IHP-GmbH/IHP-Open-PDK/README.md

# IHP Open Source PDK
130nm BiCMOS Open Source PDK, dedicated for Analog/Digital, Mixed Signal and RF Design

---
> [!WARNING]
> ### 📘 Installation Notice
>
> Before using this repository, **please review the [Installation Guide](https://ihp-open-pdk-docs.readthedocs.io/en/latest/install/installation.html)** for download procedure and to ensure your environment is set up correctly. The guide provides step-by-step instructions and important prerequisites. You can find it here: **[Installation Guide](https://ihp-open-pdk-docs.readthedocs.io/en/latest/install/installation.html)**.
---
## Acknowledgment
Special thanks to the following publicly funded German projects for their financial support, which has contributed to this work:  
IHP Open130-G2 (16ME0852) https://www.elektronikforschung.de/projekte/ihp-open130-g2  
FMD-QNC (16ME0831) https://www.elektronikforschung.de/projekte/fmd-qnc  


---
IHP Open Source PDK project goal is to provide a fully open source Process
Design Kit and related data, which can be used to create manufacturable
designs at IHP’s facility.

As of March 2023, this repository is targeting the SG13G2 process node.

<p align="center">IHP Logo Image</p>

# Current status -- Preview

> **Warning**
>
> IHP is currently treating the existing content as a **preview only**.

While the SG13G2 process node and the PDK from which this open source
release was derived have been used to create many designs that have been
successfully manufactured in significant quantities, the open source PDK
is not intended to be used for production at this moment.

# Documentation

Comprehensive documentation for the IHP Open Source PDK is available on [ReadTheDocs](https://ihp-open-pdk-docs.readthedocs.io/en/latest/).
For building or contributing, visit the [IHP-Open-PDK-docs repository](https://github.com/IHP-GmbH/IHP-Open-PDK-docs).

The documentation provides detailed information on PDK installation, setup for supported EDA tools, device libraries, layout rules, process specifications and design flow examples. It is the recommended starting point for users who want to explore the PDK structure, simulation models, layout design environments, etc.

# SG13G2 Process Node

SG13G2 is a high performance BiCMOS technology with a 0.13 μm CMOS process. It contains bipolar
devices based on SiGe:C npn-HBT's with up to 350 GHz transition frequency ($f_T$) and 450 GHz oscillation
frequency ($f_{max}$). This process provides 2 gate oxides: A thin gate oxide for the 1.2 V digital logic and a thick
oxide for a 3.3 V supply voltage. For both modules NMOS, PMOS and isolated NMOS transistors are
offered. Further passive components like poly silicon resistors and MIM capacitors are available. The
backend option offers 5 thin metal layers, two thick metal layers (2 and 3 μm thick) and a MIM layer.

# PDK Contents

* Base cellset with limited set of standard logic cells
    * CDL
    * GDSII
    * LEF, Tech LEF
    * Liberty
    * SPICE Netlist
    * Verilog
* IO cellset
    * CDL
    * GDSII
    * LEF
    * Liberty
    * SPICE Netlist
    * Verilog
* SRAM cellset
    * CDL
    * GDSII
    * LEF
    * Liberty
    * Verilog
* Primitive devices
    * GDSII
* KLayout tool data:
    * layer property and tech files
    * DRC rules
    * LVS rules
    * PyCells
    * XSection initial settings
    * 2.5D viewer configuration
* Magic tool data:
    * tech files, parasitic extraction rules
    * DRC rules
    * LVS rules
* MOS/HBT/Passive device models for ngspice/Xyce
* xschem: primitive device symbols, settings and testbenches
* Qucs-S: primitive device symbols, settings and testbenches
* Digital: stdcells
* OpenEMS: tutorials, scripts, documentation
* SG13G2 Process specification & Layout Rules
* MOS/HBT Measurements in MDM format
* Project Roadmap Gantt chart

## Supported EDA Tools

* ngspice
    * Download: https://ngspice.sourceforge.io/download.html
    * Source: https://sourceforge.net/p/ngspice/ngspice/ci/master/tree
* Xyce
    * Download: https://xyce.sandia.gov/downloads/executables
    * Source: https://github.com/Xyce/Xyce
* xschem
    * Source: https://github.com/StefanSchippers/xschem
* Qucs-S
    * Download: https://ra3xdh.github.io
    * Source: https://github.com/ra3xdh/qucs_s
* KLayout
    * Download: https://www.klayout.de/build.html
    * Source: https://github.com/KLayout/klayout
* Magic
    * Download: http://opencircuitdesign.com/magic/download.html
    * Source: https://github.com/RTimothyEdwards/magic
* OpenEMS
    * Source: https://github.com/thliebig/openEMS-Project
* OpenROAD
    * Source: https://github.com/The-OpenROAD-Project/OpenROAD
* OpenROAD-flow-scripts
    * Source: https://github.com/The-OpenROAD-Project/OpenROAD-flow-scripts
* LibreLane
    * Source: https://github.com/librelane/librelane
 
## Tool versions (tested with)
[versions.txt](versions.txt)

## Contributing

Thank you for considering contributing to IHP Open Source PDK project on GitHub! To get started, please fork the **'dev'** branch of the repository and create a new branch for your contributions. Whether you're interested in code improvements, bug fixes, feature additions, or documentation enhancements, your input is invaluable. Please ensure your code adheres to [GitHub coding standards](https://github.com/git/git/blob/master/Documentation/CodingGuidelines) and accompanies appropriate tests. Please see the [Contributing file](CONTRIBUTING.md) for additional details. We appreciate your support and look forward to collaborating with you!

# About IHP

**The IHP is a non-university research establishment institutionally funded by the German federal and state governments and a member of the Leibniz Association.**

The IHP is one of the world's leading research institutions in the field of silicon/germanium electronics. In this field, it has extensive, closely coordinated expertise in semiconductor technology, materials research, high-frequency circuit design and system solutions. Its electronic and photonic-electronic technologies and circuits are among the most powerful in the world. In the speed of silicon-based transistors, IHP holds the world record with 720 GHz maximum oscillation frequency. The institute has a pilot line that manufactures circuits using its high-performance SiGe BiCMOS technologies. Through its research and manufacturing services, IHP contributes significantly to the innovative strength of Germany and Europe, especially in the field of ultrahigh-frequency electronics. The institute's research results are applied in socially important areas such as semiconductor manufacturing, wireless and power broadband communications, health, space, Industry 4.0 or Agriculture 4.0 and mobility.

## Contacting IHP

Requests for more information about SG13G2 and other standard and
custom foundry technologies can be emailed to \<openpdk@ihp-microelectronics.com\>.

# License

The IHP Open Source PDK is released under the [Apache 2.0 license](LICENSE).

The copyright details are:
    
    Copyright 2025 IHP PDK Authors

    Licensed under the Apache License, Version 2.0 (the "License");
    you may not use this file except in compliance with the License.
    You may obtain a copy of the License at

       https://www.apache.org/licenses/LICENSE-2.0

    Unless required by applicable law or agreed to in writing, software
    distributed under the License is distributed on an "AS IS" BASIS,
    WITHOUT WARRANTIES OR CONDITIONS OF ANY KIND, either express or implied.
    See the License for the specific language governing permissions and
    limitations under the License.
