IHP-GmbH/IHP-Open-PDK/ihp-sg13g2/libs.tech/qucs-s/examples/README.md

####################################################
				IMPORTANT
####################################################

In order to use the SG13G2 PDK sample schematics, you must add the SG13G2 PDK library to the Qucs-S subcircuit search path:

1) Go to File ->Application Settings ...
2) Click on the "Locations" tab
3) On the bottom, click on the "Add Path With Subfolders" button and select the SG13G2 PDK library folder ($HOME/[.qucs|QucsWorkspace]/user_lib)
