IHP-GmbH/IHP-Open-PDK/ihp-sg13g2/libs.tech/klayout/tech/xsect/README.md

# KLayout cross-section
> ⚠️ **Current status**: BEOL + MIM

How to use:
- install 'xsection' KLayout package
- restart KLayout
- 'XSection x.x Scripts' menu item should appear in at the end of 'Tools' dropdown menu
- open the needed layout
- draw a 'ruler' where you want to check the cross-section view
- run 'XSection x.x Scripts'->'Xsection: Active Technology'
- a new layout named 'XSECTION' is created and set to active
- load special `cross_section.lyp` layer property file
- check results, now you should have smth like below:

xsection
