IHP-GmbH/IHP-Open-PDK/ihp-sg13g2/libs.tech/gnucap/ROAD_MAP.md

# Port Device library to Verilog-A 

- [x] resistors
    - [x] parasitic
    - [x] rsil
    - [x] rhigh
    - [x] rppd

- [x] capacitors
    - [x] cparasitic
    - [x] cap_cmim
    - [x] cap_rfcmim

- [ ] diode

- [ ] mosfets
  - [X] moslv
  - [X] moshv
  - [ ] hbt
  - [ ] esd
  - [ ] dschottky_nb1
  - [ ] bondpad
 
## TODOs

- test setting multiplicity via $mfactor during device instantiation
- decide which resistor, capacitor, inductor primitives to use 
- improve performance of ngspice mc tests  
- built pipline that compiles devices to osdi
