IHP-GmbH/IHP-Open-PDK/ihp-sg13g2/libs.tech/klayout/tech/drc/docs/precheck_rules.md

|Rule |Description |Value |
|---|---|---|
|Act.a |5.5.  Act.a Min. Activ width |0.15  |
|Act.b |5.5.  Act.b Min. Activ space or notch |0.21  |
|AFil.c1 |5.6.  AFil.c1 Min. Activ:filler space to Activ |0.42  |
|AFil.g |5.6.  AFil.g Min. global Activ density [%] |35 |
|AFil.g1 |5.6.  AFil.g1 Max. global Activ density [%] |55 |
|AFil.g2 |5.6.  AFil.g2 Min. Activ coverage ratio for any 800 x 800 µm² chip area [%] |25 |
|AFil.g3 |5.6.  AFil.g3 Max. Activ coverage ratio for any 800 x 800 µm² chip area [%] |65 |
|TGO.f |5.7.  TGO.f Min. ThickGateOx width |0.86  |
|Gat.a |5.8.  Gat.a Min. GatPoly width |0.13  |
|Gat.b |5.8.  Gat.b Min. GatPoly space or notch |0.18  |
|Gat.d |5.8.  Gat.d Min. GatPoly space to Activ |0.07  |
|GFil.d |5.9.  GFil.d Min. GatPoly:filler space to Activ, GatPoly, Cont, pSD, nSD:block, SalBlock |1.1 |
|GFil.g |5.9.  GFil.g Min. global GatPoly density [%] |15 |
|Cnt.a |5.14.  Cnt.a Min. and max. Cont width |0.16  |
|Cnt.b |5.14.  Cnt.b Min. Cont space |0.18  |
|CntB.a |5.15.  CntB.a Min. and max. ContBar width |0.16  |
|CntB.a1 |5.15.  CntB.a1 Min. ContBar length |0.34  |
|M1.a |5.16.  M1.a Min. Metal1 width |0.16  |
|M1.b |5.16.  M1.b Min. Metal1 space or notch |0.18  |
|M1.j |5.16.  M1.j Min. global Metal1 density [%] |35 |
|M1.k |5.16.  M1.k Max. global Metal1 density [%] |60 |
|M2.a |5.17. M2.a Min. Metal2 width |0.2 |
|M2.b |5.17. M2.b Min. Metal2 space or notch |0.21  |
|M2.j |5.17. M2.j Min. global Metal2 density [%] |35 |
|M2.k |5.17. M2.k Max. global Metal2 density [%] |60 |
|M3.a |5.17. M3.a Min. Metal3 width |0.2 |
|M3.b |5.17. M3.b Min. Metal3 space or notch |0.21  |
|M3.j |5.17. M3.j Min. global Metal3 density [%] |35 |
|M3.k |5.17. M3.k Max. global Metal3 density [%] |60 |
|M4.a |5.17. M4.a Min. Metal4 width |0.2 |
|M4.b |5.17. M4.b Min. Metal4 space or notch |0.21  |
|M4.j |5.17. M4.j Min. global Metal4 density [%] |35 |
|M4.k |5.17. M4.k Max. global Metal4 density [%] |60 |
|M5.a |5.17. M5.a Min. Metal5 width |0.2 |
|M5.b |5.17. M5.b Min. Metal5 space or notch |0.21  |
|M5.j |5.17. M5.j Min. global Metal5 density [%] |35 |
|M5.k |5.17. M5.k Max. global Metal5 density [%] |60 |
|M1Fil.c |5.18. M1Fil.c Min. Metal1:filler space to Metal1 |0.42  |
|M1Fil.h |5.18. M1Fil.h Min. Metal1 and Metal1:filler coverage ratio for any 800 x 800 µm² chip area [%] |25 |
|M1Fil.k |5.18. M1Fil.k Max. Metal1 and Metal1:filler coverage ratio for any 800 x 800 µm² chip area [%] |75 |
|M2Fil.c |5.18. M2Fil.c Min. Metal2:filler space to Metal2 |0.42  |
|M2Fil.h |5.18. M2Fil.h Min. Metal2 and Metal2:filler coverage ratio for any 800 x 800 µm² chip area [%] |25 |
|M2Fil.k |5.18. M2Fil.k Max. Metal2 and Metal2:filler coverage ratio for any 800 x 800 µm² chip area [%] |75 |
|M3Fil.c |5.18. M3Fil.c Min. Metal3:filler space to Metal3 |0.42  |
|M3Fil.h |5.18. M3Fil.h Min. Metal3 and Metal3:filler coverage ratio for any 800 x 800 µm² chip area [%] |25 |
|M3Fil.k |5.18. M3Fil.k Max. Metal3 and Metal3:filler coverage ratio for any 800 x 800 µm² chip area [%] |75 |
|M4Fil.c |5.18. M4Fil.c Min. Metal4:filler space to Metal4 |0.42  |
|M4Fil.h |5.18. M4Fil.h Min. Metal4 and Metal4:filler coverage ratio for any 800 x 800 µm² chip area [%] |25 |
|M4Fil.k |5.18. M4Fil.k Max. Metal4 and Metal4:filler coverage ratio for any 800 x 800 µm² chip area [%] |75 |
|M5Fil.c |5.18. M5Fil.c Min. Metal5:filler space to Metal5 |0.42  |
|M5Fil.h |5.18. M5Fil.h Min. Metal5 and Metal5:filler coverage ratio for any 800 x 800 µm² chip area [%] |25 |
|M5Fil.k |5.18. M5Fil.k Max. Metal5 and Metal5:filler coverage ratio for any 800 x 800 µm² chip area [%] |75 |
|V1.a |5.19.  V1.a Min. and max. Via1 width |0.19  |
|V1.b |5.19.  V1.b Min. Via1 space |0.22  |
|V2.a |5.20. V2.a Min. and max. Via2 width |0.19  |
|V2.b |5.20. V2.b Min. Via2 space |0.22  |
|V3.a |5.20. V3.a Min. and max. Via3 width |0.19  |
|V3.b |5.20. V3.b Min. Via3 space |0.22  |
|V4.a |5.20. V4.a Min. and max. Via4 width |0.19  |
|V4.b |5.20. V4.b Min. Via4 space |0.22  |
|TV1.a |5.21.  TV1.a Min. and max. TopVia1 width |0.42  |
|TV1.b |5.21.  TV1.b Min. TopVia1 space |0.42  |
|TM1.a |5.22.  TM1.a Min. TopMetal1 width |1.64  |
|TM1.b |5.22.  TM1.b Min. TopMetal1 space or notch |1.64  |
|TM1.c |5.22.  TM1.c Min. global TopMetal1 density [%] |25 |
|TM1.d |5.22.  TM1.d Max. global TopMetal1 density [%] |70 |
|TM1Fil.c |5.23.  TM1Fil.c Min. TopMetal1:filler space to TopMetal1 |3 |
|TV2.a |5.24.  TV2.a Min. and max. TopVia2 width |0.9 |
|TV2.b |5.24.  TV2.b Min. TopVia2 space |1.06  |
|TM2.a |5.25.  TM2.a Min. TopMetal2 width |2 |
|TM2.b |5.25.  TM2.b Min. TopMetal2 space or notch |2 |
|TM2.c |5.25.  TM2.c Min. global TopMetal2 density [%] |25 |
|TM2.d |5.25.  TM2.d Max. global TopMetal2 density [%] |70 |
|TM2Fil.c |5.26.  TM2Fil.c Min. TopMetal2:filler space to TopMetal2 |3 |
|Pas.a |5.27.  Pas.a Min. Passiv width |2.1 |
|Pas.b |5.27.  Pas.b Min. Passiv space or notch |3.5 |
|Padb.a |6.9.  Padb.a SBumpPad size |60 |
|Padb.b |6.9.  Padb.b Min. SBumpPad space |70 |
|Padb.c |6.9.  Padb.c Min. TopMetal2 (within dfpad) enclosure of SBumpPad |10 |
|Padc.a |6.9.  Padc.a CuPillarPad size |35 |
|Padc.b |6.9.  Padc.b Min. CuPillarPad space |40 |
|Padc.c |6.9.  Padc.c Min. TopMetal2 (within dfpad) enclosure of CuPillarPad |7.5 |
|Seal.l |6.10.  Seal.l No structures outside sealring boundary allowed |- |
|Seal.n |6.10.  seal.n Sealring must be enclosed by an unbroken Passiv ring |- |
|Pin.a |7.4.  Pin.a Min. Activ enclosure of Activ:pin |0 |
|Pin.b |7.4.  Pin.b Min. GatPoly enclosure of GatPoly:pin |0 |
|Pin.e |7.4.  Pin.e Min. Metal1 enclosure of Metal1:pin |0 |
|Pin.f_M2 |7.4.  Pin.f Min. Metal2 enclosure of Metal2:pin |0 |
|Pin.f_M3 |7.4.  Pin.f Min. Metal3 enclosure of Metal3:pin |0 |
|Pin.f_M4 |7.4.  Pin.f Min. Metal4 enclosure of Metal4:pin |0 |
|Pin.f_M5 |7.4.  Pin.f Min. Metal5 enclosure of Metal5:pin |0 |
|Pin.g |7.4.  Pin.g Min. TopMetal1 enclosure of TopMetal1:pin |0 |
|Pin.h |7.4.  Pin.h Min. TopMetal2 enclosure of TopMetal2:pin |0 |
|LBE.a |9.1.  LBE.a Min. LBE width |100 |
|LBE.b |9.1.  LBE.b Max. LBE width |1500  |
|LBE.b1 |9.1.  LBE.b1 Max. LBE area (µm²) |250000|
|LBE.c |9.1.  LBE.c Min. LBE space or notch |100 |
|LBE.d |9.1.  LBE.d Min. LBE space to inner edge of EdgeSeal |150 |
|LBE.h |9.1.  LBE.h No LBE ring allowed |- |
|LBE.i |9.1.  LBE.i Max. global LBE density [%] |20 |
|forbidden.BiWind  |3.2. forbidden.BiWind BiWind is forbidden in designs submitted for all 0.13 µm technologies. |- |
|forbidden.PEmWind |3.2. forbidden.PEmWind PEmWind is forbidden in designs submitted for all 0.13 µm technologies. |- |
|forbidden.BasPoly |3.2. forbidden.BasPoly BasPoly is forbidden in designs submitted for all 0.13 µm technologies. |- |
|forbidden.DeepCo  |3.2. forbidden.DeepCo DeepCo is forbidden in designs submitted for all 0.13 µm technologies. |- |
|forbidden.PEmPoly |3.2. forbidden.PEmPoly PEmPoly is forbidden in designs submitted for all 0.13 µm technologies. |- |
|forbidden.EmPoly  |3.2. forbidden.EmPoly EmPoly is forbidden in designs submitted for all 0.13 µm technologies. |- |
|forbidden.LDMOS |3.2. forbidden.LDMOS LDMOS is forbidden in designs submitted for all 0.13 µm technologies. |- |
|forbidden.PBiWind |3.2. forbidden.PBiWind PBiWind is forbidden in designs submitted for all 0.13 µm technologies. |- |
|forbidden.NoDRC |3.2. forbidden.NoDRC NoDRC is forbidden in designs submitted for all 0.13 µm technologies. |- |
|forbidden.Flash |3.2. forbidden.Flash Flash is forbidden in designs submitted for all 0.13 µm technologies. |- |
|forbidden.ColWind |3.2. forbidden.ColWind ColWind is forbidden in designs submitted for all 0.13 µm technologies. |- |
