IHP-GmbH/IHP-Open-PDK/ihp-sg13g2/libs.ref/sg13g2_io/doc/sg13g2_io_slow_1p35V_3p0V_125C.pdf

# sg13g2_io_slow_1p35V_3p0V_125C Library

# Cell Groups

# INOUTx

# INPUT

# SG13G2_CORNER

# SG13G2_FILLER10000

# SG13G2_FILLER1000

# SG13G2_FILLER2000

# SG13G2_FILLER200

# SG13G2_FILLER4000

# SG13G2_FILLER400

# SG13G2_IOPADANALOG

# SG13G2_IOPADIOVDD

# SG13G2_IOPADIOVSS

# SG13G2_IOPADVDD

# SG13G2_IOPADVSS

# TRI_OUTx

# INOUTx


# sg13g2_io_slow_1p35V_3p0V_125C Cell Library: Process sg13g2_io_slow_1p35V_3p0V_125C, Voltage 1.35, Temp

125.00

# Truth Table

INPUT | OUTPUT
c2p | c2p_en | pad | pad | p2c
- | 0 | 0 | - | 0
- | 0 | 1 | - | 1
0 | 1 | - | 0 | 0
1 | 1 | - | 1 | 1

# Footprint

Cell Name | Area
sg13g2_IOPadInOut16mA | 14400.00000
sg13g2_IOPadInOut30mA | 14400.00000
sg13g2_IOPadInOut4mA | 14400.00000
sg13g2_IOPadOut16mA | 14400.00000
sg13g2_IOPadOut30mA | 14400.00000
sg13g2_IOPadOut4mA | 14400.00000

# Pin Capacitance Information

# Cell Name

Pin Cap(pf) | Max Cap(pf)
| c2p | c2p_en | pad | p2c | pad
sg13g2_IOPadInOut16mA | 0.02666 | 0.02564 | 0.30434 | 0.24000 | 20.00000
sg13g2_IOPadInOut30mA | 0.02666 | 0.02563 | 0.39755 | 0.24000 | 40.00000
sg13g2_IOPadInOut4mA | 0.02666 | 0.02564 | 0.22409 | 0.24000 | 12.00000
sg13g2_IOPadOut16mA | 0.03887 | 0.00000 | 0.00000 | 0.00000 | 20.00000
sg13g2_IOPadOut30mA | 0.03889 | 0.00000 | 0.00000 | 0.00000 | 40.00000
sg13g2_IOPadOut4mA | 0.03888 | 0.00000 | 0.00000 | 0.00000 | 12.00000

# Leakage Information

# Cell Name

# Leakage(pW)

| Min. | Avg | Max.
sg13g2_IOPadInOut16mA | 707.77300 | 8739.08972 | 17609.50000
sg13g2_IOPadInOut30mA | 787.83300 | 9799.98817 | 17609.60000
sg13g2_IOPadInOut4mA | 726.62600 | 7875.97533 | 17609.50000
sg13g2_IOPadOut16mA | 1094.83000 | 3646.92833 | 6176.24000
sg13g2_IOPadOut30mA | 1533.64000 | 4783.27000 | 9084.32000
sg13g2_IOPadOut4mA | 800.31500 | 2712.52417 | 6176.06000

# Delay Information

# Delay(ns) to p2c rising :

Cell Name | Timing

## Arc(Dir)

## Delay(ns)

| Slew(ns) | Load(pf) | First | Slew(ns) | Load(pf) | Mid | Slew(ns) | Load(pf) | Last
sg13g2_IOPadInOut16mA | pad->p2c
(RR) | 0.12000 | 0.02400 | 0.29465 | 0.80000 | 0.14400 | 0.51842 | 5.00000 | 0.24000 | 0.92974
sg13g2_IOPadInOut30mA | pad->p2c
(RR) | 0.12000 | 0.02400 | 0.29477 | 0.80000 | 0.14400 | 0.51787 | 5.00000 | 0.24000 | 0.92987
sg13g2_IOPadInOut4mA | pad->p2c
(RR) | 0.12000 | 0.02400 | 0.29515 | 0.80000 | 0.14400 | 0.51768 | 5.00000 | 0.24000 | 0.92963

# Delay(ns) to p2c falling :

Cell Name | Timing

## Arc(Dir)

## Delay(ns)

| Slew(ns) | Load(pf) | First | Slew(ns) | Load(pf) | Mid | Slew(ns) | Load(pf) | Last
sg13g2_IOPadInOut16mA | pad->p2c
(FF) | 0.12000 | 0.02400 | 0.30139 | 0.80000 | 0.14400 | 0.50895 | 5.00000 | 0.24000 | 0.84430
sg13g2_IOPadInOut30mA | pad->p2c
(FF) | 0.12000 | 0.02400 | 0.30135 | 0.80000 | 0.14400 | 0.50914 | 5.00000 | 0.24000 | 0.84450
sg13g2_IOPadInOut4mA | pad->p2c
(FF) | 0.12000 | 0.02400 | 0.30130 | 0.80000 | 0.14400 | 0.50867 | 5.00000 | 0.24000 | 0.84408

# Delay(ns) to pad rising :

Cell Name | Timing

### Arc(Dir)

### Delay(ns)

Slew(ns) | Load(pf) | First | Slew(ns) | Load(pf) | Mid | Slew(ns) | Load(pf) | Last

### sg13g2_IOPadInOut16mA

### c2p->pad

(RR) | 0.02000 | 1.00000 | 2.24583 | 0.33000 | 9.00000 | 3.77401 | 2.50000 | 20.00000 | 5.65392

### c2p_en->pad

(FR) | 0.02000 | 1.00000 | 1.59826 | 0.33000 | 9.00000 | 1.66072 | 2.50000 | 20.00000 | 1.84328

### c2p_en->pad

(RR) | 0.02000 | 1.00000 | 2.23533 | 0.33000 | 9.00000 | 3.79779 | 2.50000 | 20.00000 | 5.73584

### sg13g2_IOPadInOut30mA

### c2p->pad

(RR) | 0.02000 | 2.00000 | 2.73413 | 0.33000 | 18.00000 | 4.57538 | 2.50000 | 40.00000 | 6.60657

### c2p_en->pad

(FR) | 0.02000 | 2.00000 | 1.85519 | 0.33000 | 18.00000 | 1.91923 | 2.50000 | 40.00000 | 2.10377

### c2p_en->pad

(RR) | 0.02000 | 2.00000 | 2.71132 | 0.33000 | 18.00000 | 4.59375 | 2.50000 | 40.00000 | 6.65332

### sg13g2_IOPadInOut4mA

### c2p->pad

(RR) | 0.02000 | 1.00000 | 2.31966 | 0.33000 | 5.00000 | 5.02655 | 2.50000 | 12.00000 | 9.72590

### c2p_en->pad

(FR) | 0.02000 | 1.00000 | 1.33209 | 0.33000 | 5.00000 | 1.39044 | 2.50000 | 12.00000 | 1.58170

### c2p_en->pad

(RR) | 0.02000 | 1.00000 | 2.32690 | 0.33000 | 5.00000 | 5.10699 | 2.50000 | 12.00000 | 9.94536
sg13g2_IOPadOut16mA | c2p->pad
(RR) | 0.02000 | 1.00000 | 2.17211 | 0.33000 | 9.00000 | 3.77877 | 2.50000 | 20.00000 | 6.44789
sg13g2_IOPadOut30mA | c2p->pad
(RR) | 0.02000 | 2.00000 | 2.66612 | 0.33000 | 18.00000 | 4.58243 | 2.50000 | 40.00000 | 7.40393
sg13g2_IOPadOut4mA | c2p->pad
(RR) | 0.02000 | 1.00000 | 2.23193 | 0.33000 | 5.00000 | 5.01610 | 2.50000 | 12.00000 | 10.50560

# Delay(ns) to pad falling :

Cell Name | Timing

### Arc(Dir)

### Delay(ns)

Slew(ns) | Load(pf) | First | Slew(ns) | Load(pf) | Mid | Slew(ns) | Load(pf) | Last

### sg13g2_IOPadInOut16mA

### c2p->pad

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

# sg13g2_IOPadOut4mA

0.02000 | 2.60912 | 0.33000 | 2.51301 | 2.50000 | 2.48820
0.02000 | -0.02016 | 0.33000 | -0.00962 | 2.50000 | 0.13335

# Passive power(pJ) for pad falling :

# Cell Name

# Power(pJ)

Slew(ns) | First | Slew(ns) | Mid | Slew(ns) | Last

# sg13g2_IOPadInOut16mA

0.02000 | 11.24310 | 0.33000 | 7.55593 | 2.50000 | 6.51853
0.02000 | 0.22769 | 0.33000 | 0.24371 | 2.50000 | 0.39970
0.02000 | 2.91114 | 0.33000 | 3.09096 | 2.50000 | 3.38177
0.02000 | 0.12161 | 0.33000 | 0.13880 | 2.50000 | 0.23569

# sg13g2_IOPadInOut30mA

0.02000 | 40.03380 | 0.33000 | 24.46550 | 2.50000 | 18.40310
0.02000 | 0.22952 | 0.33000 | 0.24444 | 2.50000 | 0.38988
0.02000 | 4.39915 | 0.33000 | 4.59171 | 2.50000 | 4.89371
0.02000 | 0.12236 | 0.33000 | 0.13900 | 2.50000 | 0.22573

# sg13g2_IOPadInOut4mA

0.02000 | 2.25819 | 0.33000 | 2.66728 | 2.50000 | 3.41698
0.02000 | 0.23268 | 0.33000 | 0.25912 | 2.50000 | 0.42720
0.02000 | 1.74782 | 0.33000 | 2.16602 | 2.50000 | 2.91195
0.02000 | 0.12766 | 0.33000 | 0.15303 | 2.50000 | 0.26103

# sg13g2_IOPadOut16mA

0.02000 | 11.72830 | 0.33000 | 7.29715 | 2.50000 | 5.96180
0.02000 | 0.07593 | 0.33000 | 0.08982 | 2.50000 | 0.23376

# sg13g2_IOPadOut30mA

0.02000 | 41.36780 | 0.33000 | 24.59110 | 2.50000 | 18.28580
0.02000 | 0.07592 | 0.33000 | 0.08982 | 2.50000 | 0.23258

# sg13g2_IOPadOut4mA

0.02000 | 1.92630 | 0.33000 | 1.87268 | 2.50000 | 1.85699
0.02000 | 0.07596 | 0.33000 | 0.08984 | 2.50000 | 0.23179

# INPUT

# sg13g2_io_slow_1p35V_3p0V_125C Cell Library: Process sg13g2_io_slow_1p35V_3p0V_125C, Voltage 1.35, Temp 125.00

# Truth Table

INPUT | OUTPUT
pad | p2c

0 0

1 1

# Footprint

Cell Name | Area
sg13g2_IOPadIn | 14400.00000

# Pin Capacitance Information

# Cell Name

| Pin Cap(pf) | Max Cap(pf)
| pad | p2c
sg13g2_IOPadIn | 0.23620 | 0.24000

# Leakage Information

# Cell Name

# Leakage(pW)

| Min. | Avg | Max.
sg13g2_IOPadIn | 369.32000 | 1262.72200 | 3110.82000

# Delay Information

# Delay(ns) to p2c rising :

## Cell Name Timing Arc(Dir)

## Delay(ns)

| Slew(ns) | Load(pf) | First | Slew(ns) | Load(pf) | Mid | Slew(ns) | Load(pf) | Last
sg13g2_IOPadIn | pad->p2c
(RR) | 0.12000 | 0.02400 | 0.29452 | 0.80000 | 0.14400 | 0.51731 | 5.00000 | 0.24000 | 0.92907

# Delay(ns) to p2c falling :

## Cell Name Timing Arc(Dir)

## Delay(ns)

| Slew(ns) | Load(pf) | First | Slew(ns) | Load(pf) | Mid | Slew(ns) | Load(pf) | Last
sg13g2_IOPadIn | pad->p2c
(FF) | 0.12000 | 0.02400 | 0.30118 | 0.80000 | 0.14400 | 0.50794 | 5.00000 | 0.24000 | 0.84261

# Power Information

# Internal switching power(pJ) to p2c rising :

## Cell Name Input

## Power(pJ)

| Slew(ns) | Load(pf) | First | Slew(ns) | Load(pf) | Mid | Slew(ns) | Load(pf) | Last

## sg13g2_IOPadIn

pad | 0.12000 | 0.02400 | -0.53033 | 0.80000 | 0.14400 | -0.48511 | 5.00000 | 0.24000 | -0.10551
pad | 0.12000 | 0.02400 | 0.03001 | 0.80000 | 0.14400 | 0.03101 | 5.00000 | 0.24000 | 0.03100

# Internal switching power(pJ) to p2c falling :

## Cell Name Input

## Power(pJ)

| Slew(ns) | Load(pf) | First | Slew(ns) | Load(pf) | Mid | Slew(ns) | Load(pf) | Last

## sg13g2_IOPadIn

pad | 0.12000 | 0.02400 | 0.89869 | 0.80000 | 0.14400 | 0.94174 | 5.00000 | 0.24000 | 1.31991
pad | 0.12000 | 0.02400 | 0.07242 | 0.80000 | 0.14400 | 0.07684 | 5.00000 | 0.24000 | 0.09789

# SG13G2_CORNER


| sg13g2_io_slow_1p35V_3p0V_125C Cell Library: Process sg13g2_io_slow_1p35V_3p0V_125C, Voltage 1.35, Temp 125.00

# Footprint

Cell Name | Area
sg13g2_Corner | 32400.00000

# Pin Capacitance Information

# SG13G2_FILLER10000


| sg13g2_io_slow_1p35V_3p0V_125C Cell Library: Process sg13g2_io_slow_1p35V_3p0V_125C, Voltage 1.35, Temp 125.00

# Footprint

Cell Name | Area
sg13g2_Filler10000 | 18000.00000

# Pin Capacitance Information

# SG13G2_FILLER1000

| sg13g2_io_slow_1p35V_3p0V_125C Cell Library: Process sg13g2_io_slow_1p35V_3p0V_125C, Voltage 1.35, Temp 125.00

# Footprint

Cell Name | Area
sg13g2_Filler1000 | 900.00000

# Pin Capacitance Information

# SG13G2_FILLER2000

| sg13g2_io_slow_1p35V_3p0V_125C Cell Library: Process sg13g2_io_slow_1p35V_3p0V_125C, Voltage 1.35, Temp 125.00

# Footprint

Cell Name | Area
sg13g2_Filler2000 | 1800.00000

# Pin Capacitance Information

# SG13G2_FILLER200

| sg13g2_io_slow_1p35V_3p0V_125C Cell Library: Process sg13g2_io_slow_1p35V_3p0V_125C, Voltage 1.35, Temp 125.00

# Footprint

Cell Name | Area
sg13g2_Filler200 | 180.00000

# Pin Capacitance Information

# SG13G2_FILLER4000

| sg13g2_io_slow_1p35V_3p0V_125C Cell Library: Process sg13g2_io_slow_1p35V_3p0V_125C, Voltage 1.35, Temp 125.00

# Footprint

Cell Name | Area
sg13g2_Filler4000 | 3600.00000

# Pin Capacitance Information

# SG13G2_FILLER400

| sg13g2_io_slow_1p35V_3p0V_125C Cell Library: Process sg13g2_io_slow_1p35V_3p0V_125C, Voltage 1.35, Temp 125.00

# Footprint

Cell Name | Area
sg13g2_Filler400 | 360.00000

# Pin Capacitance Information

# SG13G2_IOPADANALOG


## sg13g2_io_slow_1p35V_3p0V_125C Cell Library: Process

sg13g2_io_slow_1p35V_3p0V_125C,

## Voltage 1.35, Temp 125.00

# Truth Table

INPUT | OUTPUT
pad | padres | pad | padres
x | x | - | -

# Footprint

Cell Name | Area
sg13g2_IOPadAnalog | 14400.00000

# Pin Capacitance Information

# Cell Name

Pin Cap(pf) | Max Cap(pf)
| pad | padres | pad | padres
sg13g2_IOPadAnalog | 0.78661 | 0.59885 | 30000.00000 | 30000.00000

# Leakage Information

# Cell Name

# Leakage(pW)

| Min. | Avg | Max.
sg13g2_IOPadAnalog | 0.00000 | 5820.60000 | 11641.20000

# Delay Information

# Delay(ns) to pad rising :

Cell Name | Timing

### Arc(Dir)

### Delay(ns)

| Slew(ns) | Load(pf) | First | Slew(ns) | Load(pf) | Mid | Slew(ns) | Load(pf) | Last
sg13g2_IOPadAnalog | pad->pad
( R) | 10.00000 | 500.00000 | 1000.00000 | 200.00000 | 30000.00000 | 1000.00000 | 200.00000 | 30000.00000 | 1000.00000

# Delay(ns) to pad falling :

Cell Name | Timing

### Arc(Dir)

### Delay(ns)

| Slew(ns) | Load(pf) | First | Slew(ns) | Load(pf) | Mid | Slew(ns) | Load(pf) | Last
sg13g2_IOPadAnalog | pad->pad
( F) | 10.00000 | 500.00000 | 1000.00000 | 200.00000 | 30000.00000 | 1000.00000 | 200.00000 | 30000.00000 | 1000.00000

# SG13G2_IOPADIOVDD


| sg13g2_io_slow_1p35V_3p0V_125C Cell Library: Process sg13g2_io_slow_1p35V_3p0V_125C, Voltage 1.35, Temp 125.00

# Footprint

Cell Name | Area
sg13g2_IOPadIOVdd | 14400.00000

# Pin Capacitance Information

# SG13G2_IOPADIOVSS

| sg13g2_io_slow_1p35V_3p0V_125C Cell Library: Process sg13g2_io_slow_1p35V_3p0V_125C, Voltage 1.35, Temp 125.00

# Footprint

Cell Name | Area
sg13g2_IOPadIOVss | 14400.00000

# Pin Capacitance Information

# SG13G2_IOPADVDD

| sg13g2_io_slow_1p35V_3p0V_125C Cell Library: Process sg13g2_io_slow_1p35V_3p0V_125C, Voltage 1.35, Temp 125.00

# Footprint

Cell Name | Area
sg13g2_IOPadVdd | 14400.00000

# Pin Capacitance Information

# SG13G2_IOPADVSS

| sg13g2_io_slow_1p35V_3p0V_125C Cell Library: Process sg13g2_io_slow_1p35V_3p0V_125C, Voltage 1.35, Temp 125.00

# Footprint

Cell Name | Area
sg13g2_IOPadVss | 14400.00000

# Pin Capacitance Information

# TRI_OUTx

# sg13g2_io_slow_1p35V_3p0V_125C Cell Library: Process sg13g2_io_slow_1p35V_3p0V_125C, Voltage 1.35, Temp 125.00

# Truth Table

INPUT | OUTPUT
c2p | c2p_en | pad
- | 0 | HiZ
0 | 1 | 0
1 | 1 | 1

# Footprint

Cell Name | Area
sg13g2_IOPadTriOut16mA | 14400.00000
sg13g2_IOPadTriOut30mA | 14400.00000
sg13g2_IOPadTriOut4mA | 14400.00000

# Pin Capacitance Information

# Cell Name

Pin Cap(pf) | Max Cap(pf)
| c2p | c2p_en | pad
sg13g2_IOPadTriOut16mA | 0.02662 | 0.02609 | 20.00000
sg13g2_IOPadTriOut30mA | 0.02662 | 0.02609 | 40.00000
sg13g2_IOPadTriOut4mA | 0.02662 | 0.02610 | 12.00000

# Leakage Information

# Cell Name

# Leakage(pW)

| Min. | Avg | Max.
sg13g2_IOPadTriOut16mA | 918.88900 | 7106.40740 | 14973.90000
sg13g2_IOPadTriOut30mA | 1325.67000 | 7773.88500 | 14975.10000
sg13g2_IOPadTriOut4mA | 564.11500 | 6537.73970 | 14974.20000

# Delay Information

# Delay(ns) to pad rising :

Cell Name | Timing

### Arc(Dir)

### Delay(ns)

Slew(ns) | Load(pf) | First | Slew(ns) | Load(pf) | Mid | Slew(ns) | Load(pf) | Last

### sg13g2_IOPadTriOut16mA

### c2p->pad

(RR) | 0.02000 | 1.00000 | 2.24455 | 0.33000 | 9.00000 | 3.77601 | 2.50000 | 20.00000 | 5.65290

### c2p_en->pad

(FR) | 0.02000 | 1.00000 | 1.61042 | 0.33000 | 9.00000 | 1.67378 | 2.50000 | 20.00000 | 1.85835

### c2p_en->pad

(RR) | 0.02000 | 1.00000 | 2.23562 | 0.33000 | 9.00000 | 3.80172 | 2.50000 | 20.00000 | 5.73632

### sg13g2_IOPadTriOut30mA

### c2p->pad

(RR) | 0.02000 | 2.00000 | 2.73791 | 0.33000 | 18.00000 | 4.58046 | 2.50000 | 40.00000 | 6.61065

### c2p_en->pad

(FR) | 0.02000 | 2.00000 | 1.86514 | 0.33000 | 18.00000 | 1.92963 | 2.50000 | 40.00000 | 2.11691

### c2p_en->pad

(RR) | 0.02000 | 2.00000 | 2.71503 | 0.33000 | 18.00000 | 4.59062 | 2.50000 | 40.00000 | 6.65371

### sg13g2_IOPadTriOut4mA

### c2p->pad

(RR) | 0.02000 | 1.00000 | 2.30504 | 0.33000 | 5.00000 | 5.01224 | 2.50000 | 12.00000 | 9.70533

### c2p_en->pad

(FR) | 0.02000 | 1.00000 | 1.34630 | 0.33000 | 5.00000 | 1.41165 | 2.50000 | 12.00000 | 1.59599

### c2p_en->pad

(RR) | 0.02000 | 1.00000 | 2.31664 | 0.33000 | 5.00000 | 5.10127 | 2.50000 | 12.00000 | 9.93797

# Delay(ns) to pad falling :

Cell Name | Timing

### Arc(Dir)

### Delay(ns)

Slew(ns) | Load(pf) | First | Slew(ns) | Load(pf) | Mid | Slew(ns) | Load(pf) | Last

### sg13g2_IOPadTriOut16mA

### c2p->pad

(FF) | 0.02000 | 1.00000 | 1.66432 | 0.33000 | 9.00000 | 3.04615 | 2.50000 | 20.00000 | 5.13128

### c2p_en->pad

(FF) | 0.02000 | 1.00000 | 1.61527 | 0.33000 | 9.00000 | 1.70499 | 2.50000 | 20.00000 | 1.95780

### c2p_en->pad

(RF) | 0.02000 | 1.00000 | 1.41563 | 0.33000 | 9.00000 | 2.90202 | 2.50000 | 20.00000 | 4.77784

### sg13g2_IOPadTriOut30mA

### c2p->pad

(FF) | 0.02000 | 2.00000 | 2.21822 | 0.33000 | 18.00000 | 3.76554 | 2.50000 | 40.00000 | 5.91111

### c2p_en->pad

(FF) | 0.02000 | 2.00000 | 2.49537 | 0.33000 | 18.00000 | 2.57416 | 2.50000 | 40.00000 | 2.83138

### c2p_en->pad

(RF) | 0.02000 | 2.00000 | 1.68446 | 0.33000 | 18.00000 | 3.38636 | 2.50000 | 40.00000 | 5.38758

### sg13g2_IOPadTriOut4mA

### c2p->pad

(FF) | 0.02000 | 1.00000 | 1.77517 | 0.33000 | 5.00000 | 4.48222 | 2.50000 | 12.00000 | 9.41270

### c2p_en->pad

(FF) | 0.02000 | 1.00000 | 0.88667 | 0.33000 | 5.00000 | 0.96841 | 2.50000 | 12.00000 | 1.24205

### c2p_en->pad

(RF) | 0.02000 | 1.00000 | 1.77488 | 0.33000 | 5.00000 | 4.54671 | 2.50000 | 12.00000 | 9.34692

# Power Information

# Internal switching power(pJ) to pad rising :

Cell Name | Input

## Power(pJ)

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
!c2p_en | 0.02000 | -0.02253 | 0.33000 | -0.02384 | 2.50000 | -0.02418

# sg13g2_IOPadTriOut4mA

!c2p_en | 0.02000 | 0.00000 | 0.33000 | 0.00000 | 2.50000 | 0.00000
!c2p_en | 0.02000 | -0.02253 | 0.33000 | -0.02384 | 2.50000 | -0.02418

# Passive power(pJ) for c2p falling (conditional):

Cell Name | When

# Power(pJ)

| Slew(ns) | First | Slew(ns) | Mid | Slew(ns) | Last

# sg13g2_IOPadTriOut16mA

!c2p_en | 0.02000 | 0.00000 | 0.33000 | 0.00000 | 2.50000 | 0.00000
!c2p_en | 0.02000 | 0.02719 | 0.33000 | 0.02653 | 2.50000 | 0.02655

# sg13g2_IOPadTriOut30mA

!c2p_en | 0.02000 | 0.00000 | 0.33000 | 0.00000 | 2.50000 | 0.00000
!c2p_en | 0.02000 | 0.02717 | 0.33000 | 0.02653 | 2.50000 | 0.02652

# sg13g2_IOPadTriOut4mA

!c2p_en | 0.02000 | 0.00000 | 0.33000 | 0.00000 | 2.50000 | 0.00000
!c2p_en | 0.02000 | 0.02716 | 0.33000 | 0.02654 | 2.50000 | 0.02621
