IHP-GmbH/IHP-Open-PDK/ihp-sg13g2/libs.doc/meas/HBT/doc/html_npn13g2_VBIC/High_Frequency_Noise_SG13G2_pdk.pdf

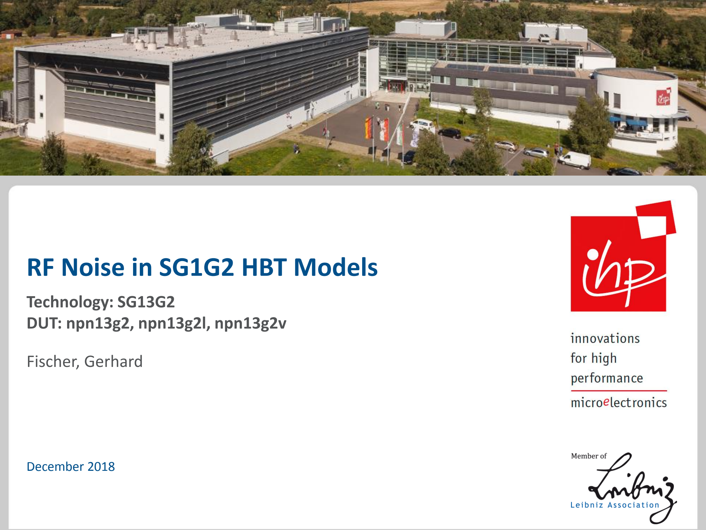
[picture p62: page 1]

# RF Noise in SG1G2 HBT Models

# Technology: SG13G2 DUT: npn13g2, npn13g2l, npn13g2v

# Fischer, Gerhard

## December 2018

www.ihp-microelectronics.com © 2018 - All rights reserved

# Overview

Enter Date | 2

# ■ RF noise measurements have been performed on all HBT types and compared to simulations with VBIC and HICUM

# Summary:

# ■ Noise measurements performed on current qualification wafer

## ■ Operating points: VBE=0.78…0.96V (g2, g2l), VCB=0.25V, f=2.5GHz…26GHz ■ Operating points: VBE=0.75…0.84V (g2v), VCB=1.0V, f=2.5GHz…26GHz

# DUT: npn13g2 Nx=8 VBIC - RF noise as function of frequency

# DUT: npn13g2 Nx=8 VBIC - RF noise as function of VBE

# f=2.5GHz/12GHz/24GHz

# DUT: npn13g2 Nx=8 HICUM - RF noise as function of frequency

# DUT: npn13g2 Nx=8 HICUM - RF noise as function of VBE

# f=2.5GHz/12GHz/24GHz

# DUT: npn13g2l Nx=4 El=2.5 VBIC - RF noise as function of frequency

# DUT: npn13g2l Nx=4 El=2.5 VBIC - RF noise as function of VBE

# f=2.5GHz/12GHz/24GHz

# DUT: npn13g2v Nx=4 El=2.5 VBIC - RF noise as function of frequency

# DUT: npn13g2v Nx=4 El=2.5 VBIC - RF noise as function of VBE

# f=2.5GHz/12GHz/24GHz
