IHP-GmbH/IHP-Open-PDK/ihp-sg13g2/libs.doc/meas/HBT/doc/html_npn13g2_VBIC/Low_Frequency_Noise_SG13G2_pdk.pdf

www.ihp-microelectronics.com © 2018 - All rights reserved

## Overview

■ In previous releases low-frequency noise parameters included only in VBIC model ■ Parameter (kfn, afn) based on old measurement data (2011)
■ Q4/18 new 1/f noise measurement system installed (ProPlus)
Summary:
■ Noise measurements performed on current qualification wafer ■ Operating points: VBE=0.7…0.925V (g2, g2l), VCE=1V, f=1Hz…10kHz ■ Model parameters extracted for
■ npn13g2: VBIC and HICUM

## DUT: npn13g2

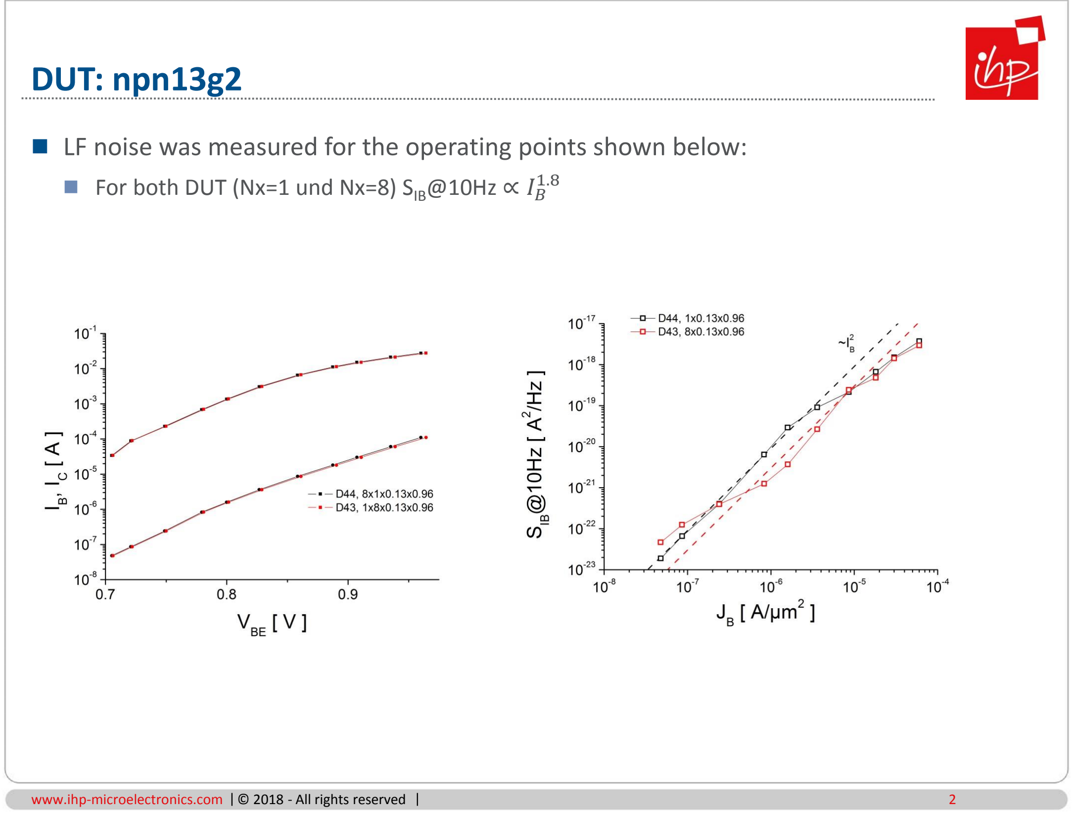
[picture p63: page 2]

■ LF noise was measured for the operating points shown below: ■ For both DUT (Nx=1 und Nx=8) SIB@10Hz ∝ IB

1.8

## Example: npn13g2, Nx=8

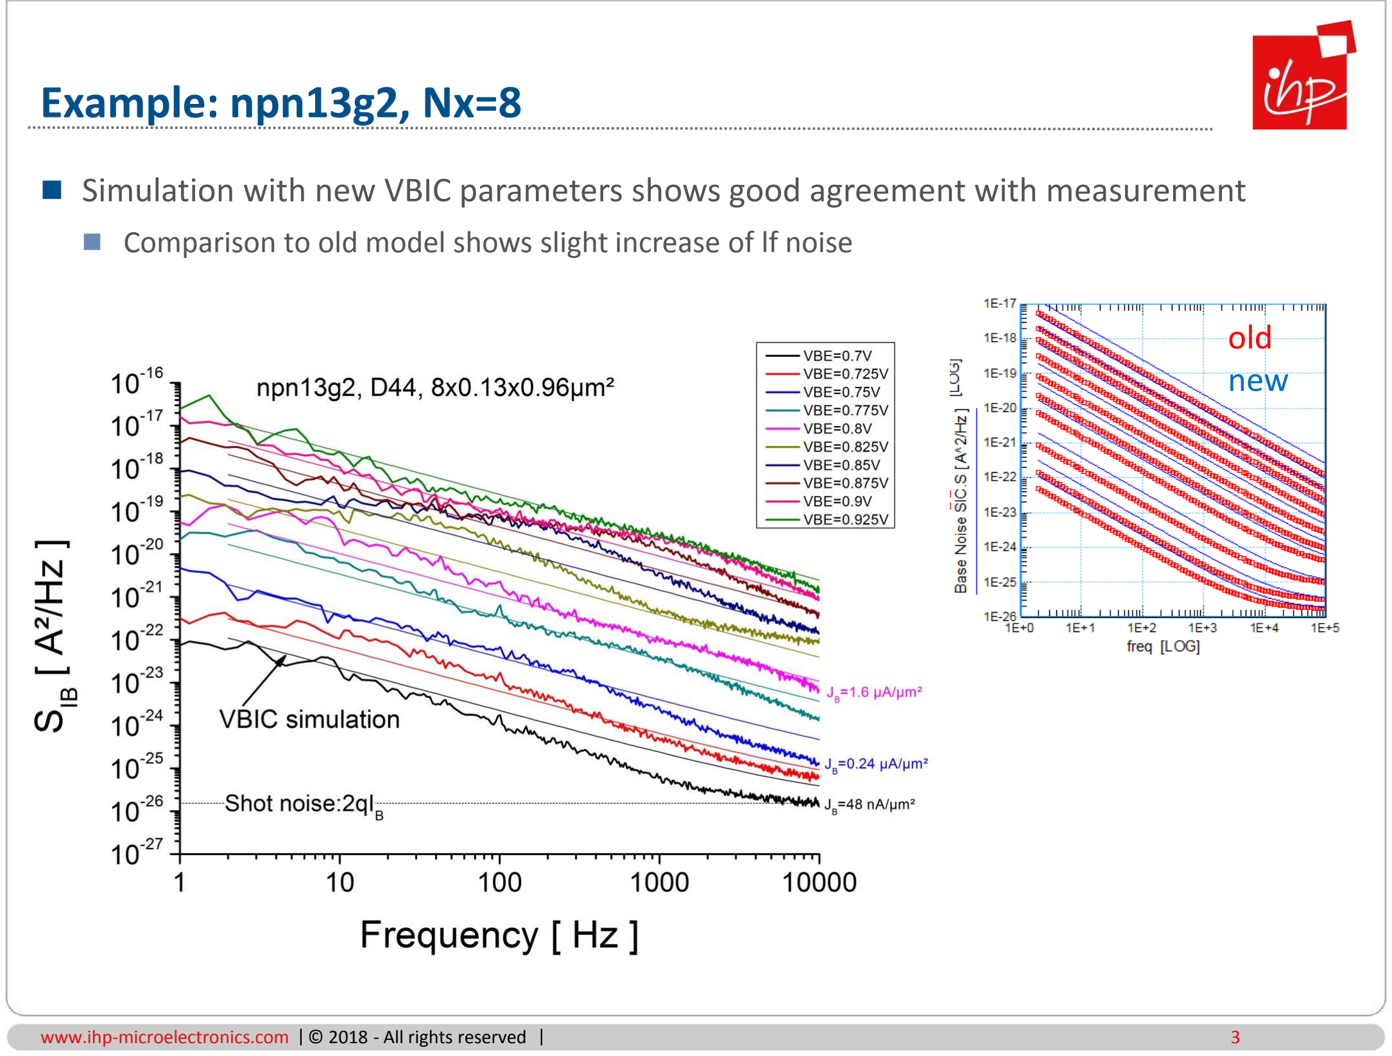
[picture p64: page 3]

■ Simulation with new VBIC parameters shows good agreement with measurement ■ Comparison to old model shows slight increase of lf noise

old
new

## Example: npn13g2, SIB(IB

## ) for Nx=1, Nx=8

■ Simulation with new VBIC parameters shows good agreement with measurement

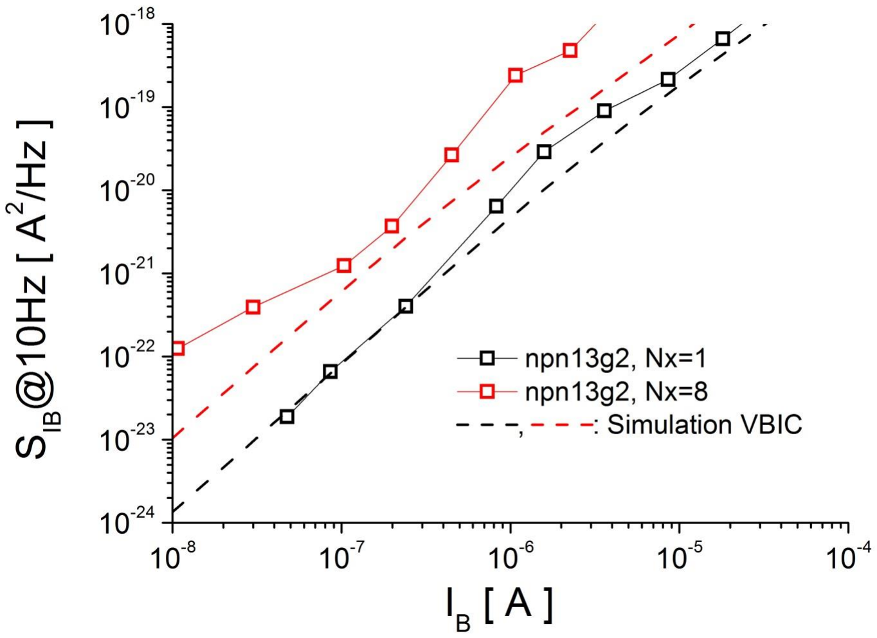
[picture p65: figure]

## Model Comparison: npn13g2, Nx=8

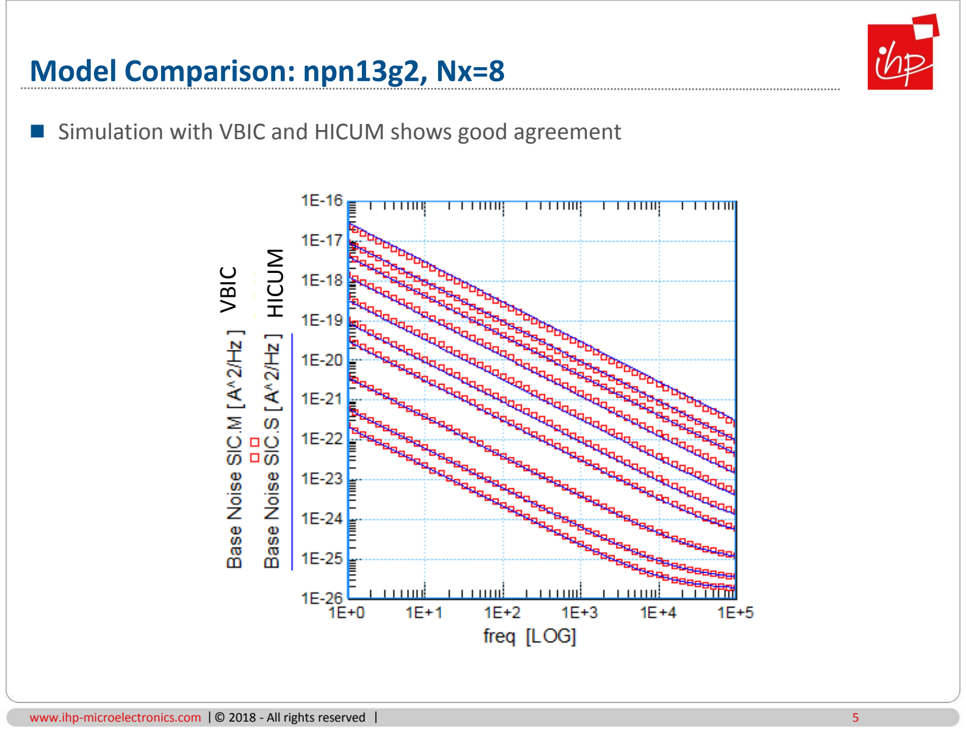
[picture p66: page 5]

■ Simulation with VBIC and HICUM shows good agreement VBIC HICUM
