IHP-GmbH/IHP-Open-PDK/ihp-sg13g2/libs.doc/meas/HBT/doc/html_npn13g2l_VBIC/Low_Frequency_Noise_SG13G2L_pdk.pdf

## Overview npn13g2l

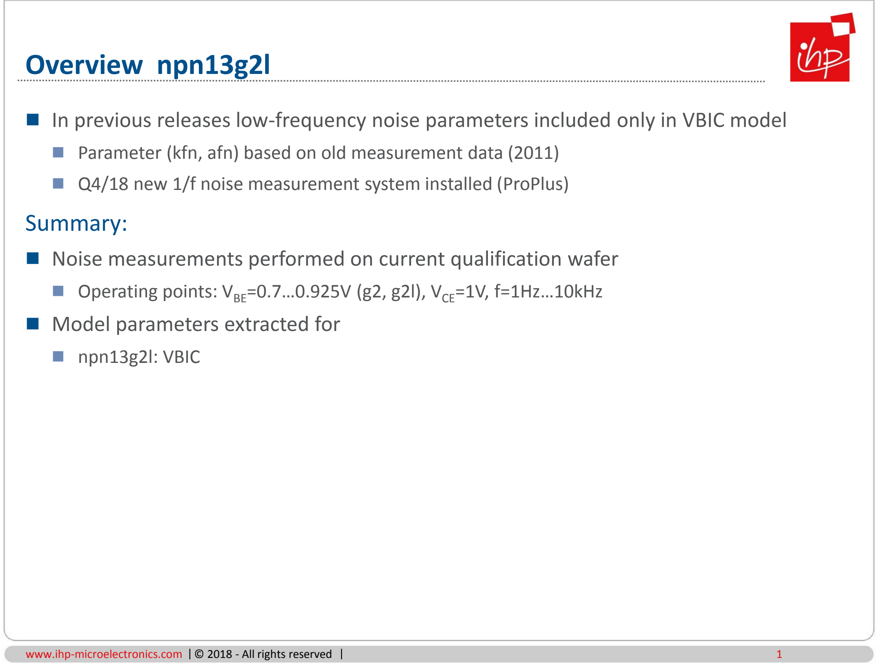
[picture p67: page 1]

www.ihp-microelectronics.com © 2018 - All rights reserved

1

■ In previous releases low-frequency noise parameters included only in VBIC model ■ Parameter (kfn, afn) based on old measurement data (2011)
■ Q4/18 new 1/f noise measurement system installed (ProPlus)
Summary:
■ Noise measurements performed on current qualification wafer ■ Operating points: VBE=0.7…0.925V (g2, g2l), VCE=1V, f=1Hz…10kHz ■ Model parameters extracted for
■ npn13g2l: VBIC

## Example: npn13g2l, Nx=4, El=2.5µm

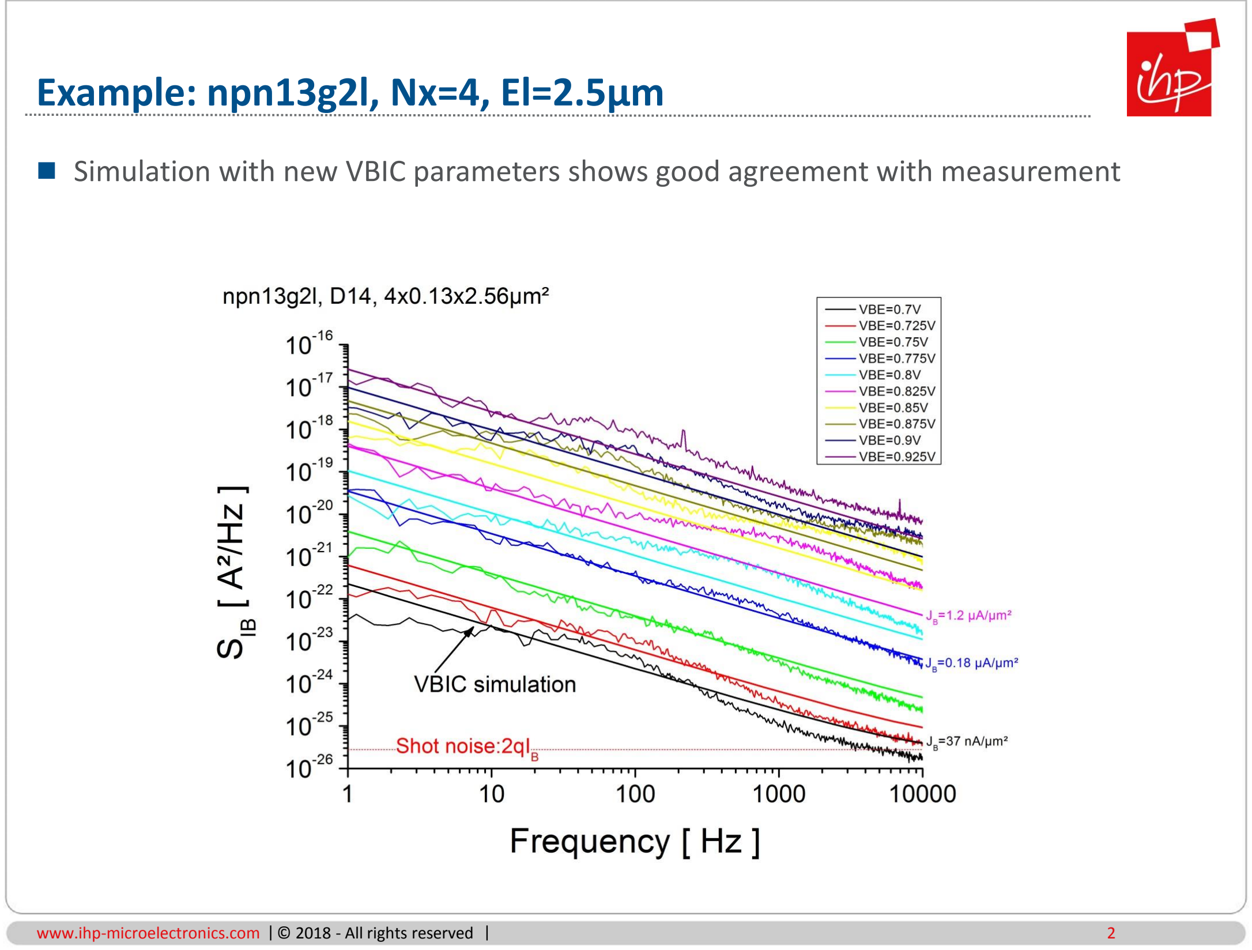
[picture p68: page 2]

www.ihp-microelectronics.com © 2018 - All rights reserved

2

■ Simulation with new VBIC parameters shows good agreement with measurement
