IHP-GmbH/IHP-Open-PDK/ihp-sg13g2/libs.doc/meas/HBT/doc/html_npn13g2v_VBIC/Low_Frequency_Noise_SG13G2V_pdk.pdf

## Overview npn13g2v

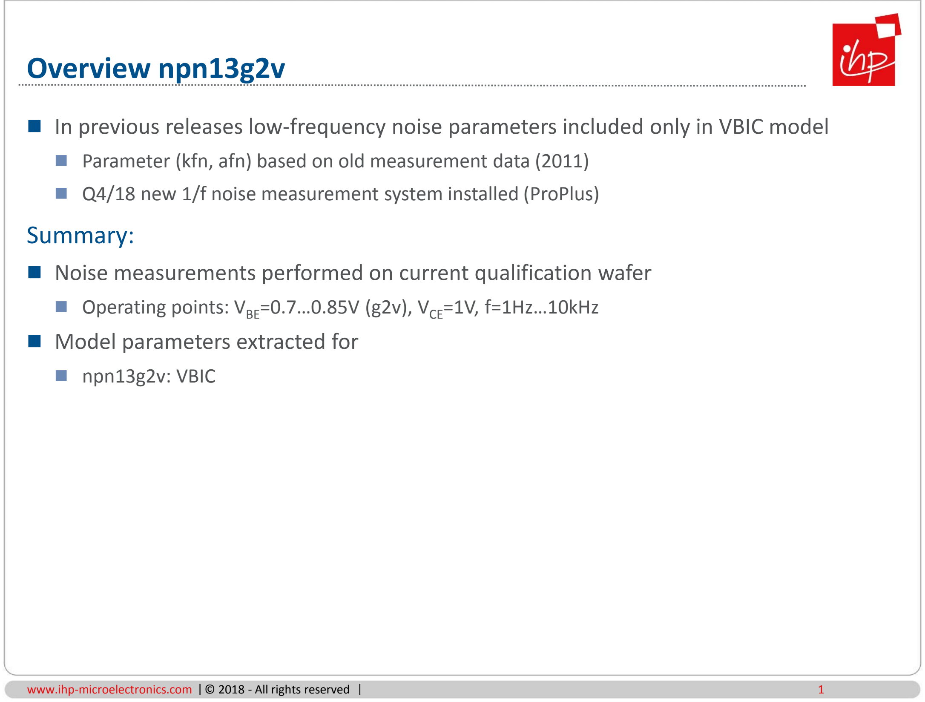
[picture p69: page 1]

www.ihp-microelectronics.com © 2018 - All rights reserved

1

■ In previous releases low-frequency noise parameters included only in VBIC model ■ Parameter (kfn, afn) based on old measurement data (2011)
■ Q4/18 new 1/f noise measurement system installed (ProPlus)

### Summary:

■ Noise measurements performed on current qualification wafer ■ Operating points: VBE=0.7…0.85V (g2v), VCE=1V, f=1Hz…10kHz
■ Model parameters extracted for
■ npn13g2v: VBIC

## Example: npn13g2v, Nx=4, El=5.0µm

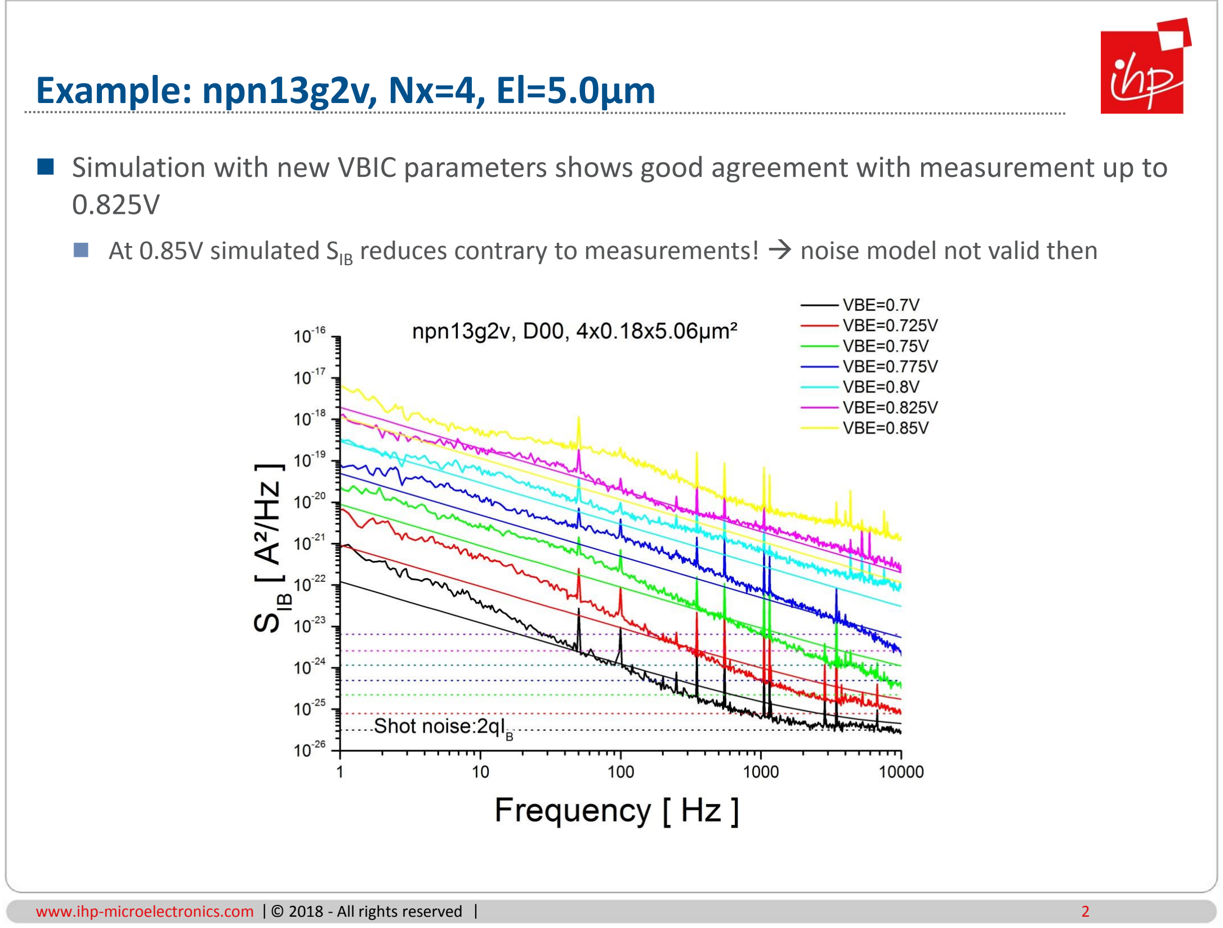
[picture p70: page 2]

www.ihp-microelectronics.com © 2018 - All rights reserved

2

■ Simulation with new VBIC parameters shows good agreement with measurement up to 0.825V
■ At 0.85V simulated SIB reduces contrary to measurements! → noise model not valid then
