IHP-GmbH/IHP-Open-PDK/ihp-sg13g2/libs.doc/meas/HBT/doc/html_npn13g2_VBIC/images/cbcp_sparm.png

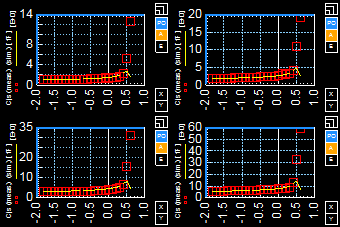
ihp-sg13g2/libs.doc/meas/HBT/doc/html_npn13g2_VBIC/images/cbcp_sparm.png
