IHP-GmbH/IHP-Open-PDK/ihp-sg13g2/libs.doc/meas/HBT/doc/html_npn13g2l_VBIC/imgzoom/dc_fit_quality.png

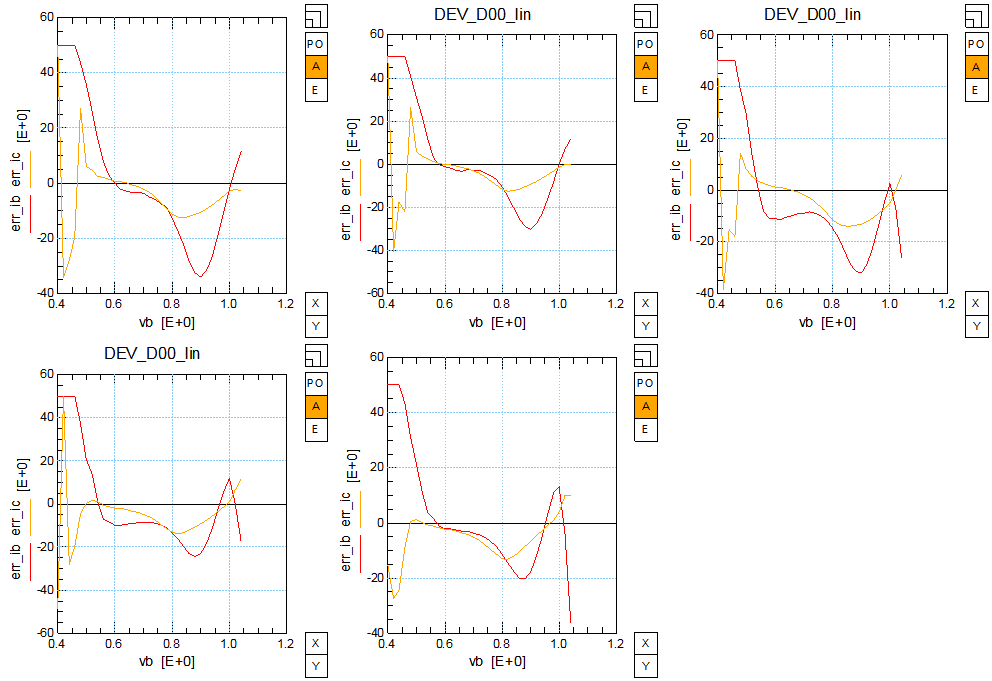
ihp-sg13g2/libs.doc/meas/HBT/doc/html_npn13g2l_VBIC/imgzoom/dc_fit_quality.png
