IHP-GmbH/IHP-Open-PDK/ihp-sg13g2/libs.doc/meas/HBT/doc/html_npn13g2v_VBIC/images/beta_vcb0.png

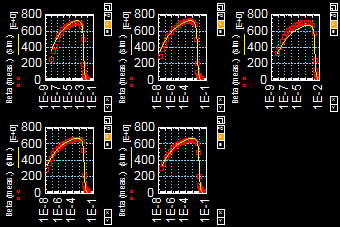
ihp-sg13g2/libs.doc/meas/HBT/doc/html_npn13g2v_VBIC/images/beta_vcb0.png
