IHP-GmbH/IHP-Open-PDK/ihp-sg13g2/libs.doc/roadmap/open_PDK_gantt.png

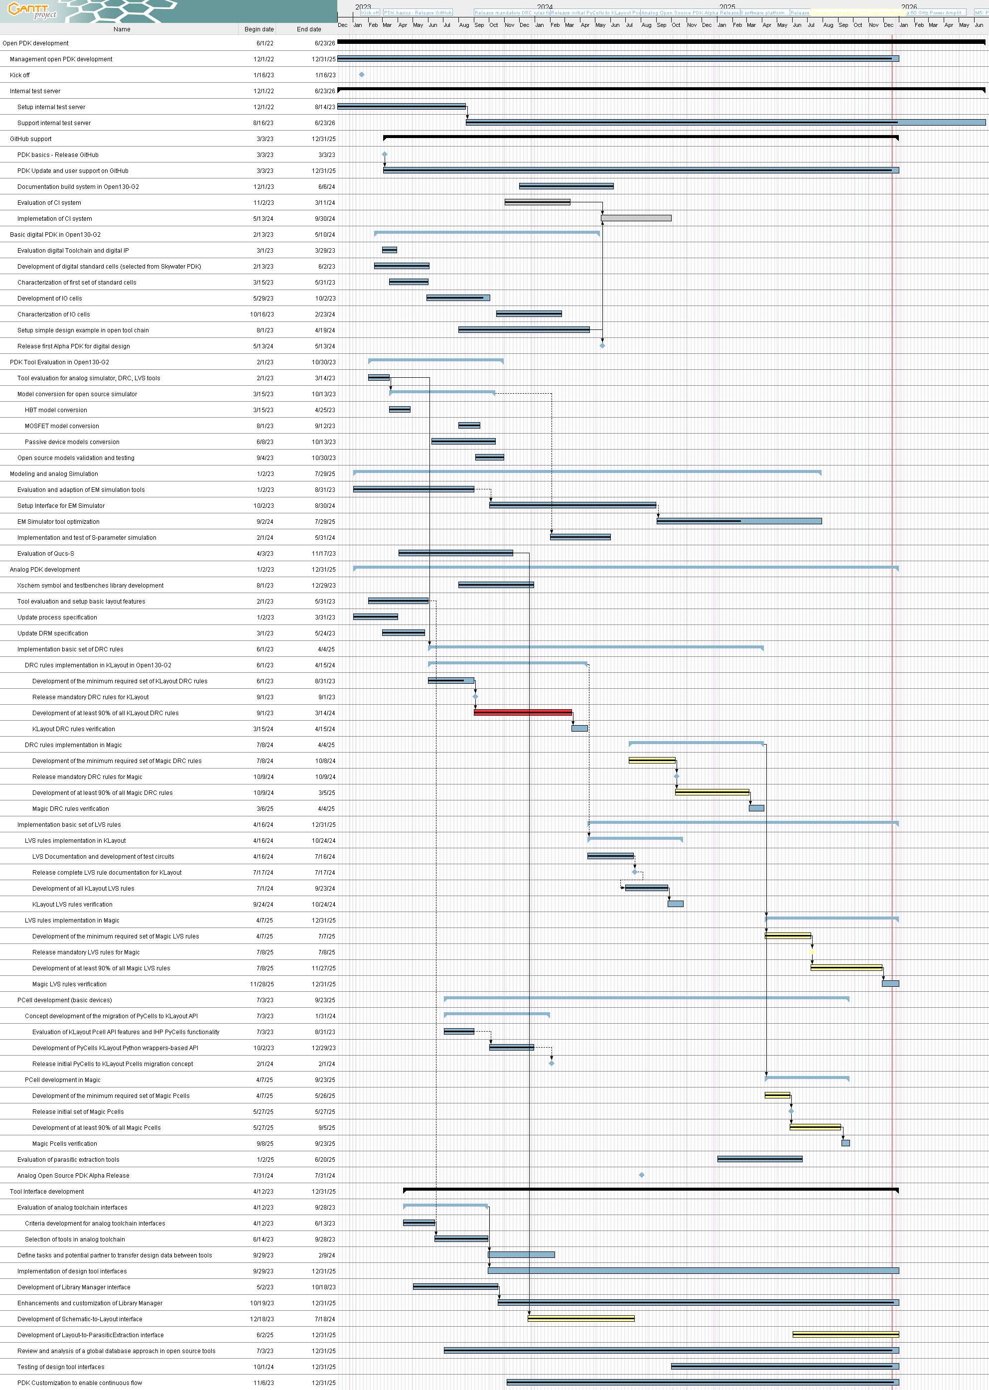
ihp-sg13g2/libs.doc/roadmap/open_PDK_gantt.png
