IHP-GmbH/IHP-Open-PDK/ihp-sg13g2/libs.tech/xschem/simulations/fig/mc_res_op.csv.png

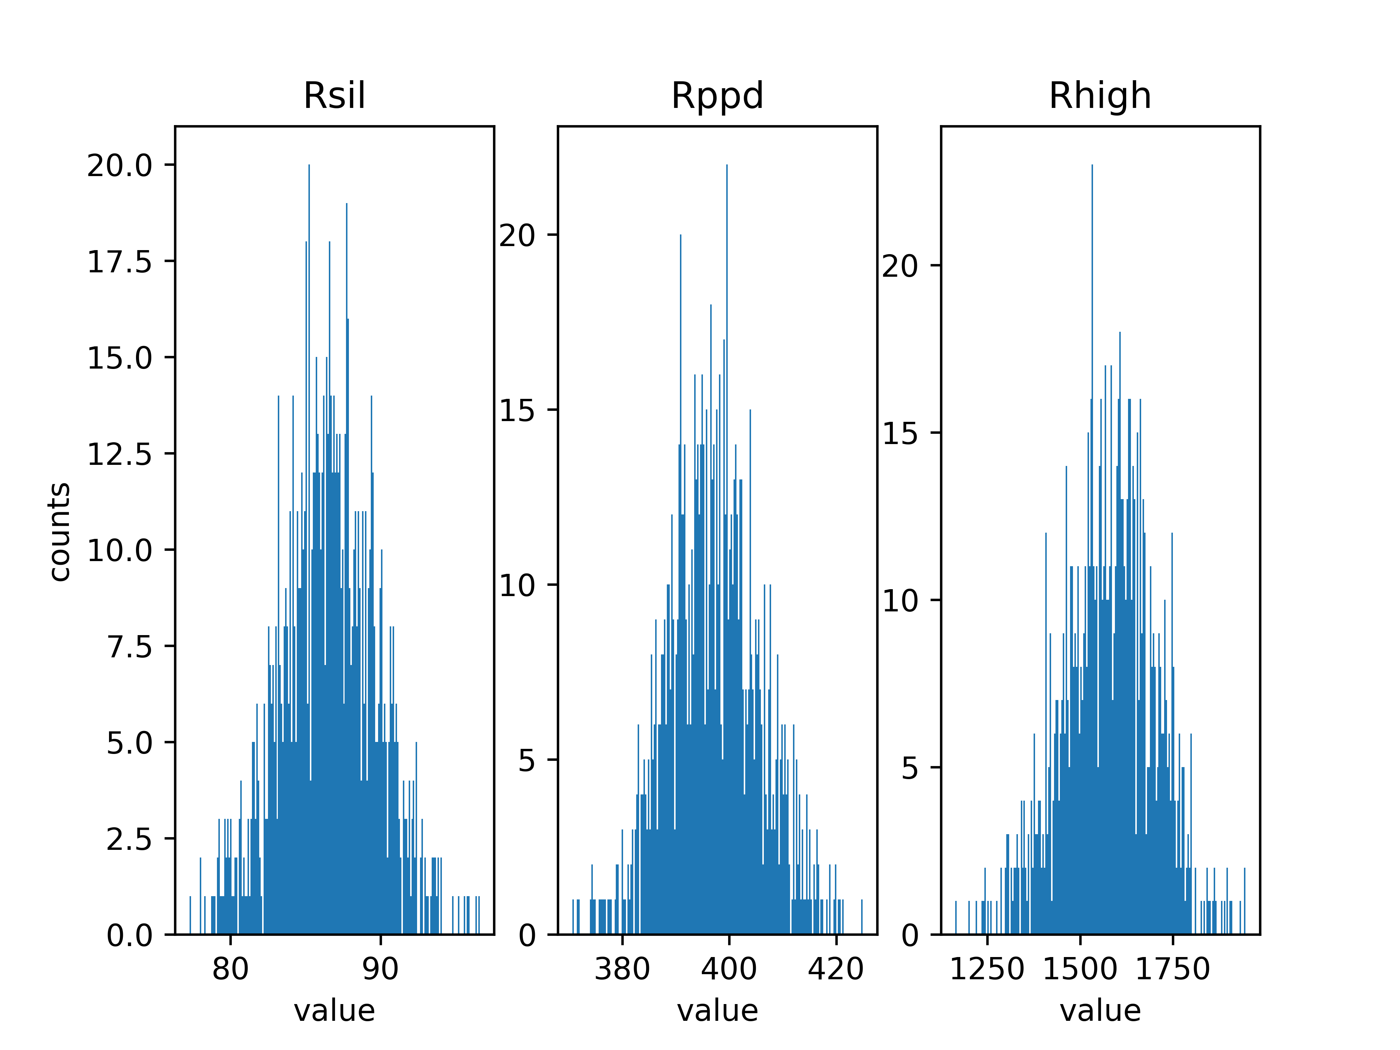
ihp-sg13g2/libs.tech/xschem/simulations/fig/mc_res_op.csv.png
