IHP-GmbH/IHP-Open-PDK/ihp-sg13g2/libs.tech/xschem/simulations/fig/sg13_lv_pmos.csv.png

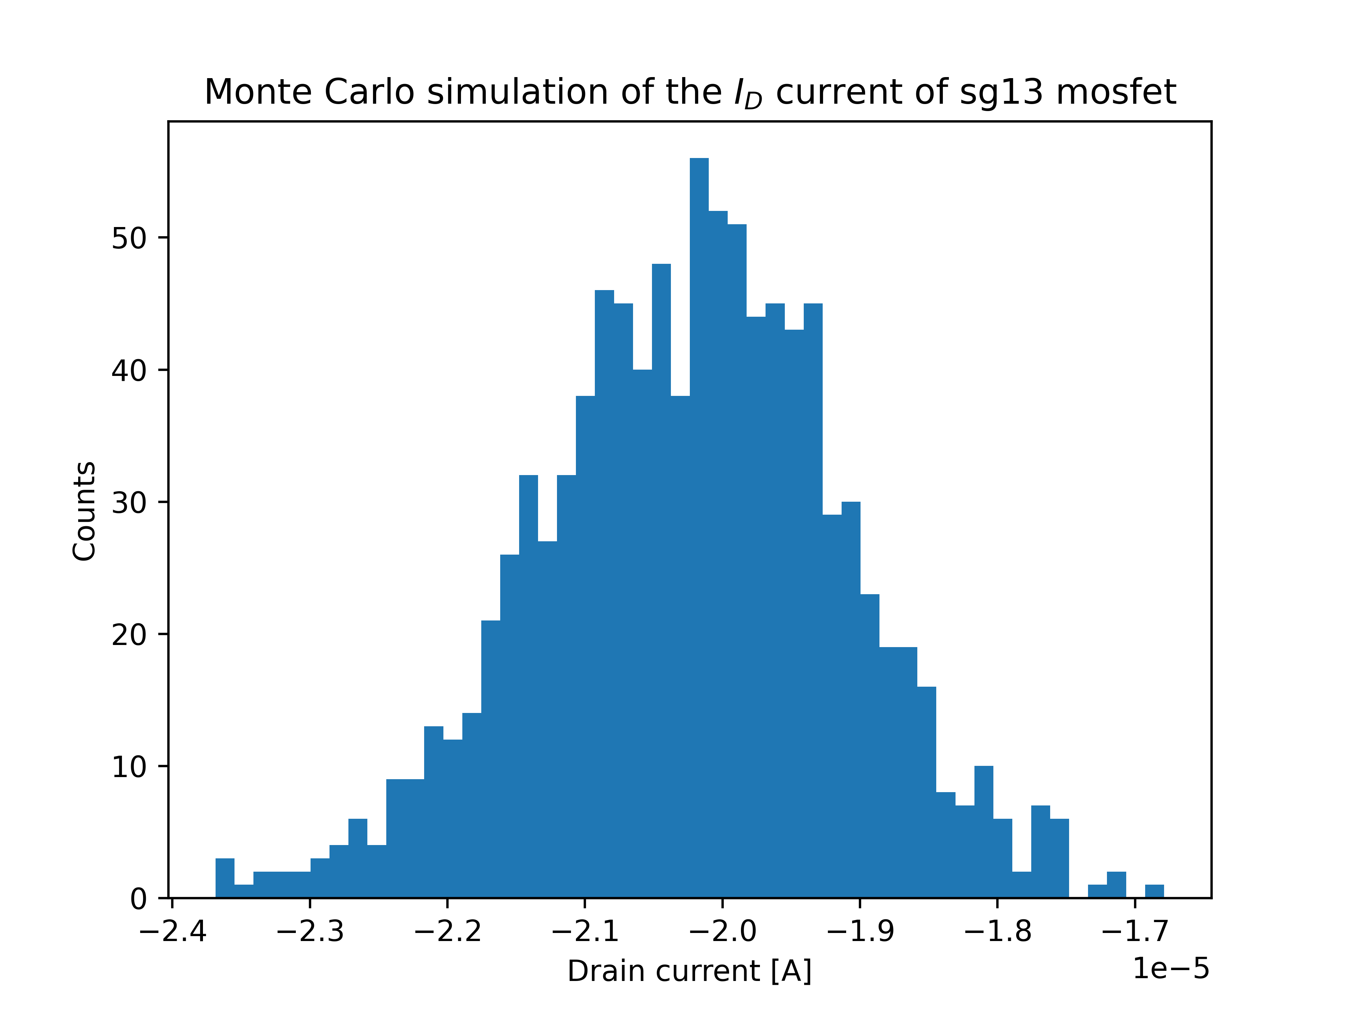
ihp-sg13g2/libs.tech/xschem/simulations/fig/sg13_lv_pmos.csv.png
