IHP-GmbH/IHP-Open-PDK/ihp-sg13g2/libs.qa/README.md

# Data for the Quality Assurance (QA) flow

Proposed directory structure:
```bash
.
├── drc
│   ├── devices
│   ├── layers
│   └── special
└── lvs
```
