IHP-GmbH/IHP-Open-PDK/ihp-sg13g2/libs.tech/klayout/tech/lvs/testing/testcases/README.md

SG13G2 LVS Tests
================

This directory contains the LVS test cases for SG13G2 technology.

Folder Structure
----------------

```text
📁 testcases
 ┣ 📜README.md                       This file documents the testcases directory.
 ┣ 📁 unit                           Contains the unit test structures per device.
   ┣ 📁<device_group>_devices        Contains all LVS testcases for each group.
    ┣ 📁layout                       Layout gds file for each device.
    ┣ 📁netlist                      Spice netlist file for each device.
 ┣ 📁 extraction_checking            Small testcase used to validate extraction/LVS switch behavior.
 ```
