IHP-GmbH/IHP-Open-PDK/ihp-sg13g2/libs.qa/stdcells/README.md

> [!NOTE]  
> `gdstk` Python module is required for `check_abutment.py`
