IHP-GmbH/IHP-Open-PDK/ihp-sg13g2/libs.doc/meas/pnpMPA/doc/results/images/beta_new.png

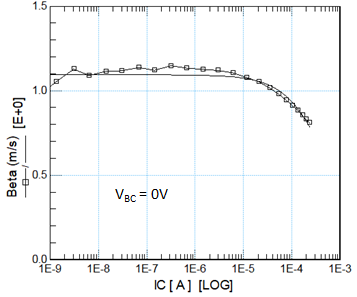
ihp-sg13g2/libs.doc/meas/pnpMPA/doc/results/images/beta_new.png
