IHP-GmbH/IHP-Open-PDK/ihp-sg13g2/libs.doc/meas/pnpMPA/doc/results/images/C_pnpMPA.png

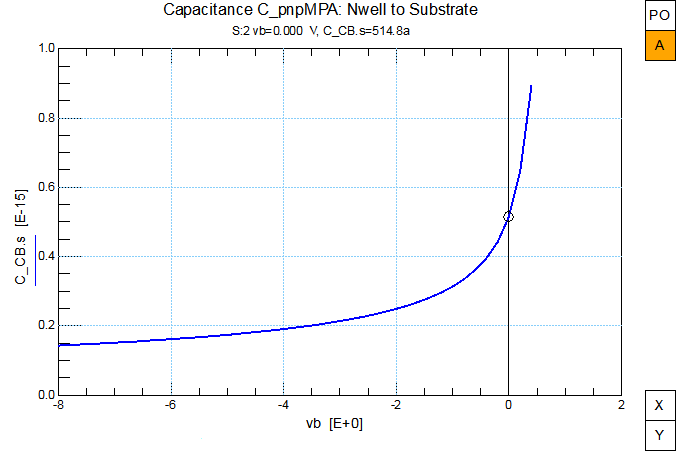
ihp-sg13g2/libs.doc/meas/pnpMPA/doc/results/images/C_pnpMPA.png
