IHP-GmbH/IHP-Open-PDK/ihp-sg13g2/libs.doc/meas/pnpMPA/doc/results/images/C_pnpMPA_new.png

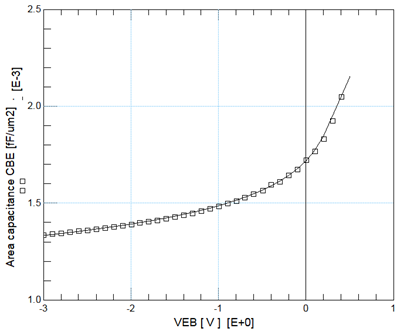
ihp-sg13g2/libs.doc/meas/pnpMPA/doc/results/images/C_pnpMPA_new.png
