IHP-GmbH/IHP-Open-PDK/ihp-sg13g2/libs.doc/meas/pnpMPA/doc/results/images/forward_gummel1.png

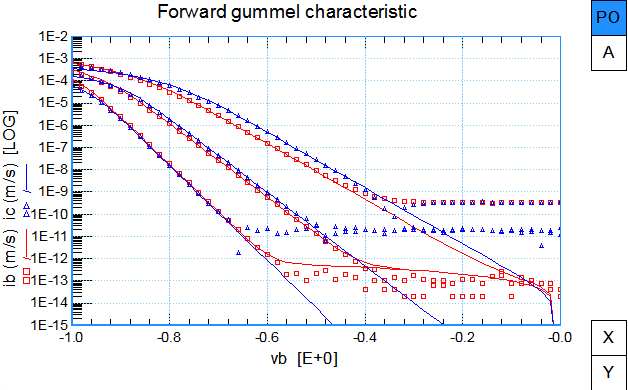
ihp-sg13g2/libs.doc/meas/pnpMPA/doc/results/images/forward_gummel1.png
