IHP-GmbH/IHP-Open-PDK/ihp-sg13g2/libs.doc/meas/pnpMPA/doc/results/images/forward_gummel_vbvc.png

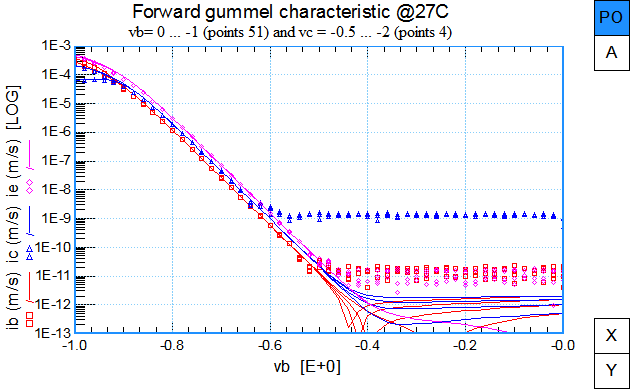
ihp-sg13g2/libs.doc/meas/pnpMPA/doc/results/images/forward_gummel_vbvc.png
