IHP-GmbH/IHP-Open-PDK/ihp-sg13g2/libs.doc/meas/pnpMPA/doc/results/images/mc.png

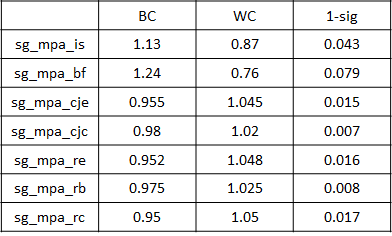
ihp-sg13g2/libs.doc/meas/pnpMPA/doc/results/images/mc.png
