IHP-GmbH/IHP-Open-PDK/ihp-sg13g2/libs.doc/meas/pnpMPA/doc/results/images/nwell_to_substrate.png

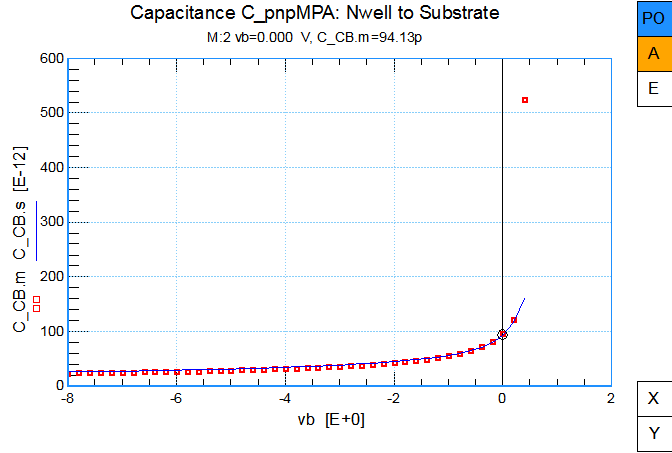
ihp-sg13g2/libs.doc/meas/pnpMPA/doc/results/images/nwell_to_substrate.png
