IHP-GmbH/IHP-Open-PDK/ihp-sg13g2/libs.doc/meas/pnpMPA/doc/results/images/PSD_nwell_perim.png

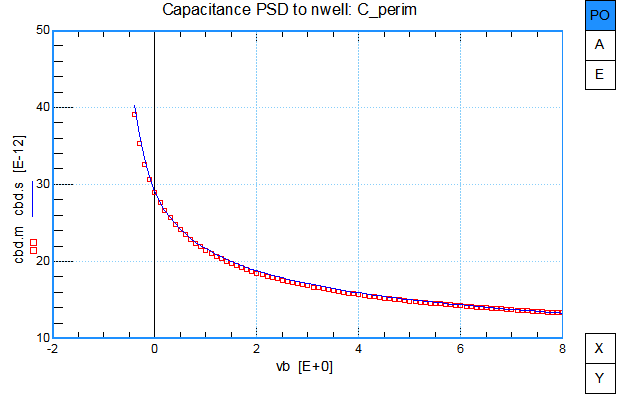
ihp-sg13g2/libs.doc/meas/pnpMPA/doc/results/images/PSD_nwell_perim.png
