IHP-GmbH/IHP-Open-PDK/ihp-sg13g2/libs.doc/meas/pnpMPA/doc/results/imgzoom/forward_output_ib_11.png

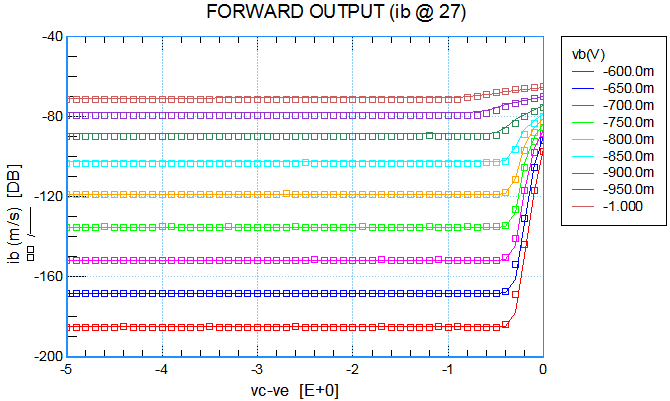
ihp-sg13g2/libs.doc/meas/pnpMPA/doc/results/imgzoom/forward_output_ib_11.png
