IHP-GmbH/IHP-Open-PDK/(threads)

Thread 2 (2023-04-04):

Invers operation correct?

dwarning, 2023-04-04:
Hello,
I made few check with the vbic's in ngspice. Most things are plausible, but invers operation seems a bit strange. That's said without knowledge of the npn13G2 structure/crossview.
Can you comment the attached picture made with Vce=-1V and Vbc=0.3 ... 1V.
Thank you for the Open-PDK activity.
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

bero4sc, 2023-04-08:
It is a HBT device. Why did you reverse bias the collector to emitter?

dwarning, 2023-04-08:
Ok, answer by myself. Model seems plausible, if I see the lower Early voltage in reverse operation compared to forward.
BTW - at the moment the vbic temp control is buggy in ngspice - will be repaired in next release.
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

Closed 2023-04-08.

Thread 3 (2023-05-31):

missing model for `sg13_lv_nmos`

proppy, 2023-05-31:
Trying to run the following ngspice simulation:
```
.title sg13g2_inv_1
.lib /content/IHP-Open-PDK/ihp-sg13g2/libs.tech/ngspice/models/SG13G2_hbt_woStatistics.hsp.lib
.include /content/IHP-Open-PDK/ihp-sg13g2/libs.ref/sg13g2_stdcell/spice/sg13g2_stdcell.spice

X1 GATE DRAIN VPWR 0 0 VGND sg13g2_inv_1

Vgnd  VGND  0     0
Vdd   VPWR  VGND  5.0
R     VPWR  DRAIN 50k
Vin   GATE  VGND  DC    0V
.op
.option post nomod
.end

.control
save all GATE DRAIN
dc Vin 0 5.0 0.01
display
wrdata output.txt GATE DRAIN
.endc
```
will result in the following error:
```
Error: unknown subckt: x1.xx1 vpwr gate 0 vpwr x1.sg13_lv_nmos x1.w=740.00n x1.l=130.00n x1.ng=1 x1.ad=0 x1.as=0 x1.pd=0 x1.ps=0 m=1
    Simulation interrupted due to error!
```

See the following notebook which reproduce the issue:
https://colab.research.google.com/gist/proppy/5582eeae8d2e2eccb48cd591b904185f/ihp-pdk-playground.ipynb

proppy, 2023-05-31:
Is that expected? (i.e: the model for nmos/pmos will only get developed/released later)

sergeiandreyev, 2023-05-31:
Hi! Yes, this is expected.. For now, we have only models for HBT (BJT) devices, for the MOSFET models we're still discussing the Spectre to SPICE format translation with 3rd parties. I hope they will be released in summer timeframe.
Also we're considering to put nmos/pmos Spectre models to the GitHub (but this will certainly help you only in case you have access to the simulator that supports them)

proppy, 2023-05-31:
maybe @RTimothyEdwards and @atorkmabrains can share some insight on how the conversation was done respectively for SKY130 and GF180MCU.

atorkmabrains, 2023-05-31:
@sergeiandreyev @proppy we actually use home grown scripts for this. But we also go into debugging the model card parameters and tweak them to match the desired outcome. That's why we always request a golden measurements data that we could use as a reference. It's very lengthy process if we faced issues related to not matching behaviors.

@sergeiandreyev Please contact me privately at linkedin if you want us to collaborate: https://www.linkedin.com/in/amro-t-24701458/

atorkmabrains, 2023-05-31:
@sergeiandreyev You don't need to release spectre Model cards for that BTW.

mithro, 2023-05-31:
https://semimod.de/ -- who is based in Europe might also be able to offer assistance, particularly if you are doing recharacterization stuff or regenerating from raw data.

The topic of spice model generation and validation comes up at lot in the CHIPS Alliance Analog work group (https://www.chipsalliance.org/workgroups/) and on the SKY130 raw data repository (https://github.com/google/skywater-pdk-sky130-raw-data).

metroid120, 2023-06-01:
Markus from SemiMod: Thanks for your efforts @noherbrferurtth @proppy
We are looking forward to helping with the model conversion and will join the IHP meeting that is coming up.

Also, I am delighted to share that we recently got funding for developing an open-source MOS Model extraction tool, so we are currently looking for (i) reference models and (ii) a test chip for measurement.
I think the IHP technology would be perfectly suited.

sergeiandreyev, 2023-09-13:
- we have now MOS Spectre models available in the repo: `libs.tech/spectre`
- and SemiMod @metroid120 did an outstanding job to convert these models for use w/ ngspice & Xyce (also HBT models were updated)
   The data is located in their GitLab repository https://gitlab.com/dmt-development/ihp_sg13g2_compact_models

sergeiandreyev, 2023-10-24:
update: we now have device simulation models available in the repo: `lib.tech/ngspice/models`
for usage please consult respective readme files and documentation on SemiMod GitLab [repo](https://gitlab.com/dmt-development/ihp_sg13g2_compact_models)

sergeiandreyev, 2024-03-23:
Hi @proppy , I guess this issue is resolved now.. Can we proceed and close this item as  fixed?

KrzysztofHerman, 2024-06-04:
Mosfets models available in `libs.tech/ngspice/`

Closed 2024-06-04.

Thread 4 (2023-08-09):

Wrong signal class for sg13g2_o21ai_1 cell

KrzysztofHerman, 2023-08-09:
Trying to port the IHP Open PDK to the OpenRoad-flow-scripts I got some issues with detailed routing. The exact bug is the following `[ERROR DRT-0307] Net 000 of signal type SIGNAL cannot be connected to iterm 318/Y with signal type POWER Error: detail_route.tcl, 59 DRT-0307`  The instance 318 is a  `sg13g2_o21ai_1` cell and its output is assigned to `USE POWER;` signal class in the LEF file.

sergeiandreyev, 2023-10-27:
stdcell LEF: `sg13g2_o21ai_1` pin Y signal class fixed (POWER->SIGNAL) as a temporary workaround, LEF should be regenerated

KrzysztofHerman, 2024-06-04:
LEF view updated.

Closed 2024-06-04.

Thread 5 (2023-08-09):

clk-pin not reacheable

mi-and-core, 2023-08-09:
In sg13g2_dfrbp_2 clk-pin (Metal1, red) is masked by reset_B (Metal2, blue) :

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

sergeiandreyev, 2023-10-27:
please take a look at the latest stdcell update, this should be fixed now

Closed 2023-10-30.

Thread 9 (2023-08-31):

diode devices DRC and models

stafverhaegen-chipflow, 2023-08-31:
In the layout rules manual there is mention of a `Recog.diode` layer and this layer is also used in the `sg13g2_pr.gds` in for example the `dpantenna` cell.
No devices for diodes using this layer are present in the layout rules or the process specification manual. Neither could I find models for diodes.

sergeiandreyev, 2023-09-14:
There are no design rules related to `Recog.diode` directly because it is only a recognition layer w/o any physical meaning. And the `dantenna` and `dpantenna` devices are not present anywhere in DRM because there are no any design rules specific for these cells (whereas, for example, Schottky diode has specific rules and is described in the DRM).
Please let me know if that answers your *first* question.
For the models - we are going to convert them for the open source simulator support and then upload to our repository.

Regards,
 Sergei

FatsieFS, 2023-09-14:
Once the models are there I do think it makes sense to have a section on them in the `Device layout rules` Chapter and have rules for `Recog.diode` like `Rsil.c` for `RES`.
I suppose `Recog.diode` does play a role in LVS.

sergeiandreyev, 2024-03-23:
Hi @FatsieFS , now we have diode models in place available in our OpenPDK repository. I'll let you know regarding the update of the documentation.

Closed 2024-06-04.

Thread 11 (2023-09-12):

Resistor models lacking parasitic capacitor

hpretl, 2023-09-12:
The resistor models in `resistors.lib` currently lack parasitic capacitors, which are important for analog and RF. Therefore, two asks:

1) Please add a substrate node to the model subcircuits to account already now for parasitic caps added later.
2) Add parasitic caps.

sergeiandreyev, 2023-10-24:
just an update:
- we now have parasitic capacitor models in `capacitor_mod.lib` (*dev* branch)
- substrate node will be added to r3 compact model, which is in progress

sergeiandreyev, 2025-05-21:
Hi @prabhatdubey92, is this resolved? we do have `r3_cmc` model..

Thread 12 (2023-10-04):

wirebond-pads and ESD protection

olisnr, 2023-10-04:
i would like to know how wirebond-pads and ESD-protection should be done in iHPs and skywaters 130nm BiCMOS processes. is there some documentation? i didnt found anything in the PDKs

olisnr, 2023-10-05:
when i open the **sg13g2_pr.gds** from the PDK, i see many interessting cells. "bondpad" or "diodevdd_2kv" as example. buuuut there is no model for ngspice in the **IHP-Open-PDK-main/ihp-sg13g2/libs.tech/ngspice/models** and no documentation in the **SG13G2_os_process_spec.pdf**

HELP!

sergeiandreyev, 2023-11-02:
This PDK is in early alpha state. This means the PDK is still in development and not comprehensive tested by IHP. The PDK may contain [serious] errors and may not contain all of the features that are planned for the final version. But we're working constantly on this project to offer as stable PDK as possible to the community.

sergeiandreyev, 2023-11-02:
Regardibg the `bondpad` cell I can comment that we do not have a "real" model for it even in the commercial PDK, so please use just a 'placeholder' for this device.

Closed 2023-11-29.

Thread 20 (2023-11-16):

Xschem example circuits should not contain `pre_osdi`

hpretl, 2023-11-16:
In situations where the VerilogA models are located in a central location (not in various simulation directories, but e.g. in `.../ngspice/lib/ngspice`) the `pre_osdi` directive leads to an error when starting `ngspice`.

As a consequence, this directive should not be part of the "standard" examples. Alternatively, it should be wrapped into a check whether this file exists in this local directory.

olisnr, 2023-11-21:
i think the `pre_osdi ./psp103_nqs.osdi` belongs to the

`https://gitlab.com/dmt-development/ihp_sg13g2_compact_models`

hpretl, 2023-11-21:
Yes, the statement `pre_osdi` loads the external PSP model into ngspice which is needed for the IHP MOSFET. But this model can be loaded from a central location with a central ngspice setting. Thus, the `pre_osdi` is not needed in every schematic.

olisnr, 2023-11-21:
You would prefer `./simulation/.spiceinit` then?

hpretl, 2023-11-21:
Not really. In our Docker image we just copy `psp103.osdi` into `.../ngspice/lib/ngspice`, and uncomment the corresponding line in `.../ngspice/share/ngspice/scripts/spinit`:

```
* Load the OpenVAF/OSDI models
if $?osdi_enabled

 * osdi /foss/tools/ngspice/ngspice/lib/ngspice/asmhemt.osdi
 * osdi /foss/tools/ngspice/ngspice/lib/ngspice/bjt504t.osdi
 * osdi /foss/tools/ngspice/ngspice/lib/ngspice/BSIMBULK107.osdi
 * osdi /foss/tools/ngspice/ngspice/lib/ngspice/BSIMCMG.osdi
 * osdi /foss/tools/ngspice/ngspice/lib/ngspice/HICUMl0-2.0.osdi
 osdi /foss/tools/ngspice/ngspice/lib/ngspice/psp103.osdi
 * osdi /foss/tools/ngspice/ngspice/lib/ngspice/r2_cmc.osdi
 * osdi /foss/tools/ngspice/ngspice/lib/ngspice/vbic_4T_et_cf.osdi

end
```

This `spinit` is the default init `ngspice` reads.

hpretl, 2023-11-21:
Since quite a few `.osdi` files are already there, and are included in the same way, it feels natural to add the PSP model there as well.

hpretl, 2024-07-17:
It looks like this will be resolved soon: https://github.com/IHP-GmbH/IHP-Open-PDK/pull/162

Closed 2024-08-20.

Thread 22 (2023-11-21):

question is the "sg13g2_pr.gds pnpMPA" usefull for band-gap references?

olisnr, 2023-11-21:
or what is it for?

olisnr, 2023-11-22:
and what is the "ng"-parameter in the MOS-models? is it "number of gate-strips"? and how does it compare to the "m"-parameter?

sergeiandreyev, 2023-11-23:
You're right about `pnpMPA` - this device is a pnp HBT and it is used for band-gap reference circuit.

sergeiandreyev, 2023-11-23:
`ng` stands for 'Number of gates' - Forms a multi-finger gate. The individual channel width will be the total width divided by `ng`.

sergeiandreyev, 2023-11-23:
and `m` is for 'number of parallel instances'. I'll see if I can provide some clear explanation how these two parameters (if) are interconnected

olisnr, 2023-11-23:
thanks a lot.

then i have some other questions
- is there a spice-model for the pnpMPA, or should i use some BC560B as model?
- is dantenna and dpantenna thought as gate-protection, against static charge in production?
- what is ntap and ptap? some bulk-connection?
- what is the sealring good for?

sergeiandreyev, 2023-11-23:
you can try to play with the nmos Pcell in KLayout that we have as part of our repo `libs.tech/klayout` to see how `ng` and `m` are working

olisnr, 2023-11-23:
> you can try to play with the nmos Pcell in KLayout that we have as part of our repo `libs.tech/klayout` to see how `ng` and `m` are working

thanks: `ng` changes the shape of the transistor but not `W` and `L`. `m` does nothing with the pcell and if i see this correct, the layouter has to place and route `m` times this pcell in parallel. agree?

Closed 2023-11-29.

Thread 24 (2023-11-27):

Simulation problem with diode model and elevated temperatures

stafverhaegen-chipflow, 2023-11-27:
I have a test case of an IO cell I am working on: [hightemp_sim.zip](https://github.com/IHP-GmbH/IHP-Open-PDK/files/13476981/hightemp_sim.zip)
You can run the simulations with the `./sim.sh` and that generates the included `sim25c.out` and `sim70c.out` files. As you can see the simulation works for 25℃ but not for 70℃. For 70℃ the reporter error is:
```
doAnalyses: TRAN:  Timestep too small; initial timepoint: trouble with darea-instance d.xtop.xnclamp.xdgate.d1
```

KrzysztofHerman, 2024-02-26:
I have consulted this unusual behavior of the simulation with the developer of ngspice prof. Holger Vogt. He noticed that the model of the permi diode, which conforms the dantenna diode has an unusually low value of $v_j$ parameter, what causes convergence issues. The parameter itself varies with the temperature, what explain the situation that at $T=25$ the simulation converges and at $T=70$ does not. We will update the model as soon as we derive a valid value.

sergeiandreyev, 2024-02-29:
we see the warnings in commercial simulator as well, but the default behavior we have there is that the `vj` parameter value is constrained to a larger value, this is why the simulation is not failing for internal PDK

sergeiandreyev, 2024-03-01:
diode model `dperim` was fixed

sergeiandreyev, 2024-03-23:
Hi @stafverhaegen-chipflow , could you please confirm that the issue is resolved and can be closed.
Thanks,
 Sergei

stafverhaegen-chipflow, 2024-03-25:
I can confirm that the simulations now run at elevated temperature.
Sorry for the delay.

Closed 2024-03-25.

Thread 25 (2023-11-28):

sg13_lv_nmos ignores the "m" parameter

olisnr, 2023-11-28:
the **sg13_lv_nmos** model should accept an `m` parameter in spice-simulation. at least the Xschem-symbol has this parameter and any MOS-device should, because its a spice-standard. but i ngspice-simulations this multiplier is ignored. actual i would expect something like multiplying the parameter W.
in the file `IHP-Open-PDK-main/ihp-sg13g2/libs.tech/ngspice/models/sg13g2_moslv_mod.lib` there is a parameter `mfact=1`. may be thats the `m`?
but `XM1 net3 net1 GND VSS sg13_lv_nmos W=2.0u L=0.45u ng=1 mfact=100` also dosnt work...

metroid120, 2023-11-28:
Hi, the model description is given here:
https://gitlab.com/dmt-development/ihp_sg13g2_compact_models
Maybe we should put a description also somewhere in this PDK?

The parameter "ng" should do what you want. The "M" parameter or "MFACT" for PSP model was not implemented/used here.

olisnr, 2023-11-28:
the ng-parameter makes the same W via many smaller W/ng. if i make an 10u/1u ng=5 FET, then it produces a fet with 5 fingers and about W=10u (per FET not per finger).

metroid120, 2023-11-28:
Yes, I agree this seems odd. Can you post a Screenshot of the FET in Klayout with ng=2?

miesli, 2023-11-28:
Hi,

as @metroid120 already stated, we followed along the original spectre model, because this was verified against measurement by IHP. Why it was used like this, we do not know. There are multiple possible explanations, but this would be speculative. Our goal was to have the OpenPDK as a drop-in replacement for SG13G2.

On the other hand: In the PSP Verilog-A code, there are instance parameters called `mult` (number of devices in parallel),  `ng` (number of gate contacts) and `nf` (number of fingers).  And in the code you can see, that `mult` is multiplied to the currents and charges at the output. So using `mult` would be the way to go.

So, one possible step is to do a netlist extraction from different FET layouts to see what kind of netlists are created. Is this already possible in the OpenPDK?

olisnr, 2023-11-28:
`Nsg13_lv_nmos d g s b sg13g2_lv_nmos_psp w='w/ng' l=l mult=ng` mult is already used inside the model. its not accessible from spice, maybe i can change the model to   `Nsg13_lv_nmos d g s b sg13g2_lv_nmos_psp w='w/ng' l=l mult=ng*m` ?

olisnr, 2023-11-28:
if i understand the `m` and `mult` parameter correct, its about to be able to use some parts in parallel, without the need of drawing all this parts and wire it together.

its clear that a real circuit has real wires, not ideal ones like in the schematics. but the factor `m` and `mult` dont have to do something other then connect many parts without the real effects of wiring. this effects will be visible anyway only at time of parameter-extraction.

olisnr, 2023-11-28:
the idea with changing the netlist would work: i could use TCL in Xschem to generate `m` times the same MOSFET in the spice-netlist. but then the sad ngspice has to simulate all this parts. a `m` or `multi` factor will reduce the simulation time great if You need many parts parallel...

olisnr, 2023-11-28:
if i change all the models to         `Nsg13_lv_nmos d g s b sg13g2_lv_nmos_psp w='w/ng' l=l mult='m*ng'` **mult='m*ng'** instead of **mult=ng**, then m does what i would expect:

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

metroid120, 2023-11-28:
only at first glance, this is correct.
In the original specter model call

```
        sg13_hv_nmos (d g s b) sg13g2_hv_nmos_psp w=w/ng l=l m=ng
        + as=max(w/ng,wmin)*(z1+((ng-1)/2)*z2)/ng
        + ad=max(w/ng,wmin)*(z1+((ng-1)/2)*z2)/ng
        + ps=2*(max(w/ng,wmin)*((ng-1)/2+1)+z1+(ng-1)/2*z2)/ng
        + pd=2*(max(w/ng,wmin)*((ng-1)/2+1)+z1+(ng-1)/2*z2)/ng
        + trise=trise
        + ngcon=2
```

as, pd etc. are scaled according to ng. I assume if you also multiply those by "m" it **_MIGHT_** be correct.

olisnr, 2023-11-28:
im not sure: `m` or `multi` should do this multiplications inside the model.

but i will try some ac-simulations also and see what comes out of the simulation if i replace ng with 'ng * n' everywhere.

olisnr, 2023-11-28:
and here comes ng=1 and ng=2 from KLayout

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

miesli, 2023-11-28:
Can you also show mfact = 1 and = 2?

PS I assume that all the other parameters did not change.

olisnr, 2023-11-28:
this are the settings of the fets in KLayout:
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

miesli, 2023-11-28:
Thank you for showing this.

ng is then the thing the documentation in the model files says it is. It allows using the same drain twice.

m or mfact is not used neither in the layout nor the circuit models.

It seems that the SG13G2 PDK does not support MOSFET multiplication. To get more current, you should increase the size or place multiple instances in parallel. Of course, this is impractical and increases simulation time.

It is a good thing that this PDK is open :). I would recommend for the "netlist phase" to go for the mult=m*ng you described above where you also set ng=1. Later on, when you iterate on the layout, go to m=1 with parallel instances and ng=1 or 2 depending on your layout needs.

Also, in favor of having the openPDK as a drop-in replacement for SG13G2, I would not change the "main" model files. But of course that is up to IHP to decide. As promised, I will improve the documentation on our model-repo.

olisnr, 2023-11-28:
yes i see it also this way, but i would be glad, it iHP would adopt the `m` parameter in the spice-models, so that there is no need to try to improve it with trail and error...

sergeiandreyev, 2023-12-11:
we need to understand the root cause of this issue and to discuss this with Semimod guys, I have an internal testcase with the commercial tools/models of our PDK and the `m` parameter is working there (the change in the value => changes the simulation result as expected)
unfortunately, as you understand, I cannot share the full testcase for the open source community

metroid120, 2023-12-12:
At least the "mfact" parameter of the models is completely ignored by the original models.

I assume that maybe "m" somehow changes "ng" via the PDK integration that we have not seen. Not sure at this point.

dwarning, 2024-02-06:
Out of curiosity: mfact is used in the flatband calculation parameter vfbo.
The actual mix of ng, nf and mult shows that the original spectre lib is not able to describe separate device multiplication.

sergeiandreyev, 2024-03-23:
Hi all, so with the latest update from @miesli  I guess this issue could be closed as fixed, could you please confirm @olisnr ? @KrzysztofHerman checked the behavior against the commercial tools/PDK and now we see identical results, so let's assume we have the models aligned in this regard.
On the multi-finger device measurements, unfortunately best case we will have them end of this year / begging of next.. So we cannot decide on the quality of internal implementation until then.

Closed 2024-06-04.

Thread 30 (2023-12-01):

SOA checks for sg13g2 MOSFETs

olisnr, 2023-12-01:
is it possible to do ngspice-simulations with SOA-checks? i didnt found anything about it in the documentation.

KrzysztofHerman, 2024-10-29:
Yes it is possible. Take a look at chapter 11.5 in [ the ngspice manual](https://ngspice.sourceforge.io/docs/ngspice-html-manual/manual.xhtml#magicparlabel-23015). We are collecting the data to provide this kind of warnings in our PDK but this task it not a high priority one. Can we close this issue ?

olisnr, 2024-10-29:
ok

Closed 2024-10-29.

Thread 31 (2023-12-01):

documentation: IHP-Open-PDK-main/ihp-sg13g2/libs.tech/xschem/README.md could be enhanced

olisnr, 2023-12-01:
the `m` in the MOSFETs isnt working yet (should be mentioned), and the non-transistor parameters arent  indicated generally. the resistor models as example have an `b` parameter, thats not described. could it be number of bends?

sergeiandreyev, 2023-12-11:
this information will be provided as part of the process spec document for every device used in the PDK (unfortunately it's update is still in progress..)
regarding the resistor `b` parameter, you're correct:
> Number of bends. For large R values a meander shape is useful to generate a more compact device at the expense of accuracy. Integer number.

olisnr, 2023-12-11:
thanks.

Closed 2023-12-11.

Thread 32 (2023-12-04):

symbols of mos-transistors better would use "l" and "w" instead of "L" and "W" because ...

olisnr, 2023-12-04:
... the models also use lower-case, and even if ngspice isnt case-sensitve, TCL is, and also the symbol-text of Xschem. and thus mixing cases in Xschem should be avoided if possible.

KrzysztofHerman, 2024-06-04:
Solved in  #132, issue closed.

Closed 2024-06-04.

Thread 33 (2023-12-08):

matching data for transistors are missing in SG13G2_os_process_spec.pdf ...

olisnr, 2023-12-08:
... or i simply didnt found it :)

but in the section **4 Attachment A: Measurement Conditions** there are descriptions of:
Transistor Matching Coefficient k
MOS Transistor Matching Coefficient k
and so i would expect this parameters in **2.1 NMOS** and so on like in **2.7 Rsil**

sergeiandreyev, 2024-02-07:
thanks for finding! we're checking this internally, it could be that obsolete / not used parameters were not deleted from the *Measurement Conditions* section

Thread 34 (2023-12-10):

Unexpected behavior/values seen in small-signal models of thin-oxide devices.

bmurmann, 2023-12-10:
1. The gate overlap capacitances seem to be very large. An op analysis for a 5/0.13 NMOS (sg13_lv_nmos) gives cgsol = 3.19575e-15 fF. This corresponds to 0.64 fF/um, about twice as large as in other 0.13 um CMOS processes. Are these realistic models?
2. A likely non-physical kink is seen when running a VGS DC sweep and plotting fT = gm/Cgg/2/pi for the NMOS device (sg13_lv_nmos).
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
For reference, here is my Jupyter notebook that produces these data:
https://github.com/bmurmann/Ngspice-on-Colab/blob/main/notebooks/IHP_SG13G2_VGS_sweep.ipynb

metroid120, 2023-12-12:
Dear Boris,

find attached our results documentation for the compact models of the MOSLV. We converted the existing spice models to ngspice format.

_**Regarding fT:**_

As you can see, the fT does not show such a kink for the analyzed devices.
The way you plot fT is simple, but only has limited meaning. It is more rigorous to plot

fT = f/Im(Y11/Y21)   (where f is a spot frequency)

You must run an AC analyis.

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

_**Regarding Overlap caps:**_

Let us do an approximate calculation based on the model parameters of the LV NMOS and the model equations.
The total GS overlap charge in the model is

`                    Qfgs         =  Qfgs + Qgs_ov;`

The model parameter CFRW (outer fringe capacitance for 1 um wide device)

`'((1-rfmode)*2e-16 + rfmode * (1e-18 + pre_layout * (ng>0 ? 3.8525e-17 : 0)))/ng' `

evalutes to 0.2 fF/um for rfmode=1. It sets Qfgs.

The model variable that sets Qgs_ov is

`                        CGOV_p       = `EPSO * EPSROXO_i * WEcv * LOV_i / TOXOVO_i;`

, which depends on several model parameters that are physics-based. We can approximately evaluate this capacitance to be

CGOV_p = 8.85e-12 F/m 3.9*5um*0.13um/2.2nm = 10.2 fF

I ignored some stuff here, like the difference between drawn and actual channel.
The total CGSOV for a 0.13/5 device is 11.2 fF. This corresponds to around 2 fF/um.
So somehow even higher than what you have. Not sure what to make of this.

[documentation.pdf](https://github.com/IHP-GmbH/IHP-Open-PDK/files/13646005/documentation.pdf)

bmurmann, 2023-12-12:
1) I would say it's the other way around regarding limited meaning. If I use the total cap (including huge overlap caps) and plot against log(ID) I also no longer see that kink; it is a nice way to swamp it out and sweep things under the rug 8). So, this has nothing to do with h-parameters, but with the modeling of the intrinsic transistor.
From the way you responded, I see that you think about fT like a microwave designer. There is another world of low frequency design where we think of the ratio gm/Cgg as a figure of merit that tells us how much gm we get per invested gate cap. In that world, we are not interested in the physical unity gain frequency, and it makes no sense to burden circuit design with h parameters. Instead, what we need is an accurate accounting of gate capacitance at a given gm. Here it also make sense to distinguish intrinsic and extrinsic components for model sanity checks (as I did).
2) You may know that for the longest time of this industry (before Dennard scaling ended), 2fF/um was a fairly technology independent value accounting for the total (intrinsic + extrinsic) gate capacitance of a MOSFET. After Dennard ended, this got closer to 1.5 fF/um. Now, with that in mind, it is obvious that having an overlap capacitance of about 2.2 fF/um (per your calculation) either means the technology or the model is broken. I am not sure how I can help in making that determination. Here is a table of typical parameters from Tony Chan Carusone's textbook:
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

sergeiandreyev, 2023-12-13:
Hello Boris,
 I reproduced the large gate capacitance values in your testcase using our commercial tools/PDK. On my side these are:
`cgsol = 3.225496 fF
cgdol = 3.123428 fF`

I'm forwarding this issue to our IHP modeling experts..

metroid120, 2023-12-13:
The physical origin of the large cgsol is largely the LOV parameter (see my parameter) that can be taken from cross-sections. One could check that.

bmurmann, 2023-12-13:
Thank you, everyone. BTW, I looked at the docs here: https://github.com/IHP-GmbH/IHP-Open-PDK/tree/main/ihp-sg13g2/libs.doc/meas/MOS/doc. I am getting very large values for Cov when I divide the measured cap by the give width. But, I am not sure if I am interpreting the data correctly.

bmurmann, 2024-03-20:
A couple more observations for this thread:
1) The process spec says that the nominal "Miller cap" is 0.36fF/um for an NMOS.
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
2) For a 10/0.13 NMOS, the simulated cgdol=6fF, while 3.6fF is expected from the process spec. The simulated value changes to 4.6fF with ng=4, which is hard to explain when I think about the actual layout. I can see how some deltaW affects this in a fingered device, but in reality splitting up a device does not really give you smaller caps (due to fringing).

hpretl, 2024-07-17:
See here for an observation regarding the model usage of number of fingers: https://github.com/IHP-GmbH/IHP-Open-PDK/issues/164

dwarning, 2024-10-23:
Try to understand the problem and made few AC simulations with two 10/0.13 lv_nmos devices (NF=1 and 4):

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

The simulations show a value of 12fF for both devices which I must divide by 2*10um because of Cgdov and Cgsov in parallel.

@bmurmann: You said that you simulated and got for a fingered device a much lower value of 4.6fF. How you get this values? Are these OP information's as shown in your initial setup?

bmurmann, 2024-10-23:
I don't have think I have this simulation anymore, which was back in March, and also before some changes were made to the models. I will try to duplicate this early next week when I am back from travel. In any case, if Cgdov is 0.6 fF/um, it does not match the given process spec:
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

Thread 37 (2023-12-21):

it seems like the pnpMPA model and pnpMPA.sym have different pin-orders

olisnr, 2023-12-21:
in the file `IHP-Open-PDK-dev/ihp-sg13g2/libs.tech/ngspice/models/sg13g2_hbt_mod.lib` there is a model:
```
.subckt pnpMPA e b c
.param a=2p p=6u ac=13.33p pc=14.64u
+ dev_a=a*1e12 dev_p=p*1e6 sub_a=ac*1e12 sub_p=pc*1e6

QpnpMPA e b c pnpMPA_mod area=dev_a
...
```
but if i run the netlist-generation of Xschem for `IHP-Open-PDK-dev/ihp-sg13g2/libs.tech/xschem/sg13g2_tests/dc_pnpMPA.sch` it generates:
```
** sch_path: IHP-Open-PDK-dev/ihp-sg13g2/libs.tech/xschem/sg13g2_tests/dc_pnpMPA.sch
**.subckt dc_pnpMPA
XQ1 net3 net1 E1 pnpMPA
Ve net2 E1 0
.save i(ve)
Vb net1 GND 0
.save i(vb)
Vc net3 GND 0
.save i(vc)
I0 GND net2 1u
...
```

it seems to me that `c` and `e` are interchanged somewhere.

olisnr, 2023-12-22:
i think the description of the model is wrong and should be `QpnpMPA c b e pnpMPA_mod area=dev_a` because the gain of the transistor is a bit over 1, and thats like in the measurement data, where the gain is typical about 1.5.
and if i flip the pnpMPA in the test-circuit so that `c` is `e` and versa vice, the gain is much lower.

i would also like to know, why the different DUT-measurements of the pnpMPA in `IHP-Open-PDK-dev/ihp-sg13g2/libs.doc/meas/pnpMPA` are that different. i dont see any differences in the headers of `fg_vcb0_d0406_DUT1.mdm .. DUT17.mdm`, its always
```
  TNOM "27"
  TEMP "27"
  TECHNO "SG13S"
  LOT "PQA701"
  WAFER "17"
  CHIP "d0406"
  MODULE "T323_pnpMPA"
```
so i would think, the data should be more or less the same for all DUTs

sergeiandreyev, 2024-01-15:
the comments section has a specific DUT defined for each of the .mdm files, and these are different:
```
  DEV_NAME "DUT4"
```
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

sergeiandreyev, 2024-01-15:
on the pin order, I'm checking internally

sergeiandreyev, 2024-07-22:
Hi @olisnr, we uploaded to the repository the measurement documentation for the `pnpMPA` device ([link](https://github.com/IHP-GmbH/IHP-Open-PDK/tree/dev/ihp-sg13g2/libs.doc/meas/pnpMPA/doc)) - could you please check it and give your feedback if there are still some open questions regarding the device
If this is the case maybe we should have a video call then

olisnr, 2024-07-24:
there is also a link-problem in the HBT doc:
`file:///home/ich/share/pdk/ihp-sg13g2/libs.doc/meas/HBT/doc/html_npn13g2_VBIC/result_Spar.htm` points to `file:///home/ich/share/pdk/ihp-sg13g2/libs.doc/meas/HBT/doc/html_npn13g2_VBIC/reszoom_S22.htm` but should to `file:///home/ich/share/pdk/ihp-sg13g2/libs.doc/meas/HBT/doc/html_npn13g2_VBIC/reszoom_s22.htm`

sergeiandreyev, 2024-09-30:
Hi @olisnr, finally we can confirm the issue - could you please double check the fix on your side as well?

sergeiandreyev, 2024-10-23:
@olisnr, gentle reminder

olisnr, 2024-10-23:
Yes. its fixed. thanks!

Closed 2024-10-23.

Thread 38 (2023-12-28):

gm/gds versus gate bias (lv_nmos)

bmurmann, 2023-12-28:
The simulated gm/gds versus gate bias (for various L) for an lv_nmos looks quite odd (see plot below). Does the measured data support this? I found only plots of gds versus drain bias in the documentation. The netlist to duplicate this plot is below.

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

******************************
** sch_path: /foss/designs/gds_n.sch
**.subckt gds_n
Xm1 d g GND b sg13_lv_nmos W={Wx} L={Lx} ng=1 m=1
Vgs g GND 0.6
Vds d GND 1.2
Vsb GND b 0
**** begin user architecture code
 .lib /foss/pdks/ihp-sg13g2/libs.tech/ngspice/models/cornerMOSlv.lib mos_tt

.param temp=27
.param Wx=5u
.param Lx=0.13u
.dc Vgs 0 1.2 0.01
.save @n.xm1.nsg13_lv_nmos[gm]
.save @n.xm1.nsg13_lv_nmos[gds]

.control
*pre_osdi ./psp103_nqs.osdi

foreach L_val 0.13u 0.14u 0.15u 0.16u 0.17u 0.18u 0.19u  0.2u 0.3u 0.4u 0.5u 1u 2u 3u
  alterparam Lx = $L_val
  reset
  run
  let av=@n.xm1.nsg13_lv_nmos[gm]/@n.xm1.nsg13_lv_nmos[gds]
end

plot all.av

.endc

**** end user architecture code
**.ends
.GLOBAL GND
.end

bmurmann, 2023-12-30:
Also, I am surprised to see the sign of gm flip negative when VDS=0. I know it's a small value, but I've never seen a MOS model that does this. The model expression should give exactly zero in this condition.

PSPNQS103VA: A simulator independent device loaded with OSDI
     device   n.xm1.nsg13_lv_nmos
      model xm1:sg13g2_lv_nmos_ps
   _mfactor                     1
          m                     1
          l               1.3e-07
          w                 5e-06
         sa                     0
         sb                     0
         sd                     0
        sca                     0
        scb                     0
        scc                     0
         sc                     0
         nf                     1
      ngcon                     2
        xgw                 1e-07
        nrs                     0
        nrd                     0
         jw                 1e-06
     delvto                     0
     factuo                     1
 delvtoedge                     0
 factuoedge                     1
   absource                 1e-12
   lssource                 1e-06
   lgsource                 1e-06
    abdrain                 1e-12
    lsdrain                 1e-06
    lgdrain                 1e-06
         as               1.7e-12
         ps             1.068e-05
         ad               1.7e-12
         pd             1.068e-05
       mult                     1
        dta                     0
      ctype                     1
      sdint                     1
        ise          -1.41647e-12
        ige           2.83294e-12
        ide          -1.41647e-12
        ibe          -3.38614e-22
        ids                     0
        idb                     0
        isb                     0
        igs           1.41647e-12
        igd           1.41647e-12
        igb           3.38614e-22
     idedge                     0
       igcs           1.19916e-12
       igcd           1.19916e-12
       iavl                     0
      igisl                     0
      igidl                     0
        ijs                     0
     ijsbot                     0
     ijsgat                     0
     ijssti                     0
        ijd                     0
     ijdbot                     0
     ijdgat                     0
     ijdsti                     0
        vds                     0
        vgs                   0.6
        vsb                     0
        vto              0.436045
        vts              0.436045
        vth              0.436045
        vgt              0.163955
       vdss              0.193087
       vsat             -0.193087
         gm          -1.38899e-11
        gmb          -3.15928e-13
        gds            0.00127697

Thread 39 (2024-01-05):

difference between npn13g2 and npn23g2l

hmohajeri, 2024-01-05:
I'm reviewing page 20 of "SG13G2 Process Specification Rev. 1.1" and noticed that the tables for "npn13g2" and "npn13g2l" are very similar. Could anyone clarify the purpose of having "npn13g2l" listed separately? It seems like "npn13g2" might be able to replace it. Any insights on this would be appreciated.

Thanks!

KrzysztofHerman, 2024-01-08:
@hmohajeri The npn13g2l has two variable parameters: Nx - number of emitters and El - emitter length. The feature of the variable emitter length is characteristics only for this device, npn13g2 and npn13g2v have fixed emitter length.

Closed 2024-01-08.

Thread 41 (2024-02-04):

spef file resistor and capacitor value

hmohajeri, 2024-02-04:
After routing an example design the results from *.spef file list all the node capacitor as zeros and the resistor either 40-ohm or 20-ohm.

KrzysztofHerman, 2024-04-02:
@hmohajeri could you please share your testcase in order to reproduce the results?

sergeiandreyev, 2024-07-10:
Hi @hmohajeri, could you please provide the testcase data to better follow up on this?

hmohajeri, 2024-07-12:
Hi @sergeiandreyev this note was awhile back and don't have the test case any more. It was related to openRoad. I will send you a note if I get time to replicate it again.

Closed 2024-07-12.

Thread 42 (2024-02-06):

Major bug/problem in the a22oi_1 standard cell

sergeiandreyev, 2024-02-06:
**⚠️ IMPORTANT**
There is functional inconsistency between physical design/transistor-level schematic and Liberty/Verilog description of the a22oi_1 cell, if the cell is used in the design this will lead to a chip not functioning as expected. Other cells could be affected as well..
Thanks to ETH Zurich team that found this critical issue!

sergeiandreyev, 2024-02-06:
Added `dont_use` attributes to Liberty description of `a22oi_1` cell as a temporary workaround (https://github.com/IHP-GmbH/IHP-Open-PDK/commit/4fdc719503662cdd21793dcc3a1506a057c5d461)

Closed 2024-06-04.

Thread 43 (2024-02-07):

LF-noise npn13g2

dwarning, 2024-02-07:
I try to reproduce the LF noise results from document Low_Frequency_Noise_SG13G2.pdf, page 3 with latest ngspice and IHP-Open-PDK.

My setup (see attachment) is as follows: Using an 8 emitter stripe (NX=8) as DUT, biasing the base over bias T with DC (0.7...0.9V) and AC voltage sources, DC Vce=1V on collector, grep the power spectral density of ic with a H controlled source and divided by Beta²

The result has a large difference to the shown diagram on p.3

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

[vbic_noise_Vc_Vb.sp.txt](https://github.com/IHP-GmbH/IHP-Open-PDK/files/14194134/vbic_noise_Vc_Vb.sp.txt)

Is there a flaw in my method or did we have a problem with the model in ngspice? Can you describe your method in principle, please. Which simulator you have used for the documentation?

metroid120, 2024-02-08:
Hi dwarning,

I went through the relevant literature and compared it to your circuit. I recommend to have a look at :
- https://www.iee.et.tu-dresden.de/iee/eb/forsch/AK-Bipo/2000/AKB_2000_Berkner_1f_noise.pdf
- in the ICCAP modeling handbook, the chapter "Low Noise Measurements and Modeling"

After comparing the circuits given in these references to yours, I noticed that you did not connect V1 as a
"dummy", which is needed so that spice can simulate noise. V1 should, in my opinion, not be connected to
the transistor at all.

Attached are my circuit and results, what do you think? In my opinion, this looks decent.

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

[vbic_noise_Vc_Vb.sp.txt](https://github.com/IHP-GmbH/IHP-Open-PDK/files/14212383/vbic_noise_Vc_Vb.sp.txt)

dwarning, 2024-02-08:
@metroid120:
Yes, the reference voltage source can't connect to base. With this connection noise of the base resistor are not taken in account.
Thank you for this correction and the reference paper.
So the results are in line with the pdk document.

Closed 2024-02-08.

Thread 46 (2024-02-14):

VTH vs. W

claudiotalarico, 2024-02-14:
The change in VTH when sweeping W seems to be excessive (especially going from 5um to 10um).
Please see the attached plots (the device used for this analysis is the SG13 LV nmos)

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

The xschem's file and the matlab's file I used to generate the analysis are provided at this [link](https://github.com/claudiotalarico/EE406/tree/main/01_technology/01_vt_W/src)

bmurmann, 2024-03-20:
Below is a plot from the measured data:
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

It is expected that Vt is a strong function of W near the minimum allowed value (due to narrow width effects). The above data also shows this. But I would not expect is that Vt changes dramatically as the width changes from ~1-10um. The Vt value usually stabilizes for large W as shown here: https://www.semanticscholar.org/paper/Implications-of-Small-Geometry-Effects-on-%24g_m-I_D%24-Ou-Ferreira/7982fbeb3a43c594a244923438360aa5ebd1b478/figure/4

Looking at the measured data, I see identical Vt for W=0.6 and W=2um, which makes sense to me (but the current models do not reflect this). Perhaps the measured data (with potential outliers) was overfitted to generate a non-physical trend in the spice models?

dwarning, 2024-03-25:
I grubbed out few old ngspice scripts to extract Vth over W and L and rebuild them with the help of Holger.
To extract the threshold voltage a simple constant current criteria (W/L*1e-6) was used and follows in deviations compared with the IHP documented behaviour. But it confirms clear the discussed characteristic and that the models reflect the measured and documented values.
lv_nmos Vth over W with L as parameter 0.13...0.16um in linear range:
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

For completeness also lv_nmos Vth over L with W as parameter 2...8um in linear range:
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

KrzysztofHerman, 2024-03-26:
@dwarning could you please share your testcase? I would like to get the exact difference between model and the measurements.

dwarning, 2024-03-26:
No problem, but as said there are some margin in accuracy of the vth determination.

[Vth_W.txt](https://github.com/IHP-GmbH/IHP-Open-PDK/files/14755597/Vth_W.txt)
[Vth_L.txt](https://github.com/IHP-GmbH/IHP-Open-PDK/files/14755598/Vth_L.txt)

Good luck

KrzysztofHerman, 2024-07-15:
@claudiotalarico first of all we are sorry to let you wait such a long time for response. Reviewing your simulation you use W in a range up to 50u. Our models are valid up to 10u and to obtain W=50u one should use multi-finger approach. Could you please regenerate the graphics to be aligned with the one we have shared in this thread ? I mean semilogx axis for width and vertical grid of 50 mV.

hpretl, 2024-07-17:
Maybe this issue is related to https://github.com/IHP-GmbH/IHP-Open-PDK/issues/164? Could be if the number of fingers is also changed in the investigations above.

Thread 52 (2024-02-28):

Layout grid

bmurmann, 2024-02-28:
In SG13G2_os_layout_rules.pdf the layout grid is specified as 5 nm, while in sg13g2.lyt it is set to 1 nm. Is this an intentional scale factor or is there some other reason for this difference?

KrzysztofHerman, 2024-03-14:
@bmurmann thank you for the comment. After some other issues with XOR cross checking of our PyCells against cells generated using commercial tools we also discovered some inconsistencies in the behavior of the tools. We will probably bring back the value of 1nm.

sergeiandreyev, 2024-03-15:
the DBU and grid are different in their purpose and setting, both in commercial PDK and in KLayout, so we decided to rollback the changes (the dbu parameter in KLayout will be changed back to 1nm)
regarding the [manufacturing] grid, we still have to understand what is the best way to show/force the users to use 5nm grid when drawing layouts..
and of course, there are several offGrid checks that we have already as part of DRC rule deck - these should find violations and actually enforce the usage of correct grid setting

sergeiandreyev, 2024-06-20:
@bmurmann, in one of the latest KLayout updates the following feature was added:
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
So now our KLayout tech `.lyt` file includes technology-specific default grid settings w/ the min one *strongly* set to 5nm. -> https://github.com/IHP-GmbH/IHP-Open-PDK/commit/85b2f7a030c1f1d442a1b5ec124f7cdd57020c0c
This way the grid is set by default to 5nm when you're starting KLayout in clean environment (no `klayoutrc` file present). The user still can set the grid to incorrect value.
Could you please test and provide feedback on the resolution of this issue?

bmurmann, 2024-06-22:
This works. Thank you.

Closed 2024-06-22.

Thread 54 (2024-03-07):

KLayout: PMOS and NMOS have different GatPoly Layers

vkrahul77, 2024-03-07:
In the "IHP Pycells", For Gate The PMOS has "GatPloy.lbl" while NMOS has "Gatpoly.drw" as shown:
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

Also, I've noticed a discrepancy in dimension input between NMOS and PMOS transistors within the tool. Specifically, while "1u" notation is accepted for PMOS, it's not permitted for NMOS. Instead, we're required to use scientific notation such as "1e-6".

ihpopenpdk, 2024-03-07:
it seems to be an issue in both `nmos` and `pmos` cells - there should be no any '.lbl' or '.bnd' `GatPoly` layers, only '.drw' and '.pin'..
Thank you for finding!

vkrahul77, 2024-03-12:
Along with the posted bug, I noticed that there are a few DRC errors in NMOS-Cell.
Here is a list:
Min and Max size of contact should be 0.16  --> Cell has 0.14
Min Contact space should be 0.18 --> Cell has 0.16
Min Metal1 space or notch should be 0.18 --> Cell has 0.13
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

sergeiandreyev, 2024-05-18:
@vkrahul77 , I believe all these issues are fixed in the latest OpenPDK `dev` branch:
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

vkrahul77, 2024-07-10:
Sure! Please go ahead and close the ticket.
Sincerely,
Vikas

On Tue, Jul 9, 2024, 11:21 PM Sergei Andreev ***@***.***>
wrote:

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

Closed 2024-07-10.

Thread 64 (2024-04-04):

Glitch in capacitance evaluation

dwarning, 2024-04-04:
The attached ngspice script [cg_glitch.txt](https://github.com/IHP-GmbH/IHP-Open-PDK/files/14862148/cg_glitch.txt)  shows Cgb, Cg_ds and Cg_dsb capacitances over Vg of a 400/0.5 lv_nmos transistor.
The strong glitch around -0.9V is in my opinion fatal and follows in time step problems for transient simulation.

The observed behaviour is for psp103 version 6.0 and actual version 8.2 [va-models](https://github.com/dwarning/VA-Models/tree/main/code/psp103/vacode) and can also be seen for the hv-nmos device.

Would be fine to see same curves from same va-code with other simulators.

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

Additional open question is the y-axis scale of the documented curves in [report_nmos_lv](https://github.com/IHP-GmbH/IHP-Open-PDK/blob/main/ihp-sg13g2/libs.doc/meas/MOS/doc/report_nmos_lv.pdf) page 401. Are this 400 pF? Because e-12 is shown.

sergeiandreyev, 2024-04-10:
Hi @dwarning,
we still have to reproduce the testcase in Xyce, as well as run/recheck this for commercial (internal) PDK models
on your second question - yes, these are 400pF

dwarning, 2024-04-10:
I see no problem with adms/Xyce:

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

KrzysztofHerman, 2024-04-12:
Hello, @dwarning
could you please share the testcase for Xyce as well, there is an inconsistency with the values on Y-axis.
As for the plots of `Cgdsb` I attach simulation results where `ng` parameter is used

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

the orange curve corresponds to the device with `ng=1`
`X1 _net2  _net0  _net2  _net2 sg13_lv_nmos w=400u l=0.5u`
and the blue one corresponds to the device with `ng=40` what limits `W` to `10u`
`X1 _net2  _net0  _net2  _net2 sg13_lv_nmos w=400u l=0.5u ng=40`

dwarning, 2024-04-12:
OK, scripts attached. ( spend not the time to adapt Xyce library syntax )
[cg_glitch.plt.txt](https://github.com/IHP-GmbH/IHP-Open-PDK/files/14961403/cg_glitch.plt.txt)
[cg_glitch.cir.txt](https://github.com/IHP-GmbH/IHP-Open-PDK/files/14961404/cg_glitch.cir.txt)
[cg_glitch.sp.txt](https://github.com/IHP-GmbH/IHP-Open-PDK/files/14961405/cg_glitch.sp.txt)

Even I assume that original problem has nothing to do with geometry control I used your recommended size:
`X1 _net2  _net0  _net2  _net2 sg13_lv_nmos w=400u l=0.5u ng=40`

adms - Xyce:
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

openvaf - ngspice:
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

Because the glitch is at VFB I am sure there is a bug in the openvaf compilation. Not easy to find, but possible.

sergeiandreyev, 2024-04-15:
@metroid120, could you please take a look?..

metroid120, 2024-04-15:
What I can already say, is that the bug is related to NQS effects in "PSP103_ChargesNQS.include".
It could indeed be an OpenVAF bug, but I did not yet find the exact cause.

metroid120, 2024-04-15:
I agree that this is a serious bug. I was not able to track the issue down exactnly, but I found that
the issue is related to the PSP current calculation in "PSP103_SPCalculation.incldue"

```
// Core PSP current calculation
    Vdsat_lim    =  3.912023005 * phit1;
    if (xg <= 0.0) begin
        qis          =  0.0;
        xgm          =  xg - x_s;
        Voxm         =  xgm * phit1;
        qeff1        =  Voxm;
        Vdsat        =  Vdsat_lim;
        Vdse         =  Vds;
    end else begin // (xg > 0)
        ...
```
For the xg>0 branch, the variabel "Vxm" should be continued smoothly, but is not.
I do not know exactly how those model functions should work together, so it is difficult to find the root cause.
Maybe somebody else has more insight...

sergeiandreyev, 2024-04-18:
It's good that this will be tracked on OpenVAF repo, but still I propose to have this issue open here until the fix in OpenVAF will be made available.

metroid120, 2024-04-20:
Thanks to the bad weather I spend some time on this. **Folks, can you please confirm.**

If one replaces the following three code lines in the Verilog-A

```
            SP_S_delta0 = exp(SP_S_x0); \
            SP_S_delta1 = 1.0 / SP_S_delta0; \
```
(occurs 2 times in the code)

```
            delta_1s     =  exp(x_s); \
            Es           =  1.0 / delta_1s; \
```
with
```
            SP_S_delta0 = exp(SP_S_x0); \
            SP_S_delta1 = exp(-SP_S_x0); \
```
```
            delta_1s     =  exp(x_s); \
            Es           =  exp(-x_s); \
```
(so in total 3 occurrences), the problem is gone.

dwarning, 2024-04-20:
I can agree - this 3 modifications let the glitch disappear. Seems openvaf makes a kind of over-optimization.

metroid120, 2024-04-21:
Ok @sergeiandreyev , then I guess we have a fix/workaround. Replace the blocks of code as described above and the Glitch is gone.

I think OpenVAF generates the derivative of $y2$ in the following structure
$y1=exp(a)$
$y2=1/exp(a)$

as

$\frac{dy2}{dx}=-(exp(a))^{-2}\frac{da}{dx}$

which causes numerical problems in contrast to the mathematically equivalent

$\frac{dy2}{dx}=-exp(-a)\frac{da}{dx}$

but this is just my guess.

Anyhow I doubt that the fundamental OpenVAF issue will be fixed soon, since the project is not active.

sergeiandreyev, 2024-04-22:
@metroid120 , thank you for taking the time to thoroughly investigate this issue over the weekend and finding a solution!

dwarning, 2024-04-23:
A note that the modified PSP model from this distribution is to use would be preferable.

Closed 2024-04-23.

Thread 72 (2024-04-17):

ORFS do not insert decoupling cells

hpretl, 2024-04-17:
The OpenROAD flow scripts (ORFS) do not insert the `sg13g2_decap[4|8]` cells, only `sg13g2_fill[1|2|4|8]`. This should be changed in the default configuration.

hpretl, 2024-04-17:
And here is the proposed fix: In `config.mk` change

```
export FILL_CELLS = sg13g2_fill_1 sg13g2_fill_2 sg13g2_fill_4 sg13g2_fill_8
```

to
```
export FILL_CELLS = sg13g2_fill_1 sg13g2_fill_2 sg13g2_decap_4 sg13g2_decap_8
```

hpretl, 2024-04-17:
See https://github.com/The-OpenROAD-Project/OpenROAD-flow-scripts/pull/1945

Thread 80 (2024-04-24):

Unsupported expression for cell sg13g2_sdfbbp_1

dnltz, 2024-04-24:
I found the following warning in OpenROAD and it looks like the stdcell lib has a type included: https://github.com/IHP-GmbH/IHP-Open-PDK/blob/dceb7e6bd1a877182c3ba32c2e238be08368fa3f/ihp-sg13g2/libs.ref/sg13g2_stdcell/lib/sg13g2_stdcell_typ_1p50V_25C.lib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

`Warning: Found unsupported expression 'SCE*SCD+SCE'*D' in pin attribute of cell 'sg13g2_sdfbbp_1' - skipping.`

I can send a fix but can someone confirm this is a typo?

dnltz, 2024-04-24:
@KrzysztofHerman

KrzysztofHerman, 2024-04-25:
@dnltz thank you for reproducing this as well because we are aware of this warning. The person in charge has it in his pipeline but it you can provide the fix such as typo go ahead and do so so we can check it out using other tools as well.

dnltz, 2024-04-26:
See https://github.com/IHP-GmbH/IHP-Open-PDK/pull/83

sergeiandreyev, 2024-04-29:
Hi @dnltz , this is not a typo - this is an inversion, if you remove this symbol the function will not be correct. An option will be to change this symbol to `!`: `(SCE*SCD)+(!SCE*D)`
Could you please try to change the function:
```
ff (IQ,IQN) {
      clear : "!RESET_B";
      clear_preset_var1 : "H";
      clear_preset_var2 : "L";
      clocked_on : "CLK";
      next_state : "(SCE*SCD)+(!SCE*D)";
      preset : "!SET_B";
      }
 ```
 and give us your feedback whether it passes now.

dnltz, 2024-05-03:
@sergeiandreyev still the same warning. I wonder if this expression is allowed at all and should be replaced by boolean operations since it defines the next state of a flip-flop.

sergeiandreyev, 2024-05-05:
hm, ok.. the `*` and `+` boolean operators are valid/allowed if you use commercial tools, we don't see any issues internally.
then how about this one? `"(SCE&SCD)|(!SCE&D)"` -> changed `*` to `&` and `+` to `|`
could you please check if the above syntax will work on your side?
btw, this is how sky130 scan flops are described:
```
ff ("IQ","IQ_N") {
            clear : "!RESET_B";
            clear_preset_var1 : "H";
            clear_preset_var2 : "L";
            clocked_on : "!CLK_N";
            next_state : "(D&!SCE) | (SCD&SCE)";
            preset : "!SET_B";
        }
```

dnltz, 2024-05-06:
@sergeiandreyev this statement  is also illegal. I figured out only one pin is OK but as soon as you add another one it's bad.

sergeiandreyev, 2024-05-06:
Hm, then I don't get how the SkyWater sky130 scan flops are used in OpenROAD..
Does it support scan chains?

sergeiandreyev, 2024-05-06:
next_state w/ one pin is for regular flop
when you have a scan flop, scan signals should be defined in the parameter

noherbrferurtth, 2024-05-06:
So far there is no implementation of a scan chain with Open Source tools. To my knowledge.

Dr.-Ing. Norbert Herfurth
Scientist
Technology / High-Performance Si-Technologies
IHP

Fon: +49 (335) 5625-525
Fax: +49 (335) 5625-327
E-Mail: ***@***.******@***.***>
Website: www.ihp-microelectronics.com<https://www.ihp-microelectronics.com>

[cid:SocialLink_Facebook_32x32_f848f5b0-52e0-4dda-a869-9f2278b71813.png]<https://www.facebook.com/IHPFFO> [cid:SocialLink_Twitter_32x32_242a0cd4-6fff-468a-8361-f726eb7cd314.png] <https://twitter.com/waferffo>  [cid:SocialLink_Linkedin_32x32_33a16910-12a4-40c5-ba5d-13f0b7ac8b86.png] <https://www.linkedin.com/company/ihp>

IHP GmbH
Leibniz Institute for High Performance Microelectronics
Leibniz-Institut für innovative Mikroelektronik
Im Technologiepark 25
15236 Frankfurt (Oder)
Germany

Geschäftsführer: Prof. Dr.-Ing. Gerhard Kahmen, Nicolas Hübener, Vorsitzende des Aufsichtsrates: Dr. Inge Schlotzhauer
Handelsregister: HRB 1982 Amtsgericht Frankfurt (Oder) , Steuernummer: 061/125/00152, Umsatzsteuer-ID: DE 138996546

Die IHP GmbH ist Mitglied der Leibniz-Gemeinschaft und wird von der Bundesrepublik Deutschland und dem Land Brandenburg institutionell finanziert.

Diese E-Mail enthält vertrauliche und / oder rechtlich geschützte Informationen. Wenn Sie nicht der richtige Adressat sind oder diese E-Mail irrtümlich erhalten haben, informieren Sie bitte sofort den Absender und vernichten Sie diese Mail. Das unerlaubte Kopieren sowie die unbefugte Weitergabe dieser Mail sind nicht gestattet.

This e-mail contains confidential and / or privileged information. If you are not the intended recipient or have received this e-mail in error, please notify the sender immediately and destroy this e-mail. Any unauthorized copying, disclosure or distribution of the material in this e-mail is strictly forbidden.
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

mmlouerat, 2024-05-07:
Goodday,

I am writing to you on behalf of Pr Naohiko Shimizu (naohiko.shimizu@lip6.fr) who is currently for one year at Sorbonne Université-LIP6, within the Open Source EDA Coriolis Team.

Pr Shimizu used a scan path insertion tool available in the Alliance tool chain.
It is called "scapin", not so young today.

Alliance sources may be found:
https://github.com/lip6/alliance

here is the man page of scapin:

SCAPIN(1)                                     CAO-VLSI Reference Manual                                     SCAPIN(1)

NAME
       scapin - Scan path insertion

ORIGIN
       This  software belongs to the  ALLIANCE CAD SYSTEM developed by the ASIM team at LIP6 laboratory of Université
       Pierre et Marie CURIE, in Paris, France.

       Web : http://asim.lip6.fr/recherche/alliance/
       E-mail : [alliance-users@asim.lip6.fr](mailto:alliance-users@asim.lip6.fr)

SYNOPSIS
       scapin [-VRB] [-P file] Input_name Path_name Output_name

DESCRIPTION
       SCAPIN is an automatic scan path generator for gate level netlists.  SCAPIN inserts a scan path in the netlist
       Input_name  and drives a new netlist Output_name.  This scan path contains all registers specified in the file
       Path_name.path (see below for the exact syntax).  SCAPIN adds also 3 new connectors in the  netlist:  scan_in,
       scan_out  and scan_test in order to control the scan path.  Eventually SCAPIN adds an output buffer before the
       output connector scan_out (option -B).

mmlouerat, 2024-05-14:
Hi,
There are also newer test tools that will be presented at FSIC2024:
- https://github.com/AUCOHL/Fault for scan path insertion
- https://github.com/Coloquinte/quaigh ATPG, should you need it.

noherbrferurtth, 2024-05-14:
thanks a lot for the link! I was not aware. This is very helpful for the upcoming HSM we are planing.

sergeiandreyev, 2024-06-22:
> So far there is no implementation of a scan chain with Open Source tools. To my knowledge.

apart from the `scapin` tool that @mmlouerat mentioned there is an update after FSiC'24: https://github.com/AUCOHL/Fault

Thread 82 (2024-04-26):

nmos_code.py question

eskiyerli, 2024-04-26:
Can you explain to me what does this piece of pycell code is doing? As far as I see, it is just redrawing the same box (rectangle) at the same location as many times as there are gate fingers:

        for i in range(int(ng)) :
            # draw the poly line
            xpoly_beg = xcont_end+gatpoly_cont_dist
            ypoly_beg = ydiff_beg-gatpoly_Activ_over
            xpoly_end = xpoly_beg+l
            ypoly_end = ydiff_end+gatpoly_Activ_over
            dbCreateRect(self, poly_layer, Box(xpoly_beg, ypoly_beg+diffoffset, xpoly_end, ypoly_end+diffoffset))

I am trying to port this pycell code to Revolution EDA, and I am a bit perplexed.

sergeiandreyev, 2024-07-05:
Hi @eskiyerli,
 this `for` loop goes from lines 181 to 212, `xcont_end` and other variables that are used to define gate coordinates are getting recalculated inside.
You can check this by debug printing inside the loop.
Hope this will answer your question.

Closed 2024-07-11.

Thread 88 (2024-04-28):

dantenna & dpantenna netlisting

bmurmann, 2024-04-28:
The pin order of these diodes in spice netlists is alphabetical, and currently gives the pin order cathode, anode. This is incompatible with standard spice, where diodes are instantiated as anode, cathode.

This problem has trickled down into the LVS, which now expects the wrong cathode, anode order. The existing netlist for the IO cells uses the proper spice ordering and therefore does not pass LVS.

I strongly recommend going with the spice standard; anything else will be extremely confusing.

FaragElsayed2, 2024-05-02:
Done in #93

Cc @atorkmabrains

sergeiandreyev, 2024-05-17:
@bmurmann, could you please confirm that with the latest LVS update the issue is fixed?

bmurmann, 2024-05-17:
Confirmed, this is fixed.

Closed 2024-05-18.

Thread 91 (2024-04-30):

LVS vs. resistor positioning

KrzysztofHerman, 2024-04-30:
I found a weird behavior when doing a LVS test with resistors. The first case (left in the image) pass LVS with any problem when the last resistors is at the same level (red line), but if I move the last resistor just a little bit to the south (right in the image) then the LVS fails. Does anyone know why is this happening?

[Slack Message](https://open-source-silicon.slack.com/archives/C0549N94FD3/p1714483010992259)

FaragElsayed2, 2024-05-02:
Done in #93

Cc @KrzysztofHerman @atorkmabrains

KrzysztofHerman, 2024-05-02:
Confirmed and closed.

Closed 2024-05-02.

Thread 92 (2024-04-30):

Antenna diode definition in LEF

hpretl, 2024-04-30:
This is related to this reported issue in the ORFS: https://github.com/The-OpenROAD-Project/OpenROAD-flow-scripts/issues/1981#issuecomment-2085587523

In short, we need the definition of an antenna diode cell in the LEF, so that OpenROAD can use it to repair antenna fails.

hpretl, 2024-05-02:
This issue is now fixed by https://github.com/The-OpenROAD-Project/OpenROAD-flow-scripts/pull/1987. However, it still does not solve antenna errors, but this is due to a bug in OR identified here: https://github.com/The-OpenROAD-Project/OpenROAD-flow-scripts/issues/1981#issuecomment-2091259137

Thread 94 (2024-04-30):

Stdcell pin order

bmurmann, 2024-04-30:
sg13g2_stdcell.cdl has the wrong supply pin order for inv_4, inv_8 and inv_16. The order should be VDD, VSS.

************************************************************************
* Library Name: sg13g2_stdcell
* Cell Name:    sg13g2_inv_2
* View Name:    schematic
************************************************************************

.SUBCKT sg13g2_inv_2 A VDD VSS Y
*.PININFO A:I Y:O VDD:B VSS:B
MX1 Y A VSS VSS sg13_lv_nmos m=2 w=740.00n l=130.00n ng=1
MX0 Y A VDD VDD sg13_lv_pmos m=2 w=1.12u l=130.00n ng=1
.ENDS

************************************************************************
* Library Name: sg13g2_stdcell
* Cell Name:    sg13g2_inv_4
* View Name:    schematic
************************************************************************

.SUBCKT sg13g2_inv_4 A VSS VDD Y
*.PININFO A:I Y:O VDD:B VSS:B
MP0 Y A VDD VDD sg13_lv_pmos m=4 w=1.12u l=130.00n ng=1
MN0 Y A VSS VSS sg13_lv_nmos m=4 w=740.00n l=130.00n ng=1
.ENDS

************************************************************************
* Library Name: sg13g2_stdcell
* Cell Name:    sg13g2_inv_8
* View Name:    schematic
************************************************************************

.SUBCKT sg13g2_inv_8 A VSS VDD Y
*.PININFO A:I Y:O VDD:B VSS:B
MX1 Y A VSS VSS sg13_lv_nmos m=8 w=740.00n l=130.00n ng=1
MX0 Y A VDD VDD sg13_lv_pmos m=8 w=1.12u l=130.00n ng=1
.ENDS

sergeiandreyev, 2024-05-03:
Hello @bmurmann , this should be fixed now (https://github.com/IHP-GmbH/IHP-Open-PDK/commit/5f02042b601a174e58aefb474a3a5760ab3f7eb6)

sergeiandreyev, 2024-05-08:
@bmurmann, could you please confirm that it's fixed - then I'll close the issue

bmurmann, 2024-05-08:
Confirmed, it's fixed.

Closed 2024-05-09.

Thread 100 (2024-05-02):

RPPD extraction (alpha LVS)

bmurmann, 2024-05-02:
A series combination of RPPD (as shown below) matches the schematic only with option --no_simplify. But this option won't work for many other parts of a real circuit. Any remedies that can be implemented?

My test cases has 26 resistors in series in the layout and 26 resistors in series in the schematic. When any simplifications are turned on, there is no more match, since the derived simplifications between sch and lay differ.

This could be a general KLayout issue?

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

sergeiandreyev, 2024-05-17:
Hello @bmurmann, could you please confirm that with the latest LVS update the issue is fixed?

bmurmann, 2024-05-17:
Confirmed, this is fixed.

Closed 2024-05-18.

Thread 96 (2024-05-02):

Cap extraction (alpha LVS)

bmurmann, 2024-05-02:
It looks like mimcaps don't get recognized when there is a  poly resistor or transistor with the required heat layers underneath. I am am not sure I understand this long list of exclusions for a component high up in the stack. I think this is a bug (but it needs confirmation).

cap_exc = nsd_drw.join(heattrans_drw).join(trans_drw)
           .join(emwind_drw).join(emwihv_drw).join(heatres_drw)
            .join(salblock_drw).join(polyres_drw).join(extblock_drw)
            .join(res_drw).join(activ_mask).join(recog_diode)
            .join(recog_esd).join(ind_drw).join(ind_pin)
            .join(substrate_drw)

FaragElsayed2, 2024-05-02:
Hi Dr. @bmurmann

I have constructed the following truth table based on my knowledge and after discussion with @atorkmabrains.

@KrzysztofHerman Could you please confirm if we could use the `mimcap & inductor` on the top of other devices?
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

atorkmabrains, 2024-05-02:
Thanks Dr. @bmurmann for the feedback.

The recommendation that I followed in this behavior, is the avoidance of adding any device underneath MIM Caps to make sure that we don't create unintended behavior from the RF design, signal integrity, etc... perspective.

BTW, Inductors in this technology has `pwell_block` to push the self-resonance frequency higher for example. I understand such choice should be made on the design side rather than on the tool side.

Happy to adopt removing such limitations. But I believe we need IHP team confirmation.

@KrzysztofHerman Could you please confirm which behvior you need?

bmurmann, 2024-05-02:
As you say, I think these are really design decisions. I have put transistors underneath MIMcaps in many projects (and this is one of the nice features offered by MIMcaps for design destiny). If there is no reason from the technology/manufacturing side, the LVS should allow it.

atorkmabrains, 2024-05-02:
@KrzysztofHerman Could you please confirm from IHP side? Otherwise, we will take @bmurmann advise.

KrzysztofHerman, 2024-05-02:
@bmurmann and @atorkmabrains thank you for taking care about this details. In general I would agree with @bmurmann having similar experiences however I do not have any in RF so please let me consult our RF designers and PDK developers to have some more information.

atorkmabrains, 2024-05-02:
@KrzysztofHerman I think the question here: Is there any technological concern from IHP side about allowing designers to add devices under MIM?

atorkmabrains, 2024-05-02:
@KrzysztofHerman Could you please reopen and keep it until we update the LVS rule deck?

hpretl, 2024-05-02:
@KrzysztofHerman RF designer here :-): For MIMCAP full flexibility should be allowed, i.e. can be placed above anything. I often place it above MOSFET in switched-capacitor applications to minimize routing parasitics (just need to go straight down to switch).

sergeiandreyev, 2024-05-17:
@bmurmann, could you please confirm that with the latest LVS update the issue is fixed?

bmurmann, 2024-05-17:
Confirmed, this is fixed.

Closed 2024-05-18.

Thread 98 (2024-05-02):

Option GUI (alpha LVS)

bmurmann, 2024-05-02:
I am having some trouble getting the options from the GUI to be correctly reflected in the LVS run. I see that the yml file gets updated when I click an option, but when I click "load pdk options" the sync between the menu buttons and the yml is lost until all options are manually toggled into alignment again.

Furthermore, when I start KLayout, the yml file has schematic_simplify: true, but the GUI menu has Netlist simplify enabled (and not netlist simplify).

Why is there a "tile" run option for LVS?

Also, just a suggestion for the documentation of the options, I found this to be a useful explanation from the KLayout manual:
Netlist simplify is a wrapper for "make_top_level_pins", "purge", "combine_devices" and "purge_nets" in this recommended order.

sergeiandreyev, 2024-05-17:
@bmurmann, could you please confirm that with the latest LVS update the issue is fixed?

bmurmann, 2024-05-17:
Confirmed, this is fixed.

Closed 2024-05-18.

Thread 99 (2024-05-02):

Slit rules in process spec

hpretl, 2024-05-02:
Please add clarifying language whether the slitting rules `Slt.e` and `Slt.e1` in https://github.com/IHP-GmbH/IHP-Open-PDK/blob/main/ihp-sg13g2/libs.doc/doc/SG13G2_os_layout_rules.pdf are true for all metals, or just `TopMetal2`.

In addition, maybe the layer names should be mentioned which create these exceptions.

stefansimon42, 2024-05-06:
Thanks @hpretl for the question.

You are absolutely right. A more precise description of the affected levels can be very helpful.

Slt.e affects all metals that are connected to the pad. However, I'm not entirely sure whether this can be easily implemented with the standard DRC tools. This needs to be evaluated separately.

Slt.e1 here only affects the metals that a MIM capacitor is actually composed of, i.e. Metal5 and TopMetal1.

hpretl, 2024-05-06:
@stefansimon42 Do you mean "Slt.e affects all metals covered by `pad`"? If so, then this could be checked by `AND`ing the respective layers. Or is it really all metals connected to pad, but this would then progress far into the chip.

stefansimon42, 2024-05-07:
`AND`ing the pad layer and all metal layers may select too many polygons.

For example, a pad can extend from layer Metal3 to TopMetal2. These layers should not be slotted. However, if a ground plane runs underneath in Metal1, this must be slotted. It is thus important to also check the connectivity between Pad-TopMetal2 and the underlying metal layers and then define which layers are to be slotted.

hpretl, 2024-05-07:
@stefansimon42 Thanks, yes, this totally makes sense. So the rule is (formulated a bit clumsy) `[(pad AND TM2) connected layers] AND pad]`.

KrzysztofHerman, 2024-12-18:
@stefansimon42 will we provide some updates in our documentation regarding this issue?

stefansimon42, 2024-12-19:
We are planning a complete revision of the general pad rules in 2025, which will take into account the issues discussed above.

Thread 101 (2024-05-03):

sg13g2_IOPadVdd

bmurmann, 2024-05-03:
I have managed to get many of the IOPads in the dev branch through the KLayout LVS, but it seems that the IOPadVdd cell has some issues such as some dangling drain/source nodes and missing devices (relative to .spi description). Can someone confirm whether this cell is the latest version and passes LVS on your side (commercial or open source)?

* This is the circuit description. I don't see the DCN & DCP devices in the layout.
* sg13g2_IOPadVdd
.subckt sg13g2_IOPadVdd vss vdd iovss iovdd
Xnclamp iovss iovdd vdd ngate sg13g2_Clamp_N43N43D4R
Xrcres vdd res_cap sg13g2_RCClampResistor
Xrcinv vdd iovss res_cap ngate sg13g2_RCClampInverter
Xdcndiode iovss vdd iovdd sg13g2_DCNDiode
Xdcpdiode vdd iovdd iovss sg13g2_DCPDiode
.ends sg13g2_IOPadVdd

stafverhaegen-chipflow, 2024-05-03:
I can confirm that the netlist is wrong. The DCN & DCP should not be in the netlist. Does it match if you remove them ?

The KLayout LVS was not available during the design if the IO cells. So un-conventional verification was done. It was semi-manual and actually checked that the extracted netlist with Calibre delivered the right functionality. As the diodes don't impact functionality this discrepancy was not seen.

The IOPadVdd cell is the cell was the latest in dev before previous tape-out. Will do some more checking next week and then submit a patch.

stafverhaegen-chipflow, 2024-05-03:
> I have managed to get many of the IOPads in the dev branch through the KLayout LVS

Actually that is good to know. I thought that the handling of the ptaps in the Calibre deck would be not so easy to port to KLayout.

bmurmann, 2024-05-03:
Thank you for confirming. Below is a summary of what I had to do pass LVS for this cell:

Change cdl as follows:
```
.subckt sg13g2_IOPadVdd vss vdd iovss iovdd
Xnclamp iovss iovdd vdd ngate sg13g2_Clamp_N43N43D4R
Xrcres vdd res_cap sg13g2_RCClampResistor
*** Inverter is connected to iovdd in layout (does not seem to be correct)
*Xrcinv vdd iovss res_cap ngate sg13g2_RCClampInverter
Xrcinv iovdd iovss res_cap ngate sg13g2_RCClampInverter
*** These are not in the layout
*Xdcndiode iovss vdd iovdd sg13g2_DCNDiode
*Xdcpdiode vdd iovdd iovss sg13g2_DCPDiode
.ends sg13g2_IOPadVdd
```
Add missing M2 connections to the pad in the layout (showing just skinny paths for illustration):
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

bmurmann, 2024-05-03:
Here are also some notes on what I had to do to pass the KLayout LVS for other IO Cells (work in progress):
https://github.com/bmurmann/EE628/blob/a659c76b3c41ed46662405ceca7dbc085c4eda4c/5_Design/4_Layout/sg13g2_io_bm_hacks.md

stafverhaegen-chipflow, 2024-05-06:
> *** Inverter is connected to iovdd in layout (does not seem to be correct)
> *Xrcinv vdd iovss res_cap ngate sg13g2_RCClampInverter
> Xrcinv iovdd iovss res_cap ngate sg13g2_RCClampInverter

Mmm, this is no good. Seems I did not use right net list when verifying this circuit.
This means that both the NMOS and the PMOS of this inverter will be turned on, resulting in a DC current from IOVDD to IOVSS.
Kind of lucky that the supposed connection to VDD on the clamp was accidentally left floating. Otherwise this bodged inverter could have caused much more havoc as the drive strength of this clamp is much higher than the inverters one.

I should be able to fix the cell quite quickly; I hope to do that today.

stafverhaegen-chipflow, 2024-05-06:
* [sg13g2_io.gds.gz](https://github.com/IHP-GmbH/IHP-Open-PDK/files/15219786/sg13g2_io.gds.gz)
* [sg13g2_io.spi.gz](https://github.com/IHP-GmbH/IHP-Open-PDK/files/15219828/sg13g2_io.spi.gz)

These files should fix the problems for `IOPadVdd`; you'll need to apply the same magic with your added layers as for the other cells though. Fixing the latter will need a little more discussion.
Also I seem to have messed up DRC check overhere so I need to handle that first before doing an MR to the `IHP-Open-PDK` dev branch with the fixed gds.

bmurmann, 2024-05-07:
Thank you, Staf. This fix worked fine.

stafverhaegen-chipflow, 2024-05-13:
@bmurmann
Only see your updated comment now as one does not get notification if a comment is changed.
I did #109 but that is very similar to the gds I uploaded here just the vdd connection is segmented.
My check with Calibre does seem to indicate bulk is vdd for the transistor but I will do a cross-check again.
How can this problem only be seen when integrating with the other pads ?

bmurmann, 2024-05-13:
@stafverhaegen-chipflow The integration with other cells connects all the IOVDDs together and gives that net an LVS port label in my setup. That made the cell fail LVS since the netlist has the bulk at VDD. Not exactly sure why it passed standalone, but this was also with the alpha lvs and perhaps I overlooked something. Best to ignore this as the desired connectivity is clear. I had to add a new wire in the cell to drag VDD to that bulk location; it was not natively present near that well, if I remember correctly.

bmurmann, 2024-05-13:
Here's what I did to make the VDD connection to the well, note the skinny vertical M2 going up to the VDD rail on M3. I guess I could have come down from Topmetal2 as well.

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

stafverhaegen-chipflow, 2024-05-14:
There should already be a connection on metal2 there. This is latest layout from #109 with the connection segmented:
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

stafverhaegen-chipflow, 2024-05-14:
And in the file uploaded here it was not segmented and gave DRC error:
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

bmurmann, 2024-05-14:
OK. We may want to close this thread since what I wrote is about the first modified version before you did the latest updates. Best to have this verified by others, since I have not looked at the latest.

FatsieFS, 2024-05-14:
Thank you very much anyway. I would be aware of the problem without the hard work you put into this.

KrzysztofHerman, 2024-05-21:
Closing the issue. Great work!

Closed 2024-05-21.

Thread 115 (2024-05-17):

Overlapping vias in IO cell

dnltz, 2024-05-17:
See https://github.com/The-OpenROAD-Project/OpenROAD-flow-scripts/issues/1677

This issue is still present in the most recent and had to be fixed manually for the second time.

dnltz, 2024-05-17:
@stafverhaegen-chipflow I opend an issue because this is still not fixed. If this only requires to change the cell in klayout, I could also do it. I would need some help/assistance.

Fatsie, 2024-05-17:
I was not aware as I thought previous tape-out could go without needing further fix.
This needs fix in LEF. I'll see how to do it in the coming days.

dnltz, 2024-05-20:
@Fatsie sorry, we have another bug in my current design but it's unrelated to this and IO cells in general.

Closed 2024-05-20.

Thread 126 (2024-05-28):

Mention OpenROAD & in support tools

maliberty, 2024-05-28:
Please add OpenROAD and OpenROAD-flow-scripts to your "Supported EDA Tools" section.

KrzysztofHerman, 2024-05-29:
@maliberty thank you for pointing this out. Respective PR is awaiting approval.

maliberty, 2024-07-05:
This does not seem to be fixed as I don't see it listed

sergeiandreyev, 2024-07-05:
Hi @maliberty,
 actually it's changed in the `dev` branch:
 https://github.com/IHP-GmbH/IHP-Open-PDK/tree/dev
But indeed we need to update the `main` one

maliberty, 2024-07-05:
Ok, can you make the change or reopen this issue?  main is what people see by default.

Closed 2024-05-29.

Thread 148 (2024-06-24):

Which Open Source Simulation Tool to Use?

MaxenceBouvier, 2024-06-24:
Hi,

I am trying to simulate a post-synthesis design using either [Verilator](https://www.veripool.org/verilator/) or [icarus verilog (iVerilog)](https://github.com/steveicarus/iverilog) tools.

The design has been synthesized with YOSYS simulator and in the end instantiates some sg13g2_dfrbp_1 cells.

Unfortunately, the behavioral model of these cells rely on:
 - [User Defined Primitives (UDP) description.](https://github.com/IHP-GmbH/IHP-Open-PDK/blob/5a42d03194e8c98558f4e34538338a60550f89b9/ihp-sg13g2/libs.ref/sg13g2_stdcell/verilog/sg13g2_stdcell.v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)
 - [Standard Delay Format (SDF) timing definitions.](https://github.com/IHP-GmbH/IHP-Open-PDK/blob/5a42d03194e8c98558f4e34538338a60550f89b9/ihp-sg13g2/libs.ref/sg13g2_stdcell/verilog/sg13g2_stdcell.v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)

 So, I do not succeed running a simulation for the following reasons:
 -  is not supported by Icarus Verilog. ([here](https://github.com/steveicarus/iverilog/issues/943))
 - Verilator cannot read UDP Verilog description. ([here](https://github.com/verilator/verilator/issues/468))

What do you recommend as a solution, apart from redefining the behavior of sg13g2_dfrbp_1 as simple D Flip Flops?

Thanks for your help.

KrzysztofHerman, 2024-06-24:
Hi @MaxenceBouvier thank you for commenting on that. Please take a look at the  [OpenROAD-flow-scripts](https://github.com/The-OpenROAD-Project/OpenROAD-flow-scripts) and our platform, namely  `ihp-sg13g2`, available there. In short the technology mapping is done by Yosys using cell definition included in `*.lib` file.

mole99, 2024-06-24:
I would like to add that SDF is partially supported by Icarus Verilog. I did some tests here with Sky130A: https://github.com/mole99/interconnect-tests
Unfortunately, no timing checks are implemented yet.

Simulating at gate level without timing information should be no problem with Icarus Verilog. I just read the file `sg13g2_stdcell.v` without errors, there are of course warnings indicating the missing timing checks.

Make sure you are using a current version of Icarus Verilog.

Blebowski, 2024-06-26:
Hi,

there is a VHDL simulator where the author started to integrate Verilog support. I have started to work on
SDF annotation last summer, but the work is stalled for now.
https://github.com/nickg/nvc/pull/757

It is not where you need it yet, but it is slowly moving there.

MaxenceBouvier, 2024-06-26:
Thank you all for yours answers!

> Hi @MaxenceBouvier thank you for commenting on that. Please take a look at the [OpenROAD-flow-scripts](https://github.com/The-OpenROAD-Project/OpenROAD-flow-scripts) and our platform, namely `ihp-sg13g2`, available there. In short the technology mapping is done by Yosys using cell definition included in `*.lib` file.

Thanks @KrzysztofHerman, indeed, I am able to synthesize and techmap, my design with the YOSYS synthesizer, however I do not succeed simulating the post-synthesis design.

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

With Icarus Verilog, the `sg13g2_stdcell.v` file can indeed be read, however the internal register behavior (for instance of `sg13g2_dfrbp_1`) is not correctly interpreted as it relies on the `delayed_CLK` and `delayed_D` signals.
These signals are generated from a timing checks ($setuphold) and are thus not driven by the simulator.
```log
[...]/ihp130/pdk/ihp-sg13g2/libs.ref/sg13g2_stdcell/verilog/sg13g2_stdcell.v:459: warning: Timing checks are not supported and delayed signal "delayed_CLK" will not be driven.
```
Content of `sg13g2_stdcell:l459`:
```verilog
$setuphold (posedge CLK, posedge D, 0, 0, notifier,,, delayed_CLK, delayed_D);
```
As a result, the signal are constantly set to `x` and post-synthesis simulation are not possible.
@mole99 do you know if there is a way to tell Icarus Verilog to ignore the timing checks and drive the output signal as original the source?
If not, it would be nice to have an alternative "pure" RTL description (no timing) of the IHP130 standard for quick functional verification of synthesized netlist.

Blebowski, 2024-06-26:
@MaxenceBouvier would it be OK to add `ifdef FUNCTIONAL` to conditionally compile without timing checks ?

```
module sg13g2_a21oi_1 (Y, A1, A2, B1);
	output Y;
	input A1, A2, B1;

	// Function
	wire int_fwire_0, int_fwire_1;

	and (int_fwire_0, A1, A2);
	or (int_fwire_1, int_fwire_0, B1);
	not (Y, int_fwire_1);

`ifdef FUNCTIONAL
	// Timing
	specify
		(A1 => Y) = 0;
		(A2 => Y) = 0;
		if (A1 == 1'b1 & A2 == 1'b0)
			(B1 => Y) = 0;
		if (A1 == 1'b0 & A2 == 1'b1)
			(B1 => Y) = 0;
		if (A1 == 1'b0 & A2 == 1'b0)
			(B1 => Y) = 0;
		ifnone (B1 => Y) = 0;
	endspecify
`endif
endmodule
`endcelldefine
```

mole99, 2024-06-26:
@MaxenceBouvier You must be using an older version of Icarus Verilog, in the latest version these signals are driven (but not delayed), which should be enough for a GL simulation :)
Can you send me your version string?

MaxenceBouvier, 2024-07-02:
> @MaxenceBouvier You must be using an older version of Icarus Verilog, in the latest version these signals are driven (but not delayed), which should be enough for a GL simulation :) Can you send me your version string?

Indeed, I am checking out version 12.0 (from dec. 2022) before building from source.
I'll point to latest passing commit and try again.
Thanks for letting me know that it should now be working!

mole99, 2024-07-03:
You are welcome @MaxenceBouvier! If there are any problems, let me know.

I agree with you, @Blebowski, that an `ifdef` around the specify blocks could be useful. But you would need to connect the delayed signals in the Flip-Flops.

LucaMartis00, 2024-10-07:
@MaxenceBouvier I have the same problem as you. I want to simulate a post-synthesis netlist, but Icarus Verilog (Iverilog) gives me this warning:
`Timing checks are not supported' and 'delayed signal. "delayed_CLK" will not be driven`
Did you manage to solve it? How did you solve it?

mole99, 2024-10-07:
@LucaMartis00 You need to update Icarus Verilog. (Possibly build from source.)

LucaMartis00, 2024-10-07:
@mole99 I'm using version 13
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

Thread 149 (2024-06-25):

Statistical modeling with parameter mc_ok

miesli, 2024-06-25:
## Expected Behavior

Turning on and off statistical modeling by choosing different corners

## Actual Behavior

Turning on and off statistical modeling by choosing different corners PLUS option to change the sigma of the Gaussian function using mc_ok.

## Fix

There are multiple options depending on the wanted behavior. The most obvious is:

Replace all mc_ok appearances with 1.0 in the ngspice/models/cornerXXX.lib files

### Thanks

I report this here after someone else reported this to me.

dwarning, 2024-06-25:
No, this is partly a misunderstanding:
In a former version of the PDK lib with different library concept mc_ok was used to switch on/off statistical simulation with Monte Carlo.
Actual the selection followed by mos_tt_stat library parameter. Everything works well as we can see in attached picture:
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
The problem is that the name mc_ok is not correct anymore. He has now the meaning of Sigma.
The simulation is made with Sigma=6.

simi1505, 2025-01-30:
@dwarning Can you share your testbench or at least how you invoke this corner with Sigma=6?

`.lib cornerMOSlv.lib mos_tt_stat ...?`

I want to try the Monte Carlo simulation in combination with CACE.

What is a suitable value for Sigma = mc_ok? Where do you get 6 from?

Thanks!

dwarning, 2025-01-30:
Please at first read the ngspice manual (or hspice/spectre) about the meaning of the gauss() and agauss() function parameters.
Assuming the standard deviation values in IHP statistical libraries (I am not sure about this!) are standing for 3 Sigma. Then you get 3 Sigma deviations with mc_ok = 1. Widening the spread to 6 Sigma needs setting mc_ok to 0.5.
A reworked corner/mismatch library concept is pending: https://github.com/IHP-GmbH/IHP-Open-PDK/pull/333
Would be interesting to see spec compliance of a practical circuit with this high deviations.

sergeiandreyev, 2025-01-30:
> Assuming the standard deviation values in IHP statistical libraries (I am not sure about this!) are standing for 3 Sigma.

Yes, these are 3-Sigma

simi1505, 2025-01-30:
Thanks for the fast support!

However, there is something I do not understand. I thought mc_ok equals sigma?

The Ngspice manual defines gauss() as follows:

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

`define gauss(nom, rvar, sig) (nom + (nom*rvar)/sig * sgauss(0))`

And in the sg13g2_moslv_stat.lib file it is called with `.param sg13g2_lv_nmos_vfbo_mm  ='gauss(sg13g2_lv_nmos_vfbo_mm_norm , 0.004, mc_ok)'`.

If I now define `.param mc_ok = 3`, I should get `sigma = 3`, right? I do not understand, where you get mc_ok = 1 --> sigma = 3 and mc_ok = 0.5 --> sigma = 6?

hpretl, 2025-02-06:
@dwarning Thanks to the thread above, I finally understand how the `mc_ok` parameter works. One observation, though: Setting `.param mc_ok=0` should lead to divide-by-zero or a crash of ngspice, right? In practice, it seem to turn off the Monte-Carlo variation, at least this is my guess.

Question: Is this what is happening in the ngspice code?

dwarning, 2025-02-06:
@hpretl
You are correct, if mc_ok = 0 turns off variation and returns nominal value.

Excerpt from inp.c:

`static double
agauss(double nominal_val, double abs_variation, double sigma)
{
    double stdvar;
    if (abs_variation <= 0 || sigma <= 0)
        return nominal_val;
    stdvar = abs_variation / sigma;
    return (nominal_val + stdvar * gauss1());
}

`

hpretl, 2025-02-06:
@dwarning Excellent, so `mc_ok` is indeed a nice MC switch :-)

MC on: `mc_ok=1`
MC off: `mc_ok=0`

Thread 153 (2024-06-28):

qucs-s simulation with xyce

FhatuL, 2024-06-28:
Hi,

I wanted to ask, regarding the qucs-s HBT models, is it possible to run the simulations using xyce instead of ngspice? Every time I try to use the xyce simulator i get this error -> Netlist error: Number of nodes for subcircuit instance XNPN13G2L1 does not
 agree with number of nodes in subcircuit
 IHP_PDK_NONLINEAR_COMPONENTS_NPN13G2L

FhatuL, 2024-07-01:
Hi @KrzysztofHerman , please let me know if i missed something:

- Qucs Version: 24.2.1
- OS/Platform: Ubuntu 24.04

## Expected Behavior
While using the HBT models, I am expecting the simulation to run without errors when using xyce

## Actual Behavior
While trying to run a simulation with xyce, netlist errors occur.
image of error:
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

## Steps to Reproduce the Problem

1. Create a schematic and use one of the HBT models, in this case I used the npn13G2l model.
2. Add an include script for the HBT models, in my case, I just copied the include syntax provided in one of the example schematics for qucs-s in the repository.
3. Make sure xyce is selected as the simulator
4. Insert a simulation type in the schematic, for my case I was using the S parameter simulation
5. Try to run the simulation
Image of my schematic:
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

KrzysztofHerman, 2024-07-01:
@FhatuL does it run when you use ngspice ?
Anyway QUCS-S only generate the netlist and then calls the simulator.

FhatuL, 2024-07-01:
@KrzysztofHerman It runs when I use ngspice yes.

KrzysztofHerman, 2024-07-01:
Could you please provide the netlist an message log. You can generate it pressing F5 and F6

FhatuL, 2024-07-01:
find attached
[netlist1.txt](https://github.com/user-attachments/files/16051219/netlist1.txt)
[log1.txt](https://github.com/user-attachments/files/16051218/log1.txt)

sergeiandreyev, 2024-07-01:
based on the log it seems that all the `.parameters` commands in `cornerHBT.lib` file are not supported in Xyce, so the parameters are not set and simulation of course could not run
we need to change the syntax of the models in a way to be supported by Xyce (like we did for diodes and resistors models)

sergeiandreyev, 2024-07-01:
ok, after the change `.parameters` to `.param` (Xyce syntax) I'm still getting the 'incorrect number of nodes' error

sergeiandreyev, 2024-07-01:
ok, found it
`.SUBCKT IHP_PDK_nonlinear_components_npn13G2l  gnd c b e bn t Nx=1 El=1 `
here `gnd` is the extra pin

sergeiandreyev, 2024-07-01:
or the other way around, you should add additional pin to the line 10:
`Xnpn13G2l1 0  _net0 _net1 0 gnd IHP_PDK_nonlinear_components_npn13G2l Nx=1 El=1`

sergeiandreyev, 2024-07-01:
so now I'm stuck with this error:
`Model is required for device QNPN13G2L and no valid model card found.`
I'm using Xyce v7.6

FhatuL, 2024-07-02:
> ok, found it `.SUBCKT IHP_PDK_nonlinear_components_npn13G2l gnd c b e bn t Nx=1 El=1 ` here `gnd` is the extra pin

is it the circuit symbol that causes this extra pin to appear? How could i remove it since the netlist is auto-generated in my case.

KrzysztofHerman, 2024-07-02:
in the line 259 of [this](https://github.com/IHP-GmbH/IHP-Open-PDK/blob/main/ihp-sg13g2/libs.tech/qucs/user_lib/IHP_PDK_nonlinear_components.lib) file you have this definition: `.SUBCKT IHP_PDK_nonlinear_components_npn13G2l  gnd c b e bn t Nx=1 El=1 `. You could try to remove `gnd`, which seems to be optional,  and let us know how it goes.

sergeiandreyev, 2024-07-02:
> is it the circuit symbol that causes this extra pin to appear? How could i remove it since the netlist is auto-generated in my case.

I think it comes from this file -> [link](https://github.com/IHP-GmbH/IHP-Open-PDK/blob/dev/ihp-sg13g2/libs.tech/qucs/user_lib/IHP_PDK_nonlinear_components.lib)
lines 259-261

sergeiandreyev, 2024-07-03:
thank you, @dwarning !
now at least Xyce is running on my side (standalone)

dwarning, 2024-07-03:
The problem with the nested loop arises after a copy from ngspice schematic. Removing the both parameter sweeps, save and re-insert again solved the problem.

FhatuL, 2024-07-03:
> Just a copy of the 3 hbt files into the xyce model folder with these changes is sufficient. But the netlister seems not to fit xyce requirements for this nested loop: ![Bildschirmfoto vom 2024-07-03 14-34-50](https://private-user-images.githubusercontent.com/18441932/345423163-a141e576-2135-4848-92cc-dd77c65bd70a.png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)

Thank you, doing what you said got it to work. I wanted to ask here, for the symbol in this schematic, how did you do the model = npn13G2 nx=8 etc.

FhatuL, 2024-07-03:
Also, removing the extra gnd port on line 259 in the IHP_PDK_nonlinear_components.lib, although it does allow the simulation to run, it gives totally different simulation results compared to when it is there with ngspice. For xyce I just added an extra .PortSym and that seems to have gotten rid of the Number of nodes for subcircuit instance XNPN13G2L2 does not
 agree with number of nodes in subcircuit error.

sergeiandreyev, 2024-07-04:
@FhatuL, great! Could you please attach the final updated netlist here for reference?

FhatuL, 2024-07-04:
> @FhatuL, great! Could you please attach the final updated netlist here for reference? On PDK side, we will provide model files with required changes in `libs.tech/xyce/models` folder

* Qucs 24.2.1  /home/fhatu/test2.sch

.SUBCKT IHP_PDK_nonlinear_components_npn13G2l  gnd c b e bn t Nx=1 El=1
.INCLUDE   ../../.qucs/IHP-Open-PDK-main/ihp-sg13g2/libs.tech/xyce/models/sg13g2_hbt_mod.lib
X1 c b e bn t  npn13G2l Nx={Nx} El={El}
.ENDS

.LIB ../../.qucs/IHP-Open-PDK-main/ihp-sg13g2/libs.tech/xyce/models/cornerHBT.lib hbt_typ

Xnpn13G2l1 0  _net0 _net1 0 gnd 0 IHP_PDK_nonlinear_components_npn13G2l Nx=1 El=1
C1 _net2 _net1  1N
C2 _net0 _net3  1N
L1 _net0 _net4  1M
L2 _net5 _net1  1M
I1 0 _net5 DC 2U
P1 _net2 0 port=1  z0=50  AC 0.316228  SIN 0 0.316228 1MEG
P2 _net3 0 port=2  z0=50  AC 0.316228  SIN 0 0.316228 1MEG

V1 _net4 0 DC 1
.AC LIN 201 10G 30G
.LIN format=touchstone sparcalc=1
.PRINT ac format=std file=spice4qucs_sparam.prn sdb(1,1) s(1,1) sp(1,1) y(1,1) z(1,1) sdb(1,2) s(1,2) sp(1,2) y(1,2) z(1,2) sdb(2,1) s(2,1) sp(2,1) y(2,1) z(2,1) sdb(2,2) s(2,2) sp(2,2) y(2,2) z(2,2)
.END

sergeiandreyev, 2024-07-31:
Hi @FhatuL, we pushed the HBT models for Xyce to the `dev` branch: https://github.com/IHP-GmbH/IHP-Open-PDK/commit/d2c5295c38314a709f2376c70ccd9328f2d99dbf
So we have only the Qucs-S netlisting issue left

Ikram-rs22, 2024-10-19:
@sergeiandreyev I did everything that was mentioned above and I still get this error that no. of nodes don't match. I'm running the dc hbt example that was provided but it runs fine in ngspice after removing gnd pin from npn13G2 in the IHP_nonlinear_component library. But I still get error in xyce simulation. I've downloaded the xyce models, but still it shows the following error in simulation:
Xyce started...

*****
***** Welcome to the Xyce(TM) Parallel Electronic Simulator
*****
***** This is version Xyce Release 7.6-opensource
***** Date: Sat Oct 19 04:02:13 EDT 2024

***** Executing netlist /home/rf/.cache/qucs-s/spice4qucs.dc.cir

***** Reading and parsing netlist...
Netlist error: Number of nodes for subcircuit instance XNPN13G2 does not agree
 with number of nodes in subcircuit IHP_PDK_NONLINEAR_COMPONENTS_NPN13G2
Simulation aborted due to error.  There are 0 MSG_FATAL errors and 1 MSG_ERROR
 errors
*** Xyce Abort ***
Simulation aborted due to error.  There are 0 MSG_FATAL errors and 1 MSG_ERROR
 errors

*** Xyce Abort ***
--------------------------------------------------------------------------
MPI_ABORT was invoked on rank 0 in communicator MPI_COMM_WORLD
with errorcode 1.

NOTE: invoking MPI_ABORT causes Open MPI to kill all MPI processes.
You may or may not see output from other processes, depending on
exactly when Open MPI kills them.
--------------------------------------------------------------------------
Simulation finished

I'm providing the qucs-s netlist in .cache folder:
* Qucs 24.3.0  /home/rf/IHP-Open-PDK/ihp-sg13g2/libs.tech/qucs/examples/dc_hbt_13g2.sch

.SUBCKT IHP_PDK_nonlinear_components_npn13G2 gnd c b e bn t Nx=1
.INCLUDE   ../../.qucs/IHP-Open-PDK-main/ihp-sg13g2/libs.tech/ngspice/models/sg13g2_hbt_mod.lib
X1 c b e bn t  npn13G2 Nx={Nx}
.ENDS

.LIB /home/rf/IHP-Open-PDK/ihp-sg13g2/libs.tech/xyce/models/cornerHBT.lib hbt_typ
VPr1 _net0 _net1 DC 0
V2 _net0 0 DC 1
I1 0 _net2 DC 0
Xnpn13G2 0  _net1 _net2 0 gnd IHP_PDK_nonlinear_components_npn13G2 Nx=1

.dc v2 0 1.5 0.005
.step i1 0 5e-06 5.55556e-07
.PRINT  dc format=raw file=spice4qucs.dc._swp.plot I(VPr1)
.END

Please help me. I'm stuck in this problem for almost a month

FhatuL, 2024-10-21:
@Ikram-rs22 hi, what worked for me was to  edit the IHP_PDK_nonlinear_components.lib file, I think this defines the symbols qucs uses. just edit the component you want to use, for example, npn13G2l, first you're going to edit the .INCLUDE to point to the xyce model .lib file, then you're going to add an extra portsym, this <.PortSym 10 0 5 180> works for me and I can simulate with xyce. The downside however is that if you want to use ngspice, you have to redo these edits. hope this helps.

sergeiandreyev, 2024-10-21:
@KrzysztofHerman, could you please take a look?

sergeiandreyev, 2024-10-21:
@Ikram-rs22, could you please double check if you're using the latest PDK `dev` data?
what seems to be inconsistent are the following lines in your netlist:
```
.SUBCKT IHP_PDK_nonlinear_components_npn13G2 gnd c b e bn t Nx=1
.INCLUDE ../../.qucs/IHP-Open-PDK-main/ihp-sg13g2/libs.tech/ngspice/models/sg13g2_hbt_mod.lib
X1 c b e bn t npn13G2 Nx={Nx}
.ENDS
```
This is what we have in `IHP_PDK_nonlinear_components.lib` ([link](https://github.com/IHP-GmbH/IHP-Open-PDK/blob/dev/ihp-sg13g2/libs.tech/qucs/user_lib/IHP_PDK_nonlinear_components.lib)):
```
  <Spice>*
.SUBCKT IHP_PDK_nonlinear_components_npn13G2  gnd c b e bn Nx=1
X1 c b e bn npn13G2 Nx={Nx}
.ENDS
  </Spice>
```

KrzysztofHerman, 2024-12-18:
@FhatuL @Ikram-rs22 does the latest version of our PDK solves the issues you have, please report ?

Ikram-rs22, 2024-12-18:
No, when using the dev branch both ngspice and xyce are not able to simulate. Therefore, I'm using the main branch where only ngspice works

KrzysztofHerman, 2024-12-18:
@Ikram-rs22 could you please share your test case

Ikram-rs22, 2024-12-18:
Ok I'll share it with you as soon as possible  Mr. Herman

Ikram-rs22, 2024-12-19:
I've downloaded the main branch last night and the result is the same. For both qucs and xyce models, the hbt simulations don't run. However, the resistor example runs only with ngspice. I don't know if I'm using the updated pdk or not.

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

Ikram-rs22, 2024-12-19:
However, I can simulate the netlist with xyce externally provided in the examples. This is the npn13G2_gain.cir netlist simulated with xyce externally.

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

sergeiandreyev, 2024-12-19:
> I've downloaded the main branch last night and the result is the same. ...
@Ikram-rs22, please download the `dev` branch

Ikram-rs22, 2024-12-19:
The dev branch previously did not work for me. Both xyce and ngspice didn't simulate. Has the dev branch been updated?

Ikram-rs22, 2024-12-20:
@KrzysztofHerman @sergeiandreyev The dev branch is working with Xyce. Thank you

FhatuL, 2024-12-20:
Hi, I tested out the new dev branch and it seems to work with both ngspice and Xyce, thanks. Although ngspice works, it seems to be producing some errors, I have attached a picture of these errors.
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

KrzysztofHerman, 2024-12-20:
@FhatuL please try to run `qucs-s` from the command line. Perhaps you click icon and qucs-s does not source the environmental variables `$PDK_ROOT` and `$PDK` make sure also that a symbolic link `.spiceinit` exists in your home directory and it links to the right file

FhatuL, 2024-12-20:
@KrzysztofHerman what value should $PDK take?

KrzysztofHerman, 2024-12-20:
`$PDK` = `ihp=sh13g2`

The typical configuration of your `.bashrc` should be as follows
```
export PDK_ROOT=/your_installation_pdk_path/IHP-Open-PDK
export PDK=ihp-sg13g2
export KLAYOUT_PATH="/home/$USER/.klayout:$PDK_ROOT/$PDK/libs.tech/klayout"
export KLAYOUT_HOME=/home/$USER/.klayout
```

FhatuL, 2024-12-20:
that worked, thank you.

Closed 2024-12-20.

Thread 157 (2024-07-04):

Cloning the submodule `digital` fails

hpretl, 2024-07-04:
## Environment

- Klayout Version: n/a
- OS/Platform: n/a

## Expected Behavior

Cloning the GitHub repo (branch `dev`) of the PDK works.

## Actual Behavior

It fails with the following error message:
```
24.49 Branch 'dev' set up to track remote branch 'dev' from 'origin'.
24.49 Switched to a new branch 'dev'
24.58 Submodule 'ihp-sg13g2/libs.tech/digital' (git@github.com:hneemann/IHP130.git) registered for path 'ihp-sg13g2/libs.tech/digital'
24.60 Cloning into '/tmp/ihp/ihp-sg13g2/libs.tech/digital'...
24.95 Host key verification failed.
24.95 fatal: Could not read from remote repository.
```

## Steps to Reproduce the Problem

1. See above, fails at just cloning the PDK repo.

hpretl, 2024-07-04:
See https://github.com/IHP-GmbH/IHP-Open-PDK/commit/2bcc70772bead98b8dbe6d2399d19530a1441d2c

sergeiandreyev, 2024-07-04:
Hi @hpretl , could you please share the `git` command you're using to clone/populate PDK data?

sergeiandreyev, 2024-07-05:
now that we start to include submodules in PDK repository there should be an additional option `--recursive` to run `git clone`:
```
> git clone --recursive -b dev git@github.com:sergeiandreyev/IHP-Open-PDK.git IHP-Open-PDK
...
Submodule path 'ihp-sg13g2/libs.tech/digital': checked out '9a6e7c9d404f9f4334513a24788aa8454918d400'
```

sergeiandreyev, 2024-07-14:
it seems we figured out the root cause:
in `.gitmodules` we have the reference to the `digital` repo in SSH mode: `git@github..`
and this will not work if the user does not have public keys as a method of authorizing on the GitHub - which is not the case for me and Krzysztof, this is why we did not see the issue
I checked if HTTP mode for repo URL in my fork will work for both use cases and apparently there are no issues now
We need to double check this and then I'll make a PR.

hpretl, 2024-07-14:
That sounds good! During image build there are no user credentials, we use https to pull stuff from GH.

hpretl, 2024-07-16:
Works now, thanks.

Closed 2024-07-16.

Thread 158 (2024-07-14):

MOS Devices Tests Aren't Working.

AhmedLilah, 2024-07-14:
## Environment

- Klayout Version: N/A
- OS/Platform: Ubuntu

## Expected Behavior
provided MOS tests to run.

## Actual Behavior
when I run any of the tests in xschem for the most devices I get an error while running ngspice saying
```plain
Error on line:
< the instance line>
unknown device type - error
        Simulation interrupted due to error!
```
this is not the case with passives and BJTs it only happens with most devices the rest are working fine.

## Steps to Reproduce the Problem

1. install the ihp-sg13g2 PDK using the make files and the python script in the xschem folder.
2. copy the ihp-sg13g2 PDK to the PDK_ROOT directory ( in my case /usr/local/share/pdk/)
3. copy the xschemrc file in xschme to my test directory
4. run `xschem`
5. open the test mos test.
6. netlist and run.

KrzysztofHerman, 2024-07-15:
@AhmedLilah thank you for reporting this issue.
Our MOS devices use PSP103 model, which is included in ngspice `control` section as a binary file using the following command: 'pre_osdi ./psp103_nq.osdi' Because of the license agreement we can not distribute the `osdi` binary but we do redistribute source code of the PSP103 model. The Verilog-A code can be compiled using opencaf (the `install.py` script does it). The potential issue is that since your `PDK_ROOT` points to the `/usr/local/share/pdk` running `install.py` does not take effect. Try first export the `PDK_ROOT` to point to the actual place where you clone it,  execute `install.py`. It is mandatory to have `openvaf` installed.

KrzysztofHerman, 2024-08-05:
@AhmedLilah was the above comment helpful ?

AhmedLilah, 2024-08-05:
Unfortunately no, I installed it according to what you said and it still doesn't work.

KrzysztofHerman, 2024-08-05:
Did you try our latest updates, where `.spiceinit` is used to let the simulator know about the models and the `osdi` file ?
If no try to update the `dev` branch and run `install.py` once more.

AhmedLilah, 2024-08-05:
I did and got this

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

KrzysztofHerman, 2024-08-06:
1. Make sure that you have exported the env variables
```
export PDK_ROOT=/home/$USER/your_directory/IHP-Open-PDK
export PDK=ihp-sg13g2
export KLAYOUT_PATH="/home/$USER/.klayout:$PDK_ROOT/$PDK/libs.tech/klayout"
export KLAYOUT_HOME=/home/$USER/.klayout
```
Note that the `klayout` related stuff is not used in the simulation but you will need this when making layout.

2.  after running `$PDK_ROOT/$PDK/libs.tech/xschem/install.py` make sure that `.spiceinit` symbolic link is created in `/home/$USER` and it points to the `$PDK_ROOT/$PDK/libs.tech/ngspice/.spiceinit`file
3. make sure that the file `$PDK_ROOT/$PDK/libs.tech/ngspice/openvaf/psp103_nqs.osdi` exists
4. run xschem in `$PDK_ROOT/$PDK/libs.tech/xschem` directory

Alternatively you can run this netlist directly in `ngspice`
```
*
.lib cornerMOSlv.lib mos_tt
Vgs net1 GND 0.4
Vds net3 GND 1.0
Vd net3 net2 0
.param temp=27
XM1 net2 net1 GND GND sg13_lv_nmos w=1.0u l=0.13u ng=1 m=1
.control
save all
op
let Id = @n.xm1.nsg13_lv_nmos[ids]
print Id
.endc
.GLOBAL GND
.end
```

KrzysztofHerman, 2024-08-21:
Can we close the issue ?

sergeiandreyev, 2024-09-11:
Hi @AhmedLilah, do you have some feedback or additional questions on this item? Otherwise we are going to close the issue as solved.

AhmedLilah, 2024-09-11:
@sergeiandreyev

I will revisit the problem once again and get back if anything changed.

But based on the bast comment it didn't get solved after setting the enviroment variables and compiling the files.

KrzysztofHerman, 2024-10-29:
@AhmedLilah can we close this issue ?

Closed 2024-12-18.

Thread 164 (2024-07-17):

MOSFET PSP model usage of NF parameter

hpretl, 2024-07-17:
When I do a simple testbench in ngspice simulating just a single LV-NMOS (I assume it is the same for PMOS and HV variants, but I have not checked it), I see that the model parameter `rg` is not reacting to the number of fingers I set. This is not ideal, as the PSP model can model extrinsic resistances.

From the PSP model doc:
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

The calculation of `rg` is:
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

In the model file of IHP's PDK, the PSP model is instantiated like that:
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

This means that essentially the `nf` (number of fingers, here called `ng`, which is not consistent) parameter is never passed on to the PSP model, instead only the width of a single finger is used in the model, and the multiplier parameter `m` is then increased by `nf` as passed on to the model as `mult=ng*m`. In this way, the intrinsic model does not know about the true `nf` and `m` parameters. This is also confirmed by looking at the model parameters in ngspice, which always shows `nf=1`.

Maybe this can be changed in a future release? It looks like some capabilities of the PSP model are bypassed in this way.

hpretl, 2024-07-17:
@bmurmann what do you think? Maybe this also explains some other model things you identified?

bmurmann, 2024-07-17:
Potentially, but the issues I wrote about where also present for `ng=1`.

KrzysztofHerman, 2024-08-05:
@hpretl I have followed the $R_G$ implementation and I found the exact lines of code in the file `PSP103_module.include`, which define it:
```
1522:  RG_p =  RSHG_i * (`oneThird * W_f / NGCON_i + XGWE) / (NGCON_i * L_slif) + (RINT_i + RVPOLY_i) / (W_f * L_f) + NF_i * RGO;
1709:  RG_i   = `CLIP_LOW(RG_p, 0.0);
3065:  rg  =  RG_i / MULT_i;
```
Also I found this:
```
1721: MULT_i  = `CLIP_LOW(MULT * NF_i, 0.0); // Note: NF_i is set to 1 for local model
```
Assuming that $R_G$ scales with `m` its value should consider the $N_F$ parameter passed indirectly as `mult`
Could @miesli or @metroid120 comment on that ?

miesli, 2024-08-05:
Hi,

yes the "m" or "ng" or "nf" issue is already well known for the PSP model in this PDK. Check also #25 for this.

Basically, the PDK was extracted and scaled like this in the SG13G2 PDK and somehow they decided that this was the best way to do that. @hpretl you are definitely right, that this does not use the PSP model correctly but without a new extraction with new measurements it is not easy to change since this requires most likely to verify all characteristics again.

Best regards

dwarning, 2024-09-04:
We are speaking about psp Version 103.6.0.

> 3065:  rg  =  RG_i / MULT_i;
> ```
The RG_i scaling by MULT_i is used here for OP variable calculation - not for contribution.

For that we have around line 1826:

`                         if (RG_i > 0.0) begin
                            ggate        =  1.0 / RG_i;
`
This value is used for matrix entry and noise analysis. The scaling is done in macro CollapsableR by multiplying with MULT_i.
So in the end - even with our confusing instantiation - RG should be correct scaled by NF because NF is part of the mult instance parameter.
@hpretl : Could you provide an simple test case to check our assumptions.

hpretl, 2024-09-04:
My not-very-sophisticated test is this (so maybe I am just interpreting things wrong):

I take a single MOSFET test bench, and look at the model parameters after `op` using `show`. Setting `ng=1` or `ng=2` reports the same `Rg`, which should not be the case, I think.

Here the netlist:
[mosfet_diode_sizing.spice.zip](https://github.com/user-attachments/files/16868661/mosfet_diode_sizing.spice.zip)

dwarning, 2024-09-04:
Thanks for the test case.
I think the problem is the reporting of the OP variable rg. I put in few strobes into the va code.
For ng=1:
OSDI(debug) n.xm1.nsg13_lv_nmos: RG_p 100.192
OSDI(debug) n.xm1.nsg13_lv_nmos: RG_i 100.192
OSDI(debug) n.xm1.nsg13_lv_nmos: RG_i 100.192 MULT_i 1 rg 100.192
OSDI(debug) n.xm1.nsg13_lv_nmos: RG_i 100.192 lp_rg 100.192

For ng=2:
OSDI(debug) n.xm1.nsg13_lv_nmos: RG_p 200.385
OSDI(debug) n.xm1.nsg13_lv_nmos: RG_i 200.385
OSDI(debug) n.xm1.nsg13_lv_nmos: RG_i 200.385 MULT_i 2 rg 100.192
OSDI(debug) n.xm1.nsg13_lv_nmos: RG_i 200.385 lp_rg 200.385

From code I see that RG_i goes into ggate. ggate will be then multiplied with MULT_i in CollapsableR and brings the correct current into branch.

rg seems buggy maybe it is repaired in newer versions.

dwarning, 2024-09-18:
I made 2 simulations with qucs-s/ngspice (klu enabled) with the mentioned instantiation schemes. Shown is the RG approximation from s-parameter simulation (Rg=re(Z11)-re(Z22)/3) of a w=10um NG=1...8 lv_nmos device with VG=1.2V and VD=0V.
The actual implementation shows RG 65 ... 10Ohm:
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

The proposed new instantiation shows RG 67 ... 45Ohm:
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

The values are similar then hand calculated values.

I think from view point of noise analysis the optimistic values of the actual implementation are critical.
@hpretl @bmurmann - your opinions?

hpretl, 2024-09-18:
@dwarning I think we should fix this so that we get most realistic behavior due to RG. A question that I have: Why is RF only going down from 67 to 45Ohm when NG is increased from 1 to 8? I would assume that RG goes down with NG^2 (W per finger = W/NG, so RG/finger = RG/NG), and then NG fingers in parallel, so $R_G(NG) = R_G(NG=1) / NG^2$?

dwarning, 2024-09-18:
Don't really know.
But if you look to the formulae you see an NF independent term (our problem we have). This is the resistance from contact to beginning of fingers I think.

dwarning, 2024-09-18:
I want show here my testbench for RG from S-parameter:

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

[lv_nmos_spar_vgs.sch.txt](https://github.com/user-attachments/files/17042330/lv_nmos_spar_vgs.sch.txt)

sergeiandreyev, 2025-01-17:
Hi @hpretl, could you please confirm that the issue is resolved from your side? We have the updates in `dev` branch

Closed 2025-01-17.

Thread 166 (2024-07-23):

Routing issue in `dfrbp_1` flop

sergeiandreyev, 2024-07-23:
## Environment

- Klayout Version: 0.29.2
- OS/Platform: Linux

## Expected Behavior
One should be able to connect CLK pin in `dfrbp_1` stdcell flop with M2

## Actual Behavior
DRC violation when the Via is put because of too small distance between Reset M2 bar and CLK pin

## Steps to Reproduce the Problem

1. Try to put min Via on CLK pin
2. Run DRC
3. It will produce violation

KrzysztofHerman, 2024-08-05:
@sergeiandreyev in order to make a valid contact one have to put the via and metal2 on the limit of the technology (see DRC rules `M2.b` and `Via1.c`).
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

The tools like OpenROAD already deal with it without any issues.

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

sergeiandreyev, 2024-08-05:
the issue relates to commercial PDK flow

Closed 2024-08-05.

Thread 167 (2024-07-23):

Fix pin labels in `a221oi_1` cell

sergeiandreyev, 2024-07-23:
## Expected Behavior
Pin labels in stdcells should be drawn on `Metal1.text` layer

## Actual Behavior
Signal pin labels in `a221oi_1` cell are drawn on `Metal1.label` layer, PG pin labels are drawn in `Metal1.pin` layer

## Steps to Reproduce the Problem

1. Open `a221oi_1` layout

Closed 2024-11-28.

Thread 169 (2024-07-29):

Any Recomended Python Versions?

redpanda3, 2024-07-29:
## Environment

- Klayout Version: .26.2
- OS/Platform: ubuntu20
python version: 3.8

## Expected Behavior

When klayout has launched, there should be no error in the terminal.

## Actual Behavior

ERROR message in the terminal ./.klayout/python/cni/ulist.py:23: "type" object is not subscriptable.

## Steps to Reproduce the Problem

1.
2.
3.

d-m-bailey, 2024-07-29:
@redpanda3 I think the LVS scripts for IHP require at least klayout 0.29.0

redpanda3, 2024-07-29:
> @redpanda3 I think the LVS scripts for IHP require at least klayout 0.29.0

Hi @d-m-bailey,

I've just upgraded that to 0.29.4, but it still shows the error message.

redpanda3, 2024-07-29:
Switch to python3.12.4, still shows the error message.

KrzysztofHerman, 2024-07-29:
@redpanda3 no issues with `python 3.10.12` and `klayout 0.29.0`. The `IHP-Open-PDK` is being developed using `Ubuntu 22.04 LTS`. We do not support backward compatibility with the previous versions of Ubuntu.

d-m-bailey, 2024-07-29:
@redpanda3 can you try `pip install klayout --upgrade`?
I noticed that the python libraries for klayout seemed to be installed differently than the actual program.

sergeiandreyev, 2024-09-11:
Hi @redpanda3, do you have some feedback or additional questions on this item?

redpanda3, 2024-09-12:
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

Hi, @sergeiandreyev @d-m-bailey @KrzysztofHerman please have a check on whether there is a Tech class under cni/dlo.py. I guess the problem is located in here.  Current Klayout version is 0.29.0, python version is 3.10.

redpanda3, 2024-09-12:
Maybe this is the new problem. Haven't check the problem for a month, sorry for that.

sergeiandreyev, 2024-09-13:
we've made un update to fix the `Tech` class import definition in `__init__.py`:
https://github.com/IHP-GmbH/IHP-Open-PDK/pull/200

redpanda3, 2024-09-13:
@sergeiandreyev Thank you, the problem solved, current python is 3.10 with klayout 0.29, ubuntu20.

Thread 180 (2024-08-12):

Stdcell schematics should contain multiplier = 1

sergeiandreyev, 2024-08-12:
Layouts contain multi-fingered MOS devices, so CDL and SPICE netlists should be fixed to align with layout

## Expected Behavior
```
.SUBCKT sg13g2_inv_2 A VDD VSS Y
*.PININFO A:I Y:O VDD:B VSS:B
MX1 Y A VSS VSS sg13_lv_nmos m=1 w=1.48u l=130.00n ng=2
MX0 Y A VDD VDD sg13_lv_pmos m=1 w=2.24u l=130.00n ng=2
.ENDS
```
## Actual Behavior
```
.SUBCKT sg13g2_inv_2 A VDD VSS Y
*.PININFO A:I Y:O VDD:B VSS:B
MX1 Y A VSS VSS sg13_lv_nmos m=2 w=740.00n l=130.00n ng=1
MX0 Y A VDD VDD sg13_lv_pmos m=2 w=1.12u l=130.00n ng=1
.ENDS
```

There is a check uploaded: https://github.com/IHP-GmbH/IHP-Open-PDK/blob/dev/ihp-sg13g2/libs.qa/stdcells/check_multiplier.sh

MilosMitrovic411, 2025-02-07:
I just made similar comment on a different issue, but I think it is worth pointing it out here as well. To me it is more natural for "ng" to be a multiplier, not a divisor, in which case your code would look like this:

`.SUBCKT sg13g2_inv_2 A VDD VSS Y
*.PININFO A:I Y:O VDD:B VSS:B
MX1 Y A VSS VSS sg13_lv_nmos m=1 w=740.00n l=130.00n ng=2
MX0 Y A VDD VDD sg13_lv_pmos m=1 w=1.12u l=130.00n ng=2
.ENDS`

sergeiandreyev, 2025-08-15:
verified: ok

Thread 186 (2024-08-19):

large increase in area for ff compared to buf for upsize

maliberty, 2024-08-19:
@precisionmoon noticed this large jump in area when upsizing a sequential compared to a buffer.  Is this expected?

PDK | BUFX1 | BUFX2 | BUFX1 -> BUFX2 area increase | DFFX1 | DFFX2 | DFFX1 -> DFFX2 area increase | DFF1->2 /BFF1->2
-- | -- | -- | -- | -- | -- | -- | --
ihp | sg13g2_buf_1 | sg13g2_buf_2 |   | sg13g2_dfrbp_1 | sg13g2_dfrbp_2
|   |  7.2576 | 9.072 | 1.8144 | 47.1744 | 54.432 | 7.2576 | 4

KrzysztofHerman, 2024-08-20:
@maliberty thank you for reporting this issue. At a first glance it should not be the case since as shown in the table (I also checked it in LEF and LIB files) the areas of the cells does not increase much as you change the cell type. I have also checked the spice netlist of all 4 circuits and they have identically sized transistors at the output, what should result in equal drive strengths for buffers and FF with the same postfix. I suppose that the increase in the area produces while placing the cells. Could you please mention the most critical parameters which are driving placer/resizer  ?

maliberty, 2024-08-20:
Drive strength, pin capacitance, and area are the most critical.  In other PDKs we observe an smaller ratio of increase.  To me this suggests some inefficiency in the cell layout.

Thread 188 (2024-08-28):

PCells in KLayout

olisnr, 2024-08-28:
i try to use nmosHV, pmosHV and cmim in KLayout from the last working SG13_dev version.

my BiG question is:
1. the MiM-capacitor should only use layer 5 and some MiM-layers if i look at _1.1 Main Processing Sequence and Cross-Section Schematic_ of _**SG13G2 Process Specification Rev. 1.2**_. but in KLayout i see also `TopMetal1.drawing`. is this an error ?

in DRC i get some errors:
2. pmosHV gives minimum errors DRC for pSD.i1 min 400nm, actual 340nm.
3. pmosHV has no GatPloy.pin but nmosHV has. is GatPloy.pin needed for production?
4. if i use an w=2u l=1u pmosHV i get also NW.d1 and LU.a errors
will this be fixed, or is the idea to draw pSD and ThickGateOxyde in the end from hand, when the FETs are placed?

sergeiandreyev, 2024-08-29:
I confirm that `pmosHV` Pycell is not consistent with the implementation in our commercial PDK, the device code will be updated & fixed
hopefully the errors will go away
on the first item let me check on this internally, for now I don't see any difference between PDKs

sergeiandreyev, 2024-08-29:
> 4. if i use an w=2u l=1u pmosHV i get also NW.d1 and LU.a errors

I cannot reproduce this, with the mentioned values I don't have `NW.d1` violations, also `LU.a` errors are present in any case, i.e. w=0.3u l=0.4u (default, min), w=2u l=1u

sergeiandreyev, 2024-08-29:
on the first item, the device geometry is correct - we need to have one connection to Metal5 and another one to TopMetal1
maybe the picture is not clear enough

sergeiandreyev, 2024-09-01:
Hi @olisnr, could you please take a look at the latest commit w/ updated device?
https://github.com/IHP-GmbH/IHP-Open-PDK/commit/017ca57a15805b68717c54ca454ac780541d695c
p.s. `LU.a` error in this device I see also in commercial PDK, I guess it's expected

olisnr, 2024-09-02:
when i use the latest commit (and also some versions before) KLayout (0.29.5 2024-7-31) schows errors at start up:
```
ich@P43s:~$ KLAYOUT_HOME='/home/ich/Downloads/IHP-Open-PDK-dev/ihp-sg13g2/libs.tech/klayout' klayout -e
ERROR: Reading /home/ich/Downloads/IHP-Open-PDK-dev/ihp-sg13g2/libs.tech/klayout/python/sg13g2_pycell_lib/ihp/pypreprocessor.py: Unable to open file: /ALL/DoWN/IHP-Open-PDK-dev/ihp-sg13g2/libs.tech/klayout/python/sg13g2_pycell_lib/ihp//pypreprocessor.py (errno=2)
ERROR: Reading /home/ich/Downloads/IHP-Open-PDK-dev/ihp-sg13g2/libs.tech/klayout/python/sg13g2_pycell_lib/ihp/pypreprocessor.py: Unable to open file: /ALL/DoWN/IHP-Open-PDK-dev/ihp-sg13g2/libs.tech/klayout/python/sg13g2_pycell_lib/ihp//pypreprocessor.py (errno=2)
ERROR: /ALL/DoWN/IHP-Open-PDK-dev/ihp-sg13g2/libs.tech/klayout/python/sg13g2_pycell_lib/__init__.py:23: ModuleNotFoundError: No module named 'cni'
  /ALL/DoWN/IHP-Open-PDK-dev/ihp-sg13g2/libs.tech/klayout/python/sg13g2_pycell_lib/__init__.py:23
  /ALL/DoWN/IHP-Open-PDK-dev/ihp-sg13g2/libs.tech/klayout/tech/pymacros/autorun.lym:8 (class ModuleNotFoundError)
```

and after it i cant open the `SG13_dev - iHP SG13G2 Pcells`. the window on top is using the newest commit, the window bellow some old version, wihtout the python loading errors:

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

sergeiandreyev, 2024-09-02:
I guess we need to update our installation documentation..
https://ihp-open-pdk-docu.readthedocs.io/en/latest/install/installation.html
now that we started to use submodules in the OpenPDK repo there should be additional options/commands to download the PDK correctly:
`git clone -b dev --recursive ...`
will get the branch `dev` with recursive submodules population

olisnr, 2024-09-03:
thanks, now all is totally different :)

now i get an M1.d error for the pmosHV at default settings. and for all pmosHV the normal LU.a error.

i tryed to understand the latchup rules. but _Figure 7.4: Latch-up protection rules_  **_SG13G2 Layout Rules Rev. 0.3_** is not so clear for me.
does the LU.a error means, that one should make a well-contact and tie to VSS?

if i understand it right, thats only necessary in IO cells.

the other thing i would like to know. how should i isolate sensitive circuits? whit a ring of `N+ isolator`, `P+ isolator` or both (_Figure 7.3: I/O latch-up protection scheme_)?

sergeiandreyev, 2024-09-09:
> I guess we need to update our installation documentation.. https://ihp-open-pdk-docu.readthedocs.io/en/latest/install/installation.html now that we started to use submodules in the OpenPDK repo there should be additional options/commands to download the PDK correctly: `git clone -b dev --recursive ...` will get the branch `dev` with recursive submodules population

updated documentation:
https://ihp-open-pdk-docs.readthedocs.io/en/latest/install/installation.html

sergeiandreyev, 2024-09-09:
> now i get an M1.d error for the pmosHV at default settings. and for all pmosHV the normal LU.a error.

this should be ok, as it is consistent with our commercial PDK

on the latch-up rules - we're reviewing the questions..

Closed 2024-11-28.

Thread 192 (2024-09-03):

top_lvl_pin

olisnr, 2024-09-03:
how are `top-level-pins ` made in KLayout?
there are `MetalN.pin`, `TopMetalN.pin` and `GatePoly.pin` layers. but there are also the `*.text` layers.
is a top_lvl_pin for the LVS-script a combination of `*.pin` and `*.text`, or something different?

FaragElsayed2, 2024-09-06:
@olisnr

Text layer only

https://github.com/IHP-GmbH/IHP-Open-PDK/blob/5a42d03194e8c98558f4e34538338a60550f89b9/ihp-sg13g2/libs.tech/klayout/tech/lvs/rule_decks/general_connections.lvs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

olisnr, 2024-09-06:
@FaragElsayed2

thanks. is this also working for GatPoly?

atorkmabrains, 2024-09-06:
@olisnr No, only metals.

Is that a request for change?

@sergeiandreyev Do you want us to change that and allow adding text on poly layer?

olisnr, 2024-09-06:
@FaragElsayed2 i think for the MOSFETs it would be necessary. otherwise its not possible to route direct via GatPoly...

sergeiandreyev, 2024-09-06:
@atorkmabrains, I'm not sure if there was such request before
let me check on this internally
How it's done in commercial PDK?
Frank will be next week I hope, so we can discuss from both sides

atorkmabrains, 2024-09-06:
@olisnr Are you using automated routing for MOSFETs?

It's unconventional in custom design to need text on poly. Usually, you need pins for the ports of your cells/blocks. There might be some use case of supporting this and it's not a big change for us.

@sergeiandreyev I'm not sure how it was implemented in commercial PDK, but we will check and get back to you.

olisnr, 2024-09-06:
@FaragElsayed2 at the moment i make manual routed analog.
if one does an OTA or some bias-circuit, then it could be interesting to connect direct to the gates, instead to make some vias to a metal-level thats not really needed on the wrong side of the big MOSFET.

FaragElsayed2, 2024-09-06:
@atorkmabrains @sergeiandreyev @olisnr

BTW, there is no text layer for poly in the PDK.

atorkmabrains, 2024-09-07:
@olisnr Just to confirm, you mean routing using Poly? Poly routing is not recommended. Poly has high resistivity and noisy routing layer. Just from the electronics point of view.

But as you say, we should cater for any kind of designer. Anyhow, we will check how it's done in the Commercial PDK and get back to you.

olisnr, 2024-09-07:
i only want to rout over GatPoly.drawing if two gates are very near. but it would interessting also when i want to route over metal from a big FET. because, if i have a pin on GatPoly.drawing i can place the Cont.drawing via at the best place, instead of being forced to use predefined vias...

i would like to know, if You think this kind of GatPoly.drawing-routing is a problem:

[OTAtest_small.gds.zip](https://github.com/user-attachments/files/16918351/OTAtest_small.gds.zip)

KrzysztofHerman, 2024-12-18:
@olisnr  can we close this discussion ? The answer to your question was already provided.

engrvip123, 2025-05-27:
What is the right way for adding pins in layout using IHP PDK in KLayout? Should I draw a metal box over the net using the `.pin` layer and then place pin name as text using same `.pin` layer?

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

olisnr, 2025-05-27:
@engrvip123 for LVS You have to use a text on the MetlaXXX.text or TopMetalXX.text layer, that is inside a shape of the corresponding .drawing layer.
i dont know what the pin-layer is good for, may be for the standard-cells and the auto-router...

Closed 2024-12-18.

Thread 196 (2024-09-09):

a question to LVS from .spice

olisnr, 2024-09-09:
while the LVS script, seem to analyse my `.gds`, it does nothing with the `.spice`. i tried also with the options `Netlist Only` and `Top Level Pins`.

can anybody get me a hint what could be wrong on the spice netlist? or is the script not ready to analyse .spice now?

[OTA_LVS.spice.tar.gz](https://github.com/user-attachments/files/16933924/OTA_LVS.spice.tar.gz)

d-m-bailey, 2024-09-09:
@olisnr Before you create your spice netlist from xschem, set the `Simulation` -> `LVS netlist: top level is a .subckt` option.

olisnr, 2024-09-10:
thanks a lot

Closed 2024-09-10.

Thread 197 (2024-09-10):

.spice net for LVS

olisnr, 2024-09-10:
it seems that the LVS script only looks for M-devices (spice MOSFETs). but if i understand it correct the spice-models are X-devices (sub-circuits (XM with the use-spice-prefix option in Xschem)).

should this be changed? or documented?

the other thing is that the LVS seems not to accept spice parameters. will this be implemented? or
is it be possible to ignore optional {} values?

sergeiandreyev, 2024-09-10:
so, while you can run the cross-check with the SPICE netlist as a schematic representation of the circuit, you'll have to do some preprocessing

atorkmabrains, 2024-09-11:
@olisnr That might be because an issue in the design. It's how klayout is functioning.

sergeiandreyev, 2024-09-12:
Hi @olisnr, could you please upload this testcase?

olisnr, 2024-09-12:
@sergeiandreyev yes:
[ota_gds_netlist.zip](https://github.com/user-attachments/files/16985799/ota_gds_netlist.zip)

sergeiandreyev, 2024-09-13:
I've made a quick review of the netlist, and checked the LVS on the testcase with commercial flow as well - the LVS is not clean (property, nets, instances, connectivity errors), but there are no top-level port related violations
I would expect however 'out <-> op' violation to show-up)
you have to follow the required syntax (f.e. device parameters are missing from the `.spice` file), also you have to check devices (cmim are missing from netlist)

sergeiandreyev, 2024-09-13:
what I do not understand is why I have all netlist ports in Database browser in capital letters, while in the netlist file I have `ip in ip sink`:
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
also, as you see, port names in layout are not consistent with your screenshot before

olisnr, 2024-09-13:
@sergeiandreyev yes i used on older version of the `.gds` in the `.zip`, and it has the the output label wrong.
i also tried to change all label in the `.gds` and `.spice` to uppercase, and i event tried to change the pin-order of the `.spice` to the order of the `TOP_extracted.cir` from the LVS-script, but it didnt change anything...

olisnr, 2024-09-16:
it seems there was a problem with the spice netlist. now it looks better i have no idea at the moment, why.

Closed 2024-09-16.

Thread 201 (2024-09-16):

DRC seem to miss error on GatPoly Gat.b or Gat.b1

olisnr, 2024-09-16:
KLayout 2.9.6

2 different GatPoly should have 180nm or 250nm distance. but there is no DRC error at 70nm.

im not sure what the correct minimum is in this case:

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

akrinke, 2024-09-17:
Thank you for the report! I have created the pull request #204 that should fix your problem. It updates the DRC script files [`sg13g2_maximal.lydrc`](https://raw.githubusercontent.com/IHP-GmbH/IHP-Open-PDK/bb559e2a6d23c66e1788eace1e6033d16964bf05/ihp-sg13g2/libs.tech/klayout/tech/drc/sg13g2_maximal.lydrc) and [`sg13g2_minimal.lydrc`](https://github.com/IHP-GmbH/IHP-Open-PDK/blob/bb559e2a6d23c66e1788eace1e6033d16964bf05/ihp-sg13g2/libs.tech/klayout/tech/drc/sg13g2_minimal.lydrc), so you just have to replace these files.

olisnr, 2024-09-18:
@akrinke the minimal file gives me an error:
```
ich@P43s:~$ KLAYOUT_HOME='/home/ich/share/pdk/ihp-sg13g2/libs.tech/klayout'   klayout -e
ERROR: Reading /ALL/Xschem/ihp/IHP-Open-PDK/ihp-sg13g2/libs.tech/klayout/tech/drc/sg13g2_minimal.lydrc: XML parser error: Root element must be klayout-macro in line 13, column 3
ERROR: Reading /ALL/Xschem/ihp/IHP-Open-PDK/ihp-sg13g2/libs.tech/klayout/tech/drc/sg13g2_minimal.lydrc: XML parser error: Root element must be klayout-macro in line 13, column 3
```

akrinke, 2024-09-18:
This is strange. The pull request has been merged just recently into the dev branch. The XML header has not been changed. Did you use the latest dev branch?

olisnr, 2024-09-18:
i only replaced the two files. now i try `git clone -b dev --recursive https://github.com/IHP-GmbH/IHP-Open-PDK.git`

olisnr, 2024-09-18:
now its working.
i would also like an %-free DRC script that ignore all this % fill specifications. because routing-errors would be easier to eliminate, if one wouldnt need to go to check every time 10 filling errors, that show up anyway.

sergeiandreyev, 2024-09-18:
> and are You interested to apply the commercial DRC and LVS tests with a little OTA, that seems to pass the openPDK DRC and LVS?

@olisnr, yes, we can run it

sergeiandreyev, 2024-09-18:
> i would also like an %-free DRC script that ignore all this % fill specifications. because routing-errors would be easier to eliminate, if one wouldnt need to check every time 10 filling errors, that show up anyway.

it will be nice to have different DRC modes under switches (like it's done in OpenPDK LVS), that the user can easily setup from the GUI / cmdline based on what he needs

olisnr, 2024-09-18:
@sergeiandreyev super thanks!

[OTA33.zip](https://github.com/user-attachments/files/17043983/OTA33.zip)

akrinke, 2024-09-18:
I will look into switching DRC modes from the GUI. It should already be possible on the command line:
```
$ klayout -zz -s layout.gds -rd density=false -r sg13g2_minimal.lydrc
```

sergeiandreyev, 2024-09-19:
> @sergeiandreyev super thanks!
>
> [OTA33.zip](https://github.com/user-attachments/files/17043983/OTA33.zip)

ok, here comes the DRC part..
I have 16 DRC violations in this design:
- Cnt_d: 3
- M1_b: 2
- M1_e: 7
- M2_e: 1
- NW_b: 1
- NW_e: 2

_I'm not sure if I can share more w/o NDA_

olisnr, 2024-09-19:
thanks a lot.
i think, a print-screens of the error-markers should be ok, or a list of problematic coordinates. the errors are no secret, because the rules are public anyway.

olisnr, 2024-09-19:
and one <180nm metal 1:

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

olisnr, 2024-09-19:
metal 1 line > 300nm for >1µm distance > 220nm

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

olisnr, 2024-09-19:
Min. space of Metal(n) lines if, at least one line is wider than
0.39 µm and the parallel run is more than 1.0 µm:

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

olisnr, 2024-09-19:
not really sure if i got this rule correct, but i think:

Min. NWell enclosure of NWell tie surrounded entirely by NWell in
N+Activ not inside ThickGateOx  0.24

is:

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

sergeiandreyev, 2024-09-20:
> the Cnt_d: 3 < 70nm i found already. the openPDK script was missing it:

all these violated rules (apart from `M1_e`) are not yet implemented ([link](
https://github.com/IHP-GmbH/IHP-Open-PDK/blob/dev/ihp-sg13g2/libs.tech/klayout/tech/drc/MissingRules_maximal.md))
@akrinke, do you have a preliminary timeline for the next bunch of DRC rules?

sergeiandreyev, 2024-09-20:
please find attached the DRC violations coordinates:
[drc_OTA.txt](https://github.com/user-attachments/files/17075020/drc_OTA.txt)
how to read:
`8634 -46580` -> `8.634, -46.58`

sergeiandreyev, 2024-09-20:
on the LVS:
- there are absent properties in CDL (`c` for `cmim`)
- discrepancies in `ng` for high-voltage PMOS devices

akrinke, 2024-09-20:
> @akrinke, do you have a preliminary timeline for the next bunch of DRC rules?

We hope to deliver the next version in about two weeks.

sergeiandreyev, 2024-09-23:
> and one <180nm metal 1:
>
> ![Screenshot from 2024-09-19 21-58-15](https://private-user-images.githubusercontent.com/120017377/369150878-7ebe08a4-c328-47c6-87b5-78e748213ef8.png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)

yes, this one is `M1.b`

olisnr, 2024-09-23:
@sergeiandreyev can You run this also on DRC? i tried to fix all DRC errors. and then i have the question if its possible, to run the commercial DRC on layouteditor.de? or on microwaveOffice?
thanks a lot

[OTA_33u 51.gds.zip](https://github.com/user-attachments/files/17097343/OTA_33u.51.gds.zip)

sergeiandreyev, 2024-09-23:
@olisnr, clean! 👍
> if its possible, to run the commercial DRC on layouteditor.de? or on microwaveOffice?
I guess no, but let me double check..
can you post this question on Slack?

sergeiandreyev, 2024-10-09:
Hi @olisnr, do you have any more questions, or we can close the ticket?

olisnr, 2024-11-28:
sorry

Closed 2024-11-28.

Thread 203 (2024-09-17):

how to use tolerances in LVS?

olisnr, 2024-09-17:
i have MOSFETs with 15.975µm instead of 16:
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

what is the correct way to define tolerances for part-parameters?

FaragElsayed2, 2024-09-18:
@olisnr Please share a small test case for this. Most probably, it's a grid issue but I need to recheck.

olisnr, 2024-09-18:
@FaragElsayed2 yes, its a grid issue because 16µm/9 dont fit in a 5nm grid. if i change the value in the netlist, it works, but if there are many parts, that need to be changed from hand, it will be interesting to be able solve the problem via a tolerance. the testcase is: $87

[OTA33_grid.zip](https://github.com/user-attachments/files/17045252/OTA33_grid.zip)

FaragElsayed2, 2024-09-18:
@olisnr If you're confident that the issue is grid-related, there's no need to investigate further. To resolve it, you have two options:

    - Fix the DRC grid by trying a few methods, such as adjusting the database unit/scaling.

    - Add a tolerance for the specific parameter you need for each device, similar to the approach outlined here: [KLayout LVS Global Parameters](https://www.klayout.de/doc-qt5/about/lvs_ref_global.html#h2-248). However, this would require modifying the LVS runsets, which is not generally recommended.

By default, we’ve only added tolerances for inductors due to the complexity of geometry calculations.

FaragElsayed2, 2024-09-18:
@olisnr I believe this isn't the ideal use case, but it might be worth discussing internally first.
CC @atorkmabrains.

MilosMitrovic411, 2025-02-07:
I think the good solution would be for "ng" to be a multiplier not a divisor. In your case, when you calculated your total width you would have to divide it yourself and that would immediately tell you that you would have to adjust your value, and plus you would be able to chose yourself do you want your finger width to be 1.775u or 1.78u.

olisnr, 2025-02-08:
@MilosMitrovic411 would be possible, but breaks the compatibility with the commercial PDK...

MilosMitrovic411, 2025-02-08:
@olisnr As it is now, yes, but my point is that it should be changed.

Thread 205 (2024-09-18):

.spiceinit seems to produce errors in AC simulation

olisnr, 2024-09-18:
the `option savecurrents` from `ihp-sg13g2/libs.tech/ngspice/.spiceinit` produces an error in the ngspice-42 AC-simulation:
`Error: r.x7.r14: Current and power not available for ac analysis`

holvo, 2024-09-24:
Please provide a simple test case showing this issue.

holvo, 2024-09-24:
No test case required. A simple netlist like
```
test ac
.options savecurrents
V1 1 0 dc 0 ac 1
R1 1 2 1k
C1 2 0 1u
.control
ac dec 10 10 10k
display
plot mag(v(2)) mag(@r1[i])
.endc
.end
```
does show this error message. AC simulation and .options savecurrents are incompatible. A resulting vector like @r1[i] is not a complex number and thus does not show magnitude and phase, as is expected by ac results.

KrzysztofHerman, 2024-10-14:
Solved in #217 PR

sergeiandreyev, 2024-10-23:
Hi @olisnr, could you please provide your feedback if the solution works for you and you don't have any additional comments on this issue, after that we can close it

olisnr, 2024-10-23:
looks good. thanks

Closed 2024-10-23.

Thread 207 (2024-09-22):

Simulation of MOSFET noise with ngspice

0y8w1x, 2024-09-22:
## Environment

- Klayout Version: not applicable
- OS/Platform: Ubuntu 22.04

## Actual Behavior

I tried to do a noise simulation of a single common source transistor, but found the noise to be 0. In case the schematic is incorrect or I use the noise analysis wrong, please let me know. A simple DC analysis works just fine, so the general setup should be working.

My circuit looks like this:
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

And when I plot the onoise_spectrum/inoise_spectrum aswell as the total integrated noise I get the following:
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

bmurmann, 2024-09-22:
You are measuring the output noise at a node that is pinned to 1V, so I am not surprised that the result is zero. What are you trying to do?

0y8w1x, 2024-09-29:
> You are measuring the output noise at a node that is pinned to 1V, so I am not surprised that the result is zero. What are you trying to do?

Oh yeah that was a stupid mistake. I want to measure the intrinsic noise of the MOSFET

KrzysztofHerman, 2024-10-09:
@0y8w1x could you please provide a correct testbench with some results. After that we could close the issue with a working example.

dwarning, 2024-10-09:
Maybe these qucs-s/ngspice (NGSPICE_OSDI_DIR env variable have to be set) examples can help to close the issue:
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

[lv_nmos_NOISE_id.sch.txt](https://github.com/user-attachments/files/17311124/lv_nmos_NOISE_id.sch.txt)
[lv_nmos_NOISE_vd_vg.sch.txt](https://github.com/user-attachments/files/17311125/lv_nmos_NOISE_vd_vg.sch.txt)

KrzysztofHerman, 2024-10-10:
@dwarning we provide a sample `.spiceinit`, which sets the location of the OSDI file so you do not have to reference it on the schematic. The only thing you have to do is to create a symbolic link to this file under your `$HOME` direcory. I will also add some more controls to setup the noise plot type.

dwarning, 2024-10-10:
Sorry, it was not the emphasis of my post. Anyway - thanks for hint.
What about induced gate noise. There are data and test benches available?

0y8w1x, 2024-10-12:
thanks @dwarning for the example, I reproduced it and it works great.
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

dwarning, 2024-10-14:
Another test case in a 50 Ohm environment NF, NFMIN and Rgn =f(Freq)
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

sergeiandreyev, 2024-10-22:
Hi @0y8w1x, do you have additional questions, or we can close the issue?

0y8w1x, 2024-11-21:
> Hi @0y8w1x, do you have additional questions, or we can close the issue?

can be closed, thank you.

Closed 2024-11-21.

Thread 216 (2024-10-07):

IO cells AnalogPad - enhancement

KrzysztofHerman, 2024-10-07:
Concerning the Analog pad :

1. It's missing from the `.lib` missing you get an error trying to use it because it's declared nowhere, ideally there would be a stub in there at least.
2. Also ideally the pad names exposed for the bond pad and the internal connection would be different. I understand it's the same metal but it's a bit confusing when trying to wire things up.

Closed 2024-12-18.

Thread 226 (2024-10-18):

Missing requirements: `psutil`

dnltz, 2024-10-18:
This PDK now has a dependency to `psutil`, which is not part of the standard Python library.

Packages shouldn't be installed directly into a system. I would suggest to introduce https://virtualenv.pypa.io/en/latest/ with a requirements file for this. Alternative, drop `psutil` and find a better alternative, for example `ps` inside a subprocess call.

```
ERROR: /home/daniel/work/aesc/i2c-gpio-expander/pdks/IHP-Open-PDK/ihp-sg13g2/libs.tech/klayout/python/sg13g2_pycell_lib/__init__.py:105: ModuleNotFoundError: No module named 'psutil'
  /home/daniel/work/aesc/i2c-gpio-expander/pdks/IHP-Open-PDK/ihp-sg13g2/libs.tech/klayout/python/sg13g2_pycell_lib/__init__.py:105
  /home/daniel/work/aesc/i2c-gpio-expander/pdks/IHP-Open-PDK/ihp-sg13g2/libs.tech/klayout/python/sg13g2_pycell_lib/__init__.py:151
  /home/daniel/work/aesc/i2c-gpio-expander/pdks/IHP-Open-PDK/ihp-sg13g2/libs.tech/klayout/python/sg13g2_pycell_lib/__init__.py:240
  /home/daniel/work/aesc/i2c-gpio-expander/pdks/IHP-Open-PDK/ihp-sg13g2/libs.tech/klayout/tech/pymacros/autorun.lym:8 (class ModuleNotFoundError)
ERROR: AttributeError: 'NoneType' object has no attribute 'layout'
  /home/daniel/work/aesc/i2c-gpio-expander/pdks/IHP-Open-PDK/ihp-sg13g2/libs.tech/klayout//tech/scripts/sealring.py:34
  /home/daniel/work/aesc/i2c-gpio-expander/pdks/IHP-Open-PDK/ihp-sg13g2/libs.tech/klayout//tech/scripts/sealring.py:70
```

ThomasZecha, 2024-10-19:
IMHO there is no reason to not use software besides the 'standard'. psutil is a well developed, cross-platform library which exactly addresses one need of the 'conditional PyCell compilation' feature.
I would not switch to a virtualenv, see also https://www.klayout.de/forum/discussion/2557/klayout-install-on-linux-system-python-vs-venv.
Nevertheless I've reduce the psutil dependency to the use of the feature, see https://github.com/IHP-GmbH/IHP-Open-PDK/pull/230

KrzysztofHerman, 2024-10-29:
@dnltz @ThomasZecha can we close this issue ?

ThomasZecha, 2024-10-29:
From my pov it can be closed.

dnltz, 2024-10-31:
I'm not complaining about `psutils` itself. It's indeed a well-maintained project.

The problem is you should not install a Python package system-wide on your Linux machine. Actually Ubuntu24 kind-of blocks that now...

```
$ pip3 install psutils
error: externally-managed-environment

× This environment is externally managed
╰─> To install Python packages system-wide, try apt install
    python3-xyz, where xyz is the package you are trying to
    install.

    If you wish to install a non-Debian-packaged Python package,
    create a virtual environment using python3 -m venv path/to/venv.
    Then use path/to/venv/bin/python and path/to/venv/bin/pip. Make
    sure you have python3-full installed.

    If you wish to install a non-Debian packaged Python application,
    it may be easiest to use pipx install xyz, which will manage a
    virtual environment for you. Make sure you have pipx installed.

    See /usr/share/doc/python3.12/README.venv for more information.

note: If you believe this is a mistake, please contact your Python installation or OS distribution provider. You can override this, at the risk of breaking your Python installation or OS, by passing --break-system-packages.
hint: See PEP 668 for the detailed specification.
```

I have multiple Python projects on my machine installed with each different tool requirements. Installing them all system-wide would end in a mess. You also want to make sure everyone is using the same version to lower support.

In my opinion: there should be a `requirements.txt` file in the project root directory and documentation how to create and use a virtualenv in the documentation.

ThomasZecha, 2024-11-01:
Pleae make a proposal for _'there should be a requirements.txt file in the project root directory and documentation how to create and use a virtualenv in the documentation'_

dnltz, 2024-11-01:
Sure, @ThomasZecha can you explain when `psutils` is actually required? I figured out I can use the PDK for digital designs without it, after you moved the function. Would help me to write documentation then.

ThomasZecha, 2024-11-04:
_psutils_ will be used if one of the PyCells loaded by https://github.com/IHP-GmbH/IHP-Open-PDK/blob/dev/ihp-sg13g2/libs.tech/klayout/python/sg13g2_pycell_lib/__init__.py uses the _#ifdef name_ instruction for conditional compilation, see also https://github.com/IHP-GmbH/IHP-Open-PDK/tree/dev/ihp-sg13g2/libs.tech/klayout/#readme

Closed 2024-11-12.

Thread 231 (2024-10-20):

npn13g2 subckt simulation problem

britovski, 2024-10-20:
## Environment

- Klayout Version: 0.29.7
- OS/Platform: linux
- XSchem 3.4.5
- NGSpice 43

## Expected Behavior
both TBs (inv_ttl_tran and inv_ttl_tran2) are expected to work since the only difference is that transistors in one of them are inside a subckt.

## Actual Behavior
TB with subckt doesn't work and gave a subckt error message:
Error: unknown subckt: x1.xq1 out x1.net1 0 0 x1.npn13g2
    Simulation interrupted due to error!

## Steps to Reproduce the Problem

1. just run 'ngspice inv_ttl_tran.spice' in attached testcase that error message will appear.
2.
3.

Both TB netlists and xschem files are provided in attachment as a testcase.
[inv_ttl.tar.gz](https://github.com/user-attachments/files/17451335/inv_ttl.tar.gz)

PS: I didn't have problems with MOSFETs using the same hierarchy flow on xschem/ngspice.

dwarning, 2024-10-21:
The transistor subckt's needs the fifthnode for temperature:

```
XQ1 B2 net1 GND GND t npn13G2 Nx=1
XQ2 net1 B1 IN GND t npn13G2 Nx=1
```
There seems something wrong with your PDK installation.

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

britovski, 2024-10-21:
@dwarning your xschem is generating the subckt netlist with the fifth node?

KrzysztofHerman, 2024-10-28:
Hi @britovski could you please take a look at this PR #241. It should resolve your issue of hierarchical schematic entry.

britovski, 2024-10-28:
Hi @KrzysztofHerman
The problem with hierarchical schematic maybe is ok but now for the same testcase using the PR update I got another errors (for both testbenches, with and without subckt).

You can just run any spice netlist to see those errors (the same will appears for re-generated on xschem).

Warning: singular matrix:  check node q.x1.xq2.qnpn13g2#collCI

Note: Starting dynamic gmin stepping
Warning: singular matrix:  check node x1.xq2.s1

Warning: singular matrix:  check node q.x1.xq2.qnpn13g2#substrate

Note: Dynamic gmin stepping completed
Warning: singular matrix:  check node q.x1.xq2.qnpn13g2#collCI

Warning: singular matrix:  check node q.x1.xq2.qnpn13g2#collCI

Warning: singular matrix:  check node q.x1.xq2.qnpn13g2#collCI

doAnalyses: TRAN:  Timestep too small; time = 1.6e-11, timestep = 6.25e-23: trouble with node "vdd"

tran simulation(s) aborted

britovski, 2024-10-28:
@KrzysztofHerman When I commented the *option klu on the .spiceinit it worked.

KrzysztofHerman, 2024-10-29:
@britovski good to hear that. The KLU makes sense only for big circuits, it can speed up the simulation by a factor of 2. Additionally not all simulations, like SP, can be executed using KLU. Can we close this thread ?

britovski, 2024-10-29:
@KrzysztofHerman Yes. We can close. Thanks.

Closed 2024-10-30.

Thread 234 (2024-10-23):

two Xyce example questions

olisnr, 2024-10-23:
the code of the example hv_nmos_id_vg_vb.cir is:
```
psp103 test circuit
*
vd  d 0 dc 0.05
vg  g 0 dc 0.0
vs  s 0 dc 0.0
vb  b 0 dc 0.0
X1  d g s b sg13_hv_nmos w=2u l=0.5u mult=1

.option temp=27
.step  vb -3 0 0.25
.dc vg 0 3 0.02
.print dc format=gnuplot v(g) i(vd)

.lib ../models/cornerMOShv.lib mos_tt

.end
```

what does `psp103 test circuit`? and shouldnt the `mult=1` of `X1` be `m=1`?

KrzysztofHerman, 2024-10-23:
@olisnr the instance entry for the devices is the same for ngspice and xyce so
```
XM1 d g s b sg13_hv_nmos W=1u L=1u ng=2 m=1
```

olisnr, 2024-10-23:
then the examples should be changed.

an other question is, there are no `cornerCAP.lib` and `cornerRES.lib` files in the `xyce/models` folder can i use this libraries from ngspice in xyce?

KrzysztofHerman, 2024-10-24:
@olisnr since `Xyce` support is under development please checkout my fork.
https://github.com/KrzysztofHerman/IHP-Open-PDK/tree/dev/ihp-sg13g2/libs.tech/xyce/models
We are about to merge it to the main repo so any feedback  is more than welcome.
Be careful with the paths to the libraries, you have to provide a full path.
Since there are a slight differences between the libraries for `ngspice` and `Xyce` now we will maintain two separate version of each.

olisnr, 2024-10-24:
the `model=cap_cmim` seems to work :ok_hand:

KrzysztofHerman, 2024-10-28:
@olisnr can we close?  Are there any other questions ?

Closed 2024-10-28.

Thread 235 (2024-10-24):

Sealring Pcell dimenssion inconsistency

PhillipRambo, 2024-10-24:
In klayout its possbile to set the length and width of the sealring arbitrarily small. This creates rather funky structures that defently arent realizable. This is shown in the attached pictures. I'm not sure if the minimum size is (50x50)u or (150x150). First picture shows structur for 50 x 50, and second picture is for 1x1.

# 50 x 50 micro
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

# 1 x 1 micro
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

KrzysztofHerman, 2024-10-24:
The default minimum `minW` and `minL` are set to 50 um in the json file and sourced by pycell when instantiated.
```
        defL       = techparams['sealring_complete_defL']
        minL       = techparams['sealring_complete_minL']
        defW       = techparams['sealring_complete_defW']
        minW       = techparams['sealring_complete_minW']
```
Reviewing the code they are never used...

dnltz, 2024-10-28:
I think 50x50 is far too small for any reasonable design. You don't even fit a pad inside ...

@KrzysztofHerman maybe a simple `assert self.l > params['Lmin']` in setupParams would be enough to fail with too small sealrings?

KrzysztofHerman, 2024-10-29:
@dnltz @ThomasZecha there is a function `RangeConstraint` described in  `Python API Reference Manual
2022.06-SP2` pp. 236. It could perfectly limit the values of the parameters in the parameter window and avoid the
situation where the wrong value is set.
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

```
        specs('l', defL, 'Length(X-Axis)', RangeConstraint(150,3000))

```
Unfortunately I do not know how to deal with the units. I have also experimented with `nmos_code.py` cell trying to use this function to restrict the number of gates `ng` however it does not take any effect.
@ThomasZecha do we need some extensions in API to support this ?

ThomasZecha, 2024-10-29:
RangeConstraint is already supported by the PyCell-API, see https://github.com/IHP-GmbH/IHP-Open-PDK/blob/dev/ihp-sg13g2/libs.tech/klayout/python/sg13g2_pycell_lib/ihp/npn13G2_code.py line 40.

ThomasZecha, 2024-10-29:
The problem with
_specs('ng',   defNG, 'Number of Gates', RangeConstraint(1, 5))_
is the wrong type of defNG. The type of defNG is string, which is not supported as RangeConstraint. Changing it to an integer or floating-point in the json-techfile fix it.

What's wrong with the nmos-layout?

KrzysztofHerman, 2024-10-29:
@ThomasZecha so does it mean that this change from str->int, or in general value->numeric, implies API extension ?
As for the layout it was caused by inappropriate value of W which was calculated as `nmos_defW/ng` where `ng=6`. A good example how one can generate an invalid cell. What we need are checks (callbacks), which will verify if the parameters that one enter in the GUI are valid.

sergeiandreyev, 2024-11-27:
we updated the values, so that:
default = 400um
min = 150um

the 50x50 size is not allowed this way, but until we will implement the checking in the code you will still be able to set the wrong values

KrzysztofHerman, 2024-12-18:
Partially solved with minimal values defined

KrzysztofHerman, 2024-12-18:
The development will continue according to #301

Closed 2024-12-18.

Thread 237 (2024-10-27):

decap cells should be marked "CORE SPACER" in lef

gadfort, 2024-10-27:
## Environment
OpenROAD uses this flag to determine if a cell can be removed during `remove_fillers`, without this the decaps cannot be removed for antenna fixes.

## Expected Behavior
decaps marked as SPACER to allow them to properly interact with the tools

## Actual Behavior
decaps are just marked CORE.

b10346, 2024-11-20:
Ok, need to be investigated

sergeiandreyev, 2024-11-28:
Hi @gadfort, could you please confirm that the update is as expected on your side as well.

gadfort, 2024-11-30:
@sergeiandreyev yes, this works. Thank you.

Closed 2024-12-01.

Thread 239 (2024-10-28):

SRAM macros failing LVS

urish, 2024-10-28:
## Environment

IHP-Open-PDK commit 860268eaa497aff29195bf380dabdcfdc69a5cff

## Expected Behavior

SRAM macros pass LVS checks

## Actual Behavior

SRAM macros fail LVS checks. I tested with the following macros:

- RM_IHPSG13_1P_1024x8_c2_bm_bist.gds
- RM_IHPSG13_1P_1024x64_c2_bm_bist.gds
- RM_IHPSG13_1P_64x64_c2_bm_bist.gds
- RM_IHPSG13_1P_4096x8_c3_bm_bist.gds

The errors seem to be related to `RSC_IHPSG13_CDLYX1_DUMMY` - I'm attaching a copy of the LVS run dir with the extracted circuit and the .lvsdb file:

[lvs_run_2024_10_28_12_29_51.zip](https://github.com/user-attachments/files/17542376/lvs_run_2024_10_28_12_29_51.zip)

## Steps to Reproduce the Problem

Check out this repo (dev branch), set `PDK_ROOT` to point at the checked out repo, and then run:

```bash
cd $PDK_ROOT/ihp-sg13g2/libs.tech/klayout/tech/lvs

python run_lvs.py --layout $PDK_ROOT/ihp-sg13g2/libs.ref/sg13g2_sram/gds/RM_IHPSG13_1P_1024x8_c2_bm_bist.gds --netlist $PDK_ROOT/ihp-sg13g2/libs.ref/sg13g2_sram/cdl/RM_IHPSG13_1P_1024x8_c2_bm_bist.cdl
```

sergeiandreyev, 2024-10-29:
Hi @urish, for the SRAM cells the user should set additional parameters for the LVS run, with default settings it will not work
we have to figure out if it's possible with the current implementation of the KLayout LVS
@atorkmabrains, @FaragElsayed2, can we discuss this?

sergeiandreyev, 2024-10-30:
> Thanks! Is there a way to tell LVS to skip the SRAM cells?

I'll check with Mabrains team..
I double checked the SRAM LVS using our commercial tools and the status is:
the following have LVS mismatches (UNMATCHED SCHEMATIC PIN LABELS): 1024x8, 1024x16, 4096x8, 4096x16
all others are clean

we will review the issues if these are critical or could be waived

atorkmabrains, 2024-10-30:
`blank_circuit` command should be able to do that for you. It has to be included in the rule deck.

urish, 2024-10-31:
Thanks, unfortunately, blank_circuit seems to confuse KLayout - when enabling it for RM_IHPSG13_1P_1024x8_c2_bm_bist, suddenly, there are many mismatched nets / devices at the top level (before they were matched correctly).

```
schematic.blank_circuit('RM_IHPSG13_1P_1024X8_C2_BM_BIST')
netlist.blank_circuit('RM_IHPSG13_1P_1024x8_c2_bm_bist')
```

Here's variation, which only tries to blacklist the mismatching cells inside the SRAM macro:

```
blank_circuit("RSC_IHPSG13_CDLYX1_DUMMY")
blank_circuit("RSC_IHPSG13_CINVX2")
blank_circuit("RSC_IHPSG13_CINVX8")
blank_circuit("RSC_IHPSG13_FILLCAP4")
blank_circuit("RSC_IHPSG13_FILLCAP8")
```

It is almost working - for reason, we're still getting mismatches for the pins of RSC_IHPSG13_FILLCAP4 and RSC_IHPSG13_FILLCAP8:

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

I'm attaching the GDS, CDL and the LVS script for this variation. I'm running it as follows:

```
klayout -b -rd in_gds=6_final.gds -rd cdl_file=6_final_concat.cdl -rd report_file=6_lvs.lvsdb -rd run_mode=deep -r sg13g2_full.lylvs
```

[issue-239.zip](https://github.com/user-attachments/files/17584211/issue-239.zip)

atorkmabrains, 2024-11-01:
@sergeiandreyev Anything is required from us?

sergeiandreyev, 2024-11-01:
Hi @atorkmabrains, yes, I will send an email

KrzysztofHerman, 2024-12-18:
@atorkmabrains a gentle reminder on this action

atorkmabrains, 2024-12-18:
@KrzysztofHerman @sergeiandreyev We could discuss further in a meeting.

Thread 243 (2024-10-29):

Error in Qucs-s example simulation

joerdsonsilva, 2024-10-29:
## Environment
OS/Platform: linux
Qucs-s 24.3.2
NGSpice 43

## Expected Behavior
The example circuits in the IHP-Open-PDK-SG13G2-Examples_pjr folder are expected to be simulated.

## Actual Behavior
The example circuits (ac_mim_cap.sch, dc_diode_op.sch, dc_hbt_13g2.sch, ..... ) do not simulate and generate an error message:
"Ngspice started...Note: No ".plot", ".print", or ".fourier" lines; no simulations run
Note: Compatibility modes selected: hs a

Circuit: * qucs 24.3.2 /home/joerdson/qucsworkspace/ihp-open-pdk-sg13g2-examples_prj/ac_mim_cap.sch
Simulation finished"

## Steps to Reproduce the Problem

1. Open Qucs-s
2. Main Dock -> Projects -> IHP-Open-PDK-SG13G2-Examples_pjr
3. Content -> Schematics -> Choose example
4. Simulation

The component symbols are all square, maybe that's a problem too.
[Images.zip](https://github.com/user-attachments/files/17559930/Images.zip)

KrzysztofHerman, 2024-10-30:
@joerdsonsilva thank you for reporting this.
Have you executed the installation script   `$PDK_ROOT/$PDK/libs.tech/qucs/install.py` ?
Verify if you have the symbol libraries installed under `~/.qucs/user_lib` or `~/Qucs_Workspace/user_lib`

joerdsonsilva, 2024-10-30:
Yes, I did. The problem was occurring in the second part, in the "Add Path With Subfolders" step. But the SG13G2 PDK library folder was found at:

/home/Joerdson/QucsWorkspace/IHP-Open-PDK/ihp-sg13g2/libs.tech/qucs/user_lib

With that, the problem was solved.

sergeiandreyev, 2024-11-18:
Hi @joerdsonsilva, could you please check the proposed solution?

Closed 2024-10-30.

Thread 245 (2024-10-30):

Pad.kR rule vs openroad PAD

britovski, 2024-10-30:
## Environment
klayout 0.29.7

## Expected Behavior
DRC clean?

## Actual Behavior
144 Pad.kR rule violations

## Steps to Reproduce the Problem

1. Just open bondpad_70x70.gds from https://github.com/The-OpenROAD-Project/OpenROAD-flow-scripts/tree/master/flow/platforms/ihp-sg13g2/gds
2. Run DRC maximal
3.

I saw that is an expressed rule on SG13G2_os_layout_rules manual that says: "TopVia2 under Pad not allowed (Note 3)"
Note 3. TopVia2 may be damaged during packaging process, we recommend not to use them below Passiv.

The openroad PAD has stacked all metal layers to easy the connections from the chip but how can deal with the note 3 about the violation?

noherbrferurtth, 2024-10-30:
Hi,

so far we used the Bondpad GDS for all our Tapeouts and had never issues with wire- or flipchip bonding.
I will check internally if we can remove this note or if i missed anything here.
However, we never got DRC error on the pad.

Best

smunaut, 2024-10-30:
Same errors here.

I also have others which I think are coming from that bondpad as well :

```
Pad.d1R: 100
Pad.fR_M2: 100
Pad.fR_M3: 46
Pad.fR_M4: 46
Pad.fR_M5: 46
Pad.fR_TM1: 46
Pad.fR_TM2: 67
Pad.kR: 4600
```

akrinke, 2024-10-30:
If `Pad.kR` is no longer necessary, it should be removed from the Layout Rules Manual. Then we can remove it from the DRC script.

dnltz, 2024-10-31:
I can confirm I also see `Pad.kR` and `Pad.d1R` in my design. @KrzysztofHerman ran the commercial DRC and it didn't report those. Seems to be related to the open DRC.

akrinke, 2024-11-04:
That's interesting. @KrzysztofHerman Is there something wrong with our implementation / understanding of `Pad.kR`?

smunaut, 2024-11-04:
The "rejection test" thing on the web ui for submission definitely reports `Pad.kR` to me.

KrzysztofHerman, 2024-11-04:
@akrinke the detection of this violation is seems to be correctly implemented. Nevertheless maybe we could think about additional section in the rules related to `recommendations `. If you red the description carefully this rule is a recommendation and it is related to the probability that the vias will get damaged during the wire bonding process.
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

KrzysztofHerman, 2024-11-04:
@britovski  going back to your concern about the `Pad.k` rule you could eventually use an **exit** from the bondpad structure (following `Pad.e` and `Pad.f` rules) and use vias outside it. Thus you would ensure 100 % reliability.
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

A practical example:
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

akrinke, 2024-11-04:
> @akrinke the detection of this violation is seems to be correctly implemented. Nevertheless maybe we could think about additional section in the rules related to `recommendations `. If you red the description carefully this rule is a recommendation and it is related to the probability that the vias will get damaged during the wire bonding process.

It is already defined as a recommendation. If you run the maximal DRC script with `-rd noRecommendedRules=true`, this rule won't be checked.

sergeiandreyev, 2024-11-05:
one more comment regarding the *"rejection test" thing on web ui reports `Pad.kR`*
during the rejection test from the web UI actually two DRC runs are made in parallel:
- the 'real' rejection test with tool `x` and rejection test-specific (short) list of DRC rules -> this is a run for IHP to decide if the design can be forwarded to manufacturing process, the GDS does not have any critical errors!
- the 'extra' DRC run w/ tool `y` and full set of DRC rules from commercial PDK -> this is a run for 'customer' to cross check that the results of a DRC run are the same as he can see on his side using commercial tools/PDK

KrzysztofHerman, 2024-12-18:
the `bondpad` will be re-implemented

Thread 246 (2024-10-30):

NW.b violation when two ebufn_2 abutt themselves

smunaut, 2024-10-30:
See attached image.

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

The rule is 0.62 min, but with two ebufn_2 cells next to each other you get 0.42. And actually if one of them is in the other orientation it can get down to 0.345.

smunaut, 2024-10-30:
And as a side note, that rule isn't checked by the DRC deck.

sergeiandreyev, 2024-10-30:
> And as a side note, that rule isn't checked by the DRC deck.

yes, the rule `NW.b` is still not implemented:
 https://ihp-open-pdk-docu.readthedocs.io/en/latest/verification/drc/03_missing_rules.html

smunaut, 2024-10-30:
I added this locally, which does report those errors, but given it's mostly just a cut&paste of similar rules in `Mn.b` and I barely know what I'm doing, I'll let the DRC deck experts actually add it :grin:

```diff
--- sg13g2_maximal.lydrc	2024-10-30 10:51:23.044619042 +0000
+++ sg13g2_maximal_nwb.lydrc	2024-10-30 10:51:09.123354890 +0000
@@ -1613,6 +1613,9 @@
     NWell_NW_a.dup
 end.().output("NW.a", "Min. NWell width = 0.62")
 -&gt; do
+    NWell.ext_fast_space(0.62.um, consider_intersecting_edges: false, ignore_non_axis_aligned_edges: true)
+end.().output("NW.b", "Min. NWell space or notch = 0.62")
+-&gt; do
     NWell.ext_fast_separation(NActHV_ana, 0.62.um)
 end.().output("NW.d1", "Min. NWell space to external N+Activ inside ThickGateOx = 0.62")
 -&gt; (;x, y) do
```

akrinke, 2024-10-30:
Yes, as a temporary fix, you can implement the rule like this. However, the rule should only look at connected polygons – that's why we haven't implemented it, yet.

sergeiandreyev, 2024-10-30:
FYI, #247

sergeiandreyev, 2024-11-28:
Hi @smunaut, could you please confirm that the update fixes the issue on your side as well.

Closed 2024-12-18.

Thread 247 (2024-10-30):

Need automatic generation of layout assembly (simple in-line, all with all) to run abutment checks for stdcells

sergeiandreyev, 2024-10-30:

smunaut, 2024-10-30:
FWIW I had done something similar for sky130 to find that kind of issue. I quickly hacked it for sg13g2
[try_cells.zip](https://github.com/user-attachments/files/17575176/try_cells.zip)

It tries every cell against every cell in different orientations.
It doesn't create continuous rows, but at least for me that was enough to run through DRC

sergeiandreyev, 2024-10-30:
@smunaut, great! thank you!

smunaut, 2024-10-30:
[drc.xml.zip](https://github.com/user-attachments/files/17576420/drc.xml.zip)

Attached in the DRC maximal results from the klayout deck on the test gds generated by the scripts.

* There are the `NW.b` known from `ebufn_2`.
* There is a few `CntB.a1` those are false positives. The script placed the columns too close and they touched. I didn't re-run because it takes like 2h to run the klayout drc deck ...
* There are a bunch of `M1.b` and those look like real potential issues.

akrinke, 2024-11-01:
@smunaut Thank you! I've added the layout to our regression test suite.

sergeiandreyev, 2024-11-19:
Hi @smunaut, I've added the script and the test GDS to the OpenPDK repo
also you to the AUTHORS 😉

Closed 2024-11-28.

Thread 249 (2024-10-31):

Can not run HBT example from Qucs-s using Xyce simulator

rupokdas147, 2024-10-31:
## Environment
Qucs-s 24.3.1
Xyce 7.8

## Expected Behavior
The examples given in "sg13g2/libs.tech/qucs-s/exampels" does not run using Xyce.
But the examples given in "sg13g2/libs.tech/xyce/examples" run without any trouble, when I run the cir files from Terminal, and I can plot them using Gnuplot.
Can anyone help me how can I run schematics from Qucs-s using Xyce?

## Actual Behavior
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

## Steps to Reproduce the Problem

1. Open Qucs-s.
2. Projects > IHP-Open-PDK-SG13G2-Examples_prj > Schematics > dc_hbt_13g2.sch
3. Change Simulator to Xyce.
4. Change Model Library Directory from Ngspice to Xyce.
5. Simulate

rupokdas147, 2024-11-01:
@KrzysztofHerman Here is the Netlist file...

* Qucs 24.3.0  /home/rf/QucsWorkspace/IHP-Open-PDK-SG13G2-Examples_prj/dc_hbt_13g2.sch

.SUBCKT IHP_PDK_nonlinear_components_npn13G2  gnd c b e bn t Nx=1
.INCLUDE   ../../.qucs/IHP-Open-PDK-main/ihp-sg13g2/libs.tech/xyce/models/sg13g2_hbt_mod.lib
X1 c b e bn t  npn13G2 Nx={Nx}
.ENDS

.LIB /home/rf/IHP-Open-PDK/ihp-sg13g2/libs.tech/xyce/models/cornerHBT.lib hbt_typ
VPr1 _net0 _net1 DC 0
V2 _net0 0 DC 1
I1 0 _net2 DC 0

Xnpn13G2 0  _net1 _net2 0 gnd IHP_PDK_nonlinear_components_npn13G2 Nx=1
.dc v2 0 1.5 0.005
.step i1 0 5e-06 5.55556e-07
.PRINT  dc format=raw file=spice4qucs.dc._swp.plot I(VPr1)
.END

rupokdas147, 2024-11-01:
This line automatically becomes ngspice. Don't know why

* Qucs 24.3.0  /home/rf/QucsWorkspace/IHP-Open-PDK-SG13G2-Examples_prj/dc_hbt_13g2.sch

.SUBCKT IHP_PDK_nonlinear_components_npn13G2  gnd c b e bn t Nx=1
.INCLUDE   ../../.qucs/IHP-Open-PDK-main/ihp-sg13g2/libs.tech**/ngspice/**models/sg13g2_hbt_mod.lib
X1 c b e bn t  npn13G2 Nx={Nx}
.ENDS

.LIB /home/rf/IHP-Open-PDK/ihp-sg13g2/libs.tech/xyce/models/cornerHBT.lib hbt_typ
VPr1 _net0 _net1 DC 0
V2 _net0 0 DC 1
I1 0 _net2 DC 0

Xnpn13G2 0  _net1 _net2 0 gnd IHP_PDK_nonlinear_components_npn13G2 Nx=1
.dc v2 0 1.5 0.005
.step i1 0 5e-06 5.55556e-07
.PRINT  dc format=raw file=spice4qucs.dc._swp.plot I(VPr1)
.END

rupokdas147, 2024-11-01:
I changed every "ngspice" to xyce and tried to run it from terminal using "xyce [netlist]" command. Here are the errors:

*****
***** Welcome to the Xyce(TM) Parallel Electronic Simulator
*****
***** This is version Xyce Release 7.6-opensource
***** Date: Fri Nov 01 06:28:17 EDT 2024

***** Executing netlist /home/rf/QucsWorkspace/IHP-Open-PDK-SG13G2-Examples_prj/dc_hbt_13g2.cir

***** Reading and parsing netlist...
Netlist error: Number of nodes for subcircuit instance XNPN13G2 does not agree
 with number of nodes in subcircuit IHP_PDK_NONLINEAR_COMPONENTS_NPN13G2
Simulation aborted due to error.  There are 0 MSG_FATAL errors and 1 MSG_ERROR
 errors
*** Xyce Abort ***
Simulation aborted due to error.  There are 0 MSG_FATAL errors and 1 MSG_ERROR
 errors

*** Xyce Abort ***
--------------------------------------------------------------------------
MPI_ABORT was invoked on rank 0 in communicator MPI_COMM_WORLD
with errorcode 1.

NOTE: invoking MPI_ABORT causes Open MPI to kill all MPI processes.
You may or may not see output from other processes, depending on
exactly when Open MPI kills them.

KrzysztofHerman, 2024-11-01:
@rupokdas147  so there is an issue with the binding to a valid model.
In this #241 PR we provide some solution for xschem and ngspice, which binds symbols to valid models.
This is still not working with Qucs-S
As you can see this HBT is a 5 terminal device and the symbol is 4 terminal in Qucs-S so the `t` terminal is floating.
```
.SUBCKT IHP_PDK_nonlinear_components_npn13G2 gnd c b e bn t Nx=1
.INCLUDE ../../.qucs/IHP-Open-PDK-main/ihp-sg13g2/libs.tech/ngspice/models/sg13g2_hbt_mod.lib
X1 c b e bn t npn13G2 Nx={Nx}
.ENDS
```

You could try to copy the `sg13g2_hbt_mod.lib` file from the #241 PR and place it in
` ../../.qucs/IHP-Open-PDK-main/ihp-sg13g2/libs.tech/ngspice/models/sg13g2_hbt_mod.lib`.  Then
use this netlist subckt to simulate

```
.SUBCKT IHP_PDK_nonlinear_components_npn13G2 gnd c b e bn  Nx=1
.INCLUDE ../../.qucs/IHP-Open-PDK-main/ihp-sg13g2/libs.tech/ngspice/models/sg13g2_hbt_mod.lib
X1 c b e bn  npn13G2 Nx={Nx}
.ENDS
```
Validate also if you have the recent version of the PDK.
Your symbol entry in `.qucs/user_lib/IHP_PDK_nonlinear_components.lib` should look like this:
```
<Component npn13G2>
  <Description>
Author: Mike Brinson, Feb 2024
mbrin72043@yahoo.co.uk, or m.brinson@londonmet.ac.uk.
  </Description>
  <Model>
.Def:IHP_PDK_nonlinear_components_npn13G2 c b e bn Nx="1"
.Def:End
  </Model>
  <Spice>*
.SUBCKT IHP_PDK_nonlinear_components_npn13G2  gnd c b e bn Nx=1
X1 c b e bn npn13G2 Nx={Nx}
.ENDS
  </Spice>
  <VerilogModel>  </VerilogModel>
  <VHDLModel>  </VHDLModel>
  <Symbol>
  <Line 0 20 0 30 #ff0000 4 1>
  <Line 0 -50 0 30 #ff0000 4 1>
  <Line 0 -20 -10 10 #ff0000 4 1>
  <Line -10 -20 0 40 #ff0000 4 1>
  <Line -10 10 10 10 #ff0000 4 1>
  <Line -10 0 -20 0 #ff0000 4 1>
  <Line 10 0 -10 0 #ff0000 4 1>
  <.PortSym 10 0 4 180>
  <Arrow -10 10 10 10 6 3 #ff0000 3 1 1>
  <.PortSym 0 50 3 0>
  <.PortSym -30 0 2 0>
  <.PortSym 0 -50 1 0>
  <.ID 10 64 npn13G2 "1=Nx=1">
  </Symbol>
</Component>

```

rupokdas147, 2024-11-01:
@KrzysztofHerman The Qucs-s working fine with Ngspice. I want to design Power Amplifier. So I need large signal analysis, which doesn't support by Ngspice. I will try the solution you given above and let you inform if the Xyce is working or not in the next comment.

KrzysztofHerman, 2024-11-01:
The issue we are trying to solve with PR #241 is exact binding between a device  symbol and model. The `*.cir` netlists  with examples for Xyce use 5 terminal HBT device. The PR introduces two version of each device `npn13G2`  and `npn13G2_5t` where the difference is the number of terminals (additional `t` output which is correlated with device temperature and self heating ).

KrzysztofHerman, 2024-11-01:
I have just added xyce support for 4 and 5 terminal devices, See last commit in PR #241.
There is a difference in VBIC model level ngspice supports level 9 and Xyce level 12. We still do not have a 5 terminal symbol for HBT's in Qucs-S

rupokdas147, 2024-11-02:
@KrzysztofHerman If I change "IHP_PDK_nonlinear_components_npn13G2" to "npn13G2" the netlist simulates from terminal using Xyce.

`* Qucs 24.3.0  /home/rf/QucsWorkspace/IHP-Open-PDK-SG13G2-Examples_prj/dc_hbt_13g2.sch

.SUBCKT IHP_PDK_nonlinear_components_npn13G2  gnd c b e bn t Nx=1
.INCLUDE   ../../.qucs/IHP-Open-PDK-main/ihp-sg13g2/libs.tech/ngspice/models/sg13g2_hbt_mod.lib
X1 c b e bn t  npn13G2 Nx={Nx}
.ENDS

.LIB /home/rf/IHP-Open-PDK/ihp-sg13g2/libs.tech/xyce/models/cornerHBT.lib hbt_typ
VPr1 _net0 _net1 DC 0
V2 _net0 0 DC 1
I1 0 _net2 DC 0

Xnpn13G2 0  _net1 _net2 0 gnd IHP_PDK_nonlinear_components_npn13G2 Nx=1
.dc v2 0 1.5 0.005
.step i1 0 5e-06 5.55556e-07
.PRINT  dc format=raw file=spice4qucs.dc._swp.plot I(VPr1)
.END
`

rupokdas147, 2024-11-02:
I don't know why Qucs-s adding the library name with the component name. I am actually a newbie in this sector. Removing the "IHP_PDK_nonlinear_components" from the above-highlighted line also helps to simulate the netlist in Ngspice. I have removed the exact phrase from a Ngspice generated Netlist and the netlist simulated in Ngspice smoothly.

KrzysztofHerman, 2024-11-04:
@rupokdas147 unfortunately this is the way you can define custom symbols in Qucs-S. You have to wrap it  using
subcircuit and additionally reference the spice library with the model of the device you use. In this particular case the device is `npn13G2`, the wrapper sub-circuit is `IHP_PDK_nonlinear_components_npn13G2` and finally the instance name is
`Xnpn13G2`. There is a discussion on [Qucs-S discussion space](https://github.com/ra3xdh/qucs_s/discussions/876) where we discuss enhancements of Qucs-S so maybe you could drop there your suggestions if you have any.

KrzysztofHerman, 2024-12-18:
@rupokdas147 please update the PDK  and run your testcase again.

rupokdas147, 2024-12-20:
@KrzysztofHerman Thanks Worked

Closed 2024-12-20.

Thread 250 (2024-10-31):

Missing Cont in IO cells

dnltz, 2024-10-31:
I have a design with IO ring and DRCs report `LU.d` and `LU.d1` violations. Both rules are defined as following:

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

As you can see in the next image, all violations are located in the IO cells itself. It looks like there is quite some `Cont` missing. (Image is showing the `LU.d` violations).

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

We taped-out these cells in May and used Cadence for Metal fill. We also had no `LU.d` violations in that tape-out. So, seems like Cadence is smart enough to fill the missing `Cont` filler.

However, I would propose to add the missing `Cont` to the IO cells directly. It's probably easier to just add it once instead of filling it in each design.

-----------

The following image is showing the `LU.d1` violations:

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

dnltz, 2024-10-31:
If someone could fill the sg13g2_io.gds file for me, I'm happy to try them!

sergeiandreyev, 2024-11-01:
@stafverhaegen-chipflow, could you please take a look?

stafverhaegen-chipflow, 2024-11-04:
@dnltz, I agree that it would be better to add contacts also in the corner cell of the IO ring. Reason it's not done is that my current layout generation code does handle the generation of the Activ to Metal1 contact array in this corner cell due to the 45 degree part of the taps. I will add it to my TODO list of improvements.
Unfortunately I need to sync this development with other development to not overwrite manual changes done to the gds and I am busy with an SRAM test chip for the Nov. tape-out. So unfortunately this change won't be ready for this month's tape-out.
Given the big width of the n-tap and p-tap in the corner cell and thus low(er) resistance and that no switching devices are present in the corner I think this error can be waived for the moment.

sergeiandreyev, 2024-11-05:
we have the IO Layouts with contacts in our internal OA database, we need to upload it to the GitHub repo
unfortunately, it takes more time than expected due to additional consistency checks that have to be run and various parallel activities

KrzysztofHerman, 2024-11-05:
@dnltz @stafverhaegen-chipflow @sergeiandreyev I have checked today all the IO cells running  DRC using klayout and `maximal` ruledeck. Below goes a list of cells which reported issues:
```
sg13g2_IOPadAnalog
sg13g2_IOPadIOVdd
sg13g2_IOPadIOVss
sg13g2_IOPadIn
sg13g2_IOPadInOut16mA
sg13g2_IOPadInOut30mA
sg13g2_IOPadInOut4mA
sg13g2_IOPadOut16mA
sg13g2_IOPadOut30mA
sg13g2_IOPadOut4mA
sg13g2_IOPadTriOut16mA
sg13g2_IOPadTriOut30mA
sg13g2_IOPadTriOut4mA
sg13g2_IOPadVss
sg13g2_IOPadVdd
```

Usually the cells report same issues seen on this screenshot:

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

It is kind of systematic error which should be easy to fix using the generation scripts.

dnltz, 2024-11-06:
> @dnltz, we have the IO Layouts with contacts in our internal OA database, we need to upload them to the GitHub repo unfortunately, it takes more time than expected due to additional consistency checks that have to be run and various parallel activities

Alright. Please let me know when you opened the PR and I can check them as well.

stafverhaegen-chipflow, 2024-11-06:
> It is kind of systematic error which should be easy to fix using the generation scripts.

Agreed, plan is to have layout DRC clean for maximal deck in next iteration. Unfortunately as said earlier won't be ready for tape-out of this month.

Closed 2025-04-09.

Thread 251 (2024-11-01):

Transmission Line is missing.

rupokdas147, 2024-11-01:
You mentioned that the PDK is specially made for RF designs. But there are no Transmission Line for both simulation and layout. How can I use transmission line when designing the circuit? Moreover there are Inductors in Layout only, no Inductor found for simulation.

KrzysztofHerman, 2024-11-04:
@rupokdas147 as you can see the current status of the PDK is `Preview`.  The things you are mentioning are on our TODO list so we will provide it next year. Nevertheless we are trying to support any external contributors willing to provide any solution aligned with our development plans so if you would like to develop some RF components, model it tapeout and measure feel free to do so.  We have `OpenMPW` shuttles where you could try out your ideas.

rupokdas147, 2024-11-06:
@KrzysztofHerman I will try to create spice model and layout for the devices. Could you provide me some necessary information about the fabrication process like Layer Stack information, Process Design Rules, EM simulation guidelines etc?

KrzysztofHerman, 2024-11-06:
@rupokdas147 the Process Specification and Design Rule Manual are already on github. You can find it here [process spec](https://github.com/IHP-GmbH/IHP-Open-PDK/blob/main/ihp-sg13g2/libs.doc/doc/SG13G2_os_process_spec.pdf) and [drm](https://github.com/IHP-GmbH/IHP-Open-PDK/blob/main/ihp-sg13g2/libs.doc/doc/SG13G2_os_layout_rules.pdf)
As for EM simulation the basic information can be found [here](https://github.com/IHP-GmbH/IHP-Open-PDK/tree/main/ihp-sg13g2/libs.tech/openems). I also recommend you to subscribe to the [ihp-sg13g2 Slack channel ](https://join.slack.com/share/enQtODAxMDc3NjE0MDI4OC1jY2JmNDg2NjViZGYyNjNkMGUwZjk3OTAyNjU2YjhkMTUyZmYyOTk0YmRhNDI4YTliZGM2YjdmODE2YWY4ZGM1)

rupokdas147, 2024-12-20:
@KrzysztofHerman Thanks Worked

Thread 254 (2024-11-07):

LVS unexpectedly failing

stafverhaegen-chipflow, 2024-11-07:
## Environment

## Expected Behavior

## Actual Behavior

## Steps to Reproduce the Problem

1.
2.
3.

stafverhaegen-chipflow, 2024-11-07:
Sorry, pressed wrong button.

stafverhaegen-chipflow, 2024-11-07:
Updated the problem description with test case.

KrzysztofHerman, 2024-11-07:
@stafverhaegen-chipflow @atorkmabrains @FaragElsayed2
I have just reproduced the testcase and indeed it fails in the command line but it seems to pass in the GUI
using the default settings:
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

The output contains some warnings:
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

The log view:
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

I have used `klayout 0.29.0` and `python 3.10.12`

sergeiandreyev, 2024-11-07:
shouldn't the batch-mode deck and GUI-mode deck behave the same? do they share the same implementation?

sergeiandreyev, 2024-11-07:
@KrzysztofHerman, could you please share here the error message from the batch mode LVS run?

KrzysztofHerman, 2024-11-07:
Here is the output from the command line run:
```
2024-11-07 13:37:44 +0100: Memory Usage (755784K) : ERROR : Netlists don't match
2024-11-07 13:37:44 +0100: Memory Usage (755784K) : xxxxxxxxxxxxxxxxxxxxxxxxxxxxxxxxxxxxxxxxxx
2024-11-07 13:37:44 +0100: Memory Usage (755784K) : LVS Total Run time 2.634887 seconds
07-Nov-2024 13:37:44 | INFO    | Total execution time 4.176420450210571s

***** C4M deck *****
LVS OK

```
GUI based run
```
2024-11-07 13:38:54 +0100: Memory Usage (1472000K) : ==========================================
2024-11-07 13:38:54 +0100: Memory Usage (1472000K) : INFO : Congratulations! Netlists match.
2024-11-07 13:38:54 +0100: Memory Usage (1472000K) : ==========================================
2024-11-07 13:38:54 +0100: Memory Usage (1472000K) : LVS Total Run time 3.395420 seconds

```

stafverhaegen-chipflow, 2024-11-07:
I tried again with main branch and now for me it does seem to match when running from command line in flat mode; e.g. add `--run_mode=flat`. Does it work from GUI in hierarchical mode ?

stafverhaegen-chipflow, 2024-11-07:
When I run the C4M deck also in deep mode it also fails. It thus seems that klayout has problems with this layout in deep mode. I don't see immediately something wrong with it.
I changed C4M deck to deep mode by chaging line `flat` to `deep` in file `c4m_klayout/share/C4M.IHPSG13G2.lvs` of test case.

sergeiandreyev, 2024-11-13:
Hi @stafverhaegen-chipflow, you have connectivity issues..
so if we say the layout is the reference, you should change the netlist from:
```
.subckt SP6TCArray_2X1 vss vdd1 vdd2 wl[0] wl[1] bl[0] bl_n[0]
Xinst0x0 wl[0] bl[0] bl_n[0] vdd1 vss SP6TCCell
Xinst1x0 wl[1] bl[0] bl_n[0] vdd2 vss SP6TCCell
.ends SP6TCArray_2X1
```
to
```
.subckt SP6TCArray_2X1 vss vdd1 vdd2 wl[0] wl[1] bl[0] bl_n[0]
Xinst0x0 wl[0] bl[0] bl_n[0] vdd2 vss SP6TCCell
Xinst1x0 wl[1] bl[0] bl_n[0] vdd1 vss SP6TCCell
.ends SP6TCArray_2X1
```

KLayout LVS should be clean (I would be very surprised if it will not be the case)
p.s. I checked on commercial tools

sergeiandreyev, 2024-11-13:
IMHO, from the KLayout LVS reports posted here it's nearly impossible to understand the issue root cause..

stafverhaegen-chipflow, 2024-11-14:
I was already checking with the change you proposed locally. It does not change anything. I made a new test case: [20241114_lvs_case.tar.gz](https://github.com/user-attachments/files/17747483/20241114_lvs_case.tar.gz)
Here the spice netlist was updated as you proposed, I updated the run.sh script so it runs both the IHP-Open-PDK LVS in flat and deep mode and also my generated deck. Both are OK in flat mode, both fail in deep mode. The output of the run is in the included run.log file. I'm not sure how I can make the test case more clear.

sergeiandreyev, 2024-11-14:
ok, I asked KLayout LVS deck developers to take a look on this

atorkmabrains, 2024-11-14:
@stafverhaegen-chipflow Just to confirm my understanding of the issue that you have, there is a test case that pass LVS if you run from GUI and fails if you run from command line.

- Case 1: Run GUI ----> Pass
- Case 2: Run cmd ---> Fail
- Case 3: Run cmd Flat ----> Pass
- Case 4: Run cmd Deep ---> Fail
- Case 5: Run GUI Deep ---> Fail

Could you please elaborate on what I  mentioned above? If there are more cases, could you please list them the same way I mentioned above. That would really help us review quickly the root cause.

atorkmabrains, 2024-11-14:
@stafverhaegen-chipflow

Fundamentally, it will fail if deep run and pass if it's flat regardless of the way of invocation. Is that correct?

atorkmabrains, 2024-11-14:
@stafverhaegen-chipflow

One last question, Did you run this test case on other tool (Commercial) and it passed?

sergeiandreyev, 2024-11-14:
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

@atorkmabrains, I ran it with commercial tools - there is indeed an LVS issue and I showed how to make it clean

stafverhaegen-chipflow, 2024-11-14:
> @stafverhaegen-chipflow
>
> Fundamentally, it will fail if deep run and pass if it's flat regardless of the way of invocation. Is that correct?

Indeed

atorkmabrains, 2024-11-14:
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

@sergeiandreyev I presume you ran it hierarchical in the commercial tool, correct? Did you use "Automatch" option in the commercial tool as well to see which exact cell needs changing?

I understand that you have provided a change required for the netlist, @stafverhaegen-chipflow Did you test that change and ran LVS in deep mode?

atorkmabrains, 2024-11-14:
@sergeiandreyev That's automatch switch.

sergeiandreyev, 2024-11-19:
Hi @stafverhaegen-chipflow, as I understand the issue is related to this one opened on KLayout:
https://github.com/KLayout/klayout/issues/1921

stafverhaegen-chipflow, 2024-11-26:
I doubt this is related to that issue. In that issue LVS has a problem due to ambiguity between different floating nets but our test case should not have ambiguity. Also in that issue the problem is with flat LVS and in out case the problem is with deep LVS.

stafverhaegen-chipflow, 2024-11-26:
It may be related to KLayout/klayout#1813 though. My thesis is that `extend("*")` is not doing what it is expecting to do for the given test case. Will look a little further now.

stafverhaegen-chipflow, 2024-11-27:
Created KLayout/klayout#1935 now with slightly adapted test case using global net and not `extend("*")`. I assume solution for that will also be applicable for the IHP LVS deck.

FaragElsayed2, 2024-12-18:
@sergeiandreyev @KrzysztofHerman

I’ve investigated the `RM_IHPSG13_1P_64x64_c2_bm_bist.gds` file using deep run mode, and here are my findings:

1. For the `RSC_IHPSG13_CDLYX1_DUMMY` cell, it uses the `lvsres` resistor, but its name does not match the one implemented in LVS.
   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

2. The `RSC_IHPSG13_WLDRVX8` cell has a similar issue where devices in its cells are not being extracted (likely due to a hierarchy problem). I believe this will be resolved in a flat mode run. Refer to #254.

3. Some cells exist in the CDL but are missing in the layout. I suspect these might exist at the top level in the layout, so this issue may also be resolved in a flat run.
   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

CC @atorkmabrains

Thread 262 (2024-11-13):

Misbehavior of BJTs npn13G2/npn13G2l/npn13G2v

EngGhaith, 2024-11-13:
Dear developers,
Dear community,

We have detected a kind of mistaken cross-talk between BJTs. You can find the whole description under this ngspice-forum issue on sourceforge:
https://sourceforge.net/p/ngspice/bugs/715/

Thank you in advance.
Best Wishes.
AL SABAGH Ghaith from IIC-JKU.

KrzysztofHerman, 2024-11-14:
Dear @EngGhaith thank you for providing your feedback

although this cross-talk we have not  observed yet we had some issues with the terminals of the devices, which were affecting ie. hierarchical design in xschem.  There is a PR https://github.com/IHP-GmbH/IHP-Open-PDK/pull/261 on our github which introduces changes in the HBT devices subcircuits and provides two variants of each HBT like shown below:

Device | 4 terminal subcircuit name | 5 terminal subcircuit name
---------- | ---------- | ------
npn13G2      | npn13G2       | npn13G2_5t
npn13G2l     | npn13G2l       | npn13G2l_5t
npn13G2v      | npn13G2v       | npn13G2v_5t

The changes were introduces in `sg13g2_hbt_mod.lib` file

If you reproduce the testcase using our update we would appreciate the results

EngGhaith, 2024-11-14:
[PA12BugReport_3.zip](https://github.com/user-attachments/files/17750549/PA12BugReport_3.zip)

I have tried the 4 terminal device and it shows the same behavior as before.
The 5 trminal device throws me subkt error.
But I am not sure if I checked out to the PR rightly. :)

Therefore I have uploaded the Xschem-Schematic-File in the zipped file. Could you please test it again to confirm the misbehavior?

Steps for 4-terminal device:
1- Simulate for first time within V3=0V8
2- See the results of .meas statement
3- Change V3 to V3=0V85
4- Resimulate
5- You will see that the current of the Transistor XQ1 has been changed, although you havent change its bias (VCC1 or VBB1)

And may you can check, if the 5-terminal device is really faulty.

Thank you very much.
AL SABAGH Ghaith from IIC-JKU.

KrzysztofHerman, 2024-11-15:
Dear @EngGhaith

I have just reproduced your testcase and got no cross-talks. In booth cases the value of `ic1` current is the same and does not depend on `V3` source value.

```
ic1                 =  3.255779e-04
ic2                 =  1.323070e-03

```

In order to checkout the PR of a given number PR like #261 go to the `$PDK_ROOT` and execute the following:

In a case you have cloned your own fork:
```
git fetch upstream pull/261/head
git checkout FETCH_HEAD
```
In a case you have just cloned our repository
```
git fetch origin pull/261/head
git checkout FETCH_HEAD
```
Good luck!

EngGhaith, 2024-11-18:
Dear @KrzysztofHerman
Thank you for your input.
I could bound the new symbols by manually copying subkts.
Now there is no interference between operation points at the steady-state.
I have used a test bench with .tran-simulation and observed the behaviour, that by stepping the base-voltage of XQ2/XQ4/XQ6 from 0V80 to 0V85 the current of XQ1/XQ3/XQ5 is mistakenly affected, but it will return to the its normal value at steady-stateafter the transition.
Could you please explain me this behavior?
Is it something normal or not?
What is the IHP-recommendation regarding how to tie thermal pin? should it be tied to GND? or what?
[PA12BugReport_PR261.zip](https://github.com/user-attachments/files/17802948/PA12BugReport_PR261.zip)

The testbench with screenshots are attached.
XQ1, XQ2 --> 4-terminal devices
XQ3, XQ4 --> 5-terminal devices with unconnected thermal pins. ==> they have same behavior as 4-terminal devices!
XQ5, XQ6 --> 5-terminal devices with GND-connected thermal pins.

EngGhaith, 2024-12-03:
Dear developers
@KrzysztofHerman
@sergeiandreyev
I have simulated a similar example in Xyce and the results were very healthy.
The simulated netlist are listed below:

`VCC1 net1 0 1.8
VBB1 net3 0 0.80
VBB2 net7 0 PULSE(0.8 0.85 500n 10p 10p 500n 1u 1)
XQ1 net5 net6 0 0 t npn13G2l Nx=1 El=1
VCC2 net2 0 1.8
Vic2 net2 net4 0
Vic1 net1 net5 0
Vib1 net3 net6 0
Vib2 net7 net8 0
VCC3 net9 0 1.8
VBB3 net10 0 0.80
Vic3 net9 net12 0
Vib3 net10 net11 0
VCC4 net13 0 1.8
Vic4 net13 net16 0
Vib4 net14 net15 0
XQ2 net4 net8 0 0 t npn13G2l Nx=1 El=1
XQ3 net12 net11 0 0 27.0000001 npn13G2l Nx=1 El=1
XQ4 net16 net15 0 0 27.0 npn13G2l Nx=1 El=1
VBB4 net14 0 PULSE(0.8 0.85 500n 10p 10p 500n 1u 1)
**** begin user architecture code
.tran 5f 550n 450n
.print tran format=raw file=PA12BugReport_PR261_v2_XYCE_dlatest.raw v(*) i(*)
.lib /foss/pdks/sg13g2/libs.tech/xyce/models/cornerHBT.lib hbt_typ`

XQ1 and XQ2 are 4-terminal symbols.
XQ3 and XQ4 are 5-terminal symbols.
I have adapted ALL transistors manually in the netlist to let the simulation work.
I have tied XQ3 to 27.0000001 and XQ4 to 27.0 to simulate both devices at the temperature 27. This walkaround was necessary, because if I tie both to 27, then they will be thermally coupled and XQ3 will have a mistaken change in operation point whithin the changing the op of XQ4.
If you simulate the circuit, then you will see that XQ1 and XQ2 are behavioring mistakenly. That is because both of them is tied to the node 't'=temperature.
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
In the plots you can see all details, which I have explained. Red are XQ3,XQ4 and Green are XQ1,XQ2.
The plot in net7 is showing the step of base Voltage of XQ2/XQ4.
**The only strange thing in the results is that the base currents have negative sign.**

I think you can compare the results in Ngspice and Xyce to analyze the misbehavior in Ngspice-models as described before.

Please adapt the library-files for Xyce to allow direct simulation in Xschem with Xyce using 4t/5t-symbols without changing netlists manually.

Thank you in advance.
AL SABAGH Ghaith from IIC-JKU.

KrzysztofHerman, 2024-12-03:
@EngGhaith thank you for the feedback. Yesterday I have pushed some changes in PR #283 where 5 terminal models for Xyce are introduced. You could check it and report how it perform.

EngGhaith, 2024-12-03:
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
Dear developers
@KrzysztofHerman
@sergeiandreyev

Results are OK.
I have these warnings from XYCE:

_***** Reading and parsing netlist...
Netlist warning in file
 /foss/pdks/sg13g2/libs.tech/xyce/models/sg13g2_hbt_mod.lib at or near line 282
 No model parameter VBE_MAX found for model NPN13G2L_NX_VBIC of type NPN,
 parameter ignored.
Netlist warning in file
 /foss/pdks/sg13g2/libs.tech/xyce/models/sg13g2_hbt_mod.lib at or near line 282
 No model parameter VBC_MAX found for model NPN13G2L_NX_VBIC of type NPN,
 parameter ignored.
Netlist warning in file
 /foss/pdks/sg13g2/libs.tech/xyce/models/sg13g2_hbt_mod.lib at or near line 282
 No model parameter VCE_MAX found for model NPN13G2L_NX_VBIC of type NPN,
 parameter ignored.
Netlist warning in file
 /foss/pdks/sg13g2/libs.tech/xyce/models/sg13g2_hbt_mod.lib at or near line 386
 No model parameter VBE_MAX found for model NPN13G2L_NX_VBIC of type NPN,
 parameter ignored.
Netlist warning in file
 /foss/pdks/sg13g2/libs.tech/xyce/models/sg13g2_hbt_mod.lib at or near line 386
 No model parameter VBC_MAX found for model NPN13G2L_NX_VBIC of type NPN,
 parameter ignored.
Netlist warning in file
 /foss/pdks/sg13g2/libs.tech/xyce/models/sg13g2_hbt_mod.lib at or near line 386
 No model parameter VCE_MAX found for model NPN13G2L_NX_VBIC of type NPN,
 parameter ignored.
***** Setting up topology..._

Some Remarks:
1. Why are base currents negative? wrong direction in model defined?
2. Could you please supply these models with warning messeges, when terminal voltage differences are exceeded (VBE is over 0V9, VCE is 0ver XV,...etc. as in Ng-Spice-Symbols in main branch)

Thank you in advance.
AL SABAGH Ghaith from IIC-JKU.

KrzysztofHerman, 2024-12-03:
@EngGhaith thank you for the feedback. We are considering adding warnings messages for our devices.

KrzysztofHerman, 2024-12-03:
Is there something more or we close the issue  ?

Closed 2024-12-03.

Thread 265 (2024-11-16):

Layout efficiency: Substrate tap, nwell tap, vias, improved MOSFET cells

hpretl, 2024-11-16:
Maybe I just don't know how to do it properly, but it looks like a few fundamental thing are still missing from the KLayout setup:

* Via generator (with selectable start and end layers, and number of X/Y multiples)
* Substrate contact (maybe merge into via generator); ideal would be the possibility to make a substrate contact as a path
* Option to NMOS pcell to add a guardings
* Nwell contact (maybe merge into via generator); ideal would be the possibility to make an nwell contact as a path
* Option to PMOS pcell to add a guardings

In addition, it would be good have the option in the MOSFET pcells to have the gates connected.

KrzysztofHerman, 2024-11-18:
@hpretl thank you for your comment.

there is ongoing discussion of the via should be generated natively by the tool, Klayout in this case, or as a separate PyCell. Do you have any opinion on that ?

Substrate/Nwell contacts are among the devices that are planned to be delivered soon.

I have develop a  guard ring PyCell and I can share the code.  The feature to have it as a mosfet PyCell option we have to discuss internally.

hpretl, 2024-11-18:
> there is ongoing discussion of the via should be generated natively by the tool, Klayout in this case, or as a separate PyCell. Do you have any opinion on that ?

As a via/viastack is a fundamental component of any PDK, a KLayout implementation would definitely make sense. But given the current state where custom layout in KLayout is really cumbersome due to lack of vias any solution in a reasonable timeline would help. 😀

hpretl, 2024-11-18:
@KrzysztofHerman One more argument for having vias inside KLayout: Eventually I would like to have a path function where I can change layers while routing. For this functionality, we need vias, and probably everything is easier if vias are a native functionality of KLayout.

sergeiandreyev, 2024-11-18:
ok, will do

sergeiandreyev, 2024-11-19:
FYI, https://github.com/KLayout/klayout/issues/1931

sergeiandreyev, 2024-11-19:
> But given the current state where custom layout in KLayout is really cumbersome due to lack of vias any solution in a reasonable timeline would help.

@hpretl, maybe for the time being you can use the `via` Pycell (`via_stack`) from the old version of IHP OpenPDK as a temporary workaround:
```
> git checkout 8dbe642b8c0512d3c6b52feee1e3beac837b191e
```

Thread 267 (2024-11-16):

Primitive device: PNP/NPN (vertical oder lateral) for CMOS-only

hpretl, 2024-11-16:
For CMOS-only designs, an NPN or PNP (either lateral or vertical) would be needed for bandgaps and similar uses.

hpretl, 2024-11-17:
Thanks for the pointer, you are absolutely right! I totally missed it because there is no pcell in KLayout (at least none that I can find) and no mention in the process description, but there is a model and symbol for simulation and a fixed layout in `sg13g2_pr.gds`.

@KrzysztofHerman @sergeiandreyev Are there plans to provide a pcell, or is there one fixed size of PNP with a fixed layout (which is quite the norm for parasitic PNPs)? In any case, a description in the `SG13G2_process_spec.pdf` would be great!

hpretl, 2024-11-18:
@sergeiandreyev cool! Do you have a rough timeline for the remaining cells?

sergeiandreyev, 2024-11-18:
unfortunately, we don't have dedicated resources for this task, so the timeline is rather hard to define..
I agree, it will be useful for tracking, so I will create a separate GitHub 'enhancement' issue for new devices

sergeiandreyev, 2024-11-18:
> In any case, a description in the `SG13G2_process_spec.pdf` would be great!

after checking this internally, the feedback is that we have a **new** `pnpMPA` device implementation in progress, so the process spec is planned to be updated with this **new** device

hpretl, 2024-11-18:
> after checking this internally, the feedback is that we have a new pnpMPA device implementation in progress, so the process spec is planned to be updated with this new device

Excellent, good to hear! @sergeiandreyev Do you have a timeline for the bundle (doc, model, pcell)?

sergeiandreyev, 2024-11-18:
> Do you have a timeline for the bundle (doc, model, pcell)?

around 6 month..

olisnr, 2024-11-24:
because You allready give us the measurements of different pnpMPAs, it would be nice, You also give the test-chip-layouts as` .gds` with it. then the need for a PCell is much smaller.
at the moment there is only the 1u/2u variant aviablle from the `ihp-sg13g2/libs.ref/sg13g2_pr/gds/sg13g2_pr.gds`

olisnr, 2024-11-24:
im also interested in the SVaricap. is there more information about what it can and how to use?

RTimothyEdwards, 2024-12-07:
@sergeiandreyev :  I have a follow-up question about the pnpMPA device.  Looking at the GDS of the device in the `sg13g2_pr` GDS (because there is no klayout pycell for it), there is nothing that uniquely identifies this device as a bipolar, which makes it impossible to uniquely identify the structure as a bipolar transistor for the purpose of netlist extraction.  The simple expedient of allowing the bipolar ID layer (TRANS.drawing) to cover the device would allow it to be extracted.  The PNP device would be differentiated from the SiGe devices by recognizing that the TRANS layer does not contain any emitter window.  Of course, since this would be a non-mask layer, you could just define any arbitrary unused layer type for a PNP device recognition layer.

Thread 268 (2024-11-18):

`M1.b` violation when `dllr_1` is abutted with other cells

sergeiandreyev, 2024-11-18:
## Environment
OS: Ubuntu 22.04
KLayout: 0.29.8

## Expected Behavior
Clean DRC

## Actual Behavior
`M1.b` violations

## Steps to Reproduce the Problem

1. Run KLayout minimal DRC deck on the attached test GDS file (stdcells assembly)
[test_lib.zip](https://github.com/user-attachments/files/17802072/test_lib.zip)
2. Check 16 violations for the `dllr_1` cell
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

Closed 2024-11-28.

Thread 271 (2024-11-20):

LVS error after script Fill

joerdsonsilva, 2024-11-20:
## Environment
OS/Platform: linux
Klayout 0.29.7
NGSpice 43

## Expected Behavior
LVS clean after applying Fill to the design.

## Actual Behavior
When applying Fill to the design, the LVS presents an error. But the design without applying Fill does not present an error in the LVS.

## Steps to Reproduce the Problem

1. Open gds file with Fill in klayout
2. Run klayout LVS with cdl file
3. After simulation, the error will be displayed
4. To compare the results, you can repeat the steps with the NoFill file and observe the clean LVS.

[fill.zip](https://github.com/user-attachments/files/17826376/fill.zip)
[nofill.zip](https://github.com/user-attachments/files/17826377/nofill.zip)

olisnr, 2024-11-24:
@joerdsonsilva looks nice, what is the reason to change the layer all 100µm?

joerdsonsilva, 2024-11-24:
Please provide more details about your question. Did you check this error in the LVS of the file with fill?

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

olisnr, 2024-11-25:
it was only a question, because i dont see the reason to switch from layer M2 to M3 and back. may be its about thermal stress or so...

i dont see the reason for LVS problem. it seems that Your filling pattern are recognized as NFETs and all the bodies are connected to BN. but why i dont know.

the only things i saw is, the PADs shouldnt have a TopVia2...

joerdsonsilva, 2024-11-25:
Got it, different layers of metal were used to avoid possible antenna effects. Just a precaution.

Without Fill, this error does not generate in LVS, so it must be something in how the fill is recognized.

olisnr, 2024-11-25:
@joerdsonsilva its funny, if You delete the seal-ring and all the PADs, You get much fewer errors. may be You have also to connect all the BN with metal. i try this also

olisnr, 2024-11-25:
but now there are BNs missing in the normal NFETs:

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

KrzysztofHerman, 2024-11-27:
@atorkmabrains @FaragElsayed2 could you please take a look and evaluate the possibility to exclude `GatePoly.filler` over `Active.filler` from a recognition as a mos device. I have tested it and it is the root cause why LVS reports mismatch.

FaragElsayed2, 2024-11-27:
@KrzysztofHerman
As suggested by @atorkmabrains, dummy transistors that are not connected to Metal1 have been excluded from LVS.

KrzysztofHerman, 2024-11-27:
Thank you @FaragElsayed2. After your changes I have clean LVS. @joerdsonsilva can you check it on your setup ? If it works for you also we can merge and close.

atorkmabrains, 2024-11-27:
@KrzysztofHerman BTW, this use case is very unique and @FaragElsayed2 has taken the best clean approach to make sure that we are not taking dummy transistors into account.

joerdsonsilva, 2024-11-27:
> @joerdsonsilvaem relação ao efeito da antena. não seria melhor ir do gate direto para M2 e depois voltar para M1?

Yes, it is a valid approach.

joerdsonsilva, 2024-11-27:
> Thank you @FaragElsayed2. After your changes I have clean LVS. @joerdsonsilva can you check it on your setup ? If it works for you also we can merge and close.

Yes, I have a clean LVS after the changes.

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

Closed 2024-11-27.

Thread 272 (2024-11-22):

Cut&Paste error in statistical parameter file

dwarning, 2024-11-22:
Looking into file IHP-Open-PDK/ihp-sg13g2/libs.tech/ngspice/models/cornerMOSlv.lib we see in typical (tt) section (abbreviated for better readability):
`
LIB mos_tt
 param sg13g2_lv_nmos_vfbo_mm= 1.0
 param sg13g2_lv_nmos_ctl    = 1.2080
 param sg13g2_lv_nmos_rsw1   = 0.7200
 param sg13g2_lv_nmos_muew   = 0.8500
 param sg13g2_lv_nmos_dphibo = 0.9915
 param sg13g2_lv_nmos_dphibl = 0.9693

 param sg13g2_lv_pmos_vfbo_mm= 1.0
 param sg13g2_lv_pmos_ctl    = 1.9570
 param sg13g2_lv_pmos_rsw1   = 0.7720
 param sg13g2_lv_pmos_muew   = 1.0520
 param sg13g2_lv_pmos_dphibo = 0.9050
 param sg13g2_lv_pmos_dphibl = 0.8550

 include sg13g2_moslv_mod.lib
ENDL mos_tt`

So we see that we have different parameters (act as factor) for nmos and pmos.
Next section is for statistical simulation in typical corner:
`
LIB mos_tt_stat
 param sg13g2_lv_nmos_vfbo_mm_norm= 1.0
 param sg13g2_lv_nmos_ctl_norm    = 1.2080
 param sg13g2_lv_nmos_rsw1_norm   = 0.7200
 param sg13g2_lv_nmos_muew_norm   = 0.8500
 param sg13g2_lv_nmos_dphibo_norm = 0.9915
 param sg13g2_lv_nmos_dphibl_norm = 0.9693

 param sg13g2_lv_pmos_vfbo_mm_norm= 1.0
 param sg13g2_lv_pmos_ctl_norm    = 1.2080
 param sg13g2_lv_pmos_rsw1_norm   = 0.7200
 param sg13g2_lv_pmos_muew_norm   = 0.8500
 param sg13g2_lv_pmos_dphibo_norm = 0.9915
 param sg13g2_lv_pmos_dphibl_norm = 0.9693

 include sg13g2_moslv_stat.lib
 include sg13g2_moslv_mod.lib
ENDL mos_tt_stat`

The problem is that the nmos parameter are taken over from tt section into the stat section - but pmos not. They are a simple copy of the nmos parameter. Looks like a cut and paste error and follows in wrong results for tt_stat pmos simulations.

Other sections in lv and hv Corner lib have not this bug.

BTW - I see no need to create additional parameter for statistical simulation with _norm in the end of name. Just using the tt, ff, ss parameter is sufficient.

@miesli : In case you are still there, can you comment please.

dwarning, 2024-11-23:
Another case of Cut&Paste in sg13g2_moslv_stat.lib (abbreviated):

param sg13g2_lv_nmos_vfbo_mm  ='gauss(sg13g2_lv_nmos_vfbo_mm_norm , 0.004, mc_ok)'
param sg13g2_lv_nmos_toxo     ='gauss(sg13g2_lv_nmos_toxo_norm,     0.0133, mc_ok)'
param sg13g2_lv_nmos_dphibo   ='gauss(sg13g2_lv_nmos_dphibo_norm,   0.0656, mc_ok)'
param sg13g2_lv_nmos_dphibl   ='gauss(sg13g2_lv_nmos_dphibl_norm,   0.1135, mc_ok)'
param sg13g2_lv_nmos_dphibw   ='gauss(sg13g2_lv_nmos_dphibw_norm,   0.1197, mc_ok)'
param sg13g2_lv_nmos_dphiblw  ='gauss(sg13g2_lv_nmos_dphiblw_norm,  0.0135, mc_ok)'
param sg13g2_lv_nmos_toxovo   ='gauss(sg13g2_lv_nmos_toxovo_norm,   0.0133, mc_ok)'

param sg13g2_lv_pmos_vfbo_mm  ='gauss(sg13g2_lv_pmos_vfbo_mm_norm,  0.004, mc_ok)'
param sg13g2_lv_pmos_toxo     ='gauss(sg13g2_lv_pmos_toxo_norm,     0.0133, mc_ok)'
param sg13g2_lv_pmos_dphibo   ='gauss(sg13g2_lv_pmos_dphibo_norm,   0.0656, mc_ok)'
param sg13g2_lv_pmos_dphibl   ='gauss(sg13g2_lv_pmos_dphibl_norm,   0.1135, mc_ok)'
param sg13g2_lv_pmos_dphibw   ='gauss(sg13g2_lv_pmos_dphibw_norm,   0.1197, mc_ok)'
param sg13g2_lv_pmos_dphiblw  ='gauss(sg13g2_lv_pmos_dphiblw_norm,  0.0135, mc_ok)'
param sg13g2_lv_pmos_toxovo   ='gauss(sg13g2_lv_pmos_toxovo_norm,   0.0133, mc_ok)'

It's unbelievable that the variations of lv nmos and pmos are identical. hv nmos statistical is not affected.

metroid120, 2024-11-24:
Hi Dietmar, you are right in both cases this is very likely a bug. In the closed PDK the pmos parameters are different. Our bad...
It is a long time ago that we did this and I have no memory what could have happened. Anyhow.

1) Here would be the correct values for the file ""cornerMOSlv.lib" (starting line 137):
 ```
 .param sg13g2_lv_pmos_vfbo_mm_norm= 1.0
  .param sg13g2_lv_pmos_ctl_norm    = 1.9570
  .param sg13g2_lv_pmos_rsw1_norm   = 0.7720
  .param sg13g2_lv_pmos_muew_norm   = 1.0520
  .param sg13g2_lv_pmos_dphibo_norm = 0.9050
  .param sg13g2_lv_pmos_dphibl_norm = 0.8550
  .param sg13g2_lv_pmos_dphibw_norm = -1.5800
  .param sg13g2_lv_pmos_dphiblw_norm= 1.0000
  .param sg13g2_lv_pmos_themuo_norm = 0.9580
  .param sg13g2_lv_pmos_thesatl_norm= 0.5510
  .param sg13g2_lv_pmos_thesatw_norm= 1.0800
  .param sg13g2_lv_pmos_thesatlw_norm= 1.0000
  .param sg13g2_lv_pmos_toxo_norm   = 1.0000
  .param sg13g2_lv_pmos_toxovo_norm = 1.0000
  .param sg13g2_lv_pmos_cjorbot_norm= 1.0000
  .param sg13g2_lv_pmos_cjorsti_norm= 1.0000
  .param sg13g2_lv_pmos_cjorgat_norm= 1.0000
```
2) For file sg13g2_moslv_stat.lib (starting line 38):

```
.param sg13g2_lv_pmos_vfbo_mm  ='gauss(sg13g2_lv_pmos_vfbo_mm_norm,  0.004, mc_ok)'
.param sg13g2_lv_pmos_toxo     ='gauss(sg13g2_lv_pmos_toxo_norm,     0.0133, mc_ok)'
.param sg13g2_lv_pmos_dphibo   ='gauss(sg13g2_lv_pmos_dphibo_norm,   0.1078, mc_ok)'
.param sg13g2_lv_pmos_dphibl   ='gauss(sg13g2_lv_pmos_dphibl_norm,   0.1412, mc_ok)'
.param sg13g2_lv_pmos_dphibw   ='gauss(sg13g2_lv_pmos_dphibw_norm,   1.4858, mc_ok)'
.param sg13g2_lv_pmos_dphiblw  ='gauss(sg13g2_lv_pmos_dphiblw_norm,  1e-9, mc_ok)'
.param sg13g2_lv_pmos_toxovo   ='gauss(sg13g2_lv_pmos_toxovo_norm,   0.0133, mc_ok)'
.param sg13g2_lv_pmos_ctl      ='gauss(sg13g2_lv_pmos_ctl_norm,      0.1880, mc_ok)'
.param sg13g2_lv_pmos_muew     ='gauss(sg13g2_lv_pmos_muew_norm,     0.0235, mc_ok)'
.param sg13g2_lv_pmos_themuo   ='gauss(sg13g2_lv_pmos_themuo_norm,   0.0247, mc_ok)'
.param sg13g2_lv_pmos_rsw1     ='gauss(sg13g2_lv_pmos_rsw1_norm,     0.0727, mc_ok)'
.param sg13g2_lv_pmos_thesatl  ='gauss(sg13g2_lv_pmos_thesatl_norm,  0.1718, mc_ok)'
.param sg13g2_lv_pmos_thesatw  ='gauss(sg13g2_lv_pmos_thesatw_norm,  0.0427, mc_ok)'
.param sg13g2_lv_pmos_thesatlw ='gauss(sg13g2_lv_pmos_thesatlw_norm, 0.1667, mc_ok)'
.param sg13g2_lv_pmos_cjorbot  ='gauss(sg13g2_lv_pmos_cjorbot_norm,  0.0267, mc_ok)'
.param sg13g2_lv_pmos_cjorsti  ='gauss(sg13g2_lv_pmos_cjorsti_norm,  0.0267, mc_ok)'
.param sg13g2_lv_pmos_cjorgat  ='gauss(sg13g2_lv_pmos_cjorgat_norm,  0.0267, mc_ok)'
```

 **_Please double check these values and let me know if you agree._**

dwarning, 2024-11-25:
Hi Markus,
yes I so I made it in my PR yesterday.
Few parameters looking strange (e.g. dphibw), I will check it.
Thanks for taking care,
Dietmar

KrzysztofHerman, 2024-12-18:
Changes in #269

KrzysztofHerman, 2025-03-27:
Closed as solved in #269

Closed 2025-03-27.

Thread 275 (2024-11-25):

[DRC] Violating M2.b is sometimes not detected

hpretl, 2024-11-25:
We are currently working towards a tapeout, and had a situation where the DRC fail below has not been detected by the current KLayout DRC rules. `M2.b` is clearly violated.

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

hpretl, 2024-11-25:
@akrinke Can you please take a look?

sergeiandreyev, 2024-11-25:
Hi @hpretl, I have it flagged by the `minimal` rule deck:
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
Could you please attach your testcase?

hpretl, 2024-11-25:
@sergeiandreyev Here is the M2 layer of the chip. Maybe we used an outdated DRC runset? Let's see if the error is flagged on your end.

[tc_m2_fail.oas.gz](https://github.com/user-attachments/files/17909010/tc_m2_fail.oas.gz)

sergeiandreyev, 2024-11-25:
yep, it is found:
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
I'm using latest deck from `dev` branch:
https://github.com/IHP-GmbH/IHP-Open-PDK/blob/dev/ihp-sg13g2/libs.tech/klayout/tech/drc/sg13g2_minimal.lydrc

hpretl, 2024-11-25:
@sergeiandreyev Thanks for checking! We need to find out why we missed the fail. I propose to close this issue.

Closed 2024-11-25.

Thread 276 (2024-11-26):

m parameter for BJT models and Xschem-symbols

olisnr, 2024-11-26:
if i look at the `ihp-sg13g2/libs.tech/xschem/sg13g2_pr/npn13G2.sym` it has the parameters:
`format="@spiceprefix@name @pinlist @model Nx=@Nx"
`

shouldnt be Nx the analog of W in the MOS-models? and m the factor for arrays of BJT?
in the MOS models there is `w, l, ng, m`, shouldnt in the npn13G2 be `nx, m`? and maybe also `t`?

in ihp-sg13g2/libs.tech/xyce/models/sg13g2_moshv_mod.lib there is the **.subckt npn13G2**
```
.subckt npn13G2 c b e bn
.param Nx=1 dtemp=0
+Ny=1 le=0.96e-6 we=0.12e-6
+El=le*1e6
+selft=1

*Yvbic13_4t_va vbic1 c b e s1 npn13G2_NX_vbic
Qnpn13G2 c b e s1 t npn13G2_NX_vbic dtemp=dtemp m=1
```
it sets m=1 why?

i also think, its a bit sad, that the pnpMPA hasnt an m-parameter. thats the part that is normally used as m=1 and m=9 or the like.

would it be possible to add the m? (and t)  parameters to the models and symbols like in the MOS-devices?

KrzysztofHerman, 2024-11-26:
@olisnr

The `Nx` parameter is a number of emitters of the HBT device.

The `m` parameter is pretty generic in spice and it has a meaning of number of instances in parallel.
It could be useful for automatic layout generation, however causes problems in simulations like MC,
where you would like to estimate circuit behavior while varying parameters of the instances.

in the [ngspice manual](https://ngspice.sourceforge.io/docs/ngspice-html-manual/manual.xhtml#magicparlabel-8775) you can find respective BJT device instantiation scheme where the `m` parameter is present but not commented.
```
QXXXXXXX nc nb ne <ns> <tj> mname <area=val> <areac=val>
+ <areab=val> <m=val> <off> <ic=vbe,vce> <temp=val>
+ <dtemp=val>
```
It is curious because SPICE reference from [Berkeley](https://web.archive.org/web/20231004065459/http://bwrcs.eecs.berkeley.edu/Classes/IcBook/SPICE/UserGuide/elements_fr.html)  does not mention it.
```
 General form:
    QXXXXXXX NC NB NE <NS> MNAME <AREA> <OFF> <IC=VBE, VCE> <TEMP=T>
```
Also if you take a look at the Xyce Reference Guide 7.6 in the section 2.3.17 you will not find anything related to the `m` parameter

As for `t` it is not a parameter but an additional  temperature related output. We have already provided spice models for 4 and 5 terminal devices for ngspice to have the consistency between symbols and models and a correct recognition of the terminals by the simulator. The same should be applied to the xyce HBT models

olisnr, 2024-11-26:
yes the m is very interesting for things like bandgap references and current-mirrors.

in the Xyce Reference Guide 7.7 there a BJT models with m:
Table 2-66. Bipolar Junction Transistor Device Instance Parameter - page 246
Table 2-80. MEXTRAM 504.12.1 Device Model Parameters - page 273

In the version 7.8 there of the Xyce Users Guide there is written:
```
5.4.
Subcircuit Multiplier M
Similar to many device models, subcircuits support a scalar multiplier, M on the instance line. The usage
syntax is similar to that of subcircuit parameters, except that it is implicitly applied to all devices (see
table 4-3) in the subcircuit instance which support multipliers. If the devices in a subcircuit already have
multiplier parameters specified, the value is multiplied by the subcircuit instance value. This is applied
recursively for nested subcircuits.
```

thus i would think, that the m-parameter should be possible for all BJTs

what do You think?

olisnr, 2024-11-26:
i mean a schematics like this shouldent be necessary :)
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

KrzysztofHerman, 2024-11-27:
@olisnr it seems that the `m` parameter is supported by many devices and maybe this is the reason it is skipped as a default parameter. As for the feature of exposing it to the user I can see the advantage of  schematic readability (although maybe it is better to see these 20 BJT's).

sergeiandreyev, 2024-11-27:
Hi @olisnr, regarding this
> i also think, its a bit sad, that the pnpMPA hasnt an m-parameter.
would it be possible to add the m? (and t) parameters to the models and symbols like in the MOS-devices?

we're now in progress to implement a new `pnpMPA` device, so that all the device data is expected to be updated before integration into PDK. We can prioritize the question on the multiplier parameter

sergeiandreyev, 2024-11-27:
> what do You think, could we expose m in npn13g2, npn13g2l, npn13g2v & pnpMPA? i think i can do it my self an make a pull-request, if its interesting.

we should have consistency where possible between the OpenPDK and proprietary one, this kind of change we have to discuss first internally.. I'll update you on the results

Thread 280 (2024-11-27):

[qucs-s] additional parameters for primitive devices and callbacks support

sergeiandreyev, 2024-11-27:
## Environment
OS: Ubuntu 22.04
Qucs-s 24.3.1

## Expected Behavior
Primitive library devices have visible parameters that are updated in real-time (using callbacks) based on `w/l/other?` input settings

## Actual Behavior
`rfcmim` and `res` devices do not have `capacitance` nor `resistance` parameters, only `w/l`

Ikram-rs22, 2024-12-24:
How to calculate the values of resistance and capacitance from w & l? As far as I know, the sheet resistance of rppd is given between 235-285. Then how would yoi know the actual resistance of rppd? Same with cap_rfcmim.

sergeiandreyev, 2025-01-02:
Hi @Ikram-rs22, you can check the formulae to calculate resistance for `rppd` device in the TCL code of xschem symbol:
https://github.com/IHP-GmbH/IHP-Open-PDK/blob/dev/ihp-sg13g2/libs.tech/xschem/sg13g2_pr/rppd.sym
The same for `rfcmim` - these should be a part of device callback code.

Thread 284 (2024-12-02):

LVS problem with npnMPA

olisnr, 2024-12-02:
## Environment
dev & main branch LVS scripts KLayout 0.29.8 linuX

## Expected Behavior
LVS should match

## Actual Behavior
it dosnt

## Steps to Reproduce the Problem

1. open GDS
2. select CLD
3. run LVS

[npnMPAlvs.zip](https://github.com/user-attachments/files/17976345/npnMPAlvs.zip)

KrzysztofHerman, 2024-12-18:
Part of the discussion was made in #285

Thread 285 (2024-12-02):

LVS seems to have problems to recognize RPPD in .GDS

olisnr, 2024-12-02:
Environment
dev & main branch LVS scripts KLayout 0.29.8 linuX

Expected Behavior
LVS should see 5 RPPDs

Actual Behavior
it sees only 3

Steps to Reproduce the Problem
open GDS
select CDL
run LVS

[lvs_rppd.zip](https://github.com/user-attachments/files/17976498/lvs_rppd.zip)

sergeiandreyev, 2024-12-09:
Hi @olisnr, thank you for finding and reporting!
Are you running KLayout LVS in GUI or in batch mode?
When I'm using GUI I have the following error:
```
ERROR: In /home/andreev/opensource/IHP-Open-PDK/ihp-sg13g2/libs.tech/klayout/tech/macros/sg13g2_lvs.lylvs: Can't find a schematic counterpart for the top cell shunt_3V1 - use 'same_circuit' to establish a correspondence
ERROR: :/built-in-macros/_lvs_netter.rb:302: RuntimeError: Can't find a schematic counterpart for the top cell shunt_3V1 - use 'same_circuit' to establish a correspondence in Executable::execute
  :/built-in-macros/_lvs_netter.rb:302:in `align'
  (eval):2:in `align'
  /home/andreev/opensource/IHP-Open-PDK/ihp-sg13g2/libs.tech/klayout/tech/macros/../lvs/sg13g2.lvs:348:in `execute'
  :/built-in-macros/lvs_interpreters.lym:31:in `instance_eval'
  :/built-in-macros/lvs_interpreters.lym:31:in `execute'
  ```
  Is it the same error that you find on your side?

sergeiandreyev, 2024-12-09:
Hi @atorkmabrains, @FaragElsayed2, could you please take a look at this issue?

FaragElsayed2, 2024-12-10:
@sergeiandreyev

For this error
```
ERROR: In /home/andreev/opensource/IHP-Open-PDK/ihp-sg13g2/libs.tech/klayout/tech/macros/sg13g2_lvs.lylvs: Can't find a schematic counterpart for the top cell shunt_3V1 - use 'same_circuit' to establish a correspondence
```

The issue arises because the top subcircuit name in the netlist doesn't match the layout name. You can either rename the netlist's top cell from `shunt_3V1_min` to `shunt_3V1`, or set `shunt_3V1_min` as the Top Cell when running the LVS.

@olisnr

The other resistors are not being recognized because they are connected using the GatePoly layer instead of Metal1. This alters the resistor structure, preventing it from being extracted as expected. I’ve updated the resistor extractor to use edges as ports rather than the full GatePoly port to accommodate such cases.

sergeiandreyev, 2024-12-10:
@olisnr, no, what is not matching in `pnpMPA`?

olisnr, 2024-12-10:
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

and also if i delete all the other things:
[lvs_pnpMPA.zip](https://github.com/user-attachments/files/18081185/lvs_pnpMPA.zip)

FaragElsayed2, 2024-12-10:
@olisnr Please check here for pnpMPA supported parameters
https://ihp-open-pdk-docs.readthedocs.io/en/latest/verification/lvs/04_03_bjt.html#pnpmpa

You need to update your cdl

```
Q3 VSS VSS net4 pnpMPA A=1.4p P=5.4u NE=1 M=1
```

sergeiandreyev, 2024-12-10:
but from KLayout is extracted like this:
```
.SUBCKT shunt_3V1 VSS
Q$1 VSS VSS \$10 pnpMPA AE=1.4p PE=5.4u AB=7.194p PB=10.96u AC=7.194p PC=10.96u
+ NE=1 m=1
.ENDS shunt_3V1
```

FaragElsayed2, 2024-12-10:
@sergeiandreyev

We customized the supported classes in KLayout to map the parameters used (which are identical to parameters used in the commercial CDF) to their corresponding internal ones.

Explained in docs
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

sergeiandreyev, 2024-12-11:
@olisnr, how did you generate the CDL netlist? there were updates for the `pnpMPA` xschem symbol recently, so it has area and perimeter extracted:
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

olisnr, 2024-12-11:
@sergeiandreyev i used:
```
tclcommand="
	xschem set netlist_type spice
	set lvs_ignore 1
	set lvs_netlist 1
	set spiceprefix 0
	set last_local_netlist_dir $local_netlist_dir
	set local_netlist_dir 0
	xschem netlist [xschem get current_name].cdl
	set local_netlist_dir $last_local_netlist_dir
"
```
from a launcher:
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

it produces:
`Q3 VSS VSS net4 pnpMPA a={ 1.0u * 2.0u } p={ ( 1.0u + 2.0u ) * 2 }`

i hope i didnt missed a file:
[shunt.zip](https://github.com/user-attachments/files/18094874/shunt.zip)

olisnr, 2024-12-11:
why arent the connections of the pnpMPA cell PLUS, MINUS & TIE instead of E B C?

KrzysztofHerman, 2024-12-18:
@olisnr since the 1RPPD1 problem is fixed we will close this issue. The discussion about `pnpMPA` will be continued in #284

Closed 2024-12-18.

Thread 289 (2024-12-04):

PCELL npn13G2 makes Min. nSD:block space to Cont (Note 2) = 0.00

olisnr, 2024-12-04:
## Environment
KLayout .29.8 mint/ubuntu 22.04 dev and main branch

## Expected Behavior
the PCELL npn13G2 should pass the DRC maximal script

## Actual Behavior
it produces
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

## Steps to Reproduce the Problem

1. make a npn13G2 from the PDK via instantiate npn13G_base the npn13G2
2. updte nx of the npn13G2
3. delete npn13G_base
4. run the maximum DRC script

the nx=1 cell from` ihp-sg13g2/libs.ref/sg13g2_pr/gds/sg13g2_pr.gds` dont produces errors

sergeiandreyev, 2024-12-04:
Hi @olisnr, I guess this issue is related to how the DRC deck processes the hierarchy.
If you flatten the Pycell (Edit->Selection->Flatten Instances), you can see that the error is gone.. The `npn13g2` in `sg13g2_pr` GDS is flattened this is why it's clean (and, btw, the lower Metal1 drawing and pin layers are not aligned - we should fix this)
@akrinke, could you please take a look?

akrinke, 2024-12-04:
This is strange behavior. It seems I have a problem with my OpenPDK installation. Most of the time, I get the following error:
```
Warning: Dlo.exists: cell 'npn13G2_base' don't exists in library 'SG13_dev'!
(OA) Design "SG13_dev/npn13G2_base/layout" was not found
```
In my case, `nSDB.e` errors occur for both, the hierarchical and the flattened PyCell. It seems to be caused by a missing label `E` on the emitter Metal2 pin. Can you check if the label exists  in your tests?

olisnr, 2024-12-06:
@sergeiandreyev flatten dont works for me. the errors stay

sergeiandreyev, 2024-12-06:
yes, confirm, I've overlooked it 🤦‍♂️
I'm now checking on internal PDK if I have the same issue..

sergeiandreyev, 2024-12-06:
in commercial PDK the ref device layout is clean, it could be that we have some type of exceptions for these devices (I'm checking w/ the experts), also I'll double check with the layout from the open source

sergeiandreyev, 2024-12-06:
found strange behavior in KLayout - when I'm running DRC on the `npn13G2` from the `sg13g2_pr` library it's clean (what @olisnr was already mentioning), but if I go lower in hierarchy (and we have  here a leaf cell `npn13G2_base_CDNS_...`) I'm getting this `nSDB.e` violation
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
Is this expected?

sergeiandreyev, 2024-12-06:
btw, @akrinke, what do you think if it is feasible to provide somehow the actual notes from the DRM in the Marker Browser GUI, i.e. instead of 'Note 2' - 'nSD:block and Cont do not overlap'
It will be more evident for the user, and he will not be forced to open the DRM document to check what is written in the note..

akrinke, 2024-12-07:
@sergeiandreyev Yes, I will replace references to footnotes.

Here is what I've found: Running DRC on `npn13G2` from the `sg13g2_pr` library shows that it's clean (like both of you said). Now, removing the label `E` on the emitter Metal2 pin results in an `nSDB.e` error. This is also the reason why the leaf cell `npn13G2_base_CDNS_...` violates `nSDB.e`: it's missing the label `E` (and some other layers)! So this is expected.

My next test was to perform DRC on PyCells, flattened PyCells, and flattened PyCells with added label `E`. What is important: The layers `Activ.mask`, `TRANS` and `EmWind` are marked invalid and cannot be selected and copied! So I had to mark them as valid to make the copies. Especially the layer `TRANS` is important for `nSDB.e`. The result was, that adding the label `E` fixes the DRC errors.

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

akrinke, 2024-12-07:
@sergeiandreyev By the way, I've told you about problems creating `npn13G2` with `nx=2`. As you can see from the screenshot, these problems have disappeared. I don't know what caused them.

sergeiandreyev, 2024-12-07:
I'll update the Pycell to add labels

sergeiandreyev, 2024-12-09:
Hi @olisnr, @akrinke, could you please review the latest update in `dev` branch?

olisnr, 2024-12-10:
works for me.
may be it should be written somewhere in the documentation for analog design?

akrinke, 2024-12-10:
Works for me too.

olisnr, 2024-12-11:
@sergeiandreyev yes. people need the instructions

Closed 2024-12-18.

Thread 291 (2024-12-08):

DRC Validation cells errata

RTimothyEdwards, 2024-12-08:
@KrzysztofHerman , @sergeiandreyev , et al.,
Here's a list of things I came across while working on the tech file for magic for IHP s13g2.  It is just a dump of things I found, mostly minor, and I have not looked through the issues list to see if any of them have already been reported.

In the DRC validation GDS library:

1.  The "ActivFiller" cell has text "PASS ... PASS" instead of "PASS ... FAIL"
2. The "TopMet2Filler" cell has text "TM1" on all the rule numbers.
3. The Thick Oxide devices in the "thickgateox" cell fail the minimum gate length rule.  This is not necessarily an error but I would prefer that the validation cells not raise unrelated errors.
4. The "passiv" cell shows passivation over both metal7 and over metal6.  The metal6 use case is not documented in the SG13G2_os_layout_rules.pdf file.  I do not know if this use case is valid.

Documentation (SG13G2_os_layout_rules.pdf):

1. The Rsil.d rule illustration is wrong in SG13G2_os_layout_rules.pdf;  the rule specifies distance from pSD to GatPoly but the dimension illustrated is pSD to EXTblock.

In the sg13g2_pr.gds library:

1. There is no marker layer for PNP.  This makes it impossible for a tool to distinguish it as a device as opposed to just a piece of diffusion surrounded by a double guard ring.
2. The p-diode (dpantenna) has no nwell drawn underneath, which makes it, as drawn, a substrate tap and not a diode.

In the standard cell library:

1. Cell "sg13g2_a21o_1" has been incorrectly named "sg13gs_a21o_1" ("gs" instead of "g2") in the GDS.

sergeiandreyev, 2024-12-10:
Hi @RTimothyEdwards, thank you for detailed analysis and reporting!
I'll start from the end :)
Std cells:
- could you please tell us how you're checking the cell list in GDS? opening the [`sg13g2_stdcells.gds`](https://github.com/IHP-GmbH/IHP-Open-PDK/blob/dev/ihp-sg13g2/libs.ref/sg13g2_stdcell/gds/sg13g2_stdcell.gds) in KLayout GUI I do not see any naming mismatch
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

Primitive library:
- `pnpMPA` recognition: we have this implemented in KLayout LVS deck (as I understand), maybe @atorkmabrains or @FaragElsayed2 can give a hint on how they made it working w/o marker layer
- the `dpantenna` Pycell device was updated some time ago to include NWell
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
we need to regenerate the `sg13g2_pr` GDS to make it consistent (thanks for finding!)

Docs:
- yes, it should be fixed - I'll forward the issue to our responsible team member

For the other questions, I'll come back later after internal review

RTimothyEdwards, 2024-12-10:
@sergeiandreyev :  Sorry about the false positive with the standard cell name;  I must have manually copied the cell with a typo although I don't remember doing anything with that cell.  Anyway, it is not repeatable and clearly not a problem and I should have done a bit more due diligence before reporting it.

RTimothyEdwards, 2024-12-10:
@sergeiandreyev :  Looking at the klayout extraction deck, it appears that a PNP is identified as an area inside a p-type guard ring (ptap) that literally isn't everything that is not a bipolar (i.e., "bjt_exclude" = poly + pwell + nSD + salicide block + ext block + diode ID + resistor ID + inductor ID + substrate ID).  It seems both over-complicated and non-robust to identify a PNP transistor as "not (everything that is not a PNP transistor)".

atorkmabrains, 2024-12-10:
@RTimothyEdwards I respectfully disagree with you about the PNP exclude conclusion here. There is a reason we follow such exclusion it's important for proper functionality and proper identification of devices.

RTimothyEdwards, 2024-12-10:
@atorkmabrains :  I don't intend to get into a flame war here, but under what circumstance is it not simpler / more efficient / cleaner / more robust simply to draw TRANS over top a PNP device and declare that an NPN device = (TRANS containing low- or high-voltage emitter window) and a PNP device = (TRANS not containing emitter window)?  Or equivalently, just define an additional GDS layer called PNPTRANS which identifies a PNP transistor?

atorkmabrains, 2024-12-11:
@sergeiandreyev I believe the suggestion above by @RTimothyEdwards  is for you not for us. We follow your lead on this. I believe I mentioned something similar at the very beginning of the project about marker layers and truth table.

@sergeiandreyev Do you want to proceed with @RTimothyEdwards suggestion?

sergeiandreyev, 2024-12-11:
unfortunately, we have to discuss this internally as always for such questions (the consistency with the proprietary PDK is an important topic)
one thing to note is that we're now reimplementing the `pnpMPA` device (model updates, etc.), so this is a good timing to discuss possible improvements in the device layout / extraction as well

sergeiandreyev, 2024-12-11:
> @atorkmabrains : I don't intend to get into a flame war here, but under what circumstance is it not simpler / more efficient / cleaner / more robust simply to draw TRANS over top a PNP device and declare that an NPN device = (TRANS containing low- or high-voltage emitter window) and a PNP device = (TRANS not containing emitter window)? Or equivalently, just define an additional GDS layer called PNPTRANS which identifies a PNP transistor?

yes, this is a question to our internal PDK

sergeiandreyev, 2024-12-17:
Hi @RTimothyEdwards, most of the items from the *DRC validation* list should be fixed with the latest commit, could you please double check on your side?
for the bullet 7. - we don't have `metal6` and `metal7` in technology and in `pad` cell as well, do you mean Top metals?

RTimothyEdwards, 2024-12-17:
@sergeiandreyev :  Yes, I mean the top metals (I've mapped them to names "metal6" and "metal7" in the magic tech file).

RTimothyEdwards, 2024-12-17:
@sergeiandreyev :  After pulling your updates from this morning, I find that my item number 5
```
Additionally, layouts for rules Gat.a2 and Gat.a4 show transistors formed from poly on P+ diffusion not in nwell; this forms a p-type varactor device, but no model exists in the PDK for such a device.
```
is still showing as an issue in the DRC pass/fail layout for GatPoly.

RTimothyEdwards, 2024-12-17:
@sergeiandreyev :  I am currently preparing to have magic extract devices such as `SVaricap` as a subcircuit of the same name;  however, it will remain unsimulatable until a device model exists, and it will not be added to the device generator in magic until rules exist for the device geometry.  On the other hand, ESD FET devices in `scr1` and `nmoscl_2`, and `nmoscl_4` are currently being extracted as MOSFETs without regard to the difference in modeling caused by the unsalicided source/drain regions.  If specific models for these devices are added to the PDK, then it is easy enough to change the name of the device being extracted from magic.

sergeiandreyev, 2024-12-20:
added @prabhatdubey92 to this issue, he's working on `SVaricap` model support

sergeiandreyev, 2024-12-20:
> @sergeiandreyev : Yes, I mean the top metals (I've mapped them to names "metal6" and "metal7" in the magic tech file).

I think the `TopMetal1` and `TopMetal2` use cases are described in **Pad Dimensions** section, in the **Passiv** section indeed we have only this:
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
I'll double check with the document owner

Thread 298 (2024-12-17):

Inconsistencies in definitions of Rsil, Rppd, and Rhigh

RTimothyEdwards, 2024-12-17:
The definitions of resistor types Rsil, Rppd, and Rhigh differ between the DRC documentation, the primitive device library (which I assume comes from the klayout pycells) and the device DRC QA layouts.

Rsil:  The primitive device/pycell contains PolyRes which does not exist for this device in the documentation or the QA layout.

Rppd:  The primitive device/pycell contains PolyRes which does not exist for this device in the documentation or the QA layout.  Also, the primitive device/pycell does _not_ contain GatPoly in the resistor region, while both the documentation and QA layout have GatPoly.

Rhigh:  Both the primitive device/pycell contain PolyRes, but this layer does not appear in the device recognition definition in the documentation.

Please clarify how these devices are intended to be constructed.

sergeiandreyev, 2025-04-09:
Hi @stefansimon42, could you please take a look?

stefansimon42, 2025-04-10:
Hi @RTimothyEdwards

Both GatPoly and PolyRes are physically the same polysilicon. Both layers are used as input for the polysilicon litho mask.

The difference is purely virtual. While GatPoly is defined as electrically conductive in the proprietary LVS, PolyRes is defined as non-conductive. On the one hand, this is intended to simplify the extraction of the devices, on the other hand, it prevents “virtual” shorts being generated in the LVS.

I will update the device description in the DRM. Thanks for pointing this out.

sergeiandreyev, 2025-04-10:
to add to this, indeed QA cells layouts should be updated, we have an internal discussion

RTimothyEdwards, 2025-04-11:
@stefansimon42 :  I think the discussion answers all of my questions, which I would summarize as follows:

1. PolyRes is intended to be mask-equivalent to GatPoly and is not simply an identifier layer.
2. The QA cells are incomplete/incorrect and will be updated.
3. The DRM description is incomplete/incorrect and will be updated
4. The primitive devices/pycells are correct and can be trusted

Thank you and @sergeiandreyev for the helpful answers.

olisnr, 2025-04-30:
@sergeiandreyev i have the question if its intended that the Rsil's PCell dont has a parameter "Bends"?

sergeiandreyev, 2025-04-30:
Hi @olisnr , yes, we removed it based on the feedback from the technology team and internal review

olisnr, 2025-05-02:
@sergeiandreyev parameter `b` should then be removed also from the` ihp-sg13g2/libs.tech/xschem/sg13g2_pr/rsil.sym` and may be from a QUCS symbol.

sergeiandreyev, 2025-05-02:
> [@sergeiandreyev](https://github.com/sergeiandreyev) parameter `b` should then be removed also from the` ihp-sg13g2/libs.tech/xschem/sg13g2_pr/rsil.sym` and may be from a QUCS symbol.

Hi @KrzysztofHerman, could you please take care?

Thread 305 (2024-12-21):

KLAYOUT Not Integrating with IHP Open PDK [ LIBRARY AND DEVICES ARE NOT FOUND]

Ikram-rs22, 2024-12-21:
I'm trying to integrate Klayout with the ihp open sg13g2 pdk but there seems to be a problem. I have integrated the pdk tech file with Klayout as shown below

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

After that I exit and re-enter klayout but then this error is shown in the command line

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

And also there is no SG13_dev library in the library sections as a result no devices are found

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

But when I ran the pycell_test.py file a sg13_dev.gds file is created where I can see the devices

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

But still there is no library from which I can instantiate the cells. DRC and LVS options are visible and running but no devices. Please help.

adrienluitot, 2024-12-22:
Did you fetch the submodules? Like pypreprocessor and pycell4klayout-api

Ikram-rs22, 2024-12-23:
No I didn't. Where can I get those? @adrienluitot

Ikram-rs22, 2024-12-23:
Thanks the problem is solved. But I've noticed that when you increase or decrease the width and lengths of inductors and capacitors, the effect takes place but the value of inductance, capacitance showing in the paramter window doesn't change. So what to make of it?

adrienluitot, 2024-12-23:
Nice! Well done!

For the inductance and resistance value, I don’t think it is working. I only gave a quickly look at the PCell code, but didn’t found anything that updates those values. But it is something a little complicated to compute I think, I’m not sure there is a perfect formula.

As far as I know for the moment, the best thing to do is to generate a layout in KLayout, save the GDS and simulate your inductor in OpenEMS.

I started a Google Sheet with some simulated values (around 2.45GHz), I can share it if you wish.

Ikram-rs22, 2024-12-23:
Thanks it'd be a tremendous help if you shared your file.

akrinke, 2024-12-23:
We are currently working on a more accurate inductance extraction. It taps into the LVS, exports the geometry of inductors and runs FastHenry. The calculated inductance values are then added to the extracted netlist. We hope to have it packaged at the end of January.

Ikram-rs22, 2024-12-23:
Will the january pdk then have inductors as  schematic components? For circuit design?

adrienluitot, 2024-12-23:
> Thanks it'd be a tremendous help if you shared your file.

https://docs.google.com/spreadsheets/d/1vt_hs9XaM-SnFTcuAcVK475XKEWRAJqNsY20x1bT3ns/
There you go.
It is more of a draft than anything else, I might simulate more inductors with time. Maybe I might try to do a linear regression if I have enough simulations.

adrienluitot, 2024-12-23:
> We (TU Dresden) are currently working on a more accurate inductance extraction. It taps into the LVS, exports the geometry of inductors and runs FastHenry. The calculated inductance values are then added to the extracted netlist. We hope to have it packaged in a fork for testing at the end of January.

Good news ! It’s forgot about LVS, I don’t know it’s managed for the moment… maybe juste waived?

Anyway, glad to see some people are working on the inductors!

akrinke, 2024-12-23:
I guess our approach shouldn't be the default mode. Ideally, the inductor PCells (schematic and layout) should update the inductance value based on the geometry parameters. Then LVS just checks the geometry. However, using FastHenry makes sense for hand-drawn inductors.

adrienluitot, 2024-12-23:
I think most PDK just give well tested non-editable inductors. It seems to be harder to estimate the value of an inductor than of a resistor. But maybe this PDK could use a “simple” inductor formula to approximate its value to be LVS compatible. Maybe they already do that, I’m not sure.

I don’t know about FastHenry, I will inquire.

Ikram-rs22, 2025-01-03:
@sergeiandreyev for RF designof high frequencies (beyond 100 GHz), there are no RF probe pad or DC pads in klayout. As such, my intuition tells me it isn't possible to design RF circuits. Could you elaborate on that?

sergeiandreyev, 2025-01-03:
@Ikram-rs22, you mean the lack of `pad` device as KLayout parameterized cell (Pycell)? because we have `bondpad` layout in `sg13g2_pr` library
on the `pad` support - we're going to provide a temporary Pycell for KLayout in a short term, currently we have internal model update/development for this device in progress, but the expected time frame is somewhere in spring..

Ikram-rs22, 2025-01-03:
Did you mean this bondpad and cupillar pad?

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

As far as I know any RF layout has pads for signal input and also dc biasing? will these pads suffice for those? And also for Dc - 150 GHz range? Moreover, is there any openMPW in March and will the pycell be available before that? Thanks in advance.

sergeiandreyev, 2025-01-06:
@Ikram-rs22, yes, I mean these cells
and yes, there will be 140 mm<sup>2</sup> available on March TapeOut for the open source community:
https://ihp-open-ip.readthedocs.io/en/latest/
and the plans are to provide the `pad` Pycell before that
- to your specific questions on pads I'll double check internally and come back to you

Ikram-rs22, 2025-01-13:
@sergeiandreyev any update on the RF GSG pads for RF signal path and DC pads for biasing? The rf_cmim cpacitor pycell is not present in layout but the qucs-s library has one? How to resolve this issue in layout where there is no pycell for rf_cmim??

sergeiandreyev, 2025-01-13:
Hi @Ikram-rs22, on the pads no updates for now, I'll have a discussion this week
On the `rfcmim` Pycell - it's in progress, should be ready this week or beginning next week worst case

Ikram-rs22, 2025-01-13:
Thanks a lot. Could you also kindly take a look at issue no 325?

Ikram-rs22, 2025-05-20:
What I think, you need to copy that cell to the new cell's cell window and then instantiate

engrvip123, 2025-05-20:
Sorry but I didn't get your above instruction. I don't see any IHP library to select device to instantiate its layout as shared in screenshot.

Ikram-rs22, 2025-05-20:
Please provide the terminal screenshot, if there occurs an error, the terminal shows it. It would be easier to debug from there-on @engrvip123

sergeiandreyev, 2025-05-20:
@engrvip123, do you have any warning/error messages in the terminal window (assuming you're running `klayout` from a terminal)

engrvip123, 2025-05-20:
@Ikram-rs22 @sergeiandreyev Here is the error seen in terminal.

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

Ikram-rs22, 2025-05-20:
@engrvip123 you haven't downloaded the klayout apis in the klayout/python/pycells4klayout folder

engrvip123, 2025-05-20:
@Ikram-rs22 Thanks for pointing out the issue. Can you please elaborate where to download these api's from and where to look for this folder `pycells4klayout` ?

Ikram-rs22, 2025-05-20:
You can from these 2 repos -

https://github.com/IHP-GmbH/pycell4klayout-api/tree/047f1928ac6749d438a500c4ee90f32c879d3f11

https://github.com/IHP-GmbH/pypreprocessor/tree/6ddd5783365718c41eb69bce4428358ace4d1fa2

sergeiandreyev, 2025-05-20:
@engrvip123, based on the warning messages. it seems there is a mess up with the directory structure:
the `$HOME/.klayout` folder should not have any content inside `python` directory
The Pcell library is taken from `KLAYOUT_HOME`:
`/home/andreev/.klayout:/home/andreev/opensource/IHP-Open-PDK/ihp-sg13g2/libs.tech/klayout`
from `IHP-Open-PDK` part of the path

engrvip123, 2025-05-20:
@sergeiandreyev I am not very familiar with Linux or environment setup. Have followed steps from this link to install KLayout with the IHP PDK: [https://analog-course.readthedocs.io/en/latest/design_softwares/klayout.html.](url)

Below are the current settings in .bashrc used for Klayout with IHP pdk. Could you please review them and suggest any corrections to help resolve the error I'm encountering?

```
export PDK_ROOT=$HOME/IHP-Open-PDK
export PDK=ihp-sg13g2

export KLAYOUT_PATH="$HOME/.klayout:$PDK_ROOT/$PDK/libs.tech/klayout"
export KLAYOUT_HOME=$HOME/.klayout
export PATH="$PATH:$HOME/src/tools/klayout"
export LD_LIBRARY_PATH="$LD_LIBRARY_PATH:$HOME/src/tools/klayout"
```

Ikram-rs22, 2025-05-20:
Your klayout path is wrong. Follow @sergeiandreyev's instruction

Ikram-rs22, 2025-05-20:
@engrvip123 you could follow this issue -
 https://github.com/IHP-GmbH/IHP-Open-PDK/issues/219

engrvip123, 2025-05-20:
> [@engrvip123](https://github.com/engrvip123), based on the warning messages. it seems there is a mess up with the directory structure: the `$HOME/.klayout` folder should not have any content inside `python` directory The Pcell library is taken from `KLAYOUT_HOME`: `/home/andreev/.klayout:/home/andreev/opensource/IHP-Open-PDK/ihp-sg13g2/libs.tech/klayout` from `IHP-Open-PDK` part of the path

@sergeiandreyev I have updated `KLAYOUT_HOME` variable and made `$HOME/.klayout/python` folder empty as suggested but issue still persists. Should I uninstall Klayout and install again? If yes, please suggest what steps to follow for new installation.

```
export PATH="$PATH:$HOME/src/tools/klayout"
export LD_LIBRARY_PATH="$LD_LIBRARY_PATH:$HOME/src/tools/klayout"

export PDK_ROOT=$HOME/IHP-Open-PDK
export PDK=ihp-sg13g2
export KLAYOUT_PATH="/home/$USER/.klayout:$PDK_ROOT/$PDK/libs.tech/klayout"
export KLAYOUT_HOME=/home/$USER/.klayout:/home/$USER/IHP-Open-PDK/ihp-sg13g2/libs.tech/klayout
```

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

engrvip123, 2025-05-20:
I checked and `.../IHP-Open-PDK/ihp-sg13g2/libs.tech/klayout/python/pycell4klayout-api` was empty. I cloned IHP pdk again as per instructions in above shared link. Now while invoking klayout getting following errors in terminal.

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

sergeiandreyev, 2025-05-20:
if you used `git checkout dev` and it doesn't populate the sub-modules from the `dev` branch - we should change the documentation

engrvip123, 2025-05-21:
@sergeiandreyev I am using `dev` branch only of IHP pdk.

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

mole99, 2025-05-21:
@engrvip123 can you verify that the active commit of `pypreprocessor` is `cf1ff9bad0fb5338cf1c5b990b2b816b1ea01a64`?

You may need to do another `git submodule update --recursive` after switching to the `dev` branch.

mole99, 2025-05-21:
And if you take a look at `IHP-Open-PDK/ihp-sg13g2/libs.tech/klayout/python/pypreprocessor/pypreprocessor/__init__.py` at line 11, does it say `import importlib` or `import imp`?

engrvip123, 2025-05-21:
I took help of chatgpt and issue got resolved now with klayout opening without errors and also I can see IHP pcell library. Here is the summary:

Issue:
KLayout threw a `ModuleNotFoundError: No module named 'imp'` when loading the IHP Open PDK because the PDK's PyCell scripts used the deprecated imp module, which is removed in `Python 3.12`.

Resolution:
Instead of downgrading Python, the scripts were updated to replace `imp.load_source()` with `importlib.util` and `exec_module()—`making them compatible with Python 3.12. After this change, KLayout ran without errors.

sergeiandreyev, 2025-05-22:
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

please run `sed -n '11p' IHP-Open-PDK/ihp-sg13g2/libs.tech/klayout/python/pypreprocessor/pypreprocessor/__init__.py`
if you have:
`import importlib` - you have **correct** module version
if you have:
`import imp` - you have **incorrect** module version
instead of downgrading Python or updating scripts, just try to download the exact version which has to be used.
How to debug:
review the IHP OpenPDK GitHub repository through the web interface:
https://github.com/IHP-GmbH/IHP-Open-PDK/tree/dev/ihp-sg13g2/libs.tech/klayout/python
try to understand the Python error message and find the line with the code which is the root cause, compare the file where you have the error (`__init__.py`) with the file on the GitHub repo `dev` branch
try to learn/understand how to work in different git branches, download specific versions (commits), working with submodules...
P.S. IMHO, you should not expect ChatGPT to provide you the **optimal** answer, and I would strongly discourage to use it if you have very limited understanding of the topic you want it to help you with (what I mean, basically, you should have enough knowledge and be able to "trust" ChatGPT response/code/etc.)
and, BTW, it's not able to fully parse GitHub repositories

engrvip123, 2025-05-22:
Thanks @sergeiandreyev for your suggestion. I will definitely follow it. Following is output for `sed` command run at my end:
```
TT10:~$ sed -n '11p' IHP-Open-PDK/ihp-sg13g2/libs.tech/klayout/python/pypreprocessor/pypreprocessor/__init__.py
import importlib
```

But I am struggling with `ModuleNotFoundError: No module named 'klayout'` error while running LVS using `run_lvs.py` script. Can you please suggest about issue here?

sergeiandreyev, 2025-05-22:
@engrvip123, let's move step by step..
what did you had to do to have the `pypreprocessor` library now **not** referencing the `imp` module (which command did you use? did you manually edit the file?)
what was the root cause of the error?

engrvip123, 2025-05-23:
@sergeiandreyev  The error occurred because the pypreprocessor library was relying on the deprecated `imp` module, which was removed in Python 3.12. My system was running Python 3.12.3, leading to the `ModuleNotFoundError`.

I manually edited the file in the PDK that was importing` imp`. I replaced the deprecated `imp.load_source()` call with the modern equivalent using` importlib.util`.

Closed 2025-05-12.

Thread 309 (2024-12-24):

Signal Amplitude Depends on Simulation Duration in Ngspice 43 Transient Simulation

rupokdas147, 2024-12-24:
## Environment
Ngspice 43
Qucs-s 24.3

I am encountering an unexpected behavior with Ngspice version 43 during the transient simulation. The issue is related to the amplitude of the signal, which seems to depend on the simulation duration. This problem does not occur in Ngspice version 42. Below is a detailed explanation:

Input signal: A squared current source:
Amplitude: 100 uA
Duration of High Pulse: 20 ps
Duration of Low Pulse: 20 ps
Rise Time: 20 ps
Fall Time: 20 ps

The screenshots attached with the description were the transient simulated output of an amplifier designed using an SG132 device.

## Expected Behavior
The expected behavior is created using **Ngpice 42**.

With 3 ns simulation duration, The signal amplitude:
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

With 2 ns simulation duration, The signal amplitude:
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

## Actual Behavior
The Actual behavior is created using **Ngspice 43.**

With a 2 ns simulation duration: The signal amplitude is very low:
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

Witha  3 ns simulation duration: The signal amplitude is very high:
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

## Steps to Reproduce the Problem
1. Create a simple circuit that generates a square wave signal with long rise and fall times.
2. Run a transient simulation with different simulation durations (e.g., 2 ns and 3 ns).
3. Observe the output signal's amplitude.

KrzysztofHerman, 2024-12-28:
@rupokdas147  interesting case. As @StefanSchippers  wrote, please provide the testcase to reproduce the issue.

rupokdas147, 2024-12-28:
@StefanSchippers @KrzysztofHerman, I have changed the circuit a little bit. The output will not be the same as the previous screenshot, but it will be similar.
[CE_Buffer_2_eye_diagram.zip](https://github.com/user-attachments/files/18265999/CE_Buffer_2_eye_diagram.zip)
I have tested for three different transient times: 2 ns, 3 ns, and 5 ns. For **Ngspice 43**, the amplitude was different for each case, but the amplitude remained the same for **Ngspice 42**.

StefanSchippers, 2024-12-28:
@rupokdas147 some comments:
the CE_Buffer_2_eye_diagram.cir defines a subcircuit with 6 ports (highlighted in bold):
.SUBCKT IHP_PDK_nonlinear_components_npn13G2  **gnd c b e bn t** Nx=1
...
.ENDS

but the instances call the subcircuit with 5 nets (in bold):
Xnpn13G1 **0  _net2 _net3 _net4 0** IHP_PDK_nonlinear_components_npn13G2 Nx=10

I have added a 0 (ground net) at the end of port list the 3 instance lines:

Xnpn13G1 0  _net2 _net3 _net4 0 **0** IHP_PDK_nonlinear_components_npn13G2 Nx=10

otherwise ngspice does not accept the circuit.

I have then run 4 simulations from 0 to 2ns with different timesteps: 1e-11, 1e-12, 1e-13, 1e-14
i get 4 waveforms that are completely different:

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

StefanSchippers, 2024-12-28:
Byincrementing the precision:
.option method=GEAR itl4=10000  sparse CHGTOL=1e-16 ABSTOL=1e-14 GMIN=1e-14 RELTOL=0.0001

I get this:

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

so spread is lower.

When such things happen either the circuit is unstable and has multiple operating points or it heavily depends on very small charges / currents.
Increasing timestep does not produce better results if circuit depends heavily oncharge conservation. More timesteps means more accumulation of rounding errors.

StefanSchippers, 2024-12-28:
attached my modified .cir file
[CE_Buffer_2_eye_diagram_stef.zip](https://github.com/user-attachments/files/18268014/CE_Buffer_2_eye_diagram_stef.zip)

rupokdas147, 2024-12-29:
@StefanSchippers Please run by changing the duration of the simulation. 0 to 3 ns, 0 to 4 ns and 0 to 5 ns, and observe if there is any change in the output waveform or not.

rupokdas147, 2024-12-29:
@StefanSchippers @KrzysztofHerman

However, using Xyce as a simulator provides stable results.
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

[CE_Buffer_2_eye_diagram_xyce.zip](https://github.com/user-attachments/files/18268697/CE_Buffer_2_eye_diagram_xyce.zip)

rupokdas147, 2024-12-29:
According to my observations:
1. In **S-parameter** Simulation, **Xyce** and **Ngspice 43** provide almost the same result.
2. In **Transient** Simulation, **Xyce** and **Ngspice 42** provide almost the same result.

StefanSchippers, 2024-12-29:
@rupokdas147 I agree with you. Xyce runs provide identical results at any (reasonable) timestep given in the .tran comman. Moreover Xyce simulates this circuit orders of magnitude faster.

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

StefanSchippers, 2024-12-29:
And I also confirm that by rolling back to ngspice 42 simulation is aligned with Xyce and super fast. No special .option settings are required.

rupokdas147, 2024-12-29:
@StefanSchippers The **Noise Simulation** result is different in **Ngspice 42, 43 and Xyce**. At this point, I am really confused about my design. Should I go to layout or still there are problems with the schematics.

dwarning, 2025-01-14:
@StefanSchippers @rupokdas147
Please substitute the attached library file sg13g2_hbt_mod.lib in the directory IHP-Open-PDK/ihp-sg13g2/libs.tech/ngspice/models. (Perhaps you make a backup before.)
[sg13g2_hbt_mod.zip](https://github.com/user-attachments/files/18404504/sg13g2_hbt_mod.zip)
The file has an additional switch for vbic's NQS effect: sw_nqs. By using an appropriate symbol the user can switch on/off this effect.
Please report if now the results from ngspice version 43 (and 44) fulfill the expectations. Then I will make a PR to IHP's dev branch.
Thank you.

rupokdas147, 2025-01-16:
@dwarning Thanks, **it worked**. I have tested using this file and now the Transient result is **not dependent on time step**.

StefanSchippers, 2025-01-16:
@dwarning sorry I can not simulate with the new .lib file, there are probably some implicit changes that must be done (5 terminal npn? 4 terminal npn ? don't know, ngspice reports "`Too many parameters for subcircuit type "npn13g2" (instance: xx1)`" , but since I don't know exactly the circuit I think @rupokdas147 result is the authoritative answer.

rupokdas147, 2025-01-16:
@StefanSchippers I have added `.INCLUDE path_to_PDK/ihp-sg13g2/libs.tech/ngspice/models/sg13g2_hbt_mod.lib` for each element in `IHP_PDK_nonlinear_components.lib` file.

[IHP_PDK_nonlinear_components.zip](https://github.com/user-attachments/files/18438333/IHP_PDK_nonlinear_components.zip)

rupokdas147, 2025-01-16:
@StefanSchippers Here is my testcase.

[CE_Buffer_3_eye_diagram.zip](https://github.com/user-attachments/files/18438381/CE_Buffer_3_eye_diagram.zip)

rupokdas147, 2025-01-16:
@StefanSchippers My PDK us from `dev` branch.

StefanSchippers, 2025-01-16:
Ah, ok, thank you!...

StefanSchippers, 2025-01-16:
@rupokdas147 sorry, but I really can't make it run and I think I throw the towel on this.
I have re-cloned the whole IHP pdk, switched to dev branch, put the new @dwarning file into my repo:
`.../IHP-Open-PDK_git/ihp-sg13g2/libs.tech/ngspice/models/sg13g2_hbt_mod.lib`:
```
schippes@asus:/mnt/sda7/IHP-Open-PDK_git$ git status
On branch dev
Your branch is up to date with 'origin/dev'.

Changes not staged for commit:
  (use "git add <file>..." to update what will be committed)

[CE_Buffer_3_eye_diagram_stefan.zip](https://github.com/user-attachments/files/18439479/CE_Buffer_3_eye_diagram_stefan.zip)

[CE_Buffer_3_eye_diagram_stefan.zip](https://github.com/user-attachments/files/18439487/CE_Buffer_3_eye_diagram_stefan.zip)

  (use "git restore <file>..." to discard changes in working directory)
	modified:   ihp-sg13g2/libs.tech/ngspice/models/sg13g2_hbt_mod.lib

no changes added to commit (use "git add" and/or "git commit -a")
```
ngspice on your latest `CE_Buffer_3_eye_diagram.cir `shows the same message.
I think there are local changes on the PDK I don't have here.
```
schippes@asus:~/.xschem/xschem_library/CE_Buffer_2_eye_diagram$ ngspice -n -i CE_Buffer_3_eye_diagram.cir
******
** ngspice-44+ : Circuit level simulation program
** Compiled with KLU Direct Linear Solver
** The U. C. Berkeley CAD Group
** Copyright 1985-1994, Regents of the University of California.
** Copyright 2001-2024, The ngspice team.
** Please get your ngspice manual from https://ngspice.sourceforge.io/docs.html
** Please file your bug-reports at http://ngspice.sourceforge.net/bugrep.html
** Creation Date: Mon Jan 13 16:37:42 UTC 2025
******

Note: No compatibility mode selected!

Circuit: * qucs 24.3.0  /home/rf/qucsworkspace/tia_rupok_prj/ce_buffer_3_eye_diagram.sch

Too many parameters for subcircuit type "npn13g2" (instance: xx1)
    Simulation interrupted due to error!
```

StefanSchippers, 2025-01-16:
The netlist I was trying to simulate.
the only changes are the paths of the .include and .lib lines.

[CE_Buffer_2_eye_diagram.zip](https://github.com/user-attachments/files/18439497/CE_Buffer_2_eye_diagram.zip)

StefanSchippers, 2025-01-16:
@rupokdas147 **update**: it is my ngspice version that fails. Rolled back to a ngspice-42 I have here and everything works now. Sorry for the trouble.

StefanSchippers, 2025-01-16:
Ok, thank you. the ngspice 44.2 and pre-master-45 fail.
ngspice-44 confirmed to work.
Thank you

dwarning, 2025-02-03:
@rupokdas147
@StefanSchippers

I have fixed the vbic model problem regarding simulations in time domain with nqs effect enabled (td > 0). The picture is made with ngspice 44+ (branch pre-master-45).
Output voltage is 60mVpp.

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

Closed 2025-01-16.

Thread 310 (2024-12-27):

Ngspice-32 or 43 Cannot calculate minimum noise figure (NFmin) if S2P file is used

Atif07Ali, 2024-12-27:
## Environment
Ngspice  42 or 43
Qucs-s 24.3
I am trying to design an LNA at 170 GHz frequency using SG13G2. I tried to build the circuit with transmission lines, using the S2P files of transmission lines. I faced the problem of 'nan' in the minimum noise figure (NFmin). It seems that the simulator cannot calculate NFmin.
if I use lumped elements, the NFmin gives the right value. However, when I use S2P files as the transmission lines, the NFmin does not provide any value. It seems that the simulator cannot calculate noise figure when there are S2P files.

## Expected Behavior
The behavior has been simulated using lumped elements only.
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

## Actual Behavior
This is the behavior after using S2P files.
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

## Steps to Reproduce the Problem

1. Create the circuit like the schematic.
2. Provide any S2P file to the 2-port s-param.
3. Turn on the noise in "S parameter simulation" and simulate. plot nfmin.

dwarning, 2024-12-28:
I am afraid that noise contributions by S2P files can't simulate by ngspice, even if the files contain additional noise data.

But NaN looks more as bug. To investigate that it would be easier you could provide the schematic and the four S2P files. Or alternative the spice4cucs.cir file would be helpful too.

KrzysztofHerman, 2024-12-28:
@Atif07Ali @dwarning  indeed I have reproduced this testcase a few minutes ago and got the same  results, I mean `NaN`.
[Here](https://files.slack.com/files-pri/T01699QAZBQ-F086EG1DWG4/download/lna.rar?origin_team=T01699QAZBQ) is the complete testcase (one have to update the fixed paths pointing to the S2P files)

dwarning, 2024-12-28:
Slack channel is problematic - I believe I removed my membership.

Atif07Ali, 2024-12-29:
@dwarning thanks for your reply. I am sharing the test case and the 4 s2p files in zip format. The S2P file names are marked in red within the schematic.
[LNA.zip](https://github.com/user-attachments/files/18268657/LNA.zip)

dwarning, 2024-12-30:
Thank you!
We have a problem in principle with simulating noise in s-parameter environment as we can see for resistors lower then system impedance:

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

After further investigations maybe we should open an ticket in ngspice forum.

dwarning, 2024-12-30:
It is pre-master-44 branch (not actual anymore because new version 44 just released): ngspice-43+.

Atif07Ali, 2024-12-31:
@dwarning There is a significant difference in results based on the version of ngspice. I am using both ngspice-42 and ngspice-43 for noise simulation. This is another problem. I think we should create an issue in ngspice forum. I am creating the issue. Please add your concerns in the reply.

dwarning, 2025-01-05:
After solving the NaN problem in ngspice coming back to the initial problem of the missing noise results in the LNA stage by using s-parameter files.

I can only recommend converting s-parameter files in general by using vector fitting with the scikit-rf python package: [scikit-rf](https://github.com/scikit-rf/scikit-rf). This has the additional advantage that AC, DC, Transient and Noise analysis are feasible.
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

Attached are the used python files, converted spice files and the qucs-s schematic.

@Atif07Ali Could you please check the plausibility of the noise and other results.

@KrzysztofHerman We should find a way to support the converting of s-parameter files in general in the design flow.

[LNA_spar_noise_prj.zip](https://github.com/user-attachments/files/18309872/LNA_spar_noise_prj.zip)

Atif07Ali, 2025-01-05:
@dwarning thanks. Let me check it.

Atif07Ali, 2025-01-05:
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
@dwarning was able able to reproduce the figure as per your suggestion. I have simulated it both ngspice-42 and 43 version. The 42 version gives the nan value.

Atif07Ali, 2025-01-05:
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
Here if you see the nfmin values, there is a huge difference. ngspice-42 gives more realistic values (nfmin=4.48 @170G). After implementing the matching circuit, ngspice version 42 gives nan value in some frequencies according to previous case (with the use of lumped elements, it also give nan value). But the version 43 does not have the problem with nan. But 43 gives impractical values. I am actually confused which version should I use?

dwarning, 2025-01-05:
You are mixing lot of things in your discussion which I am not able to follow.
Version 42 is not acceptable. We are now with 44.
Please reduce the diagrams.
Let us start with one kind of matching elements, then the other types.
Last schematic shows new elements, which are not available for me.
It's confusing, sorry.

Atif07Ali, 2025-01-05:
I am sorry. Maybe I got your point. I was confused with the version at this time. Your suggestion worked perfectly for simulating s2p files.
Then the question is which version should I use?  43 gives impractical noise figure (nfmin) values. Should I try for 44 then?

dwarning, 2025-01-05:
Try to install 44 - needs about 5-10 min. Then we are on same level.
The vector fit approach is new. We have to investigate the noise performance of the generated networks.
Your help is appreciated.
Thanks!

Thread 312 (2024-12-31):

Ngspice-42 or 43 Cannot calculate minimum noise figure (NFmin) if S2P file is used

Atif07Ali, 2024-12-31:
## Environment

Ngspice 42 or 43
Qucs-s 24.3
I am trying to design an LNA at 170 GHz frequency using SG13G2. I tried to build the circuit with transmission lines, using the S2P files of transmission lines. I faced the problem of 'nan' in the minimum noise figure (NFmin). It seems that the simulator cannot calculate NFmin.
if I use lumped elements, the NFmin gives the right value. However, when I use S2P files as the transmission lines, the NFmin does not provide any value. It seems that the simulator cannot calculate noise figure when there are S2P files.
## Expected Behavior
The behavior has been simulated using lumped elements only.
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

## Actual Behavior
This is the behavior after using S2P files. The NFmin gives "nan" value.
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

## Steps to Reproduce the Problem

1. Create the circuit like the schematic.
2. Provide any S2P file to the 2-port s-param.
3. Turn on the noise in "S parameter simulation" and simulate. plot nfmin.

Atif07Ali, 2024-12-31:
I am sharing the test case and the 4 s2p files in zip format. The S2P file names are marked in red within the schematic.
[LNA.zip](https://github.com/user-attachments/files/18279119/LNA.zip)

Atif07Ali, 2024-12-31:
@dwarning Could you please mention your concerns here?

Closed 2024-12-31.

Thread 314 (2025-01-02):

Simulation Issues with s2p File-based Inductors

rupokdas147, 2025-01-02:
I encountered a problem while designing an amplifier using the IHP Open Source PDK with the following tools:

Qucs-S 24.3: For schematic design
Ngspice 43 and Xyce: For simulation

Design Process:
Initially, I completed the amplifier design using ideal components from Qucs-S.
I replaced the ideal resistors and capacitors with the PDK-provided resistors and capacitors. The S-parameter values remained consistent, confirming proper functionality.

To replace the ideal inductors (50 pH each):
Designed the inductor layout.
Simulated it in OpenEMS to generate the s2p file.
Replaced the ideal inductors (L1, L2, L3) with the corresponding s2p files in the schematic.

Problem:
Replacing L3 with its s2p file works fine, and the simulation completes successfully.
However, **replacing L1 or L2 (or both) with their respective s2p files** causes:
**Ngspice 43: The simulation does not start**.
**Xyce: The simulation produces NaN (Not a Number) values in the results.**

Steps to Reproduce:
Design an amplifier schematic in Qucs-S with three 50 pH inductors: L1, L2, L3.
Replace ideal resistors and capacitors with PDK components.
Replace inductors as follows:
Replace L3 with its s2p file: simulation works fine.
Replace L1 and/or L2 with their s2p files: simulations fail as described.
Run simulations in Ngspice 43 and Xyce to observe the issue.

Additional Details:
All s2p files were generated using OpenEMS simulations and validated to ensure physical feasibility.
The issue occurs consistently when L1 or L2 (or both) are replaced with s2p files, regardless of whether L3 remains an ideal inductor or is also replaced with its s2p file.

Expected Behavior:
The simulations should complete successfully for all combinations of s2p-based inductors, just as they do for ideal inductors and for s2p-based L3.

Request:
Please investigate why Ngspice fails to start and Xyce produces NaN values when specific s2p-based inductors (L1, L2) are used. I attached the s2p file, schematic and Netlist.

Thank you!

[Amplifier.zip](https://github.com/user-attachments/files/18288985/Amplifier.zip)

Ngspice 43:
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

Xyce:
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

KrzysztofHerman, 2025-01-02:
@rupokdas147 thank you for reporting this case. I was able to reproduce it and indeed it behaves odd.
As @dwarning  mentioned in the  issue #310 ngspice is not able to leverage noise data form passives components so I turned off the `donoise` oprion from S-parameter simulation. My initial guess is that ngspice has issues finding DC operating point using file elements although there is an entry in S2P file which reports
S-parameter at 0 Hz.

dwarning, 2025-01-02:
I can confirm that ngspice has problems in finding OP if L1 is replaced by an s-parameter file. We have to simplify the testcase and analyze it more in detail.

dwarning, 2025-01-03:
@rupokdas147
ngspice with s-parameter has problems to find operating point in your circuit - as said.
A workaround would be to connect the base bias for first transistor direct to base, means after the inductor s2p file. That worked for me, even I don't know the rf performance consequences.

rupokdas147, 2025-01-03:
@dwarning I managed to achieve almost the same results after removing L1 and L2 with some modifications. But I cannot replace the Inductor in the feedback path with s2p, same problem the DC does not pass. Removing the Inductor significantly affects my results.

dwarning, 2025-01-03:
All this problems stem from the unpredictable DC behavior of the x_sfer function in ngspice. I would recommend to scale down the testcase as much as possible to show the issue (e.g. only one stage with one s2p file) and open an bug ticket in the [ngspice forum](https://sourceforge.net/p/ngspice/bugs/).

VolkerMuehlhaus, 2025-01-03:
I'm not surprised that S-parameter can cause issues here. Strictly speaking, the FDTD EM simulation doesn't solve for an accurate result at DC, because that would require to simulate an infinite number of time steps. Simulation stops when residual energy in the system is below a certain limit, and then S-parameter are usually close to the correct answers, but there can always be some small residual ripple. And unfortunately, tiny errors in S-parameters can result in small leakage currents in shunt path, for example, which will cause issues depending on the location where you place the S2P block in your model.

When I was working for Sonnet EM support (i.e. an EM solver know to be very accurate) for many years we heard about issues with using the S2P EM data directly in Cadence Spectre, and this finally lead to two developments: equivalent circuit model fit (well behaved due to predefined physical structure that prevents unphysical DC leakage) and broad band model fit (math based, no underlying phyiscal model, but forced to be passive and causal). Also, Cadence improved the Spectre engine for more robust handling of "imperfect" S-parameter data.

Recommended workaround: In those cases where you only need a narrow band representation of your inductor, a simple solution would be to extract series L and series C at one target frequency, and possibly add a shunt C to the substrate, so that you have a well-behaved physical PI model. This is not the ideal broad band model we would like to have, but it will capture the Q factor at your target frequency and you get rid of the issues often seen with S2P data.

BR, Volker

KrzysztofHerman, 2025-01-03:
I dived into the documentation of the `ngspice` and found this [example](https://sourceforge.net/p/ngspice/ngspice/ci/master/tree/examples/sp/file.cir).

So the `file` element, which sources a touchstone file is being translated to the `XSPICE` `xfer` function documented in chapter 8.2.19 of the  ngspice [manual](https://ngspice.sourceforge.io/docs/ngspice-html-manual/manual.xhtml).
Unfortunately as one can read there: "This code model is useful only in AC analysis, where it applies a complex transfer function to its input. ".

The reason why  Xyce is not even staring since the file element is handled differently using `YLIN` device is documented in the Xyce Reference manual: "At present, the YLIN device is only supported in the frequency domain for HB analyses."

felix-salfelder, 2025-01-06:
Volkers workaround may be valid for this case. But for sure, workarouds do not scale. What is simple must remain simple.

Time domain simulation of these systems is a research topic. Reportedly, vector fitting (VF) & convolution is a basic approach offered in commercial tools, mostly not based on Spice. The first and (to my knowledge) only attempt to tackle this in F/OSS is here [1].

Unfortunately, the candidate student has been hired immediately after, what a surprise. Who is going to finish their work?

Verilog-AMS defines frequency domain, "laplace" filters for such applications, see LRM 4.5.11. Here, the filter parameters are the coefficients computed using VF. I started playing with it some time ago [1] wth some notes here [2]. There's some fun in it, and it's on the agenda. We could use some degree of collaboration to make this a higher priority.

[0] https://sedemos.blogspot.com/2024/04/phd-transient-simulation-of-frequency.html
[1] https://codeberg.org/gnucap/gnucap-transient-sparam/src/branch/bump
[2] https://codeberg.org/gnucap/gnucap-modelgen-verilog/src/branch/develop/examples/trln

VolkerMuehlhaus, 2025-01-06:
I'm afraid that my previous post can be misunderstood. I want to emphasize that a **physics based** model fit is much more robust than a mathematical "black box" solution based on convolution, because we can enforce a topology that prevents unphysical current paths etc. Using the EM data "as is" is the road to desaster for time domain simulators, from my experience, even if the software allows to go that route. In particular, devices with low loss can easily become non-passive in some weird frequency range after convolution.
In addition to that, the underlying S-parameters are never exact (whatever that means) and fitting them to a suitable physical topology avoids a lot of issues. And as a side effect, the resulting model gives valid noise results.

Based on this thread, I started to think about building a Python-based inductor model extraction, to convert S-parameters from EM to a simple PI model. This will be less sophisticated than my Inductor Model Fit for ADS, at least initially, but it should help tp get started. Question: what would you prefer as output from this tool, wrote a netlist file or just dump component values, so that the user can build the circuit model himself?

metroid120, 2025-01-06:
I agree with much of what has been said here. The solution at DC of EM simulations is always a huge problem, even using commercial tools one might run into issues.

I just want to add: Recently there has been a pretty big implementation effort to generate RLC based networks based on EM simulation data in scikit-rf. That might already do all that we need here! See:

[discussion in scit-rf](https://github.com/scikit-rf/scikit-rf/discussions/1172)
[pull request](https://github.com/scikit-rf/scikit-rf/pull/1231)

I guess this could be integrated into the design flow pretty easily.

Thanks to @fnordpole

fnordpole, 2025-01-06:
Glad to hear there is some interest in the vector fitting code in scikit-rf! I quickly read this thread and here are some comments:

In the vector fitting process, poles and residues are fitted such that the least squares error between the Sparameter data and the model represented by the poles and residues is minimized.

This works good, as long as no discontinuities are present in the data. Unfortunately this is often the case with the DC point. It's not because the DC point is wrong or anything, it's more that the DC transfer is substantially different to the transfer at the first non-DC point.

In the vector fit, the dc point will be considered just like any other sample and the least squares error around DC might be quite high but still, the fit converges because all other samples match pretty good.

There are methods available in the literature about flattening out this discontinuity by modifying the poles/residue pairs at low frequencies, sacrificing accuracy around low frequencies in favor of reducing the discontinuity to dc. None of these are implemented right now in scikit-rf.

Of course the actual computation of the DC point in the Sparameter data is a completely different story and depends on the EM solvers. If the DC point is wrong right from the beginning, then the vector fit can't do anything about it. It will try to fit what there is.

So the bad news is, that this problem won't be solved even with the new circuit synthesizer that I wrote for scikit-rf, but maybe in the future someone might implement one of those discontinuity reduction algorithms in scikit-rf vector fitting.

-------------------------------------------------------
Some off-topic but related comments:

The vector fitting will also get some upgrades soon hopefully:
https://github.com/scikit-rf/scikit-rf/pull/1231

Also the new circuit synthesizer code might get an update to go from admittance-based to impedance-based because this seems to simulate faster in ngspice (~factor 1000x) in Xyce (~factor 4) and in ltspice (~factor 1).
https://github.com/scikit-rf/scikit-rf/pull/1228

It might take a bit of time for this synthesizer fix, because its not clear yet, why it has absolutely no influence in ltspice.
We asked the Xyce developers for advice and maybe they have a clue:
https://github.com/Xyce/Xyce/discussions/123

metroid120, 2025-01-06:
@fnordpole thanks for your answer. Just to clarify: Using the current scikit-rf implementation might be inaccurate toward DC as we are missing data points there.

But since an equivalent circuit is generated, I suppose it would still allow convergence of the circuit for normal DC and transient analysis usually, am I right?

Do you know what ADS or Microwave Office are doing in these cases?

fnordpole, 2025-01-06:
If there are no data points around DC, the least-squares fit will do whatever it wants at those frequencies because there is no equation for it in the system matrix. But that's not specific to the vector fitting implementation in scikit-rf. It will be the same for any vector fit implementation.

If there is no DC point or no frequency samples for very low frequencies, the rational fit model at DC can be anything from "OK" to "crazy" I would guess. It's definitely worth to plot the frequency response of the fitted model including DC and also up to frequencies way higher than your design-bandwidth because the model behavior outside of the sampled data can be anything.

Also related to this is passivity. Make sure to run the passivity checks with is_passive() and if required the enforce_passivity(). If it's not passive, the simulator might not converge.

About ADS and MWO I have no idea what they do. That's why we are working on making a really good vector fit implementation so that we can all investigate what's goin' on in our models instead of having to rely on a closed source black box that does something and costs a lot of money ;D

gvidasdj, 2025-01-31:
Python code would be nice to have as an starting point to get simulation running.

VolkerMuehlhaus, 2025-02-04:
> Python code would be nice to have as an starting point to get simulation running.

I created some code to read S2P data and create a simple pi model, extracted at one frequency. This also plots the L and Q curved and extracted element values over frequency.

https://github.com/VolkerMuehlhaus/pi_from_s2p

I also tested this for noise simulation in ADS: you get the correct noise figure from the pi model, identical to the noise calculated by ADS for the S2P data. Screenshots are in the repository docs.

I hope this will be uselful, although it is not a wideband model yet. Feedback is welcome, let's try to get this going!

rupokdas147, 2025-02-15:
@VolkerMuehlhaus Will this equivalent ckt model work for replacing s2p file of a TL?

VolkerMuehlhaus, 2025-02-15:
> [@VolkerMuehlhaus](https://github.com/VolkerMuehlhaus) Will this equivalent ckt model work for replacing s2p file of a TL?

No, this simple pi model is only valid for an **inductor** between port 1 and 2.

rupokdas147, 2025-02-15:
@VolkerMuehlhaus Are there any way to determine RLGC of a TL from s2p file? Ngspice does not support microstrip line. But it has TXL model.

VolkerMuehlhaus, 2025-02-16:
>Are there any way to determine RLGC of a TL from s2p file? Ngspice does not support microstrip line. But it has TXL model.

Jim Rautio of Sonnet Software has developed such an extraction for the Sonnet MoM solver. In addition to the S-parameter data, the calculation needs to know the physical length of the lines. I haven't seen a paper regarding the math used for that extraction.

https://github.com/IHP-GmbH/IHP-Open-PDK/issues/314#issuecomment-2660861683

rupokdas147, 2025-02-16:
@VolkerMuehlhaus I tried converting the s parameter to ABCD, calculate gamma and z0. From gamma and z0 calculate R, L, G, C. But the RLGC are frequency dependent.

VolkerMuehlhaus, 2025-02-16:
> But the RLGC are not constant over the spectrum. My target is to mimic the behavior of TL lines s2p using RLGC parameters over a broadband spectrum.

Even with the commercial solutions, values are different over frequency range. I have attached a snippet from an RLCG file that IHP uses for the Cadence mtline model, based on Sonnet extraction.

`; RLCG model file for spectre created by create_spectre_RLCG.pl from ./../RLCG/spectre/TL1_TM2_M3_w=10.dat.
FORMAT Freq:    L1:1
                R1:1
                C1:1
                G1:1
0.0 :	1e-10
	1111.13113132
	1e-12
	0
!Z0: n/a n/a
!l: n/a
500000000.0 :  5.46351454e-7
                 1544.47997987
                 1.1416966e-10
                 1.08584973e-7
!Z0: 74.9100605276 -28.741630268
!l: 233850.970028
1000000000.0 :  4.61086054e-7
                 1900.43455769
                 1.1416966e-10
                 2.16401125e-7
!Z0: 66.5905308973 -19.892056036
!l: 131533.645763
2000000000.0 :  4.07100067e-7
                 2242.9966927
                 1.1416968e-10
                 6.54113715e-7
!Z0: 61.0703255686 -12.799921663
!l: 71711.5377835
3000000000.0 :  3.87938903e-7
                 2438.49098127
                 1.1416971e-10
                 1.42365116e-6
!Z0: 59.0752833923 -9.5903058722
!l: 49422.2003858
4000000000.0 :  3.78215061e-7
                 2570.34268489
                 1.1416976e-10
                 2.52015032e-6
!Z0: 58.0709093689 -7.7127643287
!l: 37707.7273387
5000000000.0 :  3.72487825e-7
                 2667.03909105
                 1.1416981e-10
                 3.9750093e-6
!Z0: 57.4839887869 -6.4676902146
!l: 30474.1681050
6000000000.0 :  3.68807595e-7
                 2743.44379624
                 1.1416988e-10
                 5.77779456e-6
!Z0: 57.1093970925 -5.5804967649
!l: 25561.6961956
7000000000.0 :  3.66290707e-7
                 2808.04700893
                 1.1416997e-10
                 7.95449968e-6
`

Atif07Ali, 2025-02-27:
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

Hello @VolkerMuehlhaus ,

This method works well for short transmission lines. I need to simulate S2P files for an RF CMIM capacitor. Would it be accurate if I replace the series inductor (as per your model) with a capacitor, as shown in this figure?

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

VolkerMuehlhaus, 2025-02-27:
> I need to simulate S2P files for an RF CMIM capacitor. Would it be accurate if I replace the series inductor (as per your model) with a capacitor, as shown in this figure?

Your model would be correct at a single extraction frequency. The series C would represent the effective value from physical C and series inductance due to MIM length. It would be nice to extend the model for MIM, and extract both series C and series L, from values at two frequencies. At low frequency you get series C and at high frequency, you see the increase in effectice C towards self resonance. From data at low frequency and target frequency, you could extract the value of parasitic series L, so that you could create series path with L and C (and R) which is valid rather wideband.

Hope this makes sense?

VolkerMuehlhaus, 2025-02-27:
> using the previously extracted low-frequency capacitance (C).

Yes, basically that's it.

For the C value in your last step, you might see the MIM capacitance in parallel to some capacitance from the shunt path, so you can try to add that if necessary. I would expect that MIM capacitance between the plates is so large that the difference doesn't matter, but wanted to mention this for sake of completeness :-)

Atif07Ali, 2025-02-27:
I will certainly add the shunt capacitance for completeness. For the sake of simplicity, I did not include it in the diagram. Once again, thank you for your help.

Thread 315 (2025-01-03):

Undefined Parameter vbic_cje in NGSpice Netlist Simulation with SG13G2 Model Library

ArashKat, 2025-01-03:
Running the following netlist in ngspice:

* Example NGSpice netlist
* Circuit description
V1 net2 GND DC 3       * Voltage source with 3V DC
R1 net2 net1 1k m=1    * Resistor R1 with value 1k ohm
R2 net1 GND 1k m=1     * Resistor R2 with value 1k ohm
R3 net3 GND 1k m=1     * Resistor R3 with value 1k ohm

* Include the transistor model library
.include "/home/arashka/IHP-Open-PDK/ihp-sg13g2/libs.tech/ngspice/models/sg13g2_hbt_mod.lib"

* Define the transistor subcircuit instance
XQ1 net2 net1 net3 GND npn13G2 Nx=2

Netlist line no. 0:
Undefined parameter [**vbic_cje**]
Netlist line no. 0:
Cannot compute substitute

dwarning, 2025-01-05:
It seems there is something wrong with your input file.
Please attach the full netlist.
BTW: inline comment is ";" - not "*" as shown above.

KrzysztofHerman, 2025-01-05:
@ArashKat
please use `.lib cornerHBT.lib hbt_typ` instead of `.include`.

ArashKat, 2025-01-05:
Thank you; I made many changes even adjusting some variables inside the mod.lib based on information from cornerHBT, and it was working. Then I noticed I was running Xschem in the wrong folder after watching a tutorial on PDK importing another open-source PDK. My problem now is that after running on xschem I do not have the simulation result directly. I should go to the folder containing the spice netlist and run ngspice to see the results. Can you help me with that? Also, as I'm used to Cadence virtuoso, is there any way to import the pdk to Cadence,I tried some basic efforts such as adding pdk folder address to cds.lib in Cadence but I couldn't succeed....

KrzysztofHerman, 2025-01-05:
@ArashKat happy to hear that you have made some progress.
The easiest way to get familiar with the tools and PDK is to fire up xschem in `libs.tech/xschem` directory and review the examples. By default xschem will create a subdirectory called simulations there and it will be used by ngspice as `cwd`

ArashKat, 2025-01-06:
Thank you. Now everything is working for me but I have three questions:

1- Is it possible to see the simulation result directly in Xschem?

2- Is it possible to use this pdk in Cadence

3- What is the nominal voltage for VCC in this technology.? I see VDD is 1.2V. I saw the breakdown voltage in the documents, but not a basic definition, reference, or suggestion for VCC.

Thank you if you please respond to these questions.

KrzysztofHerman, 2025-01-06:
@ArashKat

Great to know that you have managed to make things working.  As for your questions:

1. yes it is possible. You can plot the results using the graph element directly on the schematic. It sources the *.raw file generated by ngspice. Almost all our examples use this method. Alternatively you can use `GAW` waveform editor, which does the same standalone .
2. No, the PDK is targeting open source EDA tools and this is the reason why it is incompatible with Cadence tools. Nevertheless the IHP-Open-PDK is derived from our proprietary product, compatible with Cadence, and if you are with an academic institution you can get access to it free of charge. The requirement is NDA.
3. I suppose you are asking about the standard cells and standard cells supply voltage. The nominal one is 1.2 V however it will work even with 1.5 V (we provide a separate corner liberty file which uses 1.5 V)

sergeiandreyev, 2025-01-07:
> 3- What is the nominal voltage for VCC in this technology.? I see VDD is 1.2V. I saw the breakdown voltage in the documents, but not a basic definition, reference, or suggestion for VCC.

Hi @ArashKat, if you're asking about high-voltage supply level - it's 3.3V

sergeiandreyev, 2025-01-31:
Hi @ArashKat, was the original issue (first description) resolved? If yes, we would like to close this case.
We can have separate discussion in separate 'issue' if you want.

ArashKat, 2025-01-31:
Hello @sergeiandreyev,

Yes, it is over. I will open another issue.

Closed 2025-02-03.

Thread 317 (2025-01-07):

Ngspice cannot run transient with s2p files in matching networks

shafinhossain, 2025-01-07:
## Environment
qucs-s  24.3
ngspice 43

## Expected Behavior
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
Using Ideal Inductors in the matching network of the Power Amplifier (180 GHz) transient simulation and S parameter simulation both are successful.

## Actual Behavior
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
Using openEMS the ideal inductors were replaced by S2P files. But this time the simulator could not run Transient Simulation but does support S parameter simulation.
Note: Only occurs when the inductors in the matching network are replaced by S2P files, however when the RF Choke or Degenerative Inductor is replaced by S2P files, transient does run.

## Steps to Reproduce the Problem

1. Create an amplifier circuit with npn13g2, and proper matching networks (L matching)
2. Replace the inductors in L matching with S2P file.
3. Run transient simulation and see it fail.

KrzysztofHerman, 2025-01-07:
@shafinhossain please se the #314 issue

sergeiandreyev, 2025-01-27:
Hi @shafinhossain, @KrzysztofHerman, so, should we close this issue as 'duplicate'?

Thread 318 (2025-01-07):

Noise Analysis Issue with PDK Resistor in Transimpedance Amplifier Design

rupokdas147, 2025-01-07:
I am designing a Transimpedance Amplifier (TIA) using the PDK and have encountered a significant issue during noise analysis. Below are the details:

Problem Statement:
Noise performance is critical for my TIA design. I initially tested the circuit using ideal resistors and inductors, and the noise levels were in the expected range of **pA/√Hz**. However, upon replacing the ideal resistor with the PDK resistor, the noise levels changed drastically, increasing from **pA/√Hz** to **nA/√Hz**. This discrepancy raises concerns about the accuracy of noise analysis with the PDK resistor.

Simulation Setup:

Simulator: **Ngspice 44**
Schematic Editor: **Qucs-s 24.4.1**

Circuit Details: The design uses a combination of ideal and PDK components. The issue arises specifically when substituting ideal resistors with PDK resistors.

Steps to Reproduce:
Design a TIA circuit in Qucs-s using Ngspice as the simulator.
Perform noise analysis using ideal resistors and note the results (pA/√Hz range).
Replace the ideal resistor with a PDK resistor.
Rerun noise analysis and observe the noise level (nA/√Hz range).

Observed Behavior:
The noise levels jump significantly from the **practical range of pA/√Hz** to an **unrealistic nA/√Hz** after replacing the ideal resistor with the PDK resistor.
There is uncertainty about whether the noise analysis is functioning correctly with the PDK resistor.

Expected Behavior:
The noise levels should remain consistent with practical expectations (in the pA/√Hz range) when using the PDK resistor, assuming it is modeled correctly.
Noise analysis should work properly with PDK components, providing reliable results.

Additional Context:
This issue might indicate an error in the noise model of the PDK resistor or a compatibility issue with Ngspice.
If the noise analysis for the PDK resistor is not supported or requires specific configuration, additional clarification in the documentation would be helpful.

Request for Support:
Could you please investigate if this issue is related to the PDK resistor model or its compatibility with noise analysis in Ngspice? Any guidance on resolving this problem or verifying the noise analysis would be greatly appreciated.

Attachments:
[CE_Buffer_3_noise_analysis.zip](https://github.com/user-attachments/files/18328354/CE_Buffer_3_noise_analysis.zip)
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

KrzysztofHerman, 2025-01-07:
@rupokdas147 thank you for reporting this issue. My first guess is that the ideal resistor do not have flicker noise component and ngspice is only calculating thermal noise spectral density, which is proportional to the actual value of the resistor.
Our resistors models in the PDK contain parameters like `KF, AF, EF`, which extend resistor noise bahavior by a flikcer noise. You can checkout the definitions of the parameters in the chapter `3.3.3`  of the [manual](https://ngspice.sourceforge.io/docs/ngspice-html-manual/manual.xhtml#magicparlabel-2550).

> [!WARNING]
> Please be aware that this flicker noise is only calculated by ngspice, Xyce does not support these extended model by default.

```
.MODEL res_rsil R (DEFW=0.5e-6 RSH=rsh_rsil TC1=3100e-6 TC2=0.3e-6 KF=2.812e-12 AF=1.607 EF=1.267)
.MODEL res_rhigh R (DEFW=1e-6 RSH=rsh_rhigh TC1=-2300e-6 TC2=2.1e-6 KF=5.205e-10 AF=1.935 EF=0.9086)
.MODEL res_rppd R (DEFW=0.5e-6 RSH=rsh_rppd TC1=170e-6 TC2=0.4e-6 KF=4.601e-11 AF=1.886 EF=0.9963)

```
Let us check the numerical values and figure out are calculated correctly.

KrzysztofHerman, 2025-01-07:
@rupokdas147
I have made a simple testcase where the results of the simulation of a resistor divider seem to match for the same value of the resistance ($R_{SH} = 260 \Omega$).

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

rupokdas147, 2025-01-07:
@KrzysztofHerman If it is flicker noise, it should decrease with increasing frequency, shouldn't it?

rupokdas147, 2025-01-07:
@KrzysztofHerman I have used the current source as input in my circuit. So my input noise current spectrum is in A/sqrt(Hz). Which is in the pico range, not in the nano range.

KrzysztofHerman, 2025-01-07:
@rupokdas147  As shown in the equation (16) of the [manual](https://ngspice.sourceforge.io/docs/ngspice-html-manual/manual.xhtml#magicparlabel-2550) the flicker noise should be proportional to ~ $1/f^{EF}$. The previous example was wrong because the resistors had no DC bias. Here goes the update.

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

Anyway still the values are out of range by a few orders of magnitude but this is a simulator issue.

rupokdas147, 2025-01-07:
@KrzysztofHerman Could you provide your schematic?

rupokdas147, 2025-01-08:
@KrzysztofHerman, I found nothing about which noises are calculated using Noise Analysis in the Ngspice 44 manual. I reviewed it again. They did not mention anything about Thermal Noise, Flicker Noise, or Shot Noise. However, in the Transient Analysis, I found Transient Noise, where they mentioned the Flicker noises but I could not find any way to calculate it in Qucs-s. What I found from the Manual:

1.1 Small signal noise

    The noise analysis does analysis device-generated noise for the given
 circuit. When provided with an input source and an output port, the analysis
 calculates the noise contributions of each device (and each noise generator
 within the device) to the output port voltage. It also calculates the input
 noise to the circuit, equivalent to the output noise referred to the
 specified input source. This is done for every frequency point in a specified
 range - the calculated value of the noise corresponds to the spectral density
 of the circuit variable viewed as a stationary gaussian stochastic process.

 1.2 Transient noise

    Time domain noise analysis during transient simulation is enabled by
 providing voltage (and current) source options with white, 1/f and
 random telegraph signal noise signals.

KrzysztofHerman, 2025-01-08:
@rupokdas147 I guess @dwarning can answer this question better.

rupokdas147, 2025-01-08:
I have **manually calculated** the **flicker noise** for **res_rppd** using equations Mentioned in the documents:
[757.pdf](https://github.com/user-attachments/files/18343010/757.pdf)
[chp8.pdf](https://github.com/user-attachments/files/18343019/chp8.pdf)

Taking **DC current** flowing through the resistor is **1 mA**. The flicker noise should be below 1 pA/sqrt(Hz) after 0.1 GHz. I am not sure if I am using the correct equation for the flicker noise.
Also according to my observations from the literature reviewed for TIA design, nobody was concerned about the flicker noise. Everyone tried to minimize the Thermal noise and Shot noise.

rupokdas147, 2025-01-08:
@KrzysztofHerman Thank you for looking into this! I appreciate your effort in addressing the issue.

dwarning, 2025-01-08:
Sorry - I must disagree: Flicker noise follows in problems for mixers, oscillators, in phase noise of pll designs and in many other situations.

In ngspice we are using same formula as in hspice (and may be in spectre):

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

resnoise.c, l. 109:
`                    noizDens[RESFLNOIZ] *= inst->RESm * model->RESfNcoef *
                        pow(fabs(inst->REScurrent / inst->RESm), model->RESfNexp) /
                        (inst->RESeffNoiseArea * pow(data->freq, model->RESef));
`

For the provided test case I got following subexpressions (R=2.654k, Vdc=0.5V, f=100GHz):

`
DC current in resistor r.xrppd2.x1.r1: 1.883599e-04
m: 1.000000e+00
Ncoef: 4.601000e-11
I/m**Nexp: 9.432529e-08
area: 1.006000e-11
area*f**ef: 9.160053e-01
Inoise: 4.737862e-18
`
Taking the sqrt from calculated Inoise and multiplying with resistance we get 5,78e-6 uV/sqrt(Hz) what is in range of the plotted value.
We have to investigate the remaining difference and compare it to other simulator resistor noise modelling.

rupokdas147, 2025-01-08:
@dwarning What are the WF and LF values for the IHP PDK's resistors?

rupokdas147, 2025-01-08:
@dwarning Thank you. Could you please compare the result with a resistor of similar type and dimension in Spectre? I do not have a Cadence license.

rupokdas147, 2025-01-08:
@KrzysztofHerman Is there any restriction for maximum resistor dimension? I need to increase the size of the resistors significantly to minimize the noise.

dwarning, 2025-01-09:
@rupokdas147 Only for information: We investigating the problem and see a difference in geometry scaling between the ngspice an spectre model. As soon we have a solution we will come back.

rupokdas147, 2025-01-10:
I have searched the files in Ngspice and found that the total noise of a resistor is the summation of thermal noise and flicker noise:

`noizDens[RESTOTNOIZ] = noizDens[RESTHNOIZ] + noizDens[RESFLNOIZ];`
File: `resnoise.c`, Line: 114

**Thermal Noise**
Thermal noise is calculated using the equation:
4kT/R

`inoise = 4.0 * CONSTboltz * (ckt->CKTtemp + param2) * param; /* param is the conductance of a resistor */`
File: **nevalsrc.c**, Line: 283

**Flicker Noise**
Flicker noise is calculated using the equation:
(𝑚*𝐾𝐹*(𝐼/𝑚)^𝐴𝐹) / (Area*𝑓^𝐸𝐹)

```
noizDens[RESFLNOIZ] *= inst->RESm * model->RESfNcoef *
                        pow(fabs(inst->REScurrent / inst->RESm), model->RESfNexp) /
                        (inst->RESeffNoiseArea * pow(data->freq, model->RESef));
```
File: `resnoise.c`, Line: 109

**Observation**
The resistor rppd is a p-doped poly-silicon resistor. I searched for articles analyzing noise in poly-silicon-based resistors and found this journal:
https://ieeexplore.ieee.org/abstract/document/925245.

According to the data in the paper, the flicker noise should become lower than thermal noise beyond the kHz frequency range.

However, when I simulated the resistor from the PDK, I observed that the noise aggressively dominates at the 100 GHz range.

Simulation Details
Resistor: 2 kΩ
Dimensions: 4 µm × 32 µm
DC Current: 1 µA
The measured noise current was significantly higher than expected.

dwarning, 2025-01-10:
@rupokdas147
We will change the model to r3_cmc Verilog-A) as it is in the commercial tool next week as pull request for current branch.
As a very raw and quick workaround you can lowering the KF model parameter by a factor of 1e-12 ... 1e-11. Should help you to come further with your initial problem.

ArashKat, 2025-01-21:
Hello, I’m unable to access the commit cca441af96b36954f7e664be34d4d1c2f424de0b that fixes the noise issue. My local repository is up-to-date with the dev branch (last commit: 3a9c016 from Jan 17, 2025). Could you confirm if the fix is in another branch or still pending merge?

Thank you.

dwarning, 2025-01-21:
I just submitted my PR for dev branch of IHP-Open-PDK.
I assume applying the PR will need weeks I would prefer to create a patch from this Pull Request. Try it with this approach: https://coderwall.com/p/6aw72a/creating-patch-from-github-pull-request

Any way - you must have openvaf available, same as for psp103 model.

ArashKat, 2025-01-21:
Thank you, but still i have this error:

Applying: pyprozessor added
error: patch failed: ihp-sg13g2/libs.tech/klayout/python/pypreprocessor:1
error: ihp-sg13g2/libs.tech/klayout/python/pypreprocessor: patch does not apply
Patch failed at 0001 pyprozessor added
hint: Use 'git am --show-current-patch=diff' to see the failed patch
When you have resolved this problem, run "git am --continue".
If you prefer to skip this patch, run "git am --skip" instead.
To restore the original branch and stop patching, run "git am --abort".

ArashKat, 2025-01-21:
git am --show-current-patch=diff
---
 ihp-sg13g2/libs.tech/klayout/python/pypreprocessor | 2 +-
 1 file changed, 1 insertion(+), 1 deletion(-)

diff --git a/ihp-sg13g2/libs.tech/klayout/python/pypreprocessor b/ihp-sg13g2/libs.tech/klayout/python/pypreprocessor
index cf1ff9ba..6ddd5783 160000
--- a/ihp-sg13g2/libs.tech/klayout/python/pypreprocessor
+++ b/ihp-sg13g2/libs.tech/klayout/python/pypreprocessor
@@ -1 +1 @@
-Subproject commit cf1ff9bad0fb5338cf1c5b990b2b816b1ea01a64
+Subproject commit 6ddd5783365718c41eb69bce4428358ace4d1fa2

rupokdas147, 2025-01-22:
@dwarning The verilog-a model of the resistor working fine in low frequency. But, there are difference between calculated input noise and simulated input noise in high frequency.
Simulation Setup:

Simulator: **Ngspice 44.2**
Schematic Editor: **Qucs-s 24.4.1**

### High Frequency:
**Ideal Resistor:**

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

**PDK Resistor:**

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

[res_noise_low_freq.zip](https://github.com/user-attachments/files/18500807/res_noise_low_freq.zip)

### High Frequncy:
**Ideal Resistor:**

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

**PDK Resistor:**

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

[res_noise_high_freq.zip](https://github.com/user-attachments/files/18500811/res_noise_high_freq.zip)

dwarning, 2025-01-22:
I made an update for the PR yesterday. Because nothing else changed, you can use this fix:

[models.zip](https://github.com/user-attachments/files/18502834/models.zip)

@rupokdas147 I will check your testcases later.

rupokdas147, 2025-01-22:
@dwarning The outputs remains same. Please the test cases, I have attached both high frequency and low frequency test case files with the previous comment.

dwarning, 2025-01-22:
@rupokdas147
You must have in mind, that the poly resistors have capacitors on their ends which are modeled very well in our lib. If you comment out these both model parameters ca and cp you get the expected 7nV/sqrt(Hz) white noise.
So at very high frequencies the noise currents are conducted to ground. I am sure that also the signal will be decreased.

ArashKat, 2025-01-22:
In the TIA that I'm designing the input-referred noise in lower frequencies with the poly resistor of the pdk is 10000 times (ten thousand times) more than using the ideal resistor.  I conducted this simple test:

Ideal:

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

Poly:

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

TIA results with poly:

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

TIA without:

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

**I have only one resistor in the TIA**

dwarning, 2025-01-22:
@ArashKat
There are few inconsistencies, e.g. you show flicker noise with the poly resistors but the current sources have 0 A dc.

Anyway - it seems you have the old lib from dev branch. Could you please update in same way as rupokdas147 made. Or you have to wait for dev branch update, evaluation is on the way.

That I got with your testcase:

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

As said, for higher frequencies then 1 GHz the device capacitors to ground comes in play, the model show this effect.

ArashKat, 2025-01-22:
As I mentioned earlier the patch of the PR can not be executed. Also, I used the zip file here in this issue that you mentioned as updated model and simply replace it in this directory: IHP-Open-PDK\ihp-sg13g2\libs.tech\ngspice\models. After running I have the following error:

Error on line:
  n.xr1.nr1 0 0 xr1.2 xr1.dt xr1:res_rppd l=    1.500000000000000e-06     w=    5.060000000000000e-07     m=    1.000000000000000e+00     a1=    5.900000000000000e-13     a2=    5.900000000000000e-13     p1=    2.860000000000000e-06     p2=    2.860000000000000e-06     c1=1 c2=1 trise=    0.000000000000000e+00     sw_et=    0.000000000000000e+00
could not find a valid modelname
    Simulation interrupted due to error!

dwarning, 2025-01-22:
You have to compile the r3_cmc Verilog-A model with openvaf same way as with the psp103 model.
Or you take the zip file from https://github.com/dwarning/VA-Models/releases/tag/v2.2 and use the osdi command in your .spiceint file as shown above.

ArashKat, 2025-01-22:
@dwarning @KrzysztofHerman  I might not installed everything correctly i did it my way and it was working .. now I installed it step by step following the guide and I have this error: Note: Compatibility modes selected: hs a

Circuit: ** sch_path: /home/arashka/ihp-open-pdk/ihp-sg13g2/libs.tech/xschem/sg13g2_tests/dc_hbt_13g2.sch

Too few parameters for subcircuit type "npn13g2" (instance: xxq1)
    Simulation interrupted due to error!                                            Also, when I try ti import resistors from pdk library xschem crushes and exit ......................if someone pls help me.

rupokdas147, 2025-01-23:
@ArashKat I am using Qucs-s for schematic design. I have successfully run the new vlog-a model of the resistor. I can help you if you use Qucs-s.

rupokdas147, 2025-01-23:
@dwarning I have downloaded the verilog-a model of the resistors from https://github.com/dwarning/IHP-Open-PDK/tree/res_r3_model/ihp-sg13g2/libs.tech/verilog-a and Ngspice models from the same repository.
Please let me know if these are the correct models. I am going to close the issue.

dwarning, 2025-01-23:
Yes, same as mine, here with capacitance extraction:

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

You can close. @ArashKat can open an new issue, if needed.

Closed 2025-01-24.

Thread 322 (2025-01-08):

Importing MOS library

ArashKat, 2025-01-08:
The following error exists in simulating MOSs:

**Error** on line:
  n.xm1.nsg13_hv_pmos net2 net1 0 0 xm1:sg13g2_hv_pmos_psp w=    1.000000000000000e-06     l=    4.500000000000000e-07     nf=    1.000000000000000e+00     mult=    1.000000000000000e+00     as=    3.400000000000000e-13     ad=    3.400000000000000e-13     ps=    2.680000000000000e-06     pd=    2.680000000000000e-06     dta=    0.000000000000000e+00     ngcon=2
could not find a valid modelname
    Simulation interrupted due to error!

**the netlist:**

**.subckt dc_hv_pmos
Vgs net1 GND -0.75
Vds net3 GND -1.5
XM1 net2 net1 GND GND sg13_hv_pmos w=1.0u l=0.45u ng=1 m=1
Vd net3 net2 0
.save i(vd)
**** begin user architecture code

.lib /home/arashka/IHP-Open-PDK/ihp-sg13g2/libs.tech/ngspice/models/cornerMOShv.lib mos_tt

.param temp=27
.control
save all
op
print I(Vd)
dc Vds 0 -2 -0.01 Vgs -0.45 -1.1 -0.05
write dc_hv_pmos.raw
.endc

**** end user architecture code
**.ends
.GLOBAL GND

KrzysztofHerman, 2025-01-09:
@ArashKat please verify your PDK installation.  Please checkout [this manual](https://ihp-open-pdk-docs.readthedocs.io/en/latest/analog/xschem.html). The core issue is probably:
1. you do not have the osdi model comiled
2. your `./home/$user/.spiceinit` file does not exists

Our MOS devices use PSP model written in Verilog-A, we distribute source code but the user have to compile it using open source tool openvaf. The binary have to be placed in `$PDK_ROOT/libs.tech/ngspice/openvaf`
and `.spiceinit` have to point to this location.

ArashKat, 2025-01-27:
Hello the manual was very helpful ... it solved the issue: however it doesn't recognize the resistors; Xschem crashes and suddenly will be closed when I select a pdk's resistor.

sergeiandreyev, 2025-01-29:
Hi @KrzysztofHerman, could you please take a look?

ArashKat, 2025-01-29:
For me, the problem is that after running the install.py I did not create any  r3_cmc file .... I added them manually using this link: https://github.com/dwarning/VA-Models/releases/tag/v2.2  by copying the VA-Models-osdilibs.zip file to $PDK_ROOT/$PDK/Lib.tech/ngspice/openvaf  directory and added the following command: osdi  '$PDK_ROOT/$PDK/libs.tech/ngspice/openvaf/osdilibs/r3_cmc.osdi' to .spiceinit in $HOME still Xschem jump out when I select the resistors

sergeiandreyev, 2025-03-17:
and please note that in the latest `dev` branch we changed the default location of osdi models to:
`osdi  '$PDK_ROOT/$PDK/libs.tech/ngspice/osdi/r3_cmc.osdi'`

Thread 323 (2025-01-09):

Discrepency between Ngspice and Xyce simulation

adrienluitot, 2025-01-09:
## Environment
**OS:** Ubuntu  24.04
**Tools:** Qucs 24.4.1
**Simulator:** Ngspice-44  and  Xyce 7.8

## Expected Behavior
Having similar simulation results between Xyce and Ngspice.

## Actual Behavior
We are designing a simple LNA at 2.45GHz. Here is its schematic and some ngspice simulation results:
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
On the right we see the Re(Z11) is 47.047Ω (with Ngspice).

When I run the same design, with the same parameters/variables, and the same simulation, but with Xyce, I get these results:
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
The discrepancy is not negligible here, mostly for Re(Z11), almost 10% difference.

For other results, there is not such a discrepancy, for instance, gain is pretty similar: 15.531dB for Ngspice and 15.561dB for Xyce.

I don't know if the error comes from:
- Me (Xyce installation maybe ?)
- Ideal components (maybe Xyce and Ngspice treat R,L,C slightly differently -> I will soon try with IHP's real components)
- Discrepancy between IHP's Ngspice and Xyce models
- Something else

## Steps to Reproduce the Problem
1. Create a schematic in Qucs
2. Simulate with Ngspice
3. Copy whole schematic (design, parameters, simulations)
4. Adapt to Xyce (include & plugin)
5. Simulate with Xyce

KrzysztofHerman, 2025-01-09:
@adrienluitot thank you for reporting this issue.
Since you use mosfets my first guess is that ngspice and Xyce use different Verilog-A compilers, `openvaf` and 'adms' respectively,  in order to make PSP binary. Moreover you operate at relatively high frequencies, where the `non quasi static` PSP model part  was disabled because of the `openvaf` compiler issues, what can bring us to this situation. If you wish you could investigate in this direction.

adrienluitot, 2025-01-10:
> @adrienluitot thank you for reporting this issue. Since you use mosfets my first guess is that ngspice and Xyce use different Verilog-A compilers, `openvaf` and 'adms' respectively, in order to make PSP binary. Moreover you operate at relatively high frequencies, where the `non quasi static` PSP model part was disabled because of the `openvaf` compiler issues, what can bring us to this situation. If you wish you could investigate in this direction.

Thanks for your reply! Indeed that may be the compiler, but I believe that the compilers should follow the models? So that it should rely more on the models rather than the compilers?

I don't know much about `non quasi static`, can you tell me more about it?
It would a pleasure to investigate, but I don't really know where to go. If you have any direction, that would be great!

KrzysztofHerman, 2025-01-10:
@adrienluitot thank you for your interest.  If you wish you could simplify the circuit and lower the frequency by a decade and then see the results. This way we could discard `nqs`.  Our experience is that in general you will face differences between the simulation results using ngspice an Xyce.

adrienluitot, 2025-01-15:
Sorry for the late answer. So I used the schematic given above and run the simulation with Ngspice and Xyce around 2.45GHz, 245MHz and 24.5MHz. And here is what I had:

2.45GHz:
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

245MHz:
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

24.5MHz:
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

Sure the discrepancy is more present (in percentage at least) at high frequency, but it seems also present at lower frequencies.

Thread 324 (2025-01-10):

GSG / RF Signal Pad and DC Pads Missing

Ikram-rs22, 2025-01-10:
For RF design from DC to W /D band , the NPN13G2 HBTs are excellent. But a predicament is posed as in the layout section there is no pycell for the DC bias pad and the RF signal pad. The RF input & output signal paths need GSG pads. Also, for RF design, Qucs-s provides cap_rfcmim schematic symbol but there is no pycell for it in klayout.

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

Although there are some bondpad and cupillar pad, these are not RF pads in the sg13g2_pr gds., The rf_cmim cell is also present here but there is no sg13g2_pr tech file for the library. So the pads are absent in both cases.

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

RF and DC pads are must for RF design for TIA designs ranging from DC-140 GHz & beyond.

giove11, 2025-01-13:
Hi, about the pads, everyone design their own pads and simulated them, which is why there is no pcell for a GSG pads.
About the cap_rfcmim I don't know.

olisnr, 2025-01-13:
i would draw the PADs my self, and try to make transmission lines with the right impedance. PADs alone wont be help full. may be You have to look to Your RF-wafer probe for the dimensions. and simulate the impedances.

Ikram-rs22, 2025-01-13:
okay so what layers do I need for the pads? Transmission lines are a simple process but a GSG pad, especially if you're designing something from DC-150 GHz isn't an easy task to make. Would appreciate any further elaboration

KrzysztofHerman, 2025-01-13:
@Ikram-rs22 we have recently provided a pyCell for a bondpad so you can easily generate or walk through the code to figure out which layers you need.

shafinhossain, 2025-01-16:
@KrzysztofHerman We were actually willing to test our chips at IHP facility, and in order to do that we require certain information about the pads.
1. Pitch size (i.e. 30 um/50 um)
2. Dimension of the pads
(note: our designs have two frequency ranges, one being DC to 130 GHz and the G band (140-220 GHz)).
Additionally, if further communication with IHP personnel involved in testing is necessary, kindly let us know.

KrzysztofHerman, 2025-01-16:
@shafinhossain please refer to the `SG13G2_layout_rules.pdf` document You can find it in our PDK under `ihp-sg13g2/libs.doc/doc` directory.

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

1. `Pad.bR` min. pad spacing is 8,4
2. it can be customized. In our dev branch you will find a dedicated pyCell called `bondpad` which implements it.

sergeiandreyev, 2025-01-17:
Hi @Ikram-rs22, the `rfcmim` Pycell is available in the `dev` branch, please check and give your feedback

Ikram-rs22, 2025-01-17:
@sergeiandreyev yes I've already checked it out. Also thanks for incorporating the capacitance value update feature with dimensional changes.

sergeiandreyev, 2025-01-29:
Hi @Ikram-rs22, so is there anything else you want to add to this issue, or we can close it?

Ikram-rs22, 2025-01-29:
You can close this issue. I'll have to come up with my own solutions. Thanks for your efforts.

Closed 2025-01-29.

Thread 325 (2025-01-10):

Query about RF Layout in KLayout

Ikram-rs22, 2025-01-10:
I have some queries about RF layout in this pdk rule -

1) Like cadence, is the black portion of the screen considered as global p substrate?

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

2) About guard rings, is the HBT inside a guard ring? How do we create a guard ring for the resistors as the bulk connection is sub! ? The layers needed for creating a guard ring. Is the layers in the ptap pycell the ones for creating a guard cell?

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

3) Regarding the metal shielding in RF designs, is it a problem to have a global metal shielding for the routing paths and pycells or does it need to be chopped ? Is there any layer which will prevent the respective area where it is drawn from being covered in the global metal shielding meaning that part won't be counted in the shielding??

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

KrzysztofHerman, 2025-01-14:
@Ikram-rs22
As for your questions:
1) SG13G2 is a bulk process and the wafer is `p-type` substrate so I can confirm that when you lay out your devices you effectively place it on the substrate.
2)  We found out that there is a requirement from the designers to have such cell as guard ring. Please take a look at this [branch](https://github.com/KrzysztofHerman/IHP-Open-PDK/tree/ptap1-ntap1-fix) you can find there xschem symbols, ngspice models and klayout pycells of such devices. Soon it should be integrated in the dev branch. Please keep in mind that the guard ring is a modeled as a resistance between the particular net (usually GND) and the substrate.
3) As for metal shielding you have a free hand here. Just keep in mind the slit rules. `"Large areas of metal are subject to mechanical stress during production. This can cause metal detachment from the oxide. The use of metal slits leads to reduction of mechanical stress."` (chapter 7.3 sg13g2_Layout_Rules manual)

Atif07Ali, 2025-01-15:
@KrzysztofHerman
There is a layer in KLayout called NoRCX. For instance, if I place a metal2 layer on top of Metal1 without using any vias, should I use the NoRCX layer? I am designing an LNA at 170 GHz

sergeiandreyev, 2025-01-31:
Hi @Ikram-rs22, do you have more questions on the above items, or we can close the issue?

Ikram-rs22, 2025-01-31:
Please kindly close this issue

Closed 2025-01-31.

Thread 327 (2025-01-11):

Unable to use PMOS with XYCE

EngGhaith, 2025-01-11:
## Environment
Xschem & XYCE
Using dev-Branch of IHP Open PDK
## Expected Behavior
Simulation runable

## Actual Behavior
XYCE Abort with this message:
_Netlist error in file
 /foss/pdks/sg13g2/libs.tech/xyce/models/sg13g2_moslv_mod.lib at or near line 86
 Unrecognized parameter D for device YPSP103_VA!M1
Netlist error in file
 /foss/pdks/sg13g2/libs.tech/xyce/models/sg13g2_moslv_mod.lib at or near line 86
 Unrecognized fields for device YPSP103_VA!M1
Netlist error in file
 /foss/pdks/sg13g2/libs.tech/xyce/models/sg13g2_moslv_mod.lib at or near line 86
 Unrecognized parameter D for device YPSP103_VA!M1
Netlist error in file
 /foss/pdks/sg13g2/libs.tech/xyce/models/sg13g2_moslv_mod.lib at or near line 86
 Unrecognized fields for device YPSP103_VA!M1
Simulation aborted due to error.  There are 0 MSG_FATAL errors and 4 MSG_ERROR
 errors
*** Xyce Abort ***_

## Steps to Reproduce the Problem
[TEST_PMOS.zip](https://github.com/user-attachments/files/18386566/TEST_PMOS.zip)
Use this Nelist or simulate the Xschem-Schematic TEST_PMOS.sch:

V1 net1 0 2.4
XM1 net2 net2 net1 net1 sg13_lv_pmos w=1.0u l=1.0u ng=1
XM2 net3 net2 net1 net1 sg13_lv_pmos w=1.0u l=1.0u ng=1
R1 net2 0 1k
R2 net3 0 1k
**** begin user architecture code

.TRAN 1p 20n
.PRINT TRAN FORMAT=RAW FILE=TEST_PMOS_TRAN.raw V(*) I(*)

.lib /foss/pdks/sg13g2/libs.tech/xyce/models/cornerMOSlv.lib mos_tt

**** end user architecture code
**.ends
.end

EngGhaith, 2025-01-11:
NMOS seem to have same problem!

eskiyerli, 2025-01-11:
I think the problem is that the IHP has chosen to use Verilog-a models within Xyce models. Interestingly, Xyce distribution does not include a Verilog-A compiler. It can be only compiled on Linux as a plugin, but not on Windows. I was just scratching my head about the same problem. As it stands, IHP model libraries are not compatible with Xyce as distributed by Sandia.

EngGhaith, 2025-01-11:
@eskiyerli
Iam not sure if that is the problem, because I am using Linux and MOSFETs do not work on Linux too.

eskiyerli, 2025-01-11:
@EngGhaith If you are using the Xyce binaries downloaded from Sandia, they don't include the Verilog-A plugin either.

EngGhaith, 2025-01-11:
@eskiyerli
Do you have any manual to include this Plugin at Linux?

eskiyerli, 2025-01-11:
This is the PKGBUILD file I am using for Manjaro:
# Maintainer: Your Name <your.email@example.com>
pkgname=xyce
pkgver=7.8.0
pkgrel=1
pkgdesc="An open source, SPICE-compatible, high-performance analog circuit simulator"
arch=('x86_64')
url="https://xyce.sandia.gov/"
license=('GPL3')
depends=('trilinos-xyce' 'boost-libs' 'openmpi' 'fftw' 'suitesparse')
makedepends=('cmake' 'gcc' 'gcc-fortran' 'boost' 'python')
optdepends=('python: for Python scripting support')
source=("https://github.com/Xyce/Xyce/archive/Release-"$pkgver".tar.gz")
sha256sums=('f763b7d5ad6defd25d2c7e5cc95155958cd12510a5e22a179daab459b21fa713')  # Replace with actual SHA256 sum of the source tarball

build() {
  cd "${srcdir}/Xyce-Release-${pkgver}"
  mkdir -p build && cd build
  cmake  .. \
    -D CMAKE_INSTALL_PREFIX=/usr \
    -D CMAKE_BUILD_TYPE=Release \
    -D BUILD_SHARED_LIBS=ON \
    -D Xyce_PLUGIN_SUPPORT=ON
  make
}

package() {
  cd "${srcdir}/Xyce-Release-${pkgver}/build"
  make DESTDIR="${pkgdir}" install
  rm "${pkgdir}/usr/bin/admsXml"
}

eskiyerli, 2025-01-11:
There is also this information in adms folder about how to use this with xschem:
buildxyceplugin psp103.va .
cp Xyce_Plugin_PSP103_VA.so ../xschem/simulations/
mv Xyce_Plugin_PSP103_VA.so ../xschem/examples/

eskiyerli, 2025-01-11:
Finally success. Using make file in adms directory produces libXyce_Plugin_PSP103_VA.so linkable file. Copy it to same directory as your netlist file. For example, to examples directory. Then start Xyce with --plugin option:
Xyce -plugin ./libXyce_Plugin_PSP103_VA.so lv_nmos_id_vg_vb.cir

KrzysztofHerman, 2025-01-12:
@EngGhaith were you able to compile the shared object and run the simulation ? Indeed we use PSP model which should be compiled using sources distributed within the PDK. Due the `adms` and/or `openvaf` limitations  the sources may have modifications. Additionally due to the license issues we are not allowed to distribute the binary `.so` file so you have to compile it on your site.

EngGhaith, 2025-01-13:
I could use it in bare Xyce.
But I could not integrate it with Xschem.
I copied the Plugin: Xyce_Plugin_PSP103_VA.so to ihp-sg13g2/libs.tech/xschem/simulations/.
But it did not work.

KrzysztofHerman, 2025-01-13:
@EngGhaith in our dev branch you will find some examples where you can simulate either using ngspice or Xyce.

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

The plugin is added in the `SimulateXyce` launcher
```
set sim(spice,3,cmd) {Xyce -plugin $env(PDK_ROOT)/$env(PDK)/libs.tech/xyce/plugins/Xyce_Plugin_PSP103_VA.so \"$N\"}
```

EngGhaith, 2025-01-13:
Now it works!
Thank you very much!

KrzysztofHerman, 2025-01-13:
I will close as solved.

Closed 2025-01-13.

Thread 328 (2025-01-13):

Plotting MOS gm with Xyce

adrienluitot, 2025-01-13:
Hello everyone,

I tried to plot a MOS gm (and other variables) with Xyce (and Qucs-s).
In https://xyce.sandia.gov/files/xyce/Xyce_Reference_Guide_7.6.pdf I saw we can use `N(XMN0:gm)` in `.PRINT`. But it doesn't work, I get `Netlist error: Function or variable N(MN0:GM) is not defined`.

I think the syntax might be different because of ADMS?
Anyone knows the right syntax?

KrzysztofHerman, 2025-01-14:
@adrienluitot seems that the method you have found applies to BSIM3 and BSIM4 models. I have run a simple test which dumps all the PSP model and instance parameter. Additionally there is no `gm` parameter. I have also asked a question on the open source silicon slack channel. [Here](http://open-source-silicon.slack.com) you can join:

```
** sch_path: /home/herman/tmp/xyce_op.sch
**.subckt xyce_op
Vin in GND pulse(0.0 1.2 0.0 100p 100p 2n 4n)
Vdd net1 GND 1.2
XM1 out in GND GND sg13_lv_nmos w=1.0u l=0.45u ng=1
XM2 out in net1 net1 sg13_lv_pmos w=1.0u l=0.45u ng=1
**** begin user architecture code
.preprocess replaceground true
.option temp=27
.op
.print tran format=raw file=tran_logic_not.raw
.lib /home/herman/github/KrzysztofHerman/IHP-Open-PDK/ihp-sg13g2/libs.tech/xyce/models/cornerMOSlv.lib mos_tt
**** end user architecture code
**.ends
.GLOBAL GND
.end

```

```
------------------------------------------------------------
Operating point information:
Number of ADMS PSP103_VA models: 2
          name XM1:SG13G2_LV_NMOS_PSPXM2:SG13G2_LV_PMOS_PSP
          type       PSP103_VA      PSP103_VA
         level               1              1
            DTA              0              0
         FJUNQD           0.03           0.03
       VJUNREFD            2.5            2.5
          FJUNQ           0.03           0.03
       SWJUNEXP              0              0
        PBRSTID              4              4
        PBRBOTD              4              4
        VBRGATD             10             10
        VBRSTID             10             10
        VBRBOTD             10             10
     STFBBTSTID         -0.001         -0.001
     STFBBTBOTD         -0.001         -0.001
      FBBTRSTID          1e+09          1e+09
      FBBTRBOTD          1e+09          1e+09
       CBBTSTID          1e-18          1e-18
       CBBTBOTD          1e-12          1e-12
    MEFFTATGATD           0.25           0.25
       CTATGATD         0.0001         0.0001
       CTATSTID         0.0001         0.0001
       XJUNGATD          1e-07          1e-07
       XJUNSTID          1e-07          1e-07
       CSRHGATD         0.0001         0.0001
     IDSATRGATD          1e-18          1e-18
       PHIGSTID           1.16           1.16
       PHIGBOTD           1.16           1.16
          PGATD            0.5            0.5
       VBIRGATD              1              1
       VBIRSTID              1              1
       CJORGATD          1e-09          1e-09
       CJORSTID          1e-09          1e-09
       CJORBOTD          0.001          0.001
         PBRGAT              4              4
         PBRSTI              4              4
       CBBTGATD          1e-18          1e-18
         PBRBOT              4              4
         VBRSTI             10             10
         VBRBOT             10             10
      STFBBTSTI         -0.001         -0.001
      STFBBTBOT         -0.001         -0.001
       FBBTRGAT          1e+09          1e+09
        CBBTBOT          1e-12          1e-12
     MEFFTATGAT           0.25           0.25
     MEFFTATSTI          3.364          4.363
     MEFFTATBOT          5.204             10
        CTATGAT         0.0001         0.0001
        CTATBOT            100            100
        CSRHSTI         0.0001         0.0001
      IDSATRSTI     1.9278e-15     1.1115e-15
           PSTI        0.27362         0.2548
           PBOT        0.31309         0.3618
        VBIRSTI        0.79368         1.7036
        VBIRBOT        0.70829         0.7686
        CJORGAT          3e-11     2.7474e-11
            TRJ             21             21
           IMAX      0.0015358      0.0016551
        LODETAO              1              1
     IDSATRSTID          1e-18          1e-18
         STETAO              0              0
        WLODVTH              0              0
        LLODVTH              0              0
        CJORBOT     0.00097636     0.00086306
         WKVTHO              0              0
         LKVTHO              0              0
     STFBBTGATD         -0.001         -0.001
          KVTHO              0              0
        WLODKUO              0              0
           WKUO              0              0
           LKUO              0              0
           TKUO              0              0
           WLOD              0              0
          SBREF          1e-06          1e-06
          SAREF          1e-06          1e-06
         RJUNDO              0              0
         RJUNSO              0              0
         RWELLO              0              0
          DLSIL              0              0
           RSHG              0              0
           RINT     1.3025e-11          1e-12
            RGO              0              0
         KUOWEL              0              0
         KUOWEO              0              0
      KVTHOWELW              0              0
       KVTHOWEO              0              0
        EFEDGEO              1              1
      NFCEDGELW              0              0
      NFAEDGELW          8e+22          8e+22
       FNTEDGEO              1              1
      PSCEEDGEW              0              0
           RSHD              0              0
   PSCEEDGELEXP              2              2
     STBETEDGEW              0              0
       BETEDGEW              0              0
        CTEDGEL              0              0
        CTEDGEO              0              0
      NSUBEDGEO          5e+23          5e+23
        PHIGGAT           1.16           1.65
     DPHIBEDGEW              0              0
     DPHIBEDGEL              0              0
         PKVTHO              0              0
     DPHIBEDGEO              0              0
    STVFBEDGELW              0              0
     STVFBEDGEL              0              0
          WEDGE          1e-08          1e-08
         ALPNOI          1.869          2.118
        LINTNOI       -3.7e-08          1e-08
          NFCLW         -5e-08      5.641e-07
          NFALW      7.616e+25      2.209e+26
        XJUNSTI     1.5783e-07      6.292e-08
        FNTEXCL              0              0
       VBIRBOTD              1              1
          CFRDW              0              0
           CFRW          2e-16          1e-16
         CGIDLO        0.06641        0.02068
          SCREF          1e-06          1e-06
      STBGIDLDO              0              0
       STBGIDLO              0     -0.0014941
         BGIDLO          19.92          15.12
        AGIDLDW              0              0
          NFBLW      1.026e+09      5.723e+08
         AGIDLW       0.001262      7.371e-05
         KUOWEW              0              0
           GC2O         0.8413        0.54762
          STIGO         2.9949         2.3506
         IGOVDW              0              0
        IGINVLW         184049        5066.33
           PKUO              0              0
           GCOO             10        0.01231
            A4L              0         0.2771
            A3O          0.708          1.526
          STA2O       0.068723              2
     NSUBEDGELW              0              0
            A2O          17.75          13.33
            A1W      -0.052179           5.78
            A1L       0.052176          5.741
            VPO        0.32224     7.3803e-06
         ALP2L2              0              0
       ALP1LEXP           0.25         0.6408
         ALP1L1       0.021138      0.0040221
        ALPLEXP        0.68143         0.8468
       THESATBO        0.08213              0
   NSUBEDGELEXP              1              1
     STTHESATLW        0.01292        0.07117
      STTHESATW      -0.065908      -0.047465
      STTHESATL      -0.091893        -1.9651
          PWALP              0              0
           ALPW         1.0825       -0.21042
           PWAX              0              0
           PLAX              0              0
          RJUND              0              0
          PLALP              0              0
          LVARO              0      9.695e-08
            RSB              0              0
      PLTHESATB              0              0
            RSH              0              0
          PLWCF              0              0
      POTHESATB              0              0
        PBRGATD              4              4
           POA4              0              0
           POAX              3              3
          PLCFR              0              0
         ALP2L1         2.6817       0.005286
       PLTHESAT              0              0
         TOXOVO     2.2404e-09     1.9704e-09
           PLA3              0              0
         RBULKO              0              0
          PORSB              0              0
           CGOV          1e-15          1e-15
           PLRS              0              0
       CSRHBOTD            100            100
       SWJUNCAP              3              3
          IGOVD              0              0
        XJUNGAT         0.0001      9.105e-05
   PLWFACNEFFAC              0              0
        POTHEMU            1.5            1.5
        POCGIDL              0              0
      PLNFAEDGE              0              0
     PWSTTHESAT              0              0
         PLWMUE              0              0
           FREV           1000           1000
        DELVTAC              0              0
           POA1              1              1
          PWMUE              0              0
     STBETEDGEL              0              0
        PWSTBET              0              0
          PLWCS              0              0
        POSTBET              1              1
        PLWBETN              0              0
            QMC              1              1
        CJORSTI     2.5279e-11     3.1915e-11
           PLA4              0              0
        NFCEDGE              0              0
      STTHESATO         2.7784         12.733
          CHIBO            3.1            3.1
         PWBETN              0              0
         PLBETN              0              0
          STBET              1              1
         POBETN           0.07           0.07
       PLWKUOWE              0              0
    PODPHIBEDGE              0              0
      PLKVTHOWE              0              0
        POPSCED              0              0
       CFBEDGEO              0              0
          POCFB              0              0
         POSTRS              1              1
          PBOTD            0.5            0.5
          FBET2         -2.302         -6.171
           POCF              0              0
        LLODKUO              0              0
        PLSTBET              0              0
    PLSTBETEDGE              0              0
             A1              1              1
           PLCT              0              0
         PLALP2              0              0
         PONOVD          5e+25          5e+25
          PONOV          5e+25          5e+25
          FETAO              1              1
     POSTTHESAT              1              1
      PLWFNTEXC              0              0
        EPSROXO            3.9            3.9
       KVTHOWEW              0              0
           PLCF              0              0
       POTOXOVD          2e-09          2e-09
        NFBEDGE          3e+07          3e+07
    POSTVFBEDGE              0              0
      PWDELVTAC              0              0
      PODELVTAC              0              0
       STTHECSO              0              0
      DPHIBEDGE              0              0
       PLWDPHIB              0              0
     FACNEFFACO              1              1
        PLDPHIB              0              0
      PLWCFEDGE              0              0
        POVNSUB              0              0
         POCHIB            3.1            3.1
    PWSTVFBEDGE              0              0
     STVFBEDGEW              0              0
      PWGFACNUD              0              0
       PLWSTBET              0              0
            CFL     8.9001e-08     0.00011247
    POFACNEFFAC              1              1
         PWNEFF              0              0
          PLWNP              0              0
         PONEFF          5e+23          5e+23
       PLWSTVFB              0              0
      NSUBEDGEW              0              0
          ALP1W      -0.077622      -0.057981
        POBGIDL             41             41
          XCORO       0.053934       0.092591
        PWSTVFB              0              0
         ST2VFB              0              0
          PSCEL              0              0
         POSTCT              1              1
           PWNP              0              0
          CGBOV              0              0
      PODVSBNUD              1              1
        KUOWELW              0              0
          AGIDL              0              0
        POSTVFB         0.0005         0.0005
         PLWVFB              0              0
        CBBTSTI          1e-21          1e-21
          PLVFB              0              0
           LPCK      3.171e-07     1.1576e-10
          POVFB             -1             -1
          PWCOX              0              0
         STXCOR              0              0
        PLWXCOR              0              0
     PLNEFFEDGE              0              0
         PLNOVD              0              0
          SWNUD              0              0
             CS              0              0
         STMUEO        0.98971        0.84805
          WVARO              0              0
      PSCEBEDGE              0              0
           RSW1           93.6        538.377
          PSCEB              0              0
         CTEDGE              0              0
         RVPOLY              0              0
     PSCEDEDGEO              0              0
            RSE              0              0
            EFO              1              1
         PSCEBO              0              0
         PWXCOR              0              0
        PWDPHIB              0              0
           PSCE              0              0
             EF              1              1
          POALP           0.01           0.01
     PLWTHESATB              0              0
     PWNEFFEDGE              0              0
            WEC              0              0
            CFB              0              0
          PWNOV              0              0
      STFBBTGAT         -0.001         -0.001
          THECS              2              2
           NOVD          5e+25          5e+25
    POPSCEBEDGE              0              0
        NFAEDGE          8e+22          8e+22
     PLWGFACNUD              0              0
             CF              0              0
        VFBEDGE             -1             -1
         SWGIDL              1              1
      PLTHESATG              0              0
      PLWTHESAT              0              0
          RBULK              0              0
       POSTXCOR              0              0
           CFRD              0              0
           STRS              1              1
         PLWCFR              0              0
         PWCFRD              0              0
          STMUE              0              0
          DNSUB              0              0
            FNT              1              1
          WVARL              0              0
          POMUE            0.5            0.5
             CT              0              0
            MUE            0.5            0.5
          PLWCT              0              0
           POCS              0              0
            VFB             -1             -1
    DPHIBEDGELW              0              0
          PWNFA              0              0
       POST2VFB              0              0
         TOXOVD          2e-09          2e-09
        VSBNUDO              0              0
          PLWA3              0              0
     PWPSCEEDGE              0              0
          POCTG              0              0
          RJUNS              0              0
     STBETEDGEO              1              1
       SWIMPACT              1              1
            NFB          3e+07          3e+07
         POFETA              1              1
      SWJUNASYM              0              0
             TR             27             27
        CGIDLDO              0              0
          STRSO       -0.49693        -0.3508
            TOX          2e-09          2e-09
     IDSATRBOTD          1e-12          1e-12
        CFEDGEL              0              0
      PSCEEDGEL              0              0
           STCT              1              1
  DPHIBEDGELEXP              1              1
        POTHECS              2              2
        DVSBNUD              1              1
        STTHECS              0              0
           WSEG     5.3426e-06      1.058e-08
     PLWDELVTAC              0              0
          SWIGN              1              1
       DELVTACW              0              0
         CGIDLD              0              0
        GFACNUD              1              1
           PWCF              0              0
         PLCFRD              0              0
       KVTHOWEL              0              0
     PSCEBEDGEO              0              0
      POSTTHEMU            1.5            1.5
         PLCGOV              0              0
            WEB              0              0
      PWTHESATG              0              0
            NFC              0              0
       PWCTEDGE              0              0
         XCORLW      -0.014959       0.029574
         CGBOVL     4.4409e-28      2.186e-17
          PLWA4              0              0
         PWNOVD              0              0
           STCS              0              0
       CFDEDGEO              0              0
       PLWIGINV              0              0
       CSRHSTID         0.0001         0.0001
       POCTEDGE              0              0
         PONSLP           0.05           0.05
XYCEADMSMODTEMP         300.15         300.15
          PORSG              0              0
        PLWNOVD              0              0
           PWA3              0              0
          LEVEL            103            103
           BETN           0.07           0.07
          PONFB          3e+07          3e+07
        STTHEMU            1.5            1.5
           CHIB            3.1            3.1
        PLWCFRD              0              0
           GC3O        -0.4698       -0.29543
           PWCT              0              0
          PLWAX              0              0
          ALP2W       -0.13012       0.063581
           NEFF          5e+23          5e+23
         EPSROX            3.9            3.9
        CTATSTI         0.0001         0.0001
    PLWSTTHESAT              0              0
          THEMU            1.5            1.5
        POCGOVD          1e-15          1e-15
         THESAT              1              1
           NSLP           0.05           0.05
      PLWAGIDLD              0              0
        SWIGATE              1              1
          BGIDL             41             41
          CGOVD          1e-15          1e-15
        PHIGBOT         1.1136          1.204
     STVFBEDGEO         0.0005         0.0005
       POTHESAT              1              1
          LVARL              0       -0.03438
          DPHIB              0              0
            A1O          6.239      0.0001107
          POCFR              0              0
         VSBNUD              0              0
      SWDELVTAC              0              0
        CFBEDGE              0              0
          SWGEO              1              1
             AX              3              3
         SWEDGE              0              0
           XCOR              0              0
           STA2              0              0
        PLWALP2              0              0
         CFEDGE              0              0
        PLWNEFF              0              0
            NFA          8e+22          8e+22
       STTHESAT              1              1
            AXL         1.0186        0.58095
     PLWTHESATG              0              0
        FNTEDGE              1              1
        PLSTVFB              0              0
      PONFAEDGE          8e+22          8e+22
         POSTCS              0              0
            NOV          5e+25          5e+25
         PLPSCE              0              0
            CFD              0              0
            NPO     4.6457e+26     1.2699e+26
        THESATG              0              0
           ALP2              0              0
           ALPL      0.0088345      0.0047346
        PWIGOVD              0              0
           PONP          1e+26          1e+26
    PWDPHIBEDGE              0              0
          PWVFB              0              0
         PLWNFC              0              0
           CFDO              0              0
       BETNEDGE         0.0005         0.0005
             VP           0.05           0.05
           WMAX              1              1
         VBRGAT             10             10
       PSCEEDGE              0              0
         POXCOR              0              0
        POSTMUE              0              0
           CTLW       0.008767      -0.014902
             A3              1              1
       FBBTRSTI          1e+09          1e+09
         BGIDLD             41             41
       PLWCGBOV              0              0
          PWNFC              0              0
    PLFACNEFFAC              0              0
             A4              0              0
           PLNP              0              0
       PLWAGIDL              0              0
          IGINV              0              0
           PLCS              0              0
             A2             10             10
         POALP1              0              0
           STIG              2              2
         LPEDGE          1e-08          1e-08
         POCGOV          1e-15          1e-15
        PODNSUB              0              0
            GC2          0.375          0.375
           RSW2              0      -0.088444
          POTOX          2e-09          2e-09
       FBBTRBOT          1e+09          1e+09
          RWELL              0              0
            CSL        0.12341        0.34682
            GC3          0.063          0.063
         AGIDLD              0              0
            CFR              0              0
      PWTHESATB              0              0
      PSCEDEDGE              0              0
           POCT              0              0
          NSLPO           0.05           0.05
        STBGIDL              0              0
    PWSTBETEDGE              0              0
          CGIDL              0              0
            ALP           0.01           0.01
            LAP     2.9423e-08     2.5254e-08
            COX          1e-14          1e-14
         PLXCOR              0              0
          STVFB         0.0005         0.0005
     FACNEFFACL              0              0
          PLNFB              0              0
          POCFD              0              0
      POTHESATG              0              0
      PLDELVTAC              0              0
            CTB              0              0
         FNTEXC              0              0
        POTOXOV          2e-09          2e-09
        PLWCGOV              0              0
         DPHIBO      -0.255182     -0.0897841
      NSUBEDGEL              0              0
         PWALP1              0              0
       POEPSROX            3.9            3.9
      PLGFACNUD              0              0
      STVFBEDGE         0.0005         0.0005
           PWRS              0              0
           FETA              1              1
       ALP2LEXP           0.25           0.25
       NEFFEDGE          5e+23          5e+23
        POPSCEB              0              0
            DWQ         -1e-08        1.5e-08
        CFDEDGE              0              0
            GCO              0              0
      POGFACNUD              1              1
            RDE              0              0
        PLIGOVD              0              0
         EFEDGE              1              1
         PLALP1              0              0
          PONFA          8e+22          8e+22
           WBET     5.9171e-08      5.424e-10
          POCTB              0              0
        PLWALP1              0              0
         POALP2              0              0
           POA3              1              1
           POVP           0.05           0.05
        CSRHBOT            100            100
    FACNEFFACLW              0              0
           PLA1              0              0
          PLWA1              0              0
         POCFRD              0              0
           POA2             10             10
      IDSATRGAT              0              0
     PLSTTHESAT              0              0
         POSTA2              0              0
           PWA4              0              0
          IGOVW         3026.8           1327
          POGCO              0              0
         FBET1W        0.38931      -0.065541
         WEDGEW              0              0
        PODPHIB              0              0
        PWIGINV              0              0
         PWIGOV              0              0
        PLWIGOV              0              0
        POIGOVD              0              0
    STBETEDGELW              0              0
         PLIGOV              0              0
       PWCFEDGE              0              0
       POEFEDGE              1              1
       PLWIGOVD              0              0
          POGC2          0.375          0.375
        VBIRGAT              2          1.399
            LP1     5.1674e-09     0.00019766
            KUO              0              0
         PWALP2              0              0
          POGC3          0.063          0.063
        POAGIDL              0              0
        PLAGIDL              0              0
        PWAGIDL              0              0
       THESATGO         0.1146              0
          PLNOV              0              0
     PLWNFCEDGE              0              0
       PLAGIDLD              0              0
         ALP1L2        0.04044      1.611e-08
     POSTBGIDLD              0              0
       POCGIDLD              0              0
          PONFC              0              0
       PWAGIDLD              0              0
          POCOX          1e-14          1e-14
       STBGIDLD              0              0
   PLWSTVFBEDGE              0              0
     POBETNEDGE         0.0005         0.0005
       VFBEDGEO             -1             -1
            CSW        0.19805       -0.11045
        PWCGOVD              0              0
           VFBO       -0.94312       -0.88703
           PWA1              0              0
         THECSO         1.1822         1.4566
             RG              0              0
       PLWCGOVD              0              0
      STBETEDGE              1              1
        PLCGBOV              0              0
     CFEDGELEXP              2              2
         PLNEFF              0              0
       PLCFEDGE              0              0
         PLWALP              0              0
        PWCGBOV              0              0
          PWCFR              0              0
          POFNT              1              1
       POFNTEXC              0              0
       GFACNUDO              1              1
        CSRHGAT      6.682e-06         0.0001
       PWFNTEXC              0              0
         PLWCOX              0              0
          PLNFA              0              0
         PLWNFA              0              0
         PSCEDO              0              0
    MEFFTATSTID           0.25           0.25
          PWNFB              0              0
          PSCED              0              0
         PLWNFB              0              0
          PLNFC              0              0
         PWPSCE              0              0
        TOXOVDO          2e-09          2e-09
          PSTID            0.5            0.5
            RSG              0              0
           CTBO              0              0
           POEF              1              1
    PLSTVFBEDGE              0              0
    PLDPHIBEDGE              0              0
        CBBTGAT          1e-18          1e-18
        PLIGINV              0              0
           LP1W        -0.1544              0

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

Thread 330 (2025-01-14):

Cannot retrieve lv_nmos model parameters (e.g. gds, cgs)

arnaudgabas, 2025-01-14:
Hello,

I have made a simple circuit to try to retrieve the lv_nmos parameters such as gm, gds. When simulating with ngspice and Qucs-S, I get this :

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

The gm value is plotted with the sweep, but the other only gives results on the first step. I have found the mos parameters in the PSP103_module.include file in the PDK.

Does anyone have an idea of what could be the problem?

KrzysztofHerman, 2025-01-14:
@arnaudgabas could you please share your testcase (schematic and netlist) ?

arnaudgabas, 2025-01-14:
Thank you for your fast answer. Here it is :

[testcase.tar.gz](https://github.com/user-attachments/files/18407862/testcase.tar.gz)

arnaudgabas, 2025-01-16:
Hello @KrzysztofHerman,

Do you have any news about it ? I have also found that adding a "DC Simulation" block in the schematic breaks everything. It seems that I am not using Qucs correctly for this.

KrzysztofHerman, 2025-01-16:
@arnaudgabas
I think I have just hit the solution

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

As you can see in the `INCLUDE SCRIPT` I have changed `.SAVE` to `save all`. Now it works

arnaudgabas, 2025-01-16:
Thank you for your answer.

I tried to edit it on my circuit but nothing changed.

Can you please send me the schematic ? Also, what are your current Qucs/ngspice versions ? We have noticed that depending on the OpenVAF/Qucs/ngspice versions, some features doesn't work as expected.

KrzysztofHerman, 2025-01-16:
@arnaudgabas I use `qucs-s 24.4.1` and `ngspice 44`

[qucs-s_schematic.sch.gz](https://github.com/user-attachments/files/18436694/qucs-s_schematic.sch.gz)

KrzysztofHerman, 2025-01-16:
@arnaudgabas also please take a look at the table configuration and the way you source the data

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

arnaudgabas, 2025-01-16:
I found the problem : it was due to a Qucs-S bug that does not refresh the content of the `include script` correctly.

I fixed the bug by deleting the script in my schematic and rewriting it with `.save all`. Thank you for your help!

Closed 2025-01-16.

Thread 332 (2025-01-15):

pTap guardring LVS issues

PhillipRambo, 2025-01-15:
Problem Description: pTap Guard Ring LVS Issue

In the test case, a pTap guard ring was created with an NMOS placed inside. During LVS:

    All NMOS terminals are detected as connected to the guard ring.

Possible cause: The TEXT.drawing layer with the sub! annotation might be introducing the error. The structure was copied from PDK LVS examples, so there might be an issue with how it's implemented. Below the testcase is attached and can be reviewed.

By the way, im not experiencing these issues with nTap generation.

PhillipRambo, 2025-01-15:
[test_case(1).zip](https://github.com/user-attachments/files/18424400/test_case.1.zip)

sergeiandreyev, 2025-01-17:
Hi @atorkmabrains, @FaragElsayed2, could you please take a look at this issue?

atorkmabrains, 2025-01-20:
Hi @PhillipRambo and @sergeiandreyev

We will get to this soon.

FaragElsayed2, 2025-01-21:
Hi @PhillipRambo

The ntap1 and ptap1 devices will be fully updated soon to align with the internal discussions.

FaragElsayed2, 2025-01-21:
Hi @PhillipRambo @sergeiandreyev

As discussed in Slack, LVS for ptap1 and ntap1 devices will be updated soon to align with the commercial PDK.

FaragElsayed2, 2025-01-29:
Hi @PhillipRambo

LVS has been updated for the n/p tap1 devices.

Here is the updated CDL that passes LVS. The shared version does not match the layout in the test case.

```
.subckt input_stage vss vdd dn4 dn3 dn2 iout
*.PININFO vss:B vdd:B dn4:B dn3:B dn2:B iout:B
M7 dn2 iout vdd vss sg13_lv_nmos l=0.13u w=0.15u ng=1 m=1
R2 tie vss ptap1 A = 7.6842p P=56.92u
M1 dn3 dn3 vss vss sg13_lv_nmos l=9.75u w=720n ng=1 m=1
M2 dn4 dn3 vss vss sg13_lv_nmos l=9.75u w=720n ng=1 m=1
.ends
```

sergeiandreyev, 2025-03-17:
Hi @PhillipRambo, could you please double check and confirm if the issue fixed?

Closed 2025-05-07.

Thread 336 (2025-01-20):

Questions about LVS

adrienluitot, 2025-01-20:
Hello,

I'm using Qucs-S to generate a (ngspice) netlist and KLayout for the layout. I'm trying to use the LVS with KLayout, but there are pretty odd things.

At first I thought the netlist generated by Qucs-S was not at all compatible. I tried to edit it by hand to have something that corresponds quite well to the netlist generated by KLayout, but it still didn't work. I kept having a result like that:

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

So, I tried to copy the exact same netlist from `TOP_extracted.cir`. And it worked, the LVS matched.
Then I tried to change the component name, to match Qucs-S, so I changed something like `M$46` to `XMN0`.
And then again, nothing matched.

So I changed `XM0` to `MN0` and it matched back.

I don't know if this is the expected behaviour? It looks like the LVS doesn't support X sub circuits.

Also, does someone has a good/recommended flow to extract a netlist from Qucs-S in order to use it for an LVS ?

olisnr, 2025-01-20:
the problem is: X is a subcircuit. You have to call a transistor M. if You use XM models in Your simulation, remove the X for LVS.
i dont know if there is an option in QUCS for exporting for LVS. in Xschem as example there is such an option. but if QUCS dosent suport this at this time, use Your most loved text-editor and rename all the transistors...

Ikram-rs22, 2025-01-21:
As far as I know, Klayout LVS generally require CDL netlist whilst currently Qucs-s only generate .cir netlist. Starting from february, the QUCS-S 25 version will accommodate CDL type netlist.  I think then it'd be much easier for checking LVS. For more, you can go through this issue -  [https://github.com/ra3xdh/qucs_s/discussions/1213](url)

adrienluitot, 2025-01-21:
> X is a subcircuit. You have to call a transistor M.

@olisnr Yes, that what I understood, but shouldn't an LVS be able to extract the hierarchy from a subcircuit? I'm not too used to LVS, is it common for LVS "engine" not to descend into sub-circuits?
.

> As far as I know, Klayout LVS generally require CDL

That's what I saw too, but then it seems that it was updated to be compatible with spice netlists? At least the GUI accepts `.cir` and` .spice` files. Maybe CDL and Spice netlists are just very similar... Also I didn't find a lot of documentation about CDL (not to say none).

Thanks for the info about Qucs-S and CDL export, that's a good thing.
However I tried it, and sadly the behaviour is the same, IHP's LVS doesn't manage subcircuit. Or I do something wrong.

So I wonder: Should IHP's LVS be updated to manage subcircuits? Or should it be the role of a script do it forehand?

sergeiandreyev, 2025-01-21:
Hi @adrienluitot, @Ikram-rs22, you're welcome to try the Qucs-s build w/ CDL export support (our fork) before official merge:
https://github.com/IHP-GmbH/qucs_s

olisnr, 2025-01-21:
@adrienluitot the XM in the simulation is a subcircuit. but the LVS-script will find a M device not a subcircuit. so if You want to compair a schematic spice with the LVS extracted .cdl You need to change the XM to M.

.cdl can have subcircuits like spice, but not devices as subcircuits.
i found also, that some things arenet working like `{}` parameters of `m u MEG` You need to give parameters as float.

sergeiandreyev, 2025-01-21:
KLayout LVS works with hierarchy as well (subcircuits referencing other subcircuits), for each `X` device there should be a subcircuit definition and also the requirement is that the leaf-cells (primitive devices) follow the naming standard, like:
### 3\. Component Definitions

Each component is defined in a single line with specific parameters:

#### MOSFETs

```
<name> <drain> <gate> <source> <bulk> <type> <parameters>
```

- `<type>`: PMOS or NMOS.
- `<parameters>`: L (length), W (width), and optional parameters.

Example:

```
M1 Z A VDD VDD PMOS L=1u W=2u
```

#### Resistors

```
<name> <node1> <node2> <value>
```

- `<value>`: Resistance value in ohms.

Example:

```
R1 A B 1k
```

#### Capacitors

```
<name> <node1> <node2> <value>
```

- `<value>`: Capacitance value in farads.

Example:

```
C1 VDD VSS 10p
```

#### Inductors

```
<name> <node1> <node2> <value>
```

- `<value>`: Inductance value in Henries.

Example:

```
L1 A B 1n
```

felix-salfelder, 2025-01-21:
In case you didn't know. We are upgrading Qucs to use Verilog. The schematic dump is there, and usable. See e.g.
https://github.com/Qucs/qucs/tree/vsdump (we include examples for testing, so what you see is what you get).

It would be better if the LVS tool supported Verilog. This will save time, and make it much easier to get the metadata across, and back (which is needed anyway).

sergeiandreyev, 2025-01-21:
> It would be better if the LVS tool supported Verilog. This will save time, and make it much easier to get the metadata across, and back (which is needed anyway).

well, I guess this change, if agreed, will impact every tool in the open-source domain (KLayout, netgen, etc.) - currently support of Verilog netlists is only available in commercial EDA software

felix-salfelder, 2025-01-21:
> support of Verilog netlists is only available in commercial EDA software

The intent is not to follow commercial software. "Netlisting" and "flattening" are lock-in mechanisms that we do not need in FOSS. We use Verilog schematics as the primary source for circuit drawings including metadata, for everyone to use across a variety of tools. This data interchange not something an EDA software seller will make a priority.

Sure, ngSpice does not understand Verilog, and I cannot help it. But then, creating Spice netlists from Verilog is absolutely straightforward. Reading Verilog into Qucs will be a matter of weeks from now... How about parallelising? Klayout? Xschem?

adrienluitot, 2025-01-21:
> KLayout LVS works with hierarchy as well (subcircuits referencing other subcircuits), for each X device there should be a subcircuit definition and also the requirement is that the leaf-cells (primitive devices) follow the naming standard

Okay I made several tests, and maybe the problem comes from Qucs-S or the PDK in Qucs-S.
At first it exported something like this:

```SPICE
.SUBCKT IHP_PDK_nonlinear_components_sg13_lv_nmos gnd d g s b w=0.35u l=0.34u ng=1 m=1 as=0 ad=0 pd=0 ps=0 trise=0 z1=0.346e-6 z2=0.38e-6 wmin=0.15e-6 rfmode=0 pre_layout=1 mlist=1
X1 d g s b  sg13_lv_nmos w={w} l={l} ng={ng} m={m} as={as} ad={ad} pd={pd}  ps={ps} trise={trise} z1={z1} z2={z2} wmin={wmin} rfmode={rfmode} pre_layout={pre_layout}
.ENDS

.SUBCKT TOP
Xsg13_lv_nmos2  _net0 _net1 0 gnd IHP_PDK_nonlinear_components_sg13_lv_nmos w=0.35U l=0.34U ng=1 m=1 as=0 ad=0 pd=0 ps=0 trise=0 z1=0.346E-6 z2=0.38E-6 wmin=0.15E-6 rfmode=0 pre_layout=1
Xsg13_lv_nmos1  VDD _net1 _net0 0 IHP_PDK_nonlinear_components_sg13_lv_nmos w=0.35U l=0.34U ng=1 m=1 as=0 ad=0 pd=0 ps=0 trise=0 z1=0.346E-6 z2=0.38E-6 wmin=0.15E-6 rfmode=0 pre_layout=1
.ENDS

.END
```
(I don't know why, it doesn't seem to export the `IHP_PDK_nonlinear_components_sg13_lv_nmos` subckt anymore)
I only added the `.SUBCKT TOP` to be compatible with the LVS.

The thing is, `sg13_lv_nmos` is considered as a subcircuit, and there is no include (or whatever is used in CDL).
If I replace the `X1` by `M1`, then the netlist is correctly read by Klayout LVS.

What do you think about it?

Is the PDK wrongly implemented for Qucs-S?
Should Qucs-S  automatically replace the `X1` by `M1` or "include" all the subckt down to the final M component? (I'm not sur the include is doable because of the OSDI models)
Or should it be done by an external script?

By the way, I don't know if it's correct just to replace the `X1` by  `M1`, don't we lose information? Maybe those information only matters for the simulation and not the LVS though.

ra3xdh, 2025-01-21:
> Should Qucs-S automatically replace the X1 by M1 or "include" all the subckt down to the final M component?

The MOSFETs in the most of PDKs is not a MOSFET device but a subcircuit. The `sg13_lv_nmos` is a subcircuit. It should be mapped to the letter `X` otherwise the simulation will not work. The Ngspice CIR netlist is correct. I am not sure where the issue should be fixed.  @ThomasZecha ?

adrienluitot, 2025-01-21:
> The MOSFETs in the most of PDKs is not a MOSFET device but a subcircuit. The `sg13_lv_nmos` is a subcircuit. It should be mapped to the letter `X` otherwise the simulation will not work. The Ngspice CIR netlist is correct. I am not sure where the issue should be fixed. [@ThomasZecha](https://github.com/ThomasZecha) ?

I agree, at least for simulations, but maybe not in the case of a LVS.
At the very end, is the "leaf-cells" a `M` device? In this case, maybe the CDL export should have the whole hierarchy down to the leaf-cells. Or could have an "include" to the right library.

ThomasZecha, 2025-01-22:
I'll take care of it.

ThomasZecha, 2025-01-25:
@ra3xdh: I would like to make the following suggestion to solve the problem:

Introduce the following per global settings on/off switchable special treatment of subcircuit instances during CDL netlisting:

As a preparation step during CDL netlist export:

1.	Found all subcircuit instances in the current schematic.
2.	For every instance from 1. check whether the referenced subcircuit exists in the current schematic.
3.	For every instance from 2. where the subcircuit don’t exist do:
a.	Check whether the second letter of the instance name refer a CDL primitive device (R, C, L , M, Q, ...)
b.	If a. holds check whether the number of pins match the allowed pin-numbers of the primitive device from a.
c.	If b. holds remove the first letter from the instance name for the CDL-netlisted instance name.

olisnr, 2025-01-25:
Xschem does this simpler: it has symbols that have a `spiceprefix=X`

effective You name Your transistor `M11` but because the transistor is a spice-subcircuit it will need an `X` bevfore the `M`...

i think the way Xschem handle this is very good. i would do the same in QUCS.

felix-salfelder, 2025-01-25:
> i would do the same in QUCS.

Thanks for the remark. This is already covered by our roadmap with work currently in progress.

In Qucs we will use attributes as defined in the standard. See LRM 2.9 Attributes

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

What does it mean?  Use modules like

    (* CDL_type="X" *) (* [...] *) module mymos(d,g,s,b); [stuff] endmodule

Or specify as part of instanciation, possible override

    (* CDL_type="X" [..] *) mymos #( ..params ) my_instance( ..ports )

The key here is that "attributes" are not "parameters". Attributes are metadata that most tools can safely ignore, while parameters are not. Note how parameters have ranges, types and other semantics that attributes should better not interfere with. Xschem should also consider drawing that line.

olisnr, 2025-01-25:
@felix-salfelder i dont understand ""attributes" are not "parameters"". do You mean attributs are the name of the symbol or the color of the pins, and parameters are `W` and `L`?

and i think `(* CDL_type="X" ` makes no sense, it would be  `(* spice_type="X" `

felix-salfelder, 2025-01-25:
On Sat, Jan 25, 2025 at 01:51:20PM -0800, olisnr wrote:
> @felix-salfelder i dont understand ""attributes" are not "parameters"". do You mean attributs are the name of the symbol or the color of the pins, and parameters are `W` and `L`?

Eventually this is about terminology. A "parameter" is often used to
carry a numerical constant that has to do with model "parameter"isation.
`W` and `L` are normally called "parameters". Parameters are relevant
during model selection. "Polarity", "level" etc.

(For more details, see Section 3.4 Parameters in the LRM, and examples
therein.)

Attributes is just another word they made up, to refer to something
else, metadata. Yes, attributes can carry style information, such as
color, appearance, position on screen etc. Attributes may be attached to
objects (not neccessarily device types or instances) any time. With this
in mind, attributes are simply not parameters, and should be treated
accordingly.

> and i think `(* CDL_type="X" ` makes no sense, it would be  `(* spice_type="X" `

Perhaps I got distracted by reading about CDL, thought the letter is the
one you'd use in a CDL file. Anyway, choose a name that indicates the
actual intent and use. "LVS_type" might cut it, "klayout_LVS_type" might
be more appropriate.

Note how little sense spice_type makes to begin with. No two Spices
use these letters in the same way. To get anywhere, there whould have to
be ngspice_type, xyce_type, klayout_type, some_commercial_spice_type
(depending on the use case), likely more.

olisnr, 2025-01-26:
@felix-salfelder thanks a lot for Your explanations. what is the LRM?

for the
_Note how little sense spice_type makes to begin with. No two Spices
use these letters in the same way._
You are right, there are many big differences, but the `X` for subcircuit and the `M` for MOSFET have all in common. the thing is: if CDL-export removes all the X, then it breaks the real subcircuits. `X `  in CDL ist totally legal

olisnr, 2025-01-26:
the idea behind `XM` is: its an `M` but there is no good model in spice integrated, but i can make a subcircuit that is a nice model. its effective an `M` in the real world, but the model is an subcircuit... the M is correct for CDL and spice, but the spice-model for `M` isnt that perfect You would like. the `XM` is onle to simulate better. but...

felix-salfelder, 2025-01-26:
On Sun, Jan 26, 2025 at 11:48:59AM -0800, olisnr wrote:
> what is the LRM?

You are welcome. I was referring to the Verilog-AMS Language Reference
Manual.

This one here looks like the current version.
https://accellera.org/images/downloads/standards/v-ams/VAMS-LRM-2023.pdf

ThomasZecha, 2025-01-27:
> Thanks for the remark. This is already covered by our roadmap with work currently in progress.
>
> In Qucs we will use attributes as defined in the standard. See LRM 2.9 Attributes

@felix-salfelder @olisnr
Please transform the following subcircuit excerpt (it's a MOS primitiv) from IHP open source library according to your _'spiceprefix=X'_-rule as an example how this should like like. Thank you:

```
.SUBCKT IHP_PDK_nonlinear_components_sg13_lv_nmos  gnd d g s b w=0.35u …
X1 d g s b  sg13_lv_nmos w={w} …
.ENDS

```

felix-salfelder, 2025-01-27:
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

Verilog-A has "module" as a substitute/extension for ".subckt". So the
snippet in question would look more like

```
(* [..] *)
module IHP_PDK_nonlinear_components_sg13_lv_nmos(gnd, d, g, s, b);
  inout electrical gnd, d, g, s, b;
  parameter real w=.35u from (0:inf);
  [..]
  sg13_lv_nmos #(.w(w) [..]) n1(d, g, s, b);
endmodule
```

Now, specific applications need extra letters, add them like

```
module IHP_PDK_nonlinear_components_sg13_lv_nmos(gnd, d, g, s, b);
  [..]
  (* LVS_letter="X", ngspice_letter="N", xyce_letter="X" *) [..]
  sg13_lv_nmos #(.w(w) [..]) n1(d, g, s, b);
endmodule
```

If instances of IHP_PDK_.._nmos should carry those additional letters
you may put it like

```
(* LVS_letter="X", ngspice_letter="N", xyce_letter="X" *) [..]
module IHP_PDK_nonlinear_components_sg13_lv_nmos(gnd, d, g, s, b);
  [..]
  sg13_lv_nmos #(.w(w) [..]) n1(d, g, s, b);
endmodule
```

Where to put what mostly depends on some more context that I do not
have. By dropping disciplines, parameter ranges, case sensitivity, and
considering the desired letter attribute, you could easily recover the
.SUBCKT block above. There is no more need to carry it along.

LRM Annex E explains how Spice is made available in Verilog-A. Note that
anything Spice remains implementation defined. In oder to use Verilog-A
features such as attributes, the primary source form needs an upgrade
like the one shown above.

Hope this answers your question.

ThomasZecha, 2025-01-27:
@felix-salfelder @olisnr Reading your comments I got the impression that implementing the _'spiceprefix=X'_ feature for qucs-s-schematics as well as -SPICE libraries is on your roadmap. This seems to be wrong, or?

ra3xdh, 2025-01-27:
> Reading your comments I got the impression that implementing the 'spiceprefix=X' feature for qucs-s-schematics as well as -SPICE libraries is on your roadmap.

Qucs and Qucs-S are different projects. The codebase of Qucs-S and Qucs has diverged.

> Introduce the following per global settings on/off switchable special treatment of subcircuit instances during CDL netlisting:

@ThomasZecha , please open an issue in Qucs-S repository to discuss the technical details of MOS devices CDL handling implementation in Qucs-S.

olisnr, 2025-01-27:
@felix-salfelder i think it should be done like in Xscheme: MOSFET is `M` for spice and .CDL.
models that are not in spice integrated and has to be implemented as `.subckt ` should have an `X` before the device-type: `XM`, but only in the `.cir` export (spice not .CDL).
it dosnt matter in my mind if the source of the spice or .CDL netlist is a ASM-verilog or something other. its about the way spice and .CDL identify the part-type. (but may be i dont understand what this discussion is really about)

Thread 340 (2025-01-21):

Need the Noise Test Circuits of HBTs

EngGhaith, 2025-01-21:
Hi!
I am trying to simulate transient noise in XYCE.
I have created 2 models of NPN-transient noise and need to verify them.
The parameters (RE, RSUB, ...etc.) are taken from VBIC-Model and their values can be read from .OP simulation.
Thermal noise and shot noise are white, Flicker noise is 1/f-distributed.
The values of Voltage/Current sources can be loaded from a file.

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

I have seen that IHP has done a noise figure measurements and the results are available in the IHP-Open-PDK repository, but these measurements are not supplied with test circuits (Input-Terminal? Output-Terminal? Supply Voltage? Matching circuits to know noise bandwidth? ...etc.).
Could you please provide this circuits to verify my models?

Thak you in advance.
AL SABAGH Ghaith from IIC-JKU.

sergeiandreyev, 2025-01-22:
Hi @EngGhaith, thank you for the report! I'll check internally if we can find / provide test circuits..

sergeiandreyev, 2025-01-23:
@EngGhaith, could you please clarify which are the exact files that you were reviewing in our repo for the noise measurement data?

EngGhaith, 2025-01-23:
> [@EngGhaith](https://github.com/EngGhaith), could you please clarify which are the exact files that you were reviewing in our repo for the noise measurement data?

ihp-sg13g2/libs.doc/meas/HBT/doc/html_npn13g2l_VBIC/High_Frequency_Noise_SG13G2_pdk.pdf
ihp-sg13g2/libs.doc/meas/HBT/doc/html_npn13g2l_VBIC/Low_Frequency_Noise_SG13G2_pdk.pdf

xcub, 2025-01-23:
Dear @EngGhaith,
As I can see from the noise measurement report, it was a common-emitter (input: base, output: collector, ground: emitter) configuration. The operating points (Vbe and Vce, frequencies, emitter lengths, and fingers) are also mentioned in the report. Please note that no matching network was used in these measurements.

I hope this information helps you.

WIth regards
Farabi

FarabiJamal, 2025-01-23:
Dear @EngGhaith,
As I can see from the noise measurement report, it was a common-emitter (input: base, output: collector, ground: emitter) configuration. The operating points (Vbe and Vce, frequencies, emitter lengths, and fingers) are also mentioned in the report. Please note that no matching network was used in these measurements.

I hope this information helps you.

WIth regards
Farabi

FarabiJamal, 2025-01-29:
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

Dear @EngGhaith,
The Vcc would be Vcb+Vbe from the reports. There was no RB, RE and RC. The attached document can give you better insight about noise measurements and modeling.

With regards
Farabi

[NOISEdoc.pdf](https://github.com/user-attachments/files/18587548/NOISEdoc.pdf)

sergeiandreyev, 2025-01-31:
Also @EngGhaith, could you please attach actual testcase schematic netlist file to this GitHub issue?

EngGhaith, 2025-02-02:
@sergeiandreyev
Yes I can
Here are 3 files:
- "create_noise_NPN_TRNOISE_TB.py" would create the required noise samples. You to run this firstly!
- Then use the schematic: "NPN_TRNOISE_TB.sch"
- At the end plot the results with: "plotFFTNPN_TB.py"

PS.: Here I have neglegated the Flicker noise. Because in such a frequency (12 GHz) it would be very small compared to shot/thermal.
If I would modeled that, then it would require a long simulation time (e.g. 1s to achieve one period of the worst frequencies in lower frequency band) and a fine teime step (e.g. tstep=40ps) to get enough resolution for the tone 12 GHz). That would require about 25 GSample for each vector, which would be K.O. for my laptop.

You will see that the model would make different values if you change the input amplitude, thus a proper explaination of IHP-used-setup would be necessary to compare results!

[noise_issue.zip](https://github.com/user-attachments/files/18633132/noise_issue.zip)

EngGhaith, 2025-02-02:
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

If you wanna activate the flicker noise, just enable their elements in the schematics with shift+t after selection, and uncomment the dedicated lines in python after modifying them

Thread 346 (2025-01-29):

DRM - pSD section - ThickGateOx mentionned but not shown

adrienluitot, 2025-01-29:
Hello, I don't know if it's a mistake an omission but in the `pSD` part (p 28 in rev 0.4) of the DRM, the `ThickGateOx` is mentioned in the table (first picture) but never shown in the drawing (second picture).

**PS:** I actually realised that the `ThickGateOx` is shown, but not captioned. `ThickGateOx` and `pSD` basically have the same color... a bit tricky...
Maybe the color of one of them should be changed in the whole doc to avoid this kind of omission?

- - -
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
- - -
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
- - -

sergeiandreyev, 2025-01-30:
Hi @stefansimon42, could you please take a look?

adrienluitot, 2025-01-30:
I take this opportunity to report another little mistake. Rule `MIM.i` was removed from the in revision 0.2 (I supposed from the changelog) but is still present on the diagram.

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

stefansimon42, 2025-02-06:
Hi @adrienluitot,

Thanks for the hint regarding Mim.i

W.r.t. the PSD rules, only the PSD layers are actually drawn in the illustration. You are right that there is a risk of confusion between pSD and ThickGateOx. The layer colors are adapted to the representations in the layout editors to make them easier to understand. We will discuss an adjustment of the colors internally.

However, I am of the opinion that pSD.i1 and pSD.j1 do not necessarily have to be drawn in this figure. The amount of information in relation to pSD.i and pSD.j is marginal, but the drawing itself would be cluttered. I tend not to add the drawings for pSD.i1 and pSD.j1.

adrienluitot, 2025-02-06:
I agree that that showing the thick oxide for the rules i1 and j1 would overwhelm the manual. It’s all my fault and I thought psd.i and psd.j were related to thick oxide and that it was shown on the drawing but not in the legend.
I think I mainly misunderstood/misread, and a little due the color I guess.

Maybe the “NOT in Thick Oxyde” is a bit confusing, I mean the “not” is easy to miss.
I understand it’s here because of the contradiction with i1 or j1.
So maybe just a sentence like “min pSD space to NFET Gate” would be enough and reduce confusion?
Just an idea, do what you want with it.

Thread 347 (2025-01-30):

LVS behaviour with parallel MIM Capacitors

adrienluitot, 2025-01-30:
When I stick 2 MIM caps with through Metal 5 and TopMetal 1 to use them in parallel, the LVS won't detect the capacitors at all. (Case 1)
If I space them, the LVS will detect 2 independent MIM caps. (Case 2)
And if keep the space, but fill it with Metal 5 and TopMetal 1 to connect them as if they were stuck, the LVS detect 1 MIM cap with a multiplier=2. (Case 3)

For the case 2 and 3, the space can be as small as 0.005um.

In the end, what I would expect, is a Layout like in case 1, but with LVS results like in case 3.
I don't really understand why the LVS results between case 1 and 3 are so different.

Also, maybe I'm not doing the parallelisation properly?

---
### Case 1
Layout:
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
LVS: <empty>

---
### Case 2
Layout:
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
LVS:
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

---
### Case 3
Layout:
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
LVS:

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

sergeiandreyev, 2025-02-04:
Hi @atorkmabrains, @FaragElsayed2, could you please take a look?

FaragElsayed2, 2025-02-04:
Hi @adrienluitot

Could you share the test cases you mentioned?

adrienluitot, 2025-02-10:
Hello @FaragElsayed2, sorry for the late reply...

Here, [a zip containing a GDS](https://github.com/user-attachments/files/18739403/test_capa_lvs.gds.zip) with the 3 cases and a bit of text for each.
I won't share a netlist because it doesn't matter for the LVS, you can use any netlist I think.

Thank you for your interest!

adrienluitot, 2025-03-29:
Anything new @FaragElsayed2 ?

FaragElsayed2, 2025-04-03:
Hi @adrienluitot

Sorry for the delay, I missed your reply. Thanks for sharing this testcase.

I've updated the current MIM derivations to support all these cases. Please recheck and let me know if you still encounter this issue.

FaragElsayed2, 2025-08-28:
@sergeiandreyev I believe this issue could be closed.

Thread 349 (2025-02-03):

Hybrid EM-Circuit Simulation Workflow for IHP SG13G2

rupokdas147, 2025-02-03:
I am designing a 100 GHz broadband power amplifier using the IHP SG13G2 HBT process. I can individually EMS transmission lines and inductors using openEMS and use the s2p files in the schematic. But this method does not include the effects of nearby signal lines, since I am EMS them individually. But I want to validate my hybrid EM-circuit simulation more accurately. But openEMS does not support active devices like HBT.  So, I plan to:

1. Define multiple ports at all transistor terminals (base, collector, emitter) and interconnect points in openEMS.

2. Simulate all passive structures together (transmission lines, inductors, matching networks) to capture mutual coupling and parasitic effects.

3. Extract an SNP file (e.g., S4P, S6P) containing the S-parameters of the full passive layout.

4. Import the SNP file into Qucs-S and connect:
BJTs using IHP's SG13G2 models, Bias sources at the correct terminals, Additional lumped elements as needed.

5. Run circuit simulations to analyze gain, stability, and nonlinear performance.

Questions:
Is this approach correct for hybrid EM-circuit simulation with IHP's SG13G2 process?
Should I terminate every open terminal with a port in openEMS?
Are there better methods for integrating EM-simulated layouts with IHP’s active device models?

Any insights or corrections would be greatly appreciated!

Thank you!

VolkerMuehlhaus, 2025-02-04:
@rupokdas147 Yes, this is what I meant.

But to avoid misunderstanding: a pair of differential lines should not be split, of course. I only suggest to simulate those parts separately where coupling is not desirable and not expected.

rupokdas147, 2025-02-05:
@VolkerMuehlhaus If I create a PEC layer below the Substrate to use it as a global GND, will it work? Does the length of the port matter?

VolkerMuehlhaus, 2025-02-05:
> [@VolkerMuehlhaus](https://github.com/VolkerMuehlhaus) If I create a PEC layer below the Substrate to use it as a global GND, will it work? Does the length of the port matter?

Yes, the length of the port matters, it behaves like a physical wire. Long ports create parasitic inductance (from length) and couple to other layout parts due to current flowing in the port.

For openEMS and other 3D EM tools like HFSS, the lumped port must be short. Having a port from TopMetal2 down to Metal1 is ok. Having a port across some 100µm down to the backside of the substrate will not give useful results.

In the link below, you find the screenshot of 2-port simulation model of an octagon inductor, where we have no nearby ground in layout. I added an artificial lossless metal polygon at the top surface of the substrate, and used that as common ground ref for both ports. By placing this extra metal on the surface of the substrate, shunt path from inductor to substrate is included in the results. I made this extra metal lossless because the port return current will physical flow through that metal strip -> don’t add resistance here. It add some small inductance, but that’s nothing to worry about, very few pH.

https://muehlhaus.com/wp-content/uploads/2025/02/inductor_twoport_extrametal.png

rupokdas147, 2025-02-05:
@VolkerMuehlhaus Let's say, I want to EMS a half circle inductor. How can I do that in openEMS? To connect the GND of two ports, I have to use a long lossless metal below or above the TopMetal through the diameter of the circle, If I want a short path. But this will add more inductance to the result.

VolkerMuehlhaus, 2025-02-05:
> [@VolkerMuehlhaus](https://github.com/VolkerMuehlhaus) Let's say, I want to EMS a half circle inductor. How can I do that in openEMS? To connect the GND of two ports, I have to use a long lossless metal below or above the TopMetal through the diameter of the circle, If I want a short path. But this will add more inductance to the result.

Correct, for all volume meshing 3D EM tools you need to "close the loop" in some way. So you can't simulate that half circle without adding some return to close loop.

One approach used by the Sonnet solver (MoM, but with similar requirement of "physical" ports) is to use a PEC simulation boundary as a global return path (i.e. device in a metal box), with some length of line added between the box wall port and the device under test. That length of line must then be removed by port calibration, and the remaining results is the half circle.
We can't use the exact same port calibration, but the general idea of adding some metal to close the loop and removing the effect of that metal by de-embedding would be applicable. Similar to removing the pads in on-wafer measurements. There is no such de-embedding implemented in openEMS, but scikit-rf might be useful here for postprocessing.

And in real life, your current also flows in closed loops, so you might include the true return path layout in your model, instead of cutting out only the half circle for EM. There will be some influence by such a metal frame on inductance anyway, so why not include that in the EM model from the very beginning?

I know that this is unexpected for ADS Momentum users who can use an abstract "ground at infinity" or ground at the bottom of the substrate, with current jumping in space between different locations with no inductance or delay. But it is what it is ... the model in 3D volume mesh EM requires the same as real world physics: current flows in closed loops only. We need to consider this for modelling, and can't cut out fractions for EM.

VolkerMuehlhaus, 2025-02-05:
@rupokdas147 Thanks for your input! I am currently working on a similar use case for a colleague at IHP, to build models and see what port configuration works best. The plan ist to create a document with more detailed instructions and examples. Let's see what we get ...

rupokdas147, 2025-02-06:
@VolkerMuehlhaus What's the best way to handle vias in EM simulation? A lot of via slow down the speed of the simulation significantly.

rupokdas147, 2025-02-06:
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

I'm using python for simulation. Maybe simulation time is not affected, the 3D view was affected.

rupokdas147, 2025-02-07:
@VolkerMuehlhaus Manually meshing is a problem. Taking port dimension less than mesh size, does not start the simulation (Energy remains 0 forever).

VolkerMuehlhaus, 2025-02-07:
@rupokdas147 Absolutely correct! If you are interested to beta test my new SG13 openEMS Python workflow including automatic, please contact me at volker@muehlhaus.com
It is not on Github yet because I am still fine tuning some details, but you can already give it a try, if you wish.

gvidasgsasicnl, 2025-02-07:
[like]  Gvidas Sidlauskas reacted to your message:
________________________________
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

rupokdas147, 2025-02-09:
> @rupokdas147 Absolutely correct! If you are interested to beta test my new SG13 openEMS Python workflow including automatic meshing, please contact me at volker@muehlhaus.com
> It is not on Github yet because I am still fine tuning some details, but you can already give it a try, if you wish.

Thanks, I have mailed you from rupokdas147@gmail.com

Thread 350 (2025-02-06):

m parameter in lv_mos models of Xyce in the current dev-branch dont work

olisnr, 2025-02-06:
to demonstrate it, i added two transistors to the `ihp-sg13g2/libs.tech/xschem/sg13g2_tests_xyce/ac_lv_nmosrf.sch`. one with m=10 and the other with w=10u (standard is 1u).

i would expect similar results, but the m=10 device looks exactly like the m=1 device with the same w...

[ac_lv_nmosrf_mult_Xyce.sch.zip](https://github.com/user-attachments/files/18690965/ac_lv_nmosrf_mult_Xyce.sch.zip)

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

my simulation command is `Xyce -plugin $env(PDK_ROOT)/$env(PDK)/libs.tech/xyce/plugins/Xyce_Plugin_PSP103_VA.so "$N"`

dwarning, 2025-02-09:
I can confirm that multiplier didn't work with Xyce. It seems that Xyce can not change parameter "m" in subckt call.
Changing this parameter name to "mult" or something else will work as in following script:

`psp103 nch transfer

vd  d 0 dc 0.1
vg  g 0 dc 0.0
vb  b 0 dc 0.0
XPSP103_VA d g 0 b psp_sub w=10u l=1u mult=2

.subckt psp_sub d g s b w=10u l=1u mult=1
YPSP103_VA m1  d g s b nch l='l' w='w' mult='mult'
.ends

.option temp=21
.step  vb -3 0 0.5
.dc vg 0 1.5 0.02
.print dc format=gnuplot v(g) i(vd)

.model nch psp103_va type=1

.end
`

dwarning, 2025-02-12:
Xyce team has agreed that the parser has a [bug](https://github.com/Xyce/Xyce/issues/134).
Change parameter name to mult instead m for symbols and subckt definitions for xyce and ngspice lib's is preferable. Positive side effect is that the meaning for the user is unique.

tskaar, 2025-07-30:
For your reference, it's fixed in Xyce v7.10:

Xyce v7.10:
---

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

NGSpice
---

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

Using the same testbench as opening post, just modified it such that left plot is always Xyce and right plot is always NGSpice

olisnr, 2025-08-20:
@sergeiandreyev check

Closed 2025-08-20.

Thread 351 (2025-02-08):

Why is "ng" a divisor? And one more question...

MilosMitrovic411, 2025-02-08:
There are already two issues that are kind of tangential to my question (https://github.com/IHP-GmbH/IHP-Open-PDK/issues/203 and https://github.com/IHP-GmbH/IHP-Open-PDK/issues/180). I've voiced my opinion on both these issues, but I think it is worth of having it's own topic.

In my experience, PDK vendors use "ng" (or "nf") as a multiplier. e.g. if you want a transistor that has a total width of 10u and has 4 gates (fingers), you would annotate it as: w=2.5u, m=1, ng=4.

It would be very confusing to me if I would have four 2.5u fingers and a property that says that my instance is 10u wide. I don't know what are the parameters of the transistors generated form the schematics in KLayout, or if there is even that option.

I am not using  software recommended in the official PDK, actually I am working on my own version of SG13G2 PDK for Glade (which is similar to Virtuoso - allows both design and layout in one software), and I am using "ng" as a multiplier, that's why I was surprised when I saw in nmos model code "ng" being used as a divisor.

On that note, I have read the Apache License 2.0, but I would like to confirm with somebody employed with IHP, is it within the law for me to publish my own version of this PDK? I am also open for my files being included in this repository.

dwarning, 2025-02-09:
Which PDK use finger count as multiplier?

All actual MOS models I know using W as total width and finger width is W/NF. So we have joint areas for drain and/or source which are calculated separately.

A multiplier describes total separate devices in parallel and should not confused with finger count.

There is no bug here and issue should be closed.

MilosMitrovic411, 2025-02-10:
From my experience, TSMC and NXP use it as such, can't say which specific technologies because of NDAs.
As I said in the post it is from my experience, I heard from other designers that they encountered both representations.

This was not meant as an attack, my question is aimed towards understanding the logic behind it given that during a layout extraction each finger is extracted as a separate transistor. So in my interpretation one starts from there and works towards annotation on the schematic.

I didn't say it is a bug, although the issue https://github.com/IHP-GmbH/IHP-Open-PDK/issues/203 is directly caused by that approach. But, hey, I guess you are right, this is more of a discussion topic not an issue, so I will post it there.

Closed 2025-02-10.

Thread 352 (2025-02-10):

Compile for Xyce models fails

hpretl, 2025-02-10:
Since the merge of 9681b01220f06998d2f43170f8187d4f2b2fb501 using the script `adms-compile-va.sh` fails with an error:
```
buildxyceplugin is building a plugin from the Verilog-A files:
psp103.va
The plugin name will be generated automatically from the module name
in the last file of this list.
Building C++ for Verilog-A input file 'psp103.va'...
C++ for Verilog-A input file 'psp103.va' failed
See buildxyceplugin.log for details
```

When I delete the file `psp103/discipline.h` then everything works fine.

@dwarning Any idea what might the issue? I have tried with Xyce 7.8 and 7.9, no difference.

hpretl, 2025-02-10:
I should add: When removing the local `discipline.h` in `psp103` and `r3_cmc` everything is fine.

dwarning, 2025-02-10:
@hpretl
Can you attach one of the failed buildxyceplugin.log.

For me it works.
I checked the both discipline.h - they are OK. If I remove the header files it compiles for me too because both compiler are using their own copy. So they are obsolete.

I have my own Xyce and admsXml build here on my Ubuntu machine:
`dietmar@modsys:~/Projects/IHP-Open-PDK/ihp-sg13g2/libs.tech/verilog-a$ Xyce -v
Xyce DEVELOPMENT-202412082152-(Public_Release-7.8.0-128-g5b74b0d5-dirty)-opensource
dietmar@modsys:~/Projects/IHP-Open-PDK/ihp-sg13g2/libs.tech/verilog-a$ admsXml -v
[usage..] <release name="admsXml" version="2.3.7" date="Nov 10 2024" time="11:22:18"/>
`
Do you changed something with admsXml installation?

hpretl, 2025-02-10:
```
/tmp > xyce -v
Xyce DEVELOPMENT-202501121412-(Public_Release-7.8.0-326-gbe78559c)-opensource
/tmp > admsXml -v
[usage..] <release name="admsXml" version="2.3.7" date="Apr 22 2024" time="14:42:32"/>
```
No change with admsXml or otherwise, just a plain build of Xyce.

Here is the `buildxyceplugin.log`:
```
/tmp/IHP-Open-PDK/ihp-sg13g2/libs.tech/verilog-a/psp103 > cat buildxyceplugin.log
buildxyceplugin log begun at Mon Feb 10 07:39:02 PM CET 2025

 script invoked as:
 /foss/tools/bin/buildxyceplugin psp103.va ../../xyce/plugins
 ----------------
Building C++ for Verilog-A input file 'psp103.va'...
[info...] -x: skipping any implicit xml scripts
[info...] admsXml-2.3.7 (unknown) Apr 22 2024 14:42:32
[fatal..] discipline.h: during lexical analysis syntax error at line 21 -- see ';'
```

I compared with the existing `discipline.h` and the error is caused by the `;` at the end of the lines `discipline xxx;` and `nature xxx;`

hpretl, 2025-02-10:
@dwarning Compared with this here https://verilogams.com/refman/basics/disciplines.html there should indeed be no `;` at the end of the lines.

hpretl, 2025-02-10:
Here is my fix: `sed -E '/^(nature|discipline)/s/;( *$)//'`

dwarning, 2025-02-10:
@hpretl
Most developments for Verilog-A references to [Language Reference Manual](https://www.accellera.org/images/downloads/standards/v-ams/VAMS-LRM-2-4.pdf).
On page 387 we see the ";" on the end.
I am using these files for years in ngspice/adms, Xyce/adms and OpenVAF. It is first time I see this problem - opposite to the backslash before logic keyword on same page 387 which I removed long time ago.

hpretl, 2025-02-10:
Ah, now I have an idea: which version of `adms` are you using? I use the one which can be installed via APT:
```
/foss/designs > apt search adms
Sorting... Done
Full Text Search... Done
adms/noble,now 2.3.7-1build1 arm64 [installed]
  Automatic device model synthesizer for Verilog-AMS

libadms0/noble,now 2.3.7-1build1 arm64 [installed,automatic]
  Shared library for automatic device model synthesizer
```

KrzysztofHerman, 2025-02-10:
@hpretl @dwarning in order to make this thread even more interesting I can tell you that I have successfully compiled the models using  `adms` and `openvaf`. However `adms` deletes the `discipline.h` files in both directories.

hpretl, 2025-02-10:
... oh my... :-)

hpretl, 2025-02-10:
@dwarning I have a feeling that both ADMS (and OpenVAF) are in serious need of an active maintainer if we build on it:

From the Xyce homepage:
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

Looing at this referenced project... no update since 3 years.

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

hpretl, 2025-02-10:
As said, I am really no expert here, but: Can't we retire ADMS for good and just keep using and improving OpenVAF?

dwarning, 2025-02-11:
@hpretl
It is true ADMS is not updated since years. But your apt install is more outdated because it has not the commit 13fdce from Neal Wood from 04.01.22 "Fix bad grammar rule for optional semicolon".
In case you want use Xyce/adms I would prefer to build your own admsXml from github repository.

hpretl, 2025-03-10:
Update: With a compile from sources ADMS works properly, so we can close this one.

Closed 2025-03-10.

Thread 356 (2025-02-12):

ngspice Too few parameters for subcircuit type "npn13g2l"

jalcim, 2025-02-12:
when i follow this tutorial : https://ihp-open-pdk-docs.readthedocs.io/en/latest/analog/ngspice.html#ngspice-installation

i have this error, i have try to change my parameter, but its change nothing.

```
Note: No compatibility mode selected!

Circuit: **.subckt dc_hbt_13g2

Too few parameters for subcircuit type "npn13g2l" (instance: xxq1)
    Simulation interrupted due to error!

Note: No ".plot", ".print", or ".fourier" lines; no simulations run
```

i have try
```XQ1 net2 net1 GND GND npn13G2l Nx=1 le=2.50e-6 dtemp=0 Ny=1 we=0.12e-6 El=2.5 selft=1```
and
```XQ1 net2 net1 GND GND npn13G2l Nx=1 le=2.50e-6 dtemp=0 Ny=1 we=0.12e-6 selft=1```
and a lot of other... no way.

documentation require update ?
or its a misstake of my part ?

KrzysztofHerman, 2025-02-12:
@jalcim could you please share your whole netlist ant the ngspice and the  PDK version (branch, commit) ?
I have just executed the sample netlist from the documentation and it works.
```
.subckt npn13G2 c b e bn
.param Nx=1 dtemp=0
+Ny=1 le=0.96e-6 we=0.12e-6
+El=le*1e6
+selft=0
```
`El` and `le` can be used interchangeably keeping in mind the units `um` and `m` respectively.  The `xschem` and `qucs-s` symbols expose only `Nx `and `El` to the designer.

jalcim, 2025-02-12:
i do all like the documentation.

but i gonna resume each step.

```
sudo apt-get install -y build-essential
sudo apt-get install -y qtbase5-dev qttools5-dev
sudo apt-get install -y clang cmake libtool autoconf
sudo apt-get install -y python3 python3-dev python3-pip python3-virtualenv python3-venv
sudo apt-get install -y ruby ruby-dev
sudo apt-get install -y btop tree xterm graphviz git
sudo apt-get install -y octave liboctave-dev
sudo apt-get install -y python3-sphinx python3-sphinx-autoapi python3-pandas python3-tk python3-pytest
sudo apt-get install -y libqt5xmlpatterns5-dev qtmultimedia5-dev libqt5multimediawidgets5 libqt5svg5-dev libqt5opengl5
sudo apt-get install -y tcl8.6 tcl-dev tcl8.6-dev
sudo apt-get install -y tk8.6 tk8.6-dev
sudo apt-get install -y flex clang gawk xdot pkg-config bison curl help2man perl time
sudo apt-get install -y libxpm4 libxpm-dev libgtk-3-dev libffi-dev
sudo apt-get install -y libjpeg-dev libfl-dev libfl2
sudo apt-get install -y libreadline-dev gettext
sudo apt-get install -y libboost-system-dev libboost-python-dev libboost-filesystem-dev zlib1g-dev
sudo apt-get install -y libx11-6 libx11-dev
sudo apt-get install -y libxrender1 libxrender-dev
sudo apt-get install -y libxcb1 libx11-xcb-dev
sudo apt-get install -y libcairo2 libcairo2-dev libxaw7-dev
sudo apt-get install -y libgz libfl2 libfl-dev zlibc zzlib1g zlib1g-dev libz-dev libgit2-dev
sudo apt-get install -y libgoogle-perftools-dev
sudo apt-get install -y gengetopt groff pod2pdf libhpdf-dev
sudo apt-get install -y libfftw3-dev
sudo apt-get install -y libxml-libxml-perl libgd-perl
sudo apt-get install -y libsuitesparse-dev gfortran swig libspdlog-dev libeigen3-dev liblemon-dev
git clone --recursive https://github.com/IHP-GmbH/IHP-Open-PDK.git
echo "export PDK_ROOT=\$HOME/.tools/IHP-Open-PDK" >> ~/.bashrc
echo "export PDK=ihp-sg13g2" >> ~/.bashrc
echo "export KLAYOUT_PATH=\"\$HOME/.klayout:\$PDK_ROOT/\$PDK/libs.tech/klayout\"" >> ~/.bashrc
echo "export KLAYOUT_HOME=\$HOME/.klayout" >> ~/.bashrc
source ~/.bashrc
```

```
git clone https://git.code.sf.net/p/ngspice/ngspice ngspice-ngspice
cd ngspice-ngspice
./autogen.sh
./configure --enable-osdi
make
sudo make install
ngspice -v
```

version 44.2

```
emacs ihp-sg13g2/libs.tech/ngspice/models/dc_hbt_13g2.spice
```

```
**.subckt dc_hbt_13g2
Vce net3 GND 1.2
I0 GND net1 1u
Vc net3 net2 0
.save i(vc)
XQ1 net2 net1 GND GND npn13G2l Nx=1 le=1.0e-6

.lib cornerHBT.lib hbt_typ

.param temp=27
.control
save all
op
print I(Vc)
.endc

.GLOBAL GND
.end
```

output

```
Note: No compatibility mode selected!

Circuit: **.subckt dc_hbt_13g2

Too few parameters for subcircuit type "npn13g2l" (instance: xxq1)
    Simulation interrupted due to error!

Note: No ".plot", ".print", or ".fourier" lines; no simulations run
```

KrzysztofHerman, 2025-02-12:
@jalcim thank you for the detailed response, What about the PDK version ?

sergeiandreyev, 2025-02-12:
from the log above it should be the latest `main` branch of the OpenPDK

jalcim, 2025-02-12:
> from the log above it should be the latest `main` branch of the OpenPDK

its the latest 'main' branch of the OpenPDK

jalcim, 2025-02-12:
Oh...

Alright, it's working now! I hadn't naturally considered that the development branch might be the more stable one.
May I suggest creating a new tag? It could help ensure that newcomers following the PDK don’t run into frustration.

Thanks for help.

Closed 2025-02-12.

Thread 360 (2025-02-13):

NGSPICE basic testcases : Unknown model type pspnqs103va

lionelsaintecluque, 2025-02-13:
Hello,

In [4. Simulation using NGSPICE](https://ihp-open-pdk-docs.readthedocs.io/en/main/analog/ngspice.html#simulation-using-ngspice)

**Yesterday**, first example (BJT testcase) was failing in main branch. I switched to dev branche and got successful results. (according to issue 356 : https://github.com/IHP-GmbH/IHP-Open-PDK/issues/356)
(Thanks for your fast answer)

**Today** I tryied the second example (mosfet) and got another failure.

I'm runnin dev branch of [IHP-Open-PDK](https://github.com/IHP-GmbH/IHP-Open-PDK)
I tested with ngspice ngspice-36 and ngspice-44.2 (similar failure).

I copyied and pasted the proposed example in a file (toto.sp), placed in the same directory as the libraries (it's a bit dirty, but I wanted to test fast).
I ran the simulation within that directory .

```
... models % pwd
... /IHP-Open-PDK/ihp-sg13g2/libs.tech/ngspice/models

... models % cat toto.sp
*Test 2

.lib cornerMOSlv.lib mos_tt
Vgs net1 GND 0.4
Vds net3 GND 1.0
Vd net3 net2 0
.param temp=27
XM1 net2 net1 GND GND sg13_lv_nmos w=1.0u l=0.13u ng=1 m=1
.control
save all
op
let Id = @n.xm1.nsg13_lv_nmos[ids]
print Id
.endc
.GLOBAL GND
.end

... models % ngspice  -b toto.sp

No compatibility mode selected!

Circuit: *lib cornerMOSlv.lib mos_tt

Warning: unknown device type: n
Warning: unknown device type: n
Warning: unknown device type: n
Warning: Model issue on line 0 :
  .model xm1:sg13g2_lv_nmos_psp pspnqs103va type=+1 level=103.60 tr=27.0 d ...
Unknown model type pspnqs103va - ignored
Warning: Model issue on line 0 :
  .model xm1:sg13g2_lv_pmos_psp pspnqs103va type=-1 level=103.60 tr=27.0 d ...
Unknown model type pspnqs103va - ignored
Error on line 0 :
  n.xm1.nsg13_lv_nmos net2 net1 s b sg13g2_lv_nmos_psp w=    1.000000000000000e-06     l=    1.300000000000000e-07     nf=    1.000000000000000e+00     mult=    1.000000000000000e+00     as=    3.400000000000000e-13     ad=    3.400000000000000e-13     ps=    2.680000000000000e-06     pd=    2.680000000000000e-06     dta=    0.000000000000000e+00     ngcon=2
 unknown device type - error
    Simulation interrupted due to error!

Note: No ".plot", ".print", or ".fourier" lines; no simulations run

```

Did I do something wrong ? Did I missed a step ?

Thanks by advance

KrzysztofHerman, 2025-02-13:
@lionelsaintecluque
ngspice from the version 41 supports the osdi interface what enables it to simulate model compiled from Verilog-A code. Our  `mosfets` and `polysilicion resistors` use Verilog-A models which have to be compiled using the compiler `openvaf`  (ngspice) and/or `adms ` (Xyce). The easiest way is to install openvaf and execute the script `openvaf-compile-va.sh` from `libs.tech/verilog-a`. Additionally you have to create a symbolic link `.spiceinit` in your `/home/$USER/` directory which points to the `$PDK_ROOT/$PD/libs.tech/ngspice/.spiceinit`.

lionelsaintecluque, 2025-02-13:
OK (I'm very old school, Xspice looked so new to me that I never really used it).

Then, I will be interested to know if anyone using macosx have advice to give to me to install such tools. I naively tried to install ADMS from https://github.com/Qucs/ADMS, but it does not really compiles with CMAKE (problems with yacc ? )

I'm affraid I may face such difficulties with other verilog-A compilers (I am not sure open-vaf compiles well on macos-X ?)

If someone have feedbacks to share it save me hours or days I feel.

KrzysztofHerman, 2025-02-13:
@lionelsaintecluque
I have to say that the open source EDA tools are pretty sensitive to the platform and that is why almost everyone is using the latest ubuntu LTS version. Even if you take a look at the proprietary tool you'll see that it is similar story. You can ask for some more support on this [slack channel](https://join.slack.com/t/open-source-silicon/shared_invite/zt-2zsrkvm4l-T9QLgyHfMwl4TjPodfp3xg)

jalcim, 2025-02-13:
I can't find any trace of this in the documentation.

https://ihp-open-pdk-docs.readthedocs.io/en/latest/analog/ngspice.html#ngspice-basic-testcases

KrzysztofHerman, 2025-02-13:
@lionelsaintecluque you are right however if you use Qucs-S or xschem the `install.py` scripts do it under the hood.
https://ihp-open-pdk-docs.readthedocs.io/en/latest/analog/xschem.html

jalcim, 2025-02-13:
i prepare a pull request for changing documentation.
i add that and other things inside.

lionelsaintecluque, 2025-02-14:
@KrzysztofHerman : Somehow I find proprietary tools easier to install, because there is somehow no discussion about platform. For example, if a windows computer is required, the question is just who pays...

Regarding macosX and EDA software, it's often a bit tricky. There might be several installing options : homebrew, macports, or compile by myself.
The last one is now my preferred option, but care must be taken for dependencies : if homebrew or macport provides those dependencies, ./configure (or similar) may try to use them, making it all entangled.

The drawback of compiling by myself, is the time. That's why I was curious of people feedbacks.

To be specific, regarding open-vaf, there is apparently a dockers container availaible, but it fails to compile. I may insist in that direction before getting resigned ans find a linux server somewhere.

jalcim, 2025-02-14:
The reality is, its so complex ton install when you dont know exactly what to do.
In fact we need build by source a loot of tools (like llvm for openVAF).
This technical dependency is verry big.
I work actually at a full script for offering a more easy solution, but i cannot make it compatible with all operating system.

KrzysztofHerman, 2025-02-14:
@lionelsaintecluque a lot of substantial progress was done during the recent few years in the open source silicon domain and the reality is that behind each open EDA tool PDK there are individuals or small groups of people working or it. We are not an exception.  The good thing is that this is open source so anybody can pick up the solution and make it work on any platform. We simply do not have the resources to develop and test it using other platforms.

@jalcim thank you for the contribution to our documentation. I will review it. We are also happy to see the solution, which simplifies the build of the tools, which is not an easy task, especially for newcomers.

holvo, 2025-02-14:
OpenVAF has never been compiled under macOS. You will find its most recent source code, pre-compiled executables  and some compile instructions for Linux and Windows at https://github.com/OpenVAF/OpenVAF-Reloaded .

jalcim, 2025-02-14:
Could you please clarify which tag would be the most relevant for compiling OpenVAF in the context of IHP?

adrienluitot, 2025-02-19:
> OpenVAF has never been compiled under macOS. You will find its most recent source code, pre-compiled executables and some compile instructions for Linux and Windows at https://github.com/OpenVAF/OpenVAF-Reloaded .

@lionelsaintecluque @holvo I actually was able to compile OpenVAF on MacOS. The link you shared here, is compatible with MacOS. As far as I remember I pushed the fixes.
And the compilation procedure is pretty much the same as on linux. It is also possible do like the [MacOS CI](https://github.com/OpenVAF/OpenVAF-Reloaded/blob/master/.github/workflows/rust-ci.yml) (part `macos-build-test`).
With this OpenVAF version you will need to use ngspice 44 (or more recent), because this version only generates OSDI v0.4.

___________

> Could you please clarify which tag would be the most relevant for compiling OpenVAF in the context of IHP?

@jalcim The most basic compilation should work, you don't need to specify special arguments/tags.
However, you must be careful with the versions of the different tools.

jalcim, 2025-02-20:
> , is compatible with MacOS. As far as I remember I pushed the fixes.

i think when we talk about MacOS its can be relevant to specify if its intel or arm ship.

>, The most basic compilation should work, you don't need to specify special arguments/tags.
However, you must be careful with the versions of the different tools.

for me its didn't work, easily, hopefully im a very experimented linux user, so i have rebuild all the tools required.

Actually its didnt work totaly for me, but i have try 1 month before.
I need to retry, and make a detailled issue, with a pull request for changing documentation i think.

I have a lot of problem with OpenVAF especialy, exept some tag, he require a so new llvm version for my debian by example.

lionelsaintecluque, 2025-03-03:
Hello all,

@adrienluitot : I did not installed openvaf-reloaded on my mac. It requires to install llvm, and I don't have the courage by now... But thanks for your work.

I installed openvaf on my fedora station, and I simulate in this computer for analog things.

Thanks for your help all, it's working now !

sergeiandreyev, 2025-03-10:
Hi @lionelsaintecluque, is there anything else that should be fixed as a part of this issue, or we can close it?

adrienluitot, 2025-03-13:
> did not installed openvaf-reloaded on my mac. It requires to install llvm, and I don't have the courage by now... But thanks for your work.

I think installing it with brew is easy? I don't really recall 100% but I have LLVM 19 installed with brew, so I guess you could do the same?

sergeiandreyev, 2025-05-21:
> Hi [@lionelsaintecluque](https://github.com/lionelsaintecluque), is there anything else that should be fixed as a part of this issue, or we can close it?

@lionelsaintecluque, gentle reminder..

jalcim, 2025-05-22:
Hello, sorry we forget because we have use a verry tricky hack, so no, its not really solved.

sergeiandreyev, 2025-05-23:
@dwarning, could you please provide the link to the latest OpenVAF version repository which is supported by IHP OpenPDK? as I remember it was Arpad Bruemen fork..

thonglinh90, 2025-06-29:
I have the same issue. Should version of OpenVAF I used?

jalcim, 2025-07-28:
> See the link to binaries on this fork [OpenVAF](https://github.com/arpadbuermen/OpenVAF).

no its this one https://github.com/OpenVAF/OpenVAF-Reloaded

Thread 362 (2025-02-16):

Vagueness in layer relations in layout_rules.pdf

MilosMitrovic411, 2025-02-16:
I have a few questions on how you define relations between shapes and layers.

- unrelated - two regions which do not touch each other
&
- abut - two edges of two different layers touching each other

What does "touch" mean? Since you defined abut as you did, does "touching" represent any two point of a two different shapes interacting. If so, then "unrelated" shapes would be the ones who do not "interact" at all with one another, right?

- nBuLay - (((NWell ≥ 3.0 µm) sized by 1.0 µm/side) OR nBuLay:drawing) AND NOT nBuLay:block

Does "sized by 1.0 µm/side" represent "sized down" or  "sized up"?

- inside & not inside

What is your definition of those? In the picture bellow, N+Activ and ThickGateOxide are "overlapping", would you say that N+Activ is "inside" or "not inside" of ThickGateOxide, are they "touching"? For an example, should rule NW.d or NW.d1 be applied to this N+Activ, or should rule NW.d apply to (N+Activ AND NOT ThickGateOxide), and rule NW.d1 apply to (N+Activ AND ThickGateOxide)?

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

stefansimon42, 2025-02-21:
Hi @MilosMitrovic411 ,

The definition of layer relationships is a difficult topic, as personal preference often plays a role and the definitions of different tool vendors can differ widely. For this reason, we have included a chapter in the Layout Rule documentation that explains the important checks. Of course, this overview is not yet complete and can be expanded at any time.

Regarding your questions:

1. Perhaps this description should be updated in the future.   The word touch can be a bit confusing here. Certain design tools use the keyword “touch” when two edges have a distance of exactly 0.
_unrelated_: Two regions are unrelated if they do not touch or overlap in any way at any time.
_abut_: Two regions touch or overlap each other (see abutted ties).
The tool Calibre uses the term “INTERACT” for this. I think that describes it best.

2. You're right. It is “sized down”, i.e. “sized by -1.0”. I will fix that.

3. With regard to your picture, I would say: N+Activ is “not inside” PSD. Inside means that layer A is completely enclosed by layer B. In contrast, outside means that layer A is unrelated (see above) to layer B.

I hope my answers will help you.

MilosMitrovic411, 2025-02-21:
Hi @stefansimon42,

Thank you very much for your in depth explanation.

It is of a great help. It basically aligns with how I saw it, but as you said it is somewhat personal preference, so I wanted to be sure.

Just one more question about the nBuLay, since it is sized down from NWell, is the DRC error on the picture bellow correct?
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

Should I even check nBuLay rules when the layer itself is not explicitly drawn?

Thank you again @stefansimon42 for your time.

stefansimon42, 2025-02-24:
From my personal perspective, you should also check automatically generated nBuLay. In addition, a “dummy violation” could be added that displays all generated nBuLay.

Unfortunately, I cannot reliably judge the correctness of rule implementations based on screenshots. It would be much more helpful if you could provide a GDS file.

MilosMitrovic411, 2025-02-24:
Thank you. Here you go an example GDS file [ex.zip](https://github.com/user-attachments/files/18947215/ex.zip).

My main concern with this example is that even though N+Activ and nBuLay drawing layers are unrelated, they are electrically connected through the NWell, so my question is basically should the rule NBL.e, as well as NBL.f, be tested inside NWell or not?

Thread 367 (2025-02-23):

Help, how to install/compile ADMS or openVAF on Windows?

MilosMitrovic411, 2025-02-23:
Could somebody explain to me how to install/compile ADMS on Windows or point me to somewhere where there is step by step guide.

I am completely lost, I just want to design my circuits, I am okay with using Ngspice as well, but again I have no clue how to make it work because I don't know how to install/compile openVAF.

If somebody could help, I would be very grateful.

KrzysztofHerman, 2025-02-24:
@MilosMitrovic411 thank you for your interest in the IHP-Open-PDK.
Right now we do not support Windows platform although some tools you can run using this OS.
In order to run the full flow it would be better to switch to linux Ubuntu 24.04 (in WSL mode just to start).

Closed 2025-02-24.

Thread 372 (2025-03-02):

pnpMPA model vs data

christoph-weiser, 2025-03-02:
# Simulation model vs measurement data for the pnpMPA

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

It almost looks like the data was fitted to DUT3 which is an outlier in the data.

The DUT Data is from "ihp-sg13g2/libs.doc/meas/pnpMPA/fg_vcb0_d0406_*"

The Simulation netlist:
```
* pnpMPA test

.lib ihp-sg13g2/libs.tech/ngspice/models/cornerHBT.lib hbt_typ

vss vss gnd 0
vdd vdd vss 1
iref vdd net1 0
vmc vc vss 0
vmb vb vss 0
vme net1 ve 0
xq1 vc vb ve pnpmpa

.options savecurrents
.global gnd

.control
save all
dc iref 1e-12 1e-3 10e-9
let ib = abs(vmb#branch)
let ic = abs(vmc#branch)
let ie = abs(vme#branch)
let vbe = vb-ve
set wr_singlescale
set wr_vecnames
wrdata pnpMPA.csv vbe ic ie ib
.endc

.end

```

christoph-weiser, 2025-03-02:
Closed. The netlist above will actually create valid model data. The xschem symbol that was used to create the circuit had collector and emitter reversed.

Closed 2025-03-02.

Thread 376 (2025-03-05):

MIM.i rule in magic tech

smunaut, 2025-03-05:
First, that rule isn't super clear in the layout guide. It's in the diagram but there is no accompanying text.
Second, it seems the rule triggers when under `mimcap` but not `mimcapcontact` which is probably an omission.
Finally should that rule also trigger for any contacted `metal5` bottom plate if the reason for the rule is antenna related ?

(cc @RTimothyEdwards )

sergeiandreyev, 2025-03-05:
please double check - the `MIM.i` was removed in the DRM v0.2:

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

FYI, @stefansimon42

RTimothyEdwards, 2025-03-05:
The rule for `via_under_mimcap via4` should have `and *mimcap` instead of `and mimcap` so that it includes areas of MiM cap contacts.

However, if the rule has been deprecated, then the rule and associated cif layer should just be removed.

smunaut, 2025-03-05:
@sergeiandreyev Ok, but then Figure 6.13 should also be edited to remove the corresponding drawing.

sergeiandreyev, 2025-03-05:
@smunaut, agree

stefansimon42, 2025-04-01:
Hi @smunaut,
The figure will be updated in the next DRM revision.

Thread 385 (2025-03-07):

IOPadIOVss and IOPadVss don't have strong `TopMetal2` connections.

smunaut, 2025-03-07:
If you look at the Vdd pads, they have very strong connection to the rings through TopMetal2.

For instance here's `IOPadIOVdd`, you can see the direct connection on the bottom pad.
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

But the top pad is a `IOPadIOVss` which should connect to the `IOVss` ring which is right next to it, but instead of having a strong connection through the thick `TopMetal2`, it goes all the way down to `Metal2`, through quite the via stack ...

What I think it should be doing is something like:

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

(this is just an edited image, I haven't implemented it).

Same issue is present for `IOPadVss`. The `IOPadVdd` has a strong connection cutting the through IO ring on `TopMetal2` to directly reach the `Vdd` ring, but the `Vss` one does not and again goes through a lot of via and down to a thin lower metal layer.

sergeiandreyev, 2025-03-10:
Hi @stafverhaegen-chipflow, FYI

stafverhaegen-chipflow, 2025-03-11:
I have a quick fix in my code for `IOPadIOVss`. I can provide gds but this is without the ptap changes that have been done at IHP.
For `IOPadVss` I am holding off for more analysis and the change is a little more involved. I did use top metal for `IOPadVdd`  as there Metal2 was used for internal routing.
Also weak is I think an exaggeration, I would call is non-ideal :) `IOPadVss` is meant for digital core ground and I expect IR-drop problems on the logic before electromigration problem due to current density. Said otherwise if the number of `IOPadVss`/`IOPadVdd` pairs would be so low that one would have electromigration problems due to the high current I would also expect IR-drop problems in the core.

sergeiandreyev, 2025-03-17:
> I can provide gds but this is without the ptap changes that have been done at IHP
we should avoid mixing two different approaches..

Thread 389 (2025-03-08):

Feature request: Add nmos3 / pmos3 symbols

smunaut, 2025-03-08:
Those variant were in sky130 where the bulk connection is set by a property rather than a wire/port. It was _so_ convenient to keep schematics clean, I'd love to see them for SG13G2 too.

KrzysztofHerman, 2025-03-10:
@smunaut thank you for this observation. Indeed we could provide this having two options GND/sub! for the bulk pin. Right now we are focused on bug fixing so we will take some time to do so. If you are willing to provide such symbols we will be happy to accept your PR.

hpretl, 2025-03-10:
@KrzysztofHerman If this is implemented (and I think this would be good to have) then please make the bulk node user-specific, like adding an additional property like $W$ and $L$ (for sure Xschem has a way to nicely set this @stefanschippers). As a circuit designer I do not want to be forced to name a VDD/VSS net for bulks a specific way.

KrzysztofHerman, 2025-03-11:
@hpretl
We could provide something like this:
```
lvs_format="@spiceprefix@name @pinlist @body @model l=@l w=@w ng=@ng m=@m"
format="@spiceprefix@name @pinlist @body @model w=@w l=@l ng=@ng m=@m"
template="name=M1
l=0.45u
w=1.0u
ng=1
m=1
body=GND
model=sg13_lv_nmos
spiceprefix=X
"
```
This way you could specify either is a GND, VSS, VDD, sub! or any other net you wish to use.

smunaut, 2025-03-11:
Yeah, that's exactly what I had in mind.
I was waiting for the nmos direction pr to be merged and then try and make the various nmos3/pmos3 symbols following that scheme.
(I'll just need to move some of the annotations to make room to show the body net)

StefanSchippers, 2025-03-11:
These devices are done in sky130 with the names of nfet3_*.sym and pfet3_*.sym.

The body terminal is specified ( as written by @hpretl ) with a body attribute (like body=GND or body=VCCA).
Within the symbol add `@body` after @pinlist (@pinlist only shows drain, gate, source terminals)
`format="@spiceprefix@name @pinlist @body sky130_fd_pr__@model L=@L W=@W`

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

hpretl, 2025-03-11:
Yes, using a property and showing the value on the symbol is precisely how I think it should be.

smunaut, 2025-03-28:
I drew those :

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

I can open a PR if they're suitable.

Thread 390 (2025-03-08):

xschem NMOS symbol has the source up by default

smunaut, 2025-03-08:
Isn't it a bit weird the NMOS symbol default orientation has the source on top ?

hpretl, 2025-03-10:
@stefanschippers Can you please look at the proposed implementation? Is there a way to implement this w/o screwing up existing schematics?

KrzysztofHerman, 2025-03-11:
@hpretl, @StefanSchippers just to confirm.

The existing schematics should have the mosfets instantiated using the following entry in *.sch file:
```
C {sg13g2_pr/sg13_lv_nmos.sym} 360 -250 2 1 {name=M1
```
After applying 180 rotation and one horizontal flip it changes to:
```
C {sg13g2_pr/sg13_lv_nmos.sym} 360 -250 0 0 {name=M1
```
so maybe this would be the solution to rework all the schematics in a bulk ?

hpretl, 2025-03-11:
@KrzysztofHerman This is precisely how I would do it, either with a script or a text editor, definitely no mousing involved :-)

KrzysztofHerman, 2025-03-11:
@hpretl what about the default orientation of `pmos`, should be same as `nmos` or 180 rotated ?

StefanSchippers, 2025-03-11:
> [@hpretl](https://github.com/hpretl), [@StefanSchippers](https://github.com/StefanSchippers) just to confirm.
>

Yes , see the effect  {rot flip} = {2 1} (**right**) vs {0 0} (**left**)

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

smunaut, 2025-03-11:
IMHO pfets should have their source on top like they do now when in the default orientation.

hpretl, 2025-03-11:
@KrzysztofHerman Default configurations should be (IMHO):

NMOS: drain up, source down, gate left, bulk right
PMOS: source up, drain down, gate left, bulk right

Think of drawing an inverter, NMOS/PMOS should come in the correct orientation by default.

StefanSchippers, 2025-03-11:
> NMOS: drain up, source down, gate left, bulk right
> PMOS: source up, drain down, gate left, bulk right

Yes, this is the default in all cmos processes I have seen, including sky130.
GF180MCU also has this "reversed" nmos issue.

KrzysztofHerman, 2025-03-11:
This is the proposal for the updated symbols.
It modifies the default values of `w` and `l` and set it to the minimum.

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

Is there any more observation ?

StefanSchippers, 2025-03-11:
just a tiny aesthetic observation. if possible move a veeeery little bit down (by reducing the grid size with 'g' key and moving down) the m=... and rfmode=... texts , so you can add a wire to the 'b' terminal without running over the texts. I think it is possible since there is a little room above the model name text.

hpretl, 2025-03-11:
@StefanSchippers @KrzysztofHerman Yes, that would be super nice: Move the texts on all symbols a little bit so that a wire running out of bulk does not go through a text.

hpretl, 2025-03-11:
@KrzysztofHerman the "S" sometimes seems off:

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
 compared to

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

hpretl, 2025-03-11:
BTW, excuse my ignorance: What is `rfmode=1` and why is `Lmin` then 0.72u?

StefanSchippers, 2025-03-11:
@KrzysztofHerman to reposition the S and D labels descend into a 'good' symbol, select both the S and D texts and do a ctrl-c to copy. Then go into a symbol with the wrong placements, delete both texts and do a ctrl-v to paste. SOom or pan a little bit and you should see the position where copied objects need to go. see short video.

https://github.com/user-attachments/assets/0b28ea1e-143a-42a6-8cce-5a97b3774262

smunaut, 2025-03-11:
Look mostly good to me.
I'm possibly bike-shedding, so feel free to ignore this, but my 2ct:
- I like the little 'ball' for the PMOS. Yes the arrow differentiates already but I have an easier time spotting the ball when a PMOS is used in more complex circuit than an inverter.
- Maybe a bit thinker line to mark the gate oxide of HV devices ?

Again, I understand this is purely personal preference, it's just what I noticed I preferred when I compared to the sky130 symbols and I figured it might be good to point them out if modifying the symbols.

KrzysztofHerman, 2025-03-12:
> BTW, excuse my ignorance: What is `rfmode=1` and why is `Lmin` then 0.72u?

So the symbol with `rfmode=1` annotates it in the netlist as follows:
```
XM6 net17 net18 net19 net20 sg13_lv_pmos W=1.0u L=0.72u ng=1 m=1 rfmode=1
XM8 net21 net22 net23 net24 sg13_hv_pmos W=1.0u L=0.72u ng=1 m=1 rfmode=1
```
The effect you got is that the simulation will be performed using some more parameters
extracted using the layout of rfmos.

Here a piece of a model card.

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

KrzysztofHerman, 2025-03-12:
Here goes updated version of the symbols:

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

Changes:

- position of `D S B` pin labels is now unified
- position of the text is aligned such way that one can wire the bulk without overlapping the text layer
- for nmos devices I have flipped horizontally the bulk triangle and shifted the arrow in the source to the maximum right position.

Thank you @StefanSchippers for the video, it was very helpful.

There is also a proposal to make this versions of symbols `sg13_lv_nmos4` and `sg13_lv_nmos3`

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

For 3-terminal device the `body` terminal will be exposed to the user as an instance parameter
```
K {type=nmos
lvs_format="@name @pinlist @body @model w=@w l=@l ng=@ng m=@m"
format="@spiceprefix@name @pinlist @body @model w=@w l=@l ng=@ng m=@m"
template="name=M1
l=0.13u
w=0.15u
ng=1
m=1
body=GND
model=sg13_lv_nmos
spiceprefix=X

```

hpretl, 2025-03-12:
@KrzysztofHerman Thanks, looks good to me :-)

KrzysztofHerman, 2025-03-12:
So maybe this version would be ok? I have diminished the size of the label and also put it into center.

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

smunaut, 2025-03-12:
I don't mind the font size too much the the center is annoying.

For instance the ability to pass a wire through the gate like when you draw a current mirror with multiple outputs is very convenient (and one of the reason I like the mos3 variants of sky130) :

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

StefanSchippers, 2025-03-12:
In xschem the **!** character does not have any special meaning (If i remember well Cadence uses that for global nodes).

In xschem nodes become global if they are attached to tier symbols (vdd.sym or gnd.sym) or label symbols with instance attribute `global=1` defined.

That said it is perfectly fine to use **sub!** for the body terminal. Just use **sub!** everywhere in the symbol attributes.

KrzysztofHerman, 2025-03-12:
@smunaut good point, I will revert the changes.
@StefanSchippers we use `sub!` as a global net in the proprietary PDK. I have also provided a symbol of it and it annotates GLOBAL sub! net in the netlist.

There is one more proposal to use the following symbol convention:

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

Here `nmos` is a device name consistent with the device names in our PyCells where we have:
`nmos, nmosHV, pmos, pmosHV, rfnmos, rfpmos, rfnmosHV, rfpmosHV`.
of course the spice and cdl netlist will use a valid model name to annotate the device.

We could name the symbols using the device naming scheme ie. `nmos.sym`, `nmos4.sym`, `nmos3.sym`

hpretl, 2025-03-12:
@KrzysztofHerman Cleaning up device name is certainly an option.

smunaut, 2025-03-12:
Watchout that in the proposal you have above, you have `LVT` marker which I wouldn't consider appropriate given each transistor type only have one Vt variant.

sergeiandreyev, 2025-03-12:
I guess, in that example was meant Low Voltage (we have LV and HV MOSFETS), not the threshold type like in Sky130

smunaut, 2025-03-12:
The oxide thickness bar already represents that.
Adding a `LV` or `HV` marker would be fine if you want to be more explicit, but `LVT` / `HVT` for me represent threshold voltages, not the voltage tolerance of the mosfet.

KrzysztofHerman, 2025-03-13:
@smunaut good point. We will discuss internally how to deliver the symbols. Thank you all for this discussion. Definitely we will apply  your suggestions elaborating the symbols for `qucs-s`.

olisnr, 2025-03-20:
@smunaut You are right. the bulk shoudnt be in the middle. but i think it would be better on the side of the S because most times its connected to it.

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

smunaut, 2025-03-27:
@KrzysztofHerman Ping. Any idea if/when new xschem symbols will be available ?

sergeiandreyev, 2025-03-28:
Hi @smunaut, the update was part of this PR https://github.com/IHP-GmbH/IHP-Open-PDK/pull/393
It's already merged in `dev` branch, so could you please confirm, and then we can close this issue

Thread 391 (2025-03-10):

Cant Solve 800x800 µm² coverage ratio DRC error

shafinhossain, 2025-03-10:
My design's layout is of 0.91 mm² and after cleaning the relevant DRCs and density errors, I am still getting these errors which mention the 800x800 µm² coverage ratio.

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

In a previous issue #337 that I created, one of the contributors mentioned these 800x800 µm² coverage ratio errors could be ignored.

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

Is it a problem that can be solved? if not then would it cause any issues in the OpenMPW?.

TIA.

sergeiandreyev, 2025-03-10:
Hi @akrinke, could you please take a look / provide your feedback?

akrinke, 2025-03-10:
Hi @shafinhossain, I think the problem can be explained by the following figure. The DRC calculates the density in 800×800 µm² windows which are shifted by 400 µm to cover the whole chip area. In your case with a (square?) chip with an area of 0.91 mm², there are three windows near the top and right border of the chip, that cover mostly pads. While the density calculation ignores the area outside your chip boundary, the pads often violate the minimum density constraint. I assume that increasing the fill rate in the pad ring solves these issues.

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

sergeiandreyev, 2025-03-17:
Hi @shafinhossain, could you please attach the GDS file as a testcase?

shafinhossain, 2025-03-24:
@sergeiandreyev I was able to clean all of the DRCs. Seems like you have to find spaces in per 800x800 um window in order to put all the metal layers and maintain the minimum 25% limit.

Thank you for the cooperation.

sergeiandreyev, 2025-03-24:
good! but please note that having a clean min DRC does not eliminate the possibility of having at the end a non-functional design. In open source DRC deck, we still have a list of rules missing, so please at least go briefly through the DRM, to review chapters that are related to your design, like offGrid (you have circular structures), etc.

sergeiandreyev, 2025-03-25:
Hi @shafinhossain, if there are no more questions on this topic, please let us know if we can close the issue

akrinke, 2025-03-25:
This is a problem in the DRC scripts. The picture I posted above shows the current (incorrect) behavior. The windows in which the density is checked should always be within the chip area. I am working on a fix.

Thread 400 (2025-03-20):

pSD.i violations in GDS generated from magic

smunaut, 2025-03-20:
Reproducer attached.

[psd.zip](https://github.com/user-attachments/files/19375018/psd.zip)

But basically the `pSD` layer is only 0.18u around the `Activ` of PMOS. But in addition to that there is a required extension of 0.3u around the gate (for LV) and 0.4u (for HV).

I naivly did this which seems to fix my immediate issue but is probably not the right way to go about it. ( It only considers plain old PFETs and none of the other devices types )

( cc @RTimothyEdwards )

```diff
diff --git a/ihp-sg13g2/libs.tech/magic/ihp-sg13g2.tech b/ihp-sg13g2/libs.tech/magic/ihp-sg13g2.tech
index b3f272b..cc707bb 100644
--- a/ihp-sg13g2/libs.tech/magic/ihp-sg13g2.tech
+++ b/ihp-sg13g2/libs.tech/magic/ihp-sg13g2.tech
@@ -722,6 +722,8 @@ style gdsii
        grow 180
        bloat-or allpactivetap * 30 allnactivenontap 0 isodiffres 150
        bloat-or allpactivenontap * 180 allnactivetap 0
+       bloat-or pmos * 300
+       bloat-or hvpmos * 400
        and-not transhalo
        and-not varactorarea
        or sealc
```

Thread 402 (2025-03-23):

New "User Power" IO cell

smunaut, 2025-03-23:
Currently if you want to provide a custom power rail to some logic inside the chip, the analog pad is the only option.
However as explained in #401 , the connection from the bond pad to the internal user logic in that cell is not very strong and not suitable for a power rail connection.

Ideally I'd want such a pad to be rated to 50 ~ 100 mA and present less than 0.5 ohm between the bond pad and the internal connection.

Thread 403 (2025-03-24):

transistor multiplier (m) effect does not appear in Xyce simulations

SultanShadow, 2025-03-24:
I have performed basic DC simulations on both LV/HV versions of NMOS and PMOS transistors available in the PDK using xschem and Ngspice+Xyce. The effect of transistor multipliers does not appear in the results when simulated through Xyce.

Below is the lv_nmos simulation with m=1 using ngspice

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

and same simulation with Xyce

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

In both cases the results are same
if I change m=2 the the ngspice result is as expected (currents scale by about 2x)

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

but for xyce, the results stay the same as they were for the case of m=1.

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

Am I missing some configuration/setting option in case of Xyce ?

SultanShadow, 2025-03-25:
Hi kryzysztof, thank you for responding. I thought I looked at open issues
to see if it was there but I guess missed it. You can close the issue.
Thank you for clarifying

On Tue, 25 Mar 2025, 1:01 am Krzysztof Herman, ***@***.***>
wrote:

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

Closed 2025-03-25.

Thread 406 (2025-03-25):

KLayout LVS scripts should be platform-agnostic

martinjankoehler, 2025-03-25:
## Problem

- `ihp-sg13g2/libs.tech/klayout/tech/lvs/sg13g2.lvs` uses Linux-specific system executables `pmap`/`tail`
  - fails on Windows (at least outside WSL), as both `pmap`/`tail` are not available by default on this platform
  - fails on macOS, as `pmap` is not available by default on this platform
- `libs.tech/klayout/tech/lvs/sg13g2_full.lylvs` contains a custom implementation `get_memory_usage`

## Solution

- KLayout already offers the Ruby API `RBA::Timer.memory_size` on all platforms

Closed 2025-06-14.

Thread 410 (2025-03-26):

sram: Missing cells in RM_IHPSG13_1P_1024x8_c2_bm_bist

dnltz, 2025-03-26:
I added RM_IHPSG13_1P_1024x8_c2_bm_bist as SRAM cell. OpenROAD now reports the following error when merging GDSs:

```
[INFO] Checking for missing cell from GDS/OAS...
[ERROR] LEF Cell 'RM_IHPSG13_1P_BITKIT_16x2_EDGE_TB' has no matching GDS/OAS cell. Cell will be empty.
[ERROR] LEF Cell 'RM_IHPSG13_1P_BITKIT_16x2_CORNER' has no matching GDS/OAS cell. Cell will be empty.
[ERROR] LEF Cell 'RM_IHPSG13_1P_BITKIT_16x2_LE_con_corner' has no matching GDS/OAS cell. Cell will be empty.
[ERROR] LEF Cell 'RM_IHPSG13_1P_BITKIT_16x2_LE_con_edge_lr' has no matching GDS/OAS cell. Cell will be empty.
[ERROR] LEF Cell 'RM_IHPSG13_1P_BITKIT_16x2_TAP' has no matching GDS/OAS cell. Cell will be empty.
[ERROR] LEF Cell 'RM_IHPSG13_1P_BITKIT_16x2_LE_con_tap_lr' has no matching GDS/OAS cell. Cell will be empty.
[ERROR] LEF Cell 'RM_IHPSG13_1P_BITKIT_16x2_TAP_LR' has no matching GDS/OAS cell. Cell will be empty.
[ERROR] LEF Cell 'RM_IHPSG13_1P_BITKIT_16x2_POWER_ramtap' has no matching GDS/OAS cell. Cell will be empty.
[INFO] Checking for orphan cell in the final layout...
```

I haven't verified if other sram cells have the same issue.

smunaut, 2025-03-26:
Related to #239 I think.

sergeiandreyev, 2025-03-26:
yes, related to that one, but still, as mentioned in a separate email, these are empty (placeholder) blocks in GDS -> there is nothing expected to be inside, so you have to configure the flow to skip them

dnltz, 2025-03-29:
We can disable that error in openroad with the following export
```
export GDS_ALLOW_EMPTY = RM_IHPSG13_1P_BITKIT_16x2_*
```
That will result in warnings:
```
[INFO] Found GDS_ALLOW_EMPTY variable.
[WARNING] LEF Cell 'RM_IHPSG13_1P_BITKIT_16x2_TAP' ignored. Matches GDS_ALLOW_EMPTY.
[WARNING] LEF Cell 'RM_IHPSG13_1P_BITKIT_16x2_EDGE_TB' ignored. Matches GDS_ALLOW_EMPTY.
[WARNING] LEF Cell 'RM_IHPSG13_1P_BITKIT_16x2_LE_con_edge_lr' ignored. Matches GDS_ALLOW_EMPTY.
[WARNING] LEF Cell 'RM_IHPSG13_1P_BITKIT_16x2_LE_con_tap_lr' ignored. Matches GDS_ALLOW_EMPTY.
[WARNING] LEF Cell 'RM_IHPSG13_1P_BITKIT_16x2_TAP_LR' ignored. Matches GDS_ALLOW_EMPTY.
[WARNING] LEF Cell 'RM_IHPSG13_1P_BITKIT_16x2_POWER_ramtap' ignored. Matches GDS_ALLOW_EMPTY.
[WARNING] LEF Cell 'RM_IHPSG13_1P_BITKIT_16x2_LE_con_corner' ignored. Matches GDS_ALLOW_EMPTY.
[WARNING] LEF Cell 'RM_IHPSG13_1P_BITKIT_16x2_CORNER' ignored. Matches GDS_ALLOW_EMPTY.
[INFO] Checking for orphan cell in the final layout...
```

@sergeiandreyev @KrzysztofHerman I would like to add that to the ihp-sg13g2 platform config in ORFS. Do you see any problems with that?

sergeiandreyev, 2025-03-29:
Hi @dnltz , great, thank you! From my side no objections, the only thing - we need to verify the empty GDS cells in all the SRAM macros provided so far, if the set pattern will cover all of them

sergeiandreyev, 2025-03-29:
and on the other side, that it will not capture the cells which are not supposed to be empty

dnltz, 2025-04-14:
@sergeiandreyev I would propose to add following to ORFS:

```
export GDS_ALLOW_EMPTY = RM_IHPSG13_1P_BITKIT_16x2_(TAP|EDGE_TB|LE_con_edge_lr|LE_con_tap_lr|TAP_LR|POWER_ramtap|LE_con_corner|CORNER)
```
That should only disable thos empty cells in SRAM macros.

Closed 2025-04-17.

Thread 412 (2025-03-27):

Angle checks

mole99, 2025-03-27:
I'd like to make a doodle for some chip art, and I'm wondering if I can use non-manhatten geometry on TopMetal2.

In the layout rules it is stated under 3.1 Grid Rules:

> Following layers are only allowed on 90, 135, 180, 225, and 270 degree angles: GatPoly, Activ, Metal1, Metal2, Metal3, Metal4, Metal5, TopMetal1, TopMetal2

Well, if I interpret that correctly that means in addition to 90° angles I can also do 45° angles on TopMetal2 (or 135°, depends how you look at it). (Rule `Gat.f` also uses 45° to describe the angle, so this seems to be inconsistent with the grid rules.)

But if possible, I would like to do smooth curves.

I've seen traces with round edges in one of the user submitted designs for the April tapeout for multi-GHz stuff. It's this design here: https://github.com/IHP-GmbH/TO_Apr2025/pull/4

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

The traces with the round edges are on TopMetal2. As it is, this would violate the angle rules, but both the KLayout minimum and maximum rule set don't catch it.

So is this an error in the documentation, the DRC set, or the design?

If technically feasible, I would love to make smooth curves on TopMetal2 ;)

mole99, 2025-03-27:
Hi @sergeiandreyev, thanks for your reply!

I don't think the layout violates the offgrid rules. The grid is 5nm and the coordinates for all points of the curve are on the 5nm grid.

So the only issue would be the `non45R_TopMetal2` rule.
Is there a reason why TopMetal2 is restricted to these angles? I think for sub-GHz it's important to have round traces.

If that's not possible, you should probably let the person behind this PR know that their design can't be manufactured: https://github.com/IHP-GmbH/TO_Apr2025/pull/4

akrinke, 2025-03-28:
@sergeiandreyev `OffGrid` rules are part of the Maximal Rule Set and also listed in `README_maximal.md`. This includes a check for `TopMetal2` (`OffGrid.TopMetal2`). The DRC checks the position of individual vertices. Since GDS doesn't support round features, curves have to be approximated. Interestingly, and as @mole99 also wrote, the layout from the first comment does not contain OffGrid errors!

Currently, we do not check for 45 degree angles, so rules like `non45R_TopMetal2` are missing. We will add these rules.

mole99, 2025-03-28:
Thanks @akrinke for confirming that there are no offgrid errors in the design.

Still, I don't really see the reason for the `non45R_TopMetal2` rule.

I found this paper of a transmitter/receiver using the SG13G2 process: https://www.ihp-microelectronics.com/php_scripts/publications/full_text_final_files/schmalz-schmalz-ieee_j.-microwaves-2-582-2022-2022.pdf

One can clearly see that the antenna uses round geometry, why shouldn't this be possible with the open source PDK?

sergeiandreyev, 2025-03-28:
> [@sergeiandreyev](https://github.com/sergeiandreyev) `OffGrid` rules are part of the Maximal Rule Set and also listed in `README_maximal.md`. This includes a check for `TopMetal2` (`OffGrid.TopMetal2`). The DRC checks the position of individual vertices. Since GDS doesn't support round features, curves have to be approximated. Interestingly, and as [@mole99](https://github.com/mole99) also wrote, the layout from the first comment does not contain OffGrid errors!
>
> Currently, we do not check for 45 degree angles, so rules like `non45R_TopMetal2` are missing. We will add these rules.

Hi @akrinke, yes, sorry, somehow I didn't catch them.. I had a discussion internally on this topic, there should be no `offGrid` LVS violations on circular / round Metal shapes (it means we have to do some fixes internally), even if they occur they are of very low priority, so their impact on manufacturability is minimal
copying @stefansimon42 :)
@mole99, could you please attach a testcase, that we can cross check internally

sergeiandreyev, 2025-03-28:
> Still, I don't really see the reason for the non45R_TopMetal2 rule.
on this we have also a disconnect which we should resolve internally

sergeiandreyev, 2025-03-28:
Hi @Atif07Ali, Angle rules are not part of short (min) DRC, so will pass rejection tests, no worries here

mole99, 2025-03-28:
> Hi [@Atif07Ali](https://github.com/Atif07Ali), Angle rules are not part of short (min) DRC, so will pass rejection tests, no worries here

Thanks @sergeiandreyev, that's exactly what I wanted to know.

Just to confirm, this means I can use non-45° angles on TopMetal2 (for some chip art) for the April tapeout and the design won't be rejected (as long as everything is on-grid of course).

Perhaps it would be good to update the documentation and clarify that the angle rules are not a manufacturing requirement, but rather a recommendation :)

sergeiandreyev, 2025-03-28:
> Perhaps it would be good to update the documentation and clarify that the angle rules are not a manufacturing requirement, but rather a recommendation :)

I'll let @stefansimon42 to comment on this

Thread 414 (2025-03-28):

LVS issues related to svaricap device

prabhatdubey92, 2025-03-28:
This netlist together with a single instantiation of a svaricap device gives clean LVS
```
.subckt svaricap_lvs
C1 net2 GND net1 sub sg13_hv_svaricap W=3.74e-6 L=0.3e-6 Nx=1
.ends
.end
```

This netlist together with a two unconnected instantiation of a svaricap device gives clean LVS
```
.subckt svaricap_lvs
C1 net2 GND net1 sub sg13_hv_svaricap W=3.74e-6 L=0.3e-6 Nx=1
C1 net2 GND1 net1 sub sg13_hv_svaricap W=9.74e-6 L=0.3e-6 Nx=4
.ends
.end

```

This netlist together with a two instantiations where gnd is connected gives LVS errors
```
.subckt svaricap_lvs
C1 net2 GND net1 sub sg13_hv_svaricap W=3.74e-6 L=0.3e-6 Nx=1
C1 net2 GND net1 sub sg13_hv_svaricap W=9.74e-6 L=0.3e-6 Nx=4
.ends
.end
```
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

The following setup crushes LVS
```
.subckt svaricap_lvs

C1 net2 GND net1 sub sg13_hv_svaricap W=3.74e-6 L=0.3e-6 Nx=1
C2 net2 GND net1 sub sg13_hv_svaricap W=3.74e-6 L=0.3e-6 Nx=1
.ends

.end
```

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

Thread 418 (2025-03-30):

Device Present in Netlist but not showing during LVS

rupokdas147, 2025-03-30:
Capacitor **CDC1** is present in netlist but not showing in the reference during LVS check.

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

d-m-bailey, 2025-03-31:
@rupokdas147 In the source side, `CDC1` and `CDC3` have been combined to `DC3` (check the sizes).

On the layout side, the devices `$6` and `$2` have not been combined. Can you verify that `$6` and `$2` are parallel (connected the same) in the layout?

There may be a problem with the reduction rules. It appears that `w`, `l`, and `A` are all summed, while `P` remains the same.

rupokdas147, 2025-03-31:
@d-m-bailey yes they are parallel in the layout side. This is the netlist provided by Klayout.

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

sergeiandreyev, 2025-04-02:
Hi @atorkmabrains, @FaragElsayed2, could you please take a look?

Thread 419 (2025-03-31):

Feat Req: Add protection diodes to IO cell inputs (core side)

smunaut, 2025-03-31:
I think it would be nice to have antenna protection diodes on the inputs from the core. Those signals come potentially from a long way ...
Just my 2ct, feel free to close if you don't think it's a good idea.

sergeiandreyev, 2025-03-31:
Hi @stafverhaegen-chipflow, @b10346,
 could you please provide your feedback on this suggestion?

stafverhaegen-chipflow, 2025-03-31:
I agree and actually the output only cells (e.g. *IOPadOut?mA*) do have a diode next to the input gate.
Only in the bidirectional and tri-state output cells extra logic was put in front without also including diodes.
I support it adding to todo list for future improvements.

Thread 421 (2025-04-01):

sub.sym: more description please

EngGhaith, 2025-04-01:
Hi everybody,
about the PDK symbol sub.sym in Xschem:
Should we tie the sub.sym to GND, or should we use this symbol instead of the Xschem-original gnd.sym? or both are equivalent?

Tank you very much.
Ghaith.

KrzysztofHerman, 2025-04-01:
@EngGhaith
The purpose of the symbol is to annotate in the netlist a global net named `sub!`. The net (and the associated node) represents substrate so you can use it whenever you want to keep devices connected to the substrate. It is useful if you would like to distinguish between VSS potential rail and bulk potential and make use of `ptap1` device. Some other devices like 'isolbox', `dantenna`, `ptap1`   also connect directly to the substrate.

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

This is the netlist corresponding  to the schematic show above.
The `.GLOBAL` qualifier will make the `sub!` net available at each level of hierarchy
```
XD1 sub! net1 dantenna l=0.78u w=0.78u
XR1 sub! net2 ptap1 R=262.8 w=0.78e-6 l=0.78e-6
XD2 net3 net4 sub! isolbox l=3.0u w=3.0u
.GLOBAL sub!
```

EngGhaith, 2025-04-01:
Is there any specian devices, which must been manually tied to sub?
e.g. substrate of NPN HBT? Or they are already tied to substrate?

KrzysztofHerman, 2025-04-01:
@EngGhaith
In general the fourth terminal is a bulk (substrate terminal) and you can connect it to the `sub!` net or `VSS` net. If you connect to VSS you neglect the finite resistance between the substrate and `VSS` which you can model using `ptap1` device.
The exception are our `rfmos` devices which already have a tap ring  (which act as `ptap1` device)  and its resistance is a part of the model so it is justified to connect the bulk directly to the `VSS` on the schematic.

Thread 422 (2025-04-01):

Capacitors for RF: more documentation needed

EngGhaith, 2025-04-01:
Hi everybody,

could you please provide informations about useful RF-Caps?
In Xschem there are 3 Symbols: cap_cmim.sym, cap_rfcmim.sym, cap_cpara.sym.
I wanna know which is more accurate and has less Process Variation (PV), because I am using them in Matching Circuits.
CMIM is documented in the process spec file, but what about RFCMIM and CPARA?
What is the difference between CMIM and RFCMIM?

Typically CMOM is used for RF, due to its good modelling and low PV. Do you have such cells?

Thank you in advance.
Ghaith.

VolkerMuehlhaus, 2025-04-02:
cap_rfcmim is an extended version of cap_cmim, with more layout restrictions (feedlines from opposite sides, additional ground frame on lower metals) and with a more accurate RF model. This model includes series inductance due to physical size (-> SRF) and losses, whereas the standard cap_rfcmim is modelled more or less as an ideal capacitor. Regarding the C value calculated at low frequency, both models are identical.

EngGhaith, 2025-04-03:
@VolkerMuehlhaus Thank you very much. It seems to be a good modeled Cap for RF now.

I have the following questions about RFCMIM in Xschem:

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

Where should we tie the pin bn?
This symbol is typically used for polarized caps, ist this cap polarized?
What is the impact of the wfeed? how to choose it well? depends that on operating frequency or current density?

And maybe also in KLayout:

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

What should we manipulate?
I mean ofcourse w, l and wfeed. THen, C should be automatically calculated, or? because I have to enter it manually to the field (according to that calculated one in the schematics).
What about other parameters (Cspec, Wmin, Lmin, Cmax)?

VolkerMuehlhaus, 2025-04-03:
@EngGhaith
The bn is the bulk node, it must be connected to substrate potential. This path in the underlying circuit model is used for parasitics to the substrate.
rfcmim is not polarized, it's essentially a plate capacitor.
wfeed is the feed line width, is has some effect on parasitic series inductance and shunt capacitance to the substrate.

I can't comment on calculation within the Klayout form, if that is perhaps missing. I only know this model from the Cadence flow because I created the underlying circuit model and equations.

VolkerMuehlhaus, 2025-04-03:
Yes, connecting the bn terminal to sub! is correct.

sergeiandreyev, 2025-10-07:
Hi @EngGhaith,
> Then, C should be automatically calculated, or? because I have to enter it manually to the field (according to that calculated one in the schematics).
What about other parameters (Cspec, Wmin, Lmin, Cmax)?

All these parameters should be automatically recalculated in KLayout Pcells, the thing is the callbacks are still missing - we're working on this..

Thread 423 (2025-04-01):

Enhancement Req: Add `nofill` zones in IO cells

smunaut, 2025-04-01:
The IO cells are very dense in `Metal` and `Activ`, so for most layers it doesn't make sense to have fill in them. And even if the fill algo can find some small nook to stuff a tiny fill shape in between two giant power rails, I don't think it's really desirable.

What I propose is to add `nofill` overlays on the IO cells for all fill layers except for:
* `Metal2` : There is no big rail on this layer in the cells, so you actually want `Metal2` fill
* `GatPoly` : If you have a `Activ:nofill`, there won't be any `GatPoly` fill anyway and there is a `GFil.i` DRC rule that'd be violated.

For the zone to be covered, I used the same area as `prBoundary` except for the `Corner` cell where I cut one of the corner.

Attached are :
 * A `gdstk` script that does the modification suggested above.
 * A GDS modified with the above script

[ihp_io_nofill.py.gz](https://github.com/user-attachments/files/19551616/ihp_io_nofill.py.gz)
[sg13g2_io_nofill.gds.gz](https://github.com/user-attachments/files/19551615/sg13g2_io_nofill.gds.gz)

Also an example picture with `Metal5` and the `nofill` area.

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

Of course the script and GDS are only for illustration, if the cells have some other source format / script to generate them, that's where the modification should be made, that's why I didn't open a PR but raised an issue.

sergeiandreyev, 2025-04-02:
Hi @smunaut, thank you for the contribution! Do you consider making a PR?
@stafverhaegen-chipflow, @b10346, could you please take a look?

Thread 425 (2025-04-02):

resistor warning from commercial PDK

olisnr, 2025-04-02:
if somebody with the commercial PDK looks at my .GDS there are warnings in the netlist:
```
***************************************
.SUBCKT rppd$1
** N=4 EP=0 IP=0 FDC=0
** WARNING: BAD DEVICE on layer Rppd_nwell at location (0,0) in cell rppd$1 (see extraction report).
*.CALIBRE WARNING BADDEV BAD DEVICE(s) detected by extraction in this cell. See extraction report for details.
.ENDS
***************************************
```
is this a problem or normal?

olisnr, 2025-04-03:
[VCO_HBT_inv_13.gds.zip](https://github.com/user-attachments/files/19592293/VCO_HBT_inv_13.gds.zip)

its from this inverter

olisnr, 2025-05-20:
@sergeiandreyev do You know something new about the RPPD?

Thread 428 (2025-04-03):

Documentation of Rppd

EngGhaith, 2025-04-03:
Hi everyone,
I need some help due to lack of device documentation:
In Xschem:

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

What is the parameter b, and which impact on accuracy/current density/...etc. should it give?
In the docs of process spec it says that for prceision resistors use w>=2µm, but which b is then preffered?

In KLayout:

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

Which parameters to manipulate and which to be "automatically" calculated?
Because the GUI allows me to manipulate everything and do not update other parameters automatically. E.g. If I changed Imax to 3m, It would not change neither w, nor l nor R.
It would be nice to provide any infos about the other parameters also.

Thank you in advance.
Ghaith.

KrzysztofHerman, 2025-04-03:
@EngGhaith
1. The `b` parameter is the number of bends (for a snake type resistor). Setting `w`, `l`, `b` and `m` are the designers decisions.
2. It is a fact that we have these PyCells released with tremendous amount of options that are not yet supported by `klayout`.
    But still you can basically edit the fundamental parameters and do hand calculations. Also keep in mind that our PDK
    is in the preview mode.

Thread 431 (2025-04-04):

OpenLane support

jadoro, 2025-04-04:
Hello,

I was trying to synthesisze a small test deisgn for `ihp-sg13g2` using OpenLane and found that currently (68eebaf), no `openlane/config.tcl` is provided in `libs.tech`.
Digging a bit, I found [this IHP press release](https://www.ihp-microelectronics.com/services/research-and-prototyping-service/fast-design-enablement/open-source-pdk), stating
> Within the project there will be two established open source digital design flows that can be used with the IHP Open Source PDK. While the OpenROAD flow is already supported, the setup for the OpenLane flow will be provided within 2024.

I just wanted to kindly ask whether there is any update on this statement, especially given the [unclear future of efabless](https://web.archive.org/web/20250324223745/https://efabless.com/notice), who seemed to be a major driving force behind OpenLane.

Thanks a lot for your efforts!

KrzysztofHerman, 2025-04-04:
@jadoro there is ongoing WiP to have support for openlane you can try it out using [this](https://github.com/mole99/IHP-Open-PDK/tree/openlane) fork & branch. Maybe @mole99 could give you some more details.

jadoro, 2025-04-04:
@KrzysztofHerman That looks great, thanks a lot for the hint! I'll give it a try.

KrzysztofHerman, 2025-04-04:
@jadoro give us some feedback about the performance and issues if you find any.

mole99, 2025-04-04:
I have a few examples ready to run: https://github.com/mole99/ihp-openlane-examples
(Note, the configs may need to be adjusted, i.e. the die area for ttihp0p2-one-sprite-pony)

For simple macros it already works fine, but there are still a few issues that need to be sorted out.
I've been designing a chip for the April tapeout using OpenLane, and there were a few issues for which fixes still need to be properly integrated. This is going to happen during the next few months.

jadoro, 2025-04-04:
Thanks a lot, this looks like a really nice example to get started with!

We're currently using OpenLane 1, which seems to expect slightly different variables in `config.tcl` (e.g. `CELLS_LEF` instead of `CELL_LEFS`, `LIB_SYNTH` being defined, …). I will probably try to see if I can achieve OL1 compatibility in reasonable time, otherwise me might migrate our flow.

mole99, 2025-04-04:
You're welcome! Yes, many of the variables have been renamed or deprecated since OpenLane 2.

I would recommend you to upgrade to OpenLane 2 as it has a lot of improvements compared to OL1 and continues to be developed. I also enjoy using Nix instead of Docker to manage the tools and their environment.

Thread 434 (2025-04-06):

maximum DRC sees bLay ERRoR that KLayout dont see...

olisnr, 2025-04-06:
with the maximum DRC script from the dev-PDK i get an NBL.a error, where i dont see any nBluLay... may be a script error?

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

[VCO_schmitz.gds.zip](https://github.com/user-attachments/files/19620570/VCO_schmitz.gds.zip)

sergeiandreyev, 2025-04-07:
Hi @akrinke, could you please take a look?

akrinke, 2025-04-07:
This bug is fixed in PR #432.

Thread 435 (2025-04-07):

`tt_stat` models are picking new random parameters per device instance

smunaut, 2025-04-07:
So what is expected when running a `tt_stat` sims, is that random device parameters are picked once (per device type) and then applied to all instances of that devices in the design.

This is not what happening. Instead each instance gets different random parameters which as you can imagine is a bit unrealistic because the spread from `tt_stat` is quite wide and using random parameters in current mirrors or differential pairs leads to "interesting" results.

The way the models pick the parameters is using `.param xxxx = gauss(....)` and if you believe the `ngspice` manual, theses should be evaluated once at startup and the same value used everywhere, which is exactly what you'd want here.

Unfortunately, the manual is wrong ... I've opened a thread on the `ngspice` mailing list ( https://sourceforge.net/p/ngspice/discussion/133842/thread/c13bbd10c6/ ) but the gist of it is that there seem to be a deliberate, undocumented behavior that any `param` that has a statistical distribution function in it is re-evaluated at each use.

That obviously wreaks havoc here the way the models are written ... it basically creates a mismatch simulation but with a much greater spread of parameters than you'd want for a mismatch sim :/

One work around I've tried is instead of :
```
.param xxx = gauss(...)
```

is to use :

```
.param rnd_xxx = gauss(...)
.param xxx = rnd_xxx
```

Then `xxx` will actually have a stable value.

This is an example patch that applies that work around to the models here.
[ihp_stat_workaround.diff.gz](https://github.com/user-attachments/files/19628464/ihp_stat_workaround.diff.gz)

Note that this is for testing/evaluation only. I only checked the `lv nmos` with it applied and I'd also like to see how the `ngspice` thread before applying anything, but I'm opening the issue here to keep track / not forget about it.

dwarning, 2025-04-07:
@smunaut
I think something was confused. If we speak about tt_stat the model parameters are varied - not instance parameters. The variation of all devices with same model should give similar range as we have for corner simulation, but randomly. This approach should not mixed with instance variations which give us the mismatch result between two (or more) devices of same model type.

Can you prepare a simple test case where you show the failed behavior.

I attached my test case based on the actual state of dev branch.

[lv_nmos_id_vd_vg_stat.txt](https://github.com/user-attachments/files/19632516/lv_nmos_id_vd_vg_stat.txt)

Using that I get this:

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

what looks plausible for me.

smunaut, 2025-04-07:
I understand that `tt_stat` is meant to vary model parameters and not instance parameters. But that's not what it _actually_ does because `ngspice` doesn't behave like the manual says it does. You could very well call this an ngspice bug but the result is the same, ATM `tt_stat` doesn't do what it should.

Here's a minimal test case.
It's two identical transistors, fixed Vgs and Vds, measuring Id of each. From run to run the Id value should vary but be the same for the two transistors (they are _identical_) .... but that's not what happens. Each transistor gets a different Id.

[tt_stat_test.txt](https://github.com/user-attachments/files/19632975/tt_stat_test.txt)

dwarning, 2025-04-07:
OK, now I understand and can confirm. There goes something wrong with ngspice. Must see what the outcome is from Holger's investigation.
An alternative way to your recommendation with "re-parametrization" could be to shift the gauss() functions direct to the model parameter set instead. Will try it at the next opportunity.

Thread 438 (2025-04-08):

Relax metal filler rules

mole99, 2025-04-08:
We have seen in the previous tapeouts that fill generation still proves to be a challenge. This may be partly due to the current fill generation scripts, which do not work equally well for every layout. In part, it may also be due to the metal filler rules, which are unnecessarily restrictive.

Especially with digital designs, fill generation for the metal layers can be very painful. Each routing layer has a preferred direction, which makes it difficult to insert square filler shapes.

Take this Metal2 section of my latest design for example:

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

It mostly consists of horizontal routing which makes it hard to insert square filler, but it's not dense enough to meet the local density limit by itself.

I had to make five passes of the smallest fill shape with different offsets to get it to meet the density limit. This costs a lot of runtime, but is probably not necessary for most designs.

The smallest fill for Metal1-5 of 1x1um with 0.42um spacing seems overly conservative. In comparison, the smallest metal fill on sky130 is 0.3x0.3um with 0.2um spacing. I'm aware that the metal widths and spacings for the two processes are different, still it seems too restrictive.

Perhaps the following change could be considered:

1. Lower the minimum Metal1-5 filler width to 0.5 (`MFil.a1`)
2. Create a new rule to set the minimum filler area to 1um²

This should keep the risk of delamination about the same (?), but would allow fill shapes such as 0.5x2um or 2x0.5um that can be inserted into digital designs much more easily.

dnltz, 2025-04-10:
If we have smaller Mx filler rules, we could define three cell sizes:

- S: 0.5
- M: 1.42
- L: 3.26

each is times 2 bigger with a distance of `0.42` included. That means we could start filling L. Afterwards, add M where L doesn't fit and the same with S.

mole99, 2025-04-10:
Yes, that's generally a good idea. In fact, magic already does three passes for each metal layer with different sizes. With the proposed minimum metal width, this would probably work for most, if not all, layouts.

Thread 439 (2025-04-08):

OpenEMS TLine Example and TLines in SG13G2

EngGhaith, 2025-04-08:
Hi Everybody!
In the example you have provided about simulating TLines with openEMS I have observed, that there is a SiO2 above the top line Metal:

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

Is that right modeled?
This SiO2 would change the behaviour of simple microstrip to embedded microstrip.

Can we get an etched SiO2 (Passivation/Air above TM2) above th Line in your opensource PDK and how to do it in the GDS?

Thank you in Advance.
Ghaith Al Sabagh.

VolkerMuehlhaus, 2025-04-08:
Let me add one detail: In the process specification, you can find a drawing of the actual chip cross section (as manufactured) which has a **conformal** layer of 1.5µm oxide and 0.4 SiN on top. The planarized model is only a simplification for EM simulation, and will indeed over-estimate the capacitance a bit.

The 0.4µm SiN layer can be removed/dismissed to speed up openEMS simulation, if all the other mesh dimensions in your model are much larger. As you might know, the timestep in FDTD is determined from the smallest mesh cell dimension, so we don't want to have a small mesh dimension if it's not relevant anyway. That's why SiN is missing in the stackup/example that you used.

That said, the SiO2 thickness in your screenshot looks a bit large, compared to the 3µm TM2 layer. The oxide should be 1.5µm above TM2, but it's actually 3.5µm in the screenshot that you show. There is something wrong with the stackup in this example - shame on me, I had created the code and need to check where this extra 2µm results from!

VolkerMuehlhaus, 2025-04-08:
@KrzysztofHerman

Hi Krzysztof, can you fix this mistake for me? The code says

`   SiO2_thick = 17.73`

but I just double checked that the correct value would be

`   SiO2_thick = 15.73`

which is 2µm less indeed. That's why the oxide above TM2 looks so thick in the screenshow shown by @EngGhaith.

The wrong oxide thickness value is in all 3 *.py models here:
https://github.com/IHP-GmbH/IHP-Open-PDK/tree/main/ihp-sg13g2/libs.tech/openems/testcase/SG13_Octagon_L2n0/OpenEMS_Python
and in all *.m models here:
https://github.com/IHP-GmbH/IHP-Open-PDK/tree/main/ihp-sg13g2/libs.tech/openems/testcase/SG13_Octagon_L2n0/OpenEMS_Matlab

KrzysztofHerman, 2025-04-14:
> Hi Krzysztof, can you fix this mistake for me? The code says

Hi @VolkerMuehlhaus I  have just created a PR #450.  Could you please confirm that it fixes the issue ?

VolkerMuehlhaus, 2025-04-22:
> and calculated the impedance of the line:

@EngGhaith Sorry for my late reply! Something is wrong with your line impedance calculation, from S11 < -25dB we can see that line impedance is really close to 50 Ohm. You should check your math with some known data.

If you have calculated the 2-port data for your line, you might also use my RLGC line extraction code here:
https://github.com/VolkerMuehlhaus/lumpedmodel/tree/main/rlgc_from_s2p
which calculates transmission line model parameters at one single frequency, and also shows the line impedance.

If you look at the code there, you will notice this simple method of calculating Zline:

`Zline = np.sqrt(z11/y11)`

where np.sqrt is the sqrt() function from numpy library.

KrzysztofHerman, 2025-08-15:
@VolkerMuehlhaus @EngGhaith
I have reviewed this issue once again. From the PDK point of we have merged the #450 hot-fix. Is there anything else to fix  or can we close.

EngGhaith, 2025-08-15:
From my side nothing more to do.

Closed 2025-08-15.

Thread 442 (2025-04-10):

sram macros adding shapes to 235/4

dnltz, 2025-04-10:
The current sram macros have boxes at layer `prBoundary.boundary`.

(purple boxes)

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

After merging the sram macro gds into a chip with OpenROAD, these boxes appear on 235/4

(sram macro is rotated by 180 degree!)

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

smunaut, 2025-04-10:
See #345 probably.

KrzysztofHerman, 2025-08-15:
Completed by #526

Closed 2025-08-15.

Thread 443 (2025-04-10):

Klayout LVS of GDS vs two different CDL netlists is clean

b10346, 2025-04-10:
Hello,

It is found strange behavior of LVS deck in Klayout version 29.12.
Two CDL netlists (cdl_v1 and cdl_v2) have a difference in a pins (B1 and B2) to gates connection (see attached files).
Klayout LVS shows "Clean" results with the same GDS layout.

Merging of stacked MOS structure can cause potential errors in circuits at clean LVS results.

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

smunaut, 2025-04-11:
But what does the LVS report say ?
AFAIR KLayout won't necessarily match pin names, it'd just say that B1 of netlist = B2 of layout and vice-versa in the report ?

sergeiandreyev, 2025-04-11:
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

d-m-bailey, 2025-05-19:
@b10346 @sergeiandreyev This issue is currently being [discussed here](https://github.com/IHP-GmbH/IHP-Open-PDK/issues/484).

Most cases should be detectable with a rule modification. I think missing pins is currently undetectable, though.

FaragElsayed2, 2025-08-28:
To be covered in #644

Thread 448 (2025-04-11):

Unable to find definition of model (OSDI)

adarshvp123, 2025-04-11:
I am  trying to run osdi model on ngspiceshared. in a python container with proper .Bashrc and .spiceinit definitions. The OSDI files were compiled using openvaf and paths are given in .spiceinit.  But its showing unable to find the model definition. i am attaching the code below

```
`import os
import PySpice.Logging.Logging as Logging
logger = Logging.setup_logging()

from PySpice.Spice.Netlist import Circuit
from PySpice.Unit import u_V, u_ns
import matplotlib.pyplot as plt

PDK_ROOT = os.getenv('PDK_ROOT', '/wang/users/adavp/cluster_home/IHP-Open-PDK')
PDK = os.getenv('PDK', 'ihp-sg13g2')

model_path = os.path.join(PDK_ROOT, PDK, 'libs.tech', 'ngspice', 'models')
stdcell_path = os.path.join(PDK_ROOT, PDK, 'libs.ref', 'sg13g2_stdcell', 'spice')

circuit = Circuit('SG13G2 A21O Gate Test')

mos_model_file = os.path.join(model_path, 'cornerMOSlv.lib')
if os.path.exists(mos_model_file):
    circuit.lib(mos_model_file, 'mos_tt')
    print("Included MOS model library:", mos_model_file)
else:
    print("Warning: MOS model library not found at", mos_model_file)

spiceinit_file = os.path.expanduser('~/.spiceinit')
if os.path.exists(spiceinit_file):
    circuit.include(spiceinit_file)
    print("Included spiceinit file:", spiceinit_file)
else:
    print("Warning: spiceinit file not found at", spiceinit_file)

std_cell_file = os.path.join(stdcell_path, 'sg13g2_stdcell.spice')
if os.path.exists(std_cell_file):
    circuit.include(std_cell_file)
    print("Included standard cell file:", std_cell_file)
else:
    print("Warning: standard cell file not found at", std_cell_file)

circuit.V('vdd', 'VDD', circuit.gnd, 1.2 @ u_V)

circuit.PulseVoltageSource('A1', 'A1', circuit.gnd,
    initial_value=0 @ u_V, pulsed_value=1.2 @ u_V,
    delay_time=1 @ u_ns, rise_time=10 @ u_ns, fall_time=10 @ u_ns,
    pulse_width=2 @ u_ns, period=4 @ u_ns)

circuit.PulseVoltageSource('A2', 'A2', circuit.gnd,
    initial_value=0 @ u_V, pulsed_value=1.2 @ u_V,
    delay_time=2 @ u_ns, rise_time=10 @ u_ns, fall_time=10 @ u_ns,
    pulse_width=2 @ u_ns, period=4 @ u_ns)

circuit.PulseVoltageSource('B1', 'B1', circuit.gnd,
    initial_value=0 @ u_V, pulsed_value=1.2 @ u_V,
    delay_time=3 @ u_ns, rise_time=10 @ u_ns, fall_time=10 @ u_ns,
    pulse_width=2 @ u_ns, period=4 @ u_ns)

try:
    circuit.X('U1', 'sg13g2_a21o_1', 'A1', 'A2', 'B1', 'VDD', circuit.gnd, 'XOUT')
    print("Instantiated subcircuit: sg13g2_a21o_1")
except Exception as e:
    print("Error instantiating subcircuit sg13g2_a21o_1:", e)
    exit(1)

    analysis = circuit.simulator(temperature=25, nominal_temperature=25).transient(step_time=10 @ u_ns, end_time=10 @ u_ns)
except Exception as e:
    print("\n[ERROR] ngspice simulation failed:")
    print(e)
    print("\nNetlist:\n", circuit)
    exit(1)

plt.figure(figsize=(10, 6))
plt.plot(analysis.time, analysis.XOUT, label='XOUT')
plt.plot(analysis.time, analysis.A1, '--', label='A1')
plt.plot(analysis.time, analysis.A2, '--', label='A2')
plt.plot(analysis.time, analysis.B1, '--', label='B1')
plt.xlabel('Time [s]')
plt.ylabel('Voltage [V]')
plt.title('Transient Analysis of SG13G2 A21O Gate')
plt.grid()
plt.legend()
plt.tight_layout()
plt.show()
```

` I am getting following error log

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

KrzysztofHerman, 2025-04-11:
@adarshvp123

by default the osdi files should be placed in `$PDK_ROOT/$PDK/libs.tech/ngspice/osdi`
and the `.spiceinit` should be a symbolic link in your `$HOME` pointing to
`$PDK_ROOT/$PDK/libs.tech/ngspice/.spiceinit` .

adarshvp123, 2025-04-14:
Hii @KrzysztofHerman sorry for late response
I am still getting the error. I already linked spiceinit and followed the correct directory structure. I am attaching the .bashrc, .spiceinit , python code of test9.py and the error output i got.
I am running the code in the container.
import os
import PySpice.Logging.Logging as Logging
logger = Logging.setup_logging()

```
from PySpice.Spice.Netlist import Circuit
from PySpice.Unit import u_V, u_ns
import matplotlib.pyplot as plt

# Retrieve environment variables from the shell (ensure they are exported and your shell is the launching one)
PDK_ROOT = os.getenv('PDK_ROOT', '/wang/users/adavp/cluster_home/IHP-Open-PDK')
PDK = os.getenv('PDK', 'ihp-sg13g2')

# Set additional paths for model and subcircuit definitions (remove leading '/' so they join correctly)
#model_path   = os.path.join(PDK_ROOT, PDK, 'libs.tech/ngspice/models')
#stdcell_path = os.path.join(PDK_ROOT, PDK, 'libs.ref/sg13g2_stdcell/spice')
#print("Model path:", model_path)
#print("Stdcell path:", stdcell_path)
#osdi  $PDK_ROOT/$PDK/libs.tech/ngspice/osdi/psp103_nqs.osdi
#osdi  $PDK_ROOT/$PDK/libs.tech/ngspice/osdi/r3_cmc.osdi
# Create the circuit instance
circuit = Circuit('SG13G2 A21O Gate Test')
model_path = os.path.join(PDK_ROOT, PDK, 'libs.tech/ngspice/models')
circuit.lib(os.path.join(model_path, 'cornerMOSlv.lib'), 'mos_tt')
circuit.include(os.path.join(PDK_ROOT, PDK, 'libs.ref/sg13g2_stdcell/spice/sg13g2_stdcell.spice'))

# Explicitly include the custom spiceinit file so that ngspice loads
# the required source paths, simulation options, and subcircuits.
# Adjust the path if necessary; here we use a file in the home directory.
spiceinit_file = os.path.expanduser('~/.spiceinit')
circuit.include(spiceinit_file)

# Optionally, if needed, include a standard cell definition file manually.
# Uncomment the next line if it is not already included via the spiceinit file.
# circuit.include(os.path.join(stdcell_path, 'sg13g2_stdcell.spice'))

# Create the simulator instance (this launches an ngspice subprocess)
simulator = circuit.simulator(temperature=25, nominal_temperature=25)

# (Optional) Load OSDI models if you need to re-issue them manually.
# try:
#     simulator._ngspice_shared.exec_command('osdi psp103_nqs.osdi')
#     simulator._ngspice_shared.exec_command('osdi r3_cmc.osdi')
#     print("OSDI models loaded successfully.")
# except Exception as e:
#     print("Error loading OSDI models. Make sure libngspice has --with-osdi enabled.")
#     print(e)
#     exit(1)

# Add voltage sources to the circuit
circuit.V('vdd', 'VDD', circuit.gnd, 1.2 @ u_V)

circuit.PulseVoltageSource('A1', 'A1', circuit.gnd,
                            initial_value=0 @ u_V, pulsed_value=1.2 @ u_V,
                            delay_time=1 @ u_ns, rise_time=10 @ u_ns, fall_time=10 @ u_ns,
                            pulse_width=2 @ u_ns, period=4 @ u_ns)

circuit.PulseVoltageSource('A2', 'A2', circuit.gnd,
                            initial_value=0 @ u_V, pulsed_value=1.2 @ u_V,
                            delay_time=2 @ u_ns, rise_time=10 @ u_ns, fall_time=10 @ u_ns,
                            pulse_width=2 @ u_ns, period=4 @ u_ns)

circuit.PulseVoltageSource('B1', 'B1', circuit.gnd,
                            initial_value=0 @ u_V, pulsed_value=1.2 @ u_V,
                            delay_time=3 @ u_ns, rise_time=10 @ u_ns, fall_time=10 @ u_ns,
                            pulse_width=2 @ u_ns, period=4 @ u_ns)

# Instantiate the subcircuit.
# Ensure that 'sg13g2_a21o_1' is defined in one of the included files.
circuit.X('U1', 'sg13g2_a21o_1', 'A1', 'A2', 'B1', 'VDD', circuit.gnd, 'XOUT')

# Run a transient simulation
try:
    analysis = simulator.transient(step_time=10 @ u_ns, end_time=10 @ u_ns)
except Exception as e:
    print("\n[ERROR] ngspice simulation failed:")
    print(e)
    print("\nNetlist:\n")
    print(str(circuit))
    exit(1)

# Plot the simulation results
plt.figure(figsize=(10, 6))
plt.plot(analysis.time, analysis.XOUT, label='XOUT')
plt.plot(analysis.time, analysis.A1, '--', label='A1')
plt.plot(analysis.time, analysis.A2, '--', label='A2')
plt.plot(analysis.time, analysis.B1, '--', label='B1')
plt.xlabel('Time [s]')
plt.ylabel('Voltage [V]')
plt.title('Transient Analysis of SG13G2 A21O Gate')
plt.grid(True)
plt.legend()
plt.tight_layout()
plt.show()
```

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

KrzysztofHerman, 2025-04-14:
@adarshvp123

are you able to run the simulation using ngspice as a standalone binary ?
Also try the latest version of the ngspice.

adarshvp123, 2025-04-18:
Hii @KrzysztofHerman
I am able to simulate the standard cell. I am using pyspice 1.6+ngspice 42 by giving netlist as raw.

Thank you for the help.

A further question which tool you used for lib characterization of the standard cells?

sergeiandreyev, 2025-04-20:
> A further question which tool you used for lib characterization of the standard cells?

Hi @adarshvp123, we used internal proprietary tool

Kreijstal, 2025-04-23:
@adarshvp123 always try to use ngspice, pyspice is extremely buggy, you might just have to fork it to make things work...

KrzysztofHerman, 2025-04-25:
@adarshvp123
since you are capable to run the simulation using binary the problem is either in ngspice shared library or in the pyspice implementation.  You could report your case on the [ngspice bugtracker](https://sourceforge.net/p/ngspice/bugs/).  I guess you can close the issue if there are no further questions.

sergeiandreyev, 2025-05-09:
Hi @adarshvp123, any update on this?

Closed 2025-07-28.

Thread 454 (2025-04-16):

Feature request: D25 setup for KLayout

mole99, 2025-04-16:
KLayout has a built-in 2.5d view which allows you to view your circuit in semi-3d.

See here for more information: https://www.klayout.de/doc/about/25d_view.html

sky130 has a basic setup that could be used as a reference: https://github.com/efabless/sky130_klayout_pdk/blob/main/tech/sky130/d25/sky130.lyd25

For syk130 an entry was added to the quick access menu:

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

For a simple pmos the result looks like this:

|   |   |
|---|---|
| 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  |  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 |

A D25 setup for ihp-sg13g2 would be very useful for educational purposes.

KrzysztofHerman, 2025-04-16:
@mole99
We will do, it is a cool feature. Thank you for sharing the references.

EngGhaith, 2025-04-16:
Hi!
someone has already implemented that here:
https://gist.github.com/rslawson/fecc97d8731da95204ed59b00571582f

But I think you can add more layers and make it right to scale.

BW, Ghaith.

KrzysztofHerman, 2025-06-06:
@mole99 @EngGhaith here goes the implementation: PR #533. Could you please check it out and give some feedback ?

mole99, 2025-06-06:
The BEOL stack works fine on my end:

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

Thanks!

Closed 2025-06-08.

Thread 456 (2025-04-16):

Inductor PyCells not recognized by LVS

akrinke, 2025-04-16:
Inductor2/3 PyCells are currently not recognized by LVS. The PyCells create pins `LA`, `LB`, and `LC` on `TopMetal1.pin` and `TopMetal2.pin`. The LVS looks for pins on `IND.pin`. Creating copies of the pin rectangles on this layer solves the problem.

Maybe a regression test that performs LVS on a layout that contains PyCell instances can be added to the PDK.

sergeiandreyev, 2025-04-16:
Hi @akrinke, I confirm - we have a disconnect in the `inductor` device layout, this should be fixed on Pycell side. Thanks for finding!

sergeiandreyev, 2025-04-16:
we have LVS regression tests, but these were developed when we had only about half of the device Pycells available, so these tests are checking the device layouts from `sg13g2_pr`..

sergeiandreyev, 2025-05-17:
Hi @akrinke, I've fixed the `inductors` Pycells, could you please check if now they work on your side?

akrinke, 2025-08-06:
Yes, the `inductor2` and `inductor3` PyCells are now extracted correctly.

Closed 2025-08-06.

Thread 457 (2025-04-16):

Question about layouting rfcmim

EngGhaith, 2025-04-16:
Hi!
I have this cap:

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

First: I am allowed to flip the cap horizontally like that, or?
Second: Should I tie the contact TIE to substrate or it is already done automatically by the PCell?

Thank you very much.
Ghaith.

EngGhaith, 2025-04-17:
Another question:

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

Are we allowed to route something under the cap? (between Metal5 and the guard ring on metal 1)?
What are these layers Metalx.noqrc?

VolkerMuehlhaus, 2025-04-22:
I recommend to **rotate** 180° instead of flipping.
The pcell physically connects the ground frame to the substrate. In schematic, you need to connect that node to substrate.

Metalx.noqrc excludes the device area from parasitic extraction, because the circuit model already includes all parasitics.
To have a valid electrical model, you must **not** route other signals under the rfcmim.

KrzysztofHerman, 2025-04-25:
@EngGhaith
I confirm the recommendation of @VolkerMuehlhaus to rotate 180 deg.
I also confirm the second suggestion about the bulk node. You can use the `sub` symbol which, will annotate a global net sub! in the netlist. If you do not have further questions please close this issue.

Closed 2025-04-25.

Thread 459 (2025-04-22):

LVS Problem of two in series connected capacitor

EngGhaith, 2025-04-22:
Hi
I have two in series connected RFCMIMs and KLayout throws me this error

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

Why?
Layout:

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

Schematic:

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

BW, Ghaith.

olisnr, 2025-04-23:
may be there is a problem with an antenna-effect?

EngGhaith, 2025-04-23:
> may be there is a problem with an antenna-effect?

IDK ...
DRCs are clean...

akrinke, 2025-04-23:
The DRC does not currently check for antenna effects. I have no idea how an antenna effect could affect LVS since it shouldn't create an electrical connection.

olisnr, 2025-04-23:
@akrinke it could be, that big floating metal area get to big voltages in production for the MiM isolation. but i dont find any specification in the layout rules, therefore it was just an unfounded assumption...

akrinke, 2025-04-23:
@olisnr Yes, I agree – I just wouldn't expect it to have any effect on the LVS.

EngGhaith, 2025-04-23:
Update:
the problem is in the netlist simplify.
I have tried to unconnect the sub! to either both capsor one of them and LVS works (it says that the caps aren't match to netlist, but no RuntimeError).

Also it is in my opinion related to sub! connection.....

KrzysztofHerman, 2025-04-28:
@EngGhaith
could you please post both netlists.

Thread 461 (2025-04-24):

Question about maximum current in Rsil

EngGhaith, 2025-04-24:
Hi
In the docs there is no description, about how much current can Rsil drop.

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

It is only refers to 2.9, but 2.9 is for Rhigh. I think this reference is from an older version.....

It said limited by contacts, but in the layout there is always only one contact per pin, doesn't matter how long/wide is the resistor. Here is a screenshot from Klayout with w=5u/l=0.5u and w=0.5u/l=5u

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

Both resistors has only two contacts (one per pin)

Thank you in advance.
Ghaith.

KrzysztofHerman, 2025-04-25:
@EngGhaith
Thank you for reporting. We will update the documentation.
The value of max. current density is `1 mA/μm`

EngGhaith, 2025-04-25:
Thank you very much!
I think we could close this now ...

sergeiandreyev, 2025-04-25:
@EngGhaith, @KrzysztofHerman, I will prefer to have it opened until we update the documentation

Thread 463 (2025-04-26):

Questions about HBT Layout

EngGhaith, 2025-04-26:
Hi!
I found this section in the documentation and have some questions about that:

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

Let us take this transistor as example:

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

1. Rule says that we are only allowed to use metals in the TRANS region. Are vias also allowed?
2. Are not we allowed to route in red hatched region even for metal 2? or only metal 1?
3. Which of these connections between B and C (Yellow/Pink/Both) are allowed (Both yellow and pink are on Metal 1 layer)?
4. Are these bipolar rules existed in KLayout-DRC or not? i.e. If DRC is clean, should the design be OK or not?

Thank you in advance.
Ghaith.

KrzysztofHerman, 2025-04-28:
@EngGhaith
The purpose of the cited part of documentation is to prevent the users to modify the device especially the part related to the FEOL, what can affect the device resulting in a not working one. As for BEOL
1) Each metal shape will introduce parasitic effects. It will affect the performance but not kill the device itself. You can place vias
2) Routing on metal1 and metal2 is allowed, consider EM coupling an parasitic effects.
3) Both are allowed, just respect DRC's and keep in mind parasitic effects.
4) Reviewing the [missing rules](https://github.com/IHP-GmbH/IHP-Open-PDK/blob/dev/ihp-sg13g2/libs.tech/klayout/tech/drc/MissingRules_maximal.md) there is only one related to filler `Afil.e` however the filler generation scripts seem to respect it.

EngGhaith, 2025-04-29:
Thank you very much!

Closed 2025-04-29.

Thread 469 (2025-05-03):

question: why does LVS dont accept distributed rppd?

olisnr, 2025-05-03:
if i split an 7x2.5µm Rppd in two 3.5x2.5µm Rppd's, i get a LVS missmatch. with MOS-devices this wouldnt happen. so my question is: is this intended?

i tried with and without the LVS-option `Combine Devices`:

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

and got:

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

d-m-bailey, 2025-05-15:
@olisnr Looking at the code for combing resistors in `pdks/ihp-sg13g2/libs.tech/klayout/tech/lvs/rule_decks/custom_combiner.lvs`
```
class RESDeviceCombiner < RBA::GenericDeviceCombiner
  include DeviceCombinerMethods

  # Method to check and perform device combination
  def combine_devices(a, b)
    res_nets = [0, 1] # Using id instead of names

    # Check if same parameters

    # Check if terminals series or parallel (With same params)
    if supp_parallel(a, b, 0, 1)
      return false unless PARALLEL_RES
      return false unless %w[w l ps b].all? { |param| same_parameter(a, b, param) }

      a.set_parameter('m', a.parameter('m') + b.parameter('m'))
    elsif supp_series(a, b, 0, 1)
      return false unless SERIES_RES
      return false unless %w[w ps b m].all? { |param| same_parameter(a, b, param) }

      a.set_parameter('l', a.parameter('l') + b.parameter('l'))
    else
      return false
    end

    # Disconnect the second device and let the system clean it up
    res_nets.each { |term| b.disconnect_terminal(term) }

    true
  end
end
```
it appears that for parallel resistors with the same `w` and `l`, `m` values are summed.

If the final comparison is between `w * m` of the 2 devices, they should match, but if `w` and `m` are compared separately, they won't match. Unfortunately, I haven't been able to find the comparison logic.

olisnr, 2025-05-15:
@d-m-bailey yes, it seems that schematic and layout netlist are different handled for parallel resistors. i think it would be a better option to use **w** instead of **m** because if You draw a schematics with say `w=10u` and then make an layout with parallel `w=7u `and `w=3u` **m** wont work anyway...

olisnr, 2025-05-15:
are You also looking in parallel `cmim`?

d-m-bailey, 2025-05-15:
> @d-m-bailey yes, it seems that schematic and layout netlist are different handled for parallel resistors. i think it would be a better option to use w instead of m because if You draw a schematics with say w=10u and then make an layout with parallel w=7u and w=3u m wont work anyway...

I agree. I'm just not sure how to implement that in the current system. I was thinking that the initial input of the netlist could calculate the effective w = `w` * `m`, and then ignore m in the subsequent reductions and checks. It would be confusing though if the `m` parameter is listed and doesn't match.

Incidentally, the current rule will not combine devices with `w` values that don't match.

d-m-bailey, 2025-05-15:
> are You also looking in parallel cmim?

@olisnr The parallel cmim reduction look ok as far as I can see. It doesn't appear to attempt to combine series devices.
```
class MIMCAPNDeviceCombiner < RBA::GenericDeviceCombiner
  include DeviceCombinerMethods

  # Method to check and perform device combination
  def combine_devices(a, b)
    # Check if both devices have the same net
    return false unless same_net(a, b, 'mim_top') && same_net(a, b, 'mim_btm')

    # Check if parameters are the same
    return false unless same_parameter(a, b, 'w') && same_parameter(a, b, 'l')

    # Combine by summing up 'm' parameter
    a.set_parameter('m', a.parameter('m') + b.parameter('m'))

    # Disconnect the second device and let the system clean it up
    b.disconnect_terminal('mim_top')
    b.disconnect_terminal('mim_btm')

    # Disconnect mim_sub terminal if present and model name includes 'rfcmim'
    b.disconnect_terminal('mim_sub') if b.name.downcase.include?('rfcmim')

    true
  end
end
```

olisnr, 2025-05-15:
@d-m-bailey i would think it should allow both C's have the same `w` and the same `l`, but also `w` and `l` could be exchanged. there is no `W/L` its `W*L` the order dosnt matter.

and the real problem in the LVS comes from the CDL-simplification. here there is no `m` used but the `w` and the `l` are both multiplied instead of only the `w`.

d-m-bailey, 2025-05-15:
@olisnr From what I can understand of the rules for `cap_cmim`, `w` and `l` are not compared so the order doesn't matter. `A`, `P`, and `m` are compared. Where `A` and `P` are calculated as `w * l` and `2 * (w + l)` respectively.

So the current rules will not match equivalent capacitance areas. They will match only if `A`, `P`, and `m` are the same.

This is probably not what is generally expected.

olisnr, 2025-05-16:
@d-m-bailey i dont understand the code of `def combine_devices(a, b)`, but compairing A as area and P as length of the perimeter is what i would expect. this seems perfekt for me.

then only the reference calculation seems wrong. can You look into the handling of multiple devices on the schematic side?

d-m-bailey, 2025-05-16:
@olisnr The following is my understanding.
```
  def combine_devices(a, b)
    # Check if both devices have the same net
    return false unless same_net(a, b, 'mim_top') && same_net(a, b, 'mim_btm')
```
Do not combine the devices if the connections are not the same (ie, parallel).
```
    # Check if parameters are the same
    return false unless same_parameter(a, b, 'w') && same_parameter(a, b, 'l')
```
Do not combine devices if `w` and/or `l` are different.
```
    # Combine by summing up 'm' parameter
    a.set_parameter('m', a.parameter('m') + b.parameter('m'))
```
If devices are parallel and have the same `w` and `l`, sum the occurences.
```
    # Disconnect the second device and let the system clean it up
    b.disconnect_terminal('mim_top')
    b.disconnect_terminal('mim_btm')
```
Remove the second device.

The reference (source) calculation is in `pdks/ihp-sg13g2/libs.tech/klayout/tech/lvs/rule_decks/custom_reader.lvs`
```
class DeviceCustomMIM < RBA::DeviceClassCapacitor
  def initialize(name)
    # clear terminals and parameters of resistor class
    clear_parameters
    clear_terminals
    clear_equivalent_terminal_ids

    # Adding params
    add_parameter(RBA::DeviceParameterDefinition.new('w', 'width', 0, false))
    add_parameter(RBA::DeviceParameterDefinition.new('l', 'length', 0, false))
    add_parameter(RBA::DeviceParameterDefinition.new('A', 'area', 0, true))
    add_parameter(RBA::DeviceParameterDefinition.new('P', 'perimeter', 0, true))
    add_parameter(RBA::DeviceParameterDefinition.new('m', 'multiplier', 1, true))

    # Adding terminals
    ter1 = add_terminal(RBA::DeviceTerminalDefinition.new("mim_top"))
    ter2 = add_terminal(RBA::DeviceTerminalDefinition.new("mim_btm"))
    ter1.name = "mim_top"
    ter2.name = "mim_btm"

    # Adding extra param & terminal for rfcmim
    return unless name.downcase.include?('rfcmim')

    add_parameter(RBA::DeviceParameterDefinition.new('wfeed', 'feed width', 0, true))
    sub_ter = add_terminal(RBA::DeviceTerminalDefinition.new("mim_sub"))
    sub_ter.name = "mim_sub"
  end
end
```
My understanding is that `w` and `l` are input, but not compared (the final `false` parameter in `DeviceParameterDefinition` determines whether or not the parameter is compared.).
Parameters are mapped for each model type. For capacitors,
```
  def map_capacitor_params(device, model, params)
    device.set_parameter('w', (params['W'] || 0.0) * 1e6)
    device.set_parameter('l', (params['L'] || 0.0) * 1e6)
    device.set_parameter('m', params['M'] || params['MF'] || 1.0) if model.downcase.include?('cap_cmim')

    if model.downcase.include?('mim')
      device.set_parameter('A', (params['A'] || ((params['W'] || 0.0) * (params['L'] || 0.0))) * 1e12)
      device.set_parameter('P', (params['P'] || (((params['W'] || 0.0) + (params['L'] || 0.0)) * 2)) * 1e6)
    end
    return unless model.downcase.include?('rfcmim')

    device.set_parameter('wfeed', (params['WFEED'] || 0.0) * 1e6)
  end
```
So any time a device is created (extracted or read from source), the `A` and `P` parameters are calculated and `m` is initialized to 1 (for extracted devices) or the value in the source.

d-m-bailey, 2025-05-16:
As with resistors, I do not think that equivalent size checking is handled for `cap_cmim`.

olisnr, 2025-05-16:
if i see it correct, if the LVS script of the layout sees many parallel MOSFETs it calculates the new **w** it donsent make an **m** but for resistors it makes an **m**.
the LVS on the schematic side does calculate **m** for MOSFETs and resistors and for the capacitors (even if its done wrong in this case (**l** is also calculated instead of let what it is)).

may be iHP should decide what the correct way is and then the layout and schematic side should do the same.

d-m-bailey, 2025-05-17:
> im wondering why the schematic and layout simplifier/combiner codes doesnt do the same. are there two different programs? or is the same program useded with different parameter?

@olisnr The program that reads the netlist needs to translate the device parameters into a standardized format while the netlist extractor will always extract individual devices. I think the netlist initialization routine is where the difference is introduced.

FaragElsayed2, 2025-08-28:
@omarmahxii Could you please check this?

Thread 470 (2025-05-04):

fail to compile magic on fedora 42

coryTuyaoqing, 2025-05-04:
**Hi, i am trying to compile magic on fedora 42 and get this error:**

                  In file included from ../utils/tech.h:24,
                                   from ../utils/utils.h:28,
                                   from bpUtils.c:38:
                  ../utils/magic.h:88:23: error: ‘bool’ cannot be defined via ‘typedef’
                     88 | typedef unsigned char bool;
                        |                       ^~~~
                  ../utils/magic.h:88:23: note: ‘bool’ is a keyword with ‘-std=c23’ onwards
                  ../utils/magic.h:88:1: warning: useless type name in empty declaration
                     88 | typedef unsigned char bool;
                        | ^~~~~~~
                  In file included from ../utils/tech.h:24,
                                   from ../utils/utils.h:28,
                                   from bpEnum.c:38:
                  ../utils/magic.h:88:23: error: ‘bool’ cannot be defined via ‘typedef’
                     88 | typedef unsigned char bool;
                        |                       ^~~~
                  ../utils/magic.h:88:23: note: ‘bool’ is a keyword with ‘-std=c23’ onwards
                  ../utils/magic.h:88:1: warning: useless type name in empty declaration
                     88 | typedef unsigned char bool;
                        | ^~~~~~~
                  In file included from ../utils/tech.h:24,
                                   from ../utils/utils.h:28,
                                   from bpDump.c:37:
                  ../utils/magic.h:88:23: error: ‘bool’ cannot be defined via ‘typedef’
                     88 | typedef unsigned char bool;
                        |                       ^~~~
                  ../utils/magic.h:88:23: note: ‘bool’ is a keyword with ‘-std=c23’ onwards
                  ../utils/magic.h:88:1: warning: useless type name in empty declaration
                     88 | typedef unsigned char bool;
                        | ^~~~~~~
                  make[2]: *** [../rules.mak:25: bpUtils.o] Error 1
                  make[2]: *** Waiting for unfinished jobs....
                  make[2]: *** [../rules.mak:25: bpEnum.o] Error 1
                  make[2]: *** [../rules.mak:25: bpDump.o] Error 1
                  In file included from ../utils/tech.h:24,
                                   from ../utils/utils.h:28,
                                   from bpBins.c:39:
                  ../utils/magic.h:88:23: error: ‘bool’ cannot be defined via ‘typedef’
                     88 | typedef unsigned char bool;
                        |                       ^~~~
                  ../utils/magic.h:88:23: note: ‘bool’ is a keyword with ‘-std=c23’ onwards
                  ../utils/magic.h:88:1: warning: useless type name in empty declaration
                     88 | typedef unsigned char bool;
                        | ^~~~~~~
                  make[2]: *** [../rules.mak:25: bpBins.o] Error 1
                  make[2]: Leaving directory '/home/cory/Downloads/magic-8.3.526/bplane'
                  make[1]: *** [Makefile:52: modules] Error 1
                  make[1]: Leaving directory '/home/cory/Downloads/magic-8.3.526'
                  make: *** [Makefile:26: tcl] Error 2

**and when I try to used c11 or c99 standard to compile it, i got this error:**

                  CmdSubrs.c: In function ‘CmdIllegalChars’:
                  CmdSubrs.c:1231:14: error: implicit declaration of function ‘isascii’ [-Wimplicit-function-declaration]
                   1231 |         if (!isascii(*p)) goto error;
                        |              ^~~~~~~
                  make[2]: *** [../rules.mak:23: CmdSubrs.o] Error 1
                  make[2]: *** Waiting for unfinished jobs....
                  make[2]: Leaving directory '/home/cory/opensrc_eda/src/magic_src/commands'
                  make[1]: *** [Makefile:52: modules] Error 1
                  make[1]: Leaving directory '/home/cory/opensrc_eda/src/magic_src'
                  make: *** [Makefile:26: tcl] Error 2

Closed 2025-05-04.

Thread 471 (2025-05-04):

Metal slits are not rightly recognized in the DRC/LVS

EngGhaith, 2025-05-04:
Hi
I have this simple test case, and it seems that LVS is not working correctly:
KLayout:

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

Xschem:

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

The LVS should throw an error, because the bottom plate of MIM on M5 should not be connected to the label on the left side of the slit.
However LVS is clean:

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

That means that the slit is not really excluded from M5 during LVS check.

Another example for DRC:

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

Slit is not recognized and therefore an error M3.b is thrown.

Files are here:

[TEST_SLIT.zip](https://github.com/user-attachments/files/20026902/TEST_SLIT.zip)

Thank you very much.
Ghaith.

akrinke, 2025-05-08:
Most Slit rules are supported by the DRC. The metal rules (such as `M3.b`) only look at the metal shapes and not the slit shapes. So you should fix the M3 violation underneath the slit shape.

EngGhaith, 2025-05-08:
@akrinke
But Metal3.slit means, that there would not be Metal3 in the slit area.
Also there would not be any M3.b violation.

And LVS should throw error, because the slit would disconnect the bottom shhet of MIM from the net label/pin.

Also there is a strange behaviour here.

akrinke, 2025-05-08:
I understand the confusion. So we should subtract Metal3.slit before checking `M3.b`. @sergeiandreyev, @KrzysztofHerman What do you think?

sergeiandreyev, 2025-05-08:
Hi @akrinke, @EngGhaith, I'm checking on the internal PDK right now..

sergeiandreyev, 2025-05-08:
The behavior in commercial PDK/tools is the same (`M3.b` is flagged), so we're going to start an internal discussion on this

sergeiandreyev, 2025-05-08:
Yes, on the LVS testcase, I confirm, there should be Connectivity mismatch violation

sergeiandreyev, 2025-05-12:
> I understand the confusion. So we should subtract Metal3.slit before checking `M3.b`. [@sergeiandreyev](https://github.com/sergeiandreyev), [@KrzysztofHerman](https://github.com/KrzysztofHerman) What do you think?

Hi @akrinke, yes, we've got confirmation from technology perspective - there has to be no `M3.b` violation in this case - so the rules should be updated

EngGhaith, 2025-05-12:
@sergeiandreyev
Could you please tell us the branch or PR, which we have to checkout, to get the new DRC/LVS?

EngGhaith, 2025-05-12:
@sergeiandreyev

No problem.
You can open a PR for this specific topic, then we could subscribe that PR to know when you merge it to dev/main.

akrinke, 2025-06-10:
I have updated the DRC scripts in PR #538.

FaragElsayed2, 2025-08-28:
@omarmahXii Could you please take a look here?

FaragElsayed2, 2025-08-28:
Hi @EngGhaith

I'm not sure what is the issue in LVS for that case?

The Metal.Slit is excluded from the drawing metal layers as shown here, there is no connections between parts.

But the LVS should be passed as expected.

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

Thread 473 (2025-05-05):

Poly resistor contact resistance modelling.

christoph-weiser, 2025-05-05:
# Poly resistor contact resistance modelling

## Issue

The poly resistor models include incorrect modelling for contact resistance.

## Affected Models

- Rsil
- Rhigh
- Rppd

## Issue Details

Here is an extract with relevant lines from the rppd model in "resistors\_mod.lib"

```
.subckt rppd 1 3
.param w=0.5e-6 l=0.5e-6 b=0 ps=0.18e-6 trise=0 m=1 sw_et=0
[..]
+rzspec=35e-6
+res_rzspec=2*rzspec/w
+rz=rzspec/w-(postsim>0)*rqrc/w
[..]

NR1 1 0 2 dt res_rppd L=leff W=weff m=m
+a1=a a2=a
+p1=p p2=p
+c1=1 c2=1
+trise=trise
+sw_et=sw_et

R2 2 3 R=res_rzspec TC1=-950e-6 m=m

.model res_rppd r3_cmc
[..]
+rc=rz
[..]
.ends rppd
```

It appears that the model is build from two components.
A simple spice resistive element and the r3\_cmc compact model.

```
1   NR1   2    R2   3
x--vvvvv--x--vvvvv--x
     |
     0
```

The contact resistance at one end of the resistor is modelled using the spice resistor R2.

```
R2 2 3 R=res_rzspec TC1=-950e-6 m=1
```

the parameter res_rzspec that gives the resistance to the model is simply given by:
```
rzspec=35e-6
res_rzspec=2*rzspec/w
```

There is also modelling for contact resistance in NR1.
the parameter c1 (contacts at node n1 terminal) is set to 1.
the same is true for c2 (contacts at node n2 terminal).
and rc (resistance per contact) is set to rz.
```
rz=rzspec/w-(postsim>0)*rqrc/w
```

There appears to be two seperate issues:

1.  The resistor is not symetrical so it is not irrelevant which
    way the resistor is placed when analyzing the impact of
    parasitic capacitance to node 0.
2.  The contact resistance is accounting for both ends of the resistor hence the
    multiplication by 2 in res_rzspec. But there is also contact resistance
    modelled in the cmc model.

## Verification in Simulation

From the datasheet attached to the PDK we have the following information

- RCRPPD = 35ohm\*um
- RSRPPD = 260ohm

Hence a resistor with w=1e-6 and l=1e-6 should simply have a total
resistance of:
```
R = 2*RCRPPD/w + 1*RCRPPD*(l/w) = 330 ohm
```
This assumes athat the parameter RCRPPD is required twice one for each side
of the resistor.

### Simulation netlist

```
.lib cornerRES.lib res_typ
.temp 27

vdd vdd 0 1
vss vss 0 0

XR1 vdd vss rppd w=1e-6 l=1e-6

.control
op
let i = abs(vdd#branch)
let r = vdd/i
print r
exit
.endc
.end
```

### Simulation result

with w=1e-6 and l=1e-6 we get: r=397.01

which is 67 ohm to high, roughly 2*RCRPPD.

dwarning, 2025-05-05:
I can confirm there is something wrong with the subckt model.

But I got slightly different (wrong) results with the shown test case above:
This for complete model
r = 4.009050e+02

Commented out the contact resistance R2 (only the r3 model is used)
r = 3.309359e+02

Commented out the poly res NR1 (only the contact res is between the nodes 1 3:
r = 7.000000e+01

Setting c1 and c2 to 0 (switch off r3 internal cont. res. calc.)
r = 3.309360e+02

So in the end we see that contact resistance is counted twice - by r3 model and R2 instance. That is the case for all poly res subckt models.

The models are transferred from other PDK lib 1:1 and seems never compared to spec.
I will provide an PR after further investigations.

christoph-weiser, 2025-05-05:
Thanks for checking it!
Note that i just created a pull request with some changes regarding this issue. #476

sergeiandreyev, 2025-05-09:
Hi @christoph-weiser, this issue should be fixed in #481

Closed 2025-05-09.

Thread 474 (2025-05-05):

AttributeError: 'SimplePolygon' object has no attribute 'to_simple_polygon' when running pytest_cell.py

threaddy, 2025-05-05:
When running klayout -zz -r pycell_test.py, as indicated in pycell_test.py, several errors happen:

 ```
klayout -zz -r pycell_test.py
Import is done
 Module klayout_pyxs.pyxs_lib.py reloaded
ERROR: /root/.klayout/salt/klayout_pyxs/python/klayout_pyxs/pyxs_lib.py:958: NameError: name 'Application' is not defined
  /root/.klayout/salt/klayout_pyxs/python/klayout_pyxs/pyxs_lib.py:958
  /root/.klayout/salt/klayout_pyxs/pymacros/pyxs.lym:19 (class NameError)
ERROR: /root/.klayout/salt/klayout_pyxs/python/klayout_pyxs/pyxs_lib.py:958: NameError: name 'Application' is not defined
  /root/.klayout/salt/klayout_pyxs/python/klayout_pyxs/pyxs_lib.py:958
  /root/.klayout/salt/klayout_pyxs/pymacros/pyxs_dev.lym:17 (class NameError)
ERROR: /root/.klayout/salt/klive/klayout/pymacros/klive.lym:8: AttributeError: 'NoneType' object has no attribute 'menu'
  /root/.klayout/salt/klive/klayout/pymacros/klive.lym:8 (class AttributeError)
Warning: Box.destroy: already destroyed!
Warning: Box.destroy: already destroyed!
Warning: Box.destroy: already destroyed!
Warning: Box.destroy: already destroyed!
Warning: Box.destroy: already destroyed!
Warning: Box.destroy: already destroyed!
Warning: Box.destroy: already destroyed!
Warning: Box.destroy: already destroyed!
Warning: Box.destroy: already destroyed!
Warning: Box.destroy: already destroyed!
Warning: Box.destroy: already destroyed!
Warning: Box.destroy: already destroyed!
Warning: Box.destroy: already destroyed!
Warning: Box.destroy: already destroyed!
Warning: Box.destroy: already destroyed!
Warning: Box.destroy: already destroyed!
Warning: Box.destroy: already destroyed!
Warning: Box.destroy: already destroyed!
 ERROR: Traceback (most recent call last):
   File "/opt/pdk/IHP-Open-PDK/ihp-sg13g2/libs.tech/klayout/tech/pymacros/../../python/pycell4klayout-api/source/python/cni/dlo.py", line 225, in produce
     self._impl.genLayout()
   File "/opt/pdk/IHP-Open-PDK/ihp-sg13g2/libs.tech/klayout/tech/pymacros/../../python/sg13g2_pycell_lib/ihp/sealring_code.py", line 152, in genLayout
     ihpCopyFig(groupId, Point(l, w), 'R180')
   File "/opt/pdk/IHP-Open-PDK/ihp-sg13g2/libs.tech/klayout/tech/pymacros/../../python/sg13g2_pycell_lib/ihp/geometry.py", line 1186, in ihpCopyFig
     cons(newList, dbCopyShape(item, pnt, rot))
   File "/opt/pdk/IHP-Open-PDK/ihp-sg13g2/libs.tech/klayout/tech/pymacros/../../python/sg13g2_pycell_lib/ihp/geometry.py", line 187, in dbCopyShape
     dbMoveFig(copyId, pnt, rot)
   File "/opt/pdk/IHP-Open-PDK/ihp-sg13g2/libs.tech/klayout/tech/pymacros/../../python/sg13g2_pycell_lib/ihp/geometry.py", line 199, in dbMoveFig
     fig.moveBy(pnt.x, pnt.y)
   File "/opt/pdk/IHP-Open-PDK/ihp-sg13g2/libs.tech/klayout/tech/pymacros/../../python/pycell4klayout-api/source/python/cni/polygon.py", line 75, in moveBy
     dataBaseUnits).to_simple_polygon().to_dtype(Tech.get(Tech.techInUse).dataBaseUnits)
 AttributeError: 'SimplePolygon' object has no attribute 'to_simple_polygon'
 ERROR: Traceback (most recent call last):
   File "/opt/pdk/IHP-Open-PDK/ihp-sg13g2/libs.tech/klayout/tech/pymacros/../../python/pycell4klayout-api/source/python/cni/dlo.py", line 225, in produce
     self._impl.genLayout()
   File "/opt/pdk/IHP-Open-PDK/ihp-sg13g2/libs.tech/klayout/tech/pymacros/../../python/sg13g2_pycell_lib/ihp/npn13G2L_code.py", line 198, in genLayout
     groupId = ihpCopyFig(groupId, Point(2.8, 0), 'R0')
   File "/opt/pdk/IHP-Open-PDK/ihp-sg13g2/libs.tech/klayout/tech/pymacros/../../python/sg13g2_pycell_lib/ihp/geometry.py", line 1186, in ihpCopyFig
     cons(newList, dbCopyShape(item, pnt, rot))
   File "/opt/pdk/IHP-Open-PDK/ihp-sg13g2/libs.tech/klayout/tech/pymacros/../../python/sg13g2_pycell_lib/ihp/geometry.py", line 187, in dbCopyShape
     dbMoveFig(copyId, pnt, rot)
   File "/opt/pdk/IHP-Open-PDK/ihp-sg13g2/libs.tech/klayout/tech/pymacros/../../python/sg13g2_pycell_lib/ihp/geometry.py", line 199, in dbMoveFig
     fig.moveBy(pnt.x, pnt.y)
   File "/opt/pdk/IHP-Open-PDK/ihp-sg13g2/libs.tech/klayout/tech/pymacros/../../python/pycell4klayout-api/source/python/cni/polygon.py", line 75, in moveBy
     dataBaseUnits).to_simple_polygon().to_dtype(Tech.get(Tech.techInUse).dataBaseUnits)
 AttributeError: 'SimplePolygon' object has no attribute 'to_simple_polygon'
 ERROR: Traceback (most recent call last):
   File "/opt/pdk/IHP-Open-PDK/ihp-sg13g2/libs.tech/klayout/tech/pymacros/../../python/pycell4klayout-api/source/python/cni/dlo.py", line 225, in produce
     self._impl.genLayout()
   File "/opt/pdk/IHP-Open-PDK/ihp-sg13g2/libs.tech/klayout/tech/pymacros/../../python/sg13g2_pycell_lib/ihp/npn13G2V_code.py", line 250, in genLayout
     groupId = ihpCopyFig(groupId, Point(2.34, 0), 'R0')
   File "/opt/pdk/IHP-Open-PDK/ihp-sg13g2/libs.tech/klayout/tech/pymacros/../../python/sg13g2_pycell_lib/ihp/geometry.py", line 1186, in ihpCopyFig
     cons(newList, dbCopyShape(item, pnt, rot))
   File "/opt/pdk/IHP-Open-PDK/ihp-sg13g2/libs.tech/klayout/tech/pymacros/../../python/sg13g2_pycell_lib/ihp/geometry.py", line 187, in dbCopyShape
     dbMoveFig(copyId, pnt, rot)
   File "/opt/pdk/IHP-Open-PDK/ihp-sg13g2/libs.tech/klayout/tech/pymacros/../../python/sg13g2_pycell_lib/ihp/geometry.py", line 199, in dbMoveFig
     fig.moveBy(pnt.x, pnt.y)
   File "/opt/pdk/IHP-Open-PDK/ihp-sg13g2/libs.tech/klayout/tech/pymacros/../../python/pycell4klayout-api/source/python/cni/polygon.py", line 75, in moveBy
     dataBaseUnits).to_simple_polygon().to_dtype(Tech.get(Tech.techInUse).dataBaseUnits)
 AttributeError: 'SimplePolygon' object has no attribute 'to_simple_polygon'
```

 The last error can be fixed by removing 'to_simple_polygon()' in 'ihp-sg13g2/libs.tech/klayout/python/pycell4klayout-api/source/python/cni/polygon.py' to this:
```
def moveBy(self, dx: float, dy: float) -> None:
        movedPolygon = (pya.DTrans(float(dx), float(dy)) * self._polygon).to_itype(Tech.get(Tech.techInUse).
            dataBaseUnits).to_dtype(Tech.get(Tech.techInUse).dataBaseUnits)
        shape = Shape.getCell().shapes(self._shape.layer).insert(movedPolygon)
        self.destroy()
        self._polygon = movedPolygon
        self.set_shape(shape)
        self.addShape()

```
That seems to fix the generated .gds, but not sure if it breaks anything else.

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

Thread 475 (2025-05-05):

LVS and TLines

EngGhaith, 2025-05-05:
Hi
Is there any way to check TLines with LVS?
Or they should be shorted in the schematic before Netlist generation?

Thank you in advance.
Ghaith.

d-m-bailey, 2025-05-15:
@EngGhaith If you are using xschem, you can set `lvs_ignore=short` as a property on the devices (TLines, ammeters, etc.) that  you want the netlister to connect. You do not need to create a separate netlist.

I've fond that handling inductors in lvs can be tricky. I generally have to use some type of recognition layer or abstracted cell.

EngGhaith, 2025-05-15:
> [@EngGhaith](https://github.com/EngGhaith) If you are using xschem, you can set `lvs_ignore=short` as a property on the devices (TLines, ammeters, etc.) that you want the netlister to connect. You do not need to create a separate netlist.
>
> I've fond that handling inductors in lvs can be tricky. I generally have to use some type of recognition layer or abstracted cell.

@d-m-bailey
Could you explain more about inductors?
Do you have any example (Xschem and Layout)

d-m-bailey, 2025-05-15:
@EngGhaith Unfortunately, I haven't done anything with inductors in the iHP process yet. For the sky130 process, there were designs that had a layout cell that contained one inductor. The cell name was the name of the inductor model. The cell had ports that matched the inductor port names. I added a virtual metal resistor to allow the terminals to be extracted without shorting. Abstracting the cell effectively resulted in a inductor in the extracted netlist that could be matched to a similarly named inductor subcircuit in the source netlist.

d-m-bailey, 2025-07-02:
@EngGhaith If I understand correctly, you might be able to use metal resistors to logically separate the TLines from the connecting nets in LVS. For simulation, how are you modeling TLines?

Here's a layout where I added topmetal2 resistor to separate the connections to ground.

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

EngGhaith, 2025-07-02:
I am using the xyce ytransline model.
It is an RLC model of T-Line. I have designed a symbol for that.

But Topmetal2 resistor is nice idea.
I should then replace the T-Lines in schematic with resistors, or?

d-m-bailey, 2025-07-02:
@EngGhaith I don't think you need to replace the T-Line symbols. Just add an `lvs_ignore=short` property. If you add the `topmetal2` resistors, you can probably keep those in the simulation schematic because their resistance is negligible.

EngGhaith, 2025-07-03:
@sergeiandreyev
@KrzysztofHerman

And If I want to replace my T-Line within proper Metal/TopMetal resistor, then there is no symbol for that in xschem.
I would be very happy if you could produce such a symbol with following specs:

- Name of symbol: Rmet
- L as a parameter
- W as a parameter
- Layer as a parameter, which accept only following strings: [ 'M1', 'M2', 'M3', 'M4', 'M5', 'TM1', 'TM2']
- R value should be calculated automatically

If there is also a way to implement something like: `lvs_ignore=Rmet(L=1u,W=5u,Layer='TM1')`, then you can refer the designer to this solution to overcome a T-Line in the LVS.

This solution would be very satisfying for easy T-Lines (only a rectangular T-Line), because the designer can give the dimensions of that T-Line and the LVS would check the T-Line dimesions. If the designer want then to implement a complicated T.Line (e.g. with 90-degree bends, round bends or mitered bends), then he has split his T-Lines in schematics to multiple resistors and model each rectangular part as an Rmet. The bend could then be left as a "short" from LVS-view.

See this example of complex T-Line:

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

Such a T-Line with mitered bend could then modeled of a combination of 2 in series metal resistors: Rmet1 + Rmet2
Rmet1: L=70u, W=8u, Layer='TM2'
Rmet2: L=40u, W=8u, Layer='TM2'
The benefit here is that LVS-Check would check the length and width of my T-Line also.

You can go a further step of luxury if you make an gds to xschem extractor for T-Lines. Also I draw a T-Line in KLayout and give it maybe to a python script. This script would divide the polygon (it should be only one merged polygon) to rectangular sectors and each sector would be then modeled as an Rmet. A net list of several Rmet in series would be generated. If you introduce T-Line-Symbol (you can also modify the one from the attachment above), then the output of that script is a **one single xschem symbol** which has integrated netlist of the drawn T-Line.

See this tutorial for integrating netlist in a symbol:
https://xschem.sourceforge.io/stefan/xschem_man/tutorial_use_existing_subckt.html

I am concretly speaking about option 3:

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

Because you would have then **ONLY** one file, which is the generated xschem symbol.

Thread 482 (2025-05-09):

Typo in netgen setup file.

d-m-bailey, 2025-05-09:
```
#-------------------------------------------
# capacitors
# MiM capacitors
#-------------------------------------------

set devices {}
lappend devices cap_cmim
lappend devices cap_rfcmim

foreach dev $devices {
    if {[lsearch $cells1 $dev] >= 0} {
        property "-circuit1 $dev" parallel enable
        property "-circuit1 $dev" parallel {l critical}
        property "-circuit1 $dev" parallel {w add}
        property "-circuit1 $dev" tolerance {w 0.01} {l 0.01}
        # Ignore these properties
        property "-circuit1 $dev" delete ic
    }
    if {[lsearch $cells2 $dev] >= 0} {
        property "-circuit1 $dev" parallel enable
        property "-circuit1 $dev" parallel {l critical}
        property "-circuit1 $dev" parallel {w add}
        property "-circuit1 $dev" tolerance {w 0.01} {l 0.01}
        # Ignore these properties
        property "-circuit2 $dev" delete ic
    }
}
```

The second `if` statement should use `-circuit2` instead of `-circuit1`.

The previous block for `dantenna` has the same typo too.

d-m-bailey, 2025-05-15:
Fixed by #483

Closed 2025-05-15.

Thread 484 (2025-05-10):

LVS sees wrong placed net-label but thinks it dosent matter...

olisnr, 2025-05-10:
i have a miss placed label:

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

and LVS sees it, but shows all in the greenest green possible:

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

the files:

[LVS_WTF1.zip](https://github.com/user-attachments/files/20138855/LVS_WTF1.zip)

i use KLayout o.29.12 and the PDKs DEV branch

d-m-bailey, 2025-05-15:
@olisnr Can you verify that there is only one `in_p` text in the layout?

olisnr, 2025-05-15:
@d-m-bailey Yes.
there is one off `in_p` `in_n` `out_p` `out_n` `VDD` `VSS` and only `in_p` is wrong placed. the rest of the circuit is ok

d-m-bailey, 2025-05-15:
@klayoutmatthias does klayout snap text to layers?

klayoutmatthias, 2025-05-16:
Hi @d-m-bailey,

No KLayout should not snap. But maybe the label is attached to some derived layer that looks different? Or there is a second label somewhere else?

Matthias

olisnr, 2025-05-16:
its a thing from the PDK there are metal-layers for drawing and others for filling, labeling and so on. the idea is: if there is some shape on a *.drawing layer and a text on the corresponding *.text layer inside this shape, the shape gets the net-label.

this labels are used to tell the LVS what name a net or pin has.

d-m-bailey, 2025-05-16:
@klayoutmatthias thanks for commenting.

@olisnr can you check the metal1/pin layer? It may be that the text is over the pin layer and that the pin layer touches the drawing layer. This was a problem in sky130, so they added an extra check to flag pins without drawing layers. Maybe a similar DRC rule could be added to the klayout deck.

olisnr, 2025-05-16:
@d-m-bailey no, there is nothing on the Metal3.pin layer. the only layers of Metal3 that are used are: .via .drawing & .text

d-m-bailey, 2025-05-16:
@olisnr The layout displayed is `DiV_HBT_CMiM_100R.gds` but the LVS results are for `HBT_DiV_1024_14_lvs.gds`. Is `in_p` floating in `HBT_DiV_1024_14_lvs.gds` also?

olisnr, 2025-05-16:
@d-m-bailey yes.
i send You a corrected and a defect .GDS & the schematic .CDL so You can try it:

[off_text.zip](https://github.com/user-attachments/files/20260135/off_text.zip)

d-m-bailey, 2025-05-17:
@olisnr I have verified that LVS passes even if the text is floating. Thanks for the sample data!

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

@klayoutmatthias using the data in the `off_text.zip `file above, I executed the 2 following commands using the ihp pdk lvs rule files.
```
python3 $PDK_ROOT/$PDK/libs.tech/klayout/tech/lvs/run_lvs.py --layout=HBT_DiV_1024_14.gds \
  --netlist=DiV_HBT_CMiM_100R.spice \
  --run_dir=ok \
  --topcell=DiV_HBT_CMiM_100R \
  --run_mode=deep \
  --spice_comments \
  --no_simplify \
  --combine_devices \
  --top_lvl_pins

python3 $PDK_ROOT/$PDK/libs.tech/klayout/tech/lvs/run_lvs.py --layout=HBT_DiV_1024_14_in_p__off.gds \
  --netlist=DiV_HBT_CMiM_100R.spice \
  --run_dir=ng \
  --topcell=DiV_HBT_CMiM_100R \
  --run_mode=deep \
  --spice_comments \
  --no_simplify \
  --combine_devices \
  --top_lvl_pins
```
The `top_lvl_pins` flag does this
```
netlist.make_top_level_pins if TOP_LVL_PINS
schematic.make_top_level_pins if TOP_LVL_PINS
```
Which turns all top level text into pins, right?

Here's the difference between the extracted layouts. (Note that in the sample data given, `in_n` is floating, not `in_p`).
```
% diff ok/HBT_DiV_1024_14_extracted.cir ng/HBT_DiV_1024_14_in_p__off_extracted.cir
7d6
< * pin in_n
10c9
< .SUBCKT DiV_HBT_CMiM_100R VSS in_p VDD in_n out_n out_p
---
> .SUBCKT DiV_HBT_CMiM_100R VSS in_p VDD out_n out_p
33c32
< Q$11 \$22 in_n \$26 VSS npn13G2 AE=0.063p PE=1.94u AB=6.6795p PB=11.92u
---
> Q$11 \$22 \$16 \$26 VSS npn13G2 AE=0.063p PE=1.94u AB=6.6795p PB=11.92u
48c47
< Q$16 \$10 in_n \$25 VSS npn13G2 AE=0.063p PE=1.94u AB=6.6795p PB=11.92u
---
> Q$16 \$10 \$16 \$25 VSS npn13G2 AE=0.063p PE=1.94u AB=6.6795p PB=11.92u
```

So 2 questions.
1. During extraction, is there a way to flag text that does not overlap a connectivity layer?
2. Is there a way to flag missing ports in LVS?

klayoutmatthias, 2025-05-18:
I think I see what's the point.

I guess that the problem is that stray texts generate floating nets, but usually they are ignored. But assume they are turned into top level pins - which is an actual use case, when you have cell abstracts. Those are cells with ports only, but no internals.

So basically it's kind of hard to differentiate whether that is an error or not.

Regarding your questions:

1. Not in LVS, but in DRC

A boolean NOT between labels and polygons gives you the labels that are not on a polygon:

```
report("Labels without polygons")

l1_labels = labels(1, 0)
l1_geo = polygons(1, 0)
l2_geo = polygons(2, 0)

(l1_labels - l1_geo).output("L1 labels not on polygons on L1")
(l1_labels - l2_geo).output("L1 labels not on polygons on L2")
```

2. Such a check is conceptually difficult for a number of reasons. First, not all netlists define top level pins (e.g. SPICE without a top subcircuit). Second, the definition of a top level pin in layout is quite agnostic. Currently, LVS does not have the concept of a pin shape built in. Everything that is labelled on top level becomes a pin. This includes labels for internal nets.

Eventually, "top level pins" are not really hard facts and consequently they are not checked. In general, pins are not designed in. They rather come into existence, once you make a connection to a cell. For subcells they are checked of course, because you may have made a connection that is not intended. But for top level cells, there is no such fail mode and correspondingly top level pins are not considered in the compare step.

So bottom line is: to implement top level pin checking, first some pin concept has to be introduced. We may need such a concept in the course of PEX anyway, so there is some chance this will be done.

Matthias

d-m-bailey, 2025-05-18:
@klayoutmatthias thanks so much for the detailed analysis. I can see there is currently no solution that would cover all use cases.

I believe Calibre LVS has a directive - something like `LVS CHECK PORTS YES` - that enables a strict checking of ports. I don't know if something similar would be easy to implement in Klayout or not.

I tried running LVS with the ports switched and it passed (which wasn't expected).

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

How easy do you think it would it be for a end user to post process the `lvsdb` file to check for mismatches?
Looks like the `P` lines are pins and the offsets in the matching `Z` section are relative to the respective `J` and `H` sections. So maybe the user could specify a top level and have a script that checks that the matching ports are actually the same.

klayoutmatthias, 2025-05-18:
Hi @d-m-bailey,

The idea of KLayout is to provide the bits and pieces and a programming language to combine them into the solution you want to have.

By default, LVS is net name agnostic - it will use net names as hints for evaluation shortcuts, but does not require net names to match or the nets to be labelled. In my opinion that is an advantage because it allows LVS in cases where there are not net names or net name matching is not given.

But it does not mean you cannot require equivalence of identically named nets in LVS. The key is the `same_net!` function (with an exclamation mark). Give a circuit and a net name, LVS will check if the net with the given name from layout and schematic match exactly.

So coming back to the "bits and pieces" idea, you can code the "require top level pins to be present both in layout and schematic in the same way" using a few lines of code:

```
top_circuit = schematic.top_circuit
top_circuit.each_net do |n|
  if n.pin_count > 0
    same_nets!(top_circuit.name, n.name)
  end
end
```

When there is no label in the layout, there is no error, if a matching net can be found attached to the pin. LVS will only know that something is connected to the pin with the right topology, so electrically, things are fine. But if you have no labels in the layout, it cannot tell whether you have mislabeled something.

Matthias

d-m-bailey, 2025-05-18:
@klayoutmatthias Amazing explanation. Totally makes sense.

We'll suggest that the iHP pdk includes your solution.

d-m-bailey, 2025-05-19:
@olisnr This may be something that we add to the iHP verification flow as it may not be easily implemented in Klayout.

Here's a short script, `port_check`, that I made to parse the `lvsdb` database to show ports that don't match.
```
#! /usr/bin/env bash

# Script to check port name matches in klayout lvsdb file

# Usage: port_check <lvsdb-file>

# Output: Mismatched ports in the format: layout_port source_port

# 1. Change unknown ports "()" in the lvsdb to "?".
# 2,3. Add space after "(" and before ")" to allow field parsing.
sed -e 's/()/?/g' -e 's/(/( /g' -e 's/)/ )/g' $1 |
        awk '
BEGIN {
        delete source;
        delete layout;
}
/^J/ { # Process layout
        while( ! /^ )/ ) { # until end of definition
                if ( /^ *P/ ) {
                        # Save port name at port order
                        layout[length(layout)] = $4;
                }
                getline;
        }
        layout["?"] = "?"; # Add entry for unknown ports
}
/^H/ { # Process source
        while( ! /^ )/ ) { # until end of definition
                if ( /^ *P/ ) {
                        # Save port name at port order
                        source[length(source)] = $4;
                }
                getline;
        }
        source["?"] = "?"; # Add entry for unknown ports
}
/^ *P/ && toupper(layout[$2]) != toupper(source[$3]) { # Case insensitive port comparison.
        # Ports are cross-referenced by respective port order.
        print layout[$2], source[$3];
}
'
```
And here are the results. Note that Klayout LVS passes for all these cases.
For the case where `in_n` was correctly placed.
```
% ./port_check ok/HBT_DiV_1024_14.lvsdb 
out_n OUT_P
out_p OUT_N
```
For the case where `in_n` was not over metal.
```
% ./port_check ng/HBT_DiV_1024_14_in_p__off.lvsdb
? IN_N
out_n OUT_P
out_p OUT_N
```
For the case where `in_n` and `in_p` were switched.
```
% ./port_check switch/HBT_DiV_1024_14.lvsdb
in_n IN_P
in_p IN_N
out_n OUT_P
out_p OUT_N
```

klayoutmatthias, 2025-05-19:
I strongly discourage parsing the file. The format is internal and may change in the future.

klayoutmatthias, 2025-05-19:
In the above example, you mean that "DiV_HBT_CMiM_100R" is a subcicuit, not the top level circuit?

Port checking in subcircuits is not really important - if you have misspelled a port label, but connected it properly, the topology is correct. That is all that matters. Port checking makes sense on top circuits.

If "DiV_HBT_CMiM_100R" is the top circuit, why hard coding it? You have the name.

Regarding the case sensitivity - if you have SPICE input, net names should not be case sensitive.

Where can I find the test case?

Matthias

olisnr, 2025-05-19:
@klayoutmatthias the test case:

[LVS_WTF1.zip](https://github.com/user-attachments/files/20280896/LVS_WTF1.zip)

You are right if the connections are correct, then the circuit is ok.

but labels are a hint for me. if they aren't correct, they will cause only problems. i do some cells, and check it via LVS. in the end i but it together and check it also. if the labels arent correct then, i will rout a mess.

klayoutmatthias, 2025-05-19:
When I say "top level" I don't mean "chip". I mean the cell you are currently checking.

So when you work properly bottom up and do a check on every cell level, you will notice incorrect port labels. This is a recommended practice anyway.

Checking all ports in a design for proper labelling will not be helpful. In some cases you can even switch ports without bad side effects, like the A and B port of a CMOS NAND gate. Handling this case is built into LVS ("equivalent pins"), but violates the port naming rule.

Matthias

olisnr, 2025-05-19:
@klayoutmatthias yes thats all true. but i would like to find the wrong placed label when checking the current cell, and not when i but the things together.

im new with LVS, and i think that little errors can produce a big  amount of error messages, that let me perplexed where to start. i would really like it to get the labels of cells correct at time of checking this cell only.

swapping input-pins or gates is also easier, if the cells are correct labeled.

or do You see this different?

d-m-bailey, 2025-05-19:
> I strongly discourage parsing the file. The format is internal and may change in the future.

@klayoutmatthias Noted. But I think we need a way to verify that all the pins in the top level of the schematic are connected to corresponding labeled pads in the layout. In one sky130 design, there was a path that mistakenly did not connect to a port. The port was not connected to any device, and LVS passed because the netlists were topologically equivalent. On the top level of a design, the external pads should all be labeled to verify the coordinates of connectivity to outside world. With unlabeled pads, there is no way for LVS to verify the expected connectivity. Is this possible with the current version of Klayout?

> If "DiV_HBT_CMiM_100R" is the top circuit, why hard coding it? You have the name.
Yes, the top level layout name is probably available somewhere, but I wasn't sure how to extract it. In the interest of time, I just hard coded it here.

> Regarding the case sensitivity - if you have SPICE input, net names should not be case sensitive.
Are you saying that in Klayout, all these will give the same result?
```
      same_nets!("DiV_HBT_CMiM_100R", n.name, "DIV_HBT_CMIM_100R", n.name)
      same_nets!("DiV_HBT_CMiM_100R", n.name.downcase, "DIV_HBT_CMIM_100R", n.name)
      same_nets!("DiV_HBT_CMiM_100R", n.name.upcase, "DIV_HBT_CMIM_100R", n.name.downcase)
```
I know that case sensitivity is a factor in cell name comparison because this wouldn't work.
```
      same_nets!("DIV_HBT_CMIM_100R", n.name)
```

klayoutmatthias, 2025-05-19:
Case sensitivity seems to be an issue, that is correct. The extracted netlist is not case sensitive (as GDS texts have case). So you may have trouble matching an upper-case schematic net name to a lower case layout net name.

It is basically possible to turn off case-sensitivity in the extracted netlist

```
# Caution: will trigger extraction unless done already
netlist.case_sensitive = false
```

However, that has some side effects as names are normalized to upper case then. For example, device names need to be upper case too.

Another conceptual problem is maybe that "same_nets!" will not report an error if there is no layout net with that name. Topologically that still means the right circuitry is attached to the port, as this is checked by LVS. Also swapped labels will be detected, but not misspelled ones. So if your pins are called "A1" and "A2", but you label them "A" and "B", you will not get an error. With case sensitivity, you also won't see an error if schematic pins "A1" and "A2" are labelled "a2" and "a1". So case sensitivity is important here.

I will change the behaviour of "same_nets!" to become case insensitive if one of the netlists is. Also, I think it's okay to change the behavior of "same_nets!", so it would error if one of the nets is not found. That is just a problem for wildcards like `same_nets!("TOP", "*")` as schematic nets are always labelled and for internal nets there may not be a layout counterpart. Eventually you may not be able to use that function with wildcards in a meaningful way.

However, we're not out of options yet.

One generic solution that should allow you to add all kind of post-compare checks is based on the cross reference object. You can implement a very generic port check this way:

```
# here is the compare st
success = compare

if success

  # adds a port check

  messages = []

  xref = lvs_data.xref

  # find the circuit pair that forms the top level
  cpd = xref.each_circuit_pair.find { |p| p.first == netlist.top_circuit }

  # walk though the net pairs and check them
  xref.each_net_pair(cpd) do |np|
    schem_net, layout_net = np.first, np.second
    if schem_net.pin_count > 0 && schem_net && layout_net
      # check the names for nets where the schematic net is connected to a pin
      ln = layout_net.expanded_name.upcase
      sn = schem_net.expanded_name.upcase
      if sn != ln
        messages << "Layout net name differs from port name: #{sn} (schematic) vs. #{ln} (layout)"
      end
    end
  end

  # raise a compound message with all the mismatches
  if !messages.empty?
    raise "Port mismatches found:\n" + messages.join("\n")
  end

end
```

This is essentially equivalent to parsing the lvsdb, but built into LVS and using the API.

Matthias

d-m-bailey, 2025-05-19:
@klayoutmatthias this may be exactly what we need! Really appreciate your time and precise in-depth explanations.

Quick unrelated question. The iHP rule set has these commands at the end.
```
# === COMPARISON ===
logger.info('Starting SG13G2 LVS Comparison')
compare

#================================================
#------------- COMPARISON RESULTS ---------------
#================================================

if !compare
  logger.info('xxxxxxxxxxxxxxxxxxxxxxxxxxxxxxxxxxxxxxxxxx')
  logger.error("ERROR : Netlists don't match")
  logger.info('xxxxxxxxxxxxxxxxxxxxxxxxxxxxxxxxxxxxxxxxxx')
else
  logger.info('==========================================')
  logger.info('INFO : Congratulations! Netlists match.')
  logger.info('==========================================')
end
```
Is this running `compare` twice?

d-m-bailey, 2025-05-20:
@klayoutmatthias the code you suggested almost worked perfectly. I made 2 changes.

1) I'm testing with version `0.29.4` and there doesn't appear to be a `top_circuit` associated with `netlist`. I instead used the name of the schematic.
```
  top_circuit = schematic.circuits_by_name($topcell)[0]
  cpd = xref.each_circuit_pair.find { |p| p.second == top_circuit }
```

2) I think the layout and schematic are reversed here, aren't they? This didn't flag missing layout ports.
```
    schem_net, layout_net = np.first, np.second
```
When I switched them, missing layout ports were flagged.
```
    layout_net, schem_net = np.first, np.second
```

klayoutmatthias, 2025-05-20:
And yes, the compare is run twice. One of the calls should be removed. It's just a waste of CPU time.

Matthias

klayoutmatthias, 2025-05-20:
I have created a ticket to add the above code as a new function for convenience, if you think it does the job.

d-m-bailey, 2025-05-20:
> I have created a ticket to add the above code as a new function for convenience, if you think it does the job.

Much appreciated!

Thread 493 (2025-05-14):

DRC of small CMIMs

EngGhaith, 2025-05-14:
Hi!
I have a small MIM with: w=l=2u3.

I have used the PCell and had the following DRC-violation:

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

Should I add a wider box on TM1, or not because it is rightly generated?
If I made the upper plate on TM1 bigger to satisfy the rule, would I affect the capacitance a lot?

Thanks in advance.
Ghaith.

sergeiandreyev, 2025-05-14:
Hi @EngGhaith, we should have a limit set in the Pcell to prevent generating device layout w/ DRC violations, we will discuss this internally

sergeiandreyev, 2025-05-14:
well, these limits are not working (you can just try to draw a device w/ 1um size, it will crash w/ Python error) and the limit values are not defined correctly (if we can generate device layout that is not DRC clean, but satisfying the limits)

Thread 495 (2025-05-15):

Klayout LVS series resistor reduction rule modifies connectivity even if devices are not reduced.

d-m-bailey, 2025-05-15:
In `libs.tech/klayout/tech/lvs/rule_decks/custom_combiner.lvs` the function `supp_series` modifies the connectivity of series devices.
```
  def supp_series(a, b, net1, net2)
    a_net1 = a.net_for_terminal(net1)
    a_net2 = a.net_for_terminal(net2)
    b_net1 = b.net_for_terminal(net1)
    b_net2 = b.net_for_terminal(net2)

    return false unless a_net1 && b_net1 && a_net2 && b_net2

    series_con_a1 = a_net1.expanded_name == b_net1.expanded_name || a_net1.expanded_name == b_net2.expanded_name
    series_con_a2 = a_net2.expanded_name == b_net1.expanded_name || a_net2.expanded_name == b_net2.expanded_name
    series_con = series_con_a1 || series_con_a2

    # Reroute terminal connections based on cluster IDs
    if series_con_a1
      if a_net1.expanded_name == b_net1.expanded_name
        a.connect_terminal(0, b_net2)
      else
        a.connect_terminal(0, b_net1)
      end
    end

    if series_con_a2
      if a_net2.expanded_name == b_net1.expanded_name
        a.connect_terminal(1, b_net2)
      else
        a.connect_terminal(1, b_net1)
      end
    end

    series_con
  end

  # A helper function to check whether two parameters have approximately the same value
  def same_parameter(a, b, name)
    (a.parameter(name) - b.parameter(name)).abs < 1e-9
  end
end
```
However, the series devices may not be removed from the netlist because of size mismatches or configuration settings.
```
class RESDeviceCombiner < RBA::GenericDeviceCombiner
  include DeviceCombinerMethods

  # Method to check and perform device combination
  def combine_devices(a, b)
    res_nets = [0, 1] # Using id instead of names

    # Check if same parameters

    # Check if terminals series or parallel (With same params)
    if supp_parallel(a, b, 0, 1)
      return false unless PARALLEL_RES
      return false unless %w[w l ps b].all? { |param| same_parameter(a, b, param) }

      a.set_parameter('m', a.parameter('m') + b.parameter('m'))
    elsif supp_series(a, b, 0, 1)                                                      <===== connectivity modified here
      return false unless SERIES_RES
      return false unless %w[w ps b m].all? { |param| same_parameter(a, b, param) }    <===== Size difference prevents device removal

      a.set_parameter('l', a.parameter('l') + b.parameter('l'))
    else
      return false
    end

    # Disconnect the second device and let the system clean it up
    res_nets.each { |term| b.disconnect_terminal(term) }

    true
  end
end
```

This problem is [detailed here](https://github.com/KLayout/klayout/issues/2048).

Thread 496 (2025-05-15):

Simulation results are inconsistent across identical runs after May 11, 2025 PDK update

rupokdas147, 2025-05-15:
After updating the PDK on May 11, 2025, I’ve observed non-deterministic simulation behavior with circuits that previously gave consistent results. Running the same netlist multiple times produces different results for the first few runs, and only after 3–5 simulations does the output stabilize and become repeatable.

This was not an issue prior to the update, and the netlist has not been changed in any way.

Environment:
Simulator: **Ngspice 44.2**, **Qucs-S 25.1.2**
OS: Ubuntu 24.04, Windows 10
PDK Version: Updated **after May 11, 2025** from **dev branch**
Circuit type: Custom design using [e.g., npn13g2 HBT, passive S-parameters, etc.]

This inconsistency also occurred for complex circuits, but for simplicity, I am including the PDK's example.

https://github.com/user-attachments/assets/41b5540c-1fe7-49f5-9984-6225a86e1b0e
https://github.com/user-attachments/assets/3ca5e717-caba-44cd-a6a6-6e63092a62a1

Look at the value of **i(Pr1)**.

dwarning, 2025-05-17:
Yes, that is our fault. Swapping default mm_ok to 1 in PR #453 let the repeated simulation runs act as mismatch simulations. This is the case for all elements with mismatch capability.
I am fearing we have to go back to the old selection approach with choosing different library entries for mismatch simulation, in case of hbt e.g. hbt_typ_mismatch.

The default setting should stay as ON with mm_ok=1.

Ikram-rs22, 2025-05-19:
@dwarning how to go back to the previous version or to turn off the mismatch variable? It is becoming impossible to simulate and design while mismatch parameter is ON.

dwarning, 2025-05-19:
Yes - we will switch back to the old concept asap.
But that simulations are not possible is definite wrong. The variations from run to run are much smaller then the corner and statistical variations. Your design should robust against that.

Thread 498 (2025-05-15):

sealring produces short-circuit in LVS

olisnr, 2025-05-15:
i have a strange problem:
a chip that seems ok without sealring in the LVS is short-circtuit in LVS if it has a sealring. but if tracing the nets in KLaout it looks ok with and without sealring.

i was thinking that the difference of LVS and net-traceing is LVS looks also at the fill and tracing not, but if i delete all the fills it changes nothing.

but see Yourself

[gds_and_spice.zip](https://github.com/user-attachments/files/20227533/gds_and_spice.zip)

there is still an LVS problem without sealring that comes from two parallel cmim's its not really a problem, its an error of the LVS handling of parallel cmim (at least i think this).

this is VSS without sealring

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

and this is VSS including sealring

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

d-m-bailey, 2025-05-19:
@olisnr could it be a short through psubstrate? The psubstrate connection is extracted in LVS, but is not normally part of the Klayout trace setup.

olisnr, 2025-05-20:
@d-m-bailey sure, but why does this need a sealring? and why does the net-tracing  dosent see's it?

i was searching for it, but didnt found anything. could You look at it?

d-m-bailey, 2025-05-21:
@olisnr If I change line `91` in `$PDK_ROOT/ihp-sg13g2/libs.tech/klayout/tech/lvs/rule_decks/general_derivations.lvs`
from
```
ptap_holes = ptap.holes
```
to
```
ptap_holes = ptap.not(edgeseal_drw).holes
```
I get a clean LVS result (after connecting `REFADJ`, adding top text in the layout and top ports in the source, adding `VSS` to the `bondpad` instances in the source, and removing the bondpad instances for square instances in the source.)

olisnr, 2025-05-21:
@d-m-bailey thanks a lot! You fixed my chip!!!

You wrote that  "bondpad is extracted as a 2 terminal device" from the layout.?

if i search in the
[FMD_QNC_HBT_AMP_EH_extracted.cir.tar.gz](https://github.com/user-attachments/files/20374989/FMD_QNC_HBT_AMP_EH_extracted.cir.tar.gz)
i dont find any bondpad (that should have a `X` name i reckon).

where did You see a bondpad?

d-m-bailey, 2025-05-21:
@olisnr looks like the circuit you sent was the result of a flattened extraction. I extracted using the `deep` option.
Here's the subckt line of the file you sent.
```
.SUBCKT FMD_QNC_HBT_AMP_EH CGND|VSS C2|C3|VDD ien ld|op ihp VGND|vGND ip in ihn
+ iep REFADJ|vadj REF1.2|ip|vref sink in$1 C1|DRV_SHUNT|op SHUNT_GND|VSS_SHUNT
```

Looks like texts from all levels are present (and shorted) at the top level.

klayoutmatthias, 2025-05-21:
Hi @d-m-bailey,

regarding your question above: there are two bondpad cells, but only one schematic cell. For LVS there needs to be a 1:1 correspondence and the names need to match. As the names are "bondpad" and "bondpad$1", only the "bondpad" will match the schematic pad.

I don't see that the bondpad is extracted as a device. If it was, the difference in the cells would not matter - the shape would only be some parameter or hidden in an area value. In the test case and in LVS; the bond pad is simply a single-terminal subcircuit. As such, the name of the cell has to match. Otherwise, the subcircuit is flattened and simply vanishes.

I am worried about the "holes" thing. `ptap.holes` should also flag guard rings, which are pretty common. Is that considered?

"holes" is an operation that usually has destructive side effects. It only applies in very rare situations such as detecting the inside areas of buried wells and only if they can't form donuts. But usually you have a mask layer for this, so there is no need to test the holes. I feel that inside LVS, holes are good for unexpected side effects only.

Matthias

olisnr, 2025-05-22:
modeling the a `bondpad` as a small `C` should work. what do You think?

d-m-bailey, 2025-05-22:
@klayoutmatthias

> Also, I don't see that the bondpad is extracted as a device.

My bad. It's extracted as an empty subcircuit - which I consider to be a black-box "device".

> I feel that inside LVS, holes are good for unexpected side effects only.

ROFL.
My patch eliminates the known problem of the enclosing `ptap` ring in the sealring, but as you stated, other `ptap` rings  might generate unexpected side effect.
@atorkmabrains

d-m-bailey, 2025-05-22:
@olisnr
> modeling the a bondpad as a small C should work. what do You think?

I'm not sure I understand what you want to do. Are you suggesting that the schematic export the `bondpad` as a subckt that contains a capacitor? There will need to be a corresponding capacitor extracted from the layout.

If you don't care about the `bondpad`s, you can set `lvs_ignore=1` on the `bondpad` symbols in xschem. The current setup that netlist the `bondpad` as an undefined subckt should work with a little modification. 1) add a VSS terminal to the bondpad symbol in xschem so it netlists with 2 ports. 2) rename the square `bondpad` (maybe `bondpad2`) in both the layout and schematic. 3) figure out why Klayout is not extracting the square `bondpad` as a subckt.

There are several others ways to verify that there are actually connections to `bondpad` in the layout from the specified net. Unfortunately, I can't think of a way that does not require a rule change.

The magic tech file creates a pad tile from the passivation layer that requires text on a pad text layer. However, it does not support pins yet. I don't think the Klayout rules recognize pads or support pad text as a separate layer.

My opinion is that a specifically labelled pad with a substrate capacitor for top level external connections is a good idea. Without it, you run the risk of LVS passing but the pads not being connected to the intended circuit.

Your layout currently has pads on the left that do not have text. The text is on the topmetal2 layer connected to the pads. Although this will pass LVS with the bondpad check, it does not check the location of the pads. Having the text over the pads (on a separate layer) will ensure that the pad at a specific location is actually connected to the expected signal. Without the `bondpad` subckt, LVS will pass even if the bondpads are not connected to these signals. See below.

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

olisnr, 2025-05-22:
@d-m-bailey the idea would be to have the bondpad as a capacitor to substrate. it would need that LVS extract the area of the pad and calculates the capacity and that the schematic bondpad symbol does the same.
the schematic pad would have one pin and a connection to a global substrate net.

Thread 502 (2025-05-19):

Enhancement: Via stack cell improvement

EngGhaith, 2025-05-19:
Please modify the via_stack cell to allow designer excluding connection with some layer.
E.g.:
Via from M1 to M4 with GND at M3  --> M3 should not be connected --> e.g. automatic generation of M3-slits around the via array with respect to proper enclosures.

You can do it in Tick-Style like that:
Layers to be connected:

- [ ]  TM2
- [ ]  TM1
- [ ]  M5
- [ ]  M4
- [ ]  M3
- [ ]  M2
- [ ]  M1
- [ ]  CONT

And please add the "CONT"-Layer.

EngGhaith, 2025-06-10:
And it would be much better if you add fields for cut-out width in every layer (slit-width)

Thread 503 (2025-05-19):

Problem recognizing Rhigh with bends b>0

EngGhaith, 2025-05-19:
Hi
I have this schematic:

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

Layout:

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

LVS:

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

# Firstly: KLayout PCell: L&W:
When I type l=20u for R1 and R2, Klayout recognizes the length others than given in PCELL (see in LVS: l=21.08u and l=21.07u respectly). It seems that  bend-length is also accounted in KLayout but not in Xschem.
# Secondly: Device recognition:
R1 and R2 were not recognized due to length mismatch between schematic and layout.
Because of that I have created R4 and R5 in Xschem, which have the same lengths calculated by KLayout ( l=21.08u and l=21.07u). Despite that, KLayout did not recognized R4 and R5.

The only recognized one is R3, which does not have any bends.
Files:

[RHIGHTEST.zip](https://github.com/user-attachments/files/20313177/RHIGHTEST.zip)

Thank you in advance.
BW,
Ghaith.

olisnr, 2025-05-21:
its the same with RPPD

Thread 506 (2025-05-20):

MOS as Decap

EngGhaith, 2025-05-20:
Hi!
Is it ok to use NMOS/PMOS as decouping capsas follow:
NMOS: B,D,S --> VSS, G --> VDD
PMOS: B,D,S --> VDD, G --> VSS

even when VDD>1V65?
My VDD=2V0
In the spec it is written, that VGS<1V65 @ 125°C. But in this case there is no Current in the channel, it is just the use of MOS-Capacitor.
Would the MOS-Cap be destroyed in this way or not?

Thank you in advance.
Ghaith.

EngGhaith, 2025-05-24:
@hpretl thank you very much!
The issue is, that I have a dummies and thought if I could use them instead of left them shorted.
Undortunately I cannot use HV-MOS as a dummy for LV-MOS

EngGhaith, 2025-05-24:
@hpretl
I could manage to use the LV-MOS transistors to decouple another biasing networks, which have a lower voltage. In this case these dummies would not see any voltage above 1V65.
Otherwise it would be catastrophal if I used them to decouple VDD, since it would destroy the gates which lead to VDD-VSS-short <==> K.O.

Thank you again!

Closed 2025-08-19.

Thread 507 (2025-05-21):

Compatibility of PDK with Qucs-S Version 25.1.2

TolacShaffu, 2025-05-21:
Hi,

I’ve set up the PDK and all the necessary tools for the development environment in Ubuntu 24.04. Unfortunately, I didn’t check the version of Qucs-S I installed, and I’m currently using version 25.1.2.

Could someone please confirm whether the PDK is fully supported with this version?

Thanks

sergeiandreyev, 2025-05-22:
Hi @TolacShaffu, this version of Qucs-S was recently tested with IHP OpenPDK on Ubuntu 24, so it is supported

TolacShaffu, 2025-05-22:
Thank you for your respond!

Thread 509 (2025-05-22):

Conflicts Between Verilog-A Component and PDK Elements Prevent Simulation

Amigom-MT, 2025-05-22:
Hi,
I created a simple circuit composed of a variable voltage source, a component developed in Verilog-A and translated to OSDI using OpenVAF (in this case, a VCO), and an inverter built using transistors from the PDK "cornerMOSlv.lib mos_tt".

I tested both components separately, and they work perfectly.
When I tried to simulate them together, I initially got an error stating that "cornerMOSlv.lib" could not be found. I fixed this by providing the absolute path in the "Include Script" block.

I don’t understand why the block works without the absolute path when tested alone.
After fixing that issue, I’m now facing the following error:
"Ngspice started...

Warning: Nesting of subcircuits with parameters is only marginally supported!

Note: No compatibility mode selected!

Circuit: * qucs 25.1.1  /home/userproj/microelectronics/projetzigbee/zigbee/pll/pll_verilog_a/vco_fdiv_test.sch

Warning: Model issue on line:
  .model xsub1.xsg13_lv_nmos1.x1:sg13g2_lv_nmos_psp pspnqs103va type=+1 le ...
Unknown model type pspnqs103va - ignored

Warning: Model issue on line:
  .model xsub1.xsg13_lv_nmos1.x1:sg13g2_lv_pmos_psp pspnqs103va type=-1 le ...
Unknown model type pspnqs103va - ignored

Error on line:
  n.xsub1.xsg13_lv_nmos1.x1.nsg13_lv_nmos _net1 _net0 0 0 xsub1.xsg13_lv_nmos1.x1:sg13g2_lv_nmos_psp w=    1.500000000000000e-07
l=    1.300000000000000e-07     nf=    1.000000000000000e+00     mult=    1.000000000000000e+00     as=    5.190000000000000e-14
ad=    5.190000000000000e-14     ps=    9.920000000000000e-07     pd=    9.920000000000000e-07     dta=    0.000000000000000e+00     ngcon=2
could not find a valid modelname
    Simulation interrupted due to error!

Note: No ".plot", ".print", or ".fourier" lines; no simulations run"

Can you help me resolve or work around this conflict between the Verilog-A component and the PDK?

FYI : openvaf 23.5.0 - qucs 25.1.1
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
complete circuit
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
Inverter
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
VCO

_Originally posted by @Amigom-MT in https://github.com/IHP-GmbH/IHP-Open-PDK/discussions/508_

dwarning, 2025-05-22:
My guess is that the psp103_nqs.osdi was not loaded. Perhaps your .spiceinit block is overwriting the pdk .spiceinit. Try to include both osdi files here.
If not success you must provide more information as the exported netlist and the va code of your VCO model.

Amigom-MT, 2025-05-23:
> My guess is that the psp103_nqs.osdi was not loaded. Perhaps your .spiceinit block is overwriting the pdk .spiceinit. Try to include both osdi files here. If not success you must provide more information as the exported netlist and the va code of your VCO model.

Ok, I added the absolute path to psp103_nqs.osdi in the .spiceinit block of the VCO, and I no longer get any errors related to that conflict.
Thanks!

Closed 2025-05-23.

Thread 512 (2025-05-23):

rfcmim LVS problems.

d-m-bailey, 2025-05-23:
1. A design with multiple `rfcmim` capactors gives warnings during extraction
```
2025-05-23 10:12:23 +0900: Memory Usage () : Extracting rfcmim device
2025-05-23 10:12:23 +0900: Memory Usage () : No. of ports exist for rfcmim topmetal is 9, should be 1
```
2. parallel or series devices in the source netlist cause LVS to crash.
```
2025-05-23 10:12:24 +0900: Memory Usage () : Starting SG13G2 LVS Simplification
ERROR: In /Users/home/IHP-Open-PDK/ihp-sg13g2/libs.tech/klayout/tech/lvs/sg13g2.lvs: Internal error: Terminal still connected after removing device in device combination: name=RC3, circuit=FMD_QNC_04_160GHZ_LNA, terminal=mim_sub in Netlist::combine_devices
ERROR: RuntimeError: Internal error: Terminal still connected after removing device in device combination: name=RC3, circuit=FMD_QNC_04_160GHZ_LNA, terminal=mim_sub in Netlist::combine_devices in Executable::execute
  /Users/home/IHP-Open-PDK/ihp-sg13g2/libs.tech/klayout/tech/lvs/sg13g2.lvs:362:in `combine_devices'
  /Users/home/IHP-Open-PDK/ihp-sg13g2/libs.tech/klayout/tech/lvs/sg13g2.lvs:362:in `execute'
  :/built-in-macros/lvs_interpreters.lym:31:in `instance_eval'
  :/built-in-macros/lvs_interpreters.lym:31:in `execute'
```
3. device extracted as `rfcmim` but spice model is `cap_rfcmim`.

test case:

[test_rfcmim.tgz](https://github.com/user-attachments/files/20402631/test_rfcmim.tgz)
```
tar xzf test_rfcmim.tgz
cd test_rfcmim
export PDK_ROOT=<path_to_pdk>
./run_lvs
```

Pull request to fix these issues will be submitted shortly.

Thread 516 (2025-05-27):

Klayout lvs with IHP : subckt ports not generated in .cir netlist

engrvip123, 2025-05-27:
Running Klayout-LVS using CLI with .cdl netlist from xschem for inverter circuit.

`trg@opamp:~/IHP-Open-DesignLib/LNA_24GHz/design_data/lvs$ python3 run_lvs.py --layout=../inverter.gds  --netlist=../simulations/inverter.cdl  --run_dir=output_lvs1 --topcell=inverter  --top_lvl_pins`

Following `inverter_extracted.cir` netlist generated from klayout without subckt ports in netlist:

```
* Extracted by KLayout with SG13G2 LVS runset on : 27/05/2025 13:09

.SUBCKT inverter
M$1 \$5 \$2 \$3 \$I1 sg13_lv_pmos L=0.13u W=0.15u AS=0.1005p AD=0.1005p
+ PS=1.34u PD=1.34u
M$2 \$4 \$2 \$3 \$1 sg13_lv_nmos L=0.13u W=0.15u AS=0.1005p AD=0.1005p PS=1.34u
+ PD=1.34u
.ENDS inverter

```

Following CDL netlist generated from schematic:
```
* CDL netlist generated from SPICE

.SUBCKT inverter vdd inp out vss
* PININFO inp:B vdd:B vss:B out:B

M_M5 out inp vss vss sg13_lv_nmos W=0.15U L=0.13U M=1
M_M6 out inp vdd vdd sg13_lv_pmos W=0.15U L=0.13U M=1

.ENDS inverter
```

When importing `inverter.lvsdb` using Klayout's 'netlist browser' option, a cross-reference appears between two netlists. I have defined pins at layout terminals using `*.drawing` layers and assigned port names using `*.pin` layers. However, I am unsure why the `.cir` netlist generated by Klayout does not include subcircuit ports. which is leading to LVS failing ?

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

d-m-bailey, 2025-05-27:
@engrvip123 Can you share your gds? Does it have text and pins?

engrvip123, 2025-05-27:
@d-m-bailey Could not find any layer with datatype 65 in IHP layer [https://ihp-open-pdk-docs.readthedocs.io/en/latest/layout_rules/02_layer_table.html#layer-table](url)

Is it datatype 25 for text layer to be used?

d-m-bailey, 2025-05-28:
@olisnr there is a pin layer for gate poly (`5/2`), so a text layer would make sense.

@KrzysztofHerman @sergeiandreyev who makes the decisions on adding layer definitions to the pdk?

Thread 518 (2025-05-28):

Running into Pin.f violations

dnltz, 2025-05-28:
OpenROAD-flow-scripts is able to generate macro blocks for Verilog modules. Those blocks have pin shapes for routing signals to in the parent design hierarchy.

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

When exporting a design to GDS, those pin shapes will be added to data layer 2 (`MetaX.pin`). According to the Layout Rules, pin areas ust be fully covered by drawing

```
Circuit designers should use only drawing purpose 0 (data types) for layouts. Only exception is pin purpose
2 for symbolic pins. Data type 2 (purpose pin) is used for symbolic connectivity information. Pin areas must
be fully covered by drawing. These rules are tested because pin areas are not used for mask generation
and a potential issue due to false postive LVS matchs.
```

Unfortunately, that is not possible with OpenROAD and designs with self-generated blocks will have `Pin.f` violations as a short part of the track is not covered by `MetalX.drawing`.

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

**Questions:**

1. Why is data layer 2 not used to generate masks and what's the purpose of data layer 2 then?
2. Can we export data layer 2 (``pin``) to data layer 0 (``drawing``)?

smunaut, 2025-06-10:
The `.map` file in ORFS is outdated. Replace it with the one from the PDK directly and this will fix this issue.

dnltz, 2025-06-17:
@smunaut after your explanation in the PR and running DRCs again, you're right. The `.map` was outdated.

Closed 2025-06-17.

Thread 523 (2025-05-28):

Differential EM Simulation using OpenEMS

rupokdas147, 2025-05-28:
I have tried to design a Differential Coupled Line coupler at 155 GHz. I have calculated the line width and spacing using the equations from the publication referenced in [this link](https://ieeexplore.ieee.org/abstract/document/1643581).
I found that my calculated width and spacing are the same as described in the publication referenced in [this link](https://ieeexplore.ieee.org/abstract/document/9737284)
Therefore, I designed the coupler with the exact width, spacing, and metal layers specified in the second publication, assuming they have a similar metal stack in their PDK. The authors of the second publication used ADS to simulate the coupler.
In OpenEMS, we do not have a differential port like ADS. So, I have used 8 single-ended ports instead of 4 differential ports (used in ADS). Then, I have converted the 64 s-parameters into 64 mixed-mode s-parameters using the sk-rf Python library and observed the differential S21 and differential S31 curves. The curve is not similar to the actual coupler, not even nearly similar. I have tried various line widths and distances. I have also tried ring ring-type GND layer as well as a solid metal GND layer. No method shows the output as an actual coupler.
Then I tried TopMetals to design the coupler and kept both of them very close (about 1 μm apart). The curve was slightly close to a coupler output shape.
My question is: The method I am using to observe the differential s-parameters, is it the right way to determine them? Is it possible to design a differential coupler in OpenEMS?
I am attaching my test GDS file and Python code.

[Coupled_Line_Coupler_Diff.zip](https://github.com/user-attachments/files/20481284/Coupled_Line_Coupler_Diff.zip)

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

rupokdas147, 2025-05-29:
@VolkerMuehlhaus Thanks for reviewing the issue. You may look at this publication as it's open access: https://ieeexplore.ieee.org/document/10061405
There is a quadrature coupler design in this publication. They are also using the same metal stack or the same process I guess.
I have looked into your transformer differential simulation and tried this method also. Though I am getting the 90 degree phase shifted signal properly in both method mixed mode and the method used in your transformer method. But not getting the coupled signal properly. The magnitude of the coupled signal is very low (less than -40 dB) where I designed for -3 dB coupling.

So, I am assuming that the signal is not coupling properly through the dielectric between the conductors.

rupokdas147, 2025-05-29:
@VolkerMuehlhaus Thanks. Can you please elaborate more about the problem happening with my simulation. I am trying to recognize the issue for a long time.

VolkerMuehlhaus, 2025-05-29:
@rupokdas147 Just look carefully at Fig. 14 of the reference paper, to see what each differential line is.

You will notice that their differential lines are "crossover". Let me try once more to show you what they do differently:

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

Closed 2025-05-30.

Thread 524 (2025-05-29):

netgen tech file permutes HBT transistor collector and emitter.

d-m-bailey, 2025-05-29:
The current [setup file](https://github.com/IHP-GmbH/IHP-Open-PDK/blob/dev/ihp-sg13g2/libs.tech/netgen/ihp-sg13g2_setup.tcl) at commit [1093564](https://github.com/IHP-GmbH/IHP-Open-PDK/commit/1093564ded71b20293d814f07754a67cb93307ba) has
```
#-------------------------------------------
# (HBT) transistors
#-------------------------------------------

set devices {}
lappend devices npn13G2
lappend devices npn13G2l
lappend devices npn13g2v
lappend devices pnpMPA

# TODO: check parallel merge
foreach dev $devices {
    if {[lsearch $cells1 $dev] >= 0} {
	permute "-circuit1 $dev" 1 3
	property "-circuit1 $dev" parallel enable
	property "-circuit1 $dev" parallel {le critical}
	property "-circuit1 $dev" parallel {we add}
	property "-circuit1 $dev" tolerance {we 0.01} {le 0.01}
	# Ignore these properties
	property "-circuit1 $dev" delete Nx Ny
    }
    if {[lsearch $cells2 $dev] >= 0} {
	permute "-circuit2 $dev" 1 3
	property "-circuit2 $dev" parallel enable
	property "-circuit2 $dev" parallel {le critical}
	property "-circuit2 $dev" parallel {we add}
	property "-circuit2 $dev" tolerance {we 0.01} {le 0.01}
	# Ignore these properties
	property "-circuit2 $dev" delete Nx Ny
    }
}
```
The `permute` statements enable the swapping of the first and third terminals during comparison. While this is permissible for mosfets, it should not be enabled for bipolar devices.

d-m-bailey, 2025-06-06:
Fixed with #525

Closed 2025-06-06.

Thread 527 (2025-05-30):

Magic does not extract Base of pnpMPA

devstdin, 2025-05-30:
Extracting the attached layout of a `pnpMPA` transistor in magic with the following commands:
```
ext2spice lvs
extract all
ext2spice
```
... produces the below subcircuit with the Base-connection missing:
```
.subckt t_test_flat E B C
	X0 C w_338_n923# E pnpMPA a=4p p=8u
.ends
```
Adding `pnp` to the connection-section of the magic technology-file as follows:
```
connect
  *nwell,*nsd,*hvnsd,dnwell,pnp *nwell,*nsd,*hvnsd,dnwell,pnp
```
... leads to a correct extraction:
```
.subckt t_test_flat E B C
	X0 C B E pnpMPA a=4p p=8u
.ends
```
Discussion in [FOSSi-chat](https://matrix.to/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)

[t_test_flat.mag.txt](https://github.com/user-attachments/files/20522226/t_test_flat.mag.txt)

sergeiandreyev, 2025-10-01:
Hi @RTimothyEdwards, could you please take a look?

RTimothyEdwards, 2025-10-01:
@devstdin :  Thanks for the report and suggested fix.  I will add that to the stuff I am currently working on (mainly for extraction) and should get a commit out by the end of the day (Friday worst case).

Thread 530 (2025-06-04):

The klayout GUI lvs file sg13g2_full.lylvs is not in-sync with batch sg13g2.lvs and the files in rule_decks

d-m-bailey, 2025-06-04:
Here are the screen shots of the discrepancies.

`rule_decks/general_derivations.lvs`
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

`rule_decks/resistor_derivations.lvs`
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

`rule_decks/tap_derivations.lvs`
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

`rule_decks/res_connections.lvs`
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

d-m-bailey, 2025-06-04:
@FaragElsayed2 Can you verify this?

Closed 2025-06-04.

Thread 541 (2025-06-13):

Phase Noise Simulation Support for VCO at 140 GHz

Atif07Ali, 2025-06-13:
I am currently designing a Voltage Controlled Oscillator (VCO) operating at 140 GHz. While the time-domain and frequency-domain simulations are working as expected, I have not found a reliable method or built-in feature to simulate and calculate phase noise.

I would like to request clarification or guidance on the following:
1. Does qucs-s/ngspice support phase noise simulation?
2. If not natively supported, are there any recommended workarounds or external tools that can be integrated with the current simulation flow to estimate phase noise?

Any help or documentation references would be greatly appreciated.

System Information:
qucs-s version: 25.1.2
ngspice version: 44

Atif07Ali, 2025-06-13:
@KrzysztofHerman, I would appreciate it if you could look into this.

rjordans, 2025-06-18:
1. no, this is not currently supported
2. You can try the method proposed in: A. Hajimiri and T. Lee, “A general theory of phase noise in electrical oscillators,” IEEE Journal of Solid-State Circuits, vol. 33, no. 2, pp. 179–194, 1998.

Atif07Ali, 2025-06-20:
Thanks for your suggestion.

Closed 2025-06-22.

Thread 542 (2025-06-13):

CI: Cache KLayout

mole99, 2025-06-13:
All of the LVS tests download KLayout from https://www.klayout.org/downloads/Ubuntu-24/klayout_0.29.8-1_amd64.deb individually.

This sometimes fail for some of them, causing the CI to get stuck:

```
--2025-06-13 07:10:43--  https://www.klayout.org/downloads/Ubuntu-24/klayout_0.29.8-1_amd64.deb
Resolving www.klayout.org (www.klayout.org)... 178.77.102.107
Connecting to www.klayout.org (www.klayout.org)|178.77.102.107|:443... failed: Connection timed out.
Retrying.
--2025-06-13 07:12:58--  (try: 2)  https://www.klayout.org/downloads/Ubuntu-24/klayout_0.29.8-1_amd64.deb
Connecting to www.klayout.org (www.klayout.org)|178.77.102.107|:443... failed: Connection timed out.
Retrying.
--2025-06-13 07:15:14--  (try: 3)  https://www.klayout.org/downloads/Ubuntu-24/klayout_0.29.8-1_amd64.deb
Connecting to www.klayout.org (www.klayout.org)|178.77.102.107|:443... failed: Connection timed out.
Retrying.
...
```

This ultimately leads to a timeout and failure of the test.

Instead of downloading KLayout for each test, it should be cached for the next run.

See here for more: https://docs.github.com/en/actions/writing-workflows/choosing-what-your-workflow-does/caching-dependencies-to-speed-up-workflows

sergeiandreyev, 2025-06-13:
Hi @FaragElsayed2, if I remember correctly, you mentioned you optimized this in one of the DRC related PRs?

FaragElsayed2, 2025-06-15:
Hi @sergeiandreyev,

Yes, I've combined the LVS device checks (unit LVS tests) into a single job. The workflow now runs four jobs in total:

- **Linting**
- **Unit DRC Regression**
- **Unit LVS Regression**
- **Standard Cells LVS Regression**

To reduce the connection issues, I added some retry and timeout options to the KLayout download step.

However, I agree with this suggestion, it is more reliable solution. I supported it now in #529

Thanks @mole99 for the suggestion!

CC @atorkmabrains

sergeiandreyev, 2025-07-15:
Hi @mole99, the update to the LVS regression flow is now merged as https://github.com/IHP-GmbH/IHP-Open-PDK/pull/567, did you have a chance to check?

mole99, 2025-07-16:
Hi @sergeiandreyev, yes #567 seems to add the caching logic to the LVS regression, thanks!
However, I think #529 is still needed to cache KLayout for the DRC regressions.

FaragElsayed2, 2025-07-17:
Hi @mole99
The DRC regression already supports this, just like the LVS regression.

Closed 2025-09-01.

Thread 544 (2025-06-16):

Remove `psutil` from the PCells

mole99, 2025-06-16:
The PCell registration code uses [psutil](https://pypi.org/project/psutil/): https://github.com/IHP-GmbH/IHP-Open-PDK/blob/68eebafcd9b2f5e92c69d37a8d3d90eb266550f5/ihp-sg13g2/libs.tech/klayout/python/sg13g2_pycell_lib/__init__.py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

psutil is a non-standard Python package and therefore complicates the distribution of the PCells on some platforms. (In my specific case I run KLayout from [nix-eda](https://github.com/fossi-foundation/nix-eda)).

However, if I simply remove the psutil package and return `[]` from `getProcessNames`, the PCells still work on my end.

Why is it necessary to get the process names? Is this purely for debugging purposes?

akrinke, 2025-06-16:
There have already been discussions about `psutil`, see https://github.com/IHP-GmbH/IHP-Open-PDK/pull/202, https://github.com/IHP-GmbH/IHP-Open-PDK/pull/227 and https://github.com/IHP-GmbH/IHP-Open-PDK/issues/226.

mole99, 2025-06-17:
Thanks @akrinke, it seems this has been an issue before.
I'll ping @ThomasZecha and @dnltz too.

Getting KLayout to work with additional Python libraries across all platforms is quite difficult.
If in any way possible, it would be great if `psutil` could be removed as a dependency.

The documentation shows:

```
The #ifdef-block is executed (name is considered as defined) if
  1. An environment variable 'name' can be found case-insentive, or
  2. The name can be found case-insentive as part of a process name of the process chain beginnig at
     the current process upwards through all parent processes.
```

But 2. seems like a really strange use case. Why are the process names used to control conditional compilation?

dnltz, 2025-06-17:
Yes, I would also prefer to use built-in packages. I don't think that's gonna work for ever ... so, we should start to install 3rd-party packages in a `virtualenv` and provided tagged packages via the requirements.txt file.

mole99, 2025-06-17:
In addition to setting up a virtual environment, one also has to set `KLAYOUT_PYTHONPATH` to point KLayout to the virtual environment. It really complicates things for the end user.

Also, KLayout comes with its own Python interpreter. If the packages and the interpreter don't match, that could lead to problems.

dnltz, 2025-06-17:
> In addition to setting up a virtual environment, one also has to set `KLAYOUT_PYTHONPATH` to point KLayout to the virtual environment. It really complicates things for the end user.
>
> Also, KLayout comes with its own Python interpreter. If the packages and the interpreter don't match, that could lead to problems.

You could pass the Python binary from the `venv` to KLayout via `KLAYOUT_PYTHONPATH`. This binary has access to all packages installed to the virtual environment.
```
(venv) daniel@ld-daniel:~/work/aesc/i2c-gpio-expander/pdks/IHP-Open-PDK$ which python3
/home/daniel/work/aesc/i2c-gpio-expander/pdks/IHP-Open-PDK/venv/bin/python3
```

Still complicated. Especially for someone not really familiar with Linux.

mole99, 2025-06-17:
I think `KLAYOUT_PYTHONPATH` only specifies where KLayout gets the Python packages from, but it doesn't change the builtin interpreter.

I agree, it is not straightforward.

mole99, 2025-06-18:
Aha! Now I get it :)

It would be great if PyCellStudio (or KLayout for that matter) exported an environment variable to distinguish these cases. Unfortunately, from what I can see, KLayout does not.

A try-catch-block would be a nice workaround.

sergeiandreyev, 2025-06-24:
Hi @mole99, we merged the #549, could you please check it on your side as well?

Closed 2025-07-09.

Thread 550 (2025-06-20):

FFT Output Interpretation Issues: Resolution Effects, Frequency Shifts and Magnitude Scaling,

Atif07Ali, 2025-06-20:
System Information:
qucs-s version: 25.1.2
ngspice version: 44

**1. FFT Magnitude Varies with Frequency Resolution (df)**
I've observed that changing the FFT frequency resolution (df) from 10 MHz to 1 MHz causes a significant variation in the output magnitude, even though the input signal remains unchanged.
Could you explain how the FFT magnitude depends on df?

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

**2. FFT Peak Shifts When Bandwidth (BW) is Narrowed**
When I reduce the FFT analysis bandwidth (BW) to below the input signal frequency (140 GHz), the FFT peak unexpectedly appears at other frequencies within the selected range, instead of remaining at 140 GHz. Since the input is a pure 140 GHz sinusoid, there should not be any frequency spike except at 140 GHz. The appearance of peaks at other frequencies is unexpected.
Could you give some insights into this behavior?

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

**3. Clarification Needed on FFT Magnitude Scaling**
When applying a 1 mV peak sinusoidal input at 140 GHz, the resulting FFT magnitude is approximately 902 μV. This value does not correspond clearly to either the peak or RMS of the input signal. Could you please clarify how the FFT magnitude is computed and whether it represents the peak value, RMS, or a window-scaled quantity? Understanding this would help interpret the results more accurately.

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

dwarning, 2025-06-21:
This is not an PDK issue.
I would propose to open a case in [ngspice users discussion forum](https://sourceforge.net/p/ngspice/discussion). But simple spice files w/o unneeded library entries are preferable.

Atif07Ali, 2025-06-21:
@dwarning I have created a ticket on SourceForge

Thread 551 (2025-06-20):

Simulation error for resistors in Xyce

hpretl, 2025-06-20:
When I try to simulate a simple circuit using resistors, I now get this error:

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

Until recently, this example ran clean.

hpretl, 2025-06-20:
@KrzysztofHerman Thanks for the hint, now it works again!

Closed 2025-06-26.

Thread 557 (2025-06-25):

Double prefix in stdcell names in verilog netlist created by xschem

FlinkbaumFAU, 2025-06-25:
# Error description
When creating a verilog netlist from a schematic in xschem the cellnames contain the pdk-name two times, such as `sg13g2_sg13g2_inv_1`. This lead to unnecessary complications when trying to import the netlist in openroad.
# Expected Behaviour
Export a netlist with cellnames equivalent to the cellnames in `sg13g2_stdcell.v`
# Reproducibility
[test.sch](https://github.com/user-attachments/files/20904096/test.sch.txt) contains a minimal circuit with one inverter. When exporting the verilog netlist, it yields:
```
module test
(
  output wire output,
  input wire input
);
sg13g2_sg13g2_inv_1
x1 (
 .A( input ),
 .Y( output )
);

endmodule
```
which contains the double prefix

Closed 2025-06-26.

Thread 562 (2025-06-26):

Questions about sealring For MPW shuttle runs

EngGhaith, 2025-06-26:
Hi
I wanna ask if this mtal enclosure in the sealring cell would be also on chip, or it would be cut out?

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

Because I wanna place Antenna on chip near to chip edge, and do not want to short it.

Another question about p-cell parameters:

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

What are sub! label and slit?
And what do the options 't' and 'nil mean?

EngGhaith, 2025-06-26:
If it is necessary, I am allowed to flatten this cell and remove the edges near antenna?

Closed 2025-07-02.

Thread 569 (2025-06-30):

HBT DRC and MPW

EngGhaith, 2025-06-30:
Hi
HBTs have always this DRC-problem in the library cell itself.

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

If I want to submit my design to free MPW shuttle run, would that be a problem? Would the system refuse my design because of that?
If yes, then how to handle it?

EngGhaith, 2025-06-30:
[NPNTest.zip](https://github.com/user-attachments/files/20978576/NPNTest.zip)
@sergeiandreyev
Here is one!

EngGhaith, 2025-06-30:
By the way:
I have to verify minimum rule set only, not maximum, or?

sergeiandreyev, 2025-06-30:
> If I want to submit my design to free MPW shuttle run, would that be a problem? Would the system refuse my design because of that?

for that one, yes, only min rule set

akrinke, 2025-07-01:
The problem is that the emitters must be labeled with the text "E" on the layer TEXT.drawing. In your GDS, they are marked with "E1", "E2", ... on layer Metal2.text.

EngGhaith, 2025-07-01:
> The problem is that the emitters must be labeled with the text "E" on the layer TEXT.drawing. In your GDS, they are marked with "E1", "E2", ... on layer Metal2.text.

Forget my labels and place any HBT from cell library and do DRC.
You would have same problem.

d-m-bailey, 2025-07-03:
@sergeiandreyev @KrzysztofHerman Can you help me understand how bipolar transistors are implemented in the iHP tapeout process?

On page 47 of [SG13G2_os_layout_rules.pdf](https://github.com/IHP-GmbH/IHP-Open-PDK/blob/main/ihp-sg13g2/libs.doc/doc/SG13G2_os_layout_rules.pdf), it states

> Bipolar design rules are not disclosed due to IP reasons. Additional layers will be added during the tape out procedure for mask generation. Changing the given layouts may result in catastrophic device malfunction. The IHP library provides a number of predefined devices shown in the follow sections. Do not modify these layouts/abstracts.

The various devices appear to be parameterizable - `npn13G2` has Nx from 1 - 10, `npn13G2L` has Le from 1.0u - 2.5u and Nx from 1 to 4, and `npn13G2V` has Le from 1.0u to 5.0u and Nx from 1 to 8. Are there pcells available for open source tools?

How do you determine the data to replace with gds created from open source tools?

For example, the NPNTest.zip contains a gds file that has 12 variations of `npn13G2L`, but I don't see anyway to extract the parameters than the cells were created with.

sergeiandreyev, 2025-07-22:
> Yes, the problem is already in the library. The PyCell code should create these labels. In the meantime, you can create the labels yourself and the `V1.a` errors will be gone.

@akrinke, yes, confirm that one!
@EngGhaith, please update the `dev` and try with the latest Pcells, it should be fixed now

EngGhaith, 2025-07-22:
> > Yes, the problem is already in the library. The PyCell code should create these labels. In the meantime, you can create the labels yourself and the `V1.a` errors will be gone.
>
> [@akrinke](https://github.com/akrinke), yes, confirm that one! [@EngGhaith](https://github.com/EngGhaith), please update the `dev` and try with the latest Pcells, it should be fixed now

Thank you @sergeiandreyev
It works now!

Closed 2025-08-13.

Thread 570 (2025-07-01):

Phase Noise Estimation from Transient Simulation — Clarification on Noise Model Inclusion

Atif07Ali, 2025-07-01:
I'm currently designing a 140 GHz mmWave oscillator using the IHP SG13G2 open PDK within the Qucs-S 25.1.2 + Ngspice 44.2 flow. Since phase noise analysis isn’t natively supported in this flow, I’m estimating phase noise manually by post-processing transient simulation data in Python. This includes DC removal, applying a Hanning window, performing an FFT, and computing the single-sideband phase noise at offset frequencies. However, the results I’m observing appear unrealistically low, which makes me concerned that the device noise models may not be active during transient simulation.

Are transistor and passive noise models (e.g., BJT thermal/flicker noise, resistor noise) included by default in Ngspice transient simulations when using this PDK, or is there a specific option or model directive required to enable noise contributions?

Thread 574 (2025-07-02):

rppd instances in sg13g2_io.spi have no bulk terminal defined

devstdin, 2025-07-02:
All `rppd` instances in [sg13g2_io.spi](https://github.com/IHP-GmbH/IHP-Open-PDK/blob/dev/ihp-sg13g2/libs.ref/sg13g2_io/spice/sg13g2_io.spi) lack a bulk terminal and fail to simulate after this [commit](https://github.com/IHP-GmbH/IHP-Open-PDK/commit/5624561f498304a2eae70bd3145eecef514baf6e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).

KrzysztofHerman, 2025-07-03:
@devstdin thank you for reporting, indeed we have to fix it.

KrzysztofHerman, 2025-07-07:
@devstdin could you please checkout this PR #576

devstdin, 2025-07-08:
@KrzysztofHerman Your fix works for me. Thanks!

Closed 2025-07-08.

Thread 587 (2025-07-10):

xschem ngspice .include .save file

fgTUBerlin, 2025-07-10:
After installing, I tried to run the xschem test file and always got the same error as here:
https://github.com/IHP-GmbH/IHP-Open-PDK/issues/497 (Could not find include file dc_hv_nmos.save)

Unfortunately, my xschem doenst show the mentioned "IHP button" to "generate the save file". Is there something wrong with the installation?

In case someone has a similar issue, in the end i could solve it by removing the line ".include dc_hv_nmos.save" from the ngspice block/file. Is it possible that there has been an update in the install.py in xschem that removed the need for ".include dc_hv_nmos.save"?

If relevant, i'm using Rocky Linux 8.10

sergeiandreyev, 2025-07-15:
Hi @fgTUBerlin,
> Unfortunately, my xschem doenst show the mentioned "IHP button" to "generate the save file". Is there something wrong with the installation?

indeed, if you do not see that one:
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
your tools/PDK environment is not up-to-date..
please make sure you're using latest `dev` branch of the PDK and recent `xschem` version

Thread 589 (2025-07-10):

Parameter m (multiplier) missing in HBT xschem symbols (model files are fine)

p-fath, 2025-07-10:
I've recognized that in xschem, the multiplier m is missing in the HBT symbols. It would be advantageous to have it beside the Nx parameter, because an implementation with 30 HBTs requires 3 instances in parallel in the schematic, with each instance having Nx=10 in the current implementation. Using XQ1[0..2] is possible, but would not be a good solution.

Probably the multiplier m was not used due to the actual LVS implementation?

This is a snippet of npn13G2.sym: lvs_format="@spiceprefix@name @pinlist @model le=900e-9 we=70.0n m=@Nx".
Something like @Nx*@m would also be possible for the lvs_format variable or could the LVS be updated easily so that it supports Nx=.. and m=...?

Thread 593 (2025-07-13):

Request to update the layout parameterised cells in ihp 130nm

DiarmuidSLICE, 2025-07-13:
Hi,

At present the parameterised cells (p-cells) do not include base metal layers. They go to gate poly layer only.
This means M1 strips need to be drawn over each S/D. In addition, the poly gate extensions need to be created
to enable hook up to the gates. This can be extremely time consuming when trying to keep everything DRC clean.

Request is therefore to have p-cells where you can specify the following:

- Metal you want to route into the S/D (e.g. you specify M2, then M1 + M2 strips appear across the S/D regions)
- Gate poly extensions should be included by default

This is typically what is offered in industry and is most likely a small edit to the existing p-cells (which would have a
massive impact in terms of time saving).

Thanks,

Diarmuid

sergeiandreyev, 2025-07-15:
Hi @DiarmuidSLICE, thank you, now it's under internal review..

DiarmuidSLICE, 2025-07-16:
Yes @sergeiandreyev . I am referring to MOSFET Pcells. Let me know if you would like me to prepare slides to illustrates things more.

DiarmuidSLICE, 2025-07-19:
Great. Im on holidays right now. Back July 28th so will email slides later that week. Probably no point doing any further work on this until I send the slides as they will specify exactly what will work best.

DiarmuidSLICE, 2025-08-01:
Just uploaded the ppt there now. It explains things in good detail but if you feel a meeting would also be beneficial, please feel free to schedule one.

What sort of effort is this request and if accepted, what would be a realistic timeline for it?

Thanks,

DiarmuidSLICE, 2025-08-08:
Great! Looking forward to the outcome!

Thread 594 (2025-07-15):

Polarity in ESD-Devices is wrong in LVS

EngGhaith, 2025-07-15:
Hi everybody!

Xschem:

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

Netlist:

```
.SUBCKT TESTESD VDD
*.PININFO VDD:B
D1 sub! VDD nmoscl_4 m=2
.ENDS
.GLOBAL sub!

```
Klayout LVS:

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

Files: (Xschem+Klayout)

[TESTESD.zip](https://github.com/user-attachments/files/21229534/TESTESD.zip)

Extracted netlist:
```
.SUBCKT TESTESD VDD SUB!
D$1 SUB! VDD nmoscl_4 m=2
.ENDS TESTESD
```

Description:
Although the test for this test case is LVS pass, but it says that the pins should be flipped.
In bigger circuit would the test fail. Here it is OK because we do not have any other components tied to these nets.
Please consider that by netlist generation / LVS extraction to be repaired.

Thank you in advance.
Ghaith.

d-m-bailey, 2025-07-15:
@KrzysztofHerman @FaragElsayed2
Actually, the problem might be in the `xschem` [symbol](https://github.com/IHP-GmbH/IHP-Open-PDK/blob/main/ihp-sg13g2/libs.tech/xschem/sg13g2_pr/nmoscl_2.sym) or `ngspice` model. The xschem symbol has the ports in `vss, vdd` order - standard diode order annode, cathode.
```
B 5 -2.5 27.5 2.5 32.5 {name=vss dir=inout propag=1}
B 5 -2.5 -32.5 2.5 -27.5 {name=vdd dir=inout pinnumber=2}
```

However, in the [ngspice simulation models](https://github.com/IHP-GmbH/IHP-Open-PDK/blob/main/ihp-sg13g2/libs.tech/ngspice/models/sg13g2_moslv_mod.lib), the ports are reversed.
```
* ESD MOS Clamp devices
*****************************************************************
.subckt nmoscl_2  VDD VSS
+l=0.36u w=168u m=1 ng=1 trise=0  as = 58e-12  ad = 58e-12 pd = 336u ps = 336u rfmode=0 pre_layout=1

.include sg13g2_moslv_parm.lib

 Nsg13_lv_pmos VDD VSS VSS VSS nmoscl_psp w='w' l='l' nf='ng' as='as' ad='ad' pd='pd' ps='ps' mult='m'  dta=trise ngcon=2
.ends nmoscl_2

.subckt nmoscl_4  VDD VSS
+ l=0.36u w=168u m=1 ng=1 trise=0 as = 114e-12  ad = 114e-12 pd = 672u ps = 672u rfmode=0 pre_layout=1
.include sg13g2_moslv_parm.lib

Nsg13_lv_pmos VDD VSS VSS VSS nmoscl_psp w='w' l='l' nf='ng' as='as' ad='ad' pd='pd' ps='ps' mult='m'  dta=trise ngcon=2
.ends nmoscl_4 
```

sergeiandreyev, 2025-07-16:
@d-m-bailey, thank you for looking into this!
the port order of these devices should be "VDD VSS" (it relates to simulation models, netlists, etc.)

KrzysztofHerman, 2025-08-26:
@EngGhaith @d-m-bailey  the issue was solved in #600. Please note that the diode symbol binds to `nmos` device in clamp configuration so it does not follow the (D anode cathode dmodel) pin order convention.

Thread 595 (2025-07-15):

issue with the active and gatpoly filler in case where Pwell.block is used

sergeiandreyev, 2025-07-15:
I found issue with the active and gatpoly filler in the case where i use Pwell.block in my layout. The DRC clearly states that the min distance to the Pwell block should be min 1.50um. Its not directly related to the exclusion layer, so maybe this should be a seperate issues.:

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

_Originally posted by @PhillipRambo in https://github.com/IHP-GmbH/IHP-Open-PDK/issues/564#issuecomment-3068276241_

Thread 616 (2025-07-27):

stdcells pinorder mismatch between symbols and spice -> breaks simulation

Ayexor, 2025-07-27:
In the xschem symbols, the pins of stdcells are ordered alphabetically, while in `ihp-sg13g2/libs.ref/sg13g2_stdcell/spice/sg13g2_stdcell.spice`, they are ordered by type.
Using the stdcells in xschem and `.inc`-ing the later file thus breaks simulation due to mismatched pins.

I assume this (symbols in schematics and including the spice lib) is the intended use of the PDK, as I have not found any schematics for the stdcells in this PDK.

I thus corrected the pin order in the symbols, as the pin order by type feels more familiar.
If this interferes with something else (LVS, other simulators?) or if I'm using the PDK the wrong way, please let me know.

Ayexor, 2025-08-06:
Well, simulation in `main` is currently broken, although fixed in `dev`. (As discussed in #617.)
If you do not consider this an issue worth tracking and having fixed soon, feel free to close this.

Closed 2025-08-06.

Thread 622 (2025-07-31):

Bad obstruction dimension in LEF views of I/O Filler cells

RTimothyEdwards, 2025-07-31:
The I/O cell library has incorrect dimensions of obstruction layers in the LEF views of the I/O "Filler" cells.
The same error appears in every Filler cell LEF view.
For example, from `sg13g2_Filler1000`:
```
  OBS
    LAYER Metal1 ;
      RECT 0.000 0.000 5.000 180.000 ;
    LAYER Metal2 ;
      RECT 0.000 0.000 5.000 180.000 ;
    LAYER Metal3 ;
      RECT 0.000 0.000 80.000 178.000 ;
    LAYER Metal4 ;
      RECT 0.000 0.000 80.000 178.000 ;
    LAYER Metal5 ;
      RECT 0.000 0.000 80.000 178.000 ;
    LAYER TopMetal1 ;
      RECT 0.000 0.000 80.000 178.000 ;
    LAYER TopMetal2 ;
      RECT 0.000 8.500 5.000 132.500 ;
    LAYER Via1 ;
      RECT 0.000 0.000 5.000 180.000 ;
    LAYER Via2 ;
      RECT 0.000 0.000 5.000 180.000 ;
  END
```
The obstruction areas for Metal3, Metal4, Metal5, and TopMetal1 all extend out to 80um, which is wider than the cell.  The same four layers appear with the same 80um width in all of the Filler cells.  This looks like a "cut & paste" error where the obstructions were copied from an 80um wide cell like the power and ground I/O cells, and those four layers were not edited to match the width of the Filler cells.  It is easy enough to fix.

Closed 2025-08-27.

Thread 626 (2025-08-04):

Simulation Issue with sg13g2_sdfbbp_1: Cannot Test Falling Edge & Potential Pin Order mismatch

adarshvp123, 2025-08-04:
Hello,

I am reporting a significant issue when simulating the sg13g2_sdfbbp_1 standard cell in ngspice. The primary problem is that it seems impossible to test a CLK->Q falling edge (1 -> 0) transition . Furthermore, an incorrect pin order does produce a transition,

**Main Issue: Falling Edge Test Fails with Correct Pin Order**

When using the pin order specified in the .subckt definition (Q Q_N CLK D...), the cell appears to initialize with Q=0 and cannot be forced into a Q=1 state to begin the test. Both Q and Qn remains same in this case

Testbench with Correct Pin Order:
This testbench uses the correct positional mapping from the .subckt line. It attempts to test a 1 -> 0 transition.

```
Generated spice
* ================================================================
* TESTBENCH 1: CORRECT PIN ORDER
* ================================================================
.lib 'cornerMOSlv.lib' mos_tt
.include 'sg13g2_stdcell.spice'
.global VDD VSS

* --- Parameters ---
.param VDD_VAL=1.5, C_LOAD=64.8f, CLK_SLEW=0.3294n, D_SLEW=0.3294n
.param CLK_START_TIME=5.0e-9, delta_ns=0.5

* --- Power & DUT ---
VVDD VDD 0 DC {VDD_VAL}
VVSS VSS 0 DC 0
* Pin Order: Q Q_N CLK D RESET_B SCD SCE SET_B VDD VSS
Xdut n_q n_qn n_clk n_d n_reset_b n_scd n_sce n_set_b VDD VSS sg13g2_sdfbbp_1

* --- Stimuli for 1->0 test ---
V_CLK n_clk VSS PULSE(0 {VDD_VAL} {CLK_START_TIME} {CLK_SLEW} {CLK_SLEW} 10n 20n)
V_D n_d VSS PULSE({VDD_VAL} 0 {CLK_START_TIME-(delta_ns*1e-9)} {D_SLEW} {D_SLEW} 10n 20n)
V_RESET_B n_reset_b VSS DC {VDD_VAL}
V_SET_B n_set_b VSS DC {VDD_VAL}
V_SCE n_sce VSS DC 0
V_SCD n_scd VSS DC 0

* --- Loads & Analysis ---
CLoad_Q n_q VSS {C_LOAD}
CLoad_QN n_qn VSS {C_LOAD}
.options TEMP=25 TNOM=25 METHOD=TRAP GMIN=1e-15 RELTOL=1e-3
.tran 10p 10n uic
.end

```

Result: With this correct wiring, the simulation shows Q starts at 0 and stays at 0. No transition is observed. We believe this is because the necessary uic flag forces a Q=0 initial state, and all attempts to override this with asynchronous set pulses have failed, suggesting a startup race condition.

**Secondary Issue: Incorrect Pin Order Produces a Transition**

 if we rearrange the pins in the Xdut instantiation to a different order (which happens to be roughly alphabetical), a transition is observed.

Testbench with Incorrect (Alphabetical-like) Pin Order:
This testbench uses an incorrect pin order but is the one that produces an output transition.

Generated spice
```
* ================================================================
* TESTBENCH 2: INCORRECT (ALPHABETICAL-LIKE) PIN ORDER
* ================================================================
.lib 'cornerMOSlv.lib' mos_tt
.include 'sg13g2_stdcell.spice'
.global VDD VSS

* --- Parameters ---
.param VDD_VAL=1.5, C_LOAD=64.8f, CLK_SLEW=0.3294n, D_SLEW=0.3294n
.param CLK_START_TIME=5.0e-9, delta_ns=0.5

* --- Power & DUT ---
VVDD VDD 0 DC {VDD_VAL}
VVSS VSS 0 DC 0
* Pin Order: CLK D Q Q_N RESET_B SCD SCE SET_B VDD VSS (Incorrect)
Xdut n_clk n_d n_q n_qn n_reset_b n_scd n_sce n_set_b VDD VSS sg13g2_sdfbbp_1

* --- Stimuli for 1->0 test ---
V_CLK n_clk VSS PULSE(0 {VDD_VAL} {CLK_START_TIME} {CLK_SLEW} {CLK_SLEW} 10n 20n)
V_D n_d VSS PULSE({VDD_VAL} 0 {CLK_START_TIME-(delta_ns*1e-9)} {D_SLEW} {D_SLEW} 10n 20n)
V_RESET_B n_reset_b VSS DC {VDD_VAL}
V_SET_B n_set_b VSS DC {VDD_VAL}
V_SCE n_sce VSS DC 0
V_SCD n_scd VSS DC 0

* --- Loads & Analysis ---
CLoad_Q n_q VSS {C_LOAD}
CLoad_QN n_qn VSS {C_LOAD}
.options TEMP=25 TNOM=25 METHOD=TRAP GMIN=1e-15 RELTOL=1e-3
.tran 10p 10n uic
.end

Result: This simulation produces an output transition.

This conflicting behavior leads to two main questions:

Pin Order Confirmation: Can you please confirm that the pin order in the .subckt definition (Q Q_N CLK D...) is indeed the correct, intended order for instantiation? The fact that an alphabetical-like order produces a result is confusing.

Recommended Initialization Procedure: Given the simulation difficulties, is there a recommended procedure or a reference testbench for reliably initializing the sg13g2_sdfbbp_1 cell to a Q=1 state? This is necessary to characterize any falling edge timing parameters.

I am attaching plots obtained for no transition(correct pin order) and no transition(incorrect pin order)

Thank you for your time and help.

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

sergeiandreyev, 2025-08-07:
Hi @adarshvp123, our standard cell developer is currently on leave, so we’ll need to wait for their response.

Thread 633 (2025-08-07):

Incorrect LVS netlists created with xschem symbol updates.

d-m-bailey, 2025-08-07:
This applies to #607.

It is my understanding that `spiceprefix` is used to generate valid spice file and that removing it may cause problems.

For example, if someone assigns the name `Decap1` to a capacitor, without the `spiceprefix`, this would be output as
```
Decap1 ...
```
which is a diode. I don't think we want the user to be responsible for ensuring the prefix matches the device model.

With a `spiceprefix` of `C`, this would be output as
```
CDecap1 ...
```

The problem that you might be facing is that the simulation (ngspice) and LVS (klayout) netlists may be expecting different device names. ngspice simulation expects device names that start with `X` that match the [primitive model subcircuits](https://github.com/IHP-GmbH/IHP-Open-PDK/blob/main/ihp-sg13g2/libs.tech/ngspice/models/capacitors_mod.lib) (line 51 for `cap_cmim`), while klayout expects device names that start with `C`. Incidentally, the current `magic` tech expects that many devices that start with `X`.

One solution is to use a separate `lvsprefix` for LVS.
This results in the misinterpretation of devices as explained above. Adding an `lvsprefix` variable to the symbol would solve the problem.

See https://github.com/IHP-GmbH/IHP-Open-PDK/pull/607#pullrequestreview-3094741424

Thread 634 (2025-08-08):

Information required: Declaration of blank_circuit in LVS check (Klayout)

anbala90, 2025-08-08:
The LVS check for a design is not successful with IHP-open-PDK tech-based IO Cells (Filler, Corner, IO pad) and SRAM blocks using the Ruby-based LVS rules in sg13g2.lvs, even though extraction and verification over std cells are fine. It would be greatly appreciated if anyone could guide me on how to filter out SRAM macros/blocks and IO cells from the LVS check of the full-chip.

Hint: No expected results achieved while trying to add the below comments as per the Klayout guide
netlist.blank_circuit("CIRCUIT_NAME")
schematic.blank_circuit("CIRCUIT_NAME")

anbala90, 2025-08-13:
Hello @d-m-bailey,

Thank you for your prompt response, and sorry for the delay. Please find the attached verification report.

1) Problem
-------------
     In the lvs check,  the IO-Filler cells and Corner cells are not recognized by Klayout while it extract the schematic view from CDL netlist.

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

In the sub-circuit, we can see that, the Filler cells encapsulate only some PIN information.

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

2) IOPad cells
----------------
    In IOPad cells, both extraction, schematic and layout extraction. are successful, but with mismatched pins and nets

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

3) Memory cell
-----------------
  In memory cells, Klayout tool could not extract some subcircuits as in the picture below

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

Also, the other sub-circuits show mismatched nets and pins

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

anbala90, 2025-08-13:
Thank you very much for the reply. Give me some time, I will update accordingly. Yes, I have a target Tapeout on September 14.

Thread 648 (2025-08-20):

Usage of the substrate 40/0 layer and digisub 60/0 layer

d-m-bailey, 2025-08-20:
@KrzysztofHerman @sergeiandreyev

Could you explain the usage cases and differences between the `substrate 40/0` layer and the `digisub 60/0` layer?
They are both defined as "Substrate recognition layer for LVS" in the `SG13G2_os_layout_rules.pdf` file.

Currently, the klayout rules use `digisub 60/0` to create virtual substrate regions that do not connect to adjacent substrate regions.
I'm not sure of the `substrate 40/0` intended usage, but currently it blocks the extraction of almost all devices (`cap_cmim` is allowed).

However, in the magic extraction rules, `substrate 40/0` is used to create the isolated substrate regions and `digisub 60/0` is not defined.

@FaragElsayed2 @RTimothyEdwards @H-Ojiro

KrzysztofHerman, 2025-08-20:
@d-m-bailey
The 'substrate 40/0' is the default p-type substrate and the `digisub 60/0` layer is used for mixed signal circuits.
AFAIK all originates with the introduction of the `ptap1` device, which is used in analog/RF designs, which can bring troubles in a case of a layout where you have analog and digital cells.  In our standard cells we do not provide tap cells since the `VSS` and `VDD` are connected to the `bulk` and `nwell` respectively.  LVS recognizes this connections as shorts and if you place on the same layout the `ptap1` device you can get conflict with the LVS. That is why you should use `digisub' layer to enclose the digital part of the layout.

Here you can see two examples of the connection to the bulk in a standard cell using: a) ptap device and b) using silicide
a) in `sg13g2_inv1` cell the layers at the bottom are the same like in a `ptap1` device, active layer of nmos and under VSS strap are separated

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

b) in `sg13g2_tiehi` cell the active of the `nmos` devices and under the VSS strap are connected what implies a conductive silicide layer over it (duplicated with metal connection to both, what not always is a case).

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

Long story short the introduction of these two layers permits to provide some more information to the  LVS  deck in a case of mixed signal designs.

d-m-bailey, 2025-08-20:
@KrzysztofHerman thanks for the explanation. I think I understand the issue of substrate shorts of different VSS voltages through p-diffusion over psubstrate and the use of these layers to virtually separate regions.

The question I had is why are two layers needed? They should both provide the same functionality, correct?

Thread 655 (2025-08-27):

Isolated ESD diodes are missing

simonwaid, 2025-08-27:
The isolated ESD diodes (idiodevdd_2k, idiodevdd_4k, idiodevss_2k, idiodevss_4k) as documented here:

`https://ihp-open-pdk-docs.readthedocs.io/en/latest/verification/lvs/04_07_esd.html`
They are missing in the spice library and the ESD pcell. They would be useful for low-leakage, guarded input pins.

It would be great to have the spice model. The lack of their presence in the pcells can be worked around, as there is a gds file of them in the test cases.

sergeiandreyev, 2025-08-29:
Hi @simonwaid, it should be cleaned-up, these devices are obsolete - were rarely used and we do not have proper models for them.

simonwaid, 2025-09-01:
@sergeiandreyev I hope that with cleaned-up, you don't mean removed. I wouldn't know how else to design an ESD protection where the input pin needs to be guarded. But maybe you have an idea. Anyway, I'm using them, so +1 on he rarely used.

sergeiandreyev, 2025-09-01:
@simonwaid, in fact it was exactly what I was planning to do 😅 - remove all left-over references to `idiode*` devices
these device layouts are not part of `sg13g2_pr` library anymore, and the LVS testcases should be cleaned up to not cause confusion
Maybe at some point we will reconsider to include them in OpenPDK, but we will need to have the model to begin with

> I wouldn't know how else to design an ESD protection where the input pin needs to be guarded

Maybe @b10346 can help here?

Scafir, 2025-09-01:
Hi, I just wanted to mention that I am also quite interested in the isolated ESD diodes for my application (femto ampere current sensing for CERN).
An official gds in sg13g2_io or sg13g2_pr would be especially useful, as it would enable different teams to be able to compare measurements of critical values for a common device. In my case, I do not really mind the missing or incomplete models: as long as I can experimentally measure the leakage to be low enough, it means my project is technically feasible. I can live with reduced or more uncertain ESD behavior.

Thread 662 (2025-08-28):

Issue with new DRC deck and npn13G2 transistor

PhillipRambo, 2025-08-28:
When using the npn13G2 transistor and running a DRC, the new deck will throw "5.15. CntB.h1 Min. Metal1 enclosure of ContBar is 0.05 um
". I dont assume there is a problem with the Pcell therefore im blaming the DRC :) See attached image

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

FaragElsayed2, 2025-08-29:
Hi @PhillipRambo

There are some DRC violations will be waived for specific cells, we will support this soon.

Thread 664 (2025-08-28):

newer DRC script gives me Seal.m error

olisnr, 2025-08-28:
if i place 1 sealring PCell from the newest dev or main branch in a new KLayout file, i get an Seal.m error using the main DRC maximum script.

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

[sealring_only.gds.zip](https://github.com/user-attachments/files/22030043/sealring_only.gds.zip)

olisnr, 2025-09-02:
@FaragElsayed2 thanks a lot!

Closed 2025-09-02.

Thread 667 (2025-08-30):

LVS Bugs

p-fath, 2025-08-30:
Before starting the layout of my design, I tried to verify the LVS behaviour, however I've found some troubles here:

- [ ] 2x ptab placed in schematic (w=10u, l=0.3u) and in layout (pcell), connected together in layout with pin psub and pin vss. In layout they are connected together with M1.drawing and a pin vdd is placed on layer M1.text. LVS recognizes the pins of layout and schematic, but does not throw an error while substrate is connected to vdd, in schematic to vss?
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

- [ ] when the 2 symbols of ptab are both fliped an connected to the complement pin in the schematic but in layout everything is kept the same, there is no difference behaviour in after running LVS?

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

p-fath, 2025-08-30:
Same for the resistor rppd. LVS does not pass.

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

[rppd_eval.zip](https://github.com/user-attachments/files/22058903/rppd_eval.zip)

d-m-bailey, 2025-09-01:
@p-fath The current klayout rule set does not check pin names. It just connects topology. I think the capability to check pin names (or at least a helper function to do so) was implemented in klayout 0.30.2.

We're working on a rule change that will flag schematic ports that aren't matched in the layout.

This is the answer to your first 3 comments.

Your 4th comment about hand drawn deep nwell ntap not being extracted as ntaps is because only ntaps that have the `well` label on layer `63/0` are recognized as devices. The connectivity is there whether the ntap device is recognized or not. For ptap on the hbt device, you'll need the `sub!` text to extract that as a `ptap` device.

Resistors have recently had a third substrate terminal added. The extraction rules may not handle this yet. Can't be sure unless we know the pdk version that you are using. The resistors schematic symbols may have been recently changed to ignore the spiceprefix parameter. I think klayout is expecting an `R` device in the schematic spice. Do you have an `X` device now?

Thread 674 (2025-09-03):

Transient simulation converges on one computer but not on another

mohemza, 2025-09-03:
I have run the following netlist using ngspice on my personal laptop and the simulation works fine. When I run the same netlist on the external servers I run into timestep too small error. On both my laptop and the server I am using ngspice v44+.

[netlist_and_data.zip](https://github.com/user-attachments/files/22118998/netlist_and_data.zip)

dwarning, 2025-09-03:
Don't know your symbol. Write after NX=1 selft=0.
Switching off selfheating let the circuit simulate.

mohemza, 2025-09-04:
I added the selft=0 option and the note "The temperature limiting function received NaN" disappeared. However I still get a timestep too small error and my circuit does not simulate

dwarning, 2025-09-04:
This I got after few minutes:
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

Thread 675 (2025-09-07):

Full DRC deck not yet implemented in klayout

DiarmuidSLICE, 2025-09-07:
Hello,

The following DRCs have not yet been implemented in klayout:

$PDK_ROOT/$PDK/[libs.tech/klayout/tech/drc/MissingRules_maximal.md](http://libs.tech/klayout/tech/drc/MissingRules_maximal.md)

There are ~ 100 of them (e.g most DNW related DRCs have not been implemented).

Magic currently has a much more complete deck implemented. Same needs to be done for klayout to prevent users submitting "dirty" GDS files.

Creating this ticket to raise / track progress on this issue.

Regards,

Diarmuid

Thread 689 (2025-09-16):

`Cnt.c` in SRAM cells

sergeiandreyev, 2025-09-16:
I'm having a lot of violations of `Cnt.c` rule on SRAM cells:
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

but this is not expected since these are inside `DigiBnd.drw` and we have a custom rule:
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

Thread 690 (2025-09-18):

diodes.lib weakness

dwarning, 2025-09-18:
The actual ngspice library diodes.lib has following weaknesses:

- level parameter is misleading, ngspice uses level 1 and 3 - not level=2 (Fowler Nordheim tunnel diode is not implemented). ngspice converted level=2 to 1. So no bug is following but level=1 is correct.
- ngspice has parameter nbv and tcv for breakdown voltage calculation. So they should not commented out.
- actual ngspice version 45 and lower has no separate sidewall diode with own series resistor and own voltage, only sidewall diode with same voltage as the bottom diode. So parameter ikp and rsw should commented out. Separate sidewall diode extension will be implemented in version 46. Then these parameters are valid. As long as this changes not released deviations are expectable.
- model parameter calculations should be included in inverted commas
- dpantenna uses dpperim model not dperimeter

A modified and tested file is attached.

[diodes.lib.txt](https://github.com/user-attachments/files/22400389/diodes.lib.txt)

Closed 2025-09-22.
