IHP-GmbH/IHP-Open-PDK/(list of files, drawings)

Other design files:
ihp-sg13g2/libs.tech/klayout/tech/sg13g2.lyt
