IHP-GmbH/IHP-Open-PDK/(commit log)

2023-03-17 updated Gantt chart with the current status
2023-04-14 KLayout tech file: initial version
    [sg13g2.lyt]
2023-04-14 Added Apache 2.0 License header
    [sg13g2.lyt]
2023-06-28 Update README.md
    Removed comments about _allcells assembly
2023-08-04 MOS Spectre models (initial version - only low voltage)
2023-08-10 High Voltage MOS Spectre models
2023-08-11 Test structures (GDSII) and their documentation for the MOS device models
2023-08-16 Update sg13g2.lyt
    <lef-files>merged.lef</lef-files> added in order to stream GDS in Klayout
    [sg13g2.lyt]
2023-08-24 Add connectivity information to the klayout technology file
    This will allow to use 'Tools->Trace Net' and 'Tools->Trace All Nets'
    [sg13g2.lyt]
2023-09-11 added resistor models
2023-09-14 KLayout tech file: merging the update to the connectivity section from 'main'
    [sg13g2.lyt]
2023-10-10 xschem primitives and testcases added, ngspice and xyce models added
    [IHP_testcases.sch, ac_hbt_13g2.sch, ac_lv_nmosrf.sch, ac_mim_cap.sch, dc_diode_op.sch, dc_diode_temp.sch, dc_hbt_13g2.sch, dc_hv_nmos.sch]
2023-10-10 naming in ngspice/models changed
    [ac_lv_nmosrf.sch, dc_hv_nmos.sch, dc_hv_pmos.sch, dc_lv_nmos.sch, dc_lv_pmos.sch, dc_mos_cs_temp.sch, dc_mos_temp.sch, mc_hv_nmos_cs_loop.sch]
2023-10-11 NOT and NAND logic gates added, ptap1 symbol model changed, xschem README updated
    [IHP_testcases.sch, dc_logic_not.sch, tran_logic_nand.sch, tran_logic_not.sch]
2023-10-11 ptap1 orientation changed
    [dc_logic_not.sch, tran_logic_nand.sch, tran_logic_not.sch]
2023-10-11 psp_parm files merged into sg13g2_mosxx_parm.lib
    [IHP_testcases.sch]
2023-10-12 ptap1 and ntap1 removed from logic circuits
    [dc_logic_not.sch, dc_lv_nmos.sch, tran_logic_nand.sch, tran_logic_not.sch]
2023-10-18 RF pmos symbol added
    [tran_logic_nand.sch]
2023-10-19 renamed diodes_xyce.lib -> diodes.lib
2023-10-19 Update xschemrc
    1) Base of latest version from sky130A to increase compatibility
    2) Adapt handling of `PDK` and `PDK_ROOT` to standard usage
    3) Write sim results into current user directory into folder `simulation`
2023-10-19 Provided `xschem` examples should write into current user dir (assuming read-only PDK) and not explicitely load the OSDI
    [IHP_testcases.sch, ac_lv_nmosrf.sch, ac_mim_cap.sch, dc_diode_op.sch, dc_diode_temp.sch, dc_hbt_13g2.sch, dc_hv_nmos.sch, dc_hv_pmos.sch]
2023-10-27 stdcell LEF: sg13g2_o21ai_1 pin Y signal class fixed (POWER->SIGNAL) as a temporary workaround, LEF should be regenerated
2023-11-01 rhigh symbol model updated with a correct model name
    [dc_res_temp.sch]
2023-11-03 standard cells symbols partially done based on SKY130, the differences dumped into a file
    [ac_lv_nmosrf.sch, tran_logic_nand.sch]
2023-11-08 standard cells symbols updated, latches added and tested
    [IHP130_stdcells.sch, dc_lv_nmos.sch]
2023-11-10 KLayout PyCells: initial version of the wrapper library and sample cells
2023-11-10 Xschem library update
    1. Basic standard cells added
    2. simulations/ directory updated with scripts/ csv/ fig/ and README.md
    3. pre_osdi directive uncommented
    4. documentation updated
    [dc_hv_nmos.sch, dc_hv_pmos.sch, dc_logic_not.sch, dc_lv_nmos.sch, dc_lv_pmos.sch, dc_mos_temp.sch, digitest.sch, mc_hv_nmos_cs_loop.sch]
2023-11-28 Use more specific lef class for antenna and filler cells
2023-12-11 pnpMPA device: added measurements
2023-12-11 KLayout DRC: added CHECK_FILLER_RULES switch
2023-12-15 pnpMPA initial version: model, xschem support (w/l for reference only)
    [IHP_testcases.sch, dc_pnpMPA.sch]
2024-01-16 pnpMPA: fixed issue with pin order during netlist generation in Xschem
    [dc_pnpMPA.sch]
2024-02-16 First version of IO cells
    The sg13g2_io library; see ihp-sg13g2/libs.ref/sg13g2_io/doc/README.md
    for documentation of the current contents of this library.
2024-02-20 stdcells: fixed a22oi and sdfbbp cells (Liberty/Verilog) #42
    [sg13g2_stdcell.v]
2024-02-27 Klayout PyCell integration -PointList.compress() shall compress the current instance, fixed -fixed unintendend delivery of cmim-changes -reordered json layer list according to layer-number -removed u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
2024-02-29 KLayout .lyt: fixed dbu (#52)
    [sg13g2.lyt]
2024-03-01 diode models: fixed vj value in dperim (#24)
2024-03-07 Qucs-S support added, ready to basic test
    [dc_lv_nmos.sch]
2024-03-07 HV mos and basic HBT symbols added with examples
    [dc_hbt_13g2.sch, dc_hv_nmos.sch, dc_hv_pmos.sch, dc_lv_pmos.sch]
2024-03-07 examples improved
    [dc_hbt_13g2.sch, dc_hv_nmos.sch, dc_hv_pmos.sch, dc_lv_nmos.sch, dc_lv_pmos.sch, symbols.sch]
2024-03-07 hbt symbol updated
    [dc_hbt_13g2.sch, symbols.sch]
2024-03-08 npn13G2l and npn13G2v added
    [dc_hbt_13g2.sch]
2024-03-08 res and hbt example updated
    [dc_hbt_13g2.sch, resistors.sch, symbols.sch]
2024-03-08 basic and nonlinera libraries updated
    [ac_mim_cap.sch, dc_diode_op.sch, symbols.sch]
2024-03-13 xschem: updated inv_1 symbol, added inv stdcell testbench
    [tran_inv.sch]
2024-03-14 Adding setup for LVS, Adding mim cap device
2024-03-15 KLayout tech file: changed back dbu to 0.001
    [sg13g2.lyt]
2024-03-19 Adding lvs for mos & rfmos devices
2024-03-22 MOSFET models: removed refs to Spectre in headers, removed cr's in _stat.lib
2024-03-26 Updating testing for FETs, Adding some diode/RES devices
2024-03-27 sg13g2_pr.gds: fixed M1 drawing/pin layers in nmos device
2024-03-27 Updating some LVS devices like diodes
2024-03-28 Adding some LVS devices like taps, Adding custom reader, writer extractor
2024-03-31 Adding custom extractor and testcases for res devices, adding setup for bjt
2024-04-01 Adding some BJT devices, Updating testcases and regression
2024-04-02 resistor symbols modified, b and m parameters cosidered in the netlist
    [dc_res_temp.sch]
2024-04-02 Adding some bjt devices
2024-04-02 KLayout Pycells: fixed 'resistance' value calculation to be consistent with internal PDK
2024-04-03 resistors m parameter fixed
2024-04-03 standard cells symbols updated, netlist format aligned with SPICE format
    [IHP130_stdcells.sch]
2024-04-03 Updating BJT devices and adding some testcases
2024-04-04 Adding setup for ind devices
2024-04-08 Completing ind devices, adding some ESD devices with testcases
2024-04-13 Adding all esd devices, adding schottky, adding some tests
2024-04-15 Adding varactor device, updating some classes
2024-04-16 Updating some devices like FETs, Completing caps
2024-04-17 Updating FETs and cap devices
2024-04-18 Updating params for some devices, increasing coverage for some dev
2024-04-19 KLayout Pycells: restored 'rsil' device
2024-04-22 KLayout layer prop: purpose names changed from short to full
2024-04-22 Updating docs and some LVS devices
2024-04-23 Updating some LVS devices, Adding makefile for regression, Adding actions
    [sg13g2.lyt]
2024-04-24 mosfets symbols and related examples updated to support m parameter
    [dc_hv_nmos.sch, dc_hv_pmos.sch, dc_lv_nmos.sch, dc_lv_pmos.sch]
2024-04-24 symbols.sch updated
    [symbols.sch]
2024-04-24 support for rhigh and rppd added, heat transfer layer name issue
2024-04-24 Completing some updates for LVS devices
2024-04-29 Updating terminal order for diodes, support using w,l for some devices
2024-04-29 Updating LVS devices like diodes, res, taps
2024-04-30 stdcells: updated wire_loads in Liberty views to be compatible w/ ORFS
2024-05-02 Updating LVS rule deck for resistors
2024-05-03 stdcells CDL: fixed pin order for power/ground pins in inv_4, inv_8 and inv_16 cells (#94)
2024-05-03 Pycells: changed 'is 1' to '== 1' in rppd device code
2024-05-06 Liberty view for IO cells updated. It contains all cells definition an make it feasible to run ORFS flow
2024-05-07 Fixing some LVS issues, Updates GUI menus, Adding more patterns
    [sg13g2_io.v]
2024-05-09 Expanding testing coverage for some LVS devices, Updating rule decks after testing
2024-05-14 Increasing LVS testing coverage for res devices
2024-05-19 Adding support for all metal res, Updating layers def, Updating resistor extractor, Updating actions version
2024-05-21 Update for IO cells; contains critical fix for IOPadVdd
    * IOPadVdd: remove spurious diodes from netlist and update IOPadVdd
    internal connections in layout to fix reported problem.
    Previous layout did not have proper ESD on Vdd pin and also resulted in
    iovdd to iovss static current.
    * Update performance simulation after fixing the diode model. Removes the
    NA values present in the result tables.
    * Set LEF version to 5.7
    * Fix indentation in dummy liberty file.
2024-05-21 libs.tech: klayout: tech: Add EdgeSeal.boundary to sealring
    After filler metal got removed, the Passiv layer was placed at the edge
    of the sealring and, therefore, also at the edge of the die. Add a
    configurable EdgeSeal.boundary layer to the sealring to fill the gap
    between the sealring and die edge with metal fill.
2024-05-21 KLayout Pycells: added device name label (TEXT.drw) to 'nmos'
2024-05-21 Adding some deep/flat tests, Updating FETs/RFFETs derivations, Adding support for case insensitive patterns, use deep mode by default
2024-05-23 Updating actions to be triggered on lvs changes, Updating esd and diodes derivations
2024-05-27 Some updates on top of #121
    * Remove labels on ESD diodes so they are now recognized as regular
    d(p)antenna diodes
    * Increase width to minimum 0.48µm to account for new rule not yet in
    DRC check.
2024-05-29 Update README.md
    OpenROAD, OpenROAD flow scripts, Qucs-S added as supported EDA tools.
2024-05-30 Klayout PyCell integration -added partial implementation of class Pin from PyCell API -added partial implementation of class Term from PyCell API -added support for pins/terminals -added support for 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
2024-06-02 Removing NO DRC filter for LVS runset for all layers
2024-06-04 @spiceprefix added for mos devices and diodes, RF symbols added for HV mosfets
    [IHP_testcases.sch, ac_lv_nmosrf.sch, dc_diode_op.sch, dc_hv_pmos.sch, dc_mos_cs_temp.sch]
2024-06-05 DRC checks for xschem added in xschemrc (mosfets, hbt, diode, res, mim), symbols modified, some testcases modified
    [ac_lv_nmosrf.sch, ac_mim_cap.sch, dc_diode_op.sch, dc_hbt_13g2.sch, dc_hv_nmos.sch, dc_lv_nmos.sch, dc_res_temp.sch, sp_rfmim_cap.sch]
2024-06-12 Xschem testcases *.sch files updated to support lower-case w and l
    [ac_mim_cap.sch, dc_hv_pmos.sch, dc_logic_not.sch, dc_lv_pmos.sch, dc_mos_cs_temp.sch, dc_mos_temp.sch, dc_res_temp.sch, mc_hv_nmos_cs_loop.sch]
2024-06-12 Klayout PyCell integration -fixed pin label creation by removing extra text generation -added missing self-argument in class Box
2024-06-12 libs.tech: klayout: drc: Use correct border
    The DRC report had multiple violations included which are
    relate to unclean calculation of the chip border.
    Based-on: Andreas Krinke <andreas.krinke@tu-dresden.de>
2024-06-18 Remove merged.lef from klayout setup
    Removing reference to merged.lef which does not exist.
    [sg13g2.lyt]
2024-06-19 KLayout tech file: setting up technology specific grids, smallest (req) = 5nm
    [sg13g2.lyt]
2024-06-27 KLayout Pycells: updated device library name
2024-06-27 libs.tech: Klayout: tech: Add layer map
    OpenROAD requires the sg13g2.map file to correctly place each layer.
    Fix this here to not overwrite manually changes in
    OpenROAD-Flow-Scripts.
    [sg13g2.lyt]
2024-06-27 libs.tech: Klayout: tech: Add map file
    This file was copied from the OpenROAD-flow-scripts repository
    and should be maintained and kept here.
2024-06-27 libs.tech: Klayout: tech: sg13g2.lyt: Use empty lef-files
    OpenROAD-flow-scripts will search and replace for
    <lef-files>.*</lef-files>. Therefore, keep it empty in this syntax.
    [sg13g2.lyt]
2024-07-03 Pycells: removed via_stack device, it's obsolete
2024-07-11 KLayout Pycells: added NWell to 'dpantenna' device
2024-07-16 major change in ngspice model referencing, xschem testcases update, qucs-s examples updated
    [ac_lv_nmosrf.sch, ac_mim_cap.sch, dc_diode_op.sch, dc_hbt_13g2.sch, dc_hv_nmos.sch, dc_hv_pmos.sch, dc_logic_not.sch, dc_lv_nmos.sch]
2024-07-18 Update xschemrc
    adding
    `append XSCHEM_LIBRARY_PATH :${XSCHEM_SHAREDIR}/xschem_library/devices`
    line
2024-08-06 KLayout Pycells: small typo correction in npn13G2* devices
2024-08-09 Update README.md
    - added note on current status
    - screenshot as an example
2024-08-13 Qucs-S symbols: removed .INCLUDE, removed temperature sensing terminal from standard npn13G2* devices
2024-08-14 .spiceinit updated due to Qucs-S issues with KLU solver
    [dc_hbt_13g2.sch]
2024-08-19 CLASS CORE SPACER is added to decap cells in LEF
2024-08-21 Klayout PyCell integration -added evalution of names used for conditional compilation against process-chain -added catching of PyCell static/dynamic compilation errors for correction of file-path sta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
2024-08-22 partial support for corners and mc simulationin Xyce added, cornerRES.lib added fo XYCE
    [IHP_testcases.sch, IHP_testcases_Xyce.sch, ac_hbt_13g2.sch, ac_lv_nmosrf.sch, ac_mim_cap.sch, dc_diode_op.sch, dc_diode_temp.sch, dc_hbt_13g2.sch]
2024-08-26 .gitignore ignores Touchstone files.
    [IHP_testcases.sch, IHP_testcases_Xyce.sch, cap_test_sparam.sch, dc_lv_nmos_xyce.sch, dc_res_temp.sch]
2024-08-26 IHP_testcases modified to support Xyce and Ngspice in one testbench
    [IHP_testcases.sch]
2024-09-02 changes commited
    [IHP_testcases.sch, ac_lv_nmosrf.sch, dc_diode_op.sch, dc_diode_temp.sch, dc_hbt_13g2.sch, dc_logic_not.sch, dc_lv_pmos.sch, dc_res_temp.sch]
2024-09-18 updated Qucs-S examples, install.py for Qucs
    [ac_mim_cap.sch, dc_diode_op.sch, dc_hbt_13g2.sch, dc_hv_nmos.sch, dc_hv_pmos.sch, dc_lv_nmos.sch, dc_lv_pmos.sch, resistors.sch]
2024-09-27 PyCell Klayout integration -added support for or'ed #ifdef defines -took over windows compatibility work from Andreas Krinke <andreas.krinke@gmx.de>
2024-09-27 Update KLayout DRC scripts
    - fixes regression that missed DRC errors, e.g. for M1.b
    - improves running the DRC on Windows
    - prints message for each rule during run
2024-09-30 iho-sg13g2: libs.ref: sg13g2_io: verilog: Fix specify syntax
    The input and output definition in the Verilog specify block
    were positioned in the wrong order (output to input). Change
    and also implement the tri-state better.
    [sg13g2_io.v]
2024-09-30 pnpMPA: fixed pin order in model, updated xschem symbol and testbench (#37)
    [dc_pnpMPA.sch]
2024-10-10 dev branch merged into Xycetestbenches
    [tran_logic_nand.sch]
2024-10-14 Sparameter simulation added
    [ac_mim_cap.sch, sp_four_port.sch, sp_mim_cap.sch, sp_three_port.sch, tmp_dc_res_stats.sch, tran_logic_not.sch, tran_mim_cap.sch]
2024-10-16 capacitor support and S=parameter analysis added
    [IHP_testcases.sch, dc_hv_nmos.sch, sp_singleport.sch]
2024-10-17 libs.tech: Fix the map file to generate 'drawing' for pins too
    With the current one, any 'PIN' (EDI) area would only end up
    as 'pin' (datatype 2) in the GDS. But it also needs to appear
    in the `drawing` (datatype 0).
2024-10-17 libs.tech: Fix a couple of remnent of GF180 reference in LVS macro
2024-10-17 xyce directory reorganized, examples with double simulator approach extended, issues with MOS and MC
    [IHP_testcases.sch, ac_lv_nmosrf.sch, ac_mim_cap.sch, dc_diode_op.sch, dc_diode_temp.sch, dc_hbt_13g2.sch, dc_hv_nmos.sch, dc_hv_pmos.sch]
2024-10-28 Xyce model instance using NF and M supported also by in HV mos devices
2024-10-28 double simulator support added, start page for xschem changed
    [start_page.sch]
2024-10-28 support for 5 and 4 terminal HBT devices
    [dc_hbt_13g2.sch, dc_hbt_13g2_5t.sch, dc_hbt_13g2l_5t.sch, dc_hbt_13g2v_5t.sch, mc_hbt_13g2.sch, mc_hbt_13g2_ac.sch]
2024-11-11 feat(inductors): removed obsolete 'inductor*_sc|sp' devices from Pycells and sg13g2_pr GDS
2024-11-12 Update lvs_regression.yml
    update to the version 0.29.8-1 as a current one on klayout.org
2024-11-12 feat(primitive device GDS file): removed 'instance.*' layers
2024-11-13 Fixes adms build script in order to create a libs.tech/xyce/plugins directory if not created. Also add standard cell launcher to the xschem start page
    [start_page.sch]
2024-11-19 feat(Abutment check): added initial version of script to create abutment assembly for stdcells and the abutment GDS (#247)
2024-11-19 1) ebufn_2, dllr_1 - abuttment DRC ussues are resolved NWell and M1. 2) HeatTrans layer lables were removed. 3) M1 lable property is replaced to M1 text. Updated files: sg13g2_stdcell.lef and sg13g2_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
2024-11-20 feat(Abutment check): added printing of output GDS in the terminal window
2024-11-25 change core spacer to core class attrubute for decap cells
2024-11-25 move back CORE to CORE SPACER for decaps, #237 issue
2024-11-27 feat(stdcells abutment): regenerated stdcells abutment layout assembly after latest stdcells GDS update
2024-12-02 sg13g2_hbt_mod.lib changed in order to support 5 terminal devices, also model level changed to 12wq
2024-12-03 feat(devices QA cells for DRC): initial version (sealring, mim, res)
2024-12-04 fix(pnpMPA xschem symbol): added extraction of area and perimeter to the device netlist (#288)
    [dc_pnpMPA.sch]
2024-12-09 ptap1 and ntap1 modified in order to scale with size, (global), ngring and pgring xschem symbols intruduced; changes in resistor model file for ngspice in order to support modelling of ptap1 & ntap1 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
    [dc_gring.sch, dc_ptap1.sch]
2024-12-10 Improving resistor connections for LVS for proper detection with poly conn
2024-12-17 RF MiM capacitor support and test case added
    [IHP_testcases.sch, ac_rfmim_cap.sch]
2024-12-18 Added preliminary files for development work at Efabless on magic and netgen support for the IHP sg13g2 open PDK. This mainly includes layer mappings, contacts, and connectivity information for magic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
2024-12-18 Updates to the magic techfile, mostly for GDS read/write and device extraction.
2024-12-18 Major work on the tech file and device generator script for magic, although this is still very much a work in progress.
2024-12-18 Continued work on the DRC rule deck and generated devices. Most DRC rules are now handled correctly.
2024-12-18 Major updates to the magic techfile in support of all three types of bipolar transistors and the schottky diode, and a lot of additional DRC rule additions, corrections, and refinement.
2024-12-18 Add preliminary parasitic capacitance values from capiche
2024-12-18 Add antenna section, add values for extresist, update capacitance section
2024-12-18 Use w and l for diodes and mim caps
2024-12-18 Added more GDS input/output rules for handling copper pillar, seal ring, and a few additional obscure layers not previously handled. No longer generates missing layer warnings when reading the primit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
2024-12-18 Added handling of scr1 device drawing and fixed inconsistencies in the output generation of layers for scr1, nmoscl_2, nmoscl_4, and ptapSB, mainly by introducing additional diffusion resistor types.
2024-12-18 Added support for GDS reading/writing SVaricap and pnpMPA, and pnpMPA device extraction (no device models exists for SVaricap, so unsure what to do with it). DRC errors exist on SVaricap, as it is co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
2024-12-18 Changes to the magic tech file: (1) Added extraction devices for metal resistors (ideal resistors) (2) Added extraction device for SVaricap (placeholder, as there is no model) (3) Added connectivity 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
2024-12-18 Added more MiM cap rules based on the device pass/fail validation layout. Found an error in magic that prevented one of the rules from being implemented; updated the minimum required version of magic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
2024-12-18 Added material in preparation for alpha pre-release: Created scripts for density checks and fill pattern generation. Corrected most of the fill pattern generation sizes and spacings. Commented out th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
2024-12-22 Implemented pad rules (includes bond pad, copper pillar pad, and
    solder bump pad). Raised issue on github about incorrect layout
    of the copper pillar pad in the primitive device library. Note
    that the passivation layer "sbump" and "cupillar" purposes are
    not used in any layouts that I can find, nor specified in the
    documentation other than a layer number assignment, so they are
    not generated as output by magic.
2024-12-26 Added more DRC rules for latch-up and for devices in deep n-well
    structures. Updated magic with a new GDS operator option that
    simplifies the generation of latch-up rules; applied the new
    rule option in the IHP tech file for magic (with a corresponding
    update of the minimum required version of magic).
2025-01-06 xschem symbols for diodevdd_2kv and diodevss_2kv added, models ongoing
2025-01-07 more ESD symbols and model placeholders added: diodevdd_4kv, diodevss_4kv, idiodevdd_2kv, idiodevss_4kv, nmoscl_2, nmoscl_4, placeholders in sg13g2_esd.lib added
2025-01-08 Bondpad symbol, models (ngspice, Xyce), testcases, and pycell added
    [IHP_testcases.sch, tran_bondpad.sch]
2025-01-10 ESD device support, xschem symbols, schem testcases, nspice and Xyce libraries
    [IHP_testcases.sch, dc_esd_diodes.sch, dc_esd_nmos_cl.sch]
2025-01-13 Xyce nmos clam working. MOS clamps models moved to sg13g2_moslv_mod.lib, additional modelcard added in sg13g2_moslv_parm.lib
    [dc_esd_diodes.sch, dc_esd_nmos_cl.sch]
2025-01-14 provide a switch for vbic NQS effect, default is 0
    reaction to github issue #309
2025-01-19 poly resistors with r3_cmc model, fix for issue #318 noise bug
    because of additional Verilog-A model reorganization of directory structure and install process was introduced
2025-01-21 correct contact resistance for r3_cmc
2025-01-29 Updating LVS derivations for n/p tap1 devices
2025-01-29 Minor update for ntap1 device
2025-02-11 default value of El changed to 1 for npn13G2v devices
2025-02-12 ptap1/ntap1 update, gring added, sub! global net introduced
    [IHP_testcases.sch, dc_ntap1.sch, dc_ptap1.sch]
2025-02-13 fix(xschem testbenches): removed plugin usage from Xyce cmd line where not needed
    [ac_mim_cap.sch, ac_rfmim_cap.sch, dc_diode_op.sch, dc_diode_temp.sch, dc_esd_diodes.sch, dc_hbt_13g2.sch, dc_res_temp.sch, mc_res_op.sch]
2025-02-14 gring moved to separate branch, ptap1 and ntap1 devices are DRC and LVS clean
    [IHP_testcases.sch, dc_ntap1.sch, dc_ptap1.sch]
2025-02-17 feat(RF MOSFET Pycells): initial version
2025-02-17 diodevdd_2kv added as a pycell
2025-02-17 diodevss_2kv added with mialignment on metal2 and via1
2025-02-19 dc_gring.sch removed from examples
    [dc_gring.sch]
2025-03-02 sg13g2_pr/annotate_fet_params.sym; sg13g2_tests/dc_*v_*mos.sch test cases changed to use it. Helper procedures added to xschemrc
    [dc_hv_nmos.sch, dc_hv_pmos.sch, dc_lv_nmos.sch, dc_lv_pmos.sch]
2025-03-06 npn13G2v, npn13G2l, npn13G2v_5t and npn13G2l_5t symbols changed to support lvs
    [npn13G2_5t_coupling_err.sch]
2025-03-07 schematic file removed from symbols direcory
    [npn13G2_5t_coupling_err.sch]
2025-03-10 mos transistors symbol updated, testcases updated
    [ac_lv_nmosrf.sch, dc_hv_nmos.sch, dc_hv_pmos.sch, dc_logic_not.sch, dc_lv_nmos.sch, dc_lv_pmos.sch, dc_mos_temp.sch, mc_hv_nmos_cs_loop.sch]
2025-03-11 pin order updated to stream correctly pinlist
2025-03-11 nmos/pmos symbols orientation, lvs_format, ngspice testcases updated
    [dc_hv_pmos.sch, dc_logic_not.sch, dc_lv_pmos.sch, dc_mos_cs_temp.sch, dc_mos_temp.sch, mc_hv_pmos_cs_loop.sch, mc_lv_pmos_cs_loop.sch, tran_logic_nand.sch]
2025-03-12 mosfet symbols aligned
2025-03-12 Varactor svaricap add xschem test and symbol
    [ac_svaricap_test.sch, sp_svaricap_test.sch, tran_svaricap_test.sch]
2025-03-13 all devices added, XOR issues with idiodevdd_2kv and idiodevdd_4kv
2025-03-14 all devices consistent with the references, small differences in idiodevdd_2kv and idiodevdd_4kv on the contact
2025-03-14 Isolated devices removed from symbols, ngspice, xyce, and PyCell
    [dc_esd_diodes.sch]
2025-03-14 feat(sg13g2_pr GDS): removed 'idiode*' devices
2025-03-14 sg13g2_moslv_parm.lib modified to add modelcard for nmos clampa
2025-03-14 Update KLayout DRC scripts
    - improve runtime by combining min/max density checks
    - update checks for SG13G2 layout rules v0.4
    - fix issue #341 - Wrong value for GFil.j
    - change rule descriptions to includes notes from the layout rules PDF
    - rename flags to activate/deactivate certain checks:
    - offGrid → offGridRules
    - filler → fillerRules
    - density → densityRules
    - noRecommendedRules → recommendedRules
    - remove flag `sanity`; corresponding rules are enabled by default
    - add runtime information to script output
2025-03-20 diodevdd_4kv VDD and VSS labels interchanged, sub! label location updated
2025-03-25 mc_mim_cap_ac xschem testebench: updated cap_wcs_stat -> cap_typ_stat
    [mc_mim_cap_ac.sch]
2025-03-25 KLayout LVS Script: get rid of Linux-dependent pmap/tail in favor of portable RBA::Timer::memory_size
2025-03-25 KLayout LVS Script: get rid of custom get_memory_usage method in favor of portable RBA::Timer::memory_size
2025-03-27 Ptap1 and ntap1 devices pin change order to make LVS clean streaming the netlist from xschem
2025-03-28 Additional corrections to the fill generation:
    (1) Implemented commands in the fill generation script that
    protect the border area outside of the seal ring from
    receiving pattern fill (per discussion with IHP about
    the definition of "outside the sealring").
    (2) Introduced a new operator "orthogonal" into magic and the
    tech file to handle issues with the shrink/grow operation
    on fill shapes leaving behind 5nm angled cutoff corners.
    (3) Corrected a DRC rule for poly fill over nwell. The
    correction surfaced another error within magic which will
    need to be addressed, but the tech file is deemed to be
    c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
2025-03-28 Device generator for klayout
2025-04-11 Update density checks
    - checking for a density >0 creates errors for empty layers
    - error markers are clamped to the chip area
    - new option `tiles_stay_inside` that moves tiles back into the chip
    area if they overlap the chip boundary
    Fixes issuees #391 and #404
2025-04-28 The changes fix format of two standard cells and remove ./pre_osdi from
    the inverter testbench.
    [tran_inv.sch]
2025-05-08 removes double counting of poly resistors contact contribution
    revised version of PR #476 by christoph-weiser
2025-05-09 feat(ngspice stat models): added note on values in capacitors_stat, resistors_stat sg13g2_hbt_stat .lib files
2025-05-10 ihp-sg13g2/libs.tech/xschem/xschemrc: Add annotation for important bipolar small-signal parameters, add some missing mosfet small-signal parameters + added symbol for bipolar params
2025-05-10 ihp-sg13g2/libs.tech/xschem/xschemrc: BIP param annotator added to menubar; HBT and RES lib added to IHP:Add models symbol menu command; Rin added to annotation of bipolar transistor, cgdol and cgsol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
2025-05-10 dc_pnmos: load waves changed to dynamic filename; dc_hbt: op analysis with annotate feature and load waves changed to dynamic filename; xschemrc: added recognition of op annotation for _5t bip devices
    [dc_hbt_13g2.sch, dc_hbt_13g2_5t.sch, dc_hbt_13g2l_5t.sch, dc_hbt_13g2v_5t.sch, dc_hv_nmos.sch, dc_hv_pmos.sch, dc_lv_nmos.sch, dc_lv_pmos.sch]
2025-05-12 fix(resistors QA cells): added missing PolyRes layer to rsil and rppd devices
2025-05-13 sg13g2_hbt_mod.lib + sg13g2_hbt_mod_mismatch.lib: self-heating enabled by default to increase accuracy in op analysis
2025-05-19 fix pin mismatch in CDL view for cell a22oi_1
2025-05-22 Changed ptap_holes calculation
    The holes function returns the inside of donut shapes.
    The seal ring is a ptap that surrounds the entire chip.
    When the sealring is included, the entire chip becomes ptap_holes.
    This change ignores the sealring ptap when calculating ptap_holes.
    For designs without the sealring, there is no change.
    Warning: Use of the holes function in LVS can cause unexpected side-effects when macros have enclosing tap rings.
2025-06-06 This commit adds an experimental support for CMC_R3 resistors to be used
    by Xyce.
2025-06-09 HBT: selft enabled + example updated
    [dc_hbt_13g2.sch]
2025-06-16 added parallelisation feature and updated examples files
    [IHP_testcases.sch, inv_mc_tb.sch, inv_sweep_tb.sch]
2025-06-27 This commit modifies 3 the symbols for poly resistors to be 3 terminal devices. The 3-rd terminal is added as a property and by default connectet to the global net `sub!`. Known issues: - diferrences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
    [dc_res_temp.sch, mc_res_op.sch]
2025-06-30 libs.tech: Fix klayout extraction of diodes
    Diodes were extracted at the wrong hierarchy level.
    Matthias (KLayout author) was kind enough to debug this issue
    and came up with this patch.
    See related discussion :
    https://www.klayout.de/forum/discussion/2605/device-extracted-at-wrong-level-of-hierarchy#latest
    But as a summary, KLayout's booleans use the first argument's
    hierarchy as reference. so it's important to make sure to use a
    "cell local" layer/polygon as first argument to ensure extraction
    at the proper level
2025-06-30 libs.tech/klayout: Add threading support for DRC
    Although the manual says it's mostly for 'tiled' mode and doesn't
    have much effect when in 'deep' mode, it still seems to speed things
    up a bit and we'll take all we can
2025-06-30 libs.tech/klayout: Remove the 'clean line' from LVS netlist reader
    This messes with klayout's matching engine.
    See https://www.klayout.de/forum/discussion/comment/11385/#Comment_11385
2025-06-30 libs.tech/klayout: Remove " / " from the CDL source in the LVS netlist reader
    This removes the slashes that separate the pins from the device type (otherwise, the parser confuses those for actual pins), e.g.:
    ```
    XDECINV net1 CS_OUT VDD VSS / RSC_IHPSG13_INVX4
    ```
2025-06-30 libs.ref/sg13g2_io: Make the corner ORIGIN (0,0)
    This confuses some version of magic. It has been fixed now in
    version 8.3.525, but there is really no reason to have it something
    else than zero in any case ...
2025-06-30 libs.tech/klayout: Use a more targeted regex to remove $[...] around the device type
2025-06-30 Adding support for R3_CMC resistors, which is simulator independent.
    [dc_res_temp.sch]
2025-07-01 fixed pin order in CDL for new 6 flip-flops
2025-07-01 Removing "@" in front of reset signals for dlhr_1 and sdfbbp devices.
2025-07-01 updated simulation and waveform launcher;added hint on how to create .save file; fixed create .save file bug; updated examples with new launcher
    [IHP_testcases.sch, dc_hbt_13g2.sch, dc_hbt_13g2_5t.sch, dc_hbt_13g2l_5t.sch, dc_hbt_13g2v_5t.sch, dc_hv_nmos.sch, dc_hv_pmos.sch, dc_lv_nmos.sch]
2025-07-01 complete 3rd node for resistor mismatch models
2025-07-07 Modifications in IO spice netlist in order to support 3 terminal resistors. Also a reference to this library was added in ngspice .spiceinit config file.
2025-07-07 Xschem DRC checks added for S-Varicap device. Symbol for S-Varicap slightly modified.
2025-07-07 add all-with-all gds assembly
2025-07-09 feat(stdcells xschem symbols): added antennanp, sighold, filler symbols
2025-07-10 Fix order of pin in xschem symbols
    The stdcell update changed the pin order in sg13g2_stdcell.spice.
    This commit changed the symbols to match the spice file.
    See bug #573
2025-07-10 Update sg13g2_dlhr_1.sym
    fixed pin order
2025-07-11 switch normal plot / contourplot added; switch logx/logy/logxy added
    [inv_sweep_tb.sch]
2025-07-11 Path was wrong in SimulatePARALLEL button
    ${PDK_ROOT}/${PDK}/libs.tech/xschem/sg13g2_tests/ inserted to path in SimulatePARALLEL button
    [inv_sweep_tb.sch]
2025-07-11 Update path in inv_sweep_tb.sch
    Updated the path of parallel button in inv_sweep_tb.sch
    [inv_sweep_tb.sch]
2025-07-11 feat(stdcells xschem symbols): updated antennanp
2025-07-14 Old PR rebased, new symbols introduced.
    [dc_esd_op.sch, dc_nmoscl_2_op.sch]
2025-07-14 mosfets, antenna diodes, ESD diodes geometry normalized
    [dc_diode_op.sch, dc_esd_op.sch, dc_hv_nmos.sch, dc_hv_pmos.sch, dc_lv_nmos.sch, dc_lv_pmos.sch, dc_nmoscl_2_op.sch]
2025-07-14 basic and nonlinear resolved
    [ac_mim_cap.sch, dc_diode_op.sch, dc_esd_op.sch, dc_hbt_13g2.sch, dc_lv_nmos.sch, dc_nmoscl_2_op.sch, resistors.sch, symbols.sch]
2025-07-14 symbols in qucs/examples/symbols modified
    [symbols.sch]
2025-07-14 symbol galery updated
    [symbols.sch]
2025-07-14 Svaricap pin order and labels changes
2025-07-14 examples modified to support portability using /home/herman env variable, install script modified (user libraries are symlincs)
    [ac_mim_cap.sch, dc_diode_op.sch, dc_esd_op.sch, dc_hbt_13g2.sch, dc_hv_nmos.sch, dc_hv_pmos.sch, dc_lv_nmos.sch, dc_lv_pmos.sch]
2025-07-14 Design examples updated
    [ac_mim_cap.sch, dc_lv_nmos.sch, resistors.sch]
2025-07-15 feat(stdcells xschem schematics): added inv_1 as an example
    [sg13g2_inv_1.sch]
2025-07-16 feat(KLayout Pycells): initial version of pnpMPA device
2025-07-16 feat(KLayout device generator): minor update to the log messages
2025-07-16 Adds pnpMPA device and an example circuit which instantiates this device. The device itself makes some calculations in the wraper to get area and perimeter out of w and l
    [dc_lv_nmos.sch, resistors.sch]
2025-07-16 fix(KLayout device generator): fixed some pcells templates
2026-01-28 Update sg13g2_pr sym files for Klayout LVS
    [gallery.sch]
2026-01-29 Switched lines 48 and 49 in rhigh.sym, rppd.sym and rsil.sym
2026-01-30 Modify the .sym files as instructed by @d‑m‑bailey
2026-02-06 Modify custom_reader.lvs to read 3-term resistor CDL format
2026-02-15 Updating sdiod* rules to be applied for schottky device only
2026-02-16 Updating some drc rules to waive some expected violations in HBT devices
2026-02-17 drc(antenna): updating Ant.h with isolbox exclusion
2026-02-17 drc(geometry): add angle checks, refine offgrid/grid flow, and add --no_angle in CLI/GUI
2026-02-19 Adding proper switches for some lvs tests
2026-02-24 ihp-sg13g2: libs.ref: sg13g2_tech.lef: Fix TM2.bR
    OpenROAD currently doesn't respect rules TM2.bR
    "Min. space of TopMetal2 lines if, at least one line is wider than
    5.0 µm and the parallel run is more than 50.0 µm"
    Add a SPACINGTABLE to prevent TM2.bR violations.
2026-02-26 Add svs flow
    (cherry picked from commit f626bcbcb34462235db08fd63cde31e465eeb8dc)
2026-02-26 Add run_regression SVS flow and GUI options
    (cherry picked from commit e93d118345bff316cb9470d31004754cf25a4fa8)
2026-02-26 lvs: rework SVS flow with layout_netlist, add tests/CI, and macro GUI support
2026-03-01 Init updates for BJT devices for Nx support and max length fixes
2026-03-03 lvs: Adding new extractor/reader/writer for supporting isolbox device
2026-03-04 Add NWell text layer
    This seems to make technology more consistent as the .pin layer exists for
    NWell but not the .text layer.
    The actual cause for this change is to allow to give the net of the NWell
    a name. This is used for two things: first it allows the NWell net to be a
    port of a cell and secondly naming the net will also allow to connect
    disjointed NWell into one net using `connect_implicit()`.
    (cherry picked from commit 6beed312b027ef7f5408e8f5bdc68d94e519f88a)
2026-03-04 Made updates based on several updates to magic, two of which specifically address issues in the PDK: (1) Changed the way that bar contacts are handled, so that bar contacts can be identified and diff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
    Signed-of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
2026-03-04 Additional corrections for use with the updated magic Corrected the guard ring generators in the magic parameterized cells, which were using the cursor box to indicate the guard ring centerline, and 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
2026-03-05 Modified the netgen LVS setup file so that MiM cap W and L permute.
    This PR corrects the netgen setup file, which previously compared
    MiM capacitors by W and L and specified L as the "critical" property.
    This prevented matching of non-square capacitors in different
    orientations, and prevented combining capacitors unless the length
    value matched. This could result in LVS property mismatches on
    circuits which should be considered correctly matched.
2026-03-05 m = 1 fix
    In the case of m = None, this force m to be equal to 1
2026-03-05 Corrects the MiM cap layers for correct parasitic extraction.
    Previously the MiM cap layer was placed on metal5, but since the
    MiM cap layer is considered to be the MiM cap top plate and
    therefore connected to the metal layer above it, this arrangement
    was causing all parasitic capacitance to the bottom plate under
    the MiM cap layer to be added to the node of the top plate
    instead, which then ended up as an underestimate of parasitics to
    the bottom plate and an overesitmate of the parasitics to the
    top plate. This solves issue #803 "Extraction(cmim): bottom plate
    (Metal5) doesn't act as a parasitic shield for top plate".
2026-03-06 lvs: adding LVS Schematic Syntax Reference table
2026-03-06 fix(npn13G2 KLayout Pcell): added missing HeatTrans layer (#850)
2026-03-10 lvs: use PNP device class in reader
    Ensure pnpMPA instantiates the A/P-aware device class so LVS parsing accepts A and P parameters. This aligns the reader with the new pnpMPA extraction/output format.
2026-03-11 Fixing typo in sg13g2.lyt file It solves issue #859
    [sg13g2.lyt]
2026-05-12 Fix LU.b: use geometric subtraction to catch partial N+Activ polygons
    The rule previously used Region#not_interacting to filter N+Activ inside
    PWell sitting within the 20 um halo of a pSD-PWell tie. That operator
    drops whole polygons, so a polygon with one end inside the halo and the
    other end beyond 20 um was silently accepted. Per DRM
    (SG13G2_os_layout_rules.pdf, Sec 7.2.2, p. 67), the rule is on "any
    portion of N+Activ ... to an pSD-PWell tie", meaning every point must
    lie within 20 um of a tie.
    Replace not_interacting with Region#not (geometric subtraction of the
    halo). It returns the sub-polygon portions outside the halo, matching
    the sibling rule LU.a in sg13g2_maximal.drc that uses e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
2026-05-15 Corrected metal surround around "contbar" contacts in the resistors. Simplified DRC checking for Cntb rules using the new "exception" DRC statement. The new rule implementation notes that bipolars an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
2026-06-29 ihp-sg13g2: klayout: drc: offgrid: Remove irrelevant checks
    The offgrid table included many layers that carry no manufactured
    geometry - `.pin`, `_nofill` and `_noqrc` datatypes. These exist only
    for tooling (connectivity, fill exclusion, RC extraction) and are
    allowed to sit off grid, so checking them produced spurious offgrid
    errors.
    Drop these layers from the offgrid check.
2026-07-02 ihp-sg13g2: libs.ref: RM_IHPSG13_2P_64x22_c2 -> RM_IHPSG13_2P_64x22_c2_bm_bist
    Replace the RM_IHPSG13_2P_64x22_c2 SRAM macro with the BM and BIST
    features. This makes it easier to handle SRAMs since most other
    macros use those two features.
    [RM_IHPSG13_2P_64x22_c2_bm_bist.v]
2026-07-03 qucs-s: move stdcell schematics and symbols into libs.ref
    [sg13g2_a21o_1.sch, sg13g2_a21o_2.sch, sg13g2_a21oi_1.sch, sg13g2_a21oi_2.sch, sg13g2_a221oi_1.sch, sg13g2_a22oi_1.sch, sg13g2_and2_1.sch, sg13g2_and2_2.sch]
2026-07-03 xschem: switch stdcell views to libs.ref and add view selection
    [IHP130_stdcells.sch, digitest.sch, sg13g2_a21o_1.sch, sg13g2_a21o_2.sch, sg13g2_a21oi_1.sch, sg13g2_a21oi_2.sch, sg13g2_a221oi_1.sch, sg13g2_a22oi_1.sch]
2026-07-03 reconfigure the stdcell schematic choices
2026-07-06 Switch stdcell symbol type to dynamic tcleval for hierarchy mode control
    Replace static type=subcircuit with type=tcleval([symtype]) in all 84
    stdcell xschem symbols, enabling runtime switching between subcircuit
    and primitive type via the stdcell view dialog.
    Update xschemrc:
    - symtype proc returns stdcell_sym_type global variable
    - Dialog OK handler sets stdcell_sym_type based on stdcell_view,
    fixing a two-pass netlist bug where type was only updated as a
    side effect during hierarchy descent
    - Remove dead _empty suffix logic from hierarchy_config (no longer
    needed since primitive type skips schematic descent entirely)
    - Rename 'Empty schematic' radio button to 'Primitive (no hierarc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
2026-07-10 PyCell for Klayout
    -updated pycell4klayout-api submodule reference
    -introduced explicit configuration of parameter usage as
    callback argument
    -added rfcmim, dpantenna, inductor2, inductor3 and isolbox to
    callback configuration
    -fixed Python/Tcl parameter mapping containing square brackets issue
    -fixed inductor- and isolbox-callback
2026-07-10 PyCell for Klayout
    -added original resistor callback and util module
2026-07-10 PyCell for Klayout
    -introduced callback parameter mapping
    -added rsil, rhigh and rppd to callback configuration
    -fixed resistor callback
    -added tech module
    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
2026-07-15 Remove print statements
2026-07-16 Bump palace submodule to upstream HEAD for scikit-rf 2.0 fix
    The palace post-processing script combine_extend_snp.py called the
    top-level skrf.connect, which scikit-rf 2.0 removed, so `make sim-*-em`
    failed after the solve on containers with scikit-rf >= 2.0:
    AttributeError: module 'skrf' has no attribute 'connect'
    Upstream (VolkerMuehlhaus/gds2palace_ihp_sg13g2) fixed this in 64ad5e5
    by importing connect from skrf.network. Bump the pinned submodule commit
    bb0edb0f -> df29aa60 (current upstream main HEAD) to pick up the fix
    (works on scikit-rf 1.x and 2.x), plus other upstream updates.
2026-07-21 fix(KLayout/LVS): map metal resistors to 'R' prefix
2026-07-21 KLayout Tech File: add comprehensive list of grid values
    KLayout now supports finer/coarser grid using G/SHIFT+G, these are also accessible in the main menu under View->Grid. To fully enable this feature, a comprehensive list of grid values must be provided to the user (previously only 2).
    [sg13g2.lyt]
2026-07-21 Raise NotImplementedError in case of unsupported technology
2026-07-22 Add cap_mom MoM capacitor PCell and symbol for SG13G2
    Interdigitated metal-oxide-metal capacitor on the Metal1..Metal5 thin-metal
    stack, selected by mmin/mmax, with double/same/none feed styles and PLUS/MINUS
    terminals. Registers the PCell in the pycell library and adds the xschem symbol,
    a gallery instance, a pycell smoke-test entry and a netlist-import template.
    [gallery.sch]
2026-07-22 Add cap_mom Verilog-A compact model and ngspice wiring for SG13G2
    Full RF equivalent-circuit compact model (area/feed capacitance, series R/L,
    skin effect and a substrate shunt) compiled to OSDI with OpenVAF, plus a
    2-terminal wrapper subckt and the .spiceinit and compile-script wiring. The
    wrapper is included in the cap corner chain so schematics resolve it.
    Coefficients are the g2-native nominal values by layer count; process-corner
    and mismatch spread are not yet characterised (nominal in all corners), noted
    as a known caveat pending silicon.
2026-07-22 Add cap_mom LVS extraction, compare and unit testcase for SG13G2
    Recognises cap_mom by the Recog.mom (99/39) marker and ties each metal's pins
    only to its own metal, so the single-side stacked feed stays on distinct nets.
    Extracts a 2-terminal device via the shared DeviceCustomMIM class. Wires the
    derivation/connection/extractor decks, folds the extraction into the CAP group,
    adds the PREFIX_MAP entry, generalises the CDL reader to the cap_mom model, and
    adds a cap_devices unit testcase plus the syntax-reference row.
2026-07-22 Add cap_mom xschem AC testbench for SG13G2
    AC cutoff testbench for cap_mom, mirroring the MIM-cap testbench; resolves the
    model through the standard cap corner chain.
    [ac_cap_mom.sch]
2026-07-22 Cover both cap_mom feed variants in the LVS testcase
    The cap_mom LVS unit testcase now contains both a double (opposite-side) and a
    same (single-side) feed device, so the regression also exercises the single-side
    stacked-plate extraction and its distinct-net isolation. The PCell docstring now
    states explicitly that feed selects one parameterised device whose two feed
    variants are not electrically identical (single-side adds a feed capacitance).
2026-07-22 moscap testcases for xschem - ngspice and xyce
    [IHP_testcases.sch, gallery.sch, tran_moscap_n.sch, tran_moscap_p.sch]
2026-07-22 moscap exaple for qucs-s - ngspice
    [tran_moscap_n.sch, tran_moscap_p.sch]
2026-07-22 docs: document MOSCAP device support
2026-07-22 cap_mom: key oxide-shunt Cox by bottom metal, add RF fit-validity note
    Cox is the bottom-plate-to-substrate oxide capacitance, so key it by the
    bottom metal index (mmin) rather than the mixed mmin/layer-count test. This
    reproduces the three characterised Cox sets exactly for the M1-M5 stacks and
    stays physical for reduced-top stacks; only exotic mid-stacks change (e.g.
    M2-M4 now uses the M2-bottom set instead of the M3-bottom one). The reference
    5x5/N5 device capacitance is unchanged.
    Also document the fit-validity window in the model header: series inductance
    ~20% at 50 GHz, substrate shunt ~10% over 0..100 GHz, extrapolation beyond
    that window with Rsub clamped at very large sizes.
    Signe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
2026-07-23 cap_mom: make series inductance feed-dependent
    Lcore applied Volker's p18 two-sided (opposite-end) loop-inductance
    fit unconditionally, but that quantity is only correct for feed=double.
    A same-side (feed=same) or bare (feed=none) device has no such loop;
    its series inductance is the small single-side value from the notes
    (p13-16, ~0.2..1.3 pH). Using the loop fit for those feeds overstated L
    by 15-90x and, on large geometries, flipped the in-band series
    reactance inductive (e.g. 60x10 same-feed goes inductive above ~30 GHz,
    inside the DC..50 GHz band).
    Key Lcore by feed: keep the p18 loop fit for feed=double; for
    feed=same/none recover the single-side inductance self-consistently from
    Volk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
2026-07-23 cap_mom: tighten RF fit-validity documentation from second audit
    Documentation-only clarifications to the Verilog-A header/comments and the
    ngspice wrapper. No coefficient or logic change; the 5x5/N5 double LF cap is
    unchanged at 20.335 fF and the model recompiles clean.
    An adversarial second-pass audit re-read the source notes (pp16, 19-23) and
    confirmed every coefficient traces to a page and the model is sound to ship.
    These edits record the caveats it surfaced:
    - Scope the "<10% of |Z| below 50 GHz" note: large feed=double devices
    self-resonate in-band (~30-47 GHz) against a two-sided SRF that is not
    published, so the default-feed SRF there is an unvalidated prediction.
    - Note N=2 (d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
2026-07-23 cap_mom: attribute the model source to IHP, not an individual
    Replace the personal author name in the cap_mom source citations and inline
    comments with an institutional attribution to IHP (the model traces to the
    IHP "MOM model development notes"). Documentation-only; no coefficient or logic
    change, the model recompiles clean and the 5x5/N5 double LF cap is unchanged at
    20.335 fF.
2026-07-23 cap_cmom: rename the MoM capacitor from cap_mom across the PDK
    Adopt the cap_cmom name (cap_cmim/cap_rfcmim family) as requested in review.
    Renames the Verilog-A module, ngspice subckt/OSDI, KLayout PCell, LVS device
    decks, xschem symbol/testbench and the LVS unit testcase (GDS cell + labels,
    CDL). Keeps recog_mom, custom_mom_extractor.lvs / CapMomExtractor (parallel to
    the mim extractor) and the MoM tech prose unchanged.
    Verified: OSDI recompiles, ngspice LF capacitance unchanged (20.335 fF for
    5x5 N5 double), LVS unit testcase passes (netlists match).
    [ac_cap_cmom.sch, gallery.sch]
2026-07-23 cap_cmom: accept m multiplier and mm_ok for cap-family parity
    The cap_cmim/cap_rfcmim symbols expose m and mm_ok; add them to the cap_cmom
    subckt so the same schematic interface works. m is passed to the OSDI device
    as the built-in mfactor (verified: m=2 doubles the low-frequency capacitance).
    mm_ok is accepted but is a documented no-op: cap_cmom has no characterised
    mismatch model yet, so there is nothing to switch.
2026-07-23 cap_cmom: rework xschem symbol and wire the AC testcase
    Mirror the cap_cmim symbol geometry, expose m and mm_ok in the template and
    netlist format, and add a parameter-based capacitance estimate that matches
    the layout C label: density x active area plus the single-side feed term for
    feed=same (verified 20.335 / 26.467 / 48.803 fF for the 5x5 double, 5x5 same
    and 7x7 double references). Text labels moved clear of the glyph.
    Add the ac_cap_cmom launcher symbol and reference it from IHP_testcases.sch
    under the AC category. Headless netlist and a full ngspice AC run confirm the
    chain (844 fF for the 10x70 double bench).
    [IHP_testcases.sch, ac_cap_cmom.sch]
2026-07-23 cap_cmom: add qucs-s XML symbol
    Mirror cap_cmim.xml for the MoM device: 2-terminal Capacitor.sym drawing and
    ngspice/CDL/Xyce netlist templates that emit the cap_cmom subckt call with
    w/l/mmin/mmax/feed/subblock/m/mm_ok. Adds a display-only capacitance estimate
    (density x active area) matching the layout label. XML is well-formed and its
    structure parallels cap_cmim.
2026-07-23 cap_cmom: add gnucap model plugin and testcase
    Compile the shared cap_cmom Verilog-A (the same source the ngspice OSDI build
    uses) into a gnucap-modelgen plugin via a new cap_cmom_paramset target, and add
    an AC-cutoff testbench under tests/gnucap/capacitor mirroring tb_cap_cutoff.
    The plugin builds cleanly; the physics is identical to the ngspice model
    (low-frequency capacitance 20.335 fF for 5x5 N5 double).
    The reference output (ref/tb_cap_cmom_typ.gc.out) is intentionally not committed:
    this environment cannot activate the gnucap mgsim runtime (every existing gnucap
    Verilog-A testcase also fails here), so a golden run must be captured in a
    working gnucap setup. Until then the Makefile rep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
2026-07-23 cap_cmom: make the xschem value estimate render and refine the symbol
    The on-canvas value estimate did not evaluate: xschem's tcleval label parser choked on the inline piecewise expression and printed raw Tcl that overran into neighbouring symbols. Move the computation into a Tcl proc (cap_cmom_est) in a new xschem-devinfo file sourced by xschemrc, the same way cap_cmim relies on mim_drc. The estimate now shows the exact model value for every feed mode.
    Also rename the pins to c0/c1 to match the other capacitors, fix the metal-range label, propagate m into lvs_format, and use bare SI defaults in the template.
2026-07-23 cap_cmom: give the MoM capacitor its own gallery category
    It was grouped under the MiM capacitor row; add a MoM capacitor category and move it there. Also nudge the capacitor rows down so the top pin no longer lands on the isolation-box substrate terminal.
    [gallery.sch]
2026-07-23 cap_cmom: silence the ngspice subckt-multiplier warning
    Declaring m on the .subckt header makes ngspice warn about overriding the subcircuit multiplier. Move it to a body .param instead; the multiplier still scales correctly (m=2 doubles the capacitance) and the default flow is warning-free.
2026-07-23 cap_cmom: rename stale CAP_MOM banners in the LVS decks
    Three decks still printed the pre-rename CAP_MOM name in section banners and runtime log lines. Rename them to CAP_CMOM.
2026-07-23 cap_cmom: render the xschem value estimate inline
    The estimate used a cap_cmom_est proc sourced from xschemrc via a new
    xschem-devinfo file. That mechanism did not render (the label showed raw
    Tcl) and the xschemrc source line collided with upstream, producing the
    merge conflict on the branch.
    Compute the value inline with the builtin ev proc, the same way cap_cmim
    does, so no auxiliary file or xschemrc change is needed. Every @ref is
    space-delimited (xschem drops a @ref that is not followed by whitespace)
    and the expression uses only Tcl-expr constructs ev can evaluate. The
    label now shows the model capacitance for the double-feed active area,
    matching the layout anchors (5x5 20.34 fF, 10x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
2026-07-23 cap_cmom: restructure the gnucap build unit as a module wrapper
    The file was named cap_cmom_paramset.va but held no paramset, just an
    include, so it read as an empty stub. cap_cmom is a single behavioural
    compact module with no corner/mismatch spread, so unlike cmim it has no
    sp_capacitor primitive plus corner paramsets to bind.
    Rename it to cap_cmom_module.va and document that it is a build shim that
    includes the shared Verilog-A module (kept single-source so the gnucap
    plugin and the ngspice OSDI build compile identical model code). Update
    the Makefile target and the testbench load path. The emitted device is
    unchanged: gnucap-mg-vams still elaborates module cap_cmom(PLUS, MINUS,
    SUB) int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
2026-07-23 cap_cmom: carry the pitch-snap epsilon into the symbol estimates
    The .va model and the PCell snap the tiling floor with a +1e-6 pitch
    epsilon so the layout, the C-label and the simulation model agree for
    drawn sizes that are exact multiples of the unit-cell pitch. The xschem
    and qucs-s on-symbol estimates were missing it, so at an exact-pitch
    dimension (e.g. l=21um=25*0.84) the canvas value could read one unit cell
    low. Add the same +1e-6 to both estimates. Anchors unchanged (5x5
    20.34 fF, 10x70 843.9 fF); exact-pitch 21x8.9 now reads 228.8 fF.
2026-07-24 cap_cmom: dedicated polarized qucs-s symbol, PLUS on the left
    The shared Capacitor.sym draws both plates identically, so the qucs-s
    symbol did not distinguish the positive and negative terminals. Point
    the component at its own cap_cmom.sym: a straight plate marked "+" for
    PLUS and a curved plate for MINUS, matching the xschem convention.
    PLUS is drawn on the left and kept first in PortSym order, so the
    netlist node order is still PLUS, MINUS. Verified with the qucs-s
    netlister (XC1 <plus> <minus> cap_cmom ...) and an ngspice/OSDI AC
    sweep: 5x5 20.33 fF, 7x7 48.8 fF, 10x70 843.9 fF.
2026-07-24 cap_cmom: add qucs-s AC example with the xschem -3dB extraction
    Add qucs-s/examples/ac_mom_cap.sch so the qucs-s flow has the same
    cap_cmom testcase as xschem (sg13g2_tests/ac_cap_cmom). It is the same
    high-pass RC: an AC source drives cap_cmom in series into a 100k load,
    and the capacitance is read from the -3dB corner, C = 1/(2*pi*f_3dB*R).
    The extraction runs as an ngspice control block (meas/print) so the
    number matches the xschem test exactly.
    Instantiates the cap_cmom XML component (in=PLUS, out=MINUS) and pulls
    the model through cornerCAP.lib cap_typ, like the sibling ac_mim_cap
    example. Verified: netlist XC1 in out cap_cmom w=10.0u l=70.0u ... and
    ngspice returns C = 8.185e-13 (818.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
    [ac_mom_cap.sch]
2026-07-24 Trying to improve hierarchical (deep-mode) extraction of taps
    Use case: guard rings in sub cells are brought together
    when building the top level cell. Without this patch, these
    guard rings merge into single tap devices a level up in
    hierarchy and schematic does no longer match.
    The solution ensures (by re-hierarchisation) hierarchical
    state of the marker layers and cheats to leave the taps
    in their place in the hierarchy.
2026-07-24 cap_cmom: draw a plain two-plate capacitor symbol
    Replace the polarized one-curved-plate symbol with a symmetric
    two-straight-plate symbol in both the xschem and qucs-s symbols. The
    MoM capacitor is physically symmetric, so it should not carry the
    polarized-cap convention (that stays on cap_cmim). Drawing only: the
    terminal order is unchanged (PLUS is still the first pin/port), so the
    netlist and LVS are unaffected.
2026-07-24 cap_cmom: qucs-s AC example with an embedded plot
    Rework qucs-s/examples/ac_mom_cap.sch to use a .AC analysis feeding an
    embedded rectangular diagram, matching the cap_cmim example, instead of
    a raw ngspice control block. The high-pass RC magnitude v(out) is
    plotted over 1e4..1e10; the -3dB corner (~1.944 MHz) gives C ~ 818.5 fF,
    the same method and result as the xschem test sg13g2_tests/ac_cap_cmom.
    The device line is unchanged (XC1 in out cap_cmom w=10.0u l=70.0u
    mmin=1 mmax=5 feed=double subblock=0 m=1 mm_ok=1).
    [ac_mom_cap.sch]
2026-07-24 cap_cmom: fold cmom into the capacitor_paramset build unit
    Organize the gnucap capacitor Verilog-A models the same way the resistors
    are organized in resistor_paramset.va: every g2 capacitor device is a
    paramset in a single build unit. cmom moves from its standalone build shim
    into capacitor_paramset.va as `paramset cmom cap_cmom`, wrapping the shared
    behavioural module (libs.tech/verilog-a/cap_cmom/cap_cmom.va, the same
    source the ngspice OSDI build uses) and pinning the g2 named-device
    defaults. Mirrors `paramset rsil r3_cmc`.
    cmom is a paramset over a behavioural module (not over sp_capacitor like
    cmim_core) because it is a self-contained RF equivalent circuit, not a
    parallel-plate primi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
2026-07-24 added deep-mode tap extraction testcase
    Added `test_ntap_ptap_ext_deep` testcase (gds + cdl + yaml). Same guard ring layout as `test_ntap_ptap_ext`, but run in deep mode with tap extraction enabled (the default). The ntap1/ptap1 guard rings inside the nmos/pmos subcells are then extracted cell-locally through the cheat-based guard ring extraction, so the hierarchical (deep-mode) tap extraction path is now exercised by the regression. The schematic contains the matching tap devices with the MOS bulks connected through them.
2026-07-24 cleaned up `.yaml`
    Removed the redundant `--ignore_top_ports_mismatch` switch from `test_ptap_dnw_ext.yaml`. The regression runner already passes this flag to every testcase. The comment now documents that the case relies on the runner-provided flag because the isolation nwell ring is not biased to VDD.
2026-07-27 horizontal orientation of moscaps + prefix correction + mm_ok hide by default
    [tran_moscap_n.sch, tran_moscap_p.sch]
2026-07-27 cap_cmom: address gnucap review (mm_ok, $mfactor, ngspice cross-validation)
    Follow-up to Lukas's review comments on PR #1049.
    - capacitor_paramset.va: add `mm_ok = 0 from [0:0]` to the cmom paramset.
    cap_cmom has no mm_ok port, so it is an accepted-but-unmapped selector like
    cmim_core, reserving the mm_ok=1 overload for the future mismatch variant.
    - cap_cmom.va: read the Verilog-AMS standard $mfactor for device multiplicity,
    mirroring the r3_cmc.va idiom (guarded __XYCE__/mult fallback). The parallel
    scaling (C*m, R/m, L/m) is applied by the simulator automatically; the model
    must not scale the elements itself or it double-counts to m^2. mMod is read as
    the standard-compliant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
2026-07-30 Rename cap_cmom to cap_cmomi (PCell cmomi)
    Follow the cmim naming scheme for the interdigitated MoM capacitor and
    leave room for a future finger-based cmomf/cap_cmomf variant. The KLayout
    PCell is now cmomi (file cmomi_code.py, class cmomi), mirroring cmim.
    Everywhere else the device is cap_cmomi: Verilog-A module, ngspice OSDI
    wrapper lib, gnucap paramset (cmomi over cap_cmomi), LVS rule decks and
    unit testcase, xschem and qucs symbols, and the gnucap/ngspice testbenches.
    The LVS testcase GDS top cell and its labels are renamed as well so
    extraction matches the renamed CDL subckt.
    [IHP_testcases.sch, ac_cap_cmomi.sch, ac_mom_cap.sch, gallery.sch]
2026-08-03 KLayout PyCell isolbox: Fix evaluation of diode_layer parameter
2026-08-04 cmomi: exclude density fill from the device
    The cap_cmomi value is set by its metal geometry, but the automatic
    density filler can drop dummy metal on or beside the fingers and over the
    device on the upper metals it does not draw. LVS matches this device
    topologically and does not compare its value, and DRC leaves rule
    compliant fill in place, so neither flags the perturbation.
    Paint NoMetFiller (160/0) over the full device bbox in the PCell. Every
    metal and topmetal filler subtracts NoMetFiller, so no dummy fill lands
    on the device. The marker carries no DRC rule of its own.
    Verified with the KLayout filler on a flattened mmax=2 cmomi: M3/M4/M5
    dummy lands over the device without the mark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
2026-08-07 align poly resistor rhigh corner and global statistical parameter to process specification
2026-08-07 lvs: make cap_cmomi terminals equivalent, flag dropped markers, and test both
    cap_cmomi is matched topologically, which is the right call for this device, but
    two things about how that was done did not hold up once they were tested.
    Terminals are now equivalent for cap_cmomi (cap_cmim and rfcmim keep theirs
    distinct). CapMomExtractor picks its two ports by geometry and never reads their
    pin names, so the order it produced carried no information: for 'double' feed it
    followed the instance orientation, so mirroring a placement swapped the pins and
    LVS reported a mismatch for a circuit that had not changed; for 'same' feed the
    metal index broke the tie, which put the PCell's MINUS plate on pin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
2026-08-11 Add insertion in verilog, add timescale and add minimal possible generated SRAM 64x16
2026-08-11 test(pycell): add concurrent library load reproducer
    Launches N klayout -zz processes at once and checks that every one
    of them registers the same complete SG13_dev PCell library as a
    reference single-process run. The same file acts as the worker
    inside KLayout, selected through an environment variable, because
    the standalone KLayout module makes pya importable outside KLayout
    as well.
    Uses an empty KLAYOUT_HOME so a salt-installed IHP PDK cannot
    register a competing SG13_dev, and sets the technology on the
    layout explicitly, which is required once the home is empty.
    Not wired into CI: it is a manual reproducer for #1087.
2026-08-11 test(pycell): name the probe PCell through a constant
    Keeps the reproducer identical to the ihp-sg13cmos5l copy except
    for the technology name, so the two stay easy to diff.
2026-08-11 pycell: add the cap_cmomf metal fringe MoM capacitor
    Ports the device released in ihp-sg13cmos5l#78 onto the g2 stack. Same
    geometry generator, extended from that PDK's Metal1..Metal4 to g2's
    Metal1..Metal5: 5_17_metaln.drc applies Mn.a, Mn.b and Mn.e to Metal2
    through Metal5 alike and 5_20_vian.drc does the same for Via2 through
    Via4, so Metal5 takes the Mn rule row unchanged and the layer loop needed
    nothing beyond the two name tables.
    The capacitance density does not extend as cleanly. 0.372 with Metal1 plus
    0.305 per extra layer comes from the Magic generator recalibrated against
    OpenEMS in ihp-sg13cmos5l#69, and that stack stops at Metal4, so the
    Metal4 to Metal5 step is extrapolated a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
2026-08-11 lvs: extract cap_cmomf
    The device reuses CapMomExtractor and DeviceCustomMIM as cap_cmomi does,
    and is told apart by its own recognition marker, recog_momf (Recog.momf,
    99/40). It cannot share 99/39: cap_cmomi_derivations.lvs claims that
    marker unconditionally, so one geometry would be recognised by both
    extractors and the run would fail on a device count mismatch.
    It stays in the CAP group, so its testcases sit in cap_devices/ beside
    cap_cmomi's, the same way cap_cmim does.
    Two changes to the shared files are behaviour, not registration. The
    terminal equivalence in custom_mim_extractor.lvs was gated on the device
    name containing 'cmomi'; it now keys on 'cmom' so both MoM capacitors are
    co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
2026-08-11 lvs: test what the cap_cmomf deck detects
    Three testcases in the CAP group, all generated from the PCell by
    create_cap_cmomf_testcases.py so they can be regenerated after a PCell
    change: the device itself, a configuration matrix covering all five port
    layers, and a hierarchical placement.
    Plus cap_cmomf_checks, thirteen cases that each declare the verdict they
    expect, so tightening the comparison surfaces as a verdict change instead
    of silently altering what LVS accepts. Most of them mirror the cmomi
    suite, since both devices share an extractor and a device class. Four do
    not. A mirrored placement, which is what the widened terminal equivalence
    exists for. One cap of each kind side by side,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
2026-08-11 models: add cap_cmomf for ngspice and gnucap
    Verilog-A module, ngspice wrapper subckt and gnucap paramset, wired into
    openvaf-compile-va.sh, both .spiceinit files and the two capacitors_mod
    corner libraries. Same arrangement cap_cmomi has.
    The model is low-frequency only, and that is a decision rather than an
    omission. cap_cmomi carries a full RF equivalent circuit because IHP
    characterised the device; for this geometry there are neither measurements
    nor an EM fit, so attaching the sibling's parasitics to it would be
    inventing data. It contributes C = areacap(mmin, mmax) * l * w and a 1 Tohm
    DC anchor, nothing else: no self-resonance, no substrate terminal, no
    corner or mismatch spread. All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
2026-08-11 schematics: add cap_cmomf to xschem and qucs-s
    xschem symbol, AC testbench, and the entries in gallery.sch and
    IHP_testcases.sch. The symbol is the cap_cmomi one with four differences
    and no others: the model name, no feed token in the format or the
    template, the C readout expression, and the label that freed up where
    feed used to be. Same plates, same c0/c1 pins, same SI template.
    qucs-s the same way. The artwork file is byte-identical to cap_cmomi's;
    the component XML changes the name, drops feed from the three netlist
    templates, since the device has no such parameter, and carries the
    cap_cmomf capacitance equation. An AC example beside the cmomi one.
    Both C expressions duplicate the PCe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
    [IHP_testcases.sch, ac_cap_cmomf.sch, ac_momf_cap.sch, gallery.sch]
2026-08-11 cap_cmomf: fix what the pre-PR audit found
    Two real gaps and six false statements, from an eight-agent review of the
    branch before filing it.
    CI never ran the new checks suite. lvs_regression.yml has the cap_cmomi
    step and gained no cap_cmomf one, so the thirteen cases were developer-run
    only, which is exactly the parity bar this port is measured against. The
    three unit testcases were always covered, since run_regression.py
    discovers them by directory walk.
    The gallery entry landed on top of pnpMPA at (390,-80) and reused the
    instance name C5, which moscap_p already has. Moved beside cap_cmomi at
    (560,-240) as C6. The testcase index entry had the same problem with x43
    and sat off the colum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
    [IHP_testcases.sch, ac_momf_cap.sch, gallery.sch]
2026-08-11 librelane: point PAD_SPICE_MODELS at the file that exists
    The I/O spice netlist was renamed from sg13g2_io.spi to sg13g2_io.spice in
    877a33db (2026-05-19) and libs.tech/librelane/config.tcl kept the old name.
    LibreLane validates PDK paths before it loads any design configuration, so
    every Chip flow on this PDK stops at
    Path provided for variable 'PAD_SPICE_MODELS[0]' is invalid:
    .../libs.ref/sg13g2_io/spice/sg13g2_io.spi does not exist
    with nothing run. One character; nothing else references the old name.
2026-08-11 libs.ref/sg13g2_io: name the spice netlist as it now ships
    The doc listing kept sg13g2_io.spi after the file was renamed to .spice.
2026-08-11 fix 10ns -> 10ps, delete empty folder
    [RM_IHPSG13_1P_512x32_c2_bm_bist.v, RM_IHPSG13_1P_64x64_c2_bm_bist.v, RM_IHPSG13_1P_8192x32_c4.v]
2026-08-17 Bring svaricap nwell-psub diode vj parameter in size to allow 125degC transient simulation
2026-08-18 cap_cmomi: bill the rows and the feed the cell actually draws
    Two corrections, both found while porting this device to the reduced
    thin-metal PDK and both applying here unchanged, because the two PCells draw
    the same cell.
    ROW COUNT. The model billed floor(w/0.89) - 1 coupled rows while the PCell
    draws floor(w/0.89). The earlier billing subtracts a row because the
    characterised structure ends in single fingers with nothing facing them, so one
    pitch of its width does not couple. This cell has no such fingers: it terminates
    at the last coupled row. The subtraction described that structure's boundary,
    not the device, and carrying it over under-counted every size by one row, about
    1% at w = 80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
    [ac_mom_cap.sch]
2026-08-18 klayout: pin the cap_cmomi capacitance across every artifact that states it
    Six places carry this device's capacitance and nothing keeps them in step: the
    Verilog-A, the PCell C= label, the xschem tcleval expression, the qucs-s symbol
    equation, the copy of that equation pasted into the qucs-s example schematic,
    and the two stored simulator references. The example had already drifted, by
    about 3%, and nothing noticed.
    The test asks each artifact for the same twelve devices and compares against the
    Verilog-A built here. The reference side is never a re-implementation: the
    xschem expression goes through tclsh exactly as xschem evaluates it, the qucs-s
    equations go through the same engine with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
2026-08-18 qucs-s: fix stale C annotation in the ac_mom_cap example
    The high-pass RC note quoted C ~ 928.5 fF / f_3dB 1.714 MHz, which no longer
    matches the shipped equation after the row-count fix. Evaluating it for the
    10x70 M1..M5 device (N=5) gives 872.4 fF and f_3dB 1.824 MHz. Only the comment
    text changed; the cmomi equation is untouched.
    [ac_mom_cap.sch]
2026-08-18 cap_cmomi: via the tooth tips and bill the double-side feed
    Two coupled corrections from a Palace EM campaign on the drawn cell.
    Vias: each tooth was via'd only at its base, half the foundry reference
    (MOM_92u_92u) which vias base and tip. Add a tip via per tooth
    (TOOTH_VIA_OFF=0.41) and regenerate the LVS testcase layouts. The testcase
    generator lacked a build_original(), so cap_cmomi.gds had stayed a frozen
    sparse copy; add one and rebuild it from the PCell.
    Feed: the double (opposite-side) feed was billed at zero, previously assumed to
    cancel; the drawn cell read low by that residual, and the tip vias removed the
    density deficit that had partly masked it. An electrostatic solve measures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
    [ac_mom_cap.sch]
2026-08-19 cap_cmomi PCell: review feedback (label, C param, techparams, subblock, centred origin)
    Address the PCell review on the g2 PR:
    - label: two lines centred inside the cell (device name + C value), like cmim/rfcmim
    - expose the capacitance as a PCell parameter C, computed from the model
    - via cut now taken from techparams['V1_a'] instead of a literal
    - subblock is a boolean parameter; shorten the feed description
    - centre the cell on the device origin
    Model billing factored into _model_C_fF (single source for the label and the C
    parameter), unchanged from cap_cmomi.va. Testcase layouts regenerated; LVS
    regression and the cross-artifact consistency test pass.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
2026-08-19 cap_cmomi PCell: read DRC-derived geometry from techparams
    Wire the three constants that are existing DRC-rule values to the tech file
    instead of literals, matching the tech-driven pcells (cmim, via_stack):
    - TOOTH_VIA_OFF = V1_a + V1_b (via cut + min via space, the foundry lattice)
    - TOOTH_EXT = UC_Y - T_BAR/2 - Mn_b
    - pin width = Mn_a
    The MoM-specific design constants (unit-cell pitch, brick stagger, feed pad
    sizes) stay local: they are choices that satisfy rules, not rules, and nothing
    in the tree stores those in tech. Values are unchanged (0.41 / 0.575 / 0.20);
    XOR against the previous testcase layouts is empty on every layer, so the
    goldens are not regenerated. Consistency tes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
2026-08-19 cap_cmomi: show effective size and model formula in the PCell dialog (g2)
    Add read-only dialog fields: Lx, Wy (effective drawn size = floor(l/0.84)*0.84,
    floor(w/0.89)*0.89) and a formula field (C = D[N]*Lx*Wy + Cfeed); mark the
    derived C read-only and reword w/l as requested values. The coerce callback
    CbCmomi now recomputes Lx/Wy alongside C on every edit.
    Also fix a coerce side effect: the framework writeback runs bool() on the
    string form of a bool param, turning subblock=False into True, so every coerced
    cmomi drew a spurious PWell.block. CbCmomi normalises subblock to round-trip
    correctly. Layout geometry and goldens unchanged.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
2026-08-19 cap_cmomi: add a visible read-only separator in the PCell dialog
    KLayout has no native section divider, so insert a read-only string parameter
    between the editable inputs and the derived read-only fields as a visible
    separator. Display-only; geometry and goldens unchanged.
2026-08-19 cap_cmomi: solve geometry from a target C, footprint read-out, display fixes
    The cmomi C field is now editable with a Calculate selector: forward (C from
    L,W) as before, plus solve W with L fixed, or L with W fixed, from a target C.
    The inverse uses the staircase model's closed form and only moves a dimension
    when the target needs a different cell count, so just switching mode does not
    disturb the geometry.
    Add read-only Fx,Fy (the Recog-box footprint including feed, matching what the
    LVS extractor reports), fold the drawn-size rule into the W/L field text, and
    drop the now-redundant Lx,Wy fields and the size line on the cell label.
    sg13g2.lyp: TEXT was white on the light canvas, so labels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
2026-08-24 libs.tech: klayout: tech: scripts: sealring: Rename input internally
    input is a Python build-in function. That means it can never
    generate a NameError. See
    >>> print(input)
    <built-in function input>
    >>> print(width)
    Traceback (most recent call last):
    File "<stdin>", line 1, in <module>
    NameError: name 'width' is not defined
    Remove the try-catch block for input since it's dead code and rename
    "input" internally to input_file.
    This patch doesn't change the external script arguments and doesn't
    break any external users.
2026-08-24 cap_cmomi: show computed C value in symbol, not the raw expression
    xschem's ev evaluates its argument as an unbraced expr, which fails on
    the feed string comparison, so the symbol printed the whole formula on
    the canvas. Evaluate the readout with format + a braced expr instead, so
    it renders a single value that still tracks w, l and feed.
2026-08-24 xschem: run the parallel-simulation scripts through Tcl's `exec`
    The SimulatePARALLEL launchers in inv_mc_tb.sch, inv_sweep_tb.sch and
    isolbox_sweep_tb.sch call
    python3 ${PDK_ROOT}/${PDK}/.../ngspice_parallel_*.py ...
    from a tclcommand block. `python3` is not a Tcl command, so clicking the
    launcher aborts with
    invalid command name "python3"
    This is the same defect as the `mkdir -p $netlist_dir` that was fixed in
    96fe2b70 ("Update xschem-menu -- from mkdir -p to file mkdir"); these
    three lines sit in the same launchers and were missed.
    It only fails some of the time, which is why it survived: xschem enters
    Tk_Main() when it stays attached to the terminal it was started from, and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
    [inv_mc_tb.sch, inv_sweep_tb.sch, isolbox_sweep_tb.sch]
2026-08-24 cap_cmomi: feed-aware C in the symbol label via helper proc
    Replace the area-only label with a call to cap_cmomi_C, a small Tcl helper
    (new file, sourced from the PDK xschemrc) that reproduces the model C:
    density by layer count, quantized active area, and the feed term
    (same/double/none). The label now tracks feed too, not just w/l/mmin/mmax/m.
    The label needs a space before the closing bracket (@feed ]): xschem ends an
    @-token only on whitespace, so @feed]) would fold the ] and ) into the token
    name and break the expression. Display only; the simulated value still comes
    from the .va through format=.
2026-08-24 tests: add cmomi/cmomf transient testcases to IHP_testcases
    Add tran_cap_cmomi and tran_cap_cmomf testbenches (PWL voltage step into the
    cap, high-pass through a 100k load, .tran) and their launcher symbols, and
    place them in the Transient column of the device gallery next to the moscap
    transient cases. cmomi/cmomf were only present as AC testcases before.
    [IHP_testcases.sch, tran_cap_cmomf.sch, tran_cap_cmomi.sch]
2026-08-26 KLayout LVS: Add parameter for --purge-devices
2026-08-27 ihp-sg13g2: libs.tech: klayout: Fix LVS testing
    LVS regression testing currently fails. Fix cap_cmomf test to
    pass again.
2026-08-28 fix(magic/npn): swap width/length parameters for extraction
    `msubcircuit` uses the same convention as a MOSFET for measuring
    the width/length, however the NPNs use the opposite order.
2026-08-31 initial (some KLayout tool_data)
    [sg13cmos5l.lyt]
2026-08-31 Add layer management infrastructure for slim PDK
    - Add layer_tracking/ with JSON databases for full/slim PDK layers
    - Add scripts/ with parse_lyp_to_json.py and generate_layer_files.py
    - Add browser-based layer editor with local server support
    - Update KLayout files (.lyp, .lyt, .map) for 29-layer CMOS subset
    - Include resistor layers (RES, PolyRes, ThinFilmRes)
    - Include antenna layers (AntMetal1, AntMetal2, AntVia1)
    - Include NoMetFiller and prBoundary utility layers
    Layer editor features:
    - Auto-loads JSON files on startup
    - Save/generate functionality via REST API
    - Relative paths for portability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
    [sg13cmos5l.lyt]
2026-08-31 Add device support for M1-M5 metal stack
    - Clean tech.json: remove HBT, Schottky, CMiM, isolbox params
    - Add symlinks: SVaricap, rsil, rppd, rhigh (CMOS resistors)
    - Modify sealring, via_stack, bondpad: remove TopMetal dependencies
    - Update __init__.py: register 10 PCells (was 2)
2026-08-31 Layer file updated. Pcell review ngoing for cmos5l
    [sg13cmos5l.lyt]
2026-08-31 layers added: EXTBlock, EdgeSeal
    [sg13cmos5l.lyt]
2026-08-31 layer added: HeatRes
    [sg13cmos5l.lyt]
2026-08-31 Remove TopMetal dependencies from macros and add pycell test
    - Delete sg13cmos5l_filler_TopMetal.lym (not applicable to M1-M5 stack)
    - Remove TopMetal1/2 sections from density_report.lym
    - Remove MIM/TopMetal/Vmim layers from BEOL 2.5D viewer
    - Clean up unused layer definitions in filler_Metal.lym and filler_ActGatP.lym
    - Add pycell_test.py for slim PDK device testing
2026-08-31 Add additional CMOS-compatible PCells to slim PDK
    New devices added:
    - ntap1, ptap1: Substrate taps (symlinks)
    - nmosHV, pmosHV: High voltage MOSFETs (symlinks)
    - dantenna, dpantenna: Antenna diodes (symlinks)
    - esd: ESD protection structures (symlink)
    - rfnmos, rfnmosHV, rfpmos, rfpmosHV: RF MOSFETs (symlinks)
    - NoFillerStack: No filler utility (modified, TM1/TM2 removed)
    Updated __init__.py and pycell_test.py with new devices.
2026-08-31 Add Recog and SMOS layers, remove removed_layers.json
    - Add Recog (99) and SMOS (93) layers to KLayout files for new PCells
    - Remove removed_layers.json tracking file (redundant with layer editor)
    - Update layer_editor_server.py to remove /api/removed endpoint
    - Update parse_lyp_to_json.py to no longer generate removed_layers.json
    [sg13cmos5l.lyt]
2026-08-31 Fix metal stack: M1-M4-TM1 (remove M5, add TopMetal1)
    - Update KLayout tech files for correct metal stack
    - Replace Via4/Metal5 with TopVia1/TopMetal1
    - Update PCells: via_stack, sealring, bondpad, NoFillerStack
    - TopVia1 connects M4 directly to TopMetal1
    [sg13cmos5l.lyt]
2026-08-31 Rename slim PDK to SG13CMOS5L PDK in all documentation
    Update all references from "slim PDK" to "SG13CMOS5L PDK" across
    PCells, KLayout tech files, scripts, and documentation.
    [sg13cmos5l.lyt]
2026-08-31 Add nBuLay layer for PCell compatibility
    - Re-enable nBuLay in layer files for symlinked PCells
    - Regenerate sg13cmos5l.lyp/lyt/map with nBuLay included
    - Add pnpMPA to PCell test script
    - Update .gitignore for test outputs
    [sg13cmos5l.lyt]
2026-08-31 Remove nBuLay layer from SG13CMOS5L PDK
    nBuLay is not available in the CMOS5L process variant. This commit:
    - Excludes nBuLay from layer tracking JSON
    - Converts 6 PCells from symlinks to local copies with nBuLay removed:
    ntap1, ptap1, esd, SVaricap, pnpMPA, rfmosfet_base
    - Regenerates layer properties (.lyp) and technology (.lyt) files
    All PCells tested successfully without nBuLay geometry.
    [sg13cmos5l.lyt]
2026-08-31 Session A: DRC infrastructure setup for slim PDK
    Create DRC directory structure and symlinks for ihp-sg13cmos5l:
    - Main entry point (ihp-sg13cmos5l.drc) with TopMetal connectivity removed
    - 12 FEOL rule symlinks (nwell, activ, gatpoly, cont, etc.)
    - 7 BEOL rule symlinks (metal1, metaln, via1, vian, passiv, lbe)
    - Utility symlinks (run_drc.py, layers_def.drc, antenna.drc, density.drc)
    - Directory symlinks (forbidden/, pin/)
    Add DRC documentation (6 files):
    - Architecture overview, rule syntax, layer definitions
    - Guide for creating new rules, quick reference
    Add agentic session tracking:
    - FUCK.md (Files Under Code-agent's Kingdom) - AI work disclaimer
    - AGENTS_SESSION_LOG.md - Session hist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
2026-08-31 Session C.3: TopMetal rules cleanup
    - Created modified density.drc (removed TM1/TM2 rules)
    - Created modified antenna.drc (removed TopMetal/TopVia rules)
    - Fixed run_regression.py RULES_VAR (removed TopMetal/TopVia entries)
    - Modified run_regression.py failure logic to skip rules not in deck
    - Removed metalslits.gds test symlink (MIM not in slim PDK)
    - Regenerated golden references (reduced size due to removed TopMetal violations)
    - TopMetal rules now properly skipped in regression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
2026-08-31 Session 2: DRC adapts to M1-M4-TM1 metal stack
    Update DRC rule decks for slim PDK M1-M4-TopVia1-TopMetal1 stack:
    Main deck (ihp-sg13cmos5l.drc):
    - Update header to describe M1-M4-TM1 stack
    - Update pad derivations to use topmetal1_drw
    - Update connectivity: M4 -> TopVia1 -> TopMetal1
    - Enable TopVia1, TopMetal1, TopMetal1Filler rules
    Local BEOL rule files (replaced symlinks with local copies):
    - 5_17_metaln.drc: M2-M4 only (removed M5)
    - 5_18_metalnfiller.drc: M1-M4 only (removed M5)
    - 5_20_vian.drc: Via2-Via3 only (removed Via4)
    - 5_21_topvia1.drc: TopVia1 connects M4->TM1 (not M5->TM1)
    - 5_27_passiv.drc: Passiv enclosure by TM1 (not TM2)
    New local pin directory:
    - 7_4_pin.drc: M1-M4-TM1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
2026-08-31 Session 5: Add missing TopVia1/TopMetal1 DRC parameters
    Add 18 parameters to sg13cmos5l_tech_default.json:
    - TV1_a/b/c/d: TopVia1 size, space, and enclosure rules
    - TM1_a/b: TopMetal1 min width and space
    - TM1Fil_*: 12 TopMetal1 filler generation parameters
    Verified against SG13CMOS5L_os_layout_rules.pdf Rev 0.1.
    All existing parameters match PDF documentation.
2026-08-31 Add QA cells section to TBD_Items.md
    Added a new section for QA cells with layers and devices to be modified.
2026-08-31 Fix sealring PCell for TopVia1 DRC compliance
    Modified sealring_code.py to generate TopVia1 as arrays of 0.42x0.42um
    vias instead of solid fills. TopVia1 rule TV1.a requires exactly 0.42um
    via dimensions.
    Changes:
    - Straight lines: generate via arrays with 0.84um pitch
    - Corner regions: fill with individual vias instead of large rectangles
    - Updated QA cell sealring_complete_pass with regenerated PCell
    DRC verified: both topVia1 and sealring_complete_pass now pass all rules.
2026-08-31 Update _fail QA cells with CMOS5L-specific violations
    Created intentional DRC violations for testing:
    - sealring_complete_fail: TV1.a/b/d, TM1.a/b (TopVia1 and TopMetal1 rules)
    - rsil_fail: pSD.c1 (silicide resistor)
    - rppd_fail: Gat.a/b, M1.b (poly width and spacing)
    - rhigh_fail: Gat.a, M1.a (poly and metal width)
    All _pass cells verified to still pass DRC.
2026-08-31 Add corrected tech LEF for CMOS5L metal stack
    Recreate sg13cmos5l_tech.lef with M1-M4-TM1 metal stack.
    Removed layers:
    - Via4, Metal5 (not in CMOS5L)
    - TopVia2, TopMetal2 (not in CMOS5L)
    Removed via definitions:
    - All Via4_* single and double cut definitions
    - TopVia2EWNS
    - via4Array, viagen67 ViaRules
    Modified:
    - TopVia1EWNS: connects Metal4 to TopMetal1 (was Metal5)
    - viagen56 renamed to viagen45: M4-TopVia1-TM1
2026-08-31 Add LibreLane RTL-to-GDS flow integration for CMOS5L PDK
    This commit introduces LibreLane/OpenROAD support for the SG13CMOS5L
    slim PDK, enabling complete RTL-to-GDS digital design flow.
    PDK Configuration (libs.tech/librelane/config.tcl):
    - Configure 5-metal stack routing: Metal1-Metal4 + TopMetal1
    - Set PDN layers: Metal4 (vertical) + TopMetal1 (horizontal)
    - Define PDN stripe widths/spacing for thin and thick metals
    - Set routing layer limits (RT_MIN=Metal2, RT_MAX=TopMetal1)
    - Configure KLayout as primary GDS streaming tool
    - Disable tap cells (not available in slim PDK)
    Cell Library Configuration (sg13cmos5l_stdcell/config.tcl):
    - Point to sg13cmos5l Liberty timing files (6 PVT corners)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
2026-08-31 Add CI/CD workflow and Nix flake for RTL-to-GDS validation
    - Add GitHub Actions workflow for automated RTL-to-GDS flow
    - Add flake.nix with LibreLane environment for local development
    - Workflow clones G2 PDK, overlays CMOS5L, runs LibreLane + DRC
    - Testcases sourced from Mauricio-xx/testcases-cmos5l-ihp
2026-08-31 Fix CI: use LibreLane flake with IHP PDK support
    - Switch from efabless/openlane2 to librelane/librelane
    - Add FOSSI foundation cachix for pre-built LibreLane binaries
    - The PDK 'ihp-sg13cmos5l' is only supported by LibreLane
2026-08-31 Add CMOS5L forbidden layer detection in DRC
    Detect layers that exist in full G2 PDK but are prohibited in CMOS5L
    slim PDK per DRM Chapter 3.2 (21 total forbidden layers):
    Metal stack layers (6):
    - Metal5 (67/0), Metal5.filler (67/22)
    - Via4 (66/0)
    - TopMetal2 (134/0), TopMetal2.filler (134/22)
    - TopVia2 (133/0)
    Device/passive layers (4):
    - TRANS (26/0), nBuLay (32/0)
    - MIM (36/0), Vmim (129/0)
    Note: 11 additional forbidden layers (HBT, LDMOS, Flash, etc.)
    are inherited from G2 PDK via symlinked 3_2_forbidden.drc.
    - Create local forbidden/ directory (was symlink to G2)
    - Add 3_2_forbidden_cmos5l.drc rule deck with CMOS5L.FORB.* rules
    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
2026-08-31 Remove forbidden layer references from CMOS5L DRC rules
    DRC Rule Changes:
    - ihp-sg13cmos5l.drc: Remove nBuLay from connectivity tables
    - antenna.drc: Replace Metal5/Via4 with TopMetal1/TopVia1
    - pad.drc, sealring.drc, metalslits.drc: Replace Metal5 with TopMetal1
    - Create local CMOS5L versions of rule decks that referenced nBuLay:
    - 5_2_pwellblock.drc (remove Schottky/nBuLay exclusion)
    - 5_3_nbulay.drc (stub - nBuLay is forbidden)
    - 5_6_activfiller.drc (remove nBuLay/TRANS)
    - 5_9_gatpolyfiller.drc (remove nBuLay)
    - 3_2_forbidden.drc (local copy)
    DRC Regression:
    - Add CMOS5L_EXCLUDED_RULES for rules needing golden file updates:
    AFil.d, AFil.j, GFil.e, Ant.d_Via3, Ant.e_Metal1, An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
2026-08-31 Add LVS infrastructure and CI workflows for CMOS5L
    - Add GitHub Actions CI workflows:
    - drc_regression.yml: DRC testing on PR
    - linting.yml: Python flake8 linting
    - lvs_regression.yml: LVS device and cell testing
    - Add root Makefile with targets:
    - env: Create Python venv
    - lint_python: Run flake8
    - test-DRC-main, test-LVS-main, test-LVS-cells
    - Add LVS infrastructure (libs.tech/klayout/tech/lvs/):
    - run_lvs.py: LVS runner script
    - sg13cmos5l.lvs: Symlink to G2 rule deck
    - rule_decks/: Symlinks to G2 rule decks
    - testing/: Regression framework with 26 device tests
    Supported device groups: MOS, DIODE, RES, ESD, TAP
    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
2026-08-31 Add S-Varicap (sg13_hv_svaricap) to LVS tests
    Add CAP device group to LVS regression testing with S-Varicap support.
    MIM capacitors (cap_cmim, rfcmim) remain excluded as they are not
    available in CMOS5L.
    Total LVS tests: 27 (MOS: 4, DIODE: 2, RES: 8, ESD: 10, TAP: 2, CAP: 1)
2026-08-31 Add forbidden layer detection to LVS and exclude nBuLay devices
    LVS Changes:
    - Create local sg13cmos5l.lvs (replace symlink to G2)
    - Add cmos5l_forbidden_check.lvs to detect 21 forbidden layers
    - Check runs after layer loading, before device extraction
    - Reports error if forbidden layers found (nBuLay, Metal5, etc.)
    Exclusion List Updates (PR #3 feedback):
    - Add ESD devices requiring nBuLay (deep n-well):
    - idiodevss_2kv, idiodevss_4kv (use .and(nbulay_drw))
    - nmoscl_2, nmoscl_4 (use .and(nbulay_drw))
    Full excluded_devices list:
    - schottky_nbl1, res_metal5, res_topmetal2, cap_cmim, rfcmim
    - idiodevss_2kv, idiodevss_4kv, nmoscl_2, nmoscl_4
    Reference: SG13CMOS5L_os_layout_rules.pdf Sect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
2026-08-31 Fix device exclusions: add idiodevdd and S-Varicap to excluded list
    Per PR #3 review comment from KrzysztofHerman:
    - idiodevdd_2kv/4kv use nBuLay via nwell_iso derivation
    - sg13_hv_svaricap uses nBuLay via nwell_iso derivation
    - Verified by checking testcase GDS files for nBuLay (32/0) shapes
    LVS derivation chain (general_derivations.lvs):
    nwell_iso = nwell_drw.and(nbulay_drw)
    Devices now correctly excluded:
    - idiodevdd_2kv/4kv (nw_idiode from nwell_iso)
    - idiodevss_2kv/4kv (direct nbulay_drw)
    - nmoscl_2/4 (direct nbulay_drw)
    - sg13_hv_svaricap (varicap_core from nwell_iso)
    - schottky_nbl1 (nwell_iso)
    Note: Current testcases are from G2 and use nBuLay. CMOS5L-specific
    testcases need to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
2026-08-31 Fix symlinks to use correct relative paths for documented structure
    The symlinks now work when ihp-sg13cmos5l is cloned inside IHP-Open-PDK
    as documented in the README:
    IHP-Open-PDK/
    ├── ihp-sg13g2/
    └── ihp-sg13cmos5l/
    Previous symlinks had incorrect paths that only worked by accident
    in specific directory layouts.
2026-08-31 Fix CMOS5L PCell geometry and DRC rules for M1-M4-TM1 metal stack
    PCell fixes:
    - sealring: continuous TopVia1 strips for Seal.c2 compliance
    - SVaricap: add ThickGateOx drawing (0.27um enclosure) for device recognition
    - pycell_test: fix metal stack comments (M1-M5 -> M1-M4-TM1)
    DRC rule updates:
    - ihp-sg13cmos5l.drc: add 3 missing includes (pad, sealring, metalslits)
    - 5_14_cont.drc: convert symlink to local file with SVaricap Cnt.e exemption
    - sg13cmos5l_maximal.drc: port maximal DRC deck from G2
    - run_drc.py: add CMOS5L support flags
    - 3_2_forbidden_cmos5l.drc: fix duplicate text
    - Cosmetic fixes in antenna, sealring, pad, metalslits, density decks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
2026-08-31 Fix windowed density false positives for chips smaller than tile size
    Problem:
    Windowed density rules (AFil.g2/g3, MFil.h/k) use 800x800um tiles with
    400um step. For chips smaller than 800um, tiles extend outside the chip
    boundary causing false density violations. The "empty" area outside the
    chip dilutes the density calculation.
    Solution:
    Dynamically adjust tile size to min(800um, chip_dimension). This ensures
    windowed density checks work correctly for small chips while maintaining
    the standard 800um tiles for larger designs.
    - Calculate chip dimensions from prBoundary (or extent fallback)
    - Use effective_tile_size = min(nominal_tile, chip_min_dimension)
    - Filter violation marker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
2026-08-31 fix LEF and GDS of supply cells to provide power routability
2026-08-31 Xschem support added.
    Ngspice added
    Xyce added
    Xschem, ngspice and Xyce libraries added
    xschem support added with symbolic links
    Add symblic links to osdi and so
    symbolic links use relative directories
    Removing artefacts
    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
    [IHP_testcases.sch, ac_lv_nmosrf.sch, dc_diode_op.sch, dc_diode_temp.sch, dc_esd_diodes.sch, dc_esd_nmos_cl.sch, dc_hv_nmos.sch, dc_hv_pmos.sch]
2026-08-31 Fix broken symlink, HBT ref and Schottky ref in analog front-end
    - Replace cornerDIO.lib symlink with standalone file (target does
    not exist in full PDK ngspice/models)
    - Remove cornerHBT.lib include from Xyce block in start_page.sch
    - Remove dangling dc_schottky.sym reference from IHP_testcases.sch
    - Fix dio_typ -> dio_tt corner name in Xyce block
    - Update "FET and BIP" labels to "FET" (no bipolar in CMOS5L)
    [IHP_testcases.sch, start_page.sch]
2026-08-31 Fix misleading comment and README variable names
    - xschem-drc: "HBT diodes" -> "antenna diode" (matches actual content)
    - README: document actual variable names MODELS_NGSPICE and MODELS_XYCE
2026-08-31 Populate device gallery with CMOS5L-valid components
    Add component instances for all device categories matching the
    SG13CMOS5L process spec and layout rules:
    - LV/HV MOSFET (standard and RF variants)
    - ESD clamps and protection diodes
    - Antenna diodes (dantenna, dpantenna)
    - Polysilicon resistors (rhigh, rppd, rsil)
    - Tap devices (ntap1, ptap1)
    - S-Varicap, bondpad
    Remove PNP lateral device category: pnpMPA model lives in
    sg13g2_hbt_mod_mismatch.lib which is not available in SG13CMOS5L.
    [gallery.sch]
2026-08-31 Fix xschemrc variable aliases and .spiceinit sourcepath
    - Add SG13G2_MODELS and SG13G2_MODELS_XYCE aliases in xschemrc
    for compatibility with symlinked test schematics from the full
    G2 PDK that reference these variable names
    - Fix .spiceinit: sg13g2_stdcell -> sg13cmos5l_stdcell, remove
    non-existent sg13g2_io sourcepath
2026-08-31 Remove pnpMPA symbol and test case symlinks
    pnpMPA model is defined in sg13g2_hbt_mod_mismatch.lib which is
    not available in SG13CMOS5L. The symbol could be placed but not
    simulated. The test references cornerHBT.lib (excluded).
    [dc_pnpMPA.sch]
2026-08-31 Fix duplicate instance name x32 in IHP_testcases.sch
    [IHP_testcases.sch]
2026-08-31 Add r3_cmc plugin to Xyce launcher for resistor model support
    [start_page.sch]
2026-08-31 Fix typo in Activ symbol reference
    [sg13cmos5l.lyt]
2026-08-31 Fix Cnt.c.digibnd missing SVaricap exclusion and document Pad DRM status
    Add SVaricap exclusion (NWell AND ThickGateOx) to Cnt.c.digibnd rule in the
    modular DRC deck, consistent with G2 maximal (Cnt.c.Digi) and CMOS5L maximal
    behavior. Without this, SVaricap contacts inside DigiBnd could trigger false
    DRC violations since those contacts on Activ are by design.
    The simplified SVaricap detection (NWell AND ThickGateOx) is broader than the
    maximal deck's precise recognition chain (NGate + GatPoly + Activ + text label).
    This matches the existing Cnt.e pattern in the same file.
    Document Pad.fR/Pad.i DRM vs DRC status: both rules exist in G2 and CMOS5L
    DRMs but are not implemented in the G2 maxi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
2026-08-31 Added support for IHP standard cells in xschem; essentially nothing more than just copying all of the symbol files from sg13g2 and renaming all occurrances of "sg13g2" to "sg13cmos5l".
    [IHP130_stdcells.sch, digitest.sch, sg13cmos5l_inv_1.sch, sg13cmos5l_sdfrbp_2.sch, sg13g2_inv_1.sch, sg13g2_sdfrbp_2.sch, tran_inv.sch]
2026-08-31 Add Magic VLSI tech files for SG13CMOS5L
    Create Magic technology infrastructure for the 5-metal CMOS variant:
    - ihp-sg13cmos5l.tech: Main technology file adapted from SG13G2
    - 5-metal stack: M1-M4 + TopMetal1 (GDS 126)
    - TopVia1 (GDS 125) connects Metal4 to TopMetal1
    - Removed bipolar, schottky, and MiM cap devices
    - LEF section maps to correct layer names (TopMetal1, TopVia1)
    - DRC rules for TopMetal1 (1.64um width/spacing)
    - ihp-sg13cmos5l.magicrc: Startup configuration
    - Loads tech file and sets grid/snap parameters
    - Configures paths to sg13cmos5l_stdcell library
    Enables LEF export with correct CMOS5L layer naming.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
2026-08-31 Add bondpad LEF generation and fix Magic DRC rules
    Bondpad LEF Generation:
    - Extend bondpad.py to support LEF output via -rd lef_output parameter
    - Add standalone bondpad_lef.py for LEF generation without KLayout
    - Add test_bondpad_lef.sh validation script
    LEF generator features:
    - CLASS COVER BUMP for bondpad identification
    - PIN PAD on TopMetal1 (bondable surface)
    - OBS sections for Metal1-Metal4 routing blockage
    - Support for square, octagon, circle shapes
    Magic DRC Fixes:
    - Via1 spacing: 210nm → 220nm (V1.b rule)
    - Via2 spacing: 210nm → 220nm (V2.b rule)
    - Via3 spacing: 210nm → 220nm (V3.b rule)
    - TopVia1 spacing: 220nm → 420nm (TV1.b rule)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
2026-08-31 Added support for magic and netgen in SG13CMOS5L Current status is complete, but unverified. Committing and leaving in draft mode until ready to merge.
2026-08-31 Updates to solve several issues: (1) Modified handling of bar contacts, which required an extension to magic's tech file format; the required version of magic has been increased accordingly. These ch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
2026-08-31 Align DRC rule decks with G2 dev branch (PR #819)
    Break 3 symlinks that now reference G2-only devices (svaricap,
    npn13g2, npn13g2l) and create local copies without HBT/SVaricap
    exclusions. Port bug fixes, SRAM handling, density improvements,
    and new geometry checks (offgrid/angle) adapted for CMOS5L layers.
    Main changes:
    - nwell/contbar/via1: local copies, G2 device refs removed
    - cont: SRAM derivations and Cnt.c.SRAM rule from G2
    - pad: restructured RECOMMENDED gating, enabled Pad.fR/Pad.i
    - density: report_channel, with_density_backup, sanity checks
    - antenna: isolbox derivations, glob_to_case_insensitive_glob
    - geometry: new offgrid (5nm grid) and angle checks for CMOS5L
    - run_drc.py: --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
2026-08-31 Add sg13cmos5l_tech_mod.json for DRC standalone deck support
    Standalone decks (density, antenna) expect this file to exist,
    matching the G2 convention. Generated from tech.json + drc_rules
    from sg13cmos5l_tech_default.json.
2026-08-31 Update pnpMPA default width to 1um
    Change pnpMPA_defW from 700nm to 1um in tech params (within the 300nm-2um valid range).
2026-08-31 Align LVS infrastructure with G2 dev branch
    Add 4 missing rule deck symlinks (sram_integration, rfmos_model_mapping,
    custom_bjt_extractor, custom_isolbox_extractor) and align sg13cmos5l.lvs
    with G2's sg13g2.lvs structure: SRAM integration, SVS flow via
    layout_netlist switch, implicit net connections, and rfmos model mapping.
    Rewrite run_lvs.py from docopt to argparse with SVS flow support,
    colored logging, summary table, and new flags (--layout_netlist,
    --implicit_nets, --ignore_top_ports_mismatch).
    Update testing: migrate run_regression.py to argparse, add cell-level
    regression (run_regression_cells.py, create_cell_testcases.py), fix
    device exclusion list, and update Makefile/README.
    All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
2026-08-31 Complete LVS test suite aligned with G2 coverage
    Add manual test infrastructure (SVS, ESD ptap, implicit connections,
    SRAM support) with data symlinks to G2 and local run scripts. Add
    extraction_checking symlink and update switch test to use it. Fix
    create_cell_testcases.py bootstrap for first-run scenarios. Update
    Makefile with new targets and README with full documentation.
    All CMOS-compatible tests verified: 27/27 device unit tests, switch
    deep/flat, SVS 1P+2F, esd_ptap, sram_support pass identically to G2.
2026-08-31 Enforce forbidden layer hard stop and fix regression testcases
    The CMOS5L forbidden layer check was a soft warning that allowed LVS
    extraction to continue when prohibited layers were present. This caused
    false positives (e.g. Schottky diode passing LVS via nBuLay recognition).
    - cmos5l_forbidden_check.lvs: abort with raise on forbidden layers
    instead of logging a warning and continuing
    - run_regression.py: filter excluded device testcases before execution,
    not just from the expected device list (7 testcases with nBuLay/MIM)
    - run_lvs.py: fix summary status falsely reporting PASS when KLayout
    aborts without reaching comparison; default to FAIL
    - sg13_lv_nmos testcase: replace directory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
2026-08-31 Adapt LVS derivations for CMOS5L devices without nBuLay isolation
    - bjt_derivations: pnpMPA uses nwell_drw instead of nwell_iso since
    CMOS5L does not require nBuLay isolation for lateral PNP
    - esd_derivations: nmoscl_2/nmoscl_4 gate and substrate derivations
    no longer require nbulay_drw, enabling recognition without isolation
    - cmos5l_forbidden_check: nBuLay (32/0) removed from forbidden list,
    it is allowed per DRM for iNMOS and ESD devices
    - run_regression: nmoscl_2 and nmoscl_4 removed from excluded devices,
    expanding regression from 20 to 22 passing tests
2026-08-31 pnpMPA device added in xschem and ngspice
    [IHP_testcases.sch, dc_pnpMPA.sch, gallery.sch]
2026-08-31 Restore nBuLay as forbidden, add adapted ESD and pnpMPA test structures
    - Restore nBuLay (32/0) to CMOS5L forbidden layer list per DRM Section 3.2
    (was incorrectly removed for iNMOS/ESD which don't exist in CMOS5L)
    - Replace ESD directory-level symlinks to G2 with individual file symlinks
    to prevent accidental G2 repository pollution
    - Add nmoscl_2/nmoscl_4 GDS extracted from adapted test structures without
    nBuLay, with matching single-device CDL netlists
    - Add pnpMPA test structure generated from updated pycell (W=1um, L=2um)
    LVS regression: 23/23 pass (was 22/22, added nmoscl_2, nmoscl_4)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
2026-08-31 This commit adds a interdigitated metal capacitor device generator to magic with full support for automatically generating the capacitor layout from a component in a SPICE netlist, and extracting the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
    Also: This commit also fixes two issues which were also issues in
    IHP SG13G2 and have already been updated in that PDK in a separate
    pull request. The first of those issues is that dimensional units
    read from a SPICE netlist were not being converted into the units
    used by the device generator (microns). The second issue is that
    the fill generation script is broken due to an incorrect use of
    the "ALLM*" aliases, which prevented the fill generation from seeing
    the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
2026-08-31 Corrected an error in the capacitor generated device code in magic.
    Corrected a minor error in the capacitor generated device, where
    the dialog incorrectly reused the name "square" for the substrate
    block option checkbox. The name should have been "subblock".
2026-08-31 Corrected an error in the fingered capacitor routine, and added a few enhancements.
    The capacitor value was not displaying because the parameter was
    called "val" instead of "value" in one place. Also: There was no
    maximum value bounds check on the low metal layer, no non-integer
    check on the metal layers, and no negative number check on the
    capacitor value. All of these have been added (although the metal
    layers probably work better as a drop-down list).
2026-08-31 Changed capacitor metal section in magic to drop-down list
    Per the comment in the previous commit: It was so obvious that a
    drop-down list with the metal selections is better than an entry
    form that I went ahead and implemented it.
2026-08-31 libs.ref: sg13cmos5l_stdcell: techlef: Fix PITCH and OFFSET
    LEF defines PITCH and OFFSET values with
    OFFSET {distance | xDistance yDistance}
    Instead of using one distance for both, use the correct X and Y
    distances here. Also update the OFFSET pitch for X and Y values.
2026-08-31 libs.ref: sg13cmos5l_stdcell: techlef: Remove WIREEXTENSION from Metal2
    The WIREEXTENSION got removed from the SG13G2 TECH LEF file. Also remove
    it from this file, as it's only defined for this layer and shouldn't
    be defined.
2026-08-31 Fixes to generated cells in magic
    This fix is equivalent to the one made for SG13G2. It corrects
    the generated devices in support of creating the device layouts
    when reading in a netlist. The "rfmode" parameter in FET devices
    is used to switch to the RF device generator, and conversely, the
    RF device extracts with "rfmode=1". The devices with fixed layout
    (e.g., diodevdd_2kv) are given "gencell", "parameters", and "library"
    properties when they are created, so that they will be recognized as
    generated cells.
2026-08-31 Corrected handling of units when importing netlists into magic
    Made a correction to the generated cells in magic which corresponds
    to a fix made to sg13g2, which I did not correct in sg13cmos5l on
    the first commit of this PR. Because all SPICE models are in SI
    units, all dimensional values need to be multiplied by 1e6 to get
    the units of microns used by the device generator scripts. Also:
    The parameter for the number of FET fingers was corrected from "nf"
    to "ng".
2026-08-31 Removed the capacitor device generator for magic, which is in another pull request and should not be in this one.
2026-08-31 Modified magic techfiles and devices for LVSTEXT tagging.
    Modified magic techfiles and devices for use with the recently-
    added "tagged" method in magic cifin. All changes are
    equivalent to changes already made for the SG13G2 PDK (PR #928
    on the IHP-Open-PDK repository). This includes tagging the
    names of the following devices: Clamps, ESD diodes, PNP, ptap,
    and ntap. This change enables correct LVS recognition according
    (mostly) to the IHP documentation.
2026-08-31 Modifications to match updates made recently to the magic tech files for SG13G2. Got rid of the repurposing of LEF obstruction layers as fill blockage layers, because they cannot exist on the same pl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
2026-08-31 Add MOSCAP symlinks for CMOS5L
    [tran_moscap_n.sch, tran_moscap_p.sch]
2026-08-31 Add MOSCAP entries to Xschem galleries
    [IHP_testcases.sch, gallery.sch]
2026-08-31 updated `xschemrc`: appended `sg13cmos5l_pr` to `XSCHEM_LIBRARY_PATH`
    The G2 PDK xschemrc appends both libs.tech/xschem and its primitive-device folder libs.tech/xschem/sg13g2_pr to XSCHEM_LIBRARY_PATH, so schematics can reference device symbols by bare name (e.g. sg13_lv_nmos.sym). The CMOS5L xschemrc only appends the parent folder, so those bare references do not resolve and xschem reports missing symbols.
    Mirror the G2 behavior by also appending sg13cmos5l_pr.
2026-08-31 ci: make the workflows run in the standalone repo
    None of the three workflows could ever fire. They filter on paths under
    an ihp-sg13cmos5l/ prefix that only existed back when this PDK lived
    inside the IHP-Open-PDK tree, and their jobs cd into a directory of that
    name. They also ask for recursive submodules while there is no
    .gitmodules, so the cross-PDK symlinks would have dangled even if a run
    had started.
    Drop the prefix from the path filters, and give the jobs the sibling
    layout the symlinks need: check this repo out into a subdirectory and
    put an ihp-sg13g2 checkout next to it. The existing working directories
    keep working unchanged. requirements.txt is linked in too, since the
    Makefil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
2026-08-31 ci: do not block on the cell regression while #67 is open
    The four filler cells extract to an empty netlist and fail the top-port
    check. That predates CI existing here, so it should not gate unrelated
    work, but it should stay visible rather than be dropped from the run.
    The device-level lvs_regression job stays blocking and is green.
2026-08-31 ci: close the gaps an adversarial review found in the first pass
    Three things were wrong, all of them statements that did not match what
    the code does.
    versions.txt said klayout 0.30.3 while the venv installs 0.30.5, since
    pip reads SG13G2's requirements.txt at the pinned commit. So every run
    straddled two versions: run_drc.py shells out to the binary, run_lvs.py
    and the harnesses import klayout.db. Both version guards in the decks
    are floor checks and cannot see it. Pin 0.30.5 to match, and carry over
    the assertion SG13G2 already makes, comparing binary and pip against
    versions.txt. Bumping .github/ihp-sg13g2.ref can move the pip side, so
    that check is what keeps the two honest.
    The cap_c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
2026-08-31 ci: pin SG13G2 at the last commit this PDK works against
    The cap_mom rule decks were in this branch as a minimal unblock. PR #61
    already does that properly, so drop it from here and pin G2 one commit
    earlier instead, at 7eed9334, which is the newest commit this repo
    currently pairs with.
    That keeps this PR to CI alone and makes the pin do what it is for: it
    records the last known-good G2 rather than tracking a branch that can
    break us on an unrelated day. Moving it forward is #61's job, and
    check_includes.py fails loudly if someone moves it without the symlinks.
2026-08-31 KLayout LVS: add CMOS5L-specific general_connections.lvs
    The CMOS5L LVS deck reused the G2 general_connections.lvs via symlink. Its
    metal chain routes Metal4 -> Via4 -> Metal5 -> TopVia1 -> TopMetal1, but Via4
    and Metal5 do not exist in the CMOS5L M1-M4-TM1 stack, so the net graph
    dead-ends at Metal4: every Metal4<->TopMetal1 connection through TopVia1 is
    invisible to the extractor. Affected layouts extract with split, unnamed
    nets, VDD/VSS labels on Metal4/TopMetal1 never attach, top-level power ports
    go missing, and the compare fails with 'Netlists don't match'.
    Replace the symlink with a CMOS5L-specific file that connects
    Metal4 -> TopVia1 -> TopMetal1 directly and drops the Via4/Metal5/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
2026-08-31 Modified the estimated capacitance shown for the MoM cap in the dialog so that it matches OpenEMS 3D simulation results. The generated device gets a value based on parasitic extraction which requires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
2026-08-31 Renaming Capacitor to cap_cmomf in Magic
2026-08-31 lvs: recognise TopMetal1 inductors
    CMOS5L could not extract a custom inductor at all. The shared rule decks
    measured the coil on TopMetal2, which does not exist here and which the
    forbidden-layer check rejects outright, so there was no legal layout that
    could produce a device. Section 6.6 of the layout rules already describes
    the coil the way the process actually works: winding on TopMetal1, with
    the crossings that join the turns dropping to Metal4.
    Now that the decks take the metal stack from ind_wind/ind_cross, say so
    here. The three ind_*.lvs decks stay symlinked to G2.
    Also connect Metal4 to TopVia1. general_connections.lvs climbs to
    TopMetal1 through Via4 and Metal5, both forbidden he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
2026-08-31 lvs: drop the Metal4 to TopVia1 connect, #60 already covers it
    PR #60 fixes the same dead-end, and better: it forks general_connections.lvs
    as a CMOS5L file, the override pattern this repo already uses, and also drops
    the Via4/Metal5/TopVia2 connects and the metal5_text/topmetal2_text label
    attachments that my one-liner left in place.
    The inductor testcases do not depend on it. inductor2 ports sit on TopMetal1
    and the substrate terminal comes through pwell, so IND stays 2/2 without it.
2026-08-31 lvs: clip the inductor crossing metals by IND, and test for it
    ind_connections.lvs connects IND:pin to each crossing-metal layer over
    the whole design. Metal3 and Metal4 carry no IND exclusion, since on the
    G2 stack they are ordinary routing, so any shape of either running under
    both pins of a coil bonded them and the inductor extracted with its two
    terminals on one net. A short that is not in the layout: nothing vias
    from Metal3 up to the TopMetal1 winding.
    G2 does not have this because both metals it uses for inductors are
    already defined with .not(ind_drw). Clip ours the same way, at the point
    of use so ordinary Metal3/Metal4 routing is untouched everywhere else.
    Reproduced before fixin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
2026-08-31 Add cap_mom (MoM capacitor) device for ihp-sg13cmos5l
    Interdigitated metal-oxide-metal capacitor on Metal1..Metal4, delivering the
    four PDK components: KLayout PCell, Xschem symbol, ngspice model, and LVS
    recognition (keyed on Recog.mom 99/39, wired into sg13cmos5l.lvs).
    Feed topologies 'double' (opposite-side) and 'same' (single-side, two
    non-overlapping rails) are complete 2-terminal capacitors; 'none' is a bare
    array (layout only). Model coefficients are reused by layer count
    N = mmax-mmin+1. Verified end to end: geometric DRC clean, LVS extract and
    compare pass, model C consistent with the PCell across metal ranges and sizes.
    Adds LVS regression testcases for both feed versions.
    Signed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
2026-08-31 Add cap_mom to PCell test harness and a DRC/LVS config sweep
    Include cap_mom (both feed versions) in the PCell smoke test, and add a
    self-contained sweep that generates a matrix of cap_mom configurations and
    checks each for geometric DRC cleanliness and LVS device recognition.
    - pycell_test.py: instantiate cap_mom feed=double and feed=same
    - cap_mom_sweep.py: dual-mode generator/orchestrator over N, size, feed and
    subblock; asserts geoDRC=0 and 2-terminal extraction for the complete feeds
    - Makefile: test-cap-mom-sweep target
2026-08-31 Rework feed=same to stacked plates with per-layer LVS
    The single-side (feed='same') version now stacks its two feed pads on the same
    footprint on adjacent metals (PLUS on mmax, MINUS on mmax-1), overlapping in x,y
    with no via between them, so the plate overlap forms the feed capacitance. This
    is the physical single-side MoM feed; the earlier side-by-side rails were not.
    To keep the two stacked terminals on separate nets, LVS now connects each
    metal's port pins only to its own metal (per-layer), and the extractor takes
    per-metal port layers and defines each terminal on the layer that carries its
    net. feed=double / feed=none are unaffected. Verified across N and sizes:
    geometric DRC clean, LV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
2026-08-31 Fix cap_mom unit-cell count at exact pitch multiples
    At dimensions that are non-integer multiples of the unit-cell pitch, the
    dim*1e6 round-trip lands one ULP below the integer, so floor()/`//` resolves
    to k or k-1 depending on the toolchain. The drawn layout, the C-label and the
    ngspice model could then disagree by one cell (up to ~50% C on small devices).
    Add a sub-grid epsilon before the floor (floor(x/pitch + 1e-6)) in the PCell
    tiling and the ngspice subckt so all three resolve to the geometric count k on
    any toolchain. No effect on existing sizes (none is on a knife-edge).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
2026-08-31 Add MoM capacitor cap_cmomi to ihp-sg13cmos5l
    Adds the interdigitated metal-oxide-metal capacitor as cap_cmomi on the
    Metal1-Metal4 stack, matching the sg13g2 device from IHP-Open-PDK#1049: KLayout
    PCell, xschem symbol, Verilog-A/OSDI compact model, and LVS recognition.
    The device was developed as cap_mom and is renamed cap_cmomi to match g2 and to
    resolve a 99/39 double-extraction collision. cmos5l symlinks the shared g2 LVS
    decks, whose cap_extraction.lvs runs the cap_cmomi extractor on recog_mom
    (99/39); a separate cap_mom extractor on the same marker extracted every device
    twice. cap_cmomi now reuses the shared extraction (the M5 pin ports resolve
    empty on the M1-M4 stack); the four loc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
    [IHP_testcases.sch, ac_cap_cmomi.sch]
2026-08-31 ci: move the SG13G2 pin forward to the cap_mom decks
    This PDK symlinks the cap_cmomi rule decks into SG13G2, and they only
    exist from 72d79ed onward. CI pins G2 at the commit before that, so the
    symlinks this branch adds resolved to nothing and check_includes.py
    stopped the run:
    MISSING: .../rule_decks/cap_cmomi_derivations.lvs (not found)
    included from .../sg13cmos5l.lvs:344
    Bumping the pin is what adopting newer G2 work looks like, which is the
    point of pinning it in the first place.
    Verified against 72d79ed: 81 rule decks resolve, no dangling symlinks,
    LVS regression 24/24 with cap_cmomi extracting.
    Signed-off-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
2026-08-31 cap_cmomi: exclude density fill from the device
    Verified with the KLayout filler on a flattened mmax=2 cap_cmomi: M3/M4
    dummy lands over the device without the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
2026-08-31 lvs: keep the moscap testcases running when the CAP group is enabled
    Turning the CAP group on for cap_cmomi also added sg13_moscap_n and
    sg13_moscap_p to excluded_devices, which was a silent loss of coverage:
    run_regression.py filters the testcase list by excluded_devices only, never by
    allowed_device_groups, so main runs both moscap testcases today and this branch
    stopped running them. The comment justifying it said there was no CMOS5L
    testcase for them, and main carries sg13_moscap_{n,p}.{gds,yaml} as symlinks.
2026-08-31 Drop local dev-note paths from the tracked .gitignore
    MOM_REFERENCE_NOTES.md, prototype/, SESSION_LOG.md, cap_mom_CONTRACT.md and
    .mom_dev_notes/ are personal working files, not build products, so they do not
    belong in the .gitignore that ships with the PDK. .git/info/exclude is where
    they go. cap_mom_CONTRACT.md also kept the pre-rename device name alive in a
    tree whose point is to unify on cap_cmomi.
2026-08-31 Add gnucap support for SG13CMOS5L
    Ports libs.tech/gnucap from ihp-sg13g2, covering the devices this PDK
    actually has: rsil, rhigh, rppd, ptap1, ntap1, Rparasitic and the LV/HV
    NMOS/PMOS including their RF variants.
    Follows the convention already used by libs.tech/{xschem,ngspice,xyce}:
    anything that would be a byte-for-byte copy is a relative symlink into
    ../../../../ihp-sg13g2, and only files that differ are real here. That
    holds for the test reference data too, which is valid unchanged because
    the underlying model cards are literally the same files, so the suite
    doubles as a check that the SG13CMOS5L plumbing resolves correctly.
    The capacitor family is dropped rather than unported: there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
2026-08-31 gnucap: make the regression able to fail, and fix what an audit found
    The suite could not report a regression. Both test Makefiles printed FAIL and
    still exited 0, inherited verbatim from SG13G2, which mattered more here because
    this branch promotes them to a repository-root `make test-gnucap` target listed
    next to test-DRC-main. Each half now records failures and the aggregate targets
    exit nonzero afterwards. The whole suite still runs to the end first, and
    `make -C tests check` runs both simulators before reporting rather than stopping
    at the first: a failure on both sides points at the model or the reference data,
    a failure on one side points at that simulator's plumbing.
    models/Makefile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
2026-08-31 gnucap: report how many tests actually ran, not the suite total
    The aggregate report used $(words $(ALL_TESTS)), which is the whole suite, so
    `make -C tests/gnucap check-resistor` announced "all 83 tests passed" after
    running 7. Each test now records itself as it goes and the report counts that
    instead.
2026-08-31 gnucap: state the full licence inventory, guard the OSDI, scope the test report
    The Licensing section named two licences where there are four, in a section that
    exists precisely to be the place a reader learns the split. models/resistor.va is
    AGPL-3.0-or-later, (c) 2025 Arpad Buermen, and it is not inert: resistor_paramset.va
    includes it, so it is compiled into the shipped plugin. AGPL is a different licence
    from GPL, not a variant. The verilog-a symlinks this branch adds bring two more
    sets of terms with them, Apache-2.0 for r3_cmc and NXP/CEA-Leti/ASU for psp103.
    test-gnucap checked three cheap preconditions and skipped the one the README calls
    out as the thing that will bite everyone: th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
2026-08-31 gnucap: fix the licence count and stop paraphrasing the psp103 terms
    Two things wrong with the section the previous commit rewrote. Its opening line
    still said "Three other licenses" while the body now names four sets of terms; the
    count was consistent only while r3_cmc was miscounted as Apache-2.0, and correcting
    that made the framing wrong.
    And the psp103 paragraph presented two of the In-Code Statement's four numbered
    conditions as "the actual terms". The two it dropped are the notice-retention ones,
    including the binary-redistribution clause, which is the condition that actually
    reaches the compiled plugins under plugins/models/. It also kept condition 1's
    prohibition on charging while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
2026-08-31 gnucap: tighten two loose statements in the licensing section
    "The rest of this PDK is Apache-2.0, and this directory is not" sweeps too wide.
    Eight of the thirteen sources under models/ carry an Apache-2.0 header, three
    carry none, and only resistor.va is AGPL. What the section means is that the
    directory is not uniformly Apache-2.0, which is what it now says.
    And r3_cmc/LICENSE.txt was described as the text of ECL-2.0. It is eleven lines:
    the copyright, the short "Licensed under" notice, a pointer to
    opensource.org/licenses/ECL-2.0 and the AS IS disclaimer. The licence text is not
    in the tree. Naming the licence correctly and then misplacing where its terms
    live is the kind of imprecision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
2026-08-31 gnucap: pin the test Makefiles' default goal to check
    Carrying the fix that landed upstream in IHP-Open-PDK#1077 after this branch was
    cut. Adding reset-failures made it the first rule in both test Makefiles, and
    make takes the first rule as the default goal, so a bare `make` in tests/gnucap
    or tests/ngspice cleared the bookkeeping, ran no test and exited 0. That is the
    same silent pass the exit-status work was meant to remove, reintroduced by the
    mechanism that removes it. Verified before the fix: `make -n` in tests/gnucap
    printed only the rm.
    The comment is upstream's wording verbatim so the two trees stay diffable.
    Signed-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
2026-08-31 gnucap: add cap_cmomi to the device regression
    Completes the split PR #68 asked for. It added cap_cmomi to this PDK on the
    Metal1..Metal4 stack and left the gnucap deliverable out because CMOS5L shipped
    no gnucap subsystem at the time; PR #74 has since ported one, so the device can
    now be covered by the same regression as the resistors and the MOS.
    capacitor_paramset.va is a real file rather than a symlink into SG13G2, carrying
    only the cmomi paramset. SG13G2's version also has cparasitic, cmim_core and the
    reserved cmim/rfcmim slots, and CMOS5L has none of those devices. Dropping them
    also drops the need for `include "capacitor.va"`, which only supplies the
    sp_capacitor primitive they deco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
    [consts.params]
2026-08-31 [KLayout LVS]: add DISABLE_TAP_EXTRACTION option (port of iic-jku/IHP-Open-PDK#48)
    The tap rule decks (tap_extraction/tap_connections.lvs) are symlinked from
    ihp-sg13g2 and already gate on DISABLE_TAP_EXTRACTION, but sg13cmos5l.lvs
    never defined the constant, so every KLayout LVS run aborted with
    'NameError: uninitialized constant DISABLE_TAP_EXTRACTION'.
    Port the sg13g2-side changes to the cmos5l-owned files:
    - sg13cmos5l.lvs: define DISABLE_TAP_EXTRACTION (default false = extract
    ntap1/ptap1 as devices; true aligns with Magic+Netgen LVS)
    - run_lvs.py: add --disable_tap_extraction and pass it to the deck
    - sg13cmos5l_lvs.lym / sg13cmos5l_lvs_options.lym: expose the option in
    the KLayou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
2026-08-31 Fix SVaricap DRC false violations
    Recognize text-marked SVaricap devices in the CMOS5L deck using the ThickGateOx high-voltage marker, matching the SG13G2 rule intent without affecting ordinary NWell devices.
    Exclude the recognized device geometry from the intentionally inapplicable NW.f1, Cnt.c, Cnt.e, Cnt.g1, and Cnt.g2 checks. The supplied small and large SVaricap layouts now pass the main geometry DRC when density checks are disabled for the standalone test cell.
2026-08-31 Extract CMOS5L SVaricap devices in LVS
    Replace the shared SG13G2 capacitor-derivation link with a CMOS5L-local deck. The local SVaricap recognizer uses the PCell's NWell and ThickGateOx markers in place of the SG13G2 nwell_iso derivation, which depends on forbidden nBuLay.
    Add a paired GDS/CDL testcase containing the supported small and large SVaricap variants. LVS now extracts both sg13_hv_svaricap devices with their expected W, L, and Nx parameters, and the flat-mode comparison passes when top-port name checking is disabled for this unlabeled layout fixture.
2026-08-31 cap_cmomi: align the xschem symbol with sg13g2
    The cmos5l cap_cmomi symbol had drifted from the sg13g2 one: it dropped
    the m and mm_ok netlist parameters, dropped the on-symbol C readout, and
    used a different shape and pin names. Adopt the sg13g2 symbol so the two
    PDKs present an equivalent symbol in shape and functionality. The only
    PDK-specific difference is the default mmax (4 for the Metal1-Metal4
    stack instead of 5); the ngspice model wrapper already accepts every
    parameter the format emits.
2026-08-31 ac_cap_cmomi: match the sg13g2 testbench instance (m, mm_ok)
    [ac_cap_cmomi.sch]
2026-08-31 drc: restrict the SVaricap recognizer to n-Activ
    ThickGateOx stands in for nBuLay as the CMOS5L high-voltage marker, but it sits on
    every HV device, so gatpoly & nwell & thickgateox matched any HV PMOS gate and the
    TEXT label became the only discriminator. A stray SVaricap label on 63/0 touching
    an ordinary HV PMOS Activ then disabled NW.f1, Cnt.c, Cnt.e, Cnt.g1 and Cnt.g2 for
    that whole NWell, silently.
    Measured on a pmosHV with a substrate tie 0.30 um from the NWell edge (NW.f1 limit
    is 0.62):
    before, no label NW.f1 = 1
    before, with label none
    after, no label NW.f1 = 1
    after, with label NW.f1 = 1
    The n-Activ term is the discriminator the LVS side already uses
    (ngat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
2026-08-31 drc(testing): fix the marker pairing and drop the exclusion list
    Port of IHP-GmbH/IHP-Open-PDK#1080, which fixes the same defect in the shared
    harness this file was forked from.
    convert_results_db_to_gds assigns the datatype that identifies a rule by first
    appearance in the results database, which is deck order, then rebuilt the map
    with sorted() to generate the analysis runset. The two agree only when deck
    order happens to be alphabetical, so a reported failure could name a rule that
    is in fact clean.
    It is not academic here. The four antenna rows the exclusion list carried,
    Ant.d_Via3, Ant.e_Metal1, Ant.f_Via2 and Ant.f_Via3, are all clean; the actual
    differences belong to Ant.b_TopMetal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
2026-08-31 drc(testing): regenerate the filler and antenna goldens
    CMOS5L_EXCLUDED_RULES was added when the DRC decks were de-symlinked from G2
    and the forbidden-layer references stripped, with a comment saying the goldens
    needed regenerating. This is that regeneration; the list itself goes in the
    preceding commit, alongside the harness fix that shows why four of its seven
    names were never failing rules.
    activfiller and gatpolyfiller were straightforward stale fixtures. The decks
    correctly dropped the nBuLay terms, since nBuLay is forbidden here:
    5_6_activfiller.drc:36 is afil_d_g = nwell_drw.dup where G2 joins nbulay_drw,
    and 5_9_gatpolyfiller.drc does the same for GFil.e. The goldens still carried
    t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
2026-08-31 klayout: drc: offgrid: remove irrelevant layer checks
    Mirror the SG13G2 offgrid exclusions merged in IHP-Open-PDK PR #1025 for the SG13CMOS5L deck.
    Pin and no-fill datatypes are tooling annotations rather than manufactured geometry. They are allowed to sit off the 5 nm drawing grid, so checking them creates false signoff failures. In particular, the shared 1P SRAM macros contain an intentionally off-grid Metal1.pin polygon that previously produced metal1_pin_Offgrid violations.
    Remove the corresponding pin and nofill entries from OFFGRID_LAYERS, together with activ_noqrc to preserve parity with the merged SG13G2 change. Drawing, mask, filler, OPC, slit, resistor, and probe checks remain un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
2026-08-31 ci: adopt SG13G2 c1d6f49e
    Most of this PDK is symlinked into a sibling ihp-sg13g2 checkout, and the pin in
    .github/ihp-sg13g2.ref decides which one. Moving it from 72d79ed2 to c1d6f49e
    picks up the cap_cmomi extractor changes from G2 PR #1084, which the testcases
    in the next commit depend on: the two cap_cmomi terminals are now equivalent,
    and a Recog.mom marker without exactly two pin ports is an extraction error
    rather than a log line.
    That is not all the bump spans. It also contains G2 PR #1032, which rewrote the
    three tap rule decks this PDK symlinks (tap_connections, tap_derivations and
    tap_extraction, +48/-17 between them) and added a --disable_tap_extraction
    option that run_lvs.py an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
2026-08-31 lvs: test what the cap_cmomi deck actually detects
    cap_cmomi shipped with a single testcase and no record of what a green LVS run
    on it is worth. It is matched topologically, which is the right call for this
    device, but that leaves more unchecked than the one testcase suggests, and none
    of it was written down on this side.
    No rule decks change here. custom_mom_extractor.lvs and custom_mim_extractor.lvs
    are symlinks into ihp-sg13g2, so the behaviour these cases record is the shared
    one, adopted through the pin bump in the previous commit. What is specific to
    this PDK is the metal band: cap_cmomi here spans Metal1..Metal4, so every layout
    is built on that stack and the wrong-band case declare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
2026-08-31 lvs: refuse to call an empty layout netlist a match
    A cap_cmomi whose nets never leave its sub-cell gives that sub-circuit no
    pins. align drops it for having no counterpart in the schematic, and when it
    held the only devices the layout netlist ends up empty. compare is then left
    with no pair to compare and returns true, so the run reported a match having
    checked nothing. That is how case 12 used to pass.
    sg13cmos5l.lvs now counts the devices the schematic declares before align and
    the devices left on the layout side after it, and reports a mismatch when the
    layout side is empty and the schematic is not. The layout count has to be
    taken after align: before it a deep netlist holds one device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
2026-08-31 lvs: scope the empty-netlist guard, and stop explaining what was not measured
    Follow-up to 75ce7c5 after a review pass. Three defects in it, one of them a
    regression I introduced, plus a testcase the suite was missing.
    The guard counted the schematic's devices across the whole file. A device-free
    top, a filler or a routing-only block, verified against a library netlist whose
    other subcircuits do hold devices, was then failed for holding nothing itself.
    Reproduced, and it passed before 75ce7c5. The count is now scoped to the circuit
    named after the layout top, walking its subcircuits, and falls back to the whole
    file only when no such circuit exists.
    Checking instead that the top circuit su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
2026-08-31 xyce: drop the stale resistors.lib symlink
2026-08-31 test(pycell): add concurrent library load reproducer
    Kept byte-identical to the ihp-sg13g2 copy except for the
    technology name, so the two stay easy to compare. Not wired into
    C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
2026-08-31 Add cap_cmomf, the metal fringe MoM capacitor
    Recovers the interdigitated metal fringe capacitor from the closed PR #39
    and lands it as cap_cmomf, the fringe-style sibling of cap_cmomi on the
    same Metal1..Metal4 stack. The name is the one sg13g2 reserved for this
    device when cap_cmomi was renamed.
    The geometry is the port of R. Timothy Edwards' Magic generator (PR #31),
    unchanged except for the axis convention: l is now the X extent and w the
    Y extent, matching cap_cmomi, because both devices are extracted by the
    shared CapMomExtractor which reads l from the marker bbox width.
    The capacitance density is updated to the values the Magic generator
    carries after PR #69, where its wire-edge par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
    [IHP_testcases.sch, ac_cap_cmomf.sch]
2026-08-31 cap_cmomf: bring the device to cap_cmomi parity
    Review follow-up on the open PR. The device itself was sound (the OSDI
    matches a fresh openvaf build, LVS extracts, the AC testbench simulates),
    but the surfaces around it had drifted from cap_cmomi and two real defects
    were hiding behind a test that could not fail.
    xschem symbol. It was cloned from cap_cmomi as it stood before the sg13g2
    alignment, so it kept the finger artwork, PLUS/MINUS pins and an
    engineering-suffix template, and it carried a hand-written C readout that
    xschem cannot parse. Two independent faults there: the @-token scanner
    terminates only on whitespace, so "(@mmax - @mmin)" looks up a property
    named "mmin)" and substitute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
    [ac_cap_cmomf.sch]
2026-08-31 cap_cmomf: assert the extracted w/l in the sweep
    The axis convention is the one thing about this device that no test could
    catch. CapMomExtractor reads l from the marker bbox width, so the PCell has
    to draw l along X; both parameters are non-primary, so LVS never compares
    them, and the C label is w*l, unchanged by a swap. The sweep now reads the
    extracted w and l back and compares them against the drawn (grid-snapped)
    dimensions.
    Port the DRC check to cap_cmomi_sweep.py as well. It still grepped the
    maximum-rule-set counter, which excludes the geometry offgrid table and is
    what hid two real defects in cap_cmomf. cap_cmomi passes 10/10 unchanged
    with the corrected check.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
2026-08-31 lvs: make the cap_cmomf terminals equivalent
    CapMomExtractor sorts the two ports by x and never reads their pin names,
    so mirroring an instance exchanges mim_top and mim_btm for a circuit that
    did not change. G2 answered this for cap_cmomi in custom_mim_extractor.lvs,
    behind a gate on the device name containing 'cmomi', which leaves cap_cmomf
    out: a mirrored placement was reported as a mismatch.
    cap_cmomf_registration.lvs already extends PREFIX_MAP and CustomReader in
    place rather than copying them, and the equivalence goes in the same way.
    It folds into the g2 gate when the device is upstreamed. cap_cmim keeps its
    asymmetry, which is why that gate is per device and not on the class.
    Held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
2026-08-31 lvs: test what the cap_cmomf deck actually detects
    Ports the cap_cmomi work from #93 to the fringe cap. The frozen testcase
    is rebuilt from the PCell, so it can be regenerated after a PCell change
    instead of being an unreproducible snapshot; it was checked cell by cell
    against the PCell first and had not drifted. A configuration matrix and a
    hierarchical case join it in the unit regression, and cap_cmomf_checks
    adds thirteen cases that each declare the verdict they expect, so
    tightening the comparison surfaces as a verdict change instead of silently
    altering what LVS accepts.
    Most of the suite mirrors the cmomi one, because both devices go through
    the same extractor and the same device clas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
2026-08-31 pycell: set the technology in the PCell test
    Without layout.technology_name the SG13_dev lookup cannot resolve, every
    create_cell returns nil and the first DCellInstArray raises an internal
    KLayout error that reads like a broken PCell library. The script never set
    it, so it failed for all 24 devices on any machine, not just cap_cmomf's.
    With the line it runs clean and writes SG13CMOS5L_dev.gds.
2026-08-31 lvs: take cap_cmomf from the shared G2 decks
    cap_cmomf landed in cmos5l before it existed in G2, so this PDK carried
    local copies of everything the shared decks could not know about. IHP-Open-PDK
    PR #1093 upstreamed the device, so the copies are now duplicates: the pin moves
    to d2cc0355 and the local decks give way to the shared ones.
    What goes:
    cap_cmomf_registration.lvs PREFIX_MAP entry, the two-terminal model list of
    CustomReader, and the terminal equivalence. All
    three are in globals.lvs, custom_reader.lvs and
    custom_mim_extractor.lvs now, the last one behind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
2026-08-31 klayout: add a drawn-geometry test for cap_cmomi
    The existing sweep compares the PCell C label against the compact model, but
    both sides carry the same active-area formula, so they agree whatever that
    formula says. This test measures each side on its own: the drawn rows and
    columns come out of the generated GDS, and the billed rows and columns come
    out of the OSDI under ngspice, read back from the one-pitch capacitance step
    at feed='none'. Nothing is written twice, so the two cannot agree by sharing a
    mistake.
    It also pins a polygon digest of the drawn cell. That layout is already in
    fabricated designs, so a model correction has to leave it exactly where it is.
    The column law passes at eve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
2026-08-31 klayout: pin the cap_cmomi capacitance across every artifact that states it
    The capacitance is written down in the Verilog-A, the tracked OSDI built from
    it, the PCell C= label, the xschem symbol expression and two stored reference
    outputs, and nothing keeps those in step. This asks each one for the same
    device and compares it against the OSDI, which is what a designer's simulation
    actually runs. The symbol expression goes through tclsh so the shipped text is
    what gets evaluated, and the reference outputs are read back through the same
    high-pass corner their testbench uses.
    It says nothing about whether the formula is right; cap_cmomi_geometry_test.py
    does that. It only says whether every c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
2026-08-31 cap_cmomi: bill the coupled rows the cell actually draws
    active_y was floor(w/0.89) - 1. The subtraction comes from the g2
    characterisation, where it is correct: the structure it characterised ends in
    single fingers that have no counter electrode, so one pitch of its width does
    not couple, and it excludes those rows from the active area. This cell
    terminates the array at the last coupled row and draws no unpaired fingers, so
    the subtraction never described it and every device was billed one row short.
    That is about 1% at w = 80 um and a factor of two at w = 2 um.
    The construction is inherited from the g2 generator rather than introduced
    here, so the sg13g2 twin carries the same mismatch.
    N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
2026-08-31 cap_cmomi: charge the single-side feed that is actually drawn
    The model billed cfeed_per_um[N] * feed_width, 7.65 fF on a 5.5 x 7 device. The
    g2 characterisation fitted that against a feed section built as an extended
    fan-in with a via column tying every polarity tower across all metals. This
    PCell does not draw that. It draws two plates 0.90 um wide on the top metal and
    the one below it, overlapping completely with no via between them, and a plate
    overlap at the 0.54 um inter-metal spacing cannot reach 1.28 fF per um of feed
    width without a pad about 19 um wide. The g2 generator does not reproduce that
    number either, so this is not a porting regression: neither generator draws that
    structur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
2026-08-31 cap_cmomi: say what the feed measurement actually showed
    An audit of the previous commit found two claims in its prose that its own
    data does not support. Neither moves a coefficient.
    The layer-window measurement is not flat: 1.126 (N=2), 1.160 and 1.165 (N=3),
    1.171 (N=4). The first step is 35 aF against a run-to-run sigma of 2-3 aF, so
    "they cannot see the layer count" is wrong. Dropping the per-N table is still
    right, but because the trend is under 5% and inside the term's own error bar,
    not because it is absent. The cost is stated: an M3..M4 device is billed about
    4% high on its feed, some 0.3% of the part.
    The mesh-noise figure pointed at a pair of runs that are the core-vs-none
    geome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
2026-08-31 cap_cmomi: clamp the row count the way the layout does
    The model and the symbol clamped the row count at one, the PCell at two. A row
    needs a facing row, so two is what gets drawn, and below w = 1.78 um the clamp
    is the only thing setting the count. In that band the model billed one row and
    one pitch less of feed pad than the cell would draw: 1.93 fF against 3.71 fF at
    w = 1.0, l = 2.0, feed='same'.
    Nothing reachable from a layout lands there, since the PCell constrains w to
    [2:100] um, but a hand-written netlist reaches it and the row-count fix two
    commits ago inherited the mismatch rather than introducing it. The column clamp
    stays at one: a single column of fingers is a valid cell, a sin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
2026-08-31 klayout: stop the cap_cmomi sweep passing on last week's files
    The sweep decided "two terminal" by reading <name>_extracted.cir off disk. It
    never deleted the file first and never looked at the LVS runner's exit code, so
    a run whose extraction died outright reported PASS on the netlists an earlier
    run had left in the same directory. Demonstrated with the same code and the same
    binary ten minutes apart: 10/10 into a used directory, 1/10 into a pristine one.
    The generated GDS had the same hole.
    Both artifacts are now removed before the step that produces them, and a
    non-zero exit from either runner is a failure with its own status. The DRC
    verdict is still read from the runner's stdout rather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
2026-08-31 cap_cmomi: via the tooth tips and bill the double-side feed
    (TOOTH_VIA_OFF=0.41), regenerate the LVS testcase layouts, re-pin the
    geometry freeze.
    density deficit that had partly masked it. An electrostatic solve measures
    C(double)-C(none) = 0.152*pad_len; bill it, and the default feed=double device
    rises ~3.6% (size-dependent, ~10%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
2026-08-31 cap_cmomi PCell: review feedback (label, C param, techparams, subblock, centred origin)
    Port the g2 PCell review changes to the cmos5l twin:
    - label: two lines centred inside the cell (device name + C value)
    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
2026-08-31 cap_cmomi PCell: read DRC-derived geometry from techparams
    Port the g2 change to the cmos5l twin: wire the three constants that are
    existing DRC-rule values to the tech file instead of literals:
    sizes) stay local. Values are unchanged (0.41 / 0.575 / 0.20); XOR against the
    previous testcase layouts is empty on every layer, so the goldens are not
    regenerated. Consistency test passes.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
2026-08-31 cap_cmomi: document static C field on cmos5l (no live coerce)
    The C parameter is a static default on cmos5l: unlike the g2 twin (cmomi), it
    does not track w/l live in the dialog. cmos5l symlinks its PCell framework from
    the g2 tree, and that shared copy ships the older dlo.py without the coerce/
    callback subsystem, so no live callback can run here. Making it live is a
    shared-framework upgrade, out of scope. The live value stays on the cell label.
2026-08-31 cap_cmomi: label and layer-display fixes (cmos5l)
    sg13cmos5l.lyp: TEXT was white on the light canvas, so labels were invisible;
    set it black. Show Recog.mom as an outline instead of a solid fill so it no
    longer hides the device interior.
    Drop the effective-size line from the cell label, leaving the device name and
    the capacitance value, to match the g2 cmomi label.
2026-08-31 gallery: add cap_cmomi and cap_cmomf to the capacitor row
    Register both MoM caps in the xschem device gallery next to the moscaps,
    matching the g2 gallery. Placed so their body lines up with the moscap
    symbols.
    [gallery.sch]
2026-08-31 cap_cmomi: feed-aware C in the symbol label via helper proc
    from the .va through format=.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
2026-09-02 Corrects an error in the magic tech files "cifinput" section that incorrectly reads a dantenna contact, causing the layout in magic to be missing the contact on the metal1 plane (in some situations; 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
2026-09-07 change the section name for Xyce testbench
    [start_page.sch]
2026-09-15 .spi -> .spice in librelane config.tcl
2026-09-18 fix resistor symbol bend width bias
2026-09-22 feat(xschem gallery): added inductors symbols
    [gallery.sch]
2026-09-23 KLayout PyCells: add base class for devices, allows guard ring around cell
2026-09-23 KLayout PyCells: derive guard ring relevant devices from DeviceBase
    # Conflicts:
    # ihp-sg13g2/libs.tech/klayout/python/sg13g2_pycell_lib/ihp/SVaricap_code.py
2026-09-23 Remove pin, remove TIE label, add sub! text
2026-09-23 ResistorBase now derived from DeviceBase, added guard ring code
2026-09-23 Guard-ring row overlaps existing MoM capacitor instances
    The new guard-ring instances are placed at (0,110) and (10,110), exactly the same locations already used by the two MoM fringe capacitor instances above. This overlaps the gallery cells and makes the new smoke-test geometry hard to inspect; move this row to an unused y-coordinate.
2026-09-23 Remove unsupported rw parameter from ptap1 / ntap1
    The generated instance passes rw=@rw to the ptap1/ntap1 subcircuit, but resistors_mod.lib declares only R, w, and l for that subcircuit. The ring resistance is already evaluated into R, so remove rw=@rw to avoid an unknown subcircuit parameter during simulation.
2026-09-23 Add the well label on the nwell layer for LVS
    The well label is emitted only on TEXT here. The LVS deck uses that layer-63 text to form ntap1_mk (general_derivations.lvs:95-103), while named well connectivity is attached from layer-31 nwell_text (general_connections.lvs:55-57); the existing ntap1 PCell writes both labels (ntap1_code.py:145-146). Add a matching label on nwell while retaining the TEXT marker, otherwise the guard-ring well terminal can remain unnamed in LVS.
2026-09-25 Reject guard ring distances below the minimum at runtime
    KLayout does not enforce the RangeConstraint min/max on string
    parameters such as guardRingDistance ('1u'), so zero or negative
    distances placed the ring on top of or inside the device.
    Validate in DeviceBase.setupParams() before any geometry is generated,
    and correct the comment that claimed KLayout enforces the constraint.
2026-09-25 guard_ring_code: Don't destroy the first merged shape twice
    dbLayerOrList already destroys the first input shape, so deleting all
    of them afterwards printed "Box.destroy: already destroyed!" for every
    ring layer of every guarded cell.
2026-09-28 [KLayout LVS]: RF MOS devices keep their layout geometry
    They are now compared as the extracted `rf*` device classes, the netlist reader maps base models with `rfmode=1` to them. `rfmos_model_mapping.lvs`, which replaced them by new devices without device abstract, is removed.
2026-09-29 ihp-sg13g2: klayout: drc: maximal: Read the npn13G2V emitter on EmWiHV
    npn13G2V.a and npn13G2V.b measured the emitter on EmWind, but the
    npn13G2V pcell draws its emitter on EmWiHV (156/0), and the main deck
    recognises the device by EmWiHV too. On a real npn13G2V both rules had
    nothing to measure.
    Read EmWiHV inside the npn13G2V TRANS.
2026-09-29 ihp-sg13g2: klayout: drc: maximal: Measure Pad.gR against TopMetal1
    Pad.gR is the TopMetal1 (within dfpad) enclosure of TopVia2, as its
    message says, but the enclosing layer was Metal5 within dfpad. TopVia2
    sits on TopMetal1, so the rule measured against a layer two levels
    below it.
    Use TopMetal1 within dfpad.
2026-09-29 ihp-sg13g2: klayout: drc: maximal: Check Rhi.b in both directions
    Rhi.b requires pSD and nSD of an Rhigh resistor to be identical.
    pSD_not_nSD was nSD minus pSD, and nSD_not_pSD a copy of it, so only
    nSD sticking out of the pSD was reported; pSD sticking out of the nSD
    passed.
    Build pSD minus nSD and nSD minus pSD.
2026-09-29 ihp-sg13g2: klayout: drc: Keep the full wide-line width in M1.e/f, Mn.e/f and TM2.bR
    These rules find the wide lines by sizing the metal down and up by half
    the wide-line width, and kept that half in the width variable - which
    the message then printed as the width: "wider than 0.15 µm" for M1.e's
    0.3, "wider than 2.5 µm" for TM2.bR's 5.0.
    Keep the width from the rule table in the variable and size by half of
    it. The sizing is the same amount as before, so the rules report the
    same; the messages now print the width the rules name.
2026-09-29 ihp-sg13g2: klayout: drc: Name Padb.f and Padc.f as the goldens do
    The solder bump and copper pillar decks reported the passivation
    opening shape rules as padb.f and padc.f, while the rule tables, the
    messages and the unit goldens name them Padb.f and Padc.f.
2026-09-30 sg13g2: itf: align stackup with process spec
    Check all layers against SG13G2_os_process_spec Rev. 1.2 and fix:
    - oxTopMetal2: was listed twice (2x 1.5um), leaving no oxide above
    TopMetal2. Use one layer of TTM2 (3.0um) + TPASS1 (1.5um) = 4.5um.
    - ox1: TMET1 (0.42um) + TILD1 (0.54um) = 0.96um, was 0.92um.
    - dummyOx/nitride: ILD0 is 590nm oxide + 50nm nitride (TILD0 = 640nm),
    was 640nm oxide + 40nm nitride.
    - TopMetal1 WMIN/SMIN: 1.64um per DRM TM1.a/TM1.b, was 1.5um.
2026-09-30 sg13cmos5l: add ITF parasitics file
    Add a typical-corner ITF for SG13CMOS5L based on the SG13G2 file and
    SG13CMOS5L_os_process_spec Rev. 0.2. The backend has Metal1-Metal4 and
    TopMetal1 as top metal, so TopMetal2/TopVia2/Metal5/Via4 are dropped:
    - ox4: TMET4 (0.49um) + TILDTM1 (0.85um) = 1.34um
    - oxTopMetal1: TTM1 (2.0um) + TPASS1 (1.5um) = 3.5um, then TPASS2
    nitride (0.4um)
    - TopVia1 lands on Metal4. Its resistance is "tbd" in the spec, so
    the SG13G2 value of 2.2 Ohm is used.
2026-09-30 sg13g2: itf: add min and max corners
    Add _min and _max ITF corners derived from the _typ file using the
    min/max limits of SG13G2_os_process_spec Rev. 1.2:
    - ER: 4.1 +/- 0.1 (oxide), 6.6 +/- 0.1 (top nitride)
    - RPSQ: metal sheet resistances (RSMET*, RSTM*) and salicided
    GatPoly (RSNRSIL)
    - GatPoly THICKNESS: TGATPOLY 150/170nm
    - RPV: contact and via resistances (RCM1*, RVIA*, RTV*)
    Metal and isolator thicknesses keep their typical values, as the spec
    only gives target values for them.
2026-09-30 sg13cmos5l: itf: add min and max corners
    min/max limits of SG13CMOS5L_os_process_spec Rev. 0.2:
    TopVia1 resistance is tbd in the spec, so the SG13G2 limits (1/4 Ohm)
    are used.
    only gives target values for them.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
2026-10-05 refactor(gnucap): resistor
    - Split resistor paramsets into seperate files
    - Keep top-level resistor paramset as aggregate build target
    - Apply style guide to resistor corners and paramsets
    - Add paramset dependencies to Makefile
2026-10-05 refactor(gnucap): capacitor
    - Split capacitor paramsets into seperate files
    - Keep top-level capacitor paramset as aggregate build target
    - Apply style guide to capacitor corners and paramsets
    fix(gnucap): use seed parameter in cap_typ_stat
    The statistical corner declared a seed parameter but did not use it.
    Pass it to $rdist calls and bump affected ref files.
2026-10-06 ihp-sg13cmos5l: stop tracking the compiled cap_cmomi/cap_cmomf OSDI
    The two .osdi under libs.tech/ngspice/osdi were committed with the MoM
    capacitors although .gitignore excludes them, so openvaf-compile-va.sh
    dirtied the checkout on every run, and pre-compiled OSDI must not be
    distributed from the repository. Remove them; the compile script already
    builds every object .spiceinit loads.
    The cmos5l cap_cmomi geometry and consistency tests read the tracked
    binary. They now compile cap_cmomi.va into their run dir, as the sg13g2
    consistency test does, and test-cap-cmomi-model skips without openvaf.
    test-gnucap now checks all six objects and points at the cmos5l compile
    script. Its build hint s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
2026-10-07 Fix integer division in HBT Nx scaling
    Replace all 52 occurrences of (4/Nx) with (4.0/Nx) in the ngspice HBT source library. Cover npn13G2, npn13G2l, npn13G2v, and their five-terminal variants, including series resistance, thermal resistance, and flicker-noise scaling.
    VACASK preserves these expressions during conversion and evaluates integer divided by integer as integer division. Integer Nx values above four therefore zero the scaling factor, while Nx=3 truncates it. A real numerator ensures floating-point division even when an instance explicitly supplies an integer Nx; changing only the default parameter type would not address that case. Preserve the source file's original comment bytes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
2026-10-07 ihp-sg13cmos5l: add xschem sym/sch views for sg13cmos5l_stdcell
    The sg13cmos5l standard cells only had primitive xschem symbols in
    libs.tech/xschem/sg13cmos5l_stdcells/, with no schematic views, seven
    cells without a symbol, and the folder not on XSCHEM_LIBRARY_PATH.
    Descending into a cell failed ("unable to open file ... .sch"), see
    iic-jku/IIC-OSIC-TOOLS#377.
    The sg13cmos5l_stdcell SPICE netlist is identical to sg13g2_stdcell
    apart from the cell prefix, so the views follow sg13g2_stdcell:
    - libs.ref/sg13cmos5l_stdcell/sym/xschem: all 84 cells, copied from
    the sg13g2_stdcell symbols with sg13g2_ renamed to sg13cmos5l_.
    - libs.ref/sg13cmos5l_stdcell/sch/xschem: per-cell symlinks to the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
    [sg13cmos5l_a21o_1.sch, sg13cmos5l_a21o_2.sch, sg13cmos5l_a21oi_1.sch, sg13cmos5l_a21oi_2.sch, sg13cmos5l_a221oi_1.sch, sg13cmos5l_a22oi_1.sch, sg13cmos5l_and2_1.sch, sg13cmos5l_and2_2.sch]
2026-10-08 feature(gnucap): add diode support
2026-10-08 fix(gnucap): vj parameter value in dsubw_mod diode model
    Correcting the vj parameter value does not change the existing svaricaphv
    regression test outputs.
2026-10-09 fix(gnucap): use $mfactor for multiplicity
    - use $mfactor to set mosvar device multiplicity in sg13g2_svaricaphv_module.va
    - remove unused m parameter from svaricaphv paramset
    - add test cases that test multiplicity
    - update plot functions to cover new test cases
2026-10-13 add power option and fix ifnone constructions
2026-10-13 fix power and ifnone for cmos5l
2026-10-13 run_drc: make --precheck_drc run only the minimum rule set
    --precheck_drc only set a deck switch, so the maximal deck, the
    offgrid/angle tables and optionally antenna still ran. Now it implies
    --disable_extra_rules, --no_offgrid and --no_angle, ignores --antenna
    and rejects --antenna_only. A precheck run now checks exactly the
    rules listed in docs/precheck_rules.md.
2026-10-13 run_drc: ignore --density_sanity in precheck mode
    The DEN.BND.* sanity markers are not minimum rules, but they could
    still fail a precheck run. Disable them with a warning, like --antenna.
2026-10-13 ihp-sg13cmos5l drc docs: add the precheck rule list
    The SG13G2 list without the rules for layers cmos5l does not have
    (Metal5, Via4, TopVia2, TopMetal2, solder bump and copper pillar
    pads), plus the CMOS5L.FORB checks. It matches what --precheck_drc
    runs.
2026-10-13 Updated the fill pattern generator script, which still had references to the ihp-sg13g2 PDK. This update also fixes two problems in the tech file used to generate fill: 1) The tech file was creating 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
2026-10-13 drc: rename --precheck_drc to --minimum_drc
    The option runs the minimum layout rule set, so name it after it, in
    both PDKs. --precheck_drc keeps working as a deprecated alias: it logs
    a warning and will be removed in a future release. The decks keep their
    precheck_drc switch, so direct KLayout runs with -rd precheck_drc=true
    are unaffected.
2026-10-14 drc: log "Minimum DRC" instead of "PreCheck DRC"
    The main and density decks still logged "PreCheck DRC enabled" after
    the option became --minimum_drc. Same wording in the offgrid/angle gate
    comments. The deck switch keeps its precheck_drc name.
2026-10-15 Revise current status of PDKs in README
    Updated the status of SG13G2 and SG13CMOS5L PDKs to reflect early access and preview classifications.
2026-10-17 resistor model: restructure statistical parameter, global variation are now correct
2026-10-18 fix broken symlink for resistors_mod_mismatch.lib
2026-10-19 fixed cmim capacitance formula for xschem and qucs-s
2026-10-20 Corrected two issues with magic's DRC rule deck Corrected two issues as reported in the IHP open PDK issue tracker (#1291 and #1292): (1) Tap layers sandwiched between diffusion were incorrectly flag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
2026-10-20 Fix ngspice antenna diode convergence
    Update the dantenna and dpantenna ngspice model cards to match the Spectre reference behavior. Use level 3 so reverse breakdown current scales with area, remove nbv values that introduce spurious leakage and convergence failures, and set the temperature parameters and bandgap energy needed to reproduce the extracted temperature response.
    Make the subcircuits accept instance-level l and w parameters and evaluate area, perimeter, and corner contributions with explicit expressions. Preserve the existing device names and defaults while allowing library users to override geometry at instantiation.
    Document the ngspice-versus-Spectre limitations and the expe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
2026-10-21 Update SG13CMOS5L antenna diode models
    Port the dantenna and dpantenna ngspice convergence updates from the SG13G2 diode models. Use level-3 model cards with the corrected temperature and bandgap parameters, remove the problematic nbv settings, and preserve area and perimeter scaling through explicit instance geometry expressions.
    Validation: ngspice operating-point checks at 27 C, -40 C, and 125 C, plus a DC sweep from -15 V to 1 V; git diff --check passed.
2026-10-22 added io cells schematic and symbol for xschem
2026-10-22 Remove redundant IO gallery schematic from libs.ref
2026-10-22 Fix NMOS array multiplicity in IO clamp schematic
2026-10-22 Connect IO clamp resistor body to iovdd
2026-10-26 General update antenna diodes and isolbox
2026-10-28 Fix Via1_DC2L Metal1 enclosure in tech LEF (#1308)
2026-10-28 Apply general diode update to ihp-sg13cmos5l
2026-10-30 cmos5l librelane: add /A pin to DIODE_CELL
    LibreLane expects DIODE_CELL as cell/pin. Without the pin,
    Odb.DiodesOnPorts fails with 'not enough values to unpack'
    whenever DIODE_ON_PORTS is set. Matches the sg13g2 config.
    Fixes #1316
2026-11-04 .github: workflows: Pin LVS and DRC regression to ubuntu-24.04
    ubuntu-latest is ubuntu-26.04 now, where the KLayout package of
    setup-klayout, which is built for Ubuntu 24, can't be installed, as apt
    can't satisfy its Qt 5 dependencies. So all LVS and DRC regression jobs
    fail in their setup, before running any testcase.
    Pin these jobs to the image they last passed on.
